nppesnteam/370-24_Balakovo_PTVM180_-3-4/АК4/1.Титульник.pdf

# Балаковская ТЭЦ-4 филиала «Саратовский» ПАО «Т Плюс»

# Модернизация оборудования КИПиА водогрейных котлов ПТВМ-180 ст.№3, ст.№4

# Заказчик: филиал «Саратовский» ПАО «Т Плюс»

Главный инженер проекта | /Корепанов М.И./
370-24-АК4 | Котел ПТВМ-180 №4. Автоматизация

## Проектная организация: ООО НПП "Энергосервисналадка", г.Ижевск, nppesn.ru, ИНН 1832097973

Регистрационный номер 1083 в реестре Ассоциации Саморегулируемой организации "Национальное объединение научно-исследовательских и проектно-изыскательских организаций" Ассоциация СРО "Центрстройпроект", регистрационный номер в государственном реестре саморегулируемых организаций СРО-П-029-25092009)
