nppesnteam/370-24_Balakovo_PTVM180_-3-4/АК4/5.Структурная схема автоматизации.pdf

### Условные обозначения

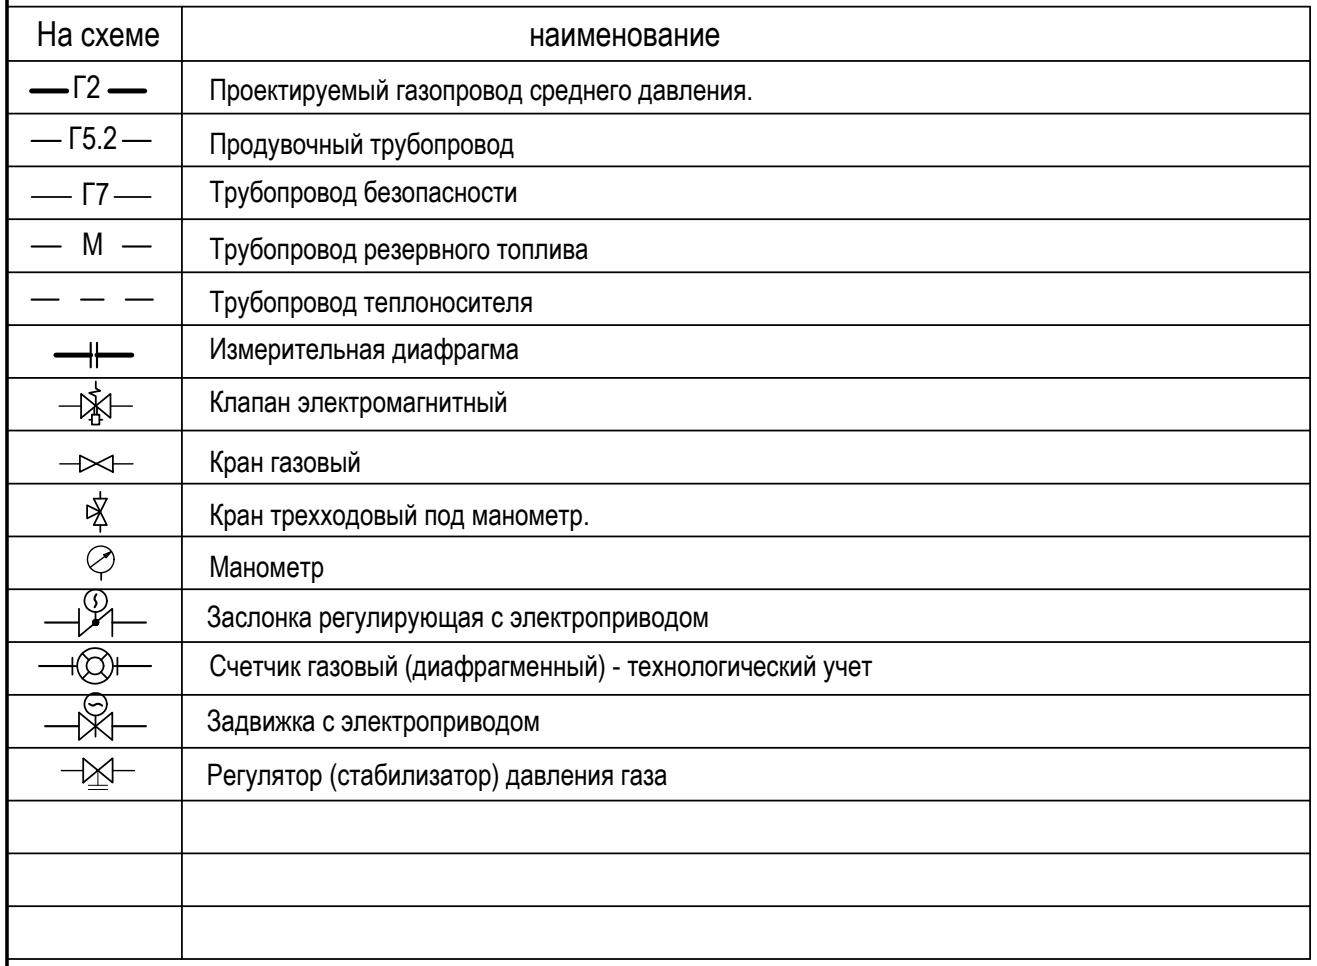
[picture p3: figure]
На схеме; наименование; Проектируемый газопровод среднего давления.; Кран газовый; Клапан электромагнитный; Манометр; Кран трехходовый под манометр.; Продувочный трубопровод; Заслонка регулирующая с электроприводом; Трубопровод безопасности; Задвижка с электроприводом; Регулятор (стабилизатор) давления газа; Трубопровод резервного топлива; Трубопровод теплоносителя Измерительная диафрагма

Счетчик газовый (диафрагменный) - технологический учет

g

номер подобъекта на объекте. Котел №3

среда: g(Gas)-газ, w(Water) - вода: на выходе из котла, на входе в котел, a(Air)-воздух, f(smole Fumes)-дым.газы, r(Reserv fuel)-резервное топливо, b(Burn) - пламя, x - прочее g

Pi

4

индивидуальный номер устройства на объекте.

4 0

1

Pi

1 3

0 1 номер горелки

P(Pressure)-давл., Т(Temperature)- темп-ра, CP(Control Panel)-шкаф управления, PP (power panel) - силовой шкаф,
fM(freqMotion) - эл.привод с частотником, sM(Single-turn Motion) - МЭО, H(Hand) - ручной, V(Valve) - клапан, Q(Quantity) - расход, X - неклассифицируемое устройство, последняя буква в датчиках: i(indicate) - показывающий, OS(Operator Station)-АРМ оператора

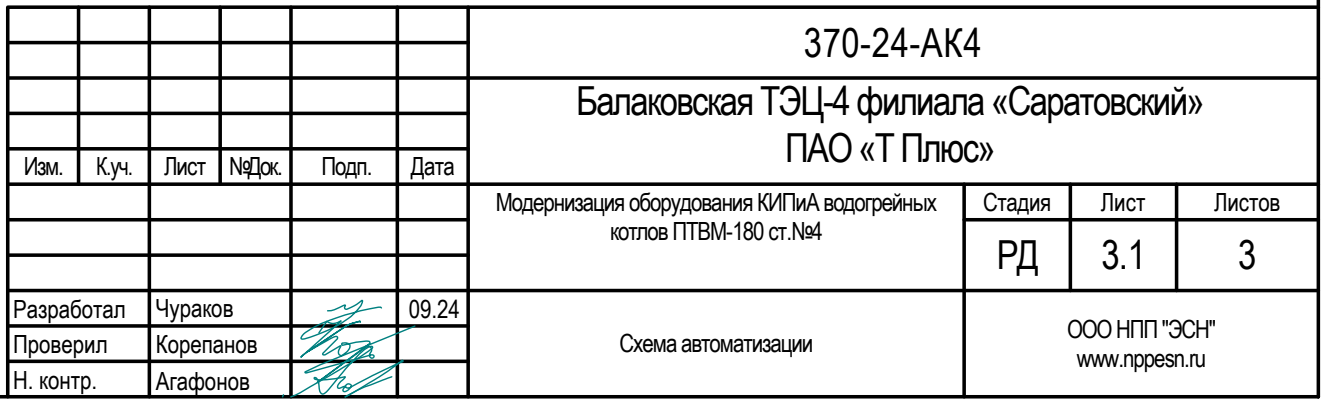
[picture p4: figure]
Стадия; Лист; Листов; Изм.; №Док.; Подп.; Дата; Модернизация оборудования КИПиА водогрейных котловПТВМ-180 ст.№4; ОООНПП "ЭСН" www.nppesn.ru; Балаковская ТЭЦ-4 филиала «Саратовский» ПАО «ТПлюс»; Схема автоматизации; Разработал Проверил Н. контр.; Чураков; Агафонов; Корепанов
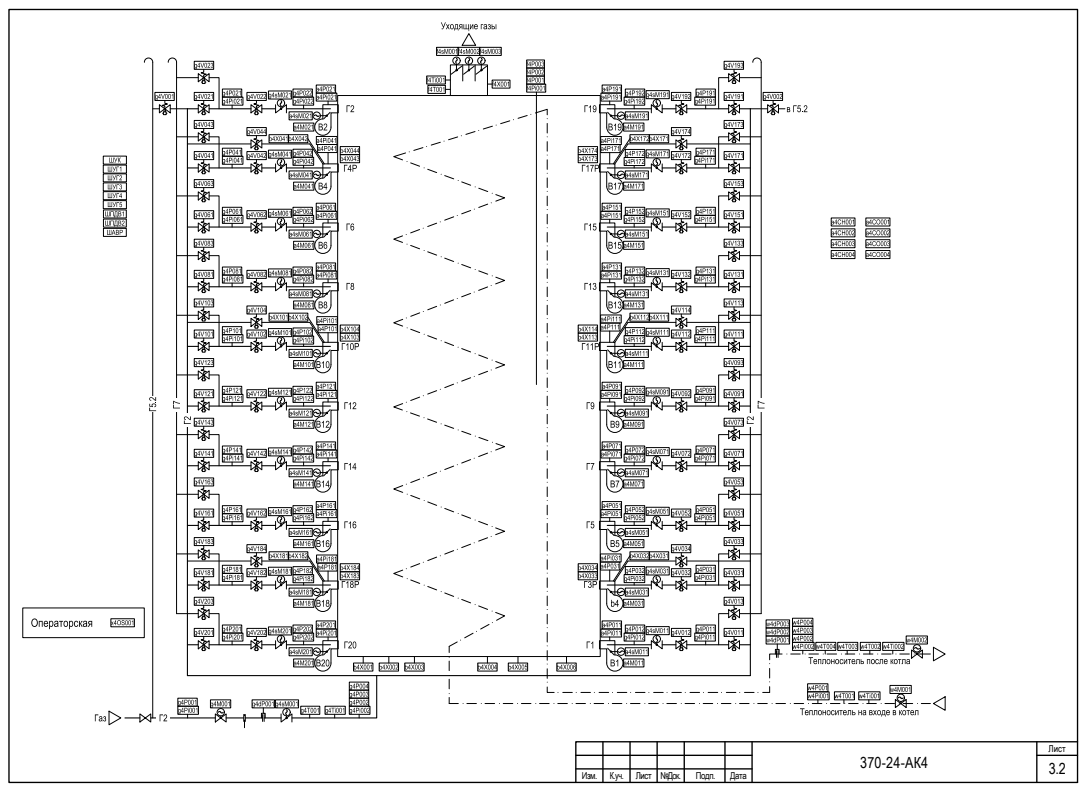
[picture p5: page 2]
Лист; Изм.; №Док.; Подп.; Дата

Лист

Изм. | К.уч. | Лист | №Док. | Подп. | Дата
370-24-АК4 | 3.3

Схема структурная автоматизации котла ПТВМ-180 №4

АРМ №1 | АРМ №2

Сетевой
коммутатор 1

Сетевой
коммутатор 2

Шкаф управления котлом
ПЛК 1
R500

Модули ввода/вывода

ПЛК 2
R500

Ethernet
Ethernet
RegulBus
RegulBus
Ethernet | Ethernet

Ethernet

Ethernet
Ethernet Ethernet
основной | резервный

вх/вых реле,
управление

вх/вых реле,
управление

вх/вых реле,
управление

вх/вых реле,
управление

Группа
горелок №1

Группа
горелок №2

Группа
горелок №3

Группа
горелок №4

Датчики, исполнительные механизмы котла ПТВМ-180 №4 по месту

вх/вых реле, управление

Шкаф группы
горелок №1

Модули
ввода/вывода

Шкаф группы
горелок №2

Модули
ввода/вывода

Шкаф группы
горелок №3

Модули
ввода/вывода

Шкаф группы
горелок №4

Модули
ввода/вывода

Помещение операторной

общекотельные Р,Т, расход газа, воды, разрежение, продувочные клапаны, датчики общего факела, содержание дымовых газов, открыть закрыть, контроль задвижки газа, воды, система контроля загазованности, система отопления/вентиляци

Датчики факела запальника, горелки, Ргаза, воздуха на горелке, герметичность, пуск/контроль вентиляторов, ПЗК1,2, кл.Безопасности, запальника, ИВН, открыть, закрыть, контроль заслонки газа, воздуха

вх/вых реле,
управление

Группа
горелок №5

Шкаф группы
горелок №5

Модули
ввода/вывода
