nppesnteam/370-24_Balakovo_PTVM180_-3-4/АК3/3.Ведомость (отредачить и подпись влада).pdf

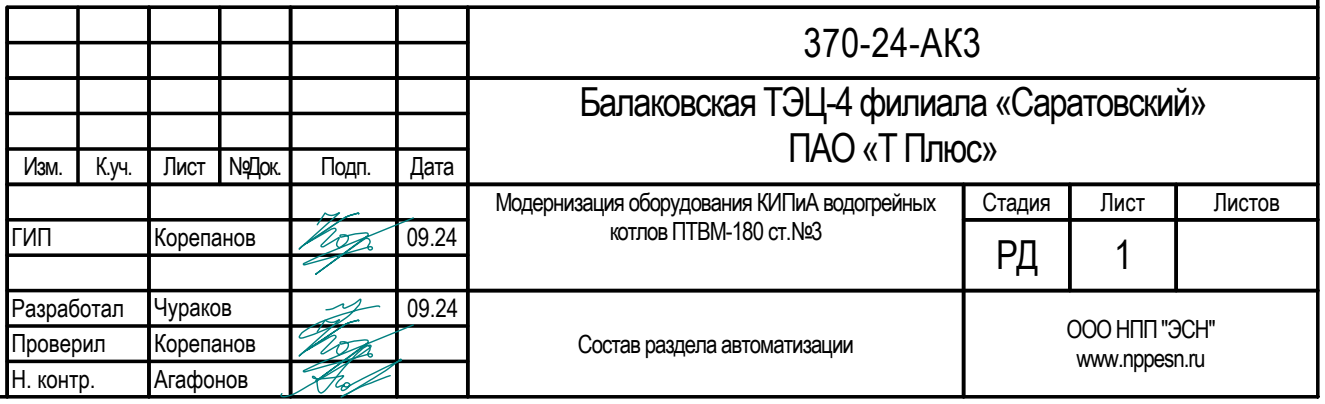
[picture p6: figure]
Стадия; Лист; Листов; Изм.; №Док.; Подп.; Дата; ОООНПП "ЭСН" www.nppesn.ru; Состав раздела автоматизации; Разработал; Чураков; Проверил; Корепанов; Н. контр.; Агафонов; 370-24-АК3 Балаковская ТЭЦ-4 филиала «Саратовский» ПАО «ТПлюс»

| | | | Модернизация оборудования КИПиА водогрейных котловПТВМ-180 ст.№3 | | 1 ГИП

Технические решения, принятые в рабочей документации, соответствуют требованиям экологических, санитарно-технических, противопожарных и других норм, действующих на территории Российской Федерации и обеспечивают безопасную для жизни и здоровья людей эксплуатацию объекта при соблюдении предусмотренных рабочими чертежами мероприятий.

Ведомость рабочих чертежей | Ведомость ссылочных и прилагаемых документов
Лист | Примечание Наименование | Обозначение | Примечание Наименование
1 | Состав раздела автоматизации
2 | Общие указания | на 3 листах
3 | Схема автоматизации | на 3 листах
4 | План расположения средств автоматизации | на 5 листах
5-9 | Ведомость элементов функциональной схемы | на 5 листах
10-105 | Схемы электрические принципиальные | на 96 листах
106-125 | Схемы монтажные | на 20 листах

Прилагаемые документы
370-24-АК3.СО | Спецификация оборудования и материалов
370-24-АК3.ТП и КЖ | Трубные проводки и кабельный журнал
370-24-АК3.ШАВР | Шкаф автоматического ввода резерва
370-24-АК3.ШУК | Шкаф управления котлом
370-24-АК3.ШУГ | Шкаф управления группой горелок
370-24-АК3.ШПДВ | Шкаф питания дутьевых вентиляторов
