nppesnteam/370-24_Balakovo_PTVM180_-3-4/Docs/РЭ ИКТС-11.1 Схема электрическая.pdf

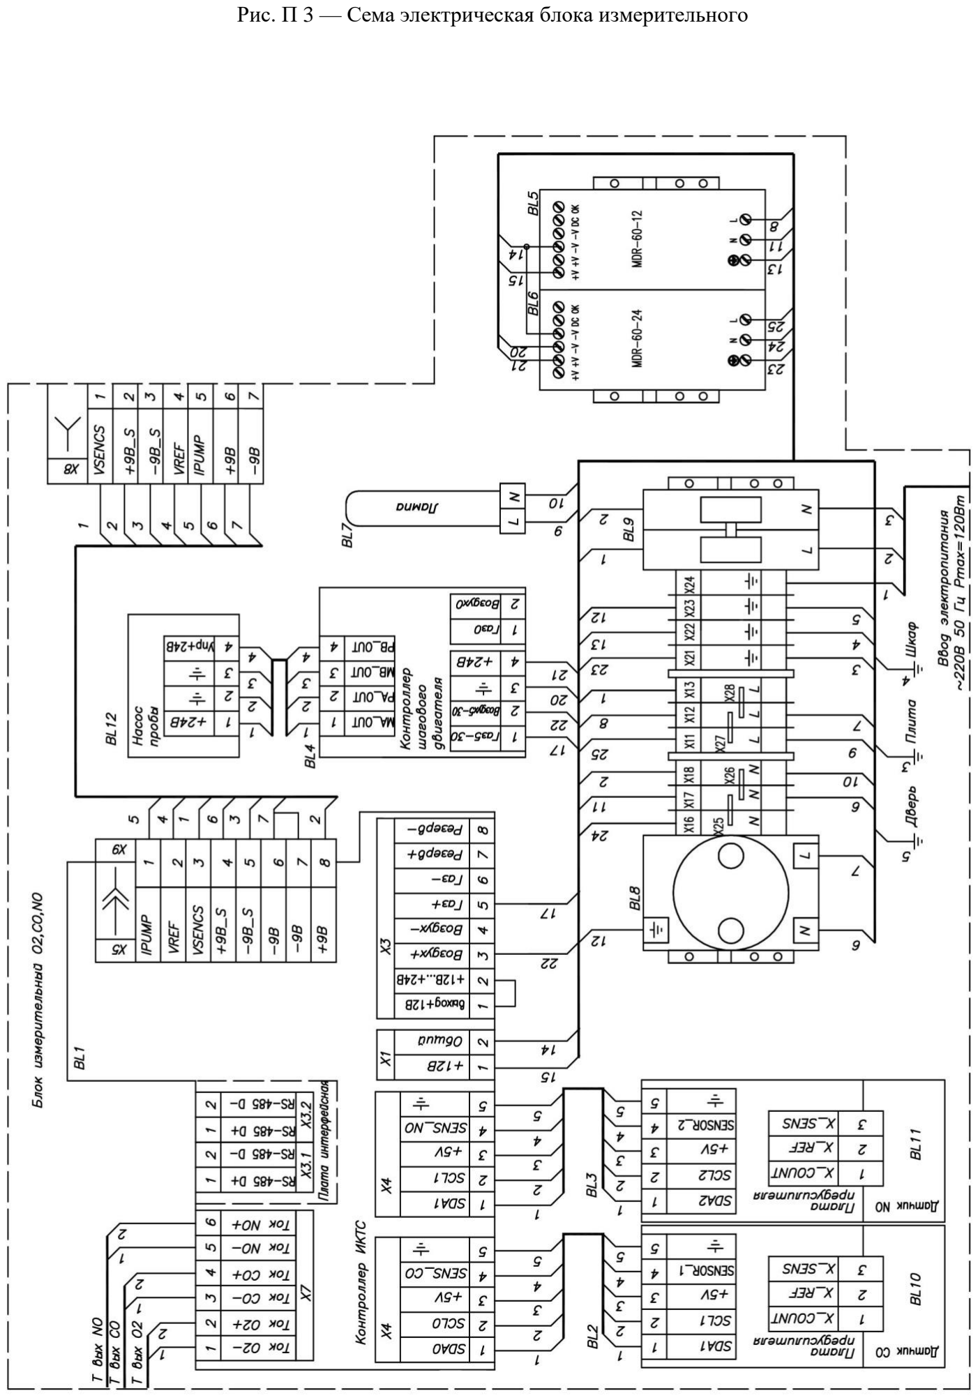
[picture p7: page 1]

Руководство по эксплуатации ИКТС-11.1 | ПГРА 170.00.000 РЭ

33

Рис. П 3 — Сема электрическая блока измерительного

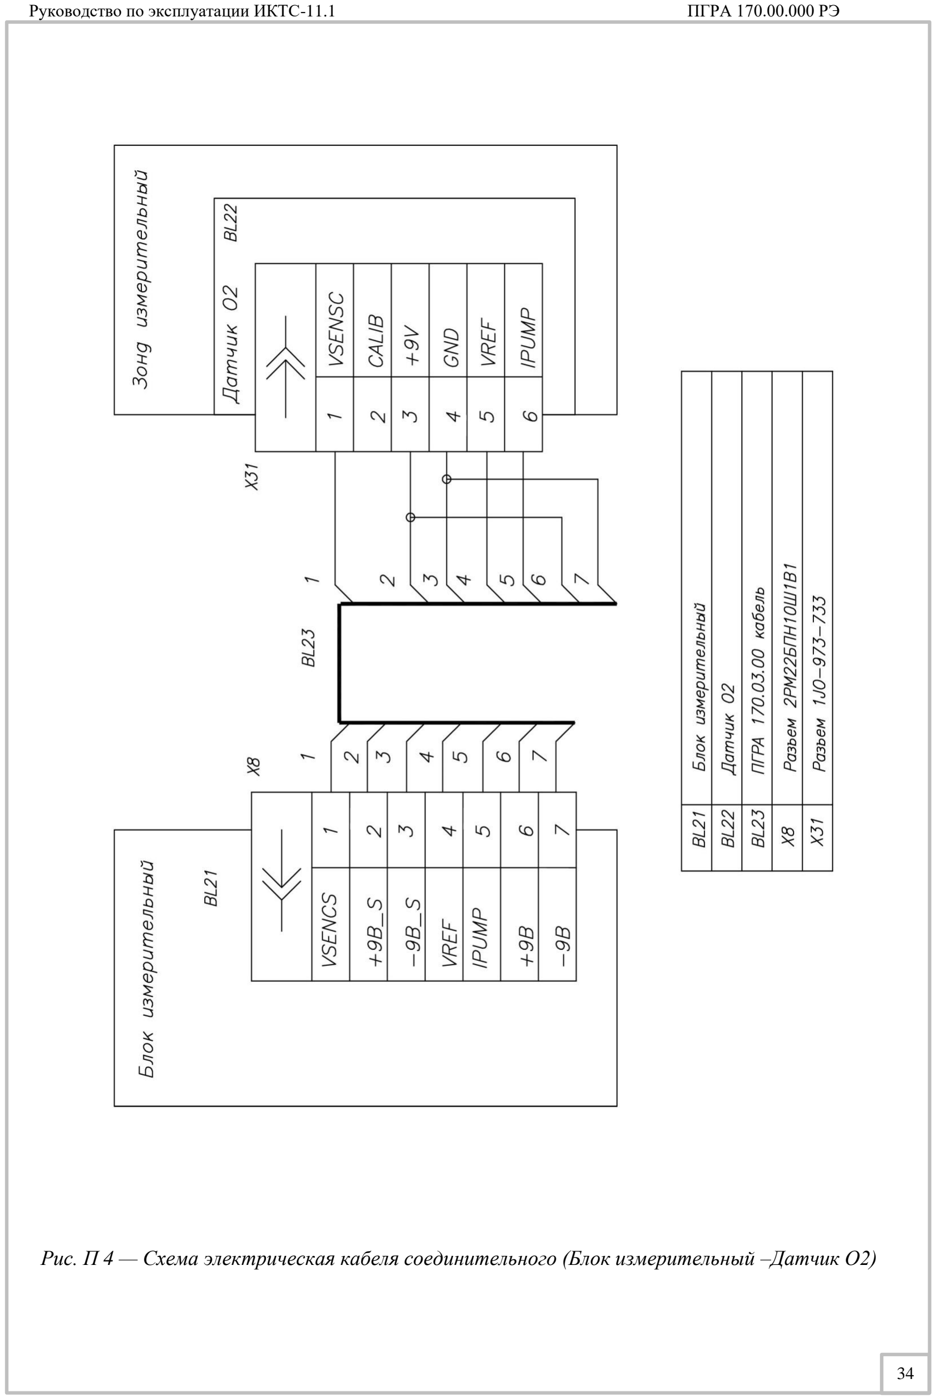
[picture p8: page 2]

Руководство по эксплуатации ИКТС-11.1 | ПГРА 170.00.000 РЭ

34

Рис. П 4 — Схема электрическая кабеля соединительного (Блок измерительный –Датчик О2)
