nppesnteam/370-24_Balakovo_PTVM180_-3-4/АК3/2.Состав проекта.pdf

Состав рабочей документации, шифр 370-24, стадия «РД»
Объект: Балаковская ТЭЦ-4 филиала «Саратовский» ПАО «Т Плюс»
Стройка: Модернизация оборудования КИПиА водогрейных котлов ПТВМ-180 ст.№3, ст.№4
ПЗ | Пояснительная записка
АК3 | Котел ПТВМ-180 №3. Автоматизация
ГС3 | Котел ПТВМ-180 №3. Газоснабжение.
АК4 | Котел ПТВМ-180 №4. Автоматизация
ГС4 | Котел ПТВМ-180 №4. Газоснабжение.
СМ | Котел ПТВМ-180 №4. Сметная документация
