nppesnteam/370-24_Balakovo_PTVM180_-3-4/SM/370-24_балаково_птвм180n3n4_241022/scheme.pdf

# code

## object

Инв. № подп. Подп. и дата Взамен инв. №

Согласовано

Изм. | Кол.уч. | Лист | № док. | Подп. | Дата
| | | | work | Стадия | Лист | Листов
| | | | | stage | 1
Разработал | design | | date | Ведомость элементов функциональной схемы (1/5) | firm
Проверил | verify
Н.контр. | norminspect
Шифр | Назначение | Значение номиналь- ное
Единица
измере-ния

Схема
электри-ческая
| | | | Схема монтажа
Шифр | Назначение | Значение
номиналь-ное

Единица
измере-ния

Схема
электри-ческая

Схема
монтажа
Шифр | Назначение | Значение
номиналь-ное

Единица
измере-ния

Схема
электри-ческая

Схема
монтажа
g3P002 | Датчик давления газа в коллекторе
№1 | 100 | se0001 кПа | sm11, л.6
f3P001 | Датчик разрежения в топке котла №1 | 0.2 | se0001 кПа | sm8, л.7
w3dP001 | Датчик перепада давления
теплоносителя на входе в котёл №1 | 63 | se0001 кПа | sm13,
| | | | л.11
w3P002 | Датчик давления теплоносителя
после котла №1 | 2.5 | se0001 Мпа | sm8, л.7
w3T002 | Датчик температуры теплоносителя
после котла №1 | 200 | se0001 °C | sm3, л.12
g3P001 | Датчик давления газа на входе в
котел | 100 | se0001 кПа | sm2, л.13
g3dP001 | Датчик перепада давления газа на
входе в котел | 10 | se0001 кПа | sm7, л.14
g3T001 | Датчик температуры газа в
коллекторе | 100 | se0001 °C | sm3, л.12
f3T001 | Датчик температуры дымовых газов | 400 | se0001 °C | sm12,
| | | | л.15
g3P003 | Датчик давления газа в коллекторе
№2 | 100 | se0001 кПа | sm11, л.6
f3P002 | Датчик разрежения в топке котла
№2 | 0.2 | se0001 кПа | sm8, л.7
w3dP002 | Датчик перепада давления
теплоносителя на входе в котёл №2 | 63 | se0001 кПа | sm14,
| | | | л.16
w3P003 | Датчик давления теплоносителя
после котла №2 | 2.5 | se0001 Мпа | sm8, л.7
w3T003 | Датчик температуры теплоносителя
после котла №2 | 200 | se0001 °C | sm3, л.12
w3T001 | Датчик температуры теплоносителя
на входе в котел | 200 | se0001 °C | sm3, л.12
w3P001 | Датчик давления теплоносителя на
входе в котел | 2.5 | se0001 Мпа | sm8, л.7
g3P004 | Датчик давления газа в коллекторе
№3 | 100 | se0001 кПа | sm11, л.6
f3P003 | Датчик разрежения в топке котла
№3 | 0.2 | se0001 кПа | sm8, л.7
w3dP003 | Датчик перепада давления
теплоносителя на входе в котёл №3 | 63 | se0001 кПа | sm14,
| | | | л.16
w3P004 | Датчик давления теплоносителя
после котла №3 | 2.5 | se0001 Мпа | sm8, л.7
g3Pi011 | Манометр давления газа между ПЗК
на горелке №1 | 100 | не
электр. кПа | sm1, л.17
g3Pi021 | Манометр давления газа между ПЗК
на горелке №2 | 100 | не
электр. кПа | sm1, л.17
g3Pi031 | Манометр давления газа между ПЗК
на горелке №3 | 100 | не
электр. кПа | sm1, л.17
g3Pi041 | Манометр давления газа между ПЗК
на горелке №4 | 100 | не
электр. кПа | sm1, л.17
g3Pi051 | Манометр давления газа между ПЗК
на горелке №5 | 100 | не
электр. кПа | sm1, л.17
g3Pi061 | Манометр давления газа между ПЗК
на горелке №6 | 100 | не
электр. кПа | sm1, л.17
g3Pi071 | Манометр давления газа между ПЗК
на горелке №7 | 100 | не
электр. кПа | sm1, л.17
g3Pi081 | Манометр давления газа между ПЗК
на горелке №8 | 100 | не
электр. кПа | sm1, л.17
g3Pi091 | Манометр давления газа между ПЗК
на горелке №9 | 100 | не
электр. кПа | sm1, л.17
g3Pi101 | Манометр давления газа между ПЗК
на горелке №10 | 100 | не
электр. кПа | sm1, л.17
g3Pi111 | Манометр давления газа между ПЗК
на горелке №11 | 100 | не
электр. кПа | sm1, л.18
g3Pi121 | Манометр давления газа между ПЗК
на горелке №12 | 100 | не
электр. кПа | sm1, л.18
g3Pi131 | Манометр давления газа между ПЗК
на горелке №13 | 100 | не
электр. кПа | sm1, л.18
g3Pi141 | Манометр давления газа между ПЗК
на горелке №14 | 100 | не
электр. кПа | sm1, л.18
g3Pi151 | Манометр давления газа между ПЗК
на горелке №15 | 100 | не
электр. кПа | sm1, л.18
g3Pi161 | Манометр давления газа между ПЗК
на горелке №16 | 100 | не
электр. кПа | sm1, л.18
g3Pi171 | Манометр давления газа между ПЗК
на горелке №17 | 100 | не
электр. кПа | sm1, л.18
g3Pi181 | Манометр давления газа между ПЗК
на горелке №18 | 100 | не
электр. кПа | sm1, л.18
g3Pi191 | Манометр давления газа между ПЗК
на горелке №19 | 100 | не
электр. кПа | sm1, л.18
g3Pi201 | Манометр давления газа между ПЗК
на горелке №20 | 100 | не
электр. кПа | sm1, л.18
w3T004 | Датчик температуры теплоносителя
после котла №3 | 200 | se0001 °C | sm3, л.12
g3P011 | Датчик давления газа между ПЗК на
горелке №1 | 100 | se0001 кПа | sm8, л.7
g3P012 | Датчик давления газа перед
горелкой №1 | 40 | se0001 кПа | sm8, л.7
а3P011 | Датчик давления воздуха перед
горелкой №1 | 2.5 | se0001 кПа | sm8, л.7
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
g3V151 | Клапан ПЗК-1 на горелке №15 | se0003
g3V171 | Клапан ПЗК-1 на горелке №17 | se0003
g3V191 | Клапан ПЗК-1 на горелке №19 | se0003
g3V132 | Клапан ПЗК-2 на горелке №13 | se0003
g3V152 | Клапан ПЗК-2 на горелке №15 | se0003
g3V172 | Клапан ПЗК-2 на горелке №17 | se0003
g3V192 | Клапан ПЗК-2 на горелке №19 | se0003
g3V133 | Клапан СБ на горелке №13 | se0003
g3V153 | Клапан СБ на горелке №15 | se0003
g3V173 | Клапан СБ на горелке №17 | se0003
g3V193 | Клапан СБ на горелке №19 | se0003
g3V174 | Клапан запальника горелки №17 | se0003
g3V141 | Клапан ПЗК-1 на горелке №14 | se0003
g3V161 | Клапан ПЗК-1 на горелке №16 | se0003
g3V181 | Клапан ПЗК-1 на горелке №18 | se0003
g3V201 | Клапан ПЗК-1 на горелке №20 | se0003
g3V142 | Клапан ПЗК-2 на горелке №14 | se0003
g3V162 | Клапан ПЗК-2 на горелке №16 | se0003
g3V182 | Клапан ПЗК-2 на горелке №18 | se0003
g3V202 | Клапан ПЗК-2 на горелке №20 | se0003
g3V143 | Клапан СБ на горелке №14 | se0003
g3V163 | Клапан СБ на горелке №16 | se0003
g3V183 | Клапан СБ на горелке №18 | se0003
g3V203 | Клапан СБ на горелке №20 | se0003
g3V184 | Клапан запальника горелки №18 | se0003
b3X032 | Датчик наличия факела запальника горелки №3 | se0005
b3X042 | Датчик наличия факела запальника горелки №4 | se0005
b3X102 | Датчик наличия факела запальника горелки №10 | se0005
b3X112 | Датчик наличия факела запальника горелки №11 | se0005
b3X172 | Датчик наличия факела запальника горелки №17 | se0005
b3X182 | Датчик наличия факела запальника горелки №18 | se0005
b3X001 | Датчик интенсивности пламени №1 | se0009
b3X002 | Датчик интенсивности пламени №2 | se0009
b3X003 | Датчик интенсивности пламени №3 | se0009
b3X004 | Датчик интенсивности пламени №4 | se0009
b3X005 | Датчик интенсивности пламени №5 | se0009
b3X006 | Датчик интенсивности пламени №6 | se0009
а3СО001 | Датчик загазованности СО №1 | se0009
а3СО002 | Датчик загазованности СО №2 | se0009
а3СО003 | Датчик загазованности СО №3 | se0009
а3СО004 | Датчик загазованности СО №4 | se0009
b3X033 | Датчик наличия факела горелки №3 | se0010
b3X043 | Датчик наличия факела горелки №4 | se0010
b3X103 | Датчик наличия факела горелки №10 | se0010
b3X113 | Датчик наличия факела горелки №11 | se0010
b3X173 | Датчик наличия факела горелки №17 | se0010

# code

## object

Инв. № подп. Подп. и дата Взамен инв. №

Согласовано

Изм. | Кол.уч. | Лист | № док. | Подп. | Дата
| | | | work | Стадия | Лист | Листов
| | | | | stage | 4
| | | | Ведомость элементов функциональной схемы (4/5) | firm
Шифр | Назначение | Значение
номиналь-ное

Единица
измере-ния

Схема
электри-ческая

Схема
монтажа
Шифр | Назначение | Значение
номиналь-ное

Единица
измере-ния

Схема
электри-ческая

Схема
монтажа
Шифр | Назначение | Значение
номиналь-ное

Единица
измере-ния

Схема
электри-ческая

Схема
монтажа

b3X183 Датчик наличия факела горелки
№18

se0010

а3СН001 | Датчик загазованности СН4 №1 | se0011
а3СН002 | Датчик загазованности СН4 №2 | se0011
а3СН003 | Датчик загазованности СН4 №3 | se0011
а3СН004 | Датчик загазованности СН4 №4 | se0011
а3sM011 | Регулятор давления воздуха на
горелке №1

se0012

а3sM031 Регулятор давления воздуха на горелке №3

se0012

а3sM051 Регулятор давления воздуха на горелке №5

se0012

а3sM071 Регулятор давления воздуха на горелке №7

se0012

а3sM021 Регулятор давления воздуха на горелке №2

se0012

а3sM041 Регулятор давления воздуха на горелке №4

se0012

а3sM061 Регулятор давления воздуха на горелке №6

se0012

а3sM081 Регулятор давления воздуха на горелке №8

se0012

а3sM091 Регулятор давления воздуха на горелке №9

se0012

а3sM101 Регулятор давления воздуха на горелке №10

se0012

а3sM111 Регулятор давления воздуха на горелке №11

se0012

а3sM121 Регулятор давления воздуха на горелке №12

se0012

а3sM131 Регулятор давления воздуха на горелке №13

se0012

а3sM151 Регулятор давления воздуха на горелке №15

se0012

а3sM171 Регулятор давления воздуха на горелке №17

se0012

а3sM191 Регулятор давления воздуха на горелке №19

se0012

а3sM141 Регулятор давления воздуха на горелке №14

se0012

а3sM161 Регулятор давления воздуха на горелке №16

se0012

а3sM181 Регулятор давления воздуха на горелке №18

se0012

а3sM201 Регулятор давления воздуха на горелке №20

se0012

g3sM011 Регулятор давления газа на горелке №1

se0015

g3sM031 Регулятор давления газа на горелке №3

se0015

g3sM051 | Регулятор давления газа на горелке №5 | se0015
g3sM071 | Регулятор давления газа на горелке №7 | se0015
g3sM021 | Регулятор давления газа на горелке №2 | se0015
g3sM041 | Регулятор давления газа на горелке №4 | se0015
g3sM061 | Регулятор давления газа на горелке №6 | se0015
g3sM081 | Регулятор давления газа на горелке №8 | se0015
g3sM091 | Регулятор давления газа на горелке №9 | se0015
g3sM101 | Регулятор давления газа на горелке №10 | se0015
g3sM111 | Регулятор давления газа на горелке №11 | se0015
g3sM121 | Регулятор давления газа на горелке №12 | se0015
g3sM131 | Регулятор давления газа на горелке №13 | se0015
g3sM151 | Регулятор давления газа на горелке №15 | se0015
g3sM171 | Регулятор давления газа на горелке №17 | se0015
g3sM191 | Регулятор давления газа на горелке №19 | se0015
g3sM141 | Регулятор давления газа на горелке №14 | se0015
g3sM161 | Регулятор давления газа на горелке №16 | se0015
g3sM181 | Регулятор давления газа на горелке №18 | se0015
g3sM201 | Регулятор давления газа на горелке №20 | se0015
f3X001 | Газоанализатор дымовых газов | se0018
а3M011 | Дутьевой вентилятор на горелке №1 | se0019
а3M031 | Дутьевой вентилятор на горелке №3 | se0019
а3M051 | Дутьевой вентилятор на горелке №5 | se0019
а3M071 | Дутьевой вентилятор на горелке №7 | se0019
а3M021 | Дутьевой вентилятор на горелке №2 | se0019
а3M041 | Дутьевой вентилятор на горелке №4 | se0019
а3M061 | Дутьевой вентилятор на горелке №6 | se0019
а3M081 | Дутьевой вентилятор на горелке №8 | se0019
а3M091 | Дутьевой вентилятор на горелке №9 | se0019
а3M101 | Дутьевой вентилятор на горелке №10 | se0019
а3M111 | Дутьевой вентилятор на горелке №11 | se0019
а3M121 | Дутьевой вентилятор на горелке №12 | se0019
а3M131 | Дутьевой вентилятор на горелке №13 | se0019
а3M151 | Дутьевой вентилятор на горелке №15 | se0019
а3M171 | Дутьевой вентилятор на горелке №17 | se0019
а3M191 | Дутьевой вентилятор на горелке №19 | se0019
а3M141 | Дутьевой вентилятор на горелке №14 | se0019
а3M161 | Дутьевой вентилятор на горелке №16 | se0019
а3M181 | Дутьевой вентилятор на горелке №18 | se0019
а3M201 | Дутьевой вентилятор на горелке №20 | se0019
g3M001 | Задвижка газовая на входе в котел | se0024
w3M001 | Задвижка теплоносителя на входе в котел | se0024
w3M002 | Задвижка теплоносителя после котла | se0024
g3V001 | Клапан продувки со стороны чётных горелок | se0021
g3V002 | Клапан продувки со стороны нечётных горелок | se0021
f3sM001 | Регулятор разрежения №1 | se0022
f3sM002 | Регулятор разрежения №2 | se0022
f3sM003 | Регулятор разрежения №3 | se0022
g3sM001 | Регулятор давления газа в коллекторе | se0023
b3X034 | Горелка запальная газовая | не электр.
b3X044 | Горелка запальная газовая | не электр.
b3X104 | Горелка запальная газовая | не электр.
b3X114 | Горелка запальная газовая | не электр.
b3X174 | Горелка запальная газовая | не электр.
b3X184 | Горелка запальная газовая | не электр.

# code

## object

Инв. № подп. Подп. и дата Взамен инв. №

Согласовано

Изм. | Кол.уч. | Лист | № док. | Подп. | Дата
| | | | work | Стадия | Лист | Листов
| | | | | stage | 5
| | | | Ведомость элементов функциональной схемы (5/5) | firm
Шифр | Назначение | Значение
номиналь-ное

Единица
измере-ния

Схема
электри-ческая

Схема
монтажа
Шифр | Назначение | Значение
номиналь-ное

Единица
измере-ния

Схема
электри-ческая

Схема
монтажа
Шифр | Назначение | Значение
номиналь-ное

Единица
измере-ния

Схема
электри-ческая

Схема
монтажа

x3OS001 Арм оператора

Стол оператора

x3CP001 | Шкаф управления котлом
x3CP002 | Шкаф управления горелками 1
x3CP003 | Шкаф управления горелками 2
x3CP004 | Шкаф управления горелками 3
x3CP005 | Шкаф управления горелками 4
x3CP006 | Шкаф управления горелками 5
x3PP004 | Шкаф питания
x3PP002 | Шкаф питания дутьевых
вентиляторов 1
x3PP003 Шкаф питания дутьевых вентиляторов 2
x3PP001 Шкаф автоматического включения резерва
Иверторная система

Байпас

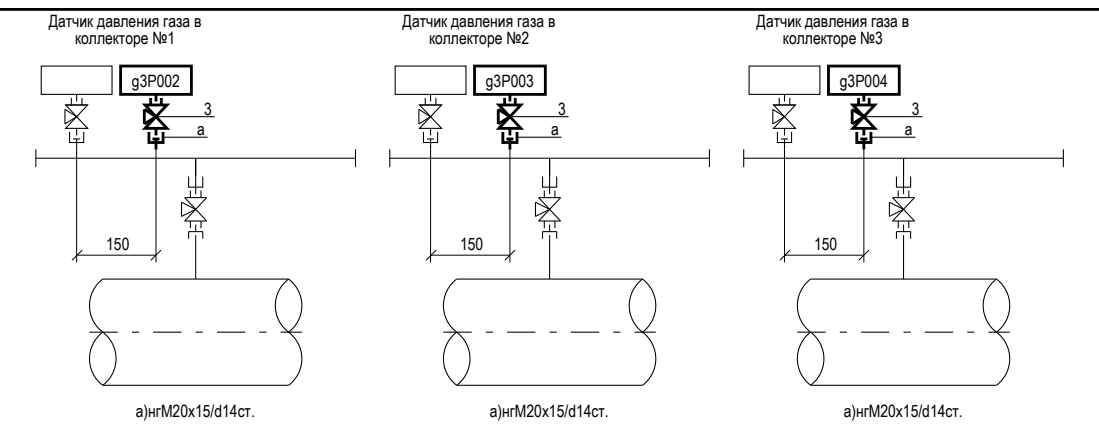
[picture p23: page 6]
Согласовано; а)нгМ20х15/d14ст.

Датчик давления газа в
коллекторе №1

коллекторе №2

коллекторе №3

Инв. № подп. Подп. и дата Взамен инв. №

code
object

Изм. | Кол.уч. | Лист | № док. | Подп. | Дата

work | Стадия | Лист | Листов

stage | 6

Схема монтажная sm11: g3P002, g3P003, g3P004 | firm

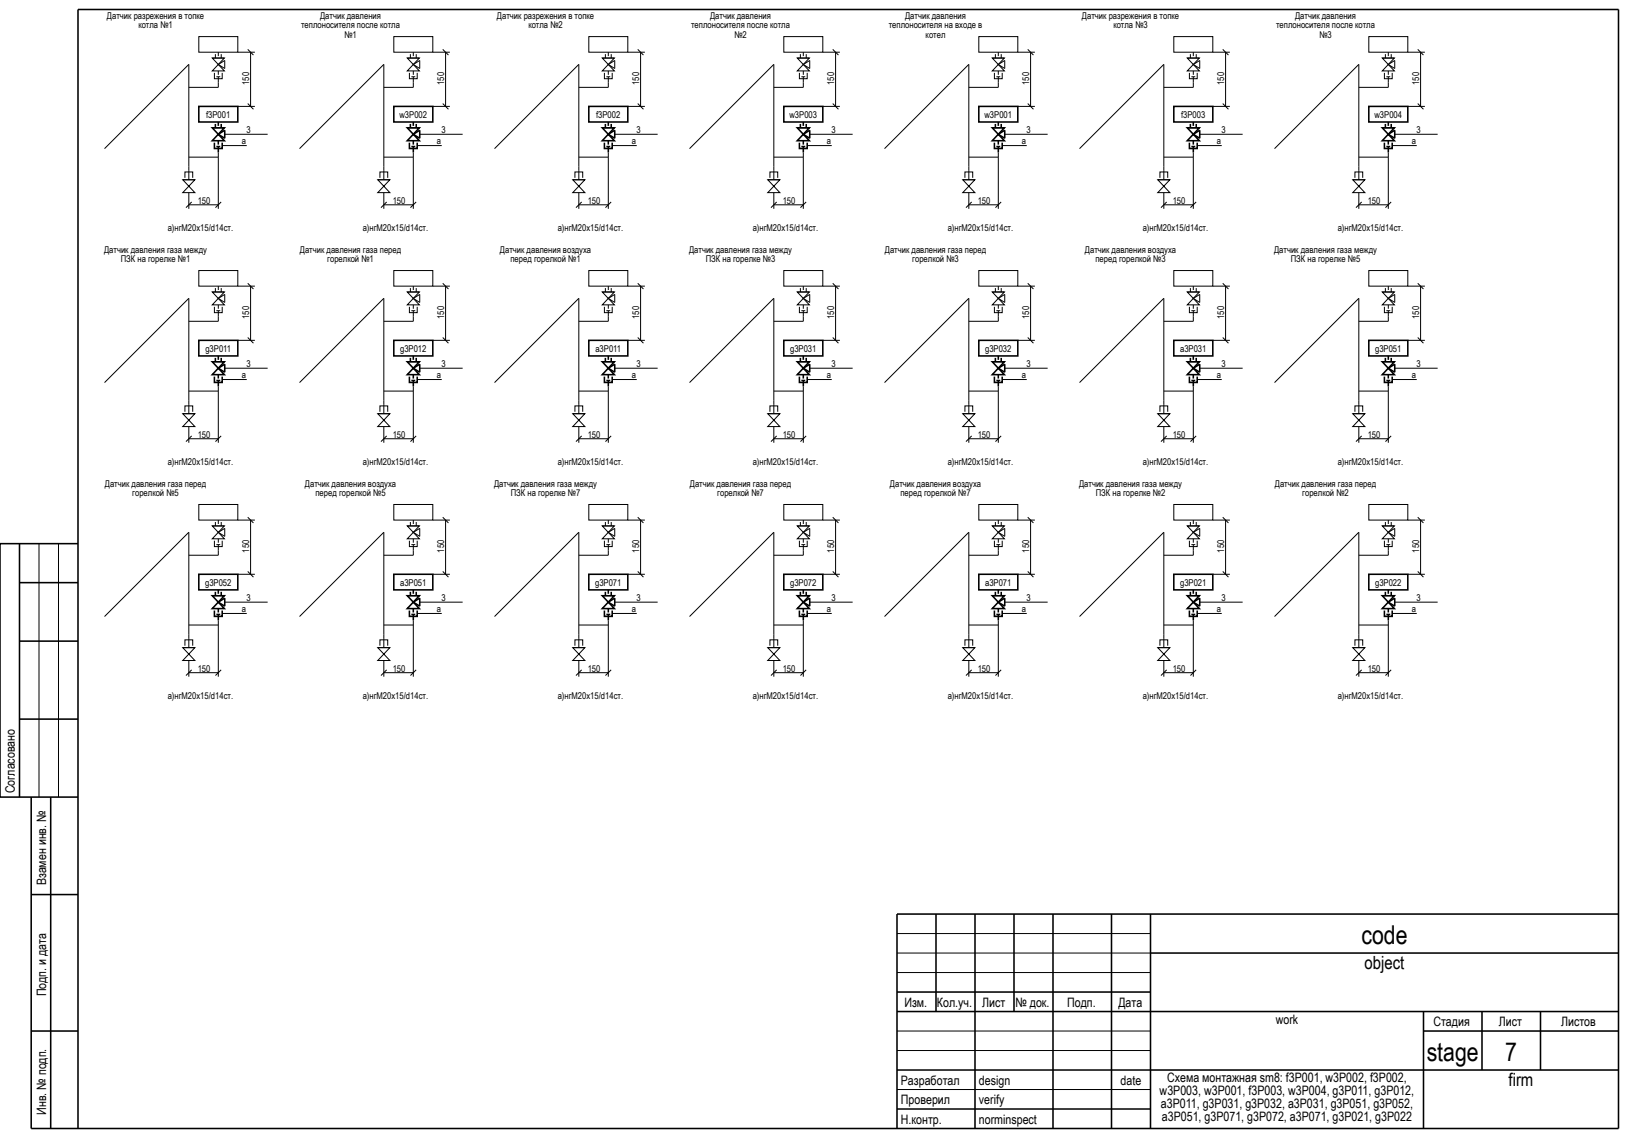
[picture p24: page 7]
Согласовано; а)нгМ20х15/d14ст.; котел

Датчик разрежения в топке
котла №1

Датчик давления
теплоносителя после котла

котла №2

теплоносителя на входе в

котла №3

Датчик давления газа между
ПЗК на горелке №1

Датчик давления газа перед
горелкой №1

Датчик давления воздуха
перед горелкой №1

ПЗК на горелке №3

горелкой №3

перед горелкой №3

ПЗК на горелке №5

горелкой №5

перед горелкой №5

ПЗК на горелке №7

горелкой №7

перед горелкой №7

ПЗК на горелке №2

горелкой №2

Инв. № подп. Подп. и дата Взамен инв. №

code
object

Изм. | Кол.уч. | Лист | № док. | Подп. | Дата

work | Стадия | Лист | Листов

stage | 7

Схема монтажная sm8: f3P001, w3P002, f3P002, w3P003, w3P001, f3P003, w3P004, g3P011, g3P012, а3P011, g3P031, g3P032, а3P031, g3P051, g3P052, а3P051, g3P071, g3P072, а3P071, g3P021, g3P022 | firm

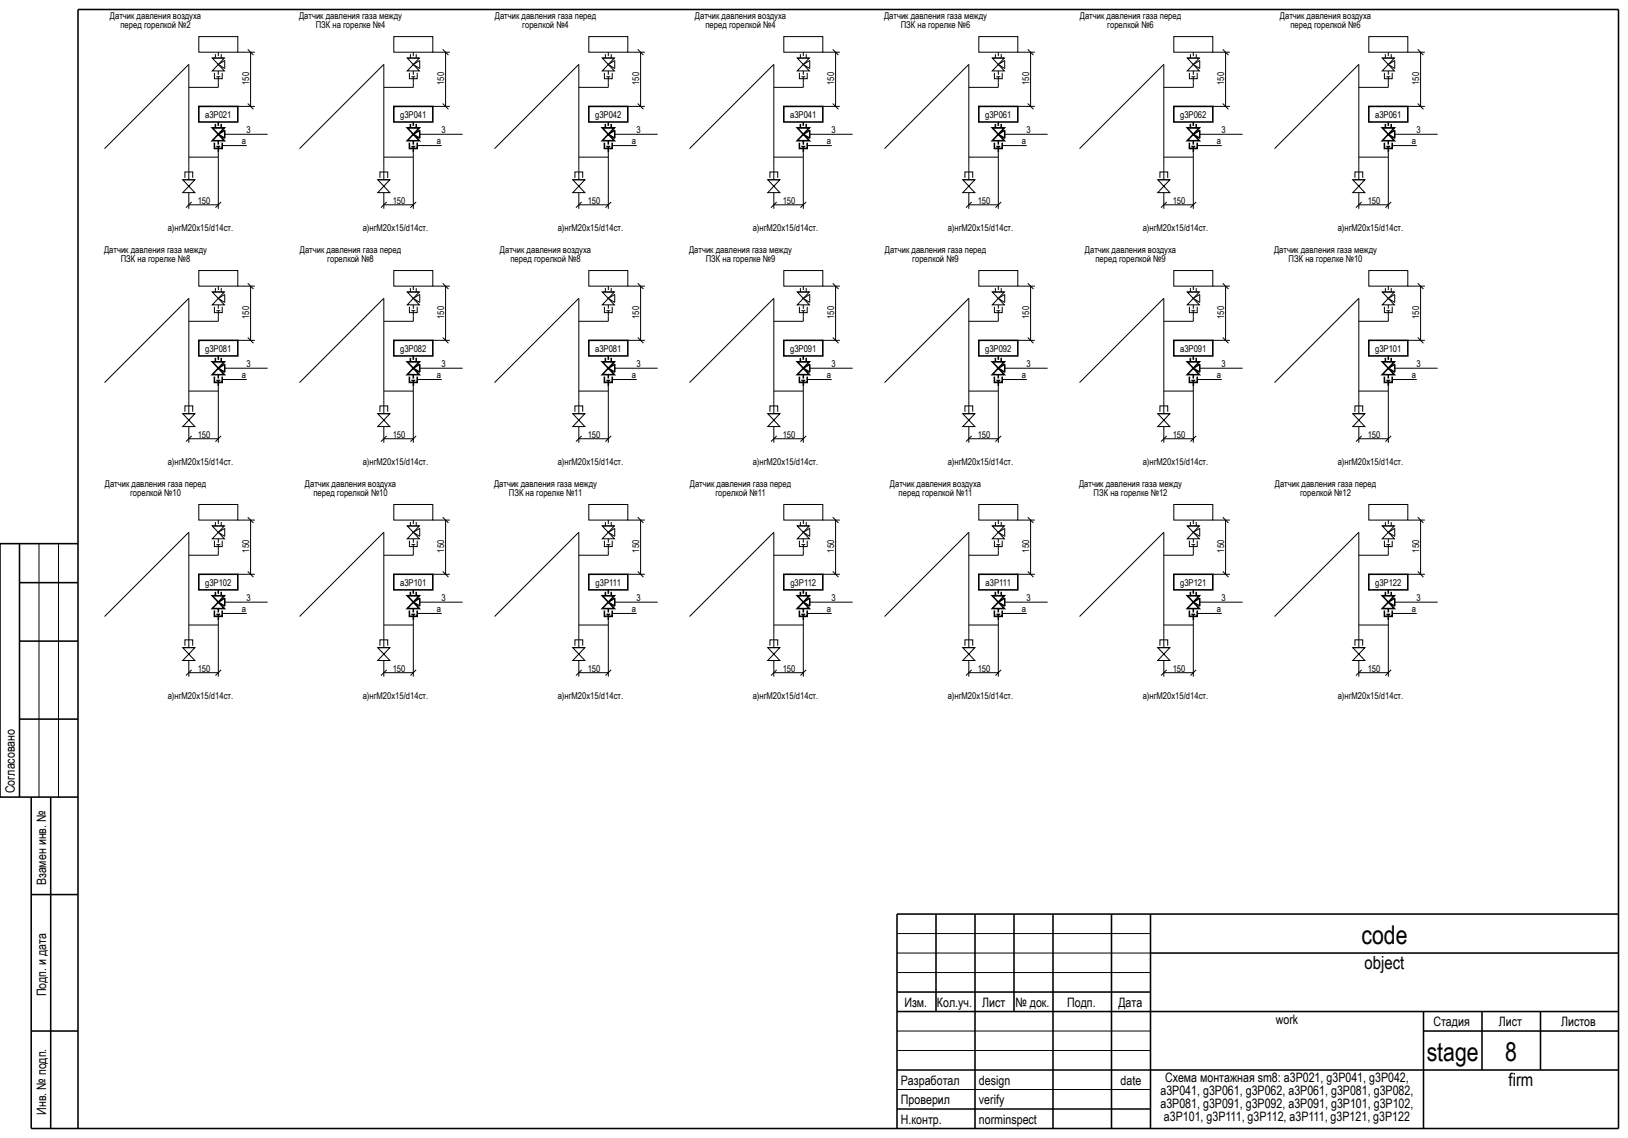
[picture p25: page 8]
Согласовано; а)нгМ20х15/d14ст.

Датчик давления воздуха
перед горелкой №2

Датчик давления газа между
ПЗК на горелке №4

Датчик давления газа перед
горелкой №4

перед горелкой №4

ПЗК на горелке №6

горелкой №6

перед горелкой №6

ПЗК на горелке №8

горелкой №8

перед горелкой №8

ПЗК на горелке №9

горелкой №9

перед горелкой №9

ПЗК на горелке №10

горелкой №10

перед горелкой №10

ПЗК на горелке №11

горелкой №11

перед горелкой №11

ПЗК на горелке №12

горелкой №12

Инв. № подп. Подп. и дата Взамен инв. №

code
object

Изм. | Кол.уч. | Лист | № док. | Подп. | Дата

work | Стадия | Лист | Листов

stage | 8

Схема монтажная sm8: а3P021, g3P041, g3P042, а3P041, g3P061, g3P062, а3P061, g3P081, g3P082, а3P081, g3P091, g3P092, а3P091, g3P101, g3P102, а3P101, g3P111, g3P112, а3P111, g3P121, g3P122

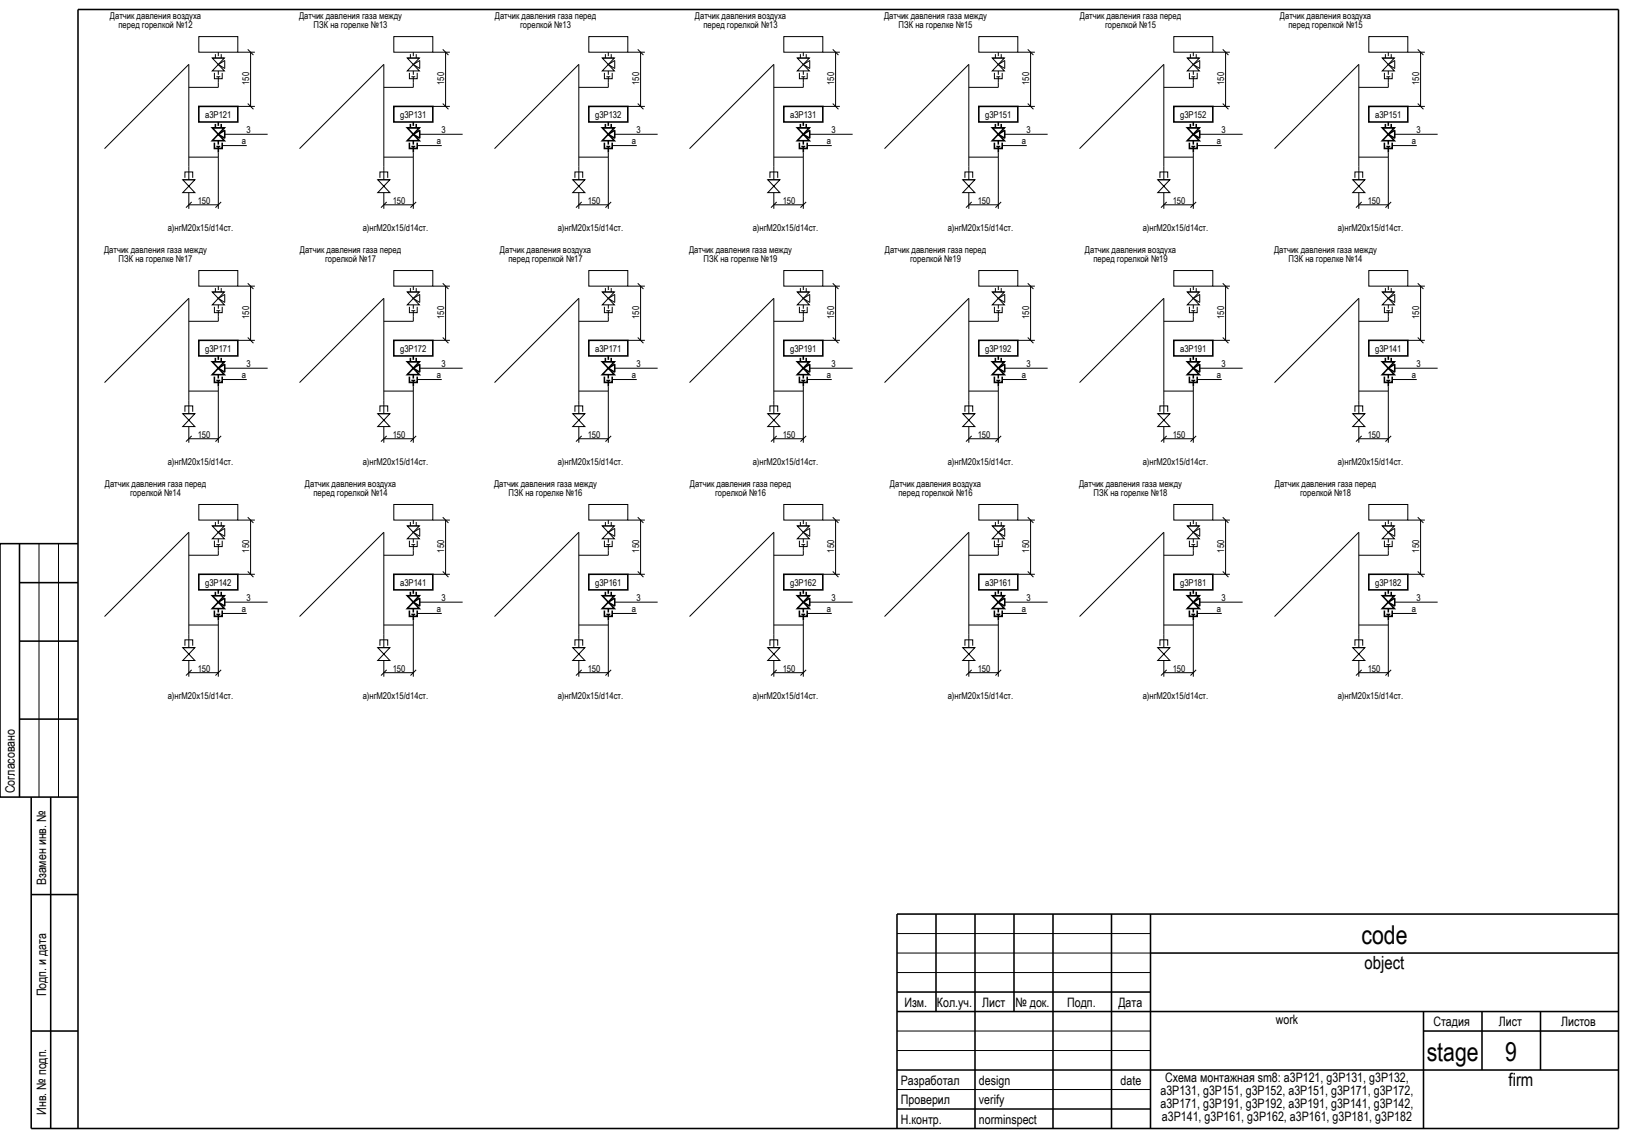
[picture p26: page 9]
Согласовано; а)нгМ20х15/d14ст.

Датчик давления воздуха
перед горелкой №12

Датчик давления газа между
ПЗК на горелке №13

Датчик давления газа перед
горелкой №13

перед горелкой №13

ПЗК на горелке №15

горелкой №15

перед горелкой №15

ПЗК на горелке №17

горелкой №17

перед горелкой №17

ПЗК на горелке №19

горелкой №19

перед горелкой №19

ПЗК на горелке №14

горелкой №14

перед горелкой №14

ПЗК на горелке №16

горелкой №16

перед горелкой №16

ПЗК на горелке №18

горелкой №18

Инв. № подп. Подп. и дата Взамен инв. №

code
object

Изм. | Кол.уч. | Лист | № док. | Подп. | Дата

work | Стадия | Лист | Листов

stage | 9

Схема монтажная sm8: а3P121, g3P131, g3P132, а3P131, g3P151, g3P152, а3P151, g3P171, g3P172, а3P171, g3P191, g3P192, а3P191, g3P141, g3P142, а3P141, g3P161, g3P162, а3P161, g3P181, g3P182

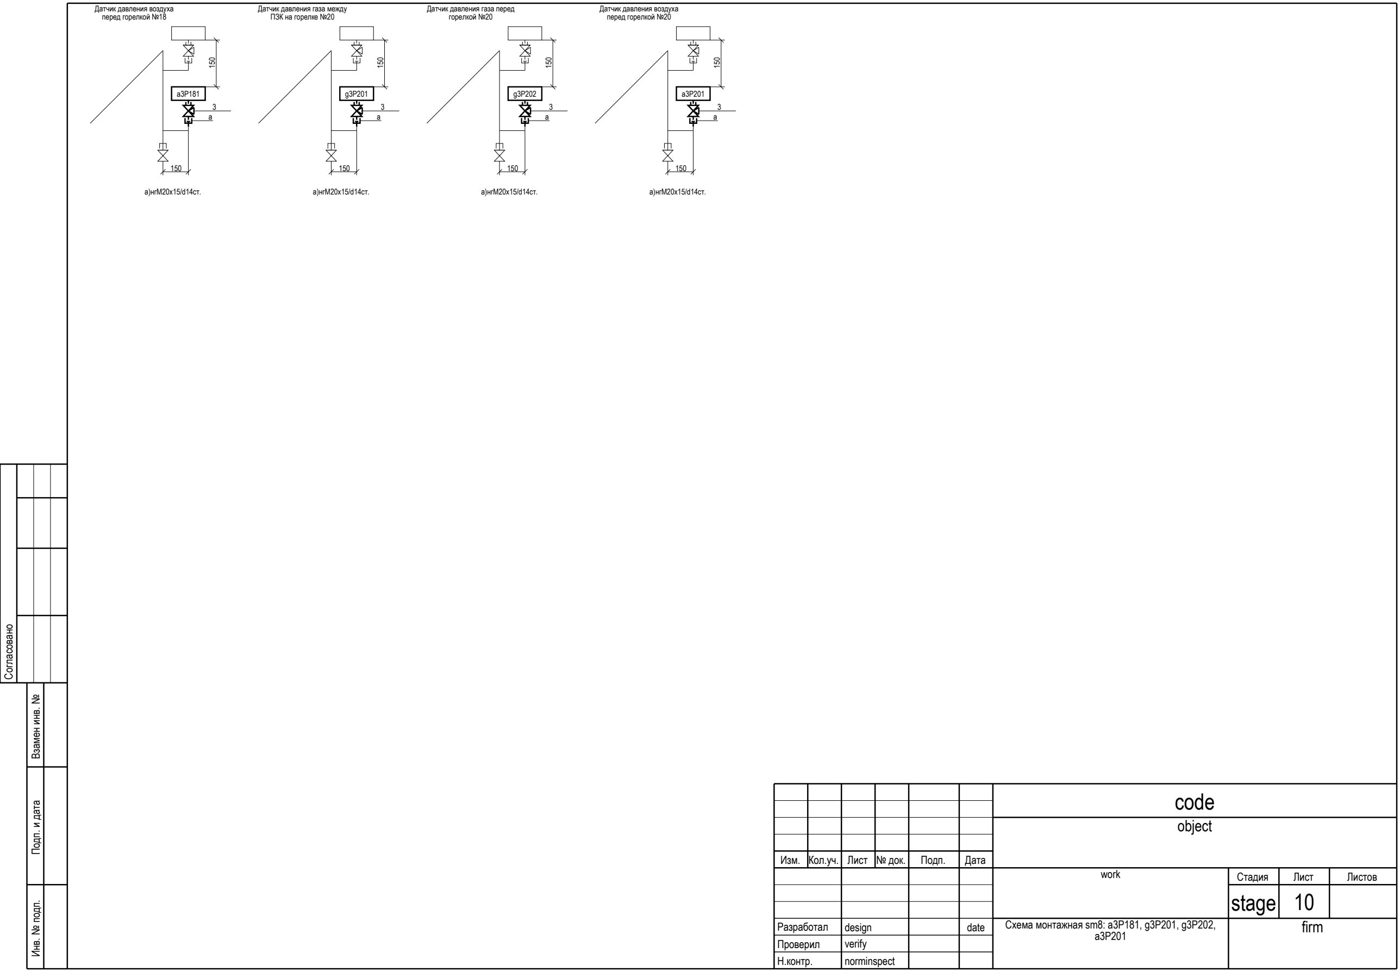
[picture p27: figure]
stage; object; code; work; Стадия; Лист; Листов; Инв. № подп. Подп. и дата Взамен инв. №; Согласовано; Изм.; Кол.уч.; № док.; Подп.; Дата; Датчик давления воздуха перед горелкой №18; а)нгМ20х15/d14ст.; Датчик давления газа между ПЗК на горелке №20; Датчик давления газа перед горелкой №20; Датчик давления воздуха перед горелкой №20

| | | | Схема монтажная sm8: а3P181, g3P201, g3P202, а3P201

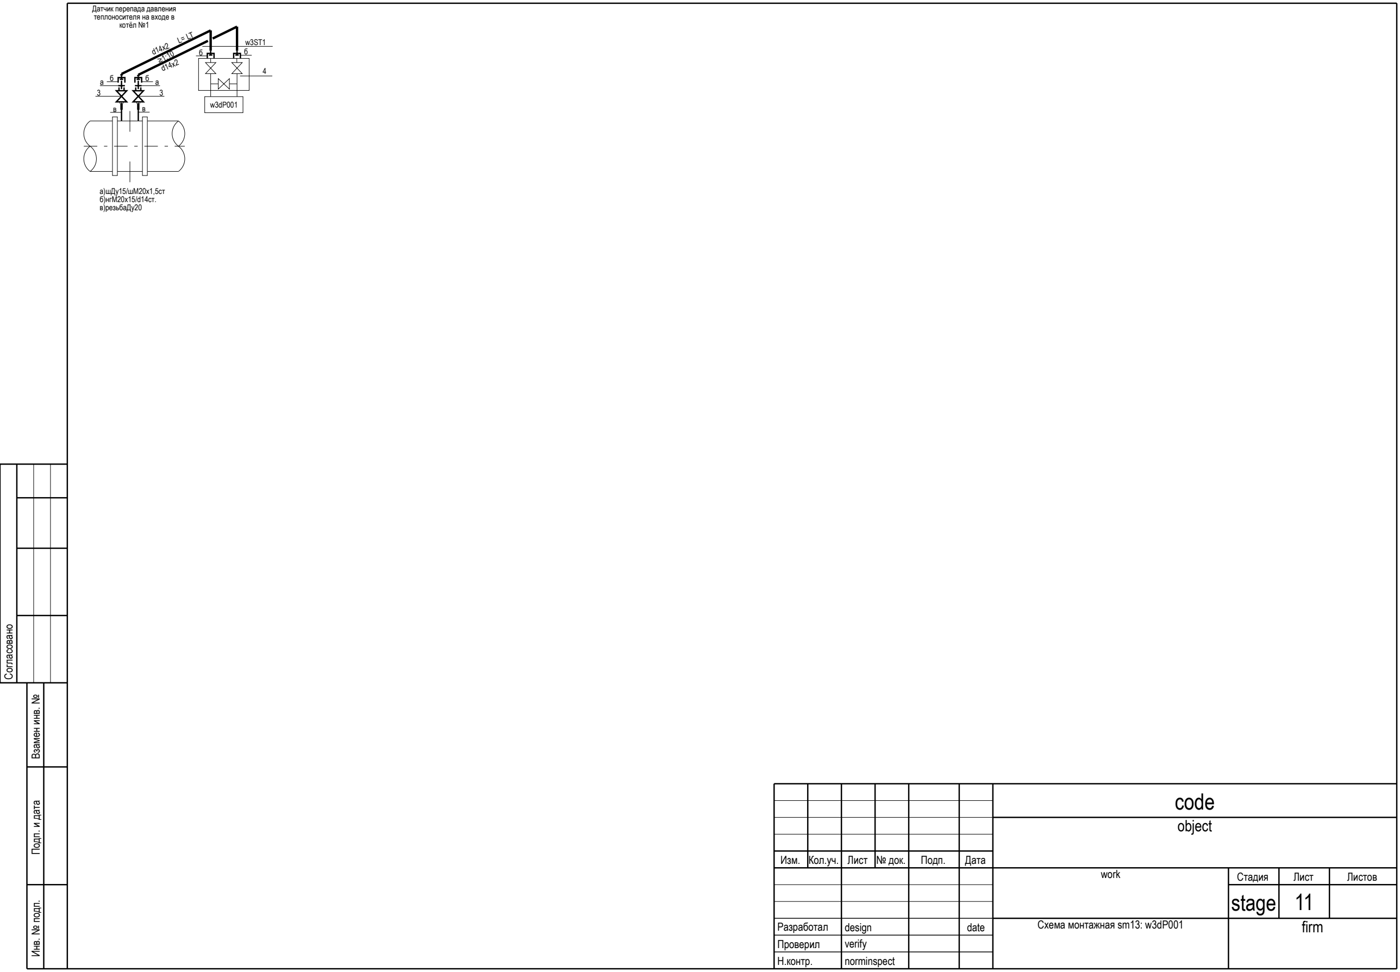
[picture p28: figure]
stage; Схема монтажная sm13: w3dP001; firm; object; code; work; Стадия; Лист; Листов; Инв. № подп. Подп. и дата Взамен инв. №; Согласовано; Изм.; Кол.уч.; № док.; Подп.; Дата; Датчик перепада давления теплоносителя на входе в котёл №1; а)шДу15/шМ20х1,5ст б)нгМ20х15/d14ст. в)резьбаДу20
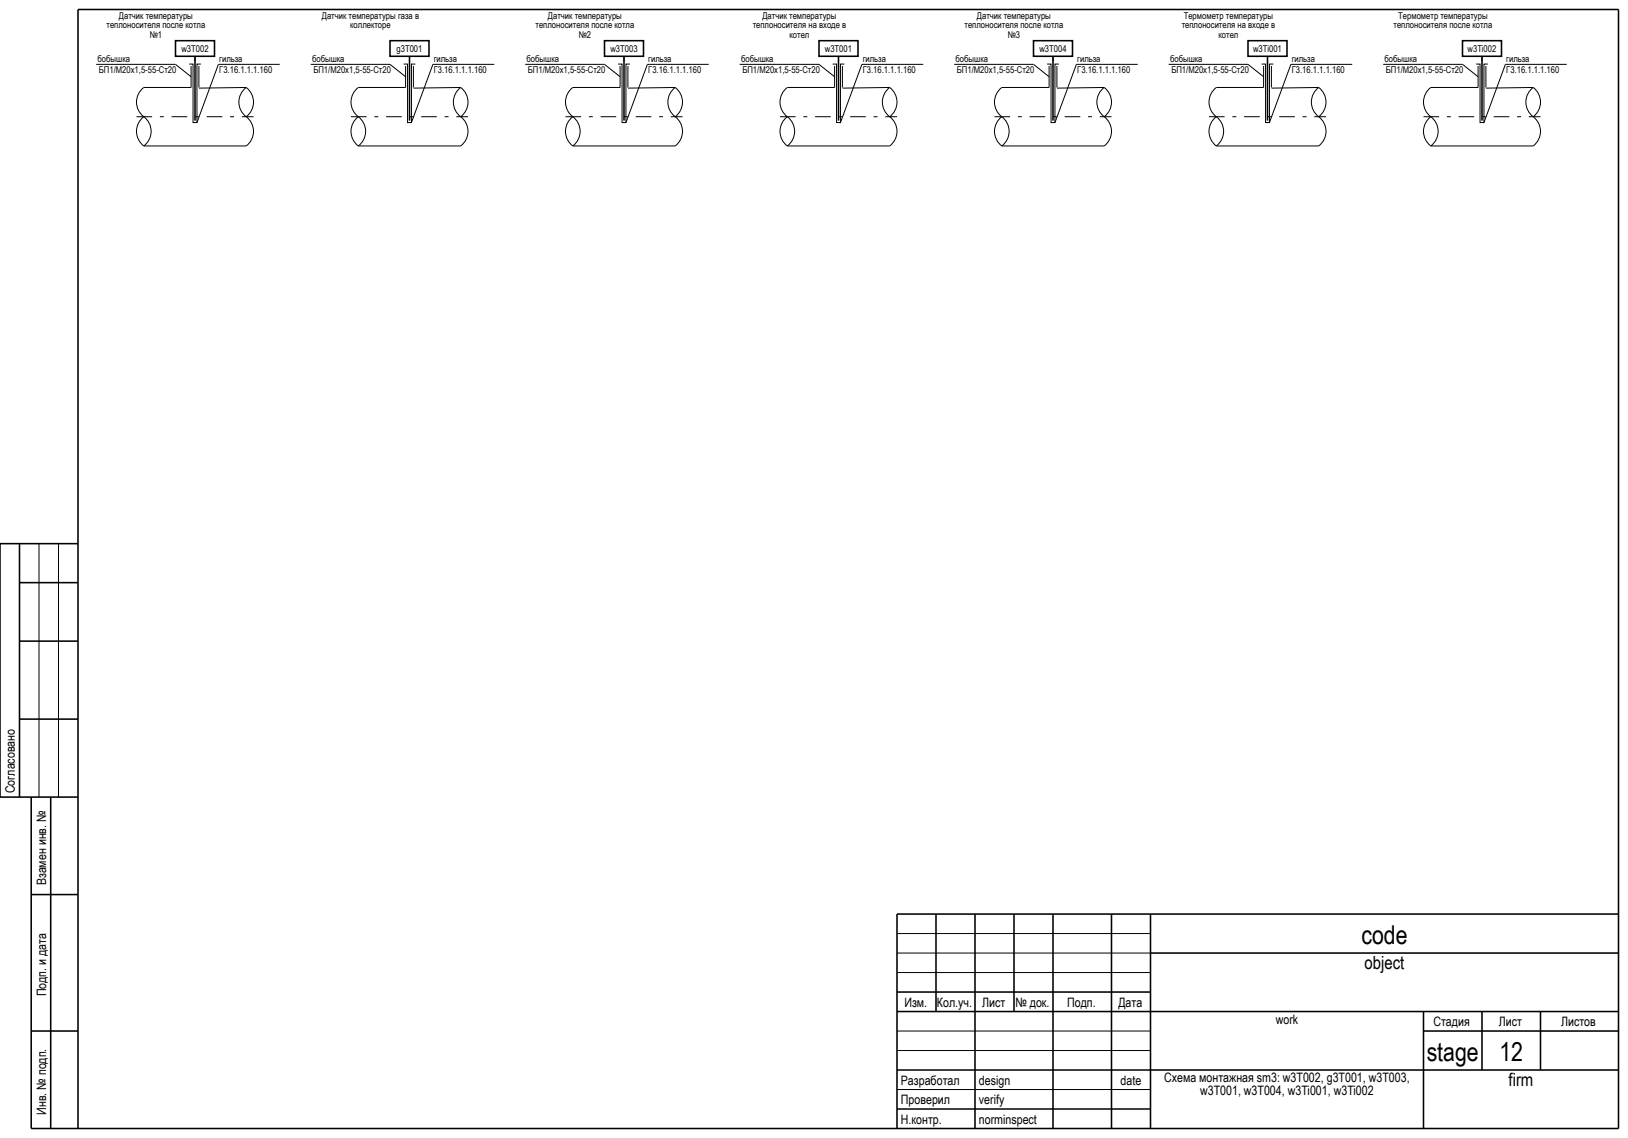
[picture p29: page 12]
Согласовано; бобышка; гильза; котел

Датчик температуры
теплоносителя после котла

Датчик температуры газа в
коллекторе

теплоносителя на входе в

Термометр температуры

Инв. № подп. Подп. и дата Взамен инв. №

code
object

Изм. | Кол.уч. | Лист | № док. | Подп. | Дата

work | Стадия | Лист | Листов

stage | 12

Схема монтажная sm3: w3T002, g3T001, w3T003, w3T001, w3T004, w3Ti001, w3Ti002

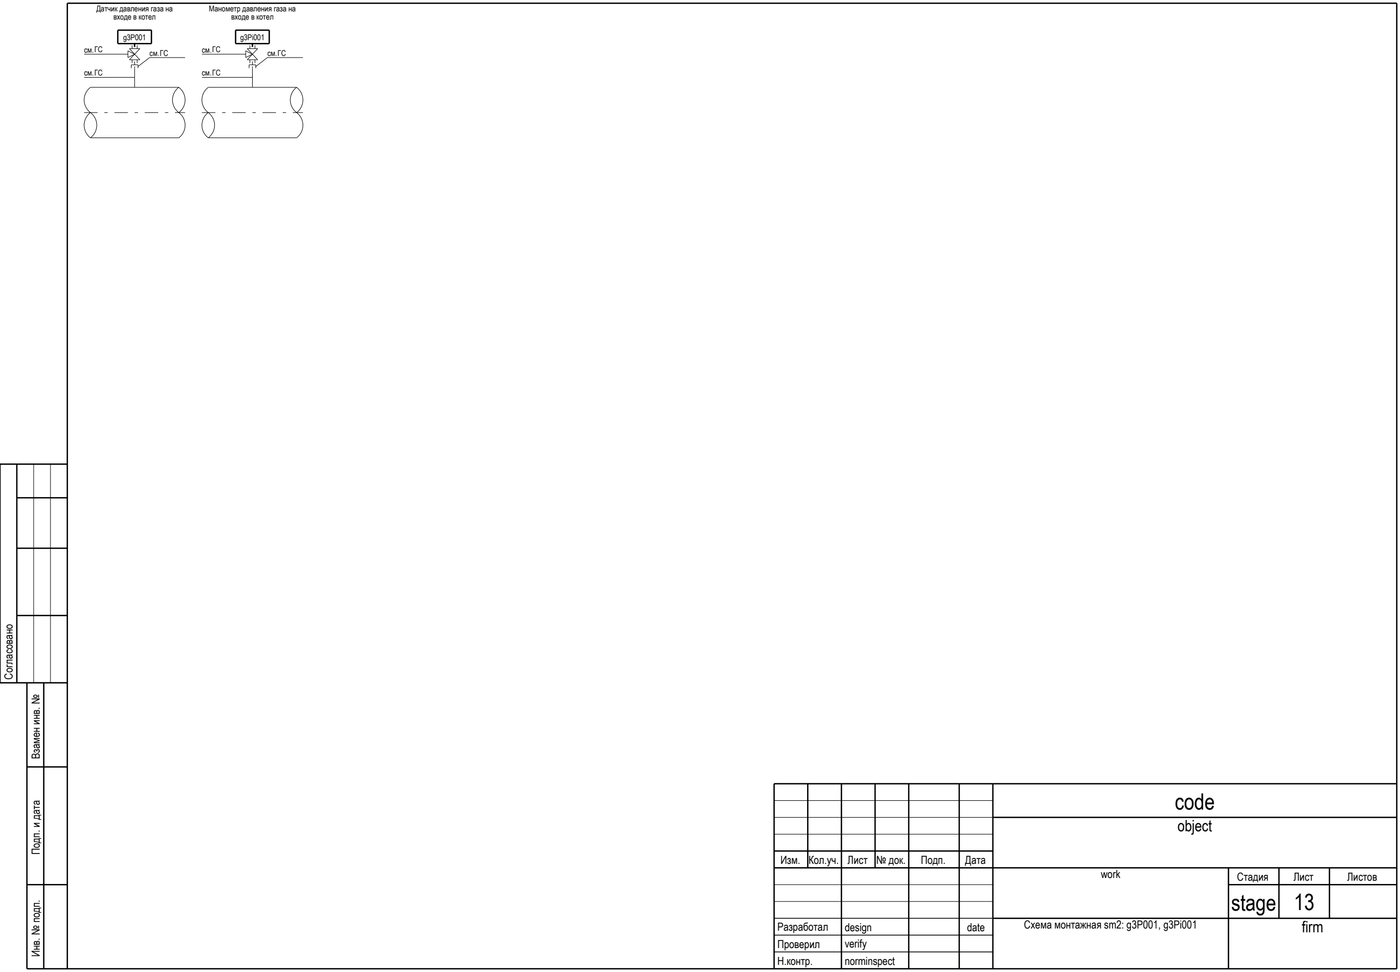
[picture p30: figure]
stage; Схема монтажная sm2: g3P001, g3Pi001; firm; object; code; work; Стадия; Лист; Листов; Инв. № подп. Подп. и дата Взамен инв. №; Согласовано; Изм.; Кол.уч.; № док.; Подп.; Дата; Датчик давления газа на входе в котел; Манометр давления газа на входе в котел

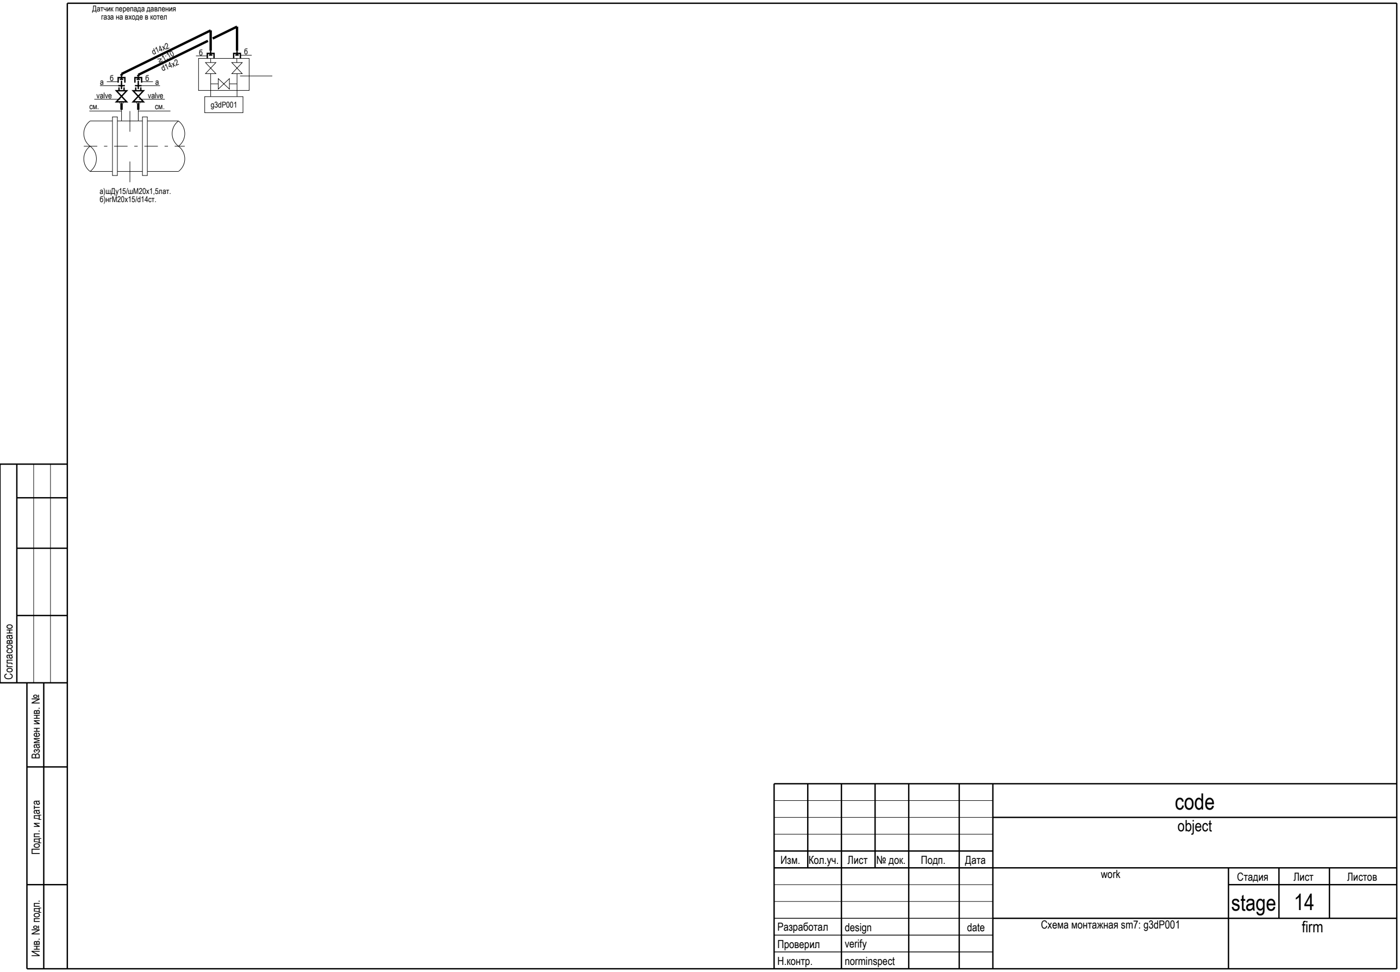
[picture p31: figure]
stage; Схема монтажная sm7: g3dP001; firm; object; code; work; Стадия; Лист; Листов; Инв. № подп. Подп. и дата Взамен инв. №; Согласовано; Изм.; Кол.уч.; № док.; Подп.; Дата; Датчик перепада давления газа на входе в котел; а)шДу15/шМ20х1,5лат. б)нгМ20х15/d14ст.; valve

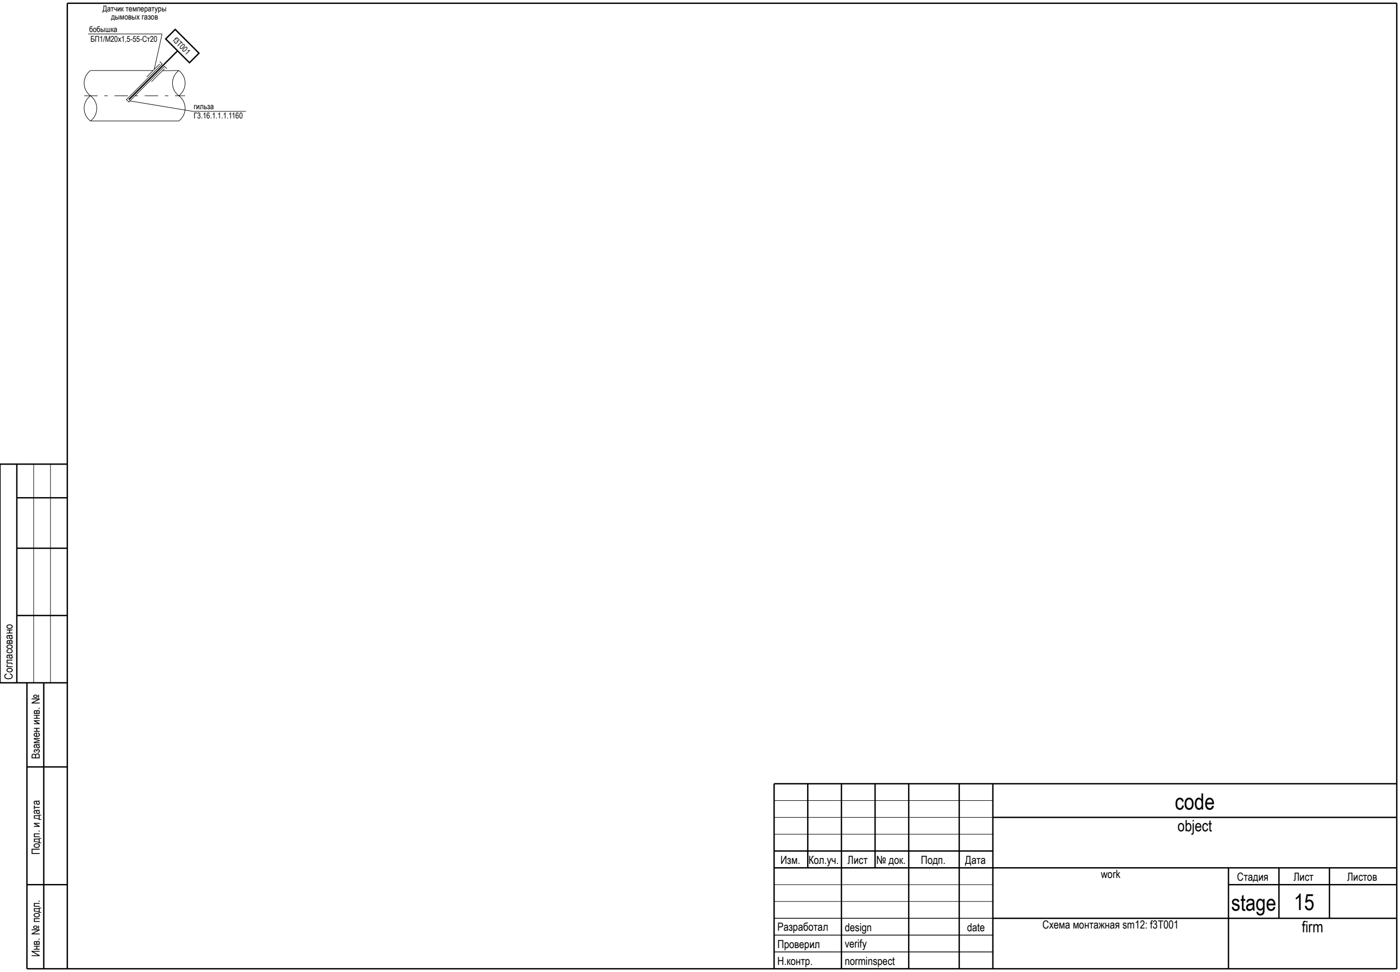
[picture p32: figure]
stage; Схема монтажная sm12: f3T001; firm; object; code; work; Стадия; Лист; Листов; Инв. № подп. Подп. и дата Взамен инв. №; Согласовано; Изм.; Кол.уч.; № док.; Подп.; Дата; Датчик температуры дымовых газов бобышка БП1/М20х1,5-55-Ст20; гильза Г3.16.1.1.1.1160

# code

## object

Инв. № подп. Подп. и дата Взамен инв. №

Согласовано

Изм. | Кол.уч. | Лист | № док. | Подп. | Дата
| | | | work | Стадия | Лист | Листов
| | | | | stage | 16
| | | | Схема монтажная sm14: w3dP002, w3dP003 | firm

Датчик перепада давления
теплоносителя на входе в
котёл №2

w3dP002

4

w3ST1
а | a

а)шДу15/шМ20х1,5ст.

Датчик перепада давления
теплоносителя на входе в
котёл №3

w3dP003

4

w3ST1
а | a

а)шДу15/шМ20х1,5ст.

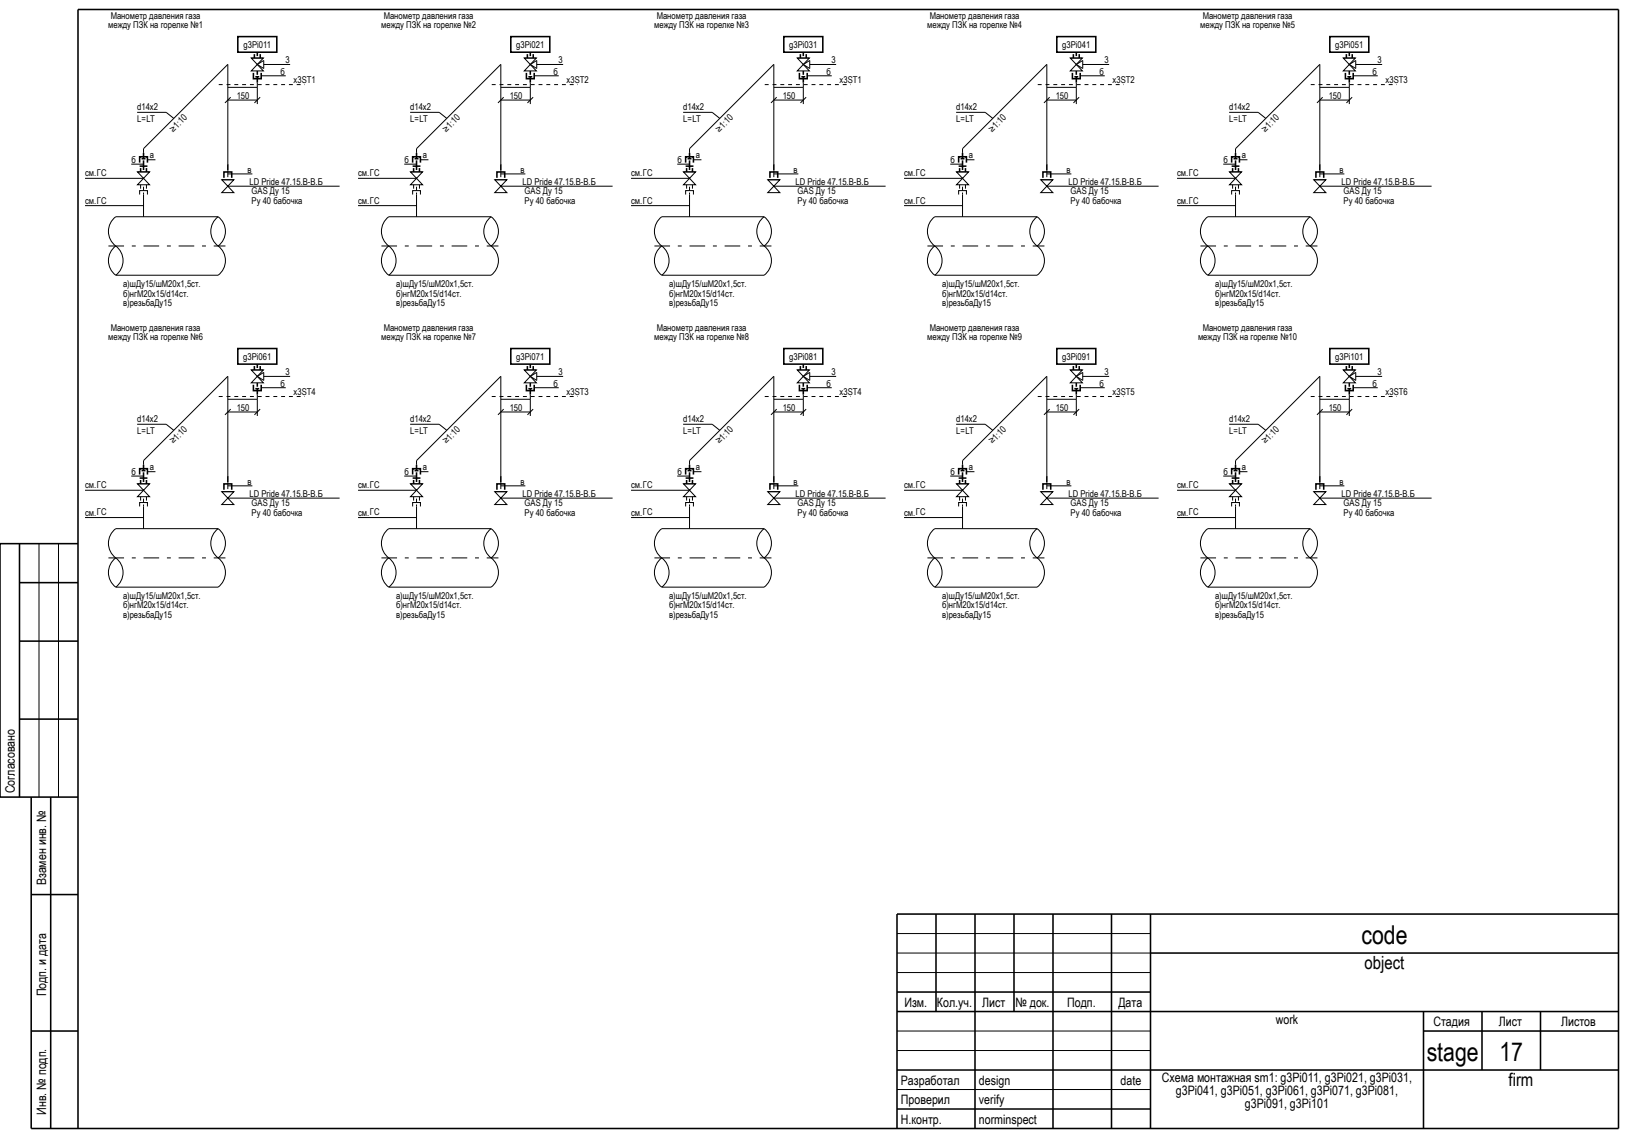
[picture p33: page 17]
Согласовано; LD Pride 47.15.В-В.Б GAS Ду 15 Ру 40 бабочка; а)шДу15/шМ20х1,5ст. б)нгМ20х15/d14ст. в)резьбаДу15

Манометр давления газа
между ПЗК на горелке №1

между ПЗК на горелке №2

между ПЗК на горелке №3

между ПЗК на горелке №4

между ПЗК на горелке №5

между ПЗК на горелке №6

между ПЗК на горелке №7

между ПЗК на горелке №8

между ПЗК на горелке №9

между ПЗК на горелке №10

Инв. № подп. Подп. и дата Взамен инв. №

code
object

Изм. | Кол.уч. | Лист | № док. | Подп. | Дата

work | Стадия | Лист | Листов

stage | 17

Схема монтажная sm1: g3Pi011, g3Pi021, g3Pi031, g3Pi041, g3Pi051, g3Pi061, g3Pi071, g3Pi081, g3Pi091, g3Pi101

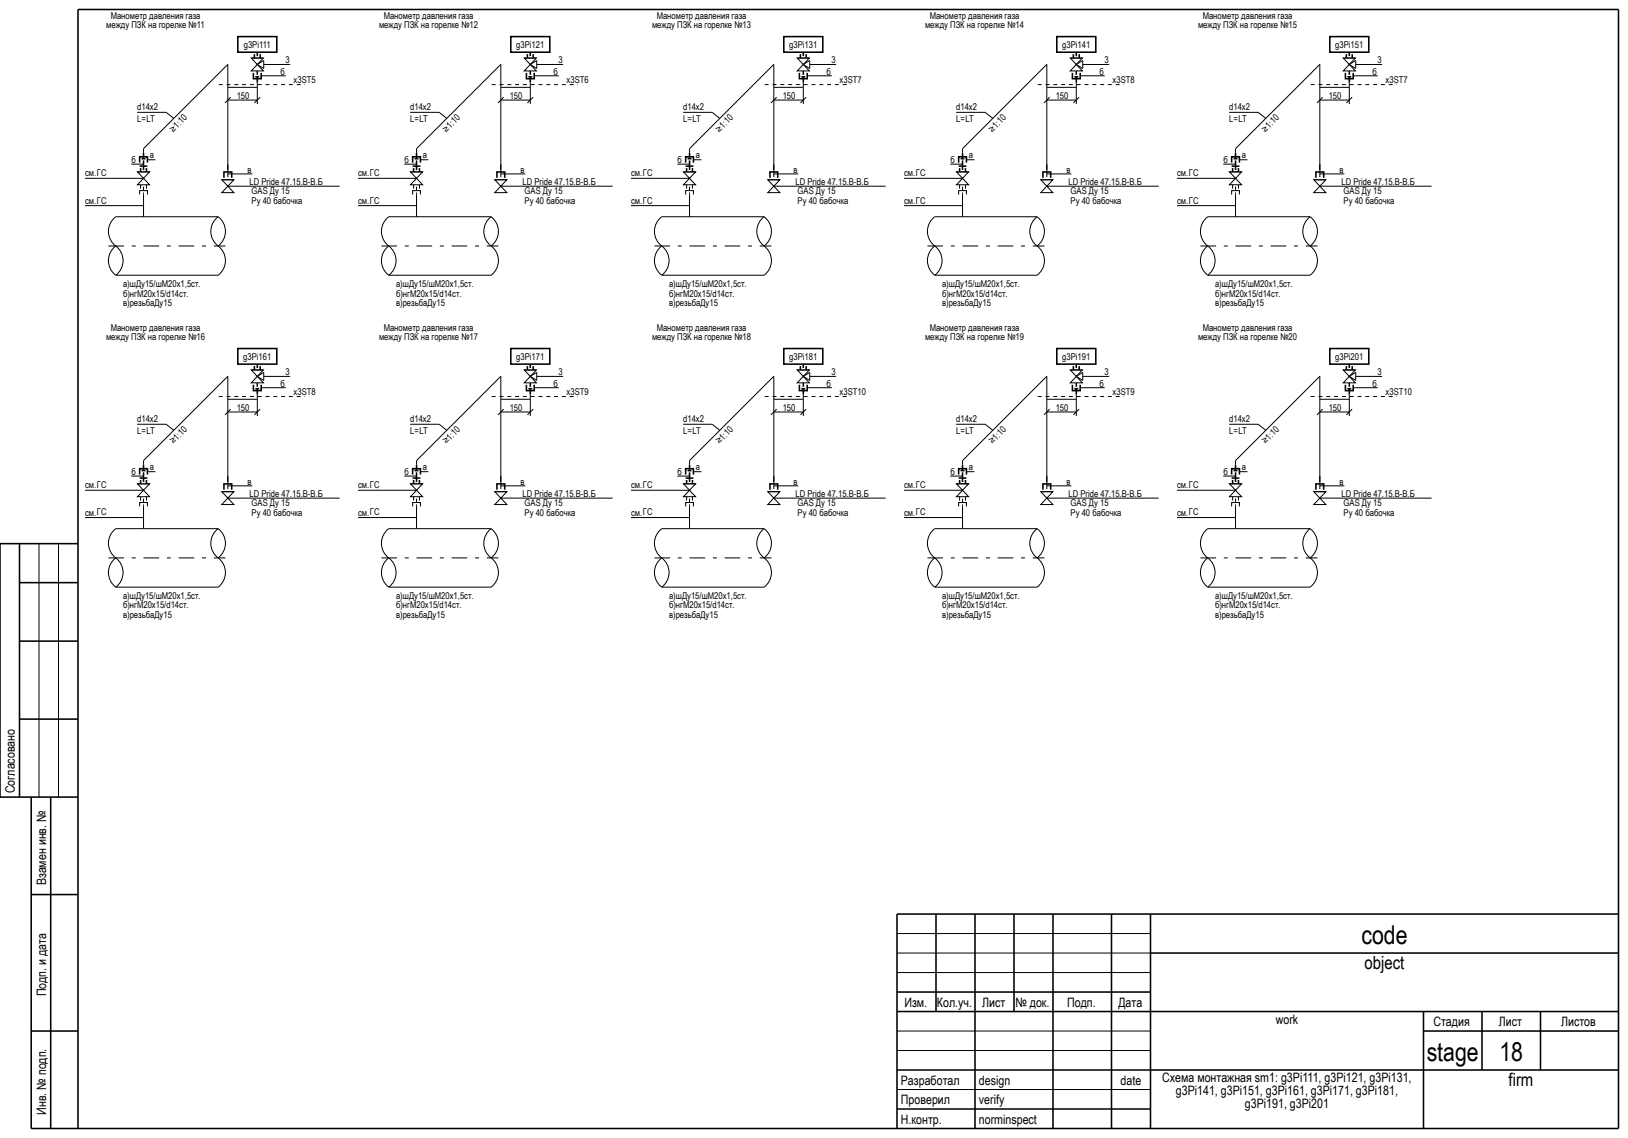
[picture p34: page 18]
Согласовано; LD Pride 47.15.В-В.Б GAS Ду 15 Ру 40 бабочка; а)шДу15/шМ20х1,5ст. б)нгМ20х15/d14ст. в)резьбаДу15

Манометр давления газа
между ПЗК на горелке №11

между ПЗК на горелке №12

между ПЗК на горелке №13

между ПЗК на горелке №14

между ПЗК на горелке №15

между ПЗК на горелке №16

между ПЗК на горелке №17

между ПЗК на горелке №18

между ПЗК на горелке №19

между ПЗК на горелке №20

Инв. № подп. Подп. и дата Взамен инв. №

code
object

Изм. | Кол.уч. | Лист | № док. | Подп. | Дата

work | Стадия | Лист | Листов

stage | 18

Схема монтажная sm1: g3Pi111, g3Pi121, g3Pi131, g3Pi141, g3Pi151, g3Pi161, g3Pi171, g3Pi181, g3Pi191, g3Pi201

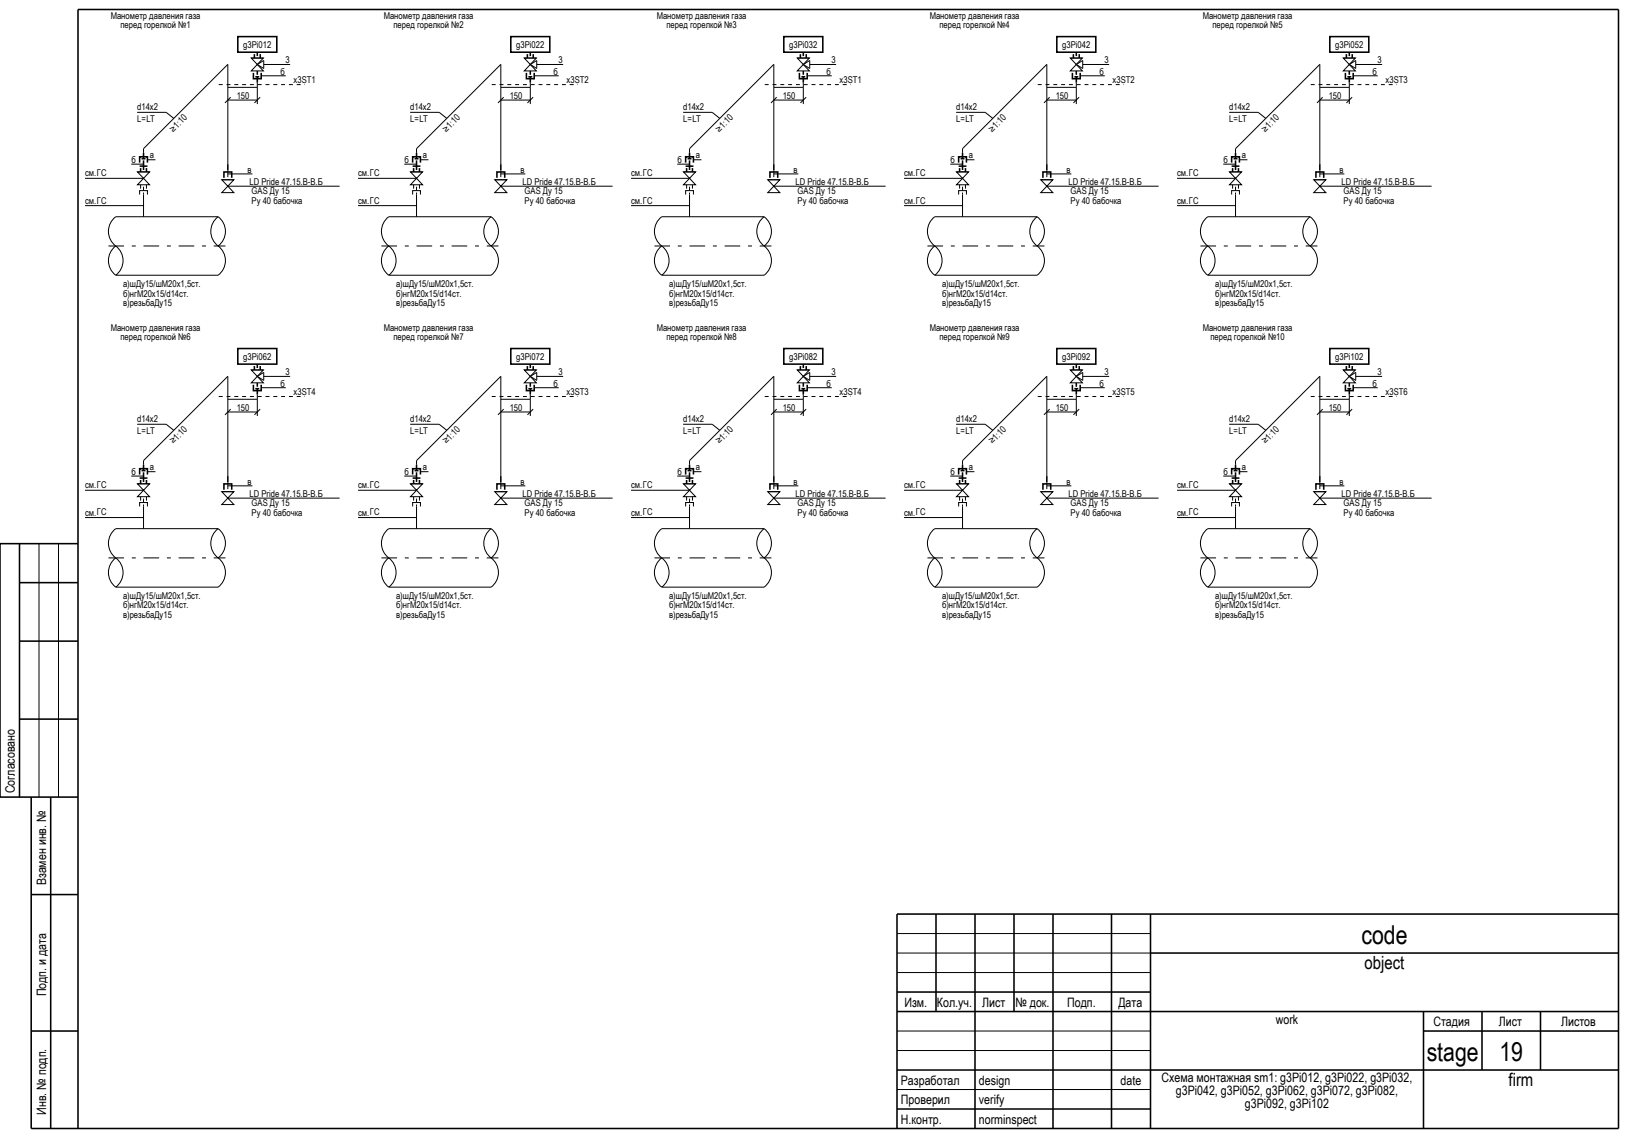
[picture p35: page 19]
Согласовано; LD Pride 47.15.В-В.Б GAS Ду 15 Ру 40 бабочка; а)шДу15/шМ20х1,5ст. б)нгМ20х15/d14ст. в)резьбаДу15

Манометр давления газа
перед горелкой №1

перед горелкой №2

перед горелкой №3

перед горелкой №4

перед горелкой №5

перед горелкой №6

перед горелкой №7

перед горелкой №8

перед горелкой №9

перед горелкой №10

Инв. № подп. Подп. и дата Взамен инв. №

code
object

Изм. | Кол.уч. | Лист | № док. | Подп. | Дата

work | Стадия | Лист | Листов

stage | 19

Схема монтажная sm1: g3Pi012, g3Pi022, g3Pi032, g3Pi042, g3Pi052, g3Pi062, g3Pi072, g3Pi082, g3Pi092, g3Pi102

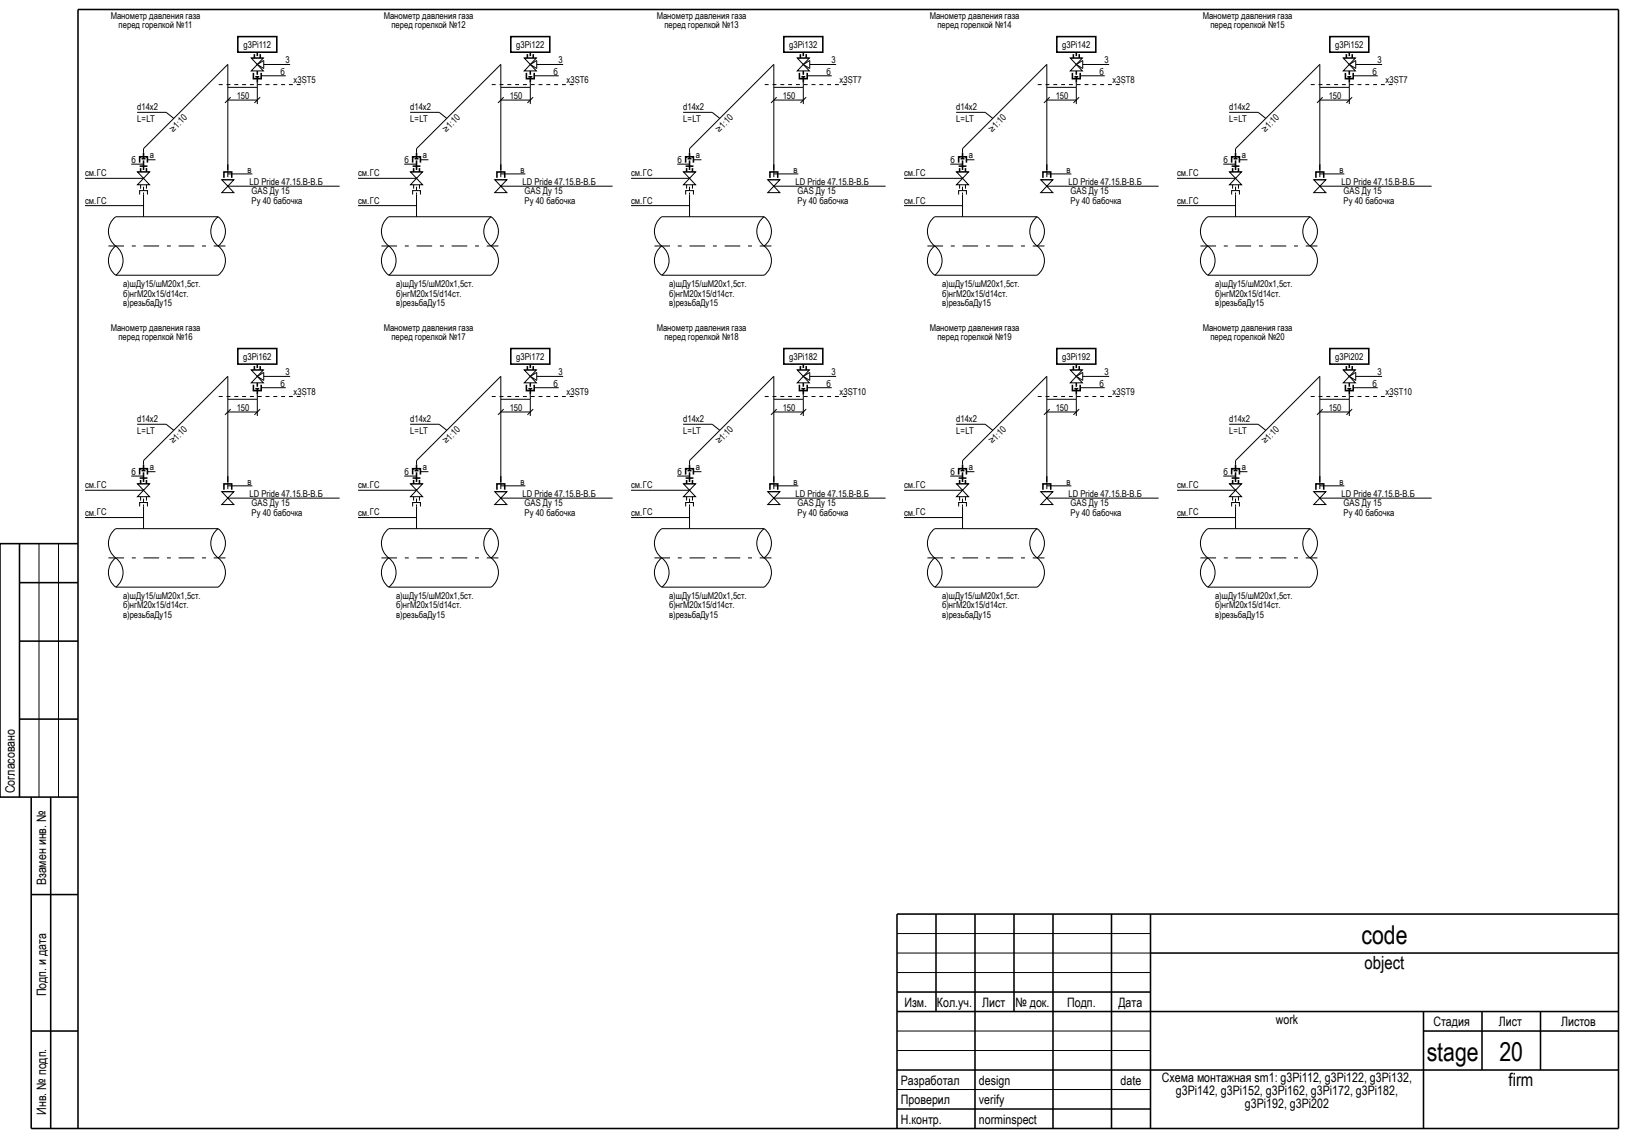
[picture p36: page 20]
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

Манометр давления газа
перед горелкой №11

перед горелкой №12

перед горелкой №13

перед горелкой №14

перед горелкой №15

перед горелкой №16

перед горелкой №17

перед горелкой №18

перед горелкой №19

перед горелкой №20

Инв. № подп. Подп. и дата Взамен инв. №

code
object

Изм. | Кол.уч. | Лист | № док. | Подп. | Дата

work | Стадия | Лист | Листов

stage | 20

Схема монтажная sm1: g3Pi112, g3Pi122, g3Pi132, g3Pi142, g3Pi152, g3Pi162, g3Pi172, g3Pi182, g3Pi192, g3Pi202

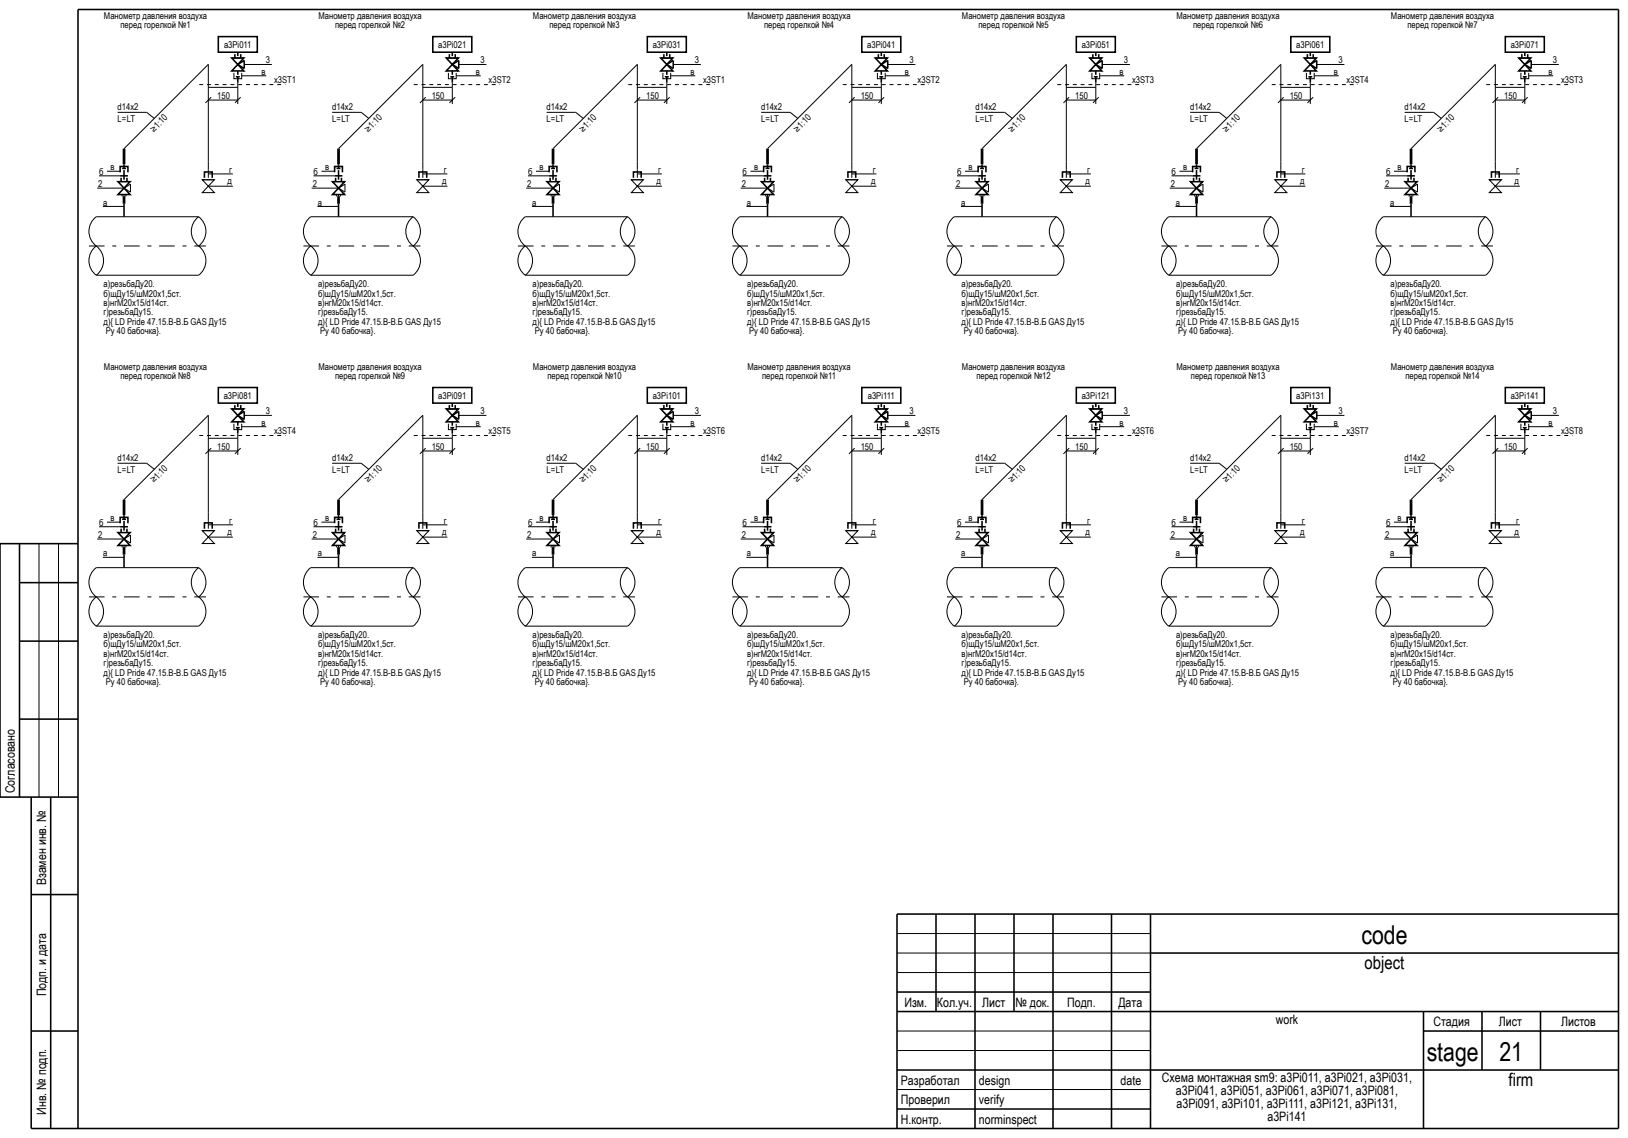
[picture p37: page 21]
Согласовано; а)резьбаДу20. б)шДу15/шМ20х1,5ст. в)нгМ20х15/d14ст. г)резьбаДу15. д){ LD Pride 47.15.В-В.Б GAS Ду15 Ру 40 бабочка}.

Манометр давления воздуха
перед горелкой №1

перед горелкой №2

перед горелкой №3

перед горелкой №4

перед горелкой №5

перед горелкой №6

перед горелкой №7

перед горелкой №8

перед горелкой №9

перед горелкой №10

перед горелкой №11

перед горелкой №12

перед горелкой №13

перед горелкой №14

Инв. № подп. Подп. и дата Взамен инв. №

code
object

Изм. | Кол.уч. | Лист | № док. | Подп. | Дата

work | Стадия | Лист | Листов

stage | 21

Схема монтажная sm9: а3Pi011, а3Pi021, а3Pi031, а3Pi041, а3Pi051, а3Pi061, а3Pi071, а3Pi081, а3Pi091, а3Pi101, а3Pi111, а3Pi121, а3Pi131, а3Pi141

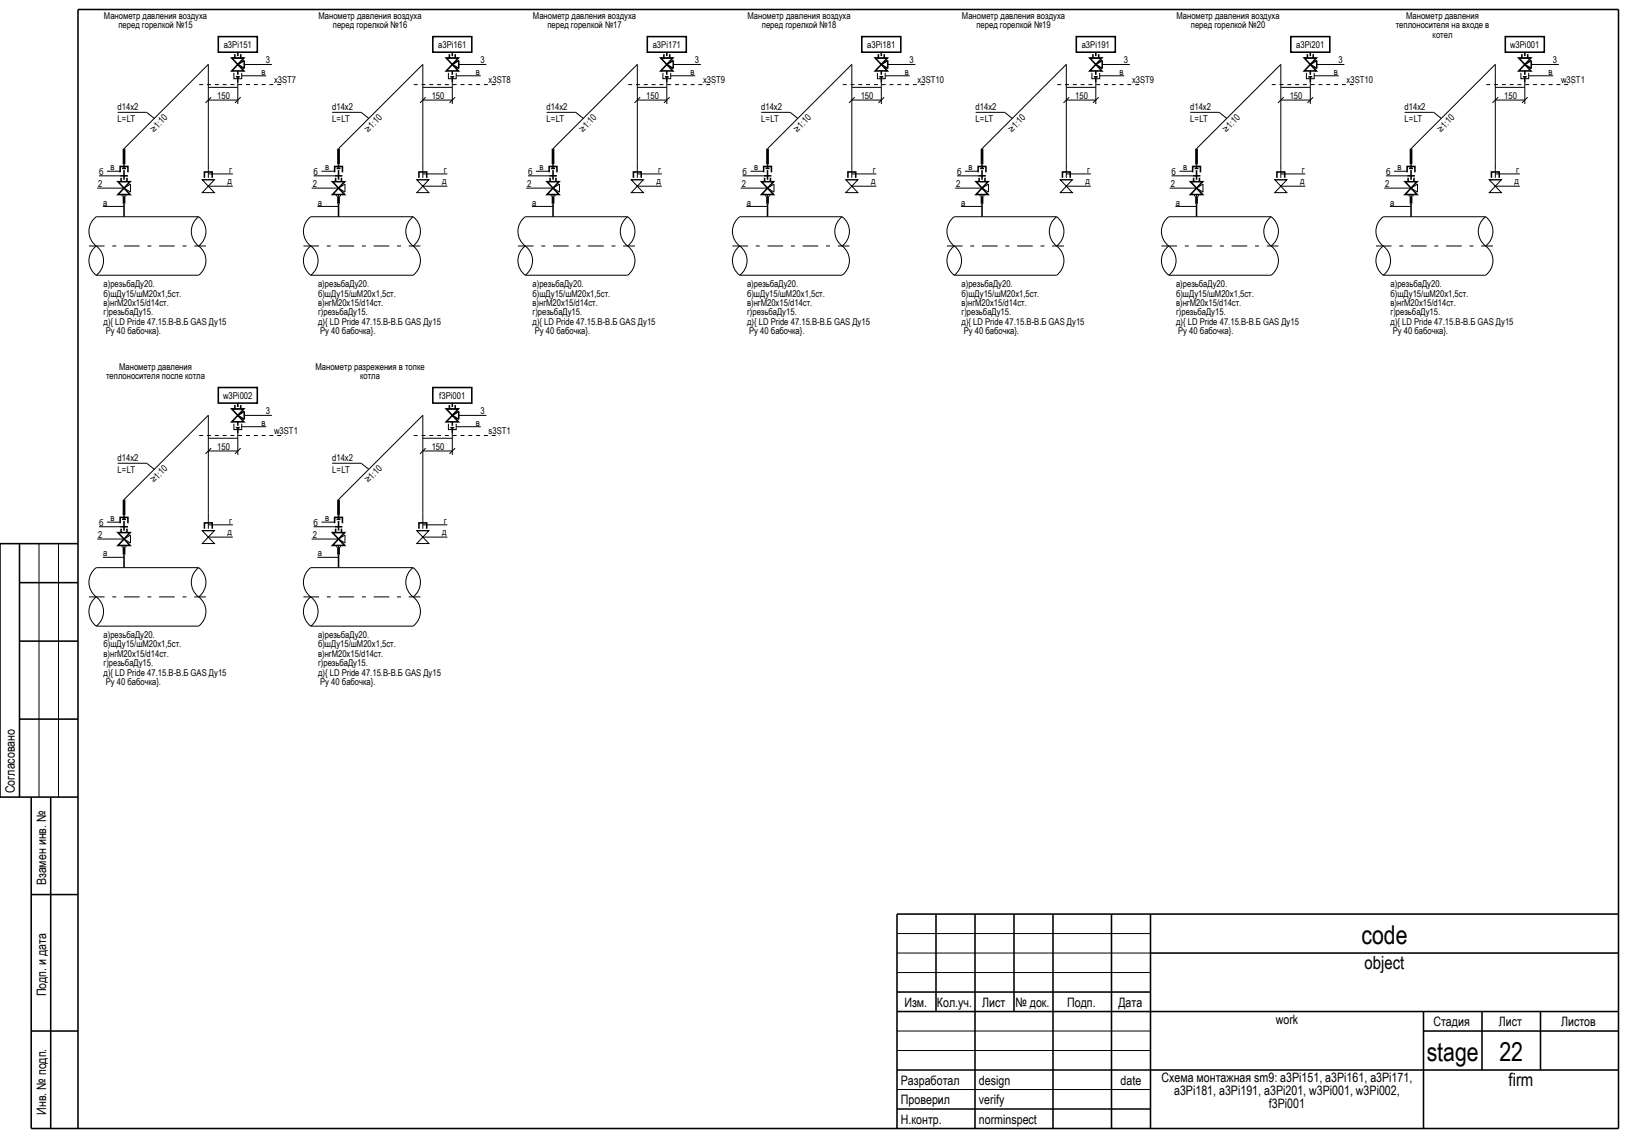
[picture p38: page 22]
Согласовано; а)резьбаДу20. б)шДу15/шМ20х1,5ст. в)нгМ20х15/d14ст. г)резьбаДу15. д){ LD Pride 47.15.В-В.Б GAS Ду15 Ру 40 бабочка}.; котел; котла

Манометр давления воздуха
перед горелкой №15

перед горелкой №16

перед горелкой №17

перед горелкой №18

перед горелкой №19

перед горелкой №20

Манометр давления
теплоносителя на входе в

теплоносителя после котла

Манометр разрежения в топке

Инв. № подп. Подп. и дата Взамен инв. №

code
object

Изм. | Кол.уч. | Лист | № док. | Подп. | Дата

work | Стадия | Лист | Листов

stage | 22

Схема монтажная sm9: а3Pi151, а3Pi161, а3Pi171, а3Pi181, а3Pi191, а3Pi201, w3Pi001, w3Pi002, f3Pi001

# code

## object

Инв. № подп. Подп. и дата Взамен инв. №

Согласовано

Изм. | Кол.уч. | Лист | № док. | Подп. | Дата
| | | | work | Стадия | Лист | Листов
| | | | | stage | 23
| | | | Схема монтажная sm4: g3Ti001 | firm

g3Ti001

Термометр температуры газа в коллекторе

ГС | ГС
бобышка | гильза
см. | см.

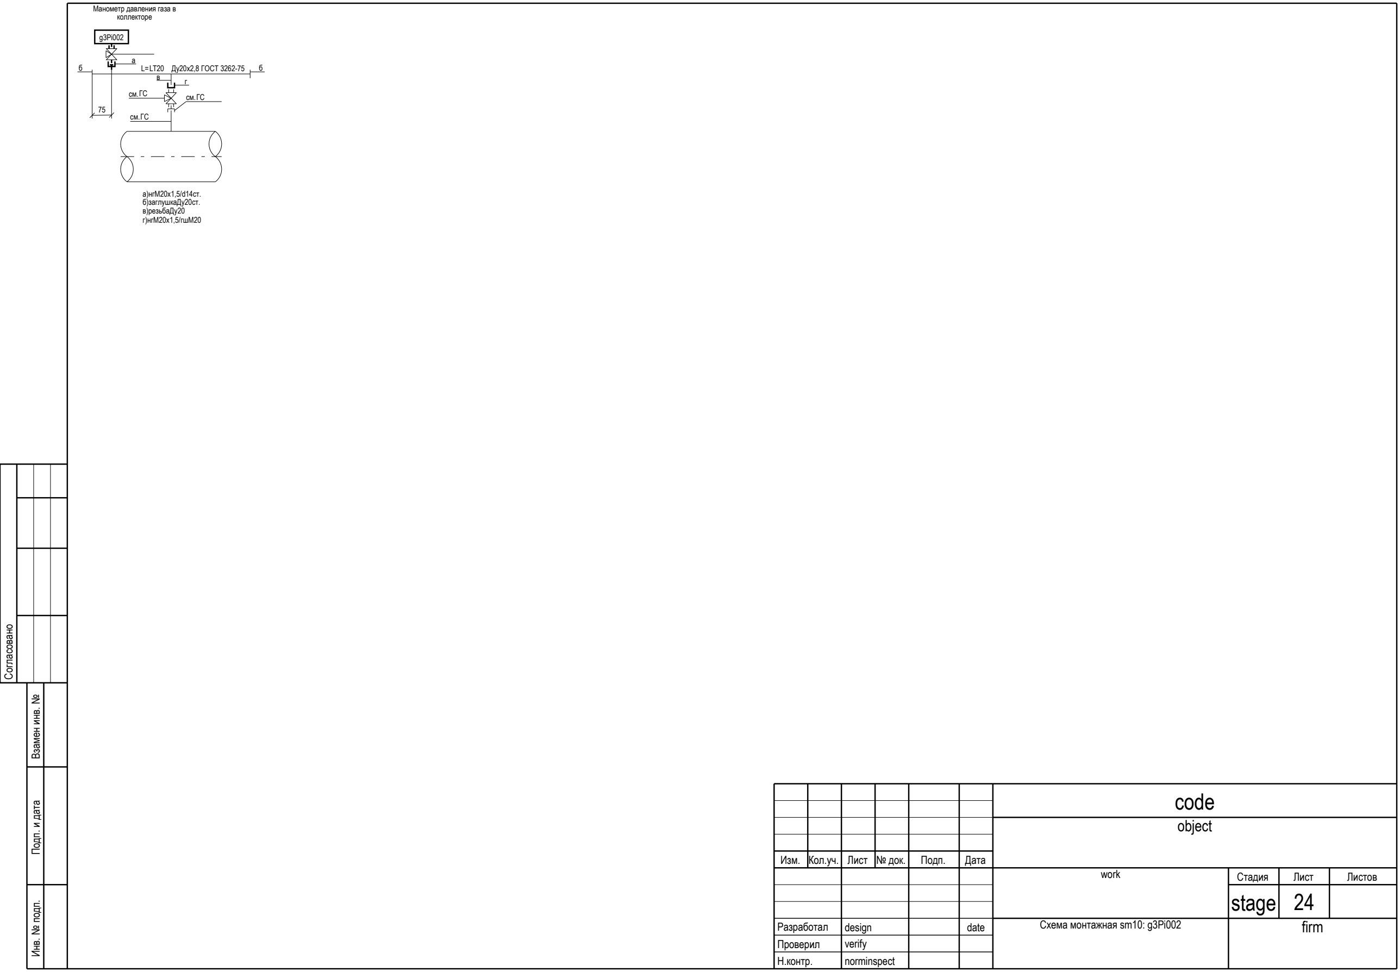
[picture p39: figure]
stage; Схема монтажная sm10: g3Pi002; firm; object; code; work; Стадия; Лист; Листов; Инв. № подп. Подп. и дата Взамен инв. №; Согласовано; Изм.; Кол.уч.; № док.; Подп.; Дата; Манометр давления газа в коллекторе; а)нгМ20х1,5/d14ст. б)заглушкаДу20ст.; в)резьбаДу20; г)нгМ20х1,5/гшМ20; Ду20х2,8 ГОСТ 3262-75

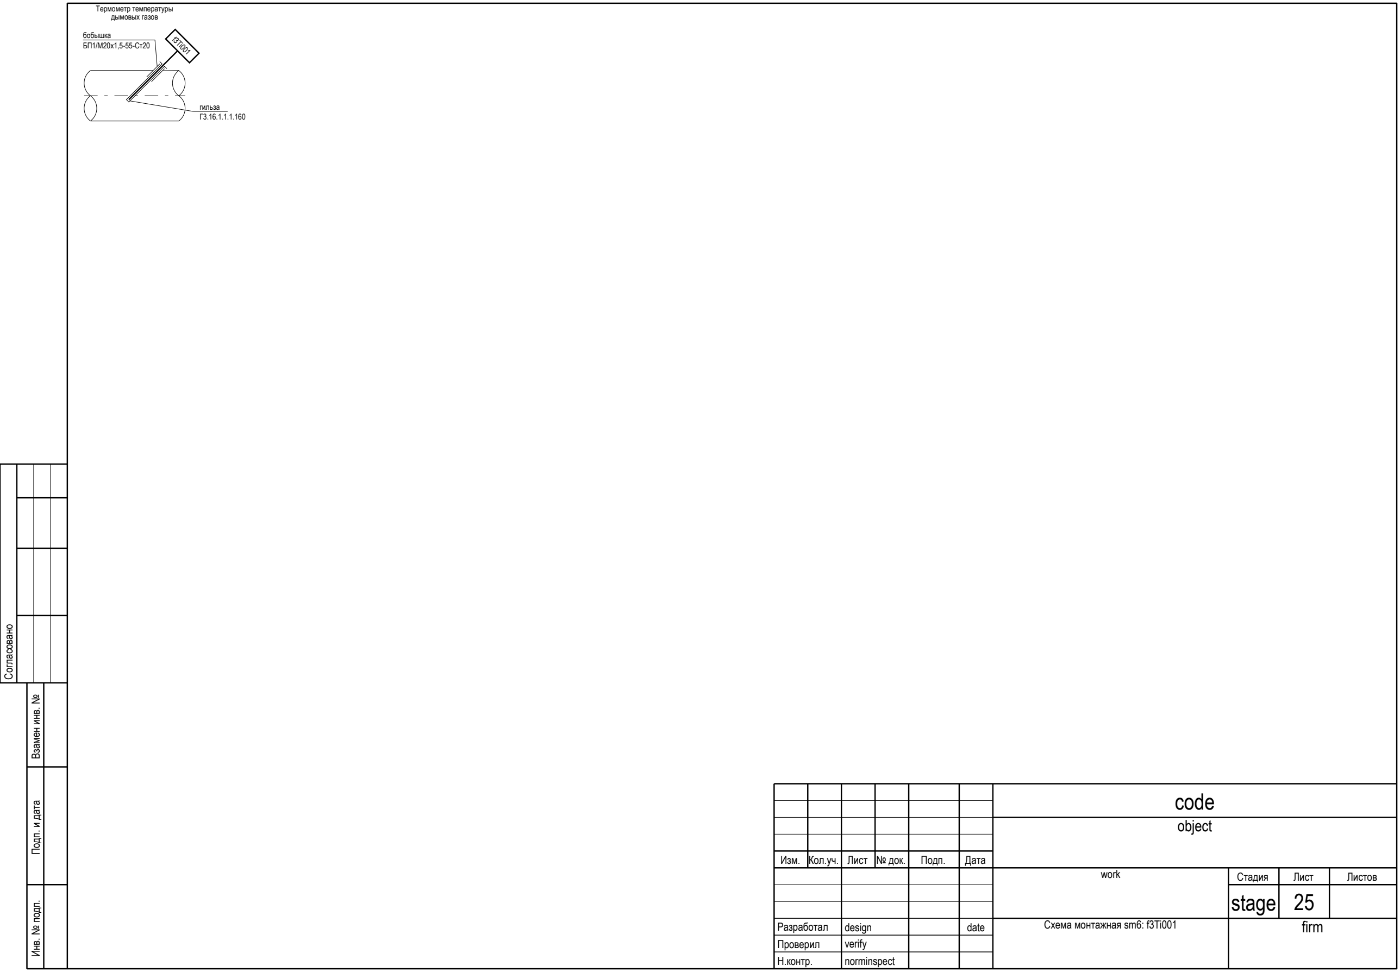
[picture p40: figure]
stage; Схема монтажная sm6: f3Ti001; firm; object; code; work; Стадия; Лист; Листов; Инв. № подп. Подп. и дата Взамен инв. №; Согласовано; Изм.; Кол.уч.; № док.; Подп.; Дата; Термометр температуры дымовых газов; бобышка; гильза
