nppesnteam/370-24_Balakovo_PTVM180_-3-4/АК3/ШАВР/ШАВР_расположение_ячеек_вер4.pdf

# Шкаф ШАВР+ШП внешний_вид (вер_4)

Формат А3 | 16.09.2024 Масштаб 1:1

# Балаково

Изм. | Кол. | Лист | № | Подпись | Дата

# Лист

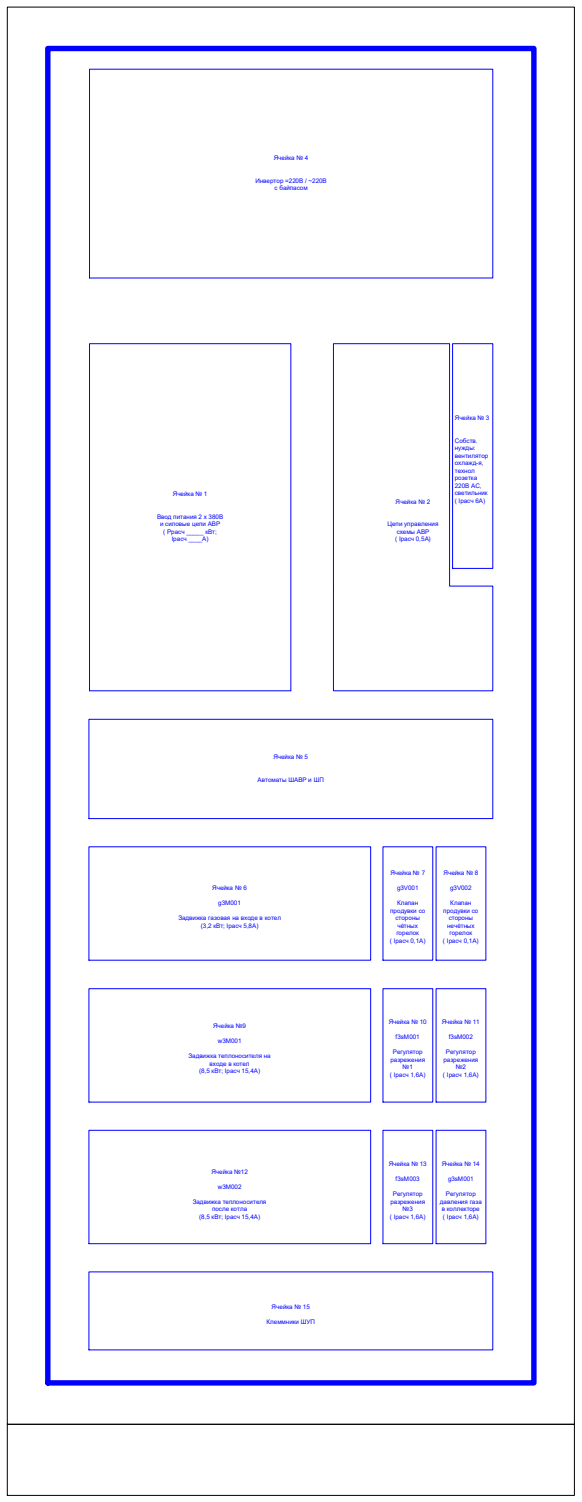
[picture p58: figure]
Ячейка № 6; Задвижка газовая на входе в котел (3,2 кВт; Iрасч 5,8А); Ячейка № 7; Клапан продувки со стороны чётных горелок ( Iрасч 0,1А); Ячейка № 8; Клапан продувки со стороны нечётных горелок ( Iрасч 0,1А); Ячейка №9; Задвижка теплоносителя на входе в котел (8,5 кВт; Iрасч 15,4А); Ячейка № 10; Регулятор разрежения №1 ( Iрасч 1,6А); Ячейка № 11; Регулятор разрежения №2 ( Iрасч 1,6А); Ячейка №12; Задвижка теплоносителя после котла (8,5 кВт; Iрасч 15,4А); Ячейка № 13; Регулятор разрежения №3 ( Iрасч 1,6А); Ячейка № 14; Регулятор давления газа в коллекторе ( Iрасч 1,6А); Ячейка № 5; Автоматы ШАВР и ШП; Ячейка № 15; Клеммники ШУП; Ячейка № 3; Собств. нужды: вентилятор охлажд-я, технол розетка 220В АС, светильник; Ячейка № 2; ( Iрасч 6А); Цепи управления схемы АВР ( Iрасч 0,5А); Ячейка № 1; Ввод питания 2 х 380В и силовые цепи АВР ( Ррасч _____ кВт; Iрасч ____А); Ячейка № 4; Инвертор =220В / ~220В с байпасом

Передняя панель

Цоколь
