nppesnteam/370-24_Balakovo_PTVM180_-3-4/Docs/Схема подключения ИВН-01Е.jpg

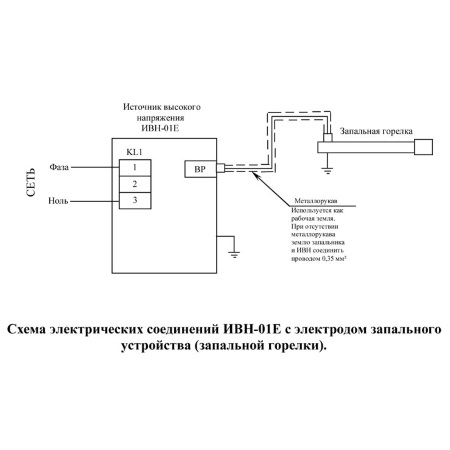
Docs/Схема подключения ИВН-01Е.jpg
