nppesnteam/370-24_Balakovo_PTVM180_-3-4/Docs/Схема подключения ФДСА-03М.jpg

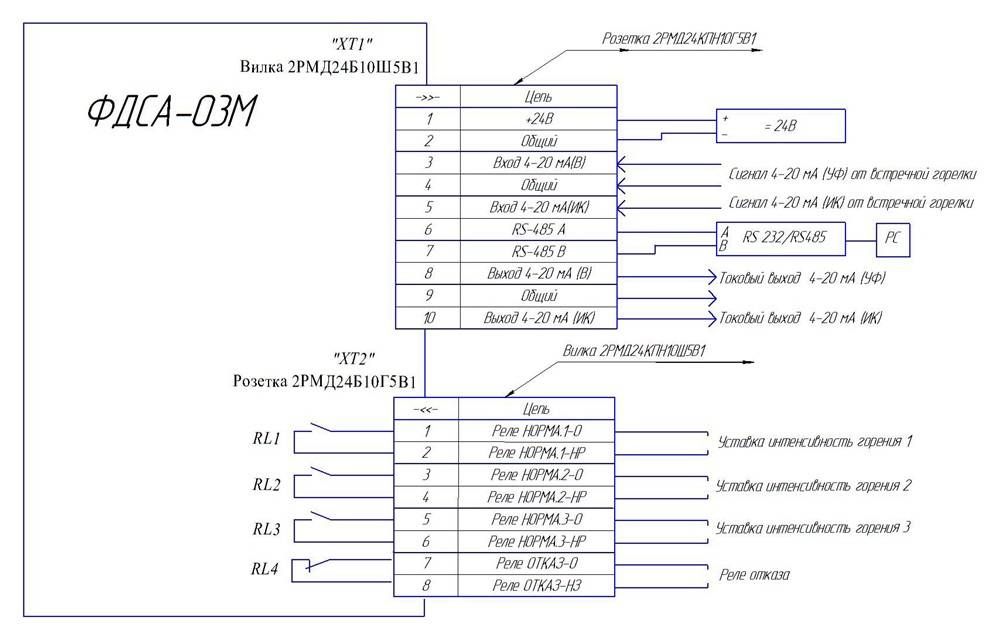
Docs/Схема подключения ФДСА-03М.jpg
