nppesnteam/370-24_Balakovo_PTVM180_-3-4/SM/370-24_балаково_птвм180n3n4/sm Балаково/sm spec.xlsx

skheme | pos | count | code | maker | mu | count | weight | addinfo | кол-во sm | Итого | кол-во sm | Итого
 |  |  |  |  |  |  |  |  | 40
sm1 | Штуцер переходной стальной |  | М20х1,5/М15х1,5 | ООО "ГазТест" | шт | 1 | 0.07 |  |  | 40
 | Гайка М20 |  | SN-20М | ООО "ГазТест" | шт | 1 | 0.06 |  |  | 40
 | Ниппельное соединение навертное |  | НСН-14-М20*1,5 ст.20 | Торговая сеть | шт | 2 | 0.2 |  |  | 80
 | Резьба стальная Ду15, L=30мм |  | ГОСТ 6357-81, ГОСТ 3262-75 | Торговая сеть | шт | 1 | 0.04 |  |  | 40
 | Кран шаровый латунный газовый для дренажа |  | LD Pride 47.15.В-В.Б GAS Ду 15 Ру 40 бабочка | LD, Челябинск | шт | 1 | 0.15 |  |  | 40
 | Вентиль с крестообразной рукояткой |  | ВИГ 25 ДГ-С-1Б1Г | ООО НПП "Гималаи" г.Самара | шт | 1 | 0.18 |  |  | 40
 | Хомут обжимной Ø25 |  |  | Торговая сеть | шт | 2 |  |  |  | 80
 | Труба d14х2 |  | ГОСТ 8734-75 |  | м
 |  |  |  |  |  |  |  |  | 6
sm3 | Бобышка |  | БП1/М20х1,5-55-Ст20 | Прома, г.Казань | шт | 1 | 0.2 |  |  | 6
 | Гильза |  | Г3.16.1.1.1.160 | Овен, г.Москва | шт | 1 | 0.1 | 2 |  | 6
 |  |  |  |  |  |  |  |  | 0
sm5 | Штуцер переходной стальной |  | М20х1,5/М15х1,5 | ООО "ГазТест" | шт | 1 | 0.07
 | Гайка М20 |  | SN-20М | ООО "ГазТест" | шт | 1 | 0.06
 | Ниппельное соединение навертное |  | НСН-14-М20*1,5 ст.20 | Торговая сеть | шт | 2 | 0.2
 | Вентиль с крестообразной рукояткой |  | ВИГ 25 ДГ-С-1Б1Г | ООО НПП "Гималаи" г.Самара | шт | 1 | 0.18
 | Труба d14х2 |  | ГОСТ 8734-75 |  | м
 | Хомут обжимной Ø25 |  |  | Торговая сеть | шт | 1
 |  |  |  |  |  |  |  |  | 1
sm6 | Бобышка |  | БП1/М20х1,5-55-Ст20 | Прома, г.Казань | шт | 1 | 0.2 |  |  | 1
 | Гильза |  | Г3.16.1.1.1.160 | Овен, г.Москва | шт | 1 | 0.1 |  |  | 1
 |  |  |  |  |  |  |  |  | 1
sm7 | Штуцер переходной стальной |  | М20х1,5/М15х1,5 | ООО "ГазТест" | шт | 2 | 0.07 |  |  | 1
 | Гайка М20 |  | SN-20М | ООО "ГазТест" | шт | 2 | 0.06 |  |  | 2
 | Ниппельное соединение навертное |  | НСН-14-М20*1,5 ст.20 | Торговая сеть | шт | 4 | 0.2 |  |  | 2
 | Кран шаровый латунный газовый |  | LD Pride 47.15.В-В.Б GAS Ду 20 Ру 40 бабочка | LD, Челябинск | шт | 2 | 0.16 |  |  | 2
 | Труба d14х2 |  | ГОСТ 8734-75 |  | м
 | Блок клапанный | БКН3-11 |  | Прома, Казань | шт | 1 | 1.5 |  |  | 1
 |  |  |  |  |  |  |  |  | 67 | 134
sm8 | Ниппельное соединение навертное |  | НСН-14-М20*1,5 ст.20 | Торговая сеть | шт | 2 | 0.2 |  |  | 67
 | Вентиль с крестообразной рукояткой |  | ВИГ 25 ДГ-С-1Б1Г | ООО НПП "Гималаи" г.Самара | шт | 1 | 0.18 |  |  | 67
 | Хомут обжимной Ø25 |  |  | Торговая сеть | шт | 1
 | Труба d14х2 |  | ГОСТ 8734-75 |  | м
 |  |  |  |  |  |  |  |  | 23
sm9 | Резьба стальная Ду20, L=30мм |  | ГОСТ 6357-81, ГОСТ 3262-75 | Торговая сеть | шт | 1 | 0.05 |  |  | 23
 | Штуцер переходной стальной |  | М20х1,5/М15х1,5 | ООО "ГазТест" | шт | 1 | 0.07 |  |  | 23
 | Гайка М20 |  | SN-20М | ООО "ГазТест" | шт | 1 | 0.06 |  |  | 23
 | Ниппельное соединение навертное |  | НСН-14-М20*1,5 ст.20 | Торговая сеть | шт | 2 | 0.2 |  |  | 46
 | Резьба стальная Ду15, L=30мм |  | ГОСТ 6357-81, ГОСТ 3262-75 | Торговая сеть | шт | 1 | 0.04 |  |  | 23
 | Кран шаровый латунный газовый для дренажа |  | LD Pride 47.15.В-В.Б GAS Ду 15 Ру 40 бабочка | LD, Челябинск | шт | 1 | 0.15 |  |  | 23
 | Вентиль с крестообразной рукояткой |  | ВИГ 25 ДГ-С-1Б1Г | ООО НПП "Гималаи" г.Самара | шт | 1 | 0.18 |  |  | 23
 | Труба d14х2 |  | ГОСТ 8734-75 |  | м
 |  |  |  |  |  |  |  |  | 0
sm10 | Ниппельное соединение навертное |  | НСН-14-М20*1,5 ст.20 | Торговая сеть | шт | 1 | 0.2 |  |  | 1
 | Заглушка Ду20 |  | ГОСТ 17379-2001 | Торговая сеть | шт | 2 | 0.04 |  |  | 2
 | Резьба стальная Ду20, L=30мм |  | ГОСТ 6357-81, ГОСТ 3262-75 | Торговая сеть | шт | 1 | 0.05 |  |  | 1
 | Ниппельное соединение с гайкой |  | нгМ20х1,5/гшМ20 | Торговая сеть | шт | 1 | 0.18 |  |  | 1
 | Вентиль с крестообразной рукояткой |  | ВИГ 25 ДГ-С-1Б1Г | ООО НПП "Гималаи" г.Самара | шт | 1 | 0.18 |  |  | 1
 | Труба Ду20х2,8 |  | ГОСТ 3262-75 |  | м |  |  |  | 0
sm11 | Ниппельное соединение навертное |  | НСН-14-М20*1,5 ст.20 | Торговая сеть | шт | 1 | 0.2
 | Вентиль с крестообразной рукояткой |  | ВИГ 25 ДГ-С-1Б1Г | ООО НПП "Гималаи" г.Самара | шт | 1 | 0.18
 |  |  |  |  |  |  |  |  | 2
sm12 | Бобышка |  | БП1/М20х1,5-55-Ст20 | Прома, г.Казань | шт | 1 | 0.2 |  |  | 2
 | Гильза |  | Г3.16.1.1.1.160 | Овен, г.Москва | шт | 1 | 0.1 |  |  | 2
 |  |  |  |  |  |  |  |  | 1
sm13 | Штуцер переходной стальной |  | М20х1,5/М15х1,5 | ООО "ГазТест" | шт | 1 | 0.07 |  |  | 1
 |  |  |  |  |  |  |  |  |  | 2
 | Ниппельное соединение навертное |  | НСН-14-М20*1,5 ст.20 | Торговая сеть | шт | 2 | 0.2 |  |  | 2
 | Гайка М20 |  | SN-20М | ООО "ГазТест" | шт | 2 | 0.06 |  |  | 1
 | Резьба стальная Ду20, L=30мм |  | ГОСТ 6357-81, ГОСТ 3262-75 | Торговая сеть | шт | 1 | 0.05 |  |  | 2
 | Кран шаровый латунный газовый |  | LD Pride 47.15.В-В.Б GAS Ду 20 Ру 40 бабочка | LD, Челябинск | шт | 2 | 0.15 |  |  | 2
 | Хомут обжимной Ø25 |  |  | Торговая сеть | шт | 2
 | Труба d14х2 |  | ГОСТ 8734-75 |  | м |  |  |  |  | 1
 | Блок клапанный | БКН3-11 |  | Прома, Казань | шт | 1 | 1.5 |  |  | 1
 |  |  |  |  |  |  |  |  | 2
sm14 | Ниппельное соединение навертное |  | НСН-14-М20*1,5 ст.20 | Торговая сеть | шт | 2 | 0.2 |  |  | 2
 | Хомут обжимной Ø25 |  |  | Торговая сеть | шт | 2 |  |  |  | 2
 | Блок клапанный | БКН3-11 |  | Прома, Казань | шт | 1 | 1.5 |  |  | 2
 |  |  |  |  |  |  |  |  | 12
sm15 | Труба Ду60х3,2; L=1,5м |  | ГОСТ 8734-75 | Торговая сеть | шт | 1 | 4.48 |  |  | 12
 | Гайка М14 |  | ГОСТ 5915-70 | Торговая сеть | шт | 4 | 0.03 |  |  | 48
 | Болт М14-80 |  | ГОСТ 7798-70 | Торговая сеть | шт | 4 | 0.04 |  |  | 48
 |  |  |  |  |  |  |  |  | 6
sm16 | Труба Ду60х3,2; L=1,5м |  | ГОСТ 8734-75 | Торговая сеть | шт | 1 | 4.48 |  |  | 6
 | Гайка М14 |  | ГОСТ 5915-70 | Торговая сеть | шт | 4 | 0.03 |  |  | 24
 | Болт М14-80 |  | ГОСТ 7798-70 | Торговая сеть | шт | 4 | 0.04 |  |  | 24
sm17 |  |  |  |  |  |  |  |  | 0
 | Штуцер переходной стальной |  | М20х1,5/М15х1,5 | ООО "ГазТест" | шт | 1 | 0.07
 | Ниппельное соединение навертное |  | НСН-14-М20*1,5 ст.20 | Торговая сеть | шт | 2 | 0.2
 | Гайка М20 |  | SN-20М | ООО "ГазТест" | шт | 2 | 0.06
 | Кран шаровый латунный газовый |  | LD Pride 47.15.В-В.Б GAS Ду 20 Ру 40 бабочка | LD, Челябинск | шт | 2 | 0.15
 | Хомут обжимной Ø25 |  |  | Торговая сеть | шт | 2
 | Труба d14х2 |  | ГОСТ 8734-75 |  | м
 | Блок клапанный | БКН3-11 |  | Прома, Казань | шт | 1 | 1.5
sm18 |  |  |  |  |  |  |  |  | 0
 | Резьба стальная Ду20, L=30мм |  | ГОСТ 6357-81, ГОСТ 3262-75 | Торговая сеть | шт | 1 | 0.05
 | Кран шаровый латунный газовый |  | LD Pride 47.15.В-В.Б GAS Ду 20 Ру 40 бабочка | LD, Челябинск | шт | 2 | 0.15
