nppesnteam/370-24_Balakovo_PTVM180_-3-4/SM/370-24_балаково_птвм180n3n4/sm Балаково/spec.xlsx

№ | pos | count | code | maker | mu | count | weight | addinfo
1 | Кран шаровый латунный газовый для дренажа |  | LD Pride 47.15.В-В.Б GAS Ду 15 Ру 40 бабочка | LD, Челябинск | шт | 43 | 0.15
2 | Кран шаровый латунный газовый |  | LD Pride 47.15.В-В.Б GAS Ду 20 Ру 40 бабочка | LD, Челябинск | шт | 4 | 0.16
3 | Вентиль с крестообразной рукояткой |  | ВИГ 25 ДГ-С-1Б1Г | ООО НПП "Гималаи" г.Самара | шт | 119 | 0.18
4 | Блок клапанный |  | БКН3-11 | Прома, Казань | шт | 4 | 1.5
5 | Штуцер переходной стальной |  | М20х1,5/М15х1,5 | ООО "ГазТест" | шт | 65 | 0.07
6 | Гайка М20 |  | SN-20М | ООО "ГазТест" | шт | 65 | 0.07
7 | Ниппельное соединение навертное |  | НСН-14-М20*1,5 ст.20 | Торговая сеть | шт | 199 | 0.2
 | Бобышка |  | БП1/М20х1,5-55-Ст20 | Прома, г.Казань | шт | 8 | 0.2
9 | Гильза |  | Г3.16.1.1.1.160 | Овен, г.Москва | шт | 8 | 0.1
10 | Резьба стальная Ду15, L=30мм |  | ГОСТ 6357-81, ГОСТ 3262-75 | Торговая сеть | шт | 63 | 0.04
11 | Резьба стальная Ду20, L=30мм |  | ГОСТ 6357-81, ГОСТ 3262-75 | Торговая сеть | шт | 24 | 0.05
12 | Труба d14х2 |  | ГОСТ 8734-75 |  | м
13 | Хомут обжимной Ø25 |  |  | Торговая сеть | шт | 84
14 | Труба Ду60х3,2; L=1,5м |  | ГОСТ 8734-75 | Торговая сеть | шт | 18 | 4.48
15 | Гайка М14 |  | ГОСТ 5915-70 | Торговая сеть | шт | 72 | 0.03
16 | Болт М14-80 |  | ГОСТ 7798-70 | Торговая сеть | шт | 72 | 0.04
