nppesnteam/370-24_Balakovo_PTVM180_-3-4/SM/370-24_балаково_птвм180n3n4_241022/sm Балаково/spec.xlsx

№ | pos | count | code | maker | mu | count | weight | addinfo
1 | Кран шаровый латунный газовый для дренажа |  | LD Pride 47.15.В-В.Б GAS Ду 15 Ру 40 бабочка | LD, Челябинск | шт | 43 | 0.15
2 | Кран шаровый латунный газовый |  | LD Pride 47.15.В-В.Б GAS Ду 20 Ру 40 бабочка | LD, Челябинск | шт | 4 | 0.16
3 | Вентиль с крестообразной рукояткой |  | ВИГ 25 ДГ-С-1Б1Г | ООО НПП "Гималаи" г.Самара | шт | 131 | 0.18
4 | Блок клапанный |  | БКН3-11 | Прома, Казань | шт | 4 | 1.5
5 | Штуцер переходной стальной |  | М20х1,5/М15х1,5 | ООО "ГазТест" | шт | 65 | 0.07
6 | Гайка М20 |  | SN-20М | ООО "ГазТест" | шт | 65 | 0.07
7 | Ниппельное соединение навертное |  | НСН-14-М20*1,5 ст.20 | Торговая сеть | шт | 211 | 0.2
8 | Ниппельное соединение с гайкой |  | нгМ20х1,5/гшМ20 | Торговая сеть | шт | 1 | 0.18
9 | Бобышка |  | БП1/М20х1,5-55-Ст20 | Прома, г.Казань | шт | 7 | 0.2
10 | Гильза |  | Г3.16.1.1.1.160 | Овен, г.Москва | шт | 7 | 0.1
11 | Резьба стальная Ду15, L=30мм |  | ГОСТ 6357-81, ГОСТ 3262-75 | Торговая сеть | шт | 63 | 0.04
12 | Резьба стальная Ду20, L=30мм |  | ГОСТ 6357-81, ГОСТ 3262-75 | Торговая сеть | шт | 25 | 0.05
13 | Заглушка Ду20 |  | ГОСТ 17379-2001 | Торговая сеть | шт | 2 | 0.04
14 | Труба d14х2 |  | ГОСТ 8734-75 |  | м
15 | Труба Ду20х2,8 |  | ГОСТ 3262-75 |  | м
 | Хомут обжимной Ø25 |  |  | Торговая сеть | шт | 84
