nppesnteam/370-24_Balakovo_PTVM180_-3-4/Расчет ПЛК_ПАО Т Плюс (КЭС-Холдинг).xlsx

Модернизация оборудования КИПиА водогрейного котла ПТВМ-180 ст.№3 |  |  |  |  |  |  | Скидка | 0%
Наименование | Каталожный номер | Количество | ЗИП | Всего количество | Цена за ед., с НДС | Стоимость, с НДС
Regul R500 |  |  |  | 0
Модуль центрального процессора, 1,33 GHz (2 ядра), 2 Gb RAM, 1x от 16 Gb SSD, RS-232, RS-485, 2 x Ethernet RJ45, 2 x Ethernet SFP, 2 х USB, DVI, поддержка WEB-визуализации | R500 CU 00 072(W)-000-AAA | 2 |  | 2 | 597000.00 | 1194000.00
Модуль аналогового ввода, 0/4…20 мА, 16 каналов, общая гальваническая изоляция, погрешность 0,1% | R500 AI 16 012-000-AAA | 13 | 1 | 14 | 129000.00 | 1806000.00
Модуль дискретного ввода, 24 VDC, 32 канала (4 группы по 8 каналов, общий "минус" или "плюс"), групповая гальваническая изоляция | R500 DI 32 012-000-AAA | 17 | 1 | 18 | 90000.00 | 1620000.00
Модуль дискретного вывода, твердотельные реле, 24 V AC/DC, 0,5 А, 32 канала (4 группы по 8 каналов), групповая гальваническая изоляция | R500 DO 32 012-000-AAA | 12 | 1 | 13 | 129000.00 | 1677000.00
Модуль источника питания 220 VAC/VDC, 75 Вт, с гальваноизоляцией внутренней сети питания от внешней | R500 PP 00 031-000-AAA | 12 | 1 | 13 | 87000.00 | 1131000.00
Шасси с поддержкой резервирования для модулей ввода/вывода и источников питания (две шины данных, две шины питания) | R500 CH 02 012-000-AAA | 54 | 5 | 59 | 22500.00 | 1327500.00
Шасси с поддержкой резервирования для модулей двухслотового центрального процессора I или III типа (две шины данных, две шины питания) | R500 CH 02 023-000-AAA | 2 | 1 | 3 | 51000.00 | 153000.00
Клеммная колодка для модулей ввода/вывода R500, 36 контактов (черн.) | R500 CL 36 001 | 42 | 4 | 46 | 6000.00 | 276000.00
Оконечный модуль с поддержкой функции расширения шины и резервирования (IN), две шины питания, разъем RJ45 | R500 ST 02 013-000-AAA | 6 | 1 | 7 | 72000.00 | 504000.00
Оконечный модуль с поддержкой функции расширения шины и резервирования (OUT), две шины питания, разъем RJ45 | R500 ST 02 023-000-AAA | 6 | 1 | 7 | 69000.00 | 483000.00
DIN-рейка L=600мм | R500 DN 060 | 6 |  | 6 | 2400.00 | 14400.00
 | Общая ширина модулей, мм: | 2620
 | ВхГ модулей ПЛК: 180х155 мм |  |  | 0
 |  |  |  | 1 | Итого: | 10185900.00
1. Стоимость оборудования и доставки
1.1. Стоимость оборудования включает в себя стоимость оборудования, упаковки, маркировки и доставки
1.2. В стоимость оборудования входит метрологическая поверка модулей
1.3. Среда разработки прикладного ПО ПЛК Regul – Astra.IDE поставляется бесплатно и доступна для скачивания на сайте: https://prosoftsystems.ru/catalog/show/astra_ide
2. Порядок расчетов
2.1. Покупатель производит предоплату в размере не менее 50 % стоимости оборудования в течение 10 дней с момента выставления счета.
2.2. Покупатель оплачивает оставшуюся часть стоимости оборудования в течение 10 дней с момента получения уведомления о оготовности оборудования к отгрузке
3. Сроки поставки
3.1. Срок поставки оборудования отсчитывается с момента поступления денежных средств на расчетный счет Поставщика (предоплаты) и составляет 3-4 месяца. Возможна частичная отгрузка по готовности.
