nppesnteam/370-24_Balakovo_PTVM180_-3-4/_back.xlsx

Sheet: 240617
шифр | назначение | наименование | производитель | предел от | предел до | ед.изм | Ду | эн.потр | масса | цена без НДС | дата цены | схема эл. | схема монт. | Am | Tm1 | Tm2 | 0v | 24v | Wcp1 | Wcp2 | XTcp | Tcp1 | Tcp2 | CP | L? | Lt? | Lg? | T1 | T2 | Am | Ai+ | Ai- | TmAi+ | TmAi- | 0v | 24v | Wcp1+ | Wcp1- | XTcp | Tcp1 | Tcp2 | Tcp3 | Tcp4 | CP | L? | Lt? | Lg? | T1 | T2 | T3 | T4 | T1 | T2 | T3 | L? | Lg? | Lt? | CP | XTcp
g3P011 | Датчик давления газа между ПЗК на горелке №1 | АИР-20/М2/-/Н/-/ДИ/130/-/-/М20/11N/ А3/t4070/С2/C05/ 0…100кПа/42/20 КНК Ni/-/ IP66/-/-/-/-/-/-/-/-/ГП/ТУ/ЭП | Элемер | 0 | 100 | кПа |  | 0.7 |  | 59675 | 2024-05-15 | se0001 |  | A11 | 3 | 2 | 0v1 | 24v1 | 24v1 | 1101 | XT1 | 1 | 2 | ШУГ1 |  |  |  | 1 | 2
g3P021 | Датчик давления газа между ПЗК на горелке №2 | АИР-20/М2/-/Н/-/ДИ/130/-/-/М20/11N/ А3/t4070/С2/C05/ 0…100кПа/42/20 КНК Ni/-/ IP66/-/-/-/-/-/-/-/-/ГП/ТУ/ЭП | Элемер | 0 | 100 | кПа |  | 0.7 |  | 59675 | 2024-05-15 | se0001 |  | A21 | 3 | 2 | 0v1 | 24v1 | 24v1 | 2101 | XT1 | 1 | 2 | ШУГ2 |  |  |  | 1 | 2
g3P031 | Датчик давления газа между ПЗК на горелке №3 | АИР-20/М2/-/Н/-/ДИ/130/-/-/М20/11N/ А3/t4070/С2/C05/ 0…100кПа/42/20 КНК Ni/-/ IP66/-/-/-/-/-/-/-/-/ГП/ТУ/ЭП | Элемер | 0 | 100 | кПа |  | 0.7 |  | 59675 | 2024-05-15 | se0001 |  | A11 | 9 | 8 | 0v1 | 24v1 | 24v1 | 1104 | XT1 | 10 | 11 | ШУГ1 |  |  |  | 1 | 2
g3P041 | Датчик давления газа между ПЗК на горелке №4 | АИР-20/М2/-/Н/-/ДИ/130/-/-/М20/11N/ А3/t4070/С2/C05/ 0…100кПа/42/20 КНК Ni/-/ IP66/-/-/-/-/-/-/-/-/ГП/ТУ/ЭП | Элемер | 0 | 100 | кПа |  | 0.7 |  | 59675 | 2024-05-15 | se0001 |  | A21 | 9 | 8 | 0v1 | 24v1 | 24v1 | 2104 | XT1 | 10 | 11 | ШУГ2 |  |  |  | 1 | 2
g3P051 | Датчик давления газа между ПЗК на горелке №5 | АИР-20/М2/-/Н/-/ДИ/130/-/-/М20/11N/ А3/t4070/С2/C05/ 0…100кПа/42/20 КНК Ni/-/ IP66/-/-/-/-/-/-/-/-/ГП/ТУ/ЭП | Элемер | 0 | 100 | кПа |  | 0.7 |  | 59675 | 2024-05-15 | se0001 |  | A11 | 16 | 15 | 0v1 | 24v1 | 24v1 | 1107 | XT1 | 19 | 20 | ШУГ1 |  |  |  | 1 | 2
g3P061 | Датчик давления газа между ПЗК на горелке №6 | АИР-20/М2/-/Н/-/ДИ/130/-/-/М20/11N/ А3/t4070/С2/C05/ 0…100кПа/42/20 КНК Ni/-/ IP66/-/-/-/-/-/-/-/-/ГП/ТУ/ЭП | Элемер | 0 | 100 | кПа |  | 0.7 |  | 59675 | 2024-05-15 | se0001 |  | A21 | 16 | 15 | 0v1 | 24v1 | 24v1 | 2107 | XT1 | 19 | 20 | ШУГ2 |  |  |  | 1 | 2
g3P071 | Датчик давления газа между ПЗК на горелке №7 | АИР-20/М2/-/Н/-/ДИ/130/-/-/М20/11N/ А3/t4070/С2/C05/ 0…100кПа/42/20 КНК Ni/-/ IP66/-/-/-/-/-/-/-/-/ГП/ТУ/ЭП | Элемер | 0 | 100 | кПа |  | 0.7 |  | 59675 | 2024-05-15 | se0001 |  | A11 | 23 | 22 | 0v1 | 24v1 | 24v1 | 1110 | XT1 | 28 | 29 | ШУГ1 |  |  |  | 1 | 2
g3P081 | Датчик давления газа между ПЗК на горелке №8 | АИР-20/М2/-/Н/-/ДИ/130/-/-/М20/11N/ А3/t4070/С2/C05/ 0…100кПа/42/20 КНК Ni/-/ IP66/-/-/-/-/-/-/-/-/ГП/ТУ/ЭП | Элемер | 0 | 100 | кПа |  | 0.7 |  | 59675 | 2024-05-15 | se0001 |  | A21 | 23 | 22 | 0v1 | 24v1 | 24v1 | 2110 | XT1 | 28 | 29 | ШУГ2 |  |  |  | 1 | 2
g3P091 | Датчик давления газа между ПЗК на горелке №9 | АИР-20/М2/-/Н/-/ДИ/130/-/-/М20/11N/ А3/t4070/С2/C05/ 0…100кПа/42/20 КНК Ni/-/ IP66/-/-/-/-/-/-/-/-/ГП/ТУ/ЭП | Элемер | 0 | 100 | кПа |  | 0.7 |  | 59675 | 2024-05-15 | se0001 |  | A31 | 3 | 2 | 0v1 | 24v1 | 24v1 | 3101 | XT1 | 1 | 2 | ШУГ3 |  |  |  | 1 | 2
g3P101 | Датчик давления газа между ПЗК на горелке №10 | АИР-20/М2/-/Н/-/ДИ/130/-/-/М20/11N/ А3/t4070/С2/C05/ 0…100кПа/42/20 КНК Ni/-/ IP66/-/-/-/-/-/-/-/-/ГП/ТУ/ЭП | Элемер | 0 | 100 | кПа |  | 0.7 |  | 59675 | 2024-05-15 | se0001 |  | A31 | 9 | 8 | 0v1 | 24v1 | 24v1 | 3104 | XT1 | 10 | 11 | ШУГ3 |  |  |  | 1 | 2
g3P111 | Датчик давления газа между ПЗК на горелке №11 | АИР-20/М2/-/Н/-/ДИ/130/-/-/М20/11N/ А3/t4070/С2/C05/ 0…100кПа/42/20 КНК Ni/-/ IP66/-/-/-/-/-/-/-/-/ГП/ТУ/ЭП | Элемер | 0 | 100 | кПа |  | 0.7 |  | 59675 | 2024-05-15 | se0001 |  | A31 | 16 | 15 | 0v1 | 24v1 | 24v1 | 3107 | XT1 | 19 | 20 | ШУГ3 |  |  |  | 1 | 2
g3P121 | Датчик давления газа между ПЗК на горелке №12 | АИР-20/М2/-/Н/-/ДИ/130/-/-/М20/11N/ А3/t4070/С2/C05/ 0…100кПа/42/20 КНК Ni/-/ IP66/-/-/-/-/-/-/-/-/ГП/ТУ/ЭП | Элемер | 0 | 100 | кПа |  | 0.7 |  | 59675 | 2024-05-15 | se0001 |  | A31 | 23 | 22 | 0v1 | 24v1 | 24v1 | 3110 | XT1 | 28 | 29 | ШУГ3 |  |  |  | 1 | 2
g3P131 | Датчик давления газа между ПЗК на горелке №13 | АИР-20/М2/-/Н/-/ДИ/130/-/-/М20/11N/ А3/t4070/С2/C05/ 0…100кПа/42/20 КНК Ni/-/ IP66/-/-/-/-/-/-/-/-/ГП/ТУ/ЭП | Элемер | 0 | 100 | кПа |  | 0.7 |  | 59675 | 2024-05-15 | se0001 |  | A41 | 3 | 2 | 0v1 | 24v1 | 24v1 | 4101 | XT1 | 1 | 2 | ШУГ4 |  |  |  | 1 | 2
g3P141 | Датчик давления газа между ПЗК на горелке №14 | АИР-20/М2/-/Н/-/ДИ/130/-/-/М20/11N/ А3/t4070/С2/C05/ 0…100кПа/42/20 КНК Ni/-/ IP66/-/-/-/-/-/-/-/-/ГП/ТУ/ЭП | Элемер | 0 | 100 | кПа |  | 0.7 |  | 59675 | 2024-05-15 | se0001 |  | A51 | 3 | 2 | 0v1 | 24v1 | 24v1 | 5101 | XT1 | 1 | 2 | ШУГ5 |  |  |  | 1 | 2
g3P151 | Датчик давления газа между ПЗК на горелке №15 | АИР-20/М2/-/Н/-/ДИ/130/-/-/М20/11N/ А3/t4070/С2/C05/ 0…100кПа/42/20 КНК Ni/-/ IP66/-/-/-/-/-/-/-/-/ГП/ТУ/ЭП | Элемер | 0 | 100 | кПа |  | 0.7 |  | 59675 | 2024-05-15 | se0001 |  | A41 | 9 | 8 | 0v1 | 24v1 | 24v1 | 4104 | XT1 | 10 | 11 | ШУГ4 |  |  |  | 1 | 2
g3P161 | Датчик давления газа между ПЗК на горелке №16 | АИР-20/М2/-/Н/-/ДИ/130/-/-/М20/11N/ А3/t4070/С2/C05/ 0…100кПа/42/20 КНК Ni/-/ IP66/-/-/-/-/-/-/-/-/ГП/ТУ/ЭП | Элемер | 0 | 100 | кПа |  | 0.7 |  | 59675 | 2024-05-15 | se0001 |  | A51 | 9 | 8 | 0v1 | 24v1 | 24v1 | 5104 | XT1 | 10 | 11 | ШУГ5 |  |  |  | 1 | 2
g3P171 | Датчик давления газа между ПЗК на горелке №17 | АИР-20/М2/-/Н/-/ДИ/130/-/-/М20/11N/ А3/t4070/С2/C05/ 0…100кПа/42/20 КНК Ni/-/ IP66/-/-/-/-/-/-/-/-/ГП/ТУ/ЭП | Элемер | 0 | 100 | кПа |  | 0.7 |  | 59675 | 2024-05-15 | se0001 |  | A41 | 16 | 15 | 0v1 | 24v1 | 24v1 | 4107 | XT1 | 19 | 20 | ШУГ4 |  |  |  | 1 | 2
g3P181 | Датчик давления газа между ПЗК на горелке №18 | АИР-20/М2/-/Н/-/ДИ/130/-/-/М20/11N/ А3/t4070/С2/C05/ 0…100кПа/42/20 КНК Ni/-/ IP66/-/-/-/-/-/-/-/-/ГП/ТУ/ЭП | Элемер | 0 | 100 | кПа |  | 0.7 |  | 59675 | 2024-05-15 | se0001 |  | A51 | 16 | 15 | 0v1 | 24v1 | 24v1 | 5107 | XT1 | 19 | 20 | ШУГ5 |  |  |  | 1 | 2
g3P191 | Датчик давления газа между ПЗК на горелке №19 | АИР-20/М2/-/Н/-/ДИ/130/-/-/М20/11N/ А3/t4070/С2/C05/ 0…100кПа/42/20 КНК Ni/-/ IP66/-/-/-/-/-/-/-/-/ГП/ТУ/ЭП | Элемер | 0 | 100 | кПа |  | 0.7 |  | 59675 | 2024-05-15 | se0001 |  | A41 | 23 | 22 | 0v1 | 24v1 | 24v1 | 4110 | XT1 | 28 | 29 | ШУГ4 |  |  |  | 1 | 2
g3P201 | Датчик давления газа между ПЗК на горелке №20 | АИР-20/М2/-/Н/-/ДИ/130/-/-/М20/11N/ А3/t4070/С2/C05/ 0…100кПа/42/20 КНК Ni/-/ IP66/-/-/-/-/-/-/-/-/ГП/ТУ/ЭП | Элемер | 0 | 100 | кПа |  | 0.7 |  | 59675 | 2024-05-15 | se0001 |  | A51 | 23 | 22 | 0v1 | 24v1 | 24v1 | 5110 | XT1 | 28 | 29 | ШУГ5 |  |  |  | 1 | 2
g3Pi011 | Манометр давления газа между ПЗК на горелке №1 | ТМ-510Р.00(0-0,1МПа)М20х1,5.1,5 | Росма | 0 | 100 | кПа |  |  |  | 955 | 2024-05-15 | не электр.
g3Pi021 | Манометр давления газа между ПЗК на горелке №2 | ТМ-510Р.00(0-0,1МПа)М20х1,5.1,5 | Росма | 0 | 100 | кПа |  |  |  | 955 | 2024-05-15 | не электр.
g3Pi031 | Манометр давления газа между ПЗК на горелке №3 | ТМ-510Р.00(0-0,1МПа)М20х1,5.1,5 | Росма | 0 | 100 | кПа |  |  |  | 955 | 2024-05-15 | не электр.
g3Pi041 | Манометр давления газа между ПЗК на горелке №4 | ТМ-510Р.00(0-0,1МПа)М20х1,5.1,5 | Росма | 0 | 100 | кПа |  |  |  | 955 | 2024-05-15 | не электр.
g3Pi051 | Манометр давления газа между ПЗК на горелке №5 | ТМ-510Р.00(0-0,1МПа)М20х1,5.1,5 | Росма | 0 | 100 | кПа |  |  |  | 955 | 2024-05-15 | не электр.
g3Pi061 | Манометр давления газа между ПЗК на горелке №6 | ТМ-510Р.00(0-0,1МПа)М20х1,5.1,5 | Росма | 0 | 100 | кПа |  |  |  | 955 | 2024-05-15 | не электр.
g3Pi071 | Манометр давления газа между ПЗК на горелке №7 | ТМ-510Р.00(0-0,1МПа)М20х1,5.1,5 | Росма | 0 | 100 | кПа |  |  |  | 955 | 2024-05-15 | не электр.
g3Pi081 | Манометр давления газа между ПЗК на горелке №8 | ТМ-510Р.00(0-0,1МПа)М20х1,5.1,5 | Росма | 0 | 100 | кПа |  |  |  | 955 | 2024-05-15 | не электр.
g3Pi091 | Манометр давления газа между ПЗК на горелке №9 | ТМ-510Р.00(0-0,1МПа)М20х1,5.1,5 | Росма | 0 | 100 | кПа |  |  |  | 955 | 2024-05-15 | не электр.
g3Pi101 | Манометр давления газа между ПЗК на горелке №10 | ТМ-510Р.00(0-0,1МПа)М20х1,5.1,5 | Росма | 0 | 100 | кПа |  |  |  | 955 | 2024-05-15 | не электр.
g3Pi111 | Манометр давления газа между ПЗК на горелке №11 | ТМ-510Р.00(0-0,1МПа)М20х1,5.1,5 | Росма | 0 | 100 | кПа |  |  |  | 955 | 2024-05-15 | не электр.
g3Pi121 | Манометр давления газа между ПЗК на горелке №12 | ТМ-510Р.00(0-0,1МПа)М20х1,5.1,5 | Росма | 0 | 100 | кПа |  |  |  | 955 | 2024-05-15 | не электр.
g3Pi131 | Манометр давления газа между ПЗК на горелке №13 | ТМ-510Р.00(0-0,1МПа)М20х1,5.1,5 | Росма | 0 | 100 | кПа |  |  |  | 955 | 2024-05-15 | не электр.
g3Pi141 | Манометр давления газа между ПЗК на горелке №14 | ТМ-510Р.00(0-0,1МПа)М20х1,5.1,5 | Росма | 0 | 100 | кПа |  |  |  | 955 | 2024-05-15 | не электр.
g3Pi151 | Манометр давления газа между ПЗК на горелке №15 | ТМ-510Р.00(0-0,1МПа)М20х1,5.1,5 | Росма | 0 | 100 | кПа |  |  |  | 955 | 2024-05-15 | не электр.
g3Pi161 | Манометр давления газа между ПЗК на горелке №16 | ТМ-510Р.00(0-0,1МПа)М20х1,5.1,5 | Росма | 0 | 100 | кПа |  |  |  | 955 | 2024-05-15 | не электр.
g3Pi171 | Манометр давления газа между ПЗК на горелке №17 | ТМ-510Р.00(0-0,1МПа)М20х1,5.1,5 | Росма | 0 | 100 | кПа |  |  |  | 955 | 2024-05-15 | не электр.
g3Pi181 | Манометр давления газа между ПЗК на горелке №18 | ТМ-510Р.00(0-0,1МПа)М20х1,5.1,5 | Росма | 0 | 100 | кПа |  |  |  | 955 | 2024-05-15 | не электр.
g3Pi191 | Манометр давления газа между ПЗК на горелке №19 | ТМ-510Р.00(0-0,1МПа)М20х1,5.1,5 | Росма | 0 | 100 | кПа |  |  |  | 955 | 2024-05-15 | не электр.
g3Pi201 | Манометр давления газа между ПЗК на горелке №20 | ТМ-510Р.00(0-0,1МПа)М20х1,5.1,5 | Росма | 0 | 100 | кПа |  |  |  | 955 | 2024-05-15 | не электр.
g3P012 | Датчик давления газа перед горелкой №1 | АИР-20/М2/-/Н/-/ДИ/130/-/-/М20/11N/ А3/t4070/ С2/C05/ 0…40кПа/-/42/20 КНК Ni/-/ IP66/-/-/-/-/-/-/-/-/ГП/ТУ/ЭП | Элемер | 0 | 40 | кПа |  | 0.7 |  | 59675 | 2024-05-15 | se0001 |  | A11 | 5 | 4 | 0v1 | 24v1 | 24v1 | 1102 | XT1 | 4 | 5 | ШУГ1 |  |  |  | 1 | 2
g3P022 | Датчик давления газа перед горелкой №2 | АИР-20/М2/-/Н/-/ДИ/130/-/-/М20/11N/ А3/t4070/ С2/C05/ 0…40кПа/-/42/20 КНК Ni/-/ IP66/-/-/-/-/-/-/-/-/ГП/ТУ/ЭП | Элемер | 0 | 40 | кПа |  | 0.7 |  | 59675 | 2024-05-15 | se0001 |  | A21 | 5 | 4 | 0v1 | 24v1 | 24v1 | 2102 | XT1 | 4 | 5 | ШУГ2 |  |  |  | 1 | 2
g3P032 | Датчик давления газа перед горелкой №3 | АИР-20/М2/-/Н/-/ДИ/130/-/-/М20/11N/ А3/t4070/ С2/C05/ 0…40кПа/-/42/20 КНК Ni/-/ IP66/-/-/-/-/-/-/-/-/ГП/ТУ/ЭП | Элемер | 0 | 40 | кПа |  | 0.7 |  | 59675 | 2024-05-15 | se0001 |  | A11 | 12 | 11 | 0v1 | 24v1 | 24v1 | 1105 | XT1 | 13 | 14 | ШУГ1 |  |  |  | 1 | 2
g3P042 | Датчик давления газа перед горелкой №4 | АИР-20/М2/-/Н/-/ДИ/130/-/-/М20/11N/ А3/t4070/ С2/C05/ 0…40кПа/-/42/20 КНК Ni/-/ IP66/-/-/-/-/-/-/-/-/ГП/ТУ/ЭП | Элемер | 0 | 40 | кПа |  | 0.7 |  | 59675 | 2024-05-15 | se0001 |  | A21 | 12 | 11 | 0v1 | 24v1 | 24v1 | 2105 | XT1 | 13 | 14 | ШУГ2 |  |  |  | 1 | 2
g3P052 | Датчик давления газа перед горелкой №5 | АИР-20/М2/-/Н/-/ДИ/130/-/-/М20/11N/ А3/t4070/ С2/C05/ 0…40кПа/-/42/20 КНК Ni/-/ IP66/-/-/-/-/-/-/-/-/ГП/ТУ/ЭП | Элемер | 0 | 40 | кПа |  | 0.7 |  | 59675 | 2024-05-15 | se0001 |  | A11 | 18 | 17 | 0v1 | 24v1 | 24v1 | 1108 | XT1 | 22 | 23 | ШУГ1 |  |  |  | 1 | 2
g3P062 | Датчик давления газа перед горелкой №6 | АИР-20/М2/-/Н/-/ДИ/130/-/-/М20/11N/ А3/t4070/ С2/C05/ 0…40кПа/-/42/20 КНК Ni/-/ IP66/-/-/-/-/-/-/-/-/ГП/ТУ/ЭП | Элемер | 0 | 40 | кПа |  | 0.7 |  | 59675 | 2024-05-15 | se0001 |  | A21 | 18 | 17 | 0v1 | 24v1 | 24v1 | 2108 | XT1 | 22 | 23 | ШУГ2 |  |  |  | 1 | 2
g3P072 | Датчик давления газа перед горелкой №7 | АИР-20/М2/-/Н/-/ДИ/130/-/-/М20/11N/ А3/t4070/ С2/C05/ 0…40кПа/-/42/20 КНК Ni/-/ IP66/-/-/-/-/-/-/-/-/ГП/ТУ/ЭП | Элемер | 0 | 40 | кПа |  | 0.7 |  | 59675 | 2024-05-15 | se0001 |  | A11 | 25 | 24 | 0v1 | 24v1 | 24v1 | 1111 | XT1 | 31 | 32 | ШУГ1 |  |  |  | 1 | 2
g3P082 | Датчик давления газа перед горелкой №8 | АИР-20/М2/-/Н/-/ДИ/130/-/-/М20/11N/ А3/t4070/ С2/C05/ 0…40кПа/-/42/20 КНК Ni/-/ IP66/-/-/-/-/-/-/-/-/ГП/ТУ/ЭП | Элемер | 0 | 40 | кПа |  | 0.7 |  | 59675 | 2024-05-15 | se0001 |  | A21 | 25 | 24 | 0v1 | 24v1 | 24v1 | 2111 | XT1 | 31 | 32 | ШУГ2 |  |  |  | 1 | 2
g3P092 | Датчик давления газа перед горелкой №9 | АИР-20/М2/-/Н/-/ДИ/130/-/-/М20/11N/ А3/t4070/ С2/C05/ 0…40кПа/-/42/20 КНК Ni/-/ IP66/-/-/-/-/-/-/-/-/ГП/ТУ/ЭП | Элемер | 0 | 40 | кПа |  | 0.7 |  | 59675 | 2024-05-15 | se0001 |  | A31 | 5 | 4 | 0v1 | 24v1 | 24v1 | 3102 | XT1 | 4 | 5 | ШУГ3 |  |  |  | 1 | 2
g3P102 | Датчик давления газа перед горелкой №10 | АИР-20/М2/-/Н/-/ДИ/130/-/-/М20/11N/ А3/t4070/ С2/C05/ 0…40кПа/-/42/20 КНК Ni/-/ IP66/-/-/-/-/-/-/-/-/ГП/ТУ/ЭП | Элемер | 0 | 40 | кПа |  | 0.7 |  | 59675 | 2024-05-15 | se0001 |  | A31 | 12 | 11 | 0v1 | 24v1 | 24v1 | 3105 | XT1 | 13 | 14 | ШУГ3 |  |  |  | 1 | 2
g3P112 | Датчик давления газа перед горелкой №11 | АИР-20/М2/-/Н/-/ДИ/130/-/-/М20/11N/ А3/t4070/ С2/C05/ 0…40кПа/-/42/20 КНК Ni/-/ IP66/-/-/-/-/-/-/-/-/ГП/ТУ/ЭП | Элемер | 0 | 40 | кПа |  | 0.7 |  | 59675 | 2024-05-15 | se0001 |  | A31 | 18 | 17 | 0v1 | 24v1 | 24v1 | 3108 | XT1 | 22 | 23 | ШУГ3 |  |  |  | 1 | 2
g3P122 | Датчик давления газа перед горелкой №12 | АИР-20/М2/-/Н/-/ДИ/130/-/-/М20/11N/ А3/t4070/ С2/C05/ 0…40кПа/-/42/20 КНК Ni/-/ IP66/-/-/-/-/-/-/-/-/ГП/ТУ/ЭП | Элемер | 0 | 40 | кПа |  | 0.7 |  | 59675 | 2024-05-15 | se0001 |  | A31 | 25 | 24 | 0v1 | 24v1 | 24v1 | 3111 | XT1 | 31 | 32 | ШУГ3 |  |  |  | 1 | 2
g3P132 | Датчик давления газа перед горелкой №13 | АИР-20/М2/-/Н/-/ДИ/130/-/-/М20/11N/ А3/t4070/ С2/C05/ 0…40кПа/-/42/20 КНК Ni/-/ IP66/-/-/-/-/-/-/-/-/ГП/ТУ/ЭП | Элемер | 0 | 40 | кПа |  | 0.7 |  | 59675 | 2024-05-15 | se0001 |  | A41 | 5 | 4 | 0v1 | 24v1 | 24v1 | 4102 | XT1 | 4 | 5 | ШУГ4 |  |  |  | 1 | 2
g3P142 | Датчик давления газа перед горелкой №14 | АИР-20/М2/-/Н/-/ДИ/130/-/-/М20/11N/ А3/t4070/ С2/C05/ 0…40кПа/-/42/20 КНК Ni/-/ IP66/-/-/-/-/-/-/-/-/ГП/ТУ/ЭП | Элемер | 0 | 40 | кПа |  | 0.7 |  | 59675 | 2024-05-15 | se0001 |  | A51 | 5 | 4 | 0v1 | 24v1 | 24v1 | 5102 | XT1 | 4 | 5 | ШУГ5 |  |  |  | 1 | 2
g3P152 | Датчик давления газа перед горелкой №15 | АИР-20/М2/-/Н/-/ДИ/130/-/-/М20/11N/ А3/t4070/ С2/C05/ 0…40кПа/-/42/20 КНК Ni/-/ IP66/-/-/-/-/-/-/-/-/ГП/ТУ/ЭП | Элемер | 0 | 40 | кПа |  | 0.7 |  | 59675 | 2024-05-15 | se0001 |  | A41 | 12 | 11 | 0v1 | 24v1 | 24v1 | 4105 | XT1 | 13 | 14 | ШУГ4 |  |  |  | 1 | 2
g3P162 | Датчик давления газа перед горелкой №16 | АИР-20/М2/-/Н/-/ДИ/130/-/-/М20/11N/ А3/t4070/ С2/C05/ 0…40кПа/-/42/20 КНК Ni/-/ IP66/-/-/-/-/-/-/-/-/ГП/ТУ/ЭП | Элемер | 0 | 40 | кПа |  | 0.7 |  | 59675 | 2024-05-15 | se0001 |  | A51 | 12 | 11 | 0v1 | 24v1 | 24v1 | 5105 | XT1 | 13 | 14 | ШУГ5 |  |  |  | 1 | 2
g3P172 | Датчик давления газа перед горелкой №17 | АИР-20/М2/-/Н/-/ДИ/130/-/-/М20/11N/ А3/t4070/ С2/C05/ 0…40кПа/-/42/20 КНК Ni/-/ IP66/-/-/-/-/-/-/-/-/ГП/ТУ/ЭП | Элемер | 0 | 40 | кПа |  | 0.7 |  | 59675 | 2024-05-15 | se0001 |  | A41 | 18 | 17 | 0v1 | 24v1 | 24v1 | 4108 | XT1 | 22 | 23 | ШУГ4 |  |  |  | 1 | 2
g3P182 | Датчик давления газа перед горелкой №18 | АИР-20/М2/-/Н/-/ДИ/130/-/-/М20/11N/ А3/t4070/ С2/C05/ 0…40кПа/-/42/20 КНК Ni/-/ IP66/-/-/-/-/-/-/-/-/ГП/ТУ/ЭП | Элемер | 0 | 40 | кПа |  | 0.7 |  | 59675 | 2024-05-15 | se0001 |  | A51 | 18 | 17 | 0v1 | 24v1 | 24v1 | 5108 | XT1 | 22 | 23 | ШУГ5 |  |  |  | 1 | 2
g3P192 | Датчик давления газа перед горелкой №19 | АИР-20/М2/-/Н/-/ДИ/130/-/-/М20/11N/ А3/t4070/ С2/C05/ 0…40кПа/-/42/20 КНК Ni/-/ IP66/-/-/-/-/-/-/-/-/ГП/ТУ/ЭП | Элемер | 0 | 40 | кПа |  | 0.7 |  | 59675 | 2024-05-15 | se0001 |  | A41 | 25 | 24 | 0v1 | 24v1 | 24v1 | 4111 | XT1 | 31 | 32 | ШУГ4 |  |  |  | 1 | 2
g3P202 | Датчик давления газа перед горелкой №20 | АИР-20/М2/-/Н/-/ДИ/130/-/-/М20/11N/ А3/t4070/ С2/C05/ 0…40кПа/-/42/20 КНК Ni/-/ IP66/-/-/-/-/-/-/-/-/ГП/ТУ/ЭП | Элемер | 0 | 40 | кПа |  | 0.7 |  | 59675 | 2024-05-15 | se0001 |  | A51 | 25 | 24 | 0v1 | 24v1 | 24v1 | 5111 | XT1 | 31 | 32 | ШУГ5 |  |  |  | 1 | 2
g3Pi012 | Манометр давления газа перед горелкой №1 | КМ22Р(0-40кПа)М20х1,5.1,5 | Росма | 0 | 40 | кПа |  |  |  | 4070 | 2024-05-15 | не электр.
g3Pi022 | Манометр давления газа перед горелкой №2 | КМ22Р(0-40кПа)М20х1,5.1,5 | Росма | 0 | 40 | кПа |  |  |  | 4070 | 2024-05-15 | не электр.
g3Pi032 | Манометр давления газа перед горелкой №3 | КМ22Р(0-40кПа)М20х1,5.1,5 | Росма | 0 | 40 | кПа |  |  |  | 4070 | 2024-05-15 | не электр.
g3Pi042 | Манометр давления газа перед горелкой №4 | КМ22Р(0-40кПа)М20х1,5.1,5 | Росма | 0 | 40 | кПа |  |  |  | 4070 | 2024-05-15 | не электр.
g3Pi052 | Манометр давления газа перед горелкой №5 | КМ22Р(0-40кПа)М20х1,5.1,5 | Росма | 0 | 40 | кПа |  |  |  | 4070 | 2024-05-15 | не электр.
g3Pi062 | Манометр давления газа перед горелкой №6 | КМ22Р(0-40кПа)М20х1,5.1,5 | Росма | 0 | 40 | кПа |  |  |  | 4070 | 2024-05-15 | не электр.
g3Pi072 | Манометр давления газа перед горелкой №7 | КМ22Р(0-40кПа)М20х1,5.1,5 | Росма | 0 | 40 | кПа |  |  |  | 4070 | 2024-05-15 | не электр.
g3Pi082 | Манометр давления газа перед горелкой №8 | КМ22Р(0-40кПа)М20х1,5.1,5 | Росма | 0 | 40 | кПа |  |  |  | 4070 | 2024-05-15 | не электр.
g3Pi092 | Манометр давления газа перед горелкой №9 | КМ22Р(0-40кПа)М20х1,5.1,5 | Росма | 0 | 40 | кПа |  |  |  | 4070 | 2024-05-15 | не электр.
g3Pi102 | Манометр давления газа перед горелкой №10 | КМ22Р(0-40кПа)М20х1,5.1,5 | Росма | 0 | 40 | кПа |  |  |  | 4070 | 2024-05-15 | не электр.
g3Pi112 | Манометр давления газа перед горелкой №11 | КМ22Р(0-40кПа)М20х1,5.1,5 | Росма | 0 | 40 | кПа |  |  |  | 4070 | 2024-05-15 | не электр.
g3Pi122 | Манометр давления газа перед горелкой №12 | КМ22Р(0-40кПа)М20х1,5.1,5 | Росма | 0 | 40 | кПа |  |  |  | 4070 | 2024-05-15 | не электр.
g3Pi132 | Манометр давления газа перед горелкой №13 | КМ22Р(0-40кПа)М20х1,5.1,5 | Росма | 0 | 40 | кПа |  |  |  | 4070 | 2024-05-15 | не электр.
g3Pi142 | Манометр давления газа перед горелкой №14 | КМ22Р(0-40кПа)М20х1,5.1,5 | Росма | 0 | 40 | кПа |  |  |  | 4070 | 2024-05-15 | не электр.
g3Pi152 | Манометр давления газа перед горелкой №15 | КМ22Р(0-40кПа)М20х1,5.1,5 | Росма | 0 | 40 | кПа |  |  |  | 4070 | 2024-05-15 | не электр.
g3Pi162 | Манометр давления газа перед горелкой №16 | КМ22Р(0-40кПа)М20х1,5.1,5 | Росма | 0 | 40 | кПа |  |  |  | 4070 | 2024-05-15 | не электр.
g3Pi172 | Манометр давления газа перед горелкой №17 | КМ22Р(0-40кПа)М20х1,5.1,5 | Росма | 0 | 40 | кПа |  |  |  | 4070 | 2024-05-15 | не электр.
g3Pi182 | Манометр давления газа перед горелкой №18 | КМ22Р(0-40кПа)М20х1,5.1,5 | Росма | 0 | 40 | кПа |  |  |  | 4070 | 2024-05-15 | не электр.
g3Pi192 | Манометр давления газа перед горелкой №19 | КМ22Р(0-40кПа)М20х1,5.1,5 | Росма | 0 | 40 | кПа |  |  |  | 4070 | 2024-05-15 | не электр.
g3Pi202 | Манометр давления газа перед горелкой №20 | КМ22Р(0-40кПа)М20х1,5.1,5 | Росма | 0 | 40 | кПа |  |  |  | 4070 | 2024-05-15 | не электр.
а3P011 | Датчик давления воздуха перед горелкой №1 | АИР-20/М2/-/Н/-/ДИ/110/-/-/М20/11N/ А3/t4070/С2/C05/ 0…2,5кПа/-/42/20 КНК Ni/-/ IP66/-/-/-/-/-/-/-/-/ГП/ТУ/- | Элемер | 0 | 2.5 | кПа |  | 0.7 |  | 71765 | 2024-05-15 | se0001 |  | A11 | 7 | 6 | 0v1 | 24v1 | 24v1 | 1103 | XT1 | 7 | 8 | ШУГ1 |  |  |  | 1 | 2
а3P021 | Датчик давления воздуха перед горелкой №2 | АИР-20/М2/-/Н/-/ДИ/110/-/-/М20/11N/ А3/t4070/С2/C05/ 0…2,5кПа/-/42/20 КНК Ni/-/ IP66/-/-/-/-/-/-/-/-/ГП/ТУ/- | Элемер | 0 | 2.5 | кПа |  | 0.7 |  | 71765 | 2024-05-15 | se0001 |  | A21 | 7 | 6 | 0v1 | 24v1 | 24v1 | 2103 | XT1 | 7 | 8 | ШУГ2 |  |  |  | 1 | 2
а3P031 | Датчик давления воздуха перед горелкой №3 | АИР-20/М2/-/Н/-/ДИ/110/-/-/М20/11N/ А3/t4070/С2/C05/ 0…2,5кПа/-/42/20 КНК Ni/-/ IP66/-/-/-/-/-/-/-/-/ГП/ТУ/- | Элемер | 0 | 2.5 | кПа |  | 0.7 |  | 71765 | 2024-05-15 | se0001 |  | A11 | 14 | 13 | 0v1 | 24v1 | 24v1 | 1106 | XT1 | 16 | 17 | ШУГ1 |  |  |  | 1 | 2
а3P041 | Датчик давления воздуха перед горелкой №4 | АИР-20/М2/-/Н/-/ДИ/110/-/-/М20/11N/ А3/t4070/С2/C05/ 0…2,5кПа/-/42/20 КНК Ni/-/ IP66/-/-/-/-/-/-/-/-/ГП/ТУ/- | Элемер | 0 | 2.5 | кПа |  | 0.7 |  | 71765 | 2024-05-15 | se0001 |  | A21 | 14 | 13 | 0v1 | 24v1 | 24v1 | 2106 | XT1 | 16 | 17 | ШУГ2 |  |  |  | 1 | 2
а3P051 | Датчик давления воздуха перед горелкой №5 | АИР-20/М2/-/Н/-/ДИ/110/-/-/М20/11N/ А3/t4070/С2/C05/ 0…2,5кПа/-/42/20 КНК Ni/-/ IP66/-/-/-/-/-/-/-/-/ГП/ТУ/- | Элемер | 0 | 2.5 | кПа |  | 0.7 |  | 71765 | 2024-05-15 | se0001 |  | A11 | 21 | 20 | 0v1 | 24v1 | 24v1 | 1109 | XT1 | 25 | 26 | ШУГ1 |  |  |  | 1 | 2
а3P061 | Датчик давления воздуха перед горелкой №6 | АИР-20/М2/-/Н/-/ДИ/110/-/-/М20/11N/ А3/t4070/С2/C05/ 0…2,5кПа/-/42/20 КНК Ni/-/ IP66/-/-/-/-/-/-/-/-/ГП/ТУ/- | Элемер | 0 | 2.5 | кПа |  | 0.7 |  | 71765 | 2024-05-15 | se0001 |  | A21 | 21 | 20 | 0v1 | 24v1 | 24v1 | 2109 | XT1 | 25 | 26 | ШУГ2 |  |  |  | 1 | 2
а3P071 | Датчик давления воздуха перед горелкой №7 | АИР-20/М2/-/Н/-/ДИ/110/-/-/М20/11N/ А3/t4070/С2/C05/ 0…2,5кПа/-/42/20 КНК Ni/-/ IP66/-/-/-/-/-/-/-/-/ГП/ТУ/- | Элемер | 0 | 2.5 | кПа |  | 0.7 |  | 71765 | 2024-05-15 | se0001 |  | A11 | 27 | 26 | 0v1 | 24v1 | 24v1 | 1112 | XT1 | 34 | 35 | ШУГ1 |  |  |  | 1 | 2
а3P081 | Датчик давления воздуха перед горелкой №8 | АИР-20/М2/-/Н/-/ДИ/110/-/-/М20/11N/ А3/t4070/С2/C05/ 0…2,5кПа/-/42/20 КНК Ni/-/ IP66/-/-/-/-/-/-/-/-/ГП/ТУ/- | Элемер | 0 | 2.5 | кПа |  | 0.7 |  | 71765 | 2024-05-15 | se0001 |  | A21 | 27 | 26 | 0v1 | 24v1 | 24v1 | 2112 | XT1 | 34 | 35 | ШУГ2 |  |  |  | 1 | 2
а3P091 | Датчик давления воздуха перед горелкой №9 | АИР-20/М2/-/Н/-/ДИ/110/-/-/М20/11N/ А3/t4070/С2/C05/ 0…2,5кПа/-/42/20 КНК Ni/-/ IP66/-/-/-/-/-/-/-/-/ГП/ТУ/- | Элемер | 0 | 2.5 | кПа |  | 0.7 |  | 71765 | 2024-05-15 | se0001 |  | A31 | 7 | 6 | 0v1 | 24v1 | 24v1 | 3103 | XT1 | 7 | 8 | ШУГ3 |  |  |  | 1 | 2
а3P101 | Датчик давления воздуха перед горелкой №10 | АИР-20/М2/-/Н/-/ДИ/110/-/-/М20/11N/ А3/t4070/С2/C05/ 0…2,5кПа/-/42/20 КНК Ni/-/ IP66/-/-/-/-/-/-/-/-/ГП/ТУ/- | Элемер | 0 | 2.5 | кПа |  | 0.7 |  | 71765 | 2024-05-15 | se0001 |  | A31 | 14 | 13 | 0v1 | 24v1 | 24v1 | 3106 | XT1 | 16 | 17 | ШУГ3 |  |  |  | 1 | 2
а3P111 | Датчик давления воздуха перед горелкой №11 | АИР-20/М2/-/Н/-/ДИ/110/-/-/М20/11N/ А3/t4070/С2/C05/ 0…2,5кПа/-/42/20 КНК Ni/-/ IP66/-/-/-/-/-/-/-/-/ГП/ТУ/- | Элемер | 0 | 2.5 | кПа |  | 0.7 |  | 71765 | 2024-05-15 | se0001 |  | A31 | 21 | 20 | 0v1 | 24v1 | 24v1 | 3109 | XT1 | 25 | 26 | ШУГ3 |  |  |  | 1 | 2
а3P121 | Датчик давления воздуха перед горелкой №12 | АИР-20/М2/-/Н/-/ДИ/110/-/-/М20/11N/ А3/t4070/С2/C05/ 0…2,5кПа/-/42/20 КНК Ni/-/ IP66/-/-/-/-/-/-/-/-/ГП/ТУ/- | Элемер | 0 | 2.5 | кПа |  | 0.7 |  | 71765 | 2024-05-15 | se0001 |  | A31 | 27 | 26 | 0v1 | 24v1 | 24v1 | 3112 | XT1 | 34 | 35 | ШУГ3 |  |  |  | 1 | 2
а3P131 | Датчик давления воздуха перед горелкой №13 | АИР-20/М2/-/Н/-/ДИ/110/-/-/М20/11N/ А3/t4070/С2/C05/ 0…2,5кПа/-/42/20 КНК Ni/-/ IP66/-/-/-/-/-/-/-/-/ГП/ТУ/- | Элемер | 0 | 2.5 | кПа |  | 0.7 |  | 71765 | 2024-05-15 | se0001 |  | A41 | 7 | 6 | 0v1 | 24v1 | 24v1 | 4103 | XT1 | 7 | 8 | ШУГ4 |  |  |  | 1 | 2
а3P141 | Датчик давления воздуха перед горелкой №14 | АИР-20/М2/-/Н/-/ДИ/110/-/-/М20/11N/ А3/t4070/С2/C05/ 0…2,5кПа/-/42/20 КНК Ni/-/ IP66/-/-/-/-/-/-/-/-/ГП/ТУ/- | Элемер | 0 | 2.5 | кПа |  | 0.7 |  | 71765 | 2024-05-15 | se0001 |  | A51 | 7 | 6 | 0v1 | 24v1 | 24v1 | 5103 | XT1 | 7 | 8 | ШУГ5 |  |  |  | 1 | 2
а3P151 | Датчик давления воздуха перед горелкой №15 | АИР-20/М2/-/Н/-/ДИ/110/-/-/М20/11N/ А3/t4070/С2/C05/ 0…2,5кПа/-/42/20 КНК Ni/-/ IP66/-/-/-/-/-/-/-/-/ГП/ТУ/- | Элемер | 0 | 2.5 | кПа |  | 0.7 |  | 71765 | 2024-05-15 | se0001 |  | A41 | 14 | 13 | 0v1 | 24v1 | 24v1 | 4106 | XT1 | 16 | 17 | ШУГ4 |  |  |  | 1 | 2
а3P161 | Датчик давления воздуха перед горелкой №16 | АИР-20/М2/-/Н/-/ДИ/110/-/-/М20/11N/ А3/t4070/С2/C05/ 0…2,5кПа/-/42/20 КНК Ni/-/ IP66/-/-/-/-/-/-/-/-/ГП/ТУ/- | Элемер | 0 | 2.5 | кПа |  | 0.7 |  | 71765 | 2024-05-15 | se0001 |  | A51 | 14 | 13 | 0v1 | 24v1 | 24v1 | 5106 | XT1 | 16 | 17 | ШУГ5 |  |  |  | 1 | 2
а3P171 | Датчик давления воздуха перед горелкой №17 | АИР-20/М2/-/Н/-/ДИ/110/-/-/М20/11N/ А3/t4070/С2/C05/ 0…2,5кПа/-/42/20 КНК Ni/-/ IP66/-/-/-/-/-/-/-/-/ГП/ТУ/- | Элемер | 0 | 2.5 | кПа |  | 0.7 |  | 71765 | 2024-05-15 | se0001 |  | A41 | 21 | 20 | 0v1 | 24v1 | 24v1 | 4109 | XT1 | 25 | 26 | ШУГ4 |  |  |  | 1 | 2
а3P181 | Датчик давления воздуха перед горелкой №18 | АИР-20/М2/-/Н/-/ДИ/110/-/-/М20/11N/ А3/t4070/С2/C05/ 0…2,5кПа/-/42/20 КНК Ni/-/ IP66/-/-/-/-/-/-/-/-/ГП/ТУ/- | Элемер | 0 | 2.5 | кПа |  | 0.7 |  | 71765 | 2024-05-15 | se0001 |  | A51 | 21 | 20 | 0v1 | 24v1 | 24v1 | 5109 | XT1 | 25 | 26 | ШУГ5 |  |  |  | 1 | 2
а3P191 | Датчик давления воздуха перед горелкой №19 | АИР-20/М2/-/Н/-/ДИ/110/-/-/М20/11N/ А3/t4070/С2/C05/ 0…2,5кПа/-/42/20 КНК Ni/-/ IP66/-/-/-/-/-/-/-/-/ГП/ТУ/- | Элемер | 0 | 2.5 | кПа |  | 0.7 |  | 71765 | 2024-05-15 | se0001 |  | A41 | 27 | 26 | 0v1 | 24v1 | 24v1 | 4112 | XT1 | 34 | 35 | ШУГ4 |  |  |  | 1 | 2
а3P201 | Датчик давления воздуха перед горелкой №20 | АИР-20/М2/-/Н/-/ДИ/110/-/-/М20/11N/ А3/t4070/С2/C05/ 0…2,5кПа/-/42/20 КНК Ni/-/ IP66/-/-/-/-/-/-/-/-/ГП/ТУ/- | Элемер | 0 | 2.5 | кПа |  | 0.7 |  | 71765 | 2024-05-15 | se0001 |  | A51 | 27 | 26 | 0v1 | 24v1 | 24v1 | 5112 | XT1 | 34 | 35 | ШУГ5 |  |  |  | 1 | 2
а3Pi011 | Манометр давления воздуха перед горелкой №1 | КМ22Р(0-2,5кПа)М20х1,5.1,5 | Росма | 0 | 2.5 | кПа |  |  |  | 4070 | 2024-05-15 | не электр.
а3Pi021 | Манометр давления воздуха перед горелкой №2 | КМ22Р(0-2,5кПа)М20х1,5.1,5 | Росма | 0 | 2.5 | кПа |  |  |  | 4070 | 2024-05-15 | не электр.
а3Pi031 | Манометр давления воздуха перед горелкой №3 | КМ22Р(0-2,5кПа)М20х1,5.1,5 | Росма | 0 | 2.5 | кПа |  |  |  | 4070 | 2024-05-15 | не электр.
а3Pi041 | Манометр давления воздуха перед горелкой №4 | КМ22Р(0-2,5кПа)М20х1,5.1,5 | Росма | 0 | 2.5 | кПа |  |  |  | 4070 | 2024-05-15 | не электр.
а3Pi051 | Манометр давления воздуха перед горелкой №5 | КМ22Р(0-2,5кПа)М20х1,5.1,5 | Росма | 0 | 2.5 | кПа |  |  |  | 4070 | 2024-05-15 | не электр.
а3Pi061 | Манометр давления воздуха перед горелкой №6 | КМ22Р(0-2,5кПа)М20х1,5.1,5 | Росма | 0 | 2.5 | кПа |  |  |  | 4070 | 2024-05-15 | не электр.
а3Pi071 | Манометр давления воздуха перед горелкой №7 | КМ22Р(0-2,5кПа)М20х1,5.1,5 | Росма | 0 | 2.5 | кПа |  |  |  | 4070 | 2024-05-15 | не электр.
а3Pi081 | Манометр давления воздуха перед горелкой №8 | КМ22Р(0-2,5кПа)М20х1,5.1,5 | Росма | 0 | 2.5 | кПа |  |  |  | 4070 | 2024-05-15 | не электр.
а3Pi091 | Манометр давления воздуха перед горелкой №9 | КМ22Р(0-2,5кПа)М20х1,5.1,5 | Росма | 0 | 2.5 | кПа |  |  |  | 4070 | 2024-05-15 | не электр.
а3Pi101 | Манометр давления воздуха перед горелкой №10 | КМ22Р(0-2,5кПа)М20х1,5.1,5 | Росма | 0 | 2.5 | кПа |  |  |  | 4070 | 2024-05-15 | не электр.
а3Pi111 | Манометр давления воздуха перед горелкой №11 | КМ22Р(0-2,5кПа)М20х1,5.1,5 | Росма | 0 | 2.5 | кПа |  |  |  | 4070 | 2024-05-15 | не электр.
а3Pi121 | Манометр давления воздуха перед горелкой №12 | КМ22Р(0-2,5кПа)М20х1,5.1,5 | Росма | 0 | 2.5 | кПа |  |  |  | 4070 | 2024-05-15 | не электр.
а3Pi131 | Манометр давления воздуха перед горелкой №13 | КМ22Р(0-2,5кПа)М20х1,5.1,5 | Росма | 0 | 2.5 | кПа |  |  |  | 4070 | 2024-05-15 | не электр.
а3Pi141 | Манометр давления воздуха перед горелкой №14 | КМ22Р(0-2,5кПа)М20х1,5.1,5 | Росма | 0 | 2.5 | кПа |  |  |  | 4070 | 2024-05-15 | не электр.
а3Pi151 | Манометр давления воздуха перед горелкой №15 | КМ22Р(0-2,5кПа)М20х1,5.1,5 | Росма | 0 | 2.5 | кПа |  |  |  | 4070 | 2024-05-15 | не электр.
а3Pi161 | Манометр давления воздуха перед горелкой №16 | КМ22Р(0-2,5кПа)М20х1,5.1,5 | Росма | 0 | 2.5 | кПа |  |  |  | 4070 | 2024-05-15 | не электр.
а3Pi171 | Манометр давления воздуха перед горелкой №17 | КМ22Р(0-2,5кПа)М20х1,5.1,5 | Росма | 0 | 2.5 | кПа |  |  |  | 4070 | 2024-05-15 | не электр.
а3Pi181 | Манометр давления воздуха перед горелкой №18 | КМ22Р(0-2,5кПа)М20х1,5.1,5 | Росма | 0 | 2.5 | кПа |  |  |  | 4070 | 2024-05-15 | не электр.
а3Pi191 | Манометр давления воздуха перед горелкой №19 | КМ22Р(0-2,5кПа)М20х1,5.1,5 | Росма | 0 | 2.5 | кПа |  |  |  | 4070 | 2024-05-15 | не электр.
а3Pi201 | Манометр давления воздуха перед горелкой №20 | КМ22Р(0-2,5кПа)М20х1,5.1,5 | Росма | 0 | 2.5 | кПа |  |  |  | 4070 | 2024-05-15 | не электр.
g3P001 | Датчик давления газа на входе в котел | АИР-20/М2/-/Н/-/ДИ/130/-/-/М20/11N/ А3/t4070/С2/C05/ 0…100кПа/42/20 КНК Ni/-/ IP66/-/-/-/-/-/-/-/-/ГП/ТУ/ЭП | Элемер | 0 | 100 | кПа |  | 0.7 |  | 59675 | 2024-05-15 | se0001 |  | A01 | 3 | 2 | 0v1 | 24v1 | 24v1 | 0101 | XT1 | 1 | 2 | ШУК |  |  |  | 1 | 2
g3Pi001 | Манометр давления газа на входе в котел | ТМ-510Р.00(0-0,1МПа)М20х1,5.1,5 | Росма | 0 | 100 | кПа |  |  |  | 955 | 2024-05-15 | не электр.
g3dP001 | Датчик перепада давления газа на входе в котел (расход) | АИР-20/М2/-/Н/-/ДД/420/-/-/-/11V/А3/t4070/С2/C05/ 0…10кПа/ 16МПа/42/20 КНК Ni/-/ IP66/-/-/КР3/-/Y(C32)/-/-/-/ ГП/ТУ/ЭП | Элемер | 0 | 10 | кПа |  | 0.7 |  | 82620 | 2024-05-15 | se0001 |  | A01 | 5 | 4 | 0v1 | 24v1 | 24v1 | 0102 | XT1 | 3 | 4 | ШУК |  |  |  | 1 | 2
g3T001 | Датчик температуры газа в коллекторе | ТПУ-205/-/ТС-1088/1БГ/АГ10/20 КНК Ni/t1070C3/Pt100/-50…100/320/10/0,5/ ГП/ТУ/ЭП | Элемер | -50 | 100 | ℃ |  | 0.8 |  | 15785 | 2024-05-15 | se0001 |  | A01 | 7 | 6 | 0v1 | 24v1 | 24v1 | 0103 | XT1 | 5 | 6 | ШУК |  |  |  | 1 | 2
g3Ti001 | Термометр температуры газа в коллекторе | БТ52.211(-30...+70С)G1/2.300.1,5 | Росма | -30 | 70 | ℃ |  |  |  | 2250 | 2024-05-15 | не электр.
g3Pi002 | Манометр давления газа в коллекторе | ТМ-510Р.00(0-0,1МПа)М20х1,5.1,5 | Росма | 0 | 100 | кПа |  |  |  | 955 | 2024-05-15 | не электр.
g3P002 | Датчик давления газа в коллекторе | АИР-20/М2/-/Н/-/ДИ/130/-/-/М20/11N/ А3/t4070/С2/C05/ 0…100кПа/42/20 КНК Ni/-/ IP66/-/-/-/-/-/-/-/-/ГП/ТУ/ЭП | Элемер | 0 | 100 | кПа |  | 0.7 |  | 59675 | 2024-05-15 | se0001 |  | A01 | 9 | 8 | 0v1 | 24v1 | 24v1 | 0104 | XT1 | 7 | 8 | ШУК |  |  |  | 1 | 2
g3P003 | Датчик давления газа в коллекторе дублирующий №1 | АИР-20/М2/-/Н/-/ДИ/130/-/-/М20/11N/ А3/t4070/С2/C05/ 0…100кПа/42/20 КНК Ni/-/ IP66/-/-/-/-/-/-/-/-/ГП/ТУ/ЭП | Элемер | 0 | 100 | кПа |  | 0.7 |  | 59675 | 2024-05-15 | se0001 |  | A01 | 12 | 11 | 0v1 | 24v1 | 24v1 | 0105 | XT1 | 9 | 10 | ШУК |  |  |  | 1 | 2
g3P004 | Датчик давления газа в коллекторе дублирующий №2 | АИР-20/М2/-/Н/-/ДИ/130/-/-/М20/11N/ А3/t4070/С2/C05/ 0…100кПа/42/20 КНК Ni/-/ IP66/-/-/-/-/-/-/-/-/ГП/ТУ/ЭП | Элемер | 0 | 100 | кПа |  | 0.7 |  | 59675 | 2024-05-15 | se0001 |  | A01 | 14 | 13 | 0v1 | 24v1 | 24v1 | 0106 | XT1 | 11 | 12 | ШУК |  |  |  | 1 | 2
w3T001 | Датчик температуры теплоносителя на входе в котел | ТПУ-205/-/ТС-1088/1БГ/АГ10/20 КНК Ni/t1070C3/Pt100/0…200/400/10/0,5/ ГП/ТУ/ЭП | Элемер | 0 | 200 | ℃ |  | 0.8 |  | 16805 | 2024-05-15 | se0001 |  | A02 | 3 | 2 | 0v1 | 24v1 | 24v1 | 0201 | XT2 | 1 | 2 | ШУК |  |  |  | 1 | 2
w3Ti001 | Термометр температуры теплоносителя на входе в котел | БТ52.211(0-250С)G1/2.300.1,5 | Росма | 0 | 250 | ℃ |  |  |  | 2250 | 2024-05-15 | не электр.
w3Pi001 | Манометр давления теплоносителя на входе в котел | ТМ610Р.00(0-4,0мПаМ20х1,5.1,5 | Росма | 0 | 4 | Мпа |  |  |  | 1510 | 2024-05-15 | не электр.
w3P001 | Датчик давления теплоносителя на входе в котел | АИР-20/М2/-/Н/-/ДИ/170/-/-/М20/11N/ А3/t4070/ С2/C05/ 0…2,5МПа/-/42/20 КНК Ni/-/ IP66/-/-/-/Y(Е22)/-/-/-/-/ГП/ТУ/ЭП | Элемер | 0 | 2.5 | Мпа |  | 0.7 |  | 61235 | 2024-05-15 | se0001 |  | A02 | 5 | 4 | 0v1 | 24v1 | 24v1 | 0202 | XT2 | 3 | 4 | ШУК |  |  |  | 1 | 2
w3dP001 | Датчик перепада давления теплоносителя после котла (расход) | АИР-20/М2/-/Н/-/ДД/440/-/-/-/11V/А3/t4070/С2/C05/ 0…63кПа/ 16МПа/42/20 КНК Ni/-/ IP66/-/-/КР3/-/Y(C32) /-/-/-/ ГП/ТУ/ЭП | Элемер | 0 | 63 | кПа |  | 0.7 |  | 82620 | 2024-05-15 | se0001 |  | A02 | 7 | 6 | 0v1 | 24v1 | 24v1 | 0203 | XT2 | 5 | 6 | ШУК |  |  |  | 1 | 2
w3dP002 | Датчик перепада давления теплоносителя после котла (расход) дублирующий №1 | АИР-20/М2/-/Н/-/ДД/440/-/-/-/11V/А3/t4070/С2/C05/ 0…63кПа/ 16МПа/42/20 КНК Ni/-/ IP66/-/-/КР3/-/Y(C32) /-/-/-/ ГП/ТУ/ЭП | Элемер | 0 | 63 | кПа |  | 0.7 |  | 82620 | 2024-05-15 | se0001 |  | A02 | 9 | 8 | 0v1 | 24v1 | 24v1 | 0204 | XT2 | 7 | 8 | ШУК |  |  |  | 1 | 2
w3dP003 | Датчик перепада давления теплоносителя после котла (расход) дублирующий №2 | АИР-20/М2/-/Н/-/ДД/440/-/-/-/11V/А3/t4070/С2/C05/ 0…63кПа/ 16МПа/42/20 КНК Ni/-/ IP66/-/-/КР3/-/Y(C32) /-/-/-/ ГП/ТУ/ЭП | Элемер | 0 | 63 | кПа |  | 0.7 |  | 82620 | 2024-05-15 | se0001 |  | A02 | 12 | 11 | 0v1 | 24v1 | 24v1 | 0205 | XT2 | 9 | 10 | ШУК |  |  |  | 1 | 2
w3Pi002 | Манометр давления теплоносителя после котла | ТМ610Р.00(0-4,0мПаМ20х1,5.1,5 | Росма | 0 | 4 | Мпа |  |  |  | 1510 | 2024-05-15 | не электр.
w3P002 | Датчик давления теплоносителя после котла | АИР-20/М2/-/Н/-/ДИ/170/-/-/М20/11N/ А3/t4070/ С2/C05/ 0…2,5МПа/-/42/20 КНК Ni/-/ IP66/-/-/-/Y(Е22)/-/-/-/-/ГП/ТУ/ЭП | Элемер | 0 | 2.5 | Мпа |  | 0.7 |  | 61235 | 2024-05-15 | se0001 |  | A02 | 14 | 13 | 0v1 | 24v1 | 24v1 | 0206 | XT2 | 11 | 12 | ШУК |  |  |  | 1 | 2
w3P003 | Датчик давления теплоносителя после котла дублирующий №1 | АИР-20/М2/-/Н/-/ДИ/170/-/-/М20/11N/ А3/t4070/ С2/C05/ 0…2,5МПа/-/42/20 КНК Ni/-/ IP66/-/-/-/Y(Е22)/-/-/-/-/ГП/ТУ/ЭП | Элемер | 0 | 2.5 | Мпа |  | 0.7 |  | 61235 | 2024-05-15 | se0001 |  | A02 | 16 | 15 | 0v1 | 24v1 | 24v1 | 0207 | XT2 | 13 | 34 | ШУК |  |  |  | 1 | 2
w3P004 | Датчик давления теплоносителя после котла дублирующий №2 | АИР-20/М2/-/Н/-/ДИ/170/-/-/М20/11N/ А3/t4070/ С2/C05/ 0…2,5МПа/-/42/20 КНК Ni/-/ IP66/-/-/-/Y(Е22)/-/-/-/-/ГП/ТУ/ЭП | Элемер | 0 | 2.5 | Мпа |  | 0.7 |  | 61235 | 2024-05-15 | se0001 |  | A02 | 18 | 17 | 0v1 | 24v1 | 24v1 | 0208 | XT2 | 15 | 16 | ШУК |  |  |  | 1 | 2
w3Ti002 | Термометр температуры теплоносителя после котла | БТ52.211(0-250С)G1/2.300.1,5 | Росма | 0 | 250 | ℃ |  |  |  | 2250 | 2024-05-15 | не электр.
w3T002 | Датчик температуры теплоносителя после котла | ТПУ-205/-/ТС-1088/1БГ/АГ10/20 КНК Ni/t1070C3/Pt100/0…200/400/10/0,5/ ГП/ТУ/ЭП | Элемер | 0 | 200 | ℃ |  | 0.8 |  | 16805 | 2024-05-15 | se0001 |  | A02 | 21 | 20 | 0v1 | 24v1 | 24v1 | 0209 | XT2 | 17 | 18 | ШУК |  |  |  | 1 | 2
w3T003 | Датчик температуры теплоносителя после котла дублирующий №1 | ТПУ-205/-/ТС-1088/1БГ/АГ10/20 КНК Ni/t1070C3/Pt100/0…200/400/10/0,5/ ГП/ТУ/ЭП | Элемер | 0 | 200 | ℃ |  | 0.8 |  | 16805 | 2024-05-15 | se0001 |  | A02 | 23 | 22 | 0v1 | 24v1 | 24v1 | 0210 | XT2 | 19 | 20 | ШУК |  |  |  | 1 | 2
w3T004 | Датчик температуры теплоносителя после котла дублирующий №2 | ТПУ-205/-/ТС-1088/1БГ/АГ10/20 КНК Ni/t1070C3/Pt100/0…200/400/10/0,5/ ГП/ТУ/ЭП | Элемер | 0 | 200 | ℃ |  | 0.8 |  | 16805 | 2024-05-15 | se0001 |  | A02 | 25 | 24 | 0v1 | 24v1 | 24v1 | 0211 | XT2 | 21 | 22 | ШУК |  |  |  | 1 | 2
f3Pi001 | Манометр разрежения в топке котла | КМВ22Р(-1...1,5кПа)М20х1,5 | Росма | -1 | 1.5 | кПа |  |  |  | 4070 | 2024-05-15 | не электр.
f3P001 | Датчик разрежения в топке котла | АИР-20/М2/-/Н/-/ДИВ/310/-/-/М20/ 11N/ А3/t4070/С2/ C05/-0,2…0,2кПа/-/42/ 20 КНК Ni/-/ IP66/-/-/-/-/-/-/-/-/ГП/ТУ/ЭП | Элемер | -0.2 | 0.2 | кПа |  | 0.7 |  | 73975 | 2024-05-15 | se0001 |  | A01 | 16 | 15 | 0v1 | 24v1 | 24v1 | 0107 | XT1 | 13 | 14 | ШУК |  |  |  | 1 | 2
f3P002 | Датчик разрежения в топке котла дублирующий №1 | АИР-20/М2/-/Н/-/ДИВ/310/-/-/М20/ 11N/ А3/t4070/С2/ C05/-0,2…0,2кПа/-/42/ 20 КНК Ni/-/ IP66/-/-/-/-/-/-/-/-/ГП/ТУ/ЭП | Элемер | -0.2 | 0.2 | кПа |  | 0.7 |  | 73975 | 2024-05-15 | se0001 |  | A01 | 18 | 17 | 0v1 | 24v1 | 24v1 | 0108 | XT1 | 15 | 16 | ШУК |  |  |  | 1 | 2
f3P003 | Датчик разрежения в топке котла дублирующий №2 | АИР-20/М2/-/Н/-/ДИВ/310/-/-/М20/ 11N/ А3/t4070/С2/ C05/-0,2…0,2кПа/-/42/ 20 КНК Ni/-/ IP66/-/-/-/-/-/-/-/-/ГП/ТУ/ЭП | Элемер | -0.2 | 0.2 | кПа |  | 0.7 |  | 73975 | 2024-05-15 | se0001 |  | A01 | 21 | 20 | 0v1 | 24v1 | 24v1 | 0109 | XT1 | 17 | 18 | ШУК |  |  |  | 1 | 2
f3T001 | Датчик температуры дымовых газов | ТПУ-205/-/ТС-1088/1БГ/АГ10/20 КНК Ni/t1070C3/Pt100/0…400/800/10/0,5/ ГП/ТУ/ЭП | Элемер | 0 | 400 | ℃ |  | 0.8 |  | 19395 | 2024-05-15 | se0001 |  | A01 | 23 | 22 | 0v1 | 24v1 | 24v1 | 0110 | XT1 | 19 | 20 | ШУК |  |  |  | 1 | 2
f3Ti001 | Термометр температуры дымовых газов | БТ52.212(0-450С)G1/2.300.1,5 | Росма | 0 | 450 | ℃ |  |  |  | 2250 | 2024-05-15 | не электр.
f3X001 | Газоанализатор дымовых газов | ИКТС-11.1 | ЗАО "Проманалитприбор" |  |  |  |  | ? |  |  |  | se0018
b3X001 | Датчик интенсивности пламени | ФДСА-03М-01-010 | Прома |  |  |  |  | 4.8 |  | 84355 | 2024-05-15 | se0009 |  |  |  |  |  |  |  |  |  |  |  |  |  |  |  |  |  | A01 | AI11+ | AI11- | 24 | 25 | 0v1 | 24v1 | 0111+ | 0111- | XT1 | 21 | 22 | 23 | 24 | ШУК |  |  |  | 1 | 2 | 8 | 9
b3X002 | Датчик интенсивности пламени | ФДСА-03М-01-010 | Прома |  |  |  |  | 4.8 |  | 84355 | 2024-05-15 | se0009 |  |  |  |  |  |  |  |  |  |  |  |  |  |  |  |  |  | A01 | AI12+ | AI12- | 26 | 27 | 0v1 | 24v1 | 0112+ | 0112- | XT1 | 25 | 26 | 27 | 28 | ШУК |  |  |  | 1 | 2 | 8 | 9
b3X003 | Датчик интенсивности пламени | ФДСА-03М-01-010 | Прома |  |  |  |  | 4.8 |  | 84355 | 2024-05-15 | se0009 |  |  |  |  |  |  |  |  |  |  |  |  |  |  |  |  |  | A01 | AI13+ | AI13- | 29 | 30 | 0v1 | 24v1 | 0113+ | 0113- | XT1 | 29 | 30 | 31 | 32 | ШУК |  |  |  | 1 | 2 | 8 | 9
b3X004 | Датчик интенсивности пламени | ФДСА-03М-01-010 | Прома |  |  |  |  | 4.8 |  | 84355 | 2024-05-15 | se0009 |  |  |  |  |  |  |  |  |  |  |  |  |  |  |  |  |  | A01 | AI14+ | AI14- | 31 | 32 | 0v1 | 24v1 | 0114+ | 0114- | XT1 | 33 | 34 | 35 | 36 | ШУК |  |  |  | 1 | 2 | 8 | 9
b3X005 | Датчик интенсивности пламени | ФДСА-03М-01-010 | Прома |  |  |  |  | 4.8 |  | 84355 | 2024-05-15 | se0009 |  |  |  |  |  |  |  |  |  |  |  |  |  |  |  |  |  | A01 | AI15+ | AI15- | 33 | 34 | 0v1 | 24v1 | 0115+ | 0115- | XT1 | 37 | 38 | 39 | 40 | ШУК |  |  |  | 1 | 2 | 8 | 9
b3X006 | Датчик интенсивности пламени | ФДСА-03М-01-010 | Прома |  |  |  |  | 4.8 |  | 84355 | 2024-05-15 | se0009 |  |  |  |  |  |  |  |  |  |  |  |  |  |  |  |  |  | A01 | AI16+ | AI16- | 35 | 36 | 0v1 | 24v1 | 0116+ | 0116- | XT1 | 41 | 42 | 43 | 44 | ШУК |  |  |  | 1 | 2 | 8 | 9
b3X042 | Датчик наличия факела запальника горелки №4 | ДПЗ-01А/220 | ООО "Общемаш" |  |  |  |  | 2.4 |  | 12415 | 2024-05-22 | se0005
b3X043 | Датчик наличия факела горелки №4 | ФДСА-03М-01 | Прома |  |  |  |  | 4.8 |  | 84355 | 2024-05-15 | se0010
b3X102 | Датчик наличия факела запальника горелки №10 | ДПЗ-01А/220 | ООО "Общемаш" |  |  |  |  | 2.4 |  | 12415 | 2024-05-22 | se0005
b3X103 | Датчик наличия факела горелки №10 | ФДСА-03М-01 | Прома |  |  |  |  | 4.8 |  | 84355 | 2024-05-15 | se0010
b3X182 | Датчик наличия факела запальника горелки №18 | ДПЗ-01А/220 | ООО "Общемаш" |  |  |  |  | 2.4 |  | 12415 | 2024-05-22 | se0005
b3X183 | Датчик наличия факела горелки №18 | ФДСА-03М-01 | Прома |  |  |  |  | 4.8 |  | 84355 | 2024-05-15 | se0010
b3X032 | Датчик наличия факела запальника горелки №3 | ДПЗ-01А/220 | ООО "Общемаш" |  |  |  |  | 2.4 |  | 12415 | 2024-05-22 | se0005
b3X033 | Датчик наличия факела горелки №3 | ФДСА-03М-01 | Прома |  |  |  |  | 4.8 |  | 84355 | 2024-05-15 | se0010
b3X112 | Датчик наличия факела запальника горелки №11 | ДПЗ-01А/220 | ООО "Общемаш" |  |  |  |  | 2.4 |  | 12415 | 2024-05-22 | se0005
b3X113 | Датчик наличия факела горелки №11 | ФДСА-03М-01 | Прома |  |  |  |  | 4.8 |  | 84355 | 2024-05-15 | se0010
b3X172 | Датчик наличия факела запальника горелки №17 | ДПЗ-01А/220 | ООО "Общемаш" |  |  |  |  | 2.4 |  | 12415 | 2024-05-22 | se0005
b3X173 | Датчик наличия факела горелки №17 | ФДСА-03М-01 | Прома |  |  |  |  | 4.8 |  | 84355 | 2024-05-15 | se0010
а3СН001 | Датчик загазованности СН4 | ДАК-CH4-129 | Аналитприбор СПО |  |  |  |  | 3.5 |  | 84200 | 2024-05-15 | se0011
а3СН002 | Датчик загазованности СН4 | ДАК-CH4-129 | Аналитприбор СПО |  |  |  |  | 3.5 |  | 84200 | 2024-05-15 | se0011
а3СН003 | Датчик загазованности СН4 | ДАК-CH4-129 | Аналитприбор СПО |  |  |  |  | 3.5 |  | 84200 | 2024-05-15 | se0011
а3СН004 | Датчик загазованности СН4 | ДАК-CH4-129 | Аналитприбор СПО |  |  |  |  | 3.5 |  | 84200 | 2024-05-15 | se0011
а3СО001 | Датчик загазованности СО | ДАХ-М-05-CO-200 | Аналитприбор СПО |  |  |  |  | 2 |  | 97700 | 2024-05-15 | se0009 |  |  |  |  |  |  |  |  |  |  |  |  |  |  |  |  |  | A02 | AI12+ | AI12- | 26 | 27 | 0v1 | 24v1 | 0212+ | 0212- | XT2 | 23 | 24 | 25 | 26 | ШУК |  |  |  | X1:4 | X1:2 | X2:4 | X2:2
а3СО002 | Датчик загазованности СО | ДАХ-М-05-CO-200 | Аналитприбор СПО |  |  |  |  | 2 |  | 97700 | 2024-05-15 | se0009 |  |  |  |  |  |  |  |  |  |  |  |  |  |  |  |  |  | A02 | AI13+ | AI13- | 29 | 30 | 0v1 | 24v1 | 0213+ | 0213- | XT2 | 27 | 28 | 29 | 30 | ШУК |  |  |  | X1:4 | X1:2 | X2:4 | X2:2
а3СО003 | Датчик загазованности СО | ДАХ-М-05-CO-200 | Аналитприбор СПО |  |  |  |  | 2 |  | 97700 | 2024-05-15 | se0009 |  |  |  |  |  |  |  |  |  |  |  |  |  |  |  |  |  | A02 | AI14+ | AI14- | 31 | 32 | 0v1 | 24v1 | 0214+ | 0214- | XT2 | 31 | 32 | 33 | 34 | ШУК |  |  |  | X1:4 | X1:2 | X2:4 | X2:2
а3СО004 | Датчик загазованности СО | ДАХ-М-05-CO-200 | Аналитприбор СПО |  |  |  |  | 2 |  | 97700 | 2024-05-15 | se0009 |  |  |  |  |  |  |  |  |  |  |  |  |  |  |  |  |  | A02 | AI15+ | AI15- | 33 | 34 | 0v1 | 24v1 | 0215+ | 0215- | XT2 | 35 | 36 | 37 | 38 | ШУК |  |  |  | X1:4 | X1:2 | X2:4 | X2:2
g3V011 | Клапан ПЗК-1 на горелке №1 | ВН4Н-1П ст | СП "Термобрест" |  |  |  | 100 | 65 | 33.3 |  |  | se0003 |  |  |  |  |  |  |  |  |  |  |  |  |  |  |  |  |  |  |  |  |  |  |  |  |  |  |  |  |  |  |  |  |  |  |  |  |  |  |  | L | N | PE |  |  |  | ШУГ1 | XT5
g3V021 | Клапан ПЗК-1 на горелке №2 | ВН4Н-1П ст | СП "Термобрест" |  |  |  | 100 | 65 | 33.3 |  |  | se0003 |  |  |  |  |  |  |  |  |  |  |  |  |  |  |  |  |  |  |  |  |  |  |  |  |  |  |  |  |  |  |  |  |  |  |  |  |  |  |  | L | N | PE |  |  |  | ШУГ2 | XT5
g3V031 | Клапан ПЗК-1 на горелке №3 | ВН4Н-1П ст | СП "Термобрест" |  |  |  | 100 | 65 | 33.3 |  |  | se0003 |  |  |  |  |  |  |  |  |  |  |  |  |  |  |  |  |  |  |  |  |  |  |  |  |  |  |  |  |  |  |  |  |  |  |  |  |  |  |  | L | N | PE |  |  |  | ШУГ1 | XT5
g3V041 | Клапан ПЗК-1 на горелке №4 | ВН4Н-1П ст | СП "Термобрест" |  |  |  | 100 | 65 | 33.3 |  |  | se0003 |  |  |  |  |  |  |  |  |  |  |  |  |  |  |  |  |  |  |  |  |  |  |  |  |  |  |  |  |  |  |  |  |  |  |  |  |  |  |  | L | N | PE |  |  |  | ШУГ2 | XT5
g3V051 | Клапан ПЗК-1 на горелке №5 | ВН4Н-1П ст | СП "Термобрест" |  |  |  | 100 | 65 | 33.3 |  |  | se0003 |  |  |  |  |  |  |  |  |  |  |  |  |  |  |  |  |  |  |  |  |  |  |  |  |  |  |  |  |  |  |  |  |  |  |  |  |  |  |  | L | N | PE |  |  |  | ШУГ1 | XT5
g3V061 | Клапан ПЗК-1 на горелке №6 | ВН4Н-1П ст | СП "Термобрест" |  |  |  | 100 | 65 | 33.3 |  |  | se0003 |  |  |  |  |  |  |  |  |  |  |  |  |  |  |  |  |  |  |  |  |  |  |  |  |  |  |  |  |  |  |  |  |  |  |  |  |  |  |  | L | N | PE |  |  |  | ШУГ2 | XT5
g3V071 | Клапан ПЗК-1 на горелке №7 | ВН4Н-1П ст | СП "Термобрест" |  |  |  | 100 | 65 | 33.3 |  |  | se0003 |  |  |  |  |  |  |  |  |  |  |  |  |  |  |  |  |  |  |  |  |  |  |  |  |  |  |  |  |  |  |  |  |  |  |  |  |  |  |  | L | N | PE |  |  |  | ШУГ1 | XT5
g3V081 | Клапан ПЗК-1 на горелке №8 | ВН4Н-1П ст | СП "Термобрест" |  |  |  | 100 | 65 | 33.3 |  |  | se0003 |  |  |  |  |  |  |  |  |  |  |  |  |  |  |  |  |  |  |  |  |  |  |  |  |  |  |  |  |  |  |  |  |  |  |  |  |  |  |  | L | N | PE |  |  |  | ШУГ2 | XT5
g3V091 | Клапан ПЗК-1 на горелке №9 | ВН4Н-1П ст | СП "Термобрест" |  |  |  | 100 | 65 | 33.3 |  |  | se0003 |  |  |  |  |  |  |  |  |  |  |  |  |  |  |  |  |  |  |  |  |  |  |  |  |  |  |  |  |  |  |  |  |  |  |  |  |  |  |  | L | N | PE |  |  |  | ШУГ3 | XT5
g3V101 | Клапан ПЗК-1 на горелке №10 | ВН4Н-1П ст | СП "Термобрест" |  |  |  | 100 | 65 | 33.3 |  |  | se0003 |  |  |  |  |  |  |  |  |  |  |  |  |  |  |  |  |  |  |  |  |  |  |  |  |  |  |  |  |  |  |  |  |  |  |  |  |  |  |  | L | N | PE |  |  |  | ШУГ3 | XT5
g3V111 | Клапан ПЗК-1 на горелке №11 | ВН4Н-1П ст | СП "Термобрест" |  |  |  | 100 | 65 | 33.3 |  |  | se0003 |  |  |  |  |  |  |  |  |  |  |  |  |  |  |  |  |  |  |  |  |  |  |  |  |  |  |  |  |  |  |  |  |  |  |  |  |  |  |  | L | N | PE |  |  |  | ШУГ3 | XT5
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
а3M041 | Дутьевой вентилятор на горелке №4 |  | существующий |  |  |  |  |  |  |  |  | se0002
а3M051 | Дутьевой вентилятор на горелке №5 |  | существующий |  |  |  |  |  |  |  |  | se0002
а3M061 | Дутьевой вентилятор на горелке №6 |  | существующий |  |  |  |  |  |  |  |  | se0002
а3M071 | Дутьевой вентилятор на горелке №7 |  | существующий |  |  |  |  |  |  |  |  | se0002
а3M081 | Дутьевой вентилятор на горелке №8 |  | существующий |  |  |  |  |  |  |  |  | se0002
а3M091 | Дутьевой вентилятор на горелке №9 |  | существующий |  |  |  |  |  |  |  |  | se0002
а3M101 | Дутьевой вентилятор на горелке №10 |  | существующий |  |  |  |  |  |  |  |  | se0002
а3M111 | Дутьевой вентилятор на горелке №11 |  | существующий |  |  |  |  |  |  |  |  | se0002
а3M121 | Дутьевой вентилятор на горелке №12 |  | существующий |  |  |  |  |  |  |  |  | se0002
а3M131 | Дутьевой вентилятор на горелке №13 |  | существующий |  |  |  |  |  |  |  |  | se0002
а3M141 | Дутьевой вентилятор на горелке №14 |  | существующий |  |  |  |  |  |  |  |  | se0002
а3M151 | Дутьевой вентилятор на горелке №15 |  | существующий |  |  |  |  |  |  |  |  | se0002
а3M161 | Дутьевой вентилятор на горелке №16 |  | существующий |  |  |  |  |  |  |  |  | se0002
а3M171 | Дутьевой вентилятор на горелке №17 |  | существующий |  |  |  |  |  |  |  |  | se0002
а3M181 | Дутьевой вентилятор на горелке №18 |  | существующий |  |  |  |  |  |  |  |  | se0002
а3M191 | Дутьевой вентилятор на горелке №19 |  | существующий |  |  |  |  |  |  |  |  | se0002
а3M201 | Дутьевой вентилятор на горелке №20 |  | существующий |  |  |  |  |  |  |  |  | se0002
g3V044 | Клапан запальника горелки №4 | ВН 3/4 Н-4П ст. | СП "Термобрест" |  |  |  | 20 |  | 2.8 |  |  | se0003 |  |  |  |  |  |  |  |  |  |  |  |  |  |  |  |  |  |  |  |  |  |  |  |  |  |  |  |  |  |  |  |  |  |  |  |  |  |  |  | L | N | PE |  |  |  | ШУГ2 | XT5
b3X041 | Трансформатор запальника горелки №4 | ИВН-01Е | ООО "Общемаш" |  |  |  |  | 20 |  | 10505 | 2024-05-22 | se0002
g3V104 | Клапан запальника горелки №10 | ВН 3/4 Н-4П ст. | СП "Термобрест" |  |  |  | 20 |  | 2.8 |  |  | se0003 |  |  |  |  |  |  |  |  |  |  |  |  |  |  |  |  |  |  |  |  |  |  |  |  |  |  |  |  |  |  |  |  |  |  |  |  |  |  |  | L | N | PE |  |  |  | ШУГ3 | XT5
b3X101 | Трансформатор запальника горелки №10 | ИВН-01Е | ООО "Общемаш" |  |  |  |  | 20 |  | 10505 | 2024-05-22 | se0002
g3V184 | Клапан запальника горелки №18 | ВН 3/4 Н-4П ст. | СП "Термобрест" |  |  |  | 20 |  | 2.8 |  |  | se0003 |  |  |  |  |  |  |  |  |  |  |  |  |  |  |  |  |  |  |  |  |  |  |  |  |  |  |  |  |  |  |  |  |  |  |  |  |  |  |  | L | N | PE |  |  |  | ШУГ5 | XT5
b3X181 | Трансформатор запальника горелки №18 | ИВН-01Е | ООО "Общемаш" |  |  |  |  | 20 |  | 10505 | 2024-05-22 | se0002
g3V034 | Клапан запальника горелки №3 | ВН 3/4 Н-4П ст. | СП "Термобрест" |  |  |  | 20 |  | 2.8 |  |  | se0003 |  |  |  |  |  |  |  |  |  |  |  |  |  |  |  |  |  |  |  |  |  |  |  |  |  |  |  |  |  |  |  |  |  |  |  |  |  |  |  | L | N | PE |  |  |  | ШУГ1 | XT5
b3X031 | Трансформатор запальника горелки №3 | ИВН-01Е | ООО "Общемаш" |  |  |  |  | 20 |  | 10505 | 2024-05-22 | se0002
g3V114 | Клапан запальника горелки №11 | ВН 3/4 Н-4П ст. | СП "Термобрест" |  |  |  | 20 |  | 2.8 |  |  | se0003 |  |  |  |  |  |  |  |  |  |  |  |  |  |  |  |  |  |  |  |  |  |  |  |  |  |  |  |  |  |  |  |  |  |  |  |  |  |  |  | L | N | PE |  |  |  | ШУГ3 | XT5
b3X111 | Трансформатор запальника горелки №11 | ИВН-01Е | ООО "Общемаш" |  |  |  |  | 20 |  | 10505 | 2024-05-22 | se0002
g3V174 | Клапан запальника горелки №17 | ВН 3/4 Н-4П ст. | СП "Термобрест" |  |  |  | 20 |  | 2.8 |  |  | se0003 |  |  |  |  |  |  |  |  |  |  |  |  |  |  |  |  |  |  |  |  |  |  |  |  |  |  |  |  |  |  |  |  |  |  |  |  |  |  |  | L | N | PE |  |  |  | ШУГ4 | XT5
b3X171 | Трансформатор запальника горелки №17 | ИВН-01Е | ООО "Общемаш" |  |  |  |  | 20 |  | 10505 | 2024-05-22 | se0002
g3V001 | Клапан продувки | ВН2Н-1П ст. | СП "Термобрест" |  |  |  | 50 |  | 12.8 |  |  | se0003 |  |  |  |  |  |  |  |  |  |  |  |  |  |  |  |  |  |  |  |  |  |  |  |  |  |  |  |  |  |  |  |  |  |  |  |  |  |  |  | L | N | PE |  |  |  | ШУК | XT6
g3V002 | Клапан продувки | ВН2Н-1П ст. | СП "Термобрест" |  |  |  | 50 |  | 12.8 |  |  | se0003 |  |  |  |  |  |  |  |  |  |  |  |  |  |  |  |  |  |  |  |  |  |  |  |  |  |  |  |  |  |  |  |  |  |  |  |  |  |  |  | L | N | PE |  |  |  | ШУК | XT6
g3sM001 | Регулятор давления газа в коллекторе | ЗР12-6 В ПР. ст. | СП "Термобрест" |  |  |  | 300 |  | 80 |  |  | se0014
g3M001 | Задвижка газовая на входе в котел | 30с 941нж | ЗАО Южноураларматура, г.Миасс |  |  |  | 400 |  | 655 |  |  | se0017
w3M001 | Задвижка теплоносителя на входе в котел |  | существующий |  |  |  |  |  |  |  |  | se0017
w3M002 | Задвижка теплоносителя после котла |  | существующий |  |  |  |  |  |  |  |  | se0017
f3sM001 | Регулятор разрежения | МЭО-250/63-0,25У-99 | ООО «ПКП «Чебоксарыэлектропривод» |  |  |  |  |  |  | 53667 | 2024-05-23 | se0008
f3sM002 | Регулятор разрежения | МЭО-250/63-0,25У-99 | ООО «ПКП «Чебоксарыэлектропривод» |  |  |  |  |  |  | 53667 | 2024-05-23 | se0008
f3sM003 | Регулятор разрежения | МЭО-250/63-0,25У-99 | ООО «ПКП «Чебоксарыэлектропривод» |  |  |  |  |  |  | 53667 | 2024-05-23 | se0008
b3X034 | Горелка запальная газовая | ЭИВ-01-И-1500 | ООО "ЭТАЛОНПРИБОР" |  |  |  |  |  |  | 18300 | 2024-05-16 | не электр.
b3X044 | Горелка запальная газовая | ЭИВ-01-И-1500 | ООО "ЭТАЛОНПРИБОР" |  |  |  |  |  |  | 18300 | 2024-05-16 | не электр.
b3X104 | Горелка запальная газовая | ЭИВ-01-И-1500 | ООО "ЭТАЛОНПРИБОР" |  |  |  |  |  |  | 18300 | 2024-05-16 | не электр.
b3X114 | Горелка запальная газовая | ЭИВ-01-И-1500 | ООО "ЭТАЛОНПРИБОР" |  |  |  |  |  |  | 18300 | 2024-05-16 | не электр.
b3X174 | Горелка запальная газовая | ЭИВ-01-И-1500 | ООО "ЭТАЛОНПРИБОР" |  |  |  |  |  |  | 18300 | 2024-05-16 | не электр.
b3X184 | Горелка запальная газовая | ЭИВ-01-И-1500 | ООО "ЭТАЛОНПРИБОР" |  |  |  |  |  |  | 18300 | 2024-05-16 | не электр.
x3OS001 | Арм оператора | Scada-система IntraSCADa | Интра, Чебоксары
 | Стол оператора | 7CO3.624.000 (1200мм) | ООО «ПРОЕКТ МЕТАЛЛ»
x3CP001 | Шкаф управления котлом | Контроллеры и модули ввода-вывода REGUL R500 | ProsoftSystems, Екатеринбург
x3CP002 | Шкаф управления горелками | Модули ввода-вывода REGUL R500 | ProsoftSystems, Екатеринбург
x3CP003 | Шкаф управления горелками | Модули ввода-вывода REGUL R500 | ProsoftSystems, Екатеринбург
x3CP004 | Шкаф управления горелками | Модули ввода-вывода REGUL R500 | ProsoftSystems, Екатеринбург
x3CP005 | Шкаф управления горелками | Модули ввода-вывода REGUL R500 | ProsoftSystems, Екатеринбург
x3CP006 | Шкаф управления горелками | Модули ввода-вывода REGUL R500 | ProsoftSystems, Екатеринбург
x3PP001 | Шкаф питания
 | Иверторная система | DC/AC-220/220B-10000BA-6U-23 | «Форпост»
 | Байпас | ВР-220/220В-10000ВА-3U | «Форпост»
 |  |  |  |  |  |  |  |  |  | 7937166

Sheet: 240522
шифр | назначение | наименование | производитель | предел от | предел до | ед.изм | Ду | эн.потр | масса | цена без НДС | дата цены | схема эл. | схема монт. | параметры схем | мощность, Вт | питание
g3P011 | Датчик давления газа между ПЗК на горелке №1 | АИР-20/М2/-/Н/-/ДИ/130/-/-/М20/11N/ А3/t4070/С2/C05/ 0…100кПа/42/20 КНК Ni/-/ IP66/-/-/-/-/-/-/-/-/ГП/ТУ/ЭП | Элемер | 0 | 100 | кПа |  |  |  | 59675 | 2024-05-15
g3P021 | Датчик давления газа между ПЗК на горелке №2 | АИР-20/М2/-/Н/-/ДИ/130/-/-/М20/11N/ А3/t4070/С2/C05/ 0…100кПа/42/20 КНК Ni/-/ IP66/-/-/-/-/-/-/-/-/ГП/ТУ/ЭП | Элемер | 0 | 100 | кПа |  |  |  | 59675 | 2024-05-15
g3P031 | Датчик давления газа между ПЗК на горелке №3 | АИР-20/М2/-/Н/-/ДИ/130/-/-/М20/11N/ А3/t4070/С2/C05/ 0…100кПа/42/20 КНК Ni/-/ IP66/-/-/-/-/-/-/-/-/ГП/ТУ/ЭП | Элемер | 0 | 100 | кПа |  |  |  | 59675 | 2024-05-15
g3P041 | Датчик давления газа между ПЗК на горелке №4 | АИР-20/М2/-/Н/-/ДИ/130/-/-/М20/11N/ А3/t4070/С2/C05/ 0…100кПа/42/20 КНК Ni/-/ IP66/-/-/-/-/-/-/-/-/ГП/ТУ/ЭП | Элемер | 0 | 100 | кПа |  |  |  | 59675 | 2024-05-15
g3P051 | Датчик давления газа между ПЗК на горелке №5 | АИР-20/М2/-/Н/-/ДИ/130/-/-/М20/11N/ А3/t4070/С2/C05/ 0…100кПа/42/20 КНК Ni/-/ IP66/-/-/-/-/-/-/-/-/ГП/ТУ/ЭП | Элемер | 0 | 100 | кПа |  |  |  | 59675 | 2024-05-15
g3P061 | Датчик давления газа между ПЗК на горелке №6 | АИР-20/М2/-/Н/-/ДИ/130/-/-/М20/11N/ А3/t4070/С2/C05/ 0…100кПа/42/20 КНК Ni/-/ IP66/-/-/-/-/-/-/-/-/ГП/ТУ/ЭП | Элемер | 0 | 100 | кПа |  |  |  | 59675 | 2024-05-15
g3P071 | Датчик давления газа между ПЗК на горелке №7 | АИР-20/М2/-/Н/-/ДИ/130/-/-/М20/11N/ А3/t4070/С2/C05/ 0…100кПа/42/20 КНК Ni/-/ IP66/-/-/-/-/-/-/-/-/ГП/ТУ/ЭП | Элемер | 0 | 100 | кПа |  |  |  | 59675 | 2024-05-15
g3P081 | Датчик давления газа между ПЗК на горелке №8 | АИР-20/М2/-/Н/-/ДИ/130/-/-/М20/11N/ А3/t4070/С2/C05/ 0…100кПа/42/20 КНК Ni/-/ IP66/-/-/-/-/-/-/-/-/ГП/ТУ/ЭП | Элемер | 0 | 100 | кПа |  |  |  | 59675 | 2024-05-15
g3P091 | Датчик давления газа между ПЗК на горелке №9 | АИР-20/М2/-/Н/-/ДИ/130/-/-/М20/11N/ А3/t4070/С2/C05/ 0…100кПа/42/20 КНК Ni/-/ IP66/-/-/-/-/-/-/-/-/ГП/ТУ/ЭП | Элемер | 0 | 100 | кПа |  |  |  | 59675 | 2024-05-15
g3P101 | Датчик давления газа между ПЗК на горелке №10 | АИР-20/М2/-/Н/-/ДИ/130/-/-/М20/11N/ А3/t4070/С2/C05/ 0…100кПа/42/20 КНК Ni/-/ IP66/-/-/-/-/-/-/-/-/ГП/ТУ/ЭП | Элемер | 0 | 100 | кПа |  |  |  | 59675 | 2024-05-15
g3P111 | Датчик давления газа между ПЗК на горелке №11 | АИР-20/М2/-/Н/-/ДИ/130/-/-/М20/11N/ А3/t4070/С2/C05/ 0…100кПа/42/20 КНК Ni/-/ IP66/-/-/-/-/-/-/-/-/ГП/ТУ/ЭП | Элемер | 0 | 100 | кПа |  |  |  | 59675 | 2024-05-15
g3P121 | Датчик давления газа между ПЗК на горелке №12 | АИР-20/М2/-/Н/-/ДИ/130/-/-/М20/11N/ А3/t4070/С2/C05/ 0…100кПа/42/20 КНК Ni/-/ IP66/-/-/-/-/-/-/-/-/ГП/ТУ/ЭП | Элемер | 0 | 100 | кПа |  |  |  | 59675 | 2024-05-15
g3P131 | Датчик давления газа между ПЗК на горелке №13 | АИР-20/М2/-/Н/-/ДИ/130/-/-/М20/11N/ А3/t4070/С2/C05/ 0…100кПа/42/20 КНК Ni/-/ IP66/-/-/-/-/-/-/-/-/ГП/ТУ/ЭП | Элемер | 0 | 100 | кПа |  |  |  | 59675 | 2024-05-15
g3P141 | Датчик давления газа между ПЗК на горелке №14 | АИР-20/М2/-/Н/-/ДИ/130/-/-/М20/11N/ А3/t4070/С2/C05/ 0…100кПа/42/20 КНК Ni/-/ IP66/-/-/-/-/-/-/-/-/ГП/ТУ/ЭП | Элемер | 0 | 100 | кПа |  |  |  | 59675 | 2024-05-15
g3P151 | Датчик давления газа между ПЗК на горелке №15 | АИР-20/М2/-/Н/-/ДИ/130/-/-/М20/11N/ А3/t4070/С2/C05/ 0…100кПа/42/20 КНК Ni/-/ IP66/-/-/-/-/-/-/-/-/ГП/ТУ/ЭП | Элемер | 0 | 100 | кПа |  |  |  | 59675 | 2024-05-15
g3P161 | Датчик давления газа между ПЗК на горелке №16 | АИР-20/М2/-/Н/-/ДИ/130/-/-/М20/11N/ А3/t4070/С2/C05/ 0…100кПа/42/20 КНК Ni/-/ IP66/-/-/-/-/-/-/-/-/ГП/ТУ/ЭП | Элемер | 0 | 100 | кПа |  |  |  | 59675 | 2024-05-15
g3P171 | Датчик давления газа между ПЗК на горелке №17 | АИР-20/М2/-/Н/-/ДИ/130/-/-/М20/11N/ А3/t4070/С2/C05/ 0…100кПа/42/20 КНК Ni/-/ IP66/-/-/-/-/-/-/-/-/ГП/ТУ/ЭП | Элемер | 0 | 100 | кПа |  |  |  | 59675 | 2024-05-15
g3P181 | Датчик давления газа между ПЗК на горелке №18 | АИР-20/М2/-/Н/-/ДИ/130/-/-/М20/11N/ А3/t4070/С2/C05/ 0…100кПа/42/20 КНК Ni/-/ IP66/-/-/-/-/-/-/-/-/ГП/ТУ/ЭП | Элемер | 0 | 100 | кПа |  |  |  | 59675 | 2024-05-15
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
а3Pi091 | Манометр давления воздуха перед горелкой №9 | КМ22Р(0-2,5кПа)М20х1,5.1,5 | Росма | 0 | 2.5 | кПа |  |  |  | 4070 | 2024-05-15
а3Pi101 | Манометр давления воздуха перед горелкой №10 | КМ22Р(0-2,5кПа)М20х1,5.1,5 | Росма | 0 | 2.5 | кПа |  |  |  | 4070 | 2024-05-15
а3Pi111 | Манометр давления воздуха перед горелкой №11 | КМ22Р(0-2,5кПа)М20х1,5.1,5 | Росма | 0 | 2.5 | кПа |  |  |  | 4070 | 2024-05-15
а3Pi121 | Манометр давления воздуха перед горелкой №12 | КМ22Р(0-2,5кПа)М20х1,5.1,5 | Росма | 0 | 2.5 | кПа |  |  |  | 4070 | 2024-05-15
а3Pi131 | Манометр давления воздуха перед горелкой №13 | КМ22Р(0-2,5кПа)М20х1,5.1,5 | Росма | 0 | 2.5 | кПа |  |  |  | 4070 | 2024-05-15
а3Pi141 | Манометр давления воздуха перед горелкой №14 | КМ22Р(0-2,5кПа)М20х1,5.1,5 | Росма | 0 | 2.5 | кПа |  |  |  | 4070 | 2024-05-15
а3Pi151 | Манометр давления воздуха перед горелкой №15 | КМ22Р(0-2,5кПа)М20х1,5.1,5 | Росма | 0 | 2.5 | кПа |  |  |  | 4070 | 2024-05-15
а3Pi161 | Манометр давления воздуха перед горелкой №16 | КМ22Р(0-2,5кПа)М20х1,5.1,5 | Росма | 0 | 2.5 | кПа |  |  |  | 4070 | 2024-05-15
а3Pi171 | Манометр давления воздуха перед горелкой №17 | КМ22Р(0-2,5кПа)М20х1,5.1,5 | Росма | 0 | 2.5 | кПа |  |  |  | 4070 | 2024-05-15
а3Pi181 | Манометр давления воздуха перед горелкой №18 | КМ22Р(0-2,5кПа)М20х1,5.1,5 | Росма | 0 | 2.5 | кПа |  |  |  | 4070 | 2024-05-15
а3Pi191 | Манометр давления воздуха перед горелкой №19 | КМ22Р(0-2,5кПа)М20х1,5.1,5 | Росма | 0 | 2.5 | кПа |  |  |  | 4070 | 2024-05-15
а3Pi201 | Манометр давления воздуха перед горелкой №20 | КМ22Р(0-2,5кПа)М20х1,5.1,5 | Росма | 0 | 2.5 | кПа |  |  |  | 4070 | 2024-05-15
g3P001 | Датчик давления газа на входе в котел | АИР-20/М2/-/Н/-/ДИ/130/-/-/М20/11N/ А3/t4070/С2/C05/ 0…100кПа/42/20 КНК Ni/-/ IP66/-/-/-/-/-/-/-/-/ГП/ТУ/ЭП | Элемер | 0 | 100 | кПа |  |  |  | 59675 | 2024-05-15
g3Pi001 | Манометр давления газа на входе в котел | ТМ-510Р.00(0-0,1МПа)М20х1,5.1,5 | Росма | 0 | 100 | кПа |  |  |  | 955 | 2024-05-15
g3dP001 | Датчик перепада давления газа на входе в котел (расход) | АИР-20/М2/-/Н/-/ДД/420/-/-/-/11V/А3/t4070/С2/C05/ 0…10кПа/ 16МПа/42/20 КНК Ni/-/ IP66/-/-/КР3/-/Y(C32)/-/-/-/ ГП/ТУ/ЭП | Элемер | 0 | 10 | кПа |  |  |  | 82620 | 2024-05-15
g3T001 | Датчик температуры газа в коллекторе | ТПУ-205/-/ТС-1088/1БГ/АГ10/20 КНК Ni/t1070C3/Pt100/-50…100/320/10/0,5/ ГП/ТУ/ЭП | Элемер | -50 | 100 | ℃ |  |  |  | 15785 | 2024-05-15
g3Ti001 | Термометр температуры газа в коллекторе | БТ52.211(-30...+70С)G1/2.300.1,5 | Росма | -30 | 70 | ℃ |  |  |  | 2250 | 2024-05-15
g3Pi002 | Манометр давления газа в коллекторе | ТМ-510Р.00(0-0,1МПа)М20х1,5.1,5 | Росма | 0 | 100 | кПа |  |  |  | 955 | 2024-05-15
g3P002 | Датчик давления газа в коллекторе | АИР-20/М2/-/Н/-/ДИ/130/-/-/М20/11N/ А3/t4070/С2/C05/ 0…100кПа/42/20 КНК Ni/-/ IP66/-/-/-/-/-/-/-/-/ГП/ТУ/ЭП | Элемер | 0 | 100 | кПа |  |  |  | 59675 | 2024-05-15
g3P003 | Датчик давления газа в коллекторе дублирующий №1 | АИР-20/М2/-/Н/-/ДИ/130/-/-/М20/11N/ А3/t4070/С2/C05/ 0…100кПа/42/20 КНК Ni/-/ IP66/-/-/-/-/-/-/-/-/ГП/ТУ/ЭП | Элемер | 0 | 100 | кПа |  |  |  | 59675 | 2024-05-15
g3P004 | Датчик давления газа в коллекторе дублирующий №2 | АИР-20/М2/-/Н/-/ДИ/130/-/-/М20/11N/ А3/t4070/С2/C05/ 0…100кПа/42/20 КНК Ni/-/ IP66/-/-/-/-/-/-/-/-/ГП/ТУ/ЭП | Элемер | 0 | 100 | кПа |  |  |  | 59675 | 2024-05-15
w3T001 | Датчик температуры теплоносителя на входе в котел | ТПУ-205/-/ТС-1088/1БГ/АГ10/20 КНК Ni/t1070C3/Pt100/0…200/400/10/0,5/ ГП/ТУ/ЭП | Элемер | 0 | 200 | ℃ |  |  |  | 16805 | 2024-05-15
w3Ti001 | Термометр температуры теплоносителя на входе в котел | БТ52.211(0-250С)G1/2.300.1,5 | Росма | 0 | 250 | ℃ |  |  |  | 2250 | 2024-05-15
w3Pi001 | Манометр давления теплоносителя на входе в котел | ТМ610Р.00(0-4,0мПаМ20х1,5.1,5 | Росма | 0 | 4 | Мпа |  |  |  | 1510 | 2024-05-15
w3P001 | Датчик давления теплоносителя на входе в котел | АИР-20/М2/-/Н/-/ДИ/170/-/-/М20/11N/ А3/t4070/ С2/C05/ 0…2,5МПа/-/42/20 КНК Ni/-/ IP66/-/-/-/Y(Е22)/-/-/-/-/ГП/ТУ/ЭП | Элемер | 0 | 2.5 | Мпа |  |  |  | 61235 | 2024-05-15
w3dP001 | Датчик перепада давления теплоносителя после котла (расход) | АИР-20/М2/-/Н/-/ДД/440/-/-/-/11V/А3/t4070/С2/C05/ 0…63кПа/ 16МПа/42/20 КНК Ni/-/ IP66/-/-/КР3/-/Y(C32) /-/-/-/ ГП/ТУ/ЭП | Элемер | 0 | 63 | кПа |  |  |  | 82620 | 2024-05-15
w3dP002 | Датчик перепада давления теплоносителя после котла (расход) дублирующий №1 | АИР-20/М2/-/Н/-/ДД/440/-/-/-/11V/А3/t4070/С2/C05/ 0…63кПа/ 16МПа/42/20 КНК Ni/-/ IP66/-/-/КР3/-/Y(C32) /-/-/-/ ГП/ТУ/ЭП | Элемер | 0 | 63 | кПа |  |  |  | 82620 | 2024-05-15
w3dP003 | Датчик перепада давления теплоносителя после котла (расход) дублирующий №2 | АИР-20/М2/-/Н/-/ДД/440/-/-/-/11V/А3/t4070/С2/C05/ 0…63кПа/ 16МПа/42/20 КНК Ni/-/ IP66/-/-/КР3/-/Y(C32) /-/-/-/ ГП/ТУ/ЭП | Элемер | 0 | 63 | кПа |  |  |  | 82620 | 2024-05-15
w3Pi002 | Манометр давления теплоносителя после котла | ТМ610Р.00(0-4,0мПаМ20х1,5.1,5 | Росма | 0 | 4 | Мпа |  |  |  | 1510 | 2024-05-15
w3P002 | Датчик давления теплоносителя после котла | АИР-20/М2/-/Н/-/ДИ/170/-/-/М20/11N/ А3/t4070/ С2/C05/ 0…2,5МПа/-/42/20 КНК Ni/-/ IP66/-/-/-/Y(Е22)/-/-/-/-/ГП/ТУ/ЭП | Элемер | 0 | 2.5 | Мпа |  |  |  | 61235 | 2024-05-15
w3P003 | Датчик давления теплоносителя после котла дублирующий №1 | АИР-20/М2/-/Н/-/ДИ/170/-/-/М20/11N/ А3/t4070/ С2/C05/ 0…2,5МПа/-/42/20 КНК Ni/-/ IP66/-/-/-/Y(Е22)/-/-/-/-/ГП/ТУ/ЭП | Элемер | 0 | 2.5 | Мпа |  |  |  | 61235 | 2024-05-15
w3P004 | Датчик давления теплоносителя после котла дублирующий №2 | АИР-20/М2/-/Н/-/ДИ/170/-/-/М20/11N/ А3/t4070/ С2/C05/ 0…2,5МПа/-/42/20 КНК Ni/-/ IP66/-/-/-/Y(Е22)/-/-/-/-/ГП/ТУ/ЭП | Элемер | 0 | 2.5 | Мпа |  |  |  | 61235 | 2024-05-15
w3Ti002 | Термометр температуры теплоносителя после котла | БТ52.211(0-250С)G1/2.300.1,5 | Росма | 0 | 250 | ℃ |  |  |  | 2250 | 2024-05-15
w3T002 | Датчик температуры теплоносителя после котла | ТПУ-205/-/ТС-1088/1БГ/АГ10/20 КНК Ni/t1070C3/Pt100/0…200/400/10/0,5/ ГП/ТУ/ЭП | Элемер | 0 | 200 | ℃ |  |  |  | 16805 | 2024-05-15
w3T003 | Датчик температуры теплоносителя после котла дублирующий №1 | ТПУ-205/-/ТС-1088/1БГ/АГ10/20 КНК Ni/t1070C3/Pt100/0…200/400/10/0,5/ ГП/ТУ/ЭП | Элемер | 0 | 200 | ℃ |  |  |  | 16805 | 2024-05-15
w3T004 | Датчик температуры теплоносителя после котла дублирующий №2 | ТПУ-205/-/ТС-1088/1БГ/АГ10/20 КНК Ni/t1070C3/Pt100/0…200/400/10/0,5/ ГП/ТУ/ЭП | Элемер | 0 | 200 | ℃ |  |  |  | 16805 | 2024-05-15
f3Pi001 | Манометр разрежения в топке котла | КМВ22Р(-1...1,5кПа)М20х1,5 | Росма | -1 | 1.5 | кПа |  |  |  | 4070 | 2024-05-15
f3P001 | Датчик разрежения в топке котла | АИР-20/М2/-/Н/-/ДИВ/310/-/-/М20/ 11N/ А3/t4070/С2/ C05/-0,2…0,2кПа/-/42/ 20 КНК Ni/-/ IP66/-/-/-/-/-/-/-/-/ГП/ТУ/ЭП | Элемер | -0.2 | 0.2 | кПа |  |  |  | 73975 | 2024-05-15
f3P002 | Датчик разрежения в топке котла дублирующий №1 | АИР-20/М2/-/Н/-/ДИВ/310/-/-/М20/ 11N/ А3/t4070/С2/ C05/-0,2…0,2кПа/-/42/ 20 КНК Ni/-/ IP66/-/-/-/-/-/-/-/-/ГП/ТУ/ЭП | Элемер | -0.2 | 0.2 | кПа |  |  |  | 73975 | 2024-05-15
f3P003 | Датчик разрежения в топке котла дублирующий №2 | АИР-20/М2/-/Н/-/ДИВ/310/-/-/М20/ 11N/ А3/t4070/С2/ C05/-0,2…0,2кПа/-/42/ 20 КНК Ni/-/ IP66/-/-/-/-/-/-/-/-/ГП/ТУ/ЭП | Элемер | -0.2 | 0.2 | кПа |  |  |  | 73975 | 2024-05-15
f3T001 | Датчик температуры дымовых газов | ТПУ-205/-/ТС-1088/1БГ/АГ10/20 КНК Ni/t1070C3/Pt100/0…400/800/10/0,5/ ГП/ТУ/ЭП | Элемер | 0 | 400 | ℃ |  |  |  | 19395 | 2024-05-15
f3Ti001 | Термометр температуры дымовых газов | БТ52.212(0-450С)G1/2.300.1,5 | Росма | 0 | 450 | ℃ |  |  |  | 2250 | 2024-05-15
f3X001 | Газоанализатор дымовых газов | ИКТС-11.1 | ЗАО "Проманалитприбор"
b3X001 | Датчик интенсивности пламени | ФДСА-03М-01-010 | Прома |  |  |  |  |  |  | 84355 | 2024-05-15 |  |  |  | 4.8 | 24=
b3X002 | Датчик интенсивности пламени | ФДСА-03М-01-010 | Прома |  |  |  |  |  |  | 84355 | 2024-05-15 |  |  |  | 4.8 | 24=
b3X003 | Датчик интенсивности пламени | ФДСА-03М-01-010 | Прома |  |  |  |  |  |  | 84355 | 2024-05-15 |  |  |  | 4.8 | 24=
b3X004 | Датчик интенсивности пламени | ФДСА-03М-01-010 | Прома |  |  |  |  |  |  | 84355 | 2024-05-15 |  |  |  | 4.8 | 24=
b3X005 | Датчик интенсивности пламени | ФДСА-03М-01-010 | Прома |  |  |  |  |  |  | 84355 | 2024-05-15 |  |  |  | 4.8 | 24=
b3X006 | Датчик интенсивности пламени | ФДСА-03М-01-010 | Прома |  |  |  |  |  |  | 84355 | 2024-05-15 |  |  |  | 4.8 | 24=
b3X042 | Датчик наличия факела запальника горелки №4 | ДПЗ-01А/220 | ООО "Общемаш" |  |  |  |  |  |  | 12415 | 2024-05-22
b3X043 | Датчик наличия факела горелки №4 | ФДСА-03М-01 | Прома |  |  |  |  |  |  | 84355 | 2024-05-15
b3X102 | Датчик наличия факела запальника горелки №10 | ДПЗ-01А/220 | ООО "Общемаш" |  |  |  |  |  |  | 12415 | 2024-05-22
b3X103 | Датчик наличия факела горелки №10 | ФДСА-03М-01 | Прома |  |  |  |  |  |  | 84355 | 2024-05-15
b3X182 | Датчик наличия факела запальника горелки №18 | ДПЗ-01А/220 | ООО "Общемаш" |  |  |  |  |  |  | 12415 | 2024-05-22
b3X183 | Датчик наличия факела горелки №18 | ФДСА-03М-01 | Прома |  |  |  |  |  |  | 84355 | 2024-05-15
b3X032 | Датчик наличия факела запальника горелки №3 | ДПЗ-01А/220 | ООО "Общемаш" |  |  |  |  |  |  | 12415 | 2024-05-22
b3X033 | Датчик наличия факела горелки №3 | ФДСА-03М-01 | Прома |  |  |  |  |  |  | 84355 | 2024-05-15
b3X112 | Датчик наличия факела запальника горелки №11 | ДПЗ-01А/220 | ООО "Общемаш" |  |  |  |  |  |  | 12415 | 2024-05-22
b3X113 | Датчик наличия факела горелки №11 | ФДСА-03М-01 | Прома |  |  |  |  |  |  | 84355 | 2024-05-15
b3X172 | Датчик наличия факела запальника горелки №17 | ДПЗ-01А/220 | ООО "Общемаш" |  |  |  |  |  |  | 12415 | 2024-05-22
b3X173 | Датчик наличия факела горелки №17 | ФДСА-03М-01 | Прома |  |  |  |  |  |  | 84355 | 2024-05-15
а3СН001 | Датчик загазованности СН4 | ДАК-CH4-129 | Аналитприбор СПО |  |  |  |  |  |  | 84200 | 2024-05-15 |  |  |  | 3.5 | 24=
а3СН002 | Датчик загазованности СН4 | ДАК-CH4-129 | Аналитприбор СПО |  |  |  |  |  |  | 84200 | 2024-05-15 |  |  |  | 3.5 | 24=
а3СН003 | Датчик загазованности СН4 | ДАК-CH4-129 | Аналитприбор СПО |  |  |  |  |  |  | 84200 | 2024-05-15 |  |  |  | 3.5 | 24=
а3СН004 | Датчик загазованности СН4 | ДАК-CH4-129 | Аналитприбор СПО |  |  |  |  |  |  | 84200 | 2024-05-15 |  |  |  | 3.5 | 24=
а3СО001 | Датчик загазованности СО | ДАХ-М-05-CO-200 | Аналитприбор СПО |  |  |  |  |  |  | 97700 | 2024-05-15 |  |  |  | 2 | 24=
а3СО002 | Датчик загазованности СО | ДАХ-М-05-CO-200 | Аналитприбор СПО |  |  |  |  |  |  | 97700 | 2024-05-15 |  |  |  | 2 | 24=
а3СО003 | Датчик загазованности СО | ДАХ-М-05-CO-200 | Аналитприбор СПО |  |  |  |  |  |  | 97700 | 2024-05-15 |  |  |  | 2 | 24=
а3СО004 | Датчик загазованности СО | ДАХ-М-05-CO-200 | Аналитприбор СПО |  |  |  |  |  |  | 97700 | 2024-05-15 |  |  |  | 2 | 24=
g3V011 | Клапан ПЗК-1 на горелке №1 | ВН4Н-1П ст | СП "Термобрест" |  |  |  | 100 |  | 33.3
g3V021 | Клапан ПЗК-1 на горелке №2 | ВН4Н-1П ст | СП "Термобрест" |  |  |  | 100 |  | 33.3
g3V031 | Клапан ПЗК-1 на горелке №3 | ВН4Н-1П ст | СП "Термобрест" |  |  |  | 100 |  | 33.3
g3V041 | Клапан ПЗК-1 на горелке №4 | ВН4Н-1П ст | СП "Термобрест" |  |  |  | 100 |  | 33.3
g3V051 | Клапан ПЗК-1 на горелке №5 | ВН4Н-1П ст | СП "Термобрест" |  |  |  | 100 |  | 33.3
g3V061 | Клапан ПЗК-1 на горелке №6 | ВН4Н-1П ст | СП "Термобрест" |  |  |  | 100 |  | 33.3
g3V071 | Клапан ПЗК-1 на горелке №7 | ВН4Н-1П ст | СП "Термобрест" |  |  |  | 100 |  | 33.3
g3V081 | Клапан ПЗК-1 на горелке №8 | ВН4Н-1П ст | СП "Термобрест" |  |  |  | 100 |  | 33.3
g3V091 | Клапан ПЗК-1 на горелке №9 | ВН4Н-1П ст | СП "Термобрест" |  |  |  | 100 |  | 33.3
g3V101 | Клапан ПЗК-1 на горелке №10 | ВН4Н-1П ст | СП "Термобрест" |  |  |  | 100 |  | 33.3
g3V111 | Клапан ПЗК-1 на горелке №11 | ВН4Н-1П ст | СП "Термобрест" |  |  |  | 100 |  | 33.3
g3V121 | Клапан ПЗК-1 на горелке №12 | ВН4Н-1П ст | СП "Термобрест" |  |  |  | 100 |  | 33.3
g3V131 | Клапан ПЗК-1 на горелке №13 | ВН4Н-1П ст | СП "Термобрест" |  |  |  | 100 |  | 33.3
g3V141 | Клапан ПЗК-1 на горелке №14 | ВН4Н-1П ст | СП "Термобрест" |  |  |  | 100 |  | 33.3
g3V151 | Клапан ПЗК-1 на горелке №15 | ВН4Н-1П ст | СП "Термобрест" |  |  |  | 100 |  | 33.3
g3V161 | Клапан ПЗК-1 на горелке №16 | ВН4Н-1П ст | СП "Термобрест" |  |  |  | 100 |  | 33.3
g3V171 | Клапан ПЗК-1 на горелке №17 | ВН4Н-1П ст | СП "Термобрест" |  |  |  | 100 |  | 33.3
g3V181 | Клапан ПЗК-1 на горелке №18 | ВН4Н-1П ст | СП "Термобрест" |  |  |  | 100 |  | 33.3
g3V191 | Клапан ПЗК-1 на горелке №19 | ВН4Н-1П ст | СП "Термобрест" |  |  |  | 100 |  | 33.3
g3V201 | Клапан ПЗК-1 на горелке №20 | ВН4Н-1П ст | СП "Термобрест" |  |  |  | 100 |  | 33.3
g3V012 | Клапан ПЗК-2 на горелке №1 | ВН4Н-1П ст | СП "Термобрест" |  |  |  | 100 |  | 33.3
g3V022 | Клапан ПЗК-2 на горелке №2 | ВН4Н-1П ст | СП "Термобрест" |  |  |  | 100 |  | 33.3
g3V032 | Клапан ПЗК-2 на горелке №3 | ВН4Н-1П ст | СП "Термобрест" |  |  |  | 100 |  | 33.3
g3V042 | Клапан ПЗК-2 на горелке №4 | ВН4Н-1П ст | СП "Термобрест" |  |  |  | 100 |  | 33.3
g3V052 | Клапан ПЗК-2 на горелке №5 | ВН4Н-1П ст | СП "Термобрест" |  |  |  | 100 |  | 33.3
g3V062 | Клапан ПЗК-2 на горелке №6 | ВН4Н-1П ст | СП "Термобрест" |  |  |  | 100 |  | 33.3
g3V072 | Клапан ПЗК-2 на горелке №7 | ВН4Н-1П ст | СП "Термобрест" |  |  |  | 100 |  | 33.3
g3V082 | Клапан ПЗК-2 на горелке №8 | ВН4Н-1П ст | СП "Термобрест" |  |  |  | 100 |  | 33.3
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
b3X031 | Трансформатор запальника горелки №3 | ИВН-01Е | ООО "Общемаш" |  |  |  |  |  |  | 10505 | 2024-05-22
g3V114 | Клапан запальника горелки №11 | ВН 3/4 Н-4П ст. | СП "Термобрест" |  |  |  | 20 |  | 2.8
b3X111 | Трансформатор запальника горелки №11 | ИВН-01Е | ООО "Общемаш" |  |  |  |  |  |  | 10505 | 2024-05-22
g3V174 | Клапан запальника горелки №17 | ВН 3/4 Н-4П ст. | СП "Термобрест" |  |  |  | 20 |  | 2.8
b3X171 | Трансформатор запальника горелки №17 | ИВН-01Е | ООО "Общемаш" |  |  |  |  |  |  | 10505 | 2024-05-22
g3V001 | Клапан продувки | ВН2Н-1П ст. | СП "Термобрест" |  |  |  | 50 |  | 12.8
g3V002 | Клапан продувки | ВН2Н-1П ст. | СП "Термобрест" |  |  |  | 50 |  | 12.8
g3sM001 | Регулятор давления газа в коллекторе | ЗР12-6 В ПР. ст. | СП "Термобрест" |  |  |  | 300 |  | 80
g3M001 | Задвижка газовая на входе в котел | 30с 941нж | ЗАО Южноураларматура, г.Миасс |  |  |  | 400 |  | 655
w3M001 | Задвижка теплоносителя на входе в котел |  | существующий
w3M002 | Задвижка теплоносителя после котла |  | существующий
f3sM001 | Регулятор разрежения | МЭО-250/63-0,25У-99 | ООО «ПКП «Чебоксарыэлектропривод» |  |  |  |  |  |  | 53667 | 2024-05-23
f3sM002 | Регулятор разрежения | МЭО-250/63-0,25У-99 | ООО «ПКП «Чебоксарыэлектропривод» |  |  |  |  |  |  | 53667 | 2024-05-23
f3sM003 | Регулятор разрежения | МЭО-250/63-0,25У-99 | ООО «ПКП «Чебоксарыэлектропривод» |  |  |  |  |  |  | 53667 | 2024-05-23
b3X034 | Горелка запальная газовая | ЭИВ-01-И-1500 | ООО "ЭТАЛОНПРИБОР" |  |  |  |  |  |  | 18300 | 2024-05-16
b3X044 | Горелка запальная газовая | ЭИВ-01-И-1500 | ООО "ЭТАЛОНПРИБОР" |  |  |  |  |  |  | 18300 | 2024-05-16
b3X104 | Горелка запальная газовая | ЭИВ-01-И-1500 | ООО "ЭТАЛОНПРИБОР" |  |  |  |  |  |  | 18300 | 2024-05-16
b3X114 | Горелка запальная газовая | ЭИВ-01-И-1500 | ООО "ЭТАЛОНПРИБОР" |  |  |  |  |  |  | 18300 | 2024-05-16
b3X174 | Горелка запальная газовая | ЭИВ-01-И-1500 | ООО "ЭТАЛОНПРИБОР" |  |  |  |  |  |  | 18300 | 2024-05-16
b3X184 | Горелка запальная газовая | ЭИВ-01-И-1500 | ООО "ЭТАЛОНПРИБОР" |  |  |  |  |  |  | 18300 | 2024-05-16
x3OS001 | Арм оператора | Scada-система IntraSCADa | Интра, Чебоксары
 | Стол оператора | 7CO3.624.000 (1200мм) | ООО «ПРОЕКТ МЕТАЛЛ»
x3CP001 | Шкаф управления котлом | Контроллеры и модули ввода-вывода REGUL R500 | ProsoftSystems, Екатеринбург
x3CP002 | Шкаф управления горелками | Модули ввода-вывода REGUL R500 | ProsoftSystems, Екатеринбург
x3CP003 | Шкаф управления горелками | Модули ввода-вывода REGUL R500 | ProsoftSystems, Екатеринбург
x3CP004 | Шкаф управления горелками | Модули ввода-вывода REGUL R500 | ProsoftSystems, Екатеринбург
x3CP005 | Шкаф управления горелками | Модули ввода-вывода REGUL R500 | ProsoftSystems, Екатеринбург
x3CP006 | Шкаф управления горелками | Модули ввода-вывода REGUL R500 | ProsoftSystems, Екатеринбург
x3PP001 | Шкаф питания
 | Иверторная система | DC/AC-220/220B-10000BA-6U-23 | «Форпост»
 | Байпас | ВР-220/220В-10000ВА-3U | «Форпост»
 |  |  |  |  |  |  |  |  |  | 7937166

Sheet: 240517
шифр | назначение | наименование | производитель | предел от | предел до | ед.изм | Ду | эн.потр | масса | цена без НДС | дата цены | схема эл. | схема монт. | параметры схем
g3P011 | Датчик давления газа между ПЗК на горелке №1 | АИР-20/М2/-/Н/-/ДИ/130/-/-/М20/11N/ А3/t4070/С2/C05/ 0…100кПа/42/20 КНК Ni/-/ IP66/-/-/-/-/-/-/-/-/ГП/ТУ/ЭП | Элемер | 0 | 100 | кПа |  |  |  | 59675 | 2024-05-15
g3P021 | Датчик давления газа между ПЗК на горелке №2 | АИР-20/М2/-/Н/-/ДИ/130/-/-/М20/11N/ А3/t4070/С2/C05/ 0…100кПа/42/20 КНК Ni/-/ IP66/-/-/-/-/-/-/-/-/ГП/ТУ/ЭП | Элемер | 0 | 100 | кПа |  |  |  | 59675 | 2024-05-15
g3P031 | Датчик давления газа между ПЗК на горелке №3 | АИР-20/М2/-/Н/-/ДИ/130/-/-/М20/11N/ А3/t4070/С2/C05/ 0…100кПа/42/20 КНК Ni/-/ IP66/-/-/-/-/-/-/-/-/ГП/ТУ/ЭП | Элемер | 0 | 100 | кПа |  |  |  | 59675 | 2024-05-15
g3P041 | Датчик давления газа между ПЗК на горелке №4 | АИР-20/М2/-/Н/-/ДИ/130/-/-/М20/11N/ А3/t4070/С2/C05/ 0…100кПа/42/20 КНК Ni/-/ IP66/-/-/-/-/-/-/-/-/ГП/ТУ/ЭП | Элемер | 0 | 100 | кПа |  |  |  | 59675 | 2024-05-15
g3P051 | Датчик давления газа между ПЗК на горелке №5 | АИР-20/М2/-/Н/-/ДИ/130/-/-/М20/11N/ А3/t4070/С2/C05/ 0…100кПа/42/20 КНК Ni/-/ IP66/-/-/-/-/-/-/-/-/ГП/ТУ/ЭП | Элемер | 0 | 100 | кПа |  |  |  | 59675 | 2024-05-15
g3P061 | Датчик давления газа между ПЗК на горелке №6 | АИР-20/М2/-/Н/-/ДИ/130/-/-/М20/11N/ А3/t4070/С2/C05/ 0…100кПа/42/20 КНК Ni/-/ IP66/-/-/-/-/-/-/-/-/ГП/ТУ/ЭП | Элемер | 0 | 100 | кПа |  |  |  | 59675 | 2024-05-15
g3P071 | Датчик давления газа между ПЗК на горелке №7 | АИР-20/М2/-/Н/-/ДИ/130/-/-/М20/11N/ А3/t4070/С2/C05/ 0…100кПа/42/20 КНК Ni/-/ IP66/-/-/-/-/-/-/-/-/ГП/ТУ/ЭП | Элемер | 0 | 100 | кПа |  |  |  | 59675 | 2024-05-15
g3P081 | Датчик давления газа между ПЗК на горелке №8 | АИР-20/М2/-/Н/-/ДИ/130/-/-/М20/11N/ А3/t4070/С2/C05/ 0…100кПа/42/20 КНК Ni/-/ IP66/-/-/-/-/-/-/-/-/ГП/ТУ/ЭП | Элемер | 0 | 100 | кПа |  |  |  | 59675 | 2024-05-15
g3P091 | Датчик давления газа между ПЗК на горелке №9 | АИР-20/М2/-/Н/-/ДИ/130/-/-/М20/11N/ А3/t4070/С2/C05/ 0…100кПа/42/20 КНК Ni/-/ IP66/-/-/-/-/-/-/-/-/ГП/ТУ/ЭП | Элемер | 0 | 100 | кПа |  |  |  | 59675 | 2024-05-15
g3P101 | Датчик давления газа между ПЗК на горелке №10 | АИР-20/М2/-/Н/-/ДИ/130/-/-/М20/11N/ А3/t4070/С2/C05/ 0…100кПа/42/20 КНК Ni/-/ IP66/-/-/-/-/-/-/-/-/ГП/ТУ/ЭП | Элемер | 0 | 100 | кПа |  |  |  | 59675 | 2024-05-15
g3P111 | Датчик давления газа между ПЗК на горелке №11 | АИР-20/М2/-/Н/-/ДИ/130/-/-/М20/11N/ А3/t4070/С2/C05/ 0…100кПа/42/20 КНК Ni/-/ IP66/-/-/-/-/-/-/-/-/ГП/ТУ/ЭП | Элемер | 0 | 100 | кПа |  |  |  | 59675 | 2024-05-15
g3P121 | Датчик давления газа между ПЗК на горелке №12 | АИР-20/М2/-/Н/-/ДИ/130/-/-/М20/11N/ А3/t4070/С2/C05/ 0…100кПа/42/20 КНК Ni/-/ IP66/-/-/-/-/-/-/-/-/ГП/ТУ/ЭП | Элемер | 0 | 100 | кПа |  |  |  | 59675 | 2024-05-15
g3P131 | Датчик давления газа между ПЗК на горелке №13 | АИР-20/М2/-/Н/-/ДИ/130/-/-/М20/11N/ А3/t4070/С2/C05/ 0…100кПа/42/20 КНК Ni/-/ IP66/-/-/-/-/-/-/-/-/ГП/ТУ/ЭП | Элемер | 0 | 100 | кПа |  |  |  | 59675 | 2024-05-15
g3P141 | Датчик давления газа между ПЗК на горелке №14 | АИР-20/М2/-/Н/-/ДИ/130/-/-/М20/11N/ А3/t4070/С2/C05/ 0…100кПа/42/20 КНК Ni/-/ IP66/-/-/-/-/-/-/-/-/ГП/ТУ/ЭП | Элемер | 0 | 100 | кПа |  |  |  | 59675 | 2024-05-15
g3P151 | Датчик давления газа между ПЗК на горелке №15 | АИР-20/М2/-/Н/-/ДИ/130/-/-/М20/11N/ А3/t4070/С2/C05/ 0…100кПа/42/20 КНК Ni/-/ IP66/-/-/-/-/-/-/-/-/ГП/ТУ/ЭП | Элемер | 0 | 100 | кПа |  |  |  | 59675 | 2024-05-15
g3P161 | Датчик давления газа между ПЗК на горелке №16 | АИР-20/М2/-/Н/-/ДИ/130/-/-/М20/11N/ А3/t4070/С2/C05/ 0…100кПа/42/20 КНК Ni/-/ IP66/-/-/-/-/-/-/-/-/ГП/ТУ/ЭП | Элемер | 0 | 100 | кПа |  |  |  | 59675 | 2024-05-15
g3P171 | Датчик давления газа между ПЗК на горелке №17 | АИР-20/М2/-/Н/-/ДИ/130/-/-/М20/11N/ А3/t4070/С2/C05/ 0…100кПа/42/20 КНК Ni/-/ IP66/-/-/-/-/-/-/-/-/ГП/ТУ/ЭП | Элемер | 0 | 100 | кПа |  |  |  | 59675 | 2024-05-15
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
