nppesnteam/370-24_Balakovo_PTVM180_-3-4/АК3/Компл_бак.xlsx

г.Балаково Комплектация шкафов полная 9шкафов + Пульт АРМ+ЗИП
№ п/п | Наименование изделия | Тип изделия | Производитель | Ед. изм | ЗИП | ШАВР | ШПДВ1 | ШПДВ2 | ШУК | ШУГ1 | ШУГ2 | ШУГ3 | ШУГ4 | ШУГ5 | АРМ | итого надо | итого заказ | наличие на складе | УрЦА цена 1шт | общая стоимость шкафов | общая стоимость заказа
1 | 2 | 3 | 4 | 5 | 16 | 6 | 13 | 14 | 7 | 8 | 9 | 10 | 11 | 12 | 15 | 17 | 18 | 19 | 21 | 22 | 23
 | Напольный сборный шкаф RAM BLOCK серии СQE в составе:
1 | Комплект, крыша и основание, для шкафов CQE, 800 x 600 мм | R5KTB86 | DKC | комп. |  | 1 | 1 | 1 | 1 | 1 | 1 | 1 | 1 | 1 |  | 0 |  |  | 42091 | 0 | 0
2 | Стойки вертикальные, В=2000мм, без дополнительных креплений, 4шт RAL7035 | R5KMN20 | DKC | комп. |  | 1 | 1 | 1 | 1 | 1 | 1 | 1 | 1 | 1 |  | 0 |  |  | 16408 | 0 | 0
3 | Дверь сплошная для шкафов CQE/DAE ВхШ 2000х800 мм | R5CPE2080 | DKC | шт. |  | 1 | 1 | 1 | 1 | 1 | 1 | 1 | 1 | 1 |  | 0 |  |  | 23146 | 0 | 0
4 | Панель задняя, для шкафов DAE/CQE, 2000 x 800 мм | R5CRE2080 | DKC | шт. |  | 1 | 1 | 1 | 1 | 1 | 1 | 1 | 1 | 1 |  | 0 |  |  | 11843 | 0 | 0
5 | Панели боковые, для шкафов CQE 2000 x 600мм, 1 упаковка - 2шт. | R5LE2062 | DKC | упак. |  | 1 | 1 | 1 | 1 | 1 | 1 | 1 | 1 | 1 |  | 0 |  |  | 16045 | 0 | 0
6 | Монтажная плата, для шкафов DAE/CQE 2000 x 800 мм | R5PCE2080 | DKC | шт. |  | 1 | 1 | 1 | 1 | 1 | 1 | 1 | 1 | 1 |  | 0 |  |  | 13780 | 0 | 0
7 | Комплект угловых элементов с пластиковыми заглушками, В =200 мм, 1 кмп =4 шт. | R5BP02 | DKC | комп. |  | 1 | 1 | 1 | 1 | 1 | 1 | 1 | 1 | 1 |  | 0 |  |  | 15442 | 0 | 0
8 | Комплект панелей цоколя, Ш/Г=800 мм, В=200 мм, 1 кмп = 2 шт. | R5NFP82 | DKC | комп. |  | 1 | 1 | 1 | 1 | 1 | 1 | 1 | 1 | 1 |  | 0 |  |  | 7550 | 0 | 0
9 | Комплект панелей цоколя, Ш/Г=600 мм, В=200 мм, 1 кмп = 2 шт. | R5NFP62 | DKC | комп. |  | 1 | 1 | 1 | 1 | 1 | 1 | 1 | 1 | 1 |  | 0 |  |  | 4854 | 0 | 0
 | Дополнительное оборудование: |  | DKC |  |  |  |  |  |  |  |  |  |  |  |  | 0 |  |  |  | 0 | 0
10 | Рейка боковая, широкая, для шкафов CQE глубиной 600 мм, 1 упаковка -4шт. | R5PDL600 | DKC | упак. |  | 1 | 1 | 1 |  |  |  |  |  |  |  | 0 |  |  | 9365 | 0 | 0
11 | Рейки поперечные, широкая, для шкафов CQE Ш=800мм, 1 упаковка - 4шт. | R5PDF800 | DKC | упак. |  | 1 |  |  |  |  |  |  |  |  |  | 0 |  |  | 12827 | 0 | 0
12 | Рейки вертикальные, широкая, для шкафов CQE В=2000мм, 1 упаковка - 2шт. | R5PDV20 | DKC | упак. |  | 1 | 1 | 1 |  |  |  |  |  |  |  | 0 |  |  | 16913 | 0 | 0
13 | Рейки боковые, для шкафов CQE глубиной 600мм, 1 упаковка - 4шт. | R5TLE600 | DKC | упак. |  | 1 |  |  |  |  |  |  |  |  |  | 0 |  |  | 4021 | 0 | 0
14 | Рейки боковые, специальная, для шкафов CQE глубиной 600мм, 1 упаковка - 4шт. | R5PLE600 | DKC | упак. |  |  |  |  |  |  |  |  |  |  |  | 0 |  |  | 6445 | 0 | 0
15 | Рейки поперечные, для шкафов CQE Ш=800мм, 1 упаковка - 4шт. | R5TFE800 | DKC | упак. |  |  |  |  |  |  |  |  |  |  |  | 0 |  |  | 7880 | 0 | 0
16 | Рейки для фиксации кабеля, для шкафов DAE/CQE Ш=800мм, 1 упаковка - 2шт. | R5PAC80 | DKC | упак. |  |  |  |  |  |  |  |  |  |  |  | 0 |  |  | 5830 | 0 | 0
17 | Рейки усиленная, для тяжёлого оборудования Ш=800мм, 1 упаковка - 2шт. | R5TTE800 | DKC | упак. |  |  |  |  |  |  |  |  |  |  |  | 0 |  |  | 3918 | 0 | 0
18 | Уплотнитель для ввода кабеля, для шкафов DAE/CQE шириной 800 мм | R5FPC800 | DKC | шт. |  | 1 | 1 | 1 | 1 | 1 | 1 | 1 | 1 | 1 |  | 0 |  |  | 4100 | 0 | 0
19 | Монтажная плата, промежуточная, для шкафов CQE высотой 2000 мм | R5PIE20 | DKC | шт. |  |  |  |  |  |  |  |  |  |  |  | 0 |  |  | 8622 | 0 | 0
20 | Дно сплошное, для шкафов DAE/CQE 800 x 600 мм | R5FUC86 | DKC | шт. |  |  |  |  |  |  |  |  |  |  |  | 0 |  |  | 7975 | 0 | 0
21 | Карман для документации, пластиковый | R5A32 | DKC | шт. |  | 1 | 1 | 1 | 1 | 1 | 1 | 1 | 1 | 1 |  | 0 |  |  | 1725 | 0 | 0
22 | Вентилятор с фильтром RV 100/105 м3/ч, 230 В, 205x205 мм | R5RV13230 | DKC | шт |  | 1 |  |  | 1 | 1 | 1 | 1 | 1 | 1 |  | 0 |  |  | 6780 | 0 | 0
23 | Вентиляционная решетка с фильтром RF 205x205 мм, IP54 | R5RF13 | DKC | шт |  | 1 |  |  | 1 | 1 | 1 | 1 | 1 | 1 |  | 0 |  |  | 1390 | 0 | 0
24 | Термостат с регулируемым диапазоном температуры 0…+60°C, NO-контакт | R5THV2 | DKC | шт |  | 1 |  |  | 1 | 1 | 1 | 1 | 1 | 1 |  | 0 |  |  | 1299 | 0 | 0
25 | Светильник светодиодный 450мм 4000K | ДПО-6Вт Т5i | JazzWay | шт. |  | 1 | 1 | 1 | 1 | 1 | 1 | 1 | 1 | 1 |  | 0 |  |  | 455 | 0 | 0
 | Электроустановочные изделия:
26 | Иверторная система DC/AC-220/220B-7500BA-3U-23 «Форпост» |  |  | шт. |  | 1 |  |  |  |  |  |  |  |  |  | 0 |  |  | 421728 | 0 | 0
27 | Байпас ВР-220/220В-10000ВА-3U «Форпост» |  |  | шт. |  | 1 |  |  |  |  |  |  |  |  |  | 0 |  |  | 101616 | 0 | 0
28 | Программируемое реле 8DI (220в); 6DO(но); Uпит 220в | ПР200-220.1.0.0 | ОВЕН | шт. |  | 1 |  |  |  |  |  |  |  |  |  | 0 |  |  | 10941 | 0 | 0
29 | Пускатель бесконтактный реверсивный | ПБР-3МК-4 380В | МАКС21 Чебоксары | шт. |  | 4 |  |  |  | 8 | 8 | 8 | 8 | 8 |  | 0 |  | 40шт со склада | 20000 | 0 | 0
30 | Выключатель автоматический ВА51-39-340010-500А-1600-690AC-УХЛ3-КЭАЗ | Артикул: 220859 | КЭАЗ | шт. |  |  | 1 | 1 |  |  |  |  |  |  |  | 0 |  |  | 36100 | 0 | 0
31 | Автоматический выключатель защиты двигателя YON DMP63RT с уставкой 40-50A 3P 50kA | Код: DMP63RT-0050 | DKC | шт. |  |  | 10 | 10 |  |  |  |  |  |  |  | 0 |  |  | 16800 | 0 | 0
32 | Автоматический выключатель Acti9 iK60N C 63A 3P 6кА | A9K24363 | Schneider Electric | шт. |  | 2 |  |  |  |  |  |  |  |  |  | 0 |  | 2шт со склада | 3900 | 0 | 0
33 | Автоматический выключатель 6А 3П хар-ка С | BA47-29-3С6-УХЛ3 | КЭАЗ | шт. |  | 2 |  |  |  |  |  |  |  |  |  | 0 |  |  | 400 | 0 | 0
34 | Автоматический выключатель 16А 2П хар-ка С | BA47-29-2С16-УХЛ3 | КЭАЗ | шт. |  | 1 |  |  |  |  |  |  |  |  |  | 0 |  |  | 580 | 0 | 0
35 | Автом. выкл. для =U C60H-DC 2П 16А C 500В DC | A9N61531 | SchneiderElectric | шт. |  | 1 |  |  |  |  |  |  |  |  |  | 0 |  |  | 12540 | 0 | 0
36 | Автоматический выключатель 10А 1П хар-ка С | BA47-29-1С10-УХЛ3 | КЭАЗ | шт. |  | 12 |  |  |  |  |  |  |  |  |  | 0 |  |  | 399 | 0 | 0
37 | Автоматический выключатель 6А 1П хар-ка С | BA47-29-1С6-УХЛ3 | КЭАЗ | шт. |  | 10 | 2 | 2 | 9 | 12 | 12 | 12 | 12 | 12 |  | 0 |  |  | 280 | 0 | 0
38 | Автомат защиты двигателя 3П; 5-8А; Iотс_104А | OptiStart MP-32T-8 Артикул 115745 | KEAZ Optima | шт. |  | 1 |  |  |  |  |  |  |  |  |  | 0 |  |  | 6980 | 0 | 0
39 | Автомат защиты двигателя 3П; 14-22А; Iотс_286А | OptiStart MP-32T-22 Артикул 115756 | KEAZ Optima | шт. |  | 2 |  |  |  |  |  |  |  |  |  | 0 |  |  | 7980 | 0 | 0
40 | Выключатель нагрузки (мини-рубильник) ВН-32 2P 63A TDM | SQ0211-0017 | TDM | шт. |  |  |  |  | 2 | 2 | 2 | 2 | 2 | 2 |  | 0 |  |  | 560 | 0 | 0
41 | Модульный переключатель трехпозиционный МП-63 2P 63А | SQ0224-0018 | TDM | шт. |  | 1 |  |  |  |  |  |  |  |  |  | 0 |  |  | 1800 | 0 | 0
42 | Модульный контактор YON MCE 4P 63A 4НО управляющее напряжение 240В 50Гц | Код: MCE-63-40-A240 | DKC | шт. |  |  | 10 | 10 |  |  |  |  |  |  |  | 0 |  |  | 3900 | 0 | 0
43 | Контактор 65А, кат. 220В, 3NO +(1NO, 1NC) | LC1E65M5 | ShnaiderElectric | шт. |  | 2 |  |  |  |  |  |  |  |  |  | 0 |  | 2шт со склада | 7070 | 0 | 0
44 | Контактор 32А; Uкат.230В; AC-3NO +(1NC) | LC1E3201M5 | Schneider Electric | шт. |  | 4 |  |  |  |  |  |  |  |  |  | 0 |  |  | 4380 | 0 | 0
45 | Контактор 12А; Uкат.230В; AC-3NO +(1NC) | LC1E1201M5 | Schneider Electric | шт. |  | 2 |  |  |  |  |  |  |  |  |  | 0 |  |  | 1650 | 0 | 0
46 | Контактор 6А; Uкат.230В; AC-3NO+(1NC) | LC1E0601M5 | Schneider Electric | шт. |  | 1 |  |  |  |  |  |  |  |  |  | 0 |  | 1шт со склада | 980 | 0 | 0
47 | Мех-ская блокировка для контакторов TESYS E 6 65 | LAEM1 | Schneider Electric | шт. |  | 4 |  |  |  |  |  |  |  |  |  | 0 |  |  | 1890 | 0 | 0
48 | Блок вспомогательных контактов 2НО + 2НЗ | LAEN22 | Schneider Electric | шт. |  | 2 |  |  |  |  |  |  |  |  |  | 0 |  |  | 1460 | 0 | 0
49 | Блок питания 220VAC / 24VDC; 1,8 / 2,5 А; 60 W | MDR-60-24 | Mean-Well | шт. |  |  |  |  | 4 | 4 | 4 | 4 | 4 | 4 |  | 0 |  |  | 1700 | 0 | 0
50 | Блок питания 220VAC / 24VDC; 0,33 / 0,42 А; 10 W | MDR-10-24 | Mean-Well | шт. |  |  |  |  | 2 |  |  |  |  |  |  | 0 |  | 2шт со склада | 990 | 0 | 0
51 | Реле контроля чередования фаз, пониженногого и повышенного напряжения | RM22TR33 | Schneider Electric | шт. |  | 2 |  |  |  |  |  |  |  |  |  | 0 |  | 2шт со склада | 5980 | 0 | 0
52 | Реле тока (5-10 / 10-20 А) | РТ40/20 |  | шт. |  | 2 |  |  |  |  |  |  |  |  |  | 0 |  |  | 4980 | 0 | 0
53 | Реле тока (2,5-5 / 5-10 А) | РТ40/10 |  | шт. |  | 1 |  |  |  |  |  |  |  |  |  | 0 |  |  | 4980 | 0 | 0
54 | Реле миниатюрное 2 конт., 8A, Uкат.220VAC | 40.52.8.230.0000 | FINDER | шт. |  | 6 |  |  | 14 | 22 | 22 | 22 | 22 | 22 |  | 0 |  |  | 644 | 0 | 0
55 | Модуль индикации и защиты (варистор), 110...240В AC/DC | 99.02.0.230.98 | FINDER | шт. |  | 6 |  |  | 14 | 22 | 22 | 22 | 22 | 22 |  | 0 |  |  | 322 | 0 | 0
56 | Реле 2 конт., 8A, Uкат.=24В | 40.52.9.024.0000 | FINDER | шт. |  | 2 |  |  | 6 | 38 | 38 | 38 | 38 | 38 |  | 0 |  |  | 598 | 0 | 0
57 | Модуль индикации и защиты (диод), 6...24В DC | 99.02.9.024.99 | FINDER | шт. |  | 2 |  |  | 6 | 38 | 38 | 38 | 38 | 38 |  | 0 |  |  | 298 | 0 | 0
58 | Розетка реле 2 конт. (10А) | 95.05.SPA | FINDER | шт. |  | 8 |  |  | 20 | 60 | 60 | 60 | 60 | 60 |  | 0 |  |  | 359 | 0 | 0
59 | Розетка на DIN - рейку с заземляющим контактом | РАр 10 - 3 - ОП ГК | IEK | шт. |  | 1 | 1 | 1 | 3 | 1 | 1 | 1 | 1 | 1 |  | 0 |  |  | 240 | 0 | 0
60 | Шина N "ноль" на 2-х угловых изоляторах | ШНИ-6х9-14-У2-С | iEK | шт. |  | 3 | 1 | 1 | 3 | 2 | 2 | 2 | 2 | 2 |  | 0 |  |  | 120 | 0 | 0
61 | Клемма винтовая с держателем предохранителя 5х20мм c индикацией перегорания 220В | MTU-4F220 | Meyertec | шт. |  | 3 | 10 | 10 |  |  |  |  |  |  |  | 0 |  |  | 270 | 0 | 0
62 | Предохранитель 5*20 стеклянный 0,16А |  |  | шт. |  | 3 | 10 | 10 |  |  |  |  |  |  |  | 0 |  |  | 5 | 0 | 0
63 | Клемма зажимная до 2,5 мм2 серая | MTU-2,5 | Meyertec | шт. |  | 139 | 40 | 40 | 155 | 170 | 170 | 170 | 170 | 170 |  | 0 |  |  | 37 | 0 | 0
64 | Клемма зажимная до 2,5 мм2 синяя | MTU-2,5BL | Meyertec | шт. |  | 17 | 10 | 10 | 7 | 30 | 30 | 30 | 30 | 30 |  | 0 |  |  | 39 | 0 | 0
65 | Клемма заземления зажимная до 2,5 мм2 желто-зеленая | MTU-2,5PE | Meyertec | шт. |  | 5 | 10 | 10 | 53 | 49 | 49 | 49 | 49 | 49 |  | 0 |  |  | 180 | 0 | 0
66 | Клемма заземления зажимная до 16 мм2 желто-зеленая | ЗНИ-16 PEN | TDM Electric | шт. |  | 2 |  |  |  |  |  |  |  |  |  | 0 |  |  | 220 | 0 | 0
67 | Клемма заземления зажимная до 10 мм2 желто-зеленая | ЗНИ-10 PEN | TDM Electric | шт. |  |  | 10 | 10 |  |  |  |  |  |  |  | 0 |  |  | 200 | 0 | 0
68 | Кросс-модуль на DIN-рейку 4х11 групп, 125А | 32018DEK | DEKraft | шт. |  | 1 |  |  |  |  |  |  |  |  |  | 0 |  |  | 2000 | 0 | 0
69 | Светосигнальный индикатор цвет зеленый 230V AC | XB7EV03MP | Schneider Electric | шт. |  | 4 | 11 | 11 | 2 | 2 | 2 | 2 | 2 | 2 |  | 0 |  |  | 699 | 0 | 0
70 | Светосигн. индикатор зеленый 24V DC | ХВ7EV03ВР | ShnaiderElectric | шт. |  |  |  |  | 1 |  |  |  |  |  |  | 0 |  |  | 699 | 0 | 0
71 | Вольтметр аналоговый 0-500В AC (72х72) | 16005 | Schneider Electric | шт. |  | 2 |  |  |  |  |  |  |  |  |  | 0 |  |  | 18460 | 0 | 0
72 | Кулачковый переключатель 10А 6+"0" (0 - L1N - L2N - L3N - L1L2 - L2L3 - L3L1) | K10F027MCH | Schneider Electric | шт. |  | 2 |  |  |  |  |  |  |  |  |  | 0 |  |  | 8950 | 0 | 0
73 | Переключатель 2 позиции 1НО+1НЗ | XB7ND25 | Schneider Electric | шт. |  | 2 |  |  | 4 |  |  |  |  |  |  | 0 |  |  | 1478 | 0 | 0
74 | Кнопка двойная 1НО,1НЗ с подсветкой AC 220V | XB5AW73731M5 | Schneider Electric | шт. |  | 2 |  |  |  |  |  |  |  |  |  | 0 |  |  | 4980 | 0 | 0
75 | Кнопка двойная 1НО,1НЗ с подсветкой AC 24V | XB5AW73731B5 | Schneider Electric | шт. |  |  |  |  | 1 | 4 | 4 | 4 | 4 | 4 |  | 0 |  |  | 5375 | 0 | 0
76 | Кнопка 22 мм красная "грибок" c фикс. 1NC, 1NO | XB7ES545P | Schneider Electric | шт. |  |  |  |  | 1 | 1 | 1 | 1 | 1 | 1 |  | 0 |  |  | 1980 | 0 | 0
77 | Кнопка красная без фиксации 1NC, 1NO | XB7NA45 | SchneiderElectric | шт. |  |  |  |  | 1 |  |  |  |  |  |  | 0 |  |  | 1340 | 0 | 0
78 | Кнопка управления без фиксации (зеленая, подсв 24V, 1НО) | XB7NW33B1 | Schneider Electric | шт. |  |  |  |  | 8 |  |  |  |  |  |  | 0 |  |  | 1998 | 0 | 0
79 | Оповещатель комбинированный | МАЯК-220-КПМ1 | Электротехника и Автоматика | шт. |  |  |  |  | 1 |  |  |  |  |  |  | 0 |  |  | 891 | 0 | 0
 | Расходные материалы:
80 | Короб перфорированный, серый 80x60 (шаг 6 / 4 мм) | 01139RL | DKC | м. |  |  |  |  | 1 | 1 | 1 | 1 | 1 | 1 |  | 0 |  |  | 420 | 0 | 0
81 | Короб перфорированный, серый RL6 60x60 (шаг 6 / 4 мм) | 01108RL | DKC | м. |  | 4.5 | 7 | 7 | 4.5 | 6 | 6 | 6 | 6 | 6 |  | 0 |  |  | 367 | 0 | 0
82 | Короб перфорированный, серый RL6 40x60 (шаг 6 / 4 мм) | 01107RL | DKC | м. |  | 4.5 |  |  |  | 1.5 | 1.5 | 1.5 | 1.5 | 1.5 |  | 0 |  |  | 355 | 0 | 0
83 | Короб перфорированный, серый 25X60 (шаг 6 / 4 мм) | 01166RL | DKC | м. |  | 1 |  |  | 1 |  |  |  |  |  |  | 0 |  |  | 245 | 0 | 0
84 | Короб перфорированный, серый 25X30 (шаг 7,5 / 5 мм) | 00126RL | DKC | м. |  |  |  |  | 1.5 | 1 | 1 | 1 | 1 | 1 |  | 0 |  |  | 245 | 0 | 0
85 | Короб перфорированный RL75 15х30 cерый QUADRO | 00672RL | DKC | м |  | 2 | 2.5 | 2.5 | 2 | 2 | 2 | 2 | 2 | 2 |  | 0 |  |  | 165 | 0 | 0
86 | DIN - рейка 35x7,5 mm |  |  | м. |  | 4.5 | 4 | 4 | 4 | 4.5 | 4.5 | 4.5 | 4.5 | 4.5 |  | 0 |  |  | 504 | 0 | 0
87 | Фиксатор торцевой (Ограничитель на DIN - рейку) | MTU-S | Meyertec | шт. |  | 30 | 30 | 30 | 16 | 30 | 30 | 30 | 30 | 30 |  | 0 |  |  | 36 | 0 | 0
88 | Маркировка клеммного ряда, ширина 5 мм (100 шт.) | MTU-2.5MC | Meyertec | уп. |  | 1.2 | 0.6 | 0.6 | 1.7 | 2 | 2 | 2 | 2 | 2 |  | 0 |  |  | 247 | 0 | 0
89 | Держатель этикетки (уп. 10 шт.) | MTU-S2 | Meyertec | уп. |  | 0.6 | 0.3 | 0.3 | 0.5 | 0.6 | 0.6 | 0.6 | 0.6 | 0.6 |  | 0 |  |  | 463 | 0 | 0
90 | Провод монтажный многожильный | ПВ-3 (1x6) |  | м. |  |  | 30 | 30 |  |  |  |  |  |  |  | 0 |  |  | 78 | 0 | 0
91 | Провод монтажный многожильный | ПВ-3 (1x2,5) |  | м. |  | 20 |  |  |  |  |  |  |  |  |  | 0 |  |  | 34 | 0 | 0
92 | Провод монтажный многожильный | ПВ-3 (1x1,5) |  | м. |  | 10 |  |  |  |  |  |  |  |  |  | 0 |  |  | 23 | 0 | 0
93 | Провод монтажный многожильный | ПВ-3 (1x0,75) |  | м. |  | 400 | 50 | 50 | 200 | 200 | 200 | 200 | 200 | 200 |  | 0 |  |  | 13 | 0 | 0
94 | Провод монтажный многожильный | ПВ-3 (1x0,5) |  | м. |  |  |  |  | 100 | 100 | 100 | 100 | 100 | 100 |  | 0 |  |  | 10 | 0 | 0
95 | Провод монтажный многожильный ж/з | ПВ-3 (1x4) |  | м. |  | 8 | 8 | 8 | 8 | 8 | 8 | 8 | 8 | 8 |  | 0 |  |  | 53 | 0 | 0
96 | Провод монтажный многожильный ж/з | ПВ-3 (1x0,75) |  | м. |  | 5 |  |  | 5 | 10 | 10 | 10 | 10 | 10 |  | 0 |  |  | 13 | 0 | 0
97 | Наконечник-гильза c изолированным фланцем | НГИ 6,0 |  | шт. |  |  | 100 | 100 |  |  |  |  |  |  |  | 0 |  |  | 1.5 | 0 | 0
98 | Наконечник-гильза c изолированным фланцем | НГИ 2,5 |  | шт. |  | 20 |  |  |  |  |  |  |  |  |  | 0 |  |  | 0.88 | 0 | 0
99 | Наконечник-гильза c изолированным фланцем | НГИ 1,5 |  | шт. |  | 10 |  |  |  |  |  |  |  |  |  | 0 |  |  | 0.64 | 0 | 0
100 | Наконечник-гильза c изолированным фланцем | НГИ 0,75 |  | шт. |  | 200 | 50 | 50 | 150 | 150 | 150 | 150 | 150 | 150 |  | 0 |  |  | 0.57 | 0 | 0
101 | Наконечник-гильза (для двух проводов) | НГИ2 0,75 |  | шт. |  | 50 |  |  | 30 | 30 | 30 | 30 | 30 | 30 |  | 0 |  |  | 0.69 | 0 | 0
102 | Наконечник-гильза c изолированным фланцем | НГИ 0,5 |  | шт. |  | 300 |  |  | 50 | 50 | 50 | 50 | 50 | 50 |  | 0 |  |  | 0.54 | 0 | 0
103 | Наконечник кольцевой изолированный 1,5-2,5 мм2 | НКИ 2-6 |  | шт. |  | 10 |  |  | 6 | 14 | 14 | 14 | 14 | 14 |  | 0 |  |  | 3.51 | 0 | 0
104 | Наконечник кольцевой изолированный 0,5-1,5 мм2 | НКИ 1,25-6 |  | шт. |  | 4 | 8 | 8 |  | 8 | 8 | 8 | 8 | 8 |  | 0 |  |  | 3.3 | 0 | 0
105 | Изолятор силовой (высота 30 мм) | SM30-(М8) | КЭАЗ | шт. |  |  | 4 | 4 |  |  |  |  |  |  |  | 0 |  |  | 52 | 0 | 0
106 | Изолятор силовой (высота 35 мм) | SM35-(М8) | КЭАЗ | шт. |  |  | 2 | 2 |  |  |  |  |  |  |  | 0 |  |  | 72 | 0 | 0
107 | Изолятор силовой (высота 40 мм) | SM40-(М8) | КЭАЗ | шт. |  |  | 2 | 2 |  |  |  |  |  |  |  | 0 |  |  | 82 | 0 | 0
108 | Изолятор силовой (высота 51 мм) | SM51-(М8) | КЭАЗ | шт. |  |  | 2 | 2 |  |  |  |  |  |  |  | 0 |  |  | 89 | 0 | 0
109 | Шинный терминал 70-185 мм2 для медн шины 5 мм | SQ0826-0009 | TDM | шт. |  |  | 4 | 4 |  |  |  |  |  |  |  | 40 |  |  | 200 | 8000 | 0
110 | Шинный терминал 2,5-16 мм2 для медн шины 5 мм | SQ0826-0003 | TDM | шт. |  |  | 40 | 40 |  |  |  |  |  |  |  | 40 |  |  | 45 | 1800 | 0
111 | Медная шина прямоугольного сечения | 30х5мм |  | м. |  |  | 2 | 2 |  |  |  |  |  |  |  | 0 |  |  | 3000 | 0 | 0
 | Посты местного управления задвижками:
112 | Корпус кнопочного поста управления на 5 мест | MTB2-PE5 | Meyertec | шт. |  | 3 |  |  |  |  |  |  |  |  |  | 0 |  |  | 777 | 0 | 0
113 | Переключатель черный 3 полож.(2NO) | XB5AD33 | ShnaiderElectric | шт. |  | 3 |  |  |  |  |  |  |  |  |  | 0 |  |  | 1478 | 0 | 0
114 | Переключатель 3 положения (2NO) без фиксации | XB5-AD53 | ShnaiderElectric | шт. |  | 3 |  |  |  |  |  |  |  |  |  | 0 |  |  | 1478 | 0 | 0
115 | Светосигнальный индикатор цвет зеленый 230V AC | XB7EV03MP | Schneider Electric | шт. |  | 6 |  |  |  |  |  |  |  |  |  | 0 |  |  | 699 | 0 | 0
116 | Светосигнальный индикатор цвет красный 230V AC | XB7EV04MP | Schneider Electric | шт. |  | 3 |  |  |  |  |  |  |  |  |  | 0 |  |  | 699 | 0 | 0
 | Средства автоматизации:
117 | Ethernet коммутатор 5 портов 24V DC | TSX-100-UN-5 | EKF | шт. |  |  |  |  | 2 |  |  |  |  |  |  | 0 |  |  | 4980 | 0 | 0
118 | Встраиваемый сенсорный монитор Easy mount 12 дюймов | БТ-12-рез-EM | ООО ГК «Билтех» | шт. |  |  |  |  | 2 |  |  |  |  |  |  | 0 |  |  | 84630 | 0 | 0
119 | Модуль центрального процессора 2 Гб ОЗУ, 2x8 Гб ПЗУ, RS-232, RS-485, 4xEthernet RJ45, 2хUSB, DVI-D, ГЛОНАСС (опционально), поддержка внешних USB накопителей | R500 CU 00 072(W)-002-AAA | ProSoftSystems | шт. |  |  |  |  | 2 |  |  |  |  |  |  | 0 |  |  | 615000 | 0 | 0
120 | Модуль ввода аналоговых сигналов 16кан. 0..20мА (под.резерв.) | R500 Ai 16 011-000-AAA | ProSoftSystems | шт. | 1 |  |  |  | 3 | 2 | 2 | 2 | 2 | 2 |  | 1 |  |  | 129000 | 129000 | 0
121 | Модуль ввода дискретных сигналов 32кан 24VDC(под резерв ) | R500 Di 32 011-000-AAA | ProSoftSystems | шт. | 1 |  |  |  | 2 | 3 | 3 | 3 | 3 | 3 |  | 1 |  |  | 90000 | 90000 | 0
122 | Модуль вывода дискретных сигналов 32кан. 24VDC(под.резерв.) | R500 Do 32 012-000-AAA | ProSoftSystems | шт. | 1 |  |  |  | 2 | 2 | 2 | 2 | 2 | 2 |  | 1 |  |  | 129000 | 129000 | 0
123 | Оконечный модуль с поддержкой расшир. и резервир.(IN) RJ45 | R500 ST 02 012000-AAA | ProSoftSystems | шт. | 1 |  |  |  | 1 | 1 | 1 | 1 | 1 | 1 |  | 1 |  |  | 72000 | 72000 | 0
124 | Оконечный модуль с поддержкой расшир. и резервир.(OUT) RJ45 | R500 ST 02 022000-AAA | ProSoftSystems | шт. | 1 |  |  |  | 1 | 1 | 1 | 1 | 1 | 1 |  | 1 |  |  | 69000 | 69000 | 0
125 | Модуль источника питания 220В 75вт с шасси (под.резерв.) | R500 РР 00 031-000-AAA | ProSoftSystems | шт. | 1 |  |  |  | 2 | 2 | 2 | 2 | 2 | 2 |  | 1 |  |  | 87000 | 87000 | 0
126 | Шасси с поддержкой резервирования для модулей ввода/вывода | R500 CH 02 011-000-AAA | ProSoftSystems | шт. | 1 |  |  |  | 11 | 11 | 11 | 11 | 11 | 11 |  | 1 |  |  | 22500 | 22500 | 0
127 | Шасси с поддержкой резервирования для модулей двухслотового центрального процессора I или III типа (две шины данных, две шины питания) | R500 CH 02 023-000-AAA | ProSoftSystems | шт. | 1 |  |  |  | 2 |  |  |  |  |  |  | 1 |  |  | 51000 | 51000 | 0
128 | Клеммная колодка для модулей ввода/вывода R500, 36 кон. (черн. | R500 CL 36 001 | ProSoftSystems | шт. | 1 |  |  |  | 7 | 7 | 7 | 7 | 7 | 7 |  | 1 |  |  | 6000 | 6000 | 0
129 | DIN-рейка 600мм. | R500 DN 060 | ProSoftSystems | шт. |  |  |  |  | 1 | 1 | 1 | 1 | 1 | 1 |  | 0 |  |  | 2400 | 0 | 0
130 | Патч-корд экранир. CAT5E F/UTP 4х2, LSZH, 1.0м | RN5EFU4510WH | DKC | шт. |  |  |  |  | 8 |  |  |  |  |  |  | 0 |  |  | 485 | 0 | 0
131 | Стол оператора | 7CO3.624.000 (1200мм) | ООО «ПРОЕКТ МЕТАЛЛ» | шт. |  |  |  |  |  |  |  |  |  |  | 1 | 0 |  |  | 150000 | 0 | 0
132 | Источник бесперебойного питания | 9SX1000iR | Eaton | шт. |  |  |  |  |  |  |  |  |  |  | 2 | 0 |  |  | 122060 | 0 | 0
133 | ПК IRU Home 310H6SE MT i3 12100 (3.3) 8Gb HDD 500Gb SSD 512Gb UHDG 730 Free DOS GbitEth 400W черный | 310H6SE MT | IRU | шт. |  |  |  |  |  |  |  |  |  |  | 2 | 0 |  |  | 39123 | 0 | 0
134 | Монитор Acer 27" KA270Hbmix черный VA LED 4ms 16:9 HDMI M/M матовая 250cd 178гр/178гр 1920x1080 100Hz VGA FHD 5.38кг | KA270Hbmix | Acer | шт. |  |  |  |  |  |  |  |  |  |  | 2 | 0 |  |  | 12938 | 0 | 0
135 | Клавиатура + мышь Оклик 630M клав:черный мышь:черный USB (1091260) | 630M | Оклик | шт. |  |  |  |  |  |  |  |  |  |  | 2 | 0 |  |  | 777 | 0 | 0
136 | Plant.Server, 15k тегов | PLN-SRV15k | ProSoftSystems | шт. |  |  |  |  |  |  |  |  |  |  | 2 | 0 |  |  | 690000 | 0 | 0
137 | Plant/Enterprise.Client Full | A-CL-F | ProSoftSystems | шт. |  |  |  |  |  |  |  |  |  |  | 2 | 0 |  |  | 115000 | 0 | 0
138 | Astra.Historian, 1k тегов | HIST-1k | ProSoftSystems | шт. |  |  |  |  |  |  |  |  |  |  | 2 | 0 |  |  | 171000 | 0 | 0
139 | Аппаратный ключ защиты | A-KEY-USB | ProSoftSystems | шт. |  |  |  |  |  |  |  |  |  |  | 2 | 0 |  |  | 0 | 0 | 0
 |  |  |  |  |  |  |  |  |  |  |  |  |  |  |  |  |  |  | итого: | 665300 | 0
