nppesnteam/370-24_Balakovo_PTVM180_-3-4/АК4/ШАВР.xlsx

№ п/п | Наименование | Состав работ | Трудо-емкость на ед., ч/ч | Ед.изм. | Кол-во | Трудо-емкость общая, ч/ч | Примечание
1 | Конструкции для установки приборов, масса до 2 кг | Не предусмотрен | 0.58 | шт | 12 | 6.96 | din-рейка например, но не по метражу, а по кол-ву отрезков
2 | Конструкции для установки приборов, масса до 5 кг | Не предусмотрен | 1.15 | шт | 8 | 9.2
3 | Зажим наборный без кожуха | 01. Сборка и установка зажимов без присоединения (присоединение делать отдельно по п.10). | 0.2451 | шт | 125 | 30.6375 | клеммник
4 | Приборы, устанавливаемые на металлоконструкциях, щитах и пультах, масса до 5 кг | Не предусмотрен | 0.52 | шт | 86 | 44.72 | Все приборы: реле, автоматы, блоки питания, контроллеры, модули ввода-вывода, кнопки, лампочки и другие элементы лицевой панели
5 | Приборы, устанавливаемые на металлоконструкциях, щитах и пультах, масса до 10 кг | Не предусмотрен | 1.03 | шт | 2 | 2.06
6 | Добавлять за каждые 5 кг свыше 10 кг | Не предусмотрен | 0.206 | кг | 0 | 0
7 | Розетка штепсельная неутопленного типа при открытой проводке | 01. Установка приборов. 02. Присоединение. 03. Опробование на зажигание. | 0.436 | шт | 1 | 0.436
8 | Светильник местного освещения | 01. Монтаж светильника. 02. Присоединение. 03. Ввертывание ламп. 04. Опробование на зажигание. | 0.8546 | шт | 1 | 0.8546
9 | Электрические проводки в щитах и пультах шкафных и панельных | Не предусмотрен | 0.0927 | м | 440 | 40.788
10 | Присоединение к приборам электрических проводок под винт с оконцеванием наконечником | Не предусмотрен | 0.113 | жила | 406 | 45.878 | Считаем, сколько жил подходит-отходит от каждого прибора из п.3-7 и все сюда
11 | Маркировка кабелей | 01. Нанесение чертилкой надписей на бирках и оконцевателях. 02. Надевание бирки на поясок. 03. Cнятие временой бирки, закрепление пояска на кабелях или трубах | 0.045 | жила | 406 | 18.27 | на каждую жилу
12 | Короба пластмассовые шириной до 40 мм | 01. Разметка мест установки и креплений. 02. Установка основания короба с раскроем и подгонкой основания. 03. Установка оснований соединительных элементов (углов поворота, пересечений, отводов). 04. Надвижка крышек короба и соединительных элементов. | 0.1629 | м | 10 | 1.629
 |  |  |  |  |  | 154.6356
 | ШАВР г.Балаково
 | сост. Поликарпов С.Н. 24.09.2024
