nppesnteam/370-24_Balakovo_PTVM180_-3-4/SM/370-24_балаково_птвм180n3n4/sm Балаково/sm16_sensor_fire _st.dxf

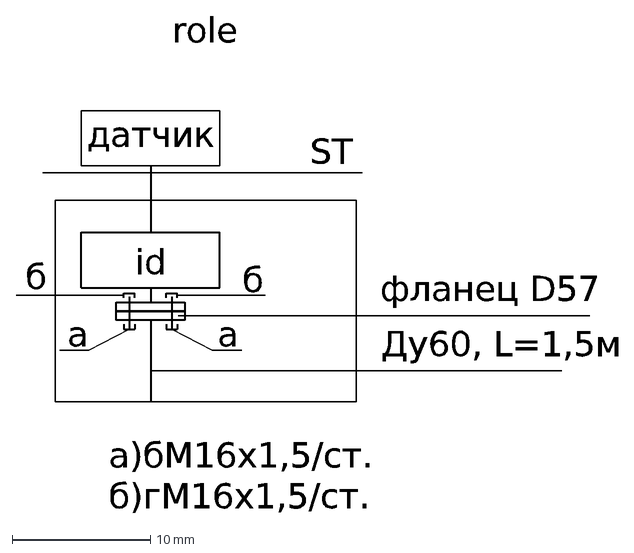
[picture p61: CAD file, 2024-11-14]
SM/370-24_балаково_птвм180n3n4/sm Балаково/sm16_sensor_fire _st.dxf
role
Ду60, L=1,5м
фланец D57
б
а
а)бМ16х1,5/ст. б)гМ16х1,5/ст.
ST
id
датчик
