nppesnteam/370-24_Balakovo_PTVM180_-3-4/SM/370-24_балаково_птвм180n3n4_241105/sm Балаково/sm14_p_drop_dubl_st.dxf

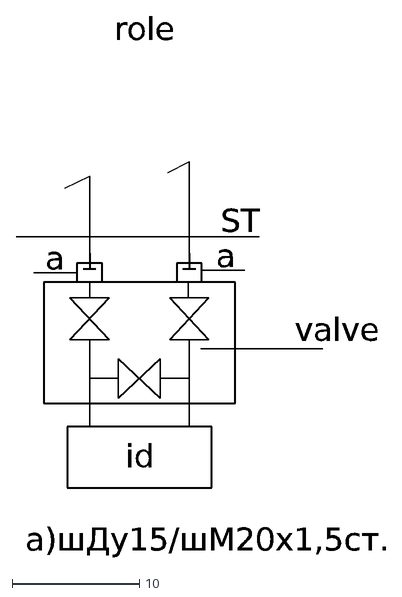
[picture p63: CAD file, 2024-11-14]
SM/370-24_балаково_птвм180n3n4_241105/sm Балаково/sm14_p_drop_dubl_st.dxf
role
id
valve
a
а
ST
а)шДу15/шМ20х1,5ст.
