nppesnteam/370-24_Balakovo_PTVM180_-3-4/АК3/tplan.dxf

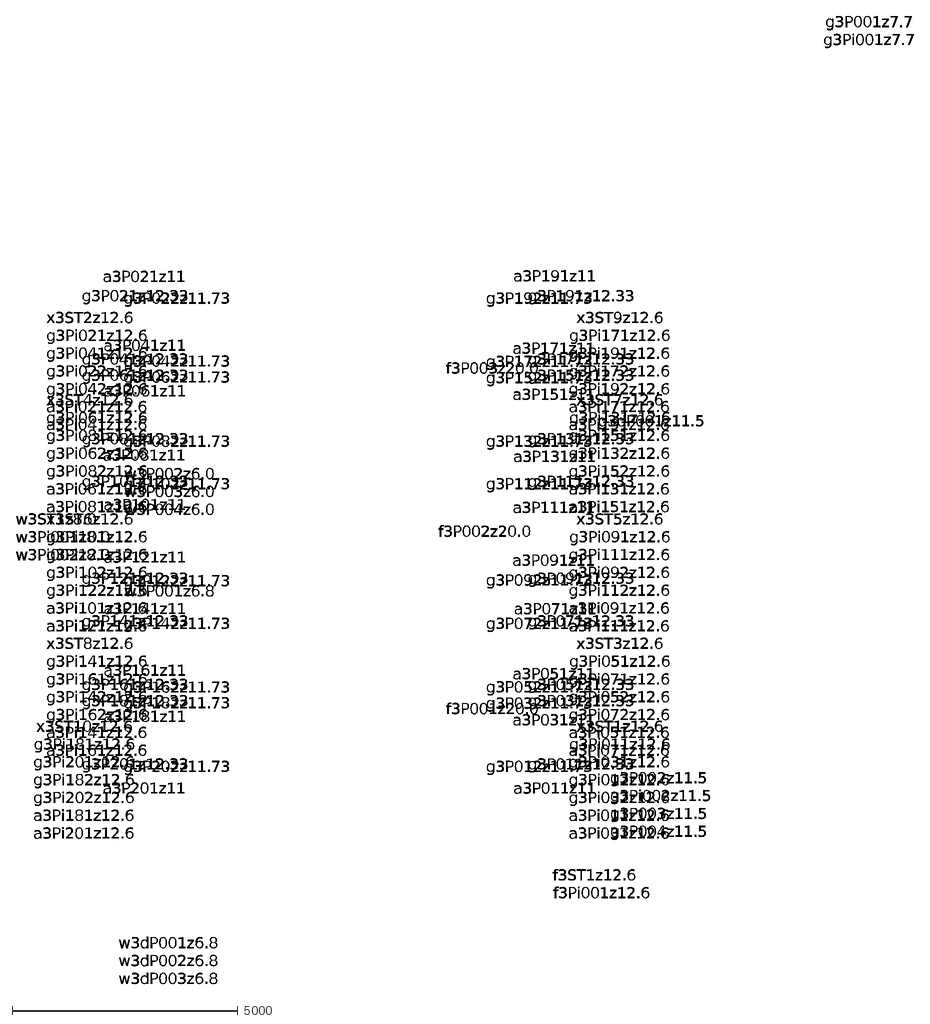
[picture p64: CAD file, 2024-11-14]
АК3/tplan.dxf
x3ST3z12.6 g3Pi051z12.6 g3Pi071z12.6 g3Pi052z12.6 g3Pi072z12.6 a3Pi051z12.6 a3Pi071z12.6
x3ST5z12.6 g3Pi091z12.6 g3Pi111z12.6 g3Pi092z12.6 g3Pi112z12.6 a3Pi091z12.6 a3Pi111z12.6
x3ST7z12.6 g3Pi131z12.6 g3Pi151z12.6 g3Pi132z12.6 g3Pi152z12.6 a3Pi131z12.6 a3Pi151z12.6
x3ST9z12.6 g3Pi171z12.6 g3Pi191z12.6 g3Pi172z12.6 g3Pi192z12.6 a3Pi171z12.6 a3Pi191z12.6
x3ST10z12.6 g3Pi181z12.6 g3Pi201z12.6 g3Pi182z12.6 g3Pi202z12.6 a3Pi181z12.6 a3Pi201z12.6
x3ST8z12.6 g3Pi141z12.6 g3Pi161z12.6 g3Pi142z12.6 g3Pi162z12.6 a3Pi141z12.6 a3Pi161z12.6
x3ST6z12.6 g3Pi101z12.6 g3Pi121z12.6 g3Pi102z12.6 g3Pi122z12.6 a3Pi101z12.6 a3Pi121z12.6
x3ST4z12.6 g3Pi061z12.6 g3Pi081z12.6 g3Pi062z12.6 g3Pi082z12.6 a3Pi061z12.6 a3Pi081z12.6
x3ST2z12.6 g3Pi021z12.6 g3Pi041z12.6 g3Pi022z12.6 g3Pi042z12.6 a3Pi021z12.6 a3Pi041z12.6
g3P002z11.5 g3Pi002z11.5 g3P003z11.5 g3P004z11.5
g3P001z7.7 g3Pi001z7.7
w3P002z6.0 w3P003z6.0 w3P004z6.0
w3ST1z8.0 w3Pi001z8.0 w3Pi002z8.0
w3P001z6.8
g3dP001z11.5
f3P003z20.0
f3P002z20.0
f3P001z20.0
w3dP001z6.8 w3dP002z6.8 w3dP003z6.8
f3ST1z12.6 f3Pi001z12.6
g3P012z11.73
g3P011z12.33
a3P011z11
a3P031z11
a3P051z11
a3P071z11
a3P091z11
a3P111z11
a3P131z11
a3P151z11
a3P171z11
a3P191z11
a3P021z11
a3P041z11
a3P061z11
a3P081z11
a3P101z11
a3P121z11
a3P141z11
a3P161z11
a3P181z11
a3P201z11
g3P032z11.73
g3P052z11.73
g3P072z11.73
g3P092z11.73
g3P112z11.73
g3P132z11.73
g3P152z11.73
g3P172z11.73
g3P192z11.73
g3P022z11.73
g3P042z11.73
g3P062z11.73
g3P082z11.73
g3P102z11.73
g3P122z11.73
g3P142z11.73
g3P162z11.73
g3P182z11.73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
