nppesnteam/370-24_Balakovo_PTVM180_-3-4/SM/370-24_балаково_птвм180n3n4/sm Балаково/sm5_p_st_brass.dxf

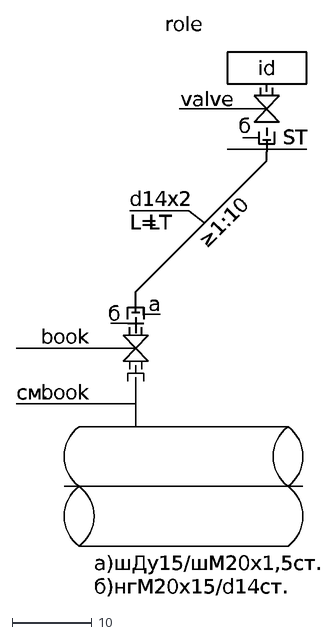
[picture p67: CAD file, 2024-11-14]
SM/370-24_балаково_птвм180n3n4/sm Балаково/sm5_p_st_brass.dxf
id
role
ST
d14x2
L=
LT
б
valve
а)шДу15/шМ20х1,5ст. б)нгМ20х15/d14ст.
см.
book
а
≥1:10
