nppesnteam/370-24_Balakovo_PTVM180_-3-4/SM/370-24_балаково_птвм180n3n4_241022/sm Балаково/sm13_p_drop_teplo_st.dxf

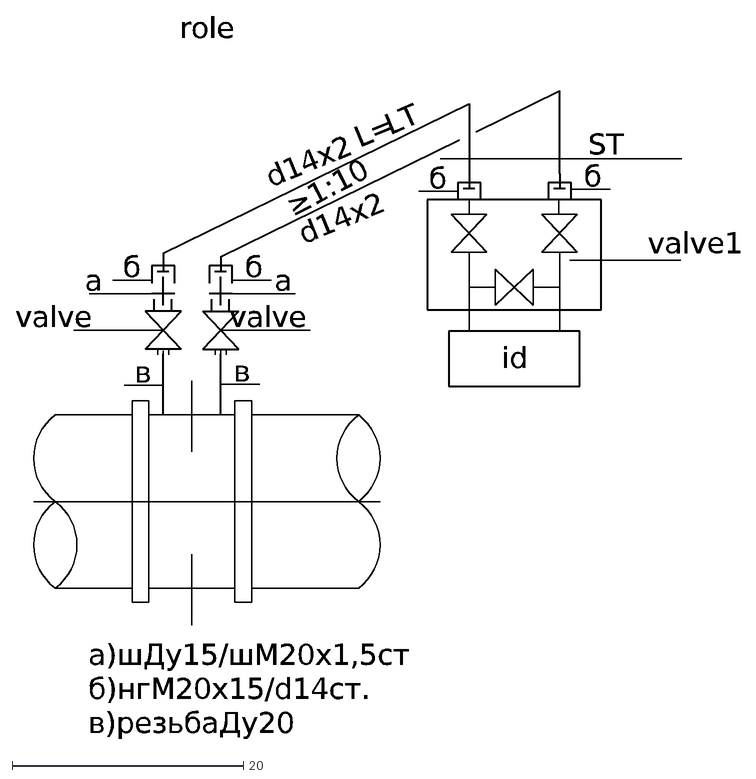
[picture p68: CAD file, 2024-11-14]
SM/370-24_балаково_птвм180n3n4_241022/sm Балаково/sm13_p_drop_teplo_st.dxf
role
а)шДу15/шМ20х1,5ст б)нгМ20х15/d14ст. в)резьбаДу20
id
valve1
б
а
valve
d14x2
≥1:10
L=
LT
ST
в
