nppesnteam/370-24_Balakovo_PTVM180_-3-4/SM/370-24_балаково_птвм180n3n4_241105/sm Балаково/sm11_p_ст_dubl.dxf

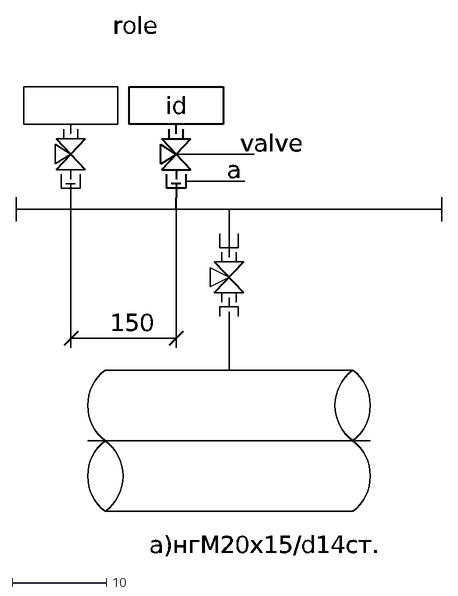
[picture p69: CAD file, 2024-11-14]
SM/370-24_балаково_птвм180n3n4_241105/sm Балаково/sm11_p_ст_dubl.dxf
role
a
id
а)нгМ20х15/d14ст.
150
valve
