nppesnteam/370-24_Balakovo_PTVM180_-3-4/SM/370-24_балаково_птвм180n3n4/sm Балаково/sm6_t__book_45.dxf

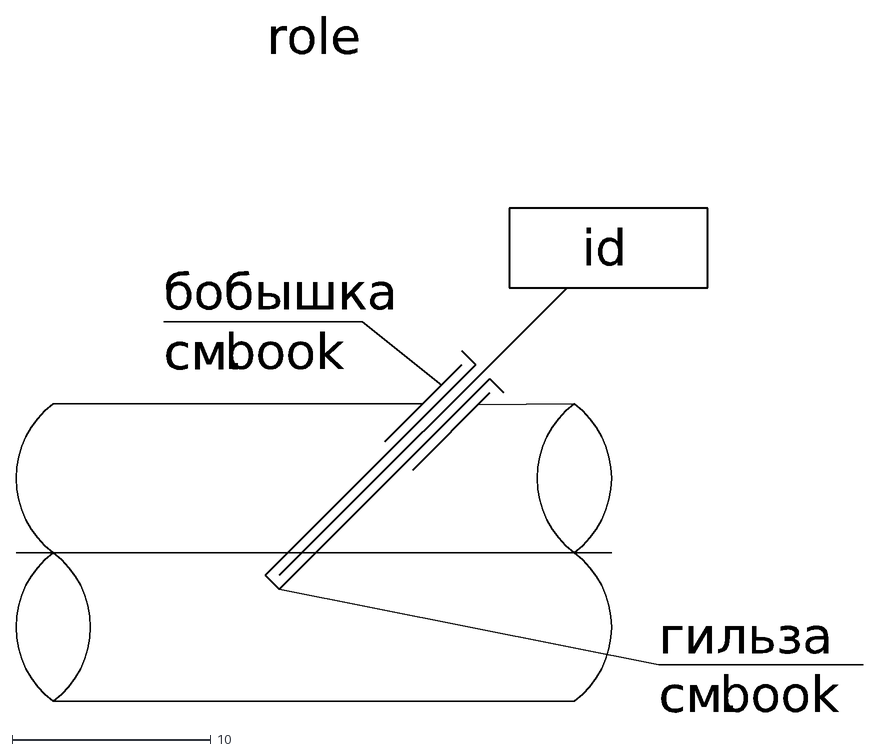
[picture p72: CAD file, 2024-11-14]
SM/370-24_балаково_птвм180n3n4/sm Балаково/sm6_t__book_45.dxf
id
role
бобышка
гильза
см.
book
