nppesnteam/370-24_Balakovo_PTVM180_-3-4/SM/370-24_балаково_птвм180n3n4_241022/sm Балаково/sm4_t_book.dxf

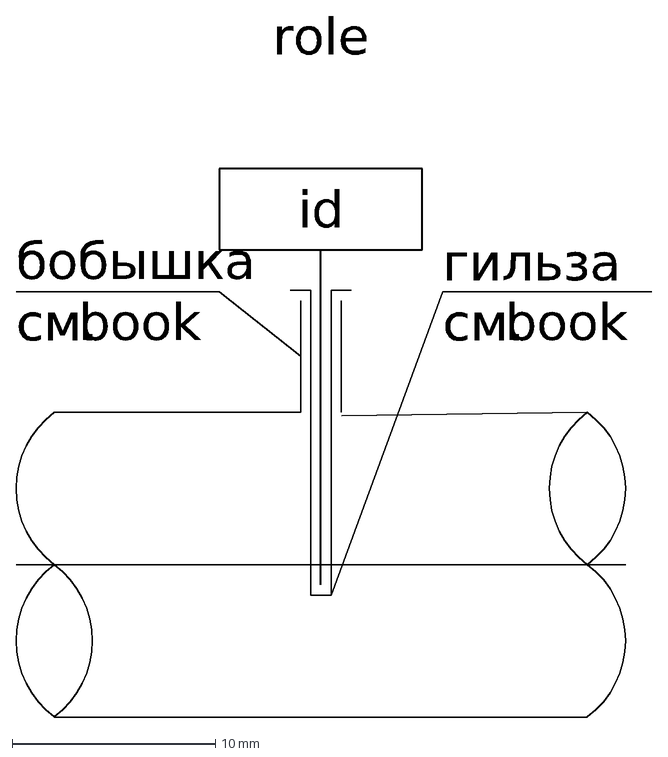
[picture p73: CAD file, 2024-11-14]
SM/370-24_балаково_птвм180n3n4_241022/sm Балаково/sm4_t_book.dxf
id
role
бобышка
гильза
см.
book
