nppesnteam/370-24_Balakovo_PTVM180_-3-4/SM/370-24_балаково_птвм180n3n4_241105/sm Балаково/sm2_p_book.dxf

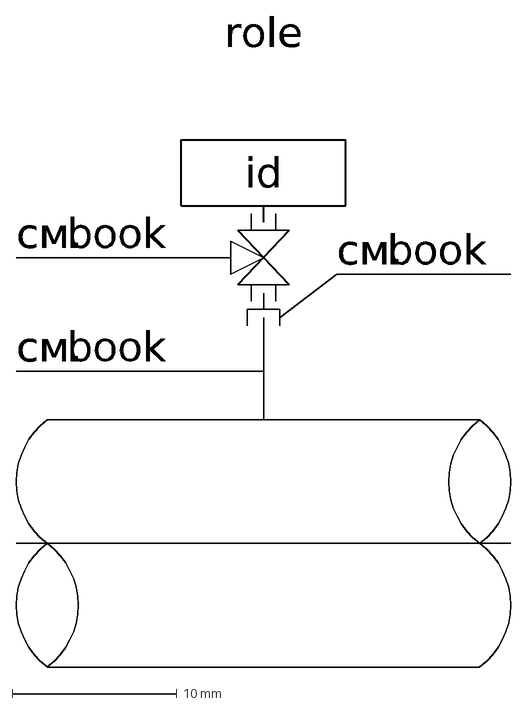
[picture p74: CAD file, 2024-11-14]
SM/370-24_балаково_птвм180n3n4_241105/sm Балаково/sm2_p_book.dxf
id
role
см.
book
