nppesnteam/370-24_Balakovo_PTVM180_-3-4/SM/370-24_балаково_птвм180n3n4/sm Балаково/sm15_sensor_fire.dxf

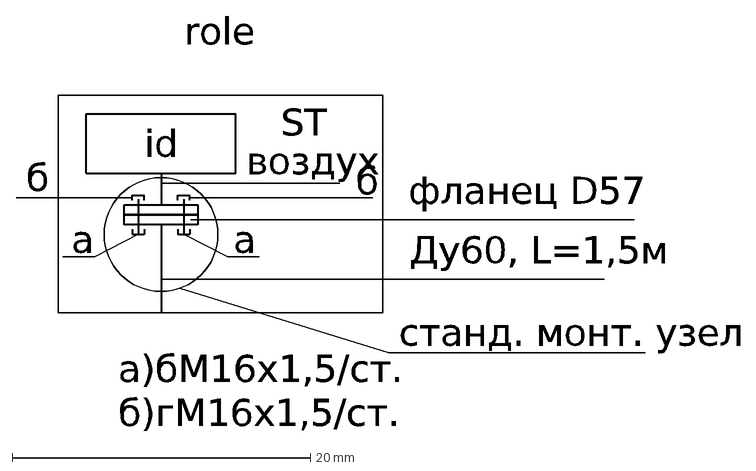
[picture p75: CAD file, 2024-11-14]
SM/370-24_балаково_птвм180n3n4/sm Балаково/sm15_sensor_fire.dxf
id
role
Ду60, L=1,5м
фланец D57
б
а
а)бМ16х1,5/ст. б)гМ16х1,5/ст.
воздух
станд. монт. узел
ST
