nppesnteam/370-24_Balakovo_PTVM180_-3-4/SM/370-24_балаково_птвм180n3n4_241022/sm Балаково/sm12_t_45.dxf

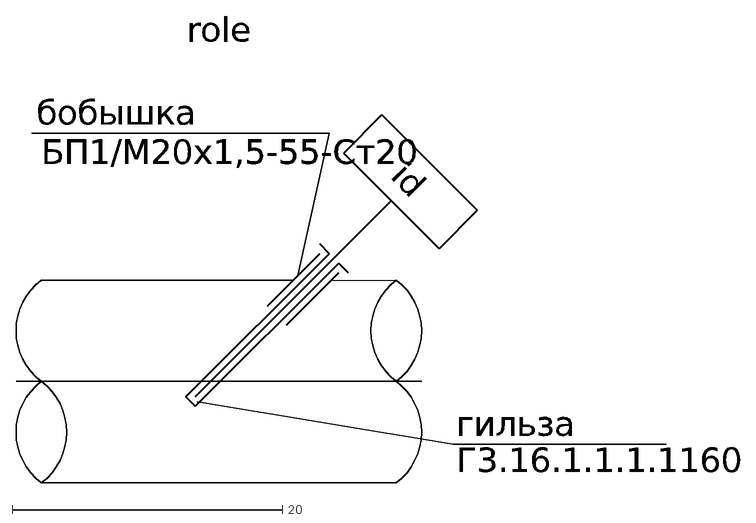
[picture p76: CAD file, 2024-11-14]
SM/370-24_балаково_птвм180n3n4_241022/sm Балаково/sm12_t_45.dxf
id
role
бобышка
БП1/М20х1,5-55-Ст20
гильза
Г3.16.1.1.1.1160
