nppesnteam/370-24_Balakovo_PTVM180_-3-4/SM/370-24_балаково_птвм180n3n4/sm Балаково/sm7_p_book_drop.dxf

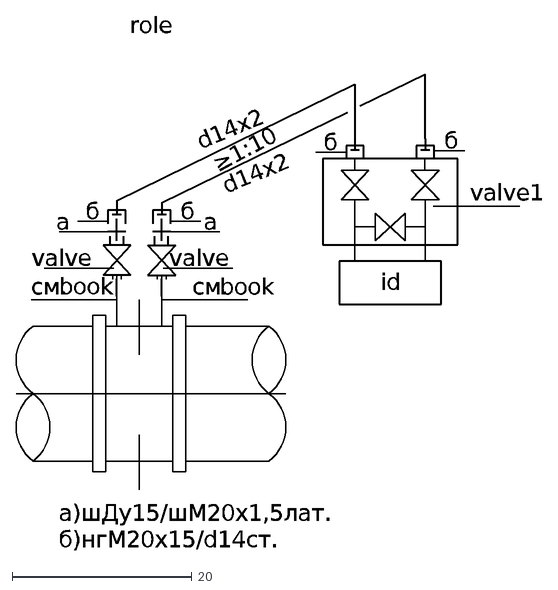
[picture p79: CAD file, 2024-11-14]
SM/370-24_балаково_птвм180n3n4/sm Балаково/sm7_p_book_drop.dxf
role
см.
а)шДу15/шМ20х1,5лат. б)нгМ20х15/d14ст.
book
id
valve1
б
а
valve
d14x2
≥1:10
