nppesnteam/370-24_Balakovo_PTVM180_-3-4/SM/370-24_балаково_птвм180n3n4_241022/sm Балаково/sm10_p_ст_book+dubl.dxf

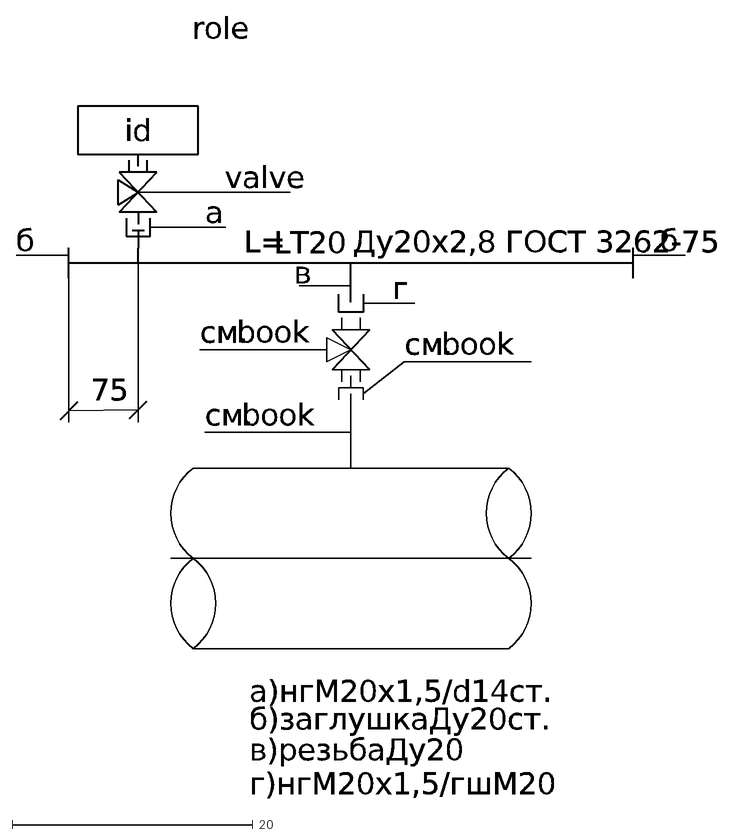
[picture p80: CAD file, 2024-11-14]
SM/370-24_балаково_птвм180n3n4_241022/sm Балаково/sm10_p_ст_book+dubl.dxf
role
см.
book
id
valve
a
а)нгМ20х1,5/d14ст.
75
б)заглушкаДу20ст.
б
в)резьбаДу20
LT20
L=
г
в
г)нгМ20х1,5/гшМ20
Ду20х2,8 ГОСТ 3262-75
