nppesnteam/370-24_Balakovo_PTVM180_-3-4/SM/370-24_балаково_птвм180n3n4_241105/sm Балаково/sm9_p_st_vozduh.dxf

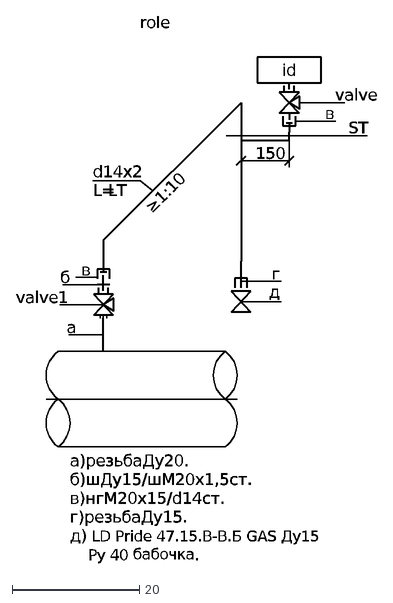
[picture p81: CAD file, 2024-11-14]
SM/370-24_балаково_птвм180n3n4_241105/sm Балаково/sm9_p_st_vozduh.dxf
role
а)резьбаДу20. б)шДу15/шМ20х1,5ст. в)нгМ20х15/d14ст. г)резьбаДу15. д) LD Pride 47.15.В-В.Б GAS Ду15 Ру 40 бабочка.
г
ST
≥1:10
d14x2
L=
LT
id
valve
в
150
д
б
valve1
а
