nppesnteam/370-24_Balakovo_PTVM180_-3-4/SM/370-24_балаково_птвм180n3n4_241022/sm Балаково/sm8_p_sensor_d_st.dxf

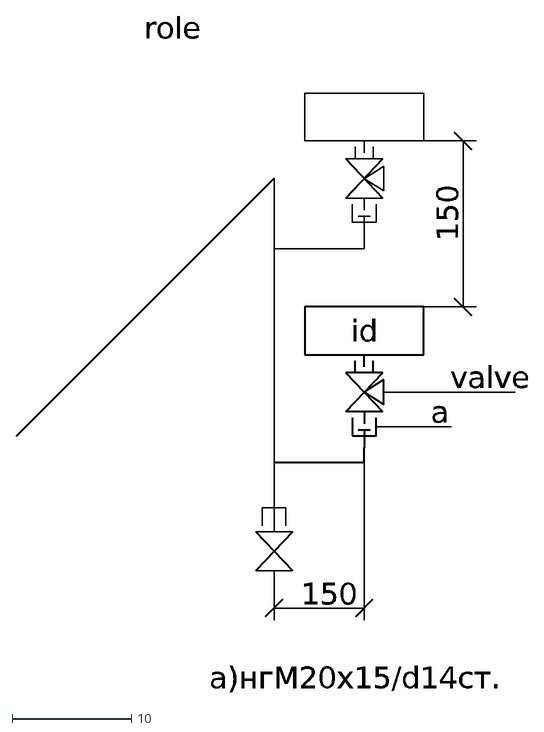
[picture p82: CAD file, 2024-11-14]
SM/370-24_балаково_птвм180n3n4_241022/sm Балаково/sm8_p_sensor_d_st.dxf
role
150
id
valve
a
а)нгМ20х15/d14ст.
