nppesnteam/370-24_Balakovo_PTVM180_-3-4/SM/370-24_балаково_птвм180n3n4_241022/sm Балаково/sm1_p_st_book.dxf

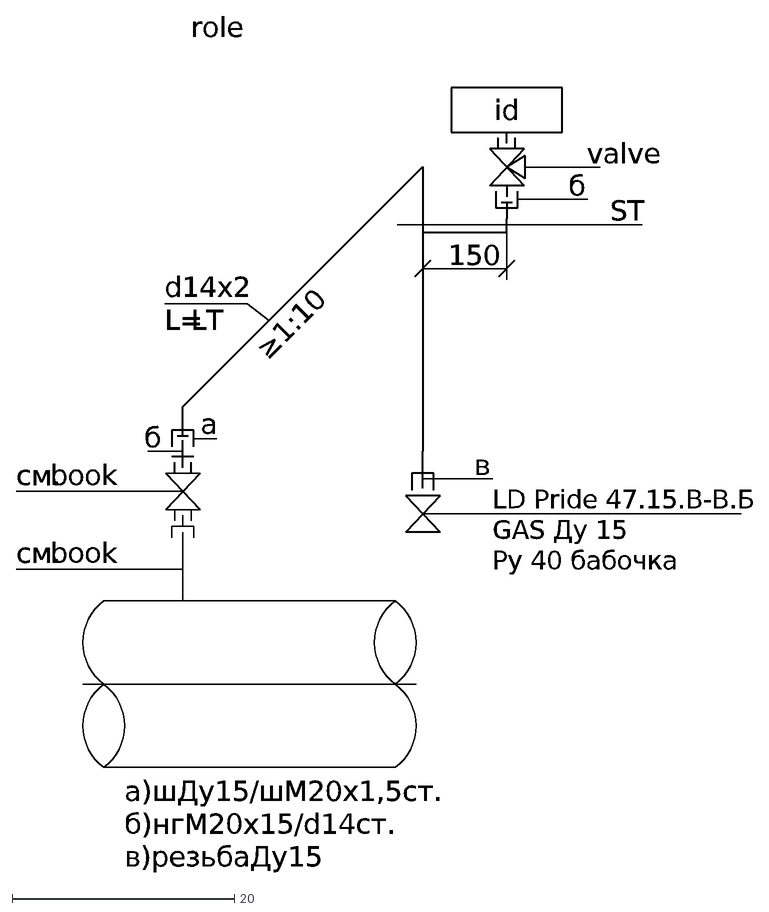
[picture p84: CAD file, 2024-11-14]
SM/370-24_балаково_птвм180n3n4_241022/sm Балаково/sm1_p_st_book.dxf
role
а)шДу15/шМ20х1,5ст. б)нгМ20х15/d14ст. в)резьбаДу15
см.
book
а
б
в
ST
≥1:10
d14x2
L=
LT
id
valve
150
LD Pride 47.15.В-В.Б GAS Ду 15 Ру 40 бабочка
