nppesnteam/370-24_Balakovo_PTVM180_-3-4/SM/370-24_балаково_птвм180n3n4_241105/sm Балаково/sm6_t_book_45.dxf

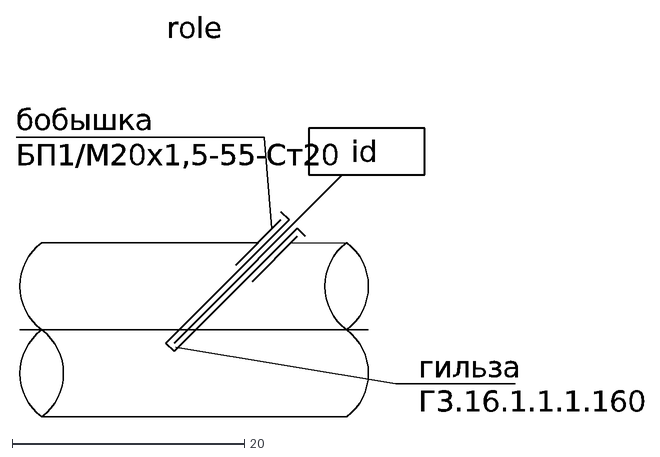
[picture p85: CAD file, 2024-11-14]
SM/370-24_балаково_птвм180n3n4_241105/sm Балаково/sm6_t_book_45.dxf
id
role
бобышка
гильза
БП1/М20х1,5-55-Ст20
Г3.16.1.1.1.160
