nppesnteam/370-24_Balakovo_PTVM180_-3-4/SM/370-24_балаково_птвм180n3n4_241022/sm Балаково/sm7_p_book_drop_st.dxf

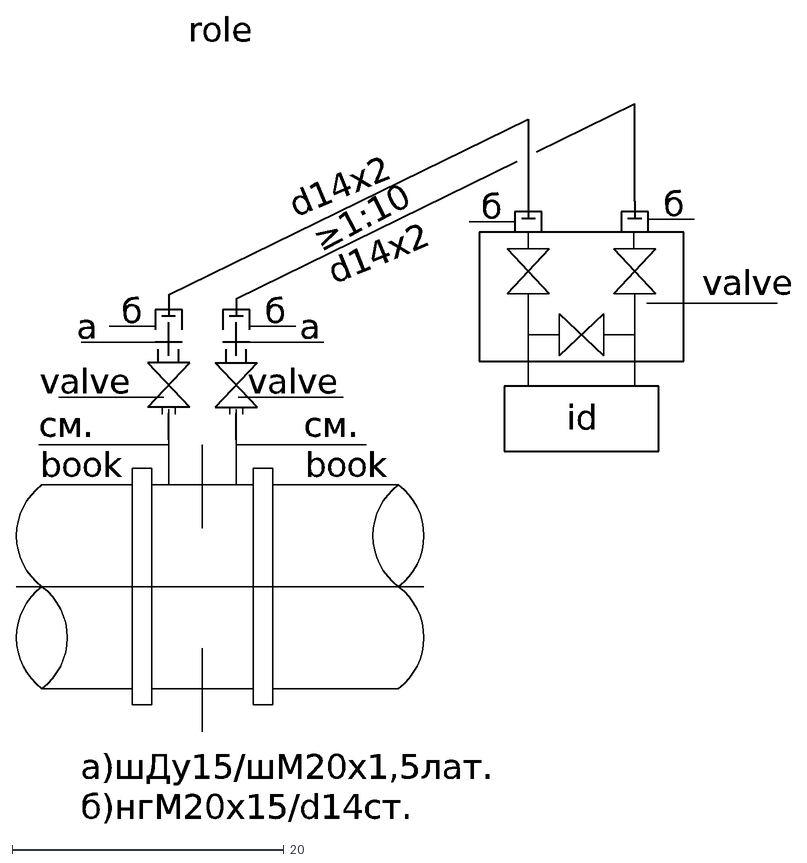
[picture p87: CAD file, 2024-11-14]
SM/370-24_балаково_птвм180n3n4_241022/sm Балаково/sm7_p_book_drop_st.dxf
role
см.
а)шДу15/шМ20х1,5лат. б)нгМ20х15/d14ст.
book
id
valve
б
а
d14x2
≥1:10
