nppesnteam/370-24_Balakovo_PTVM180_-3-4/(list of files, cad)

Other CAD files:
АК4/cplan.dxf
ГС Балаково_1.dwg
АК3/cplan.dxf
АК4/tplan.dxf
ГС Балаково_2.dwg
сplan_bak.dxf
