nppesnteam/370-24_Balakovo_PTVM180_-3-4/АК3/6.Структурная схема автоматизации.pdf

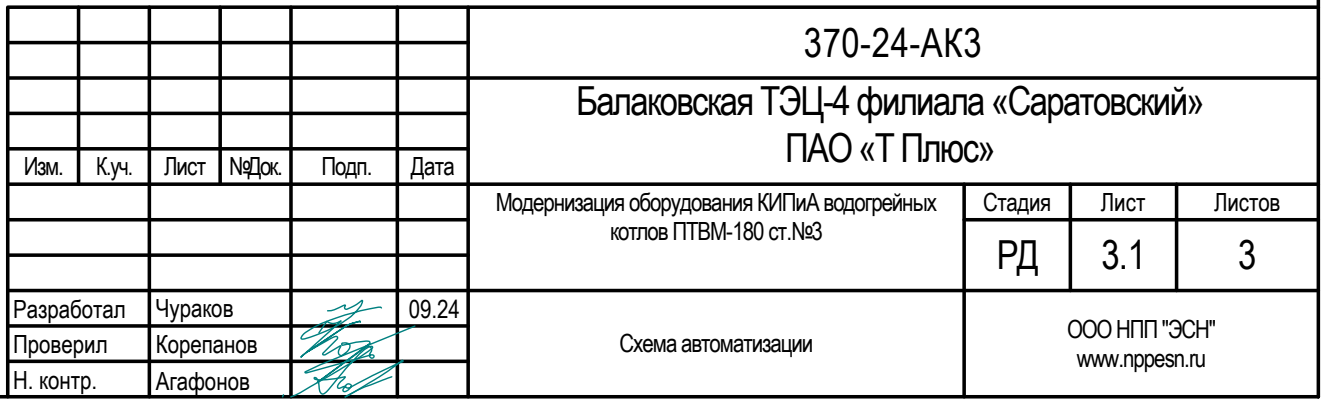
[picture p89: figure]
Стадия; Лист; Листов; Изм.; №Док.; Подп.; Дата; котловПТВМ-180 ст.№3; ОООНПП "ЭСН" www.nppesn.ru; Балаковская ТЭЦ-4 филиала «Саратовский» ПАО «ТПлюс»; Схема автоматизации; Разработал Проверил Н. контр.; Чураков; Агафонов; Корепанов

## Модернизация оборудования КИПиА водогрейных

# Условные обозначения

На схеме; наименование; Кран газовый; Клапан электромагнитный; Манометр; Кран трехходовый под манометр.; Продувочный трубопровод; Заслонка регулирующая с электроприводом; Трубопровод безопасности; Задвижка с электроприводом; Регулятор (стабилизатор) давления газа; Трубопровод резервного топлива; Трубопровод теплоносителя Измерительная диафрагма

Г2 | Проектируемый газопровод среднего давления.

## Счетчик газовый (диафрагменный) - технологический учет

g

номер подобъекта на объекте. Котел №3

среда: g(Gas)-газ, w(Water) - вода: на выходе из котла, на входе в котел, a(Air)-воздух, f(smole Fumes)-дым.газы, r(Reserv fuel)-резервное топливо, b(Burn) - пламя, x - прочее g

Pi

3

индивидуальный номер устройства на объекте.

3 0

1

Pi

1 3

0 1 номер горелки

P(Pressure)-давл., Т(Temperature)- темп-ра, CP(Control Panel)-шкаф управления, PP (power panel) - силовой шкаф,
fM(freqMotion) - эл.привод с частотником, sM(Single-turn Motion) - МЭО, H(Hand) - ручной, V(Valve) - клапан, Q(Quantity) - расход, X - неклассифицируемое устройство, последняя буква в датчиках: i(indicate) - показывающий, OS(Operator Station)-АРМ оператора

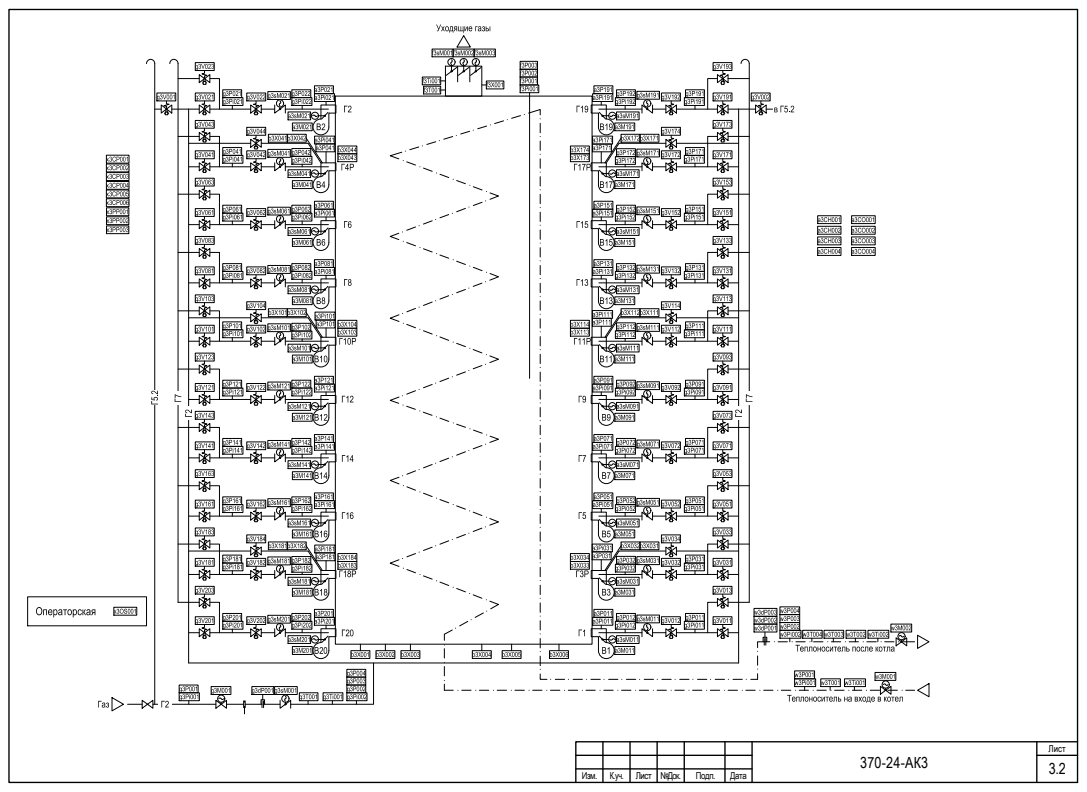
[picture p90: page 2]
Лист; Изм.; №Док.; Подп.; Дата

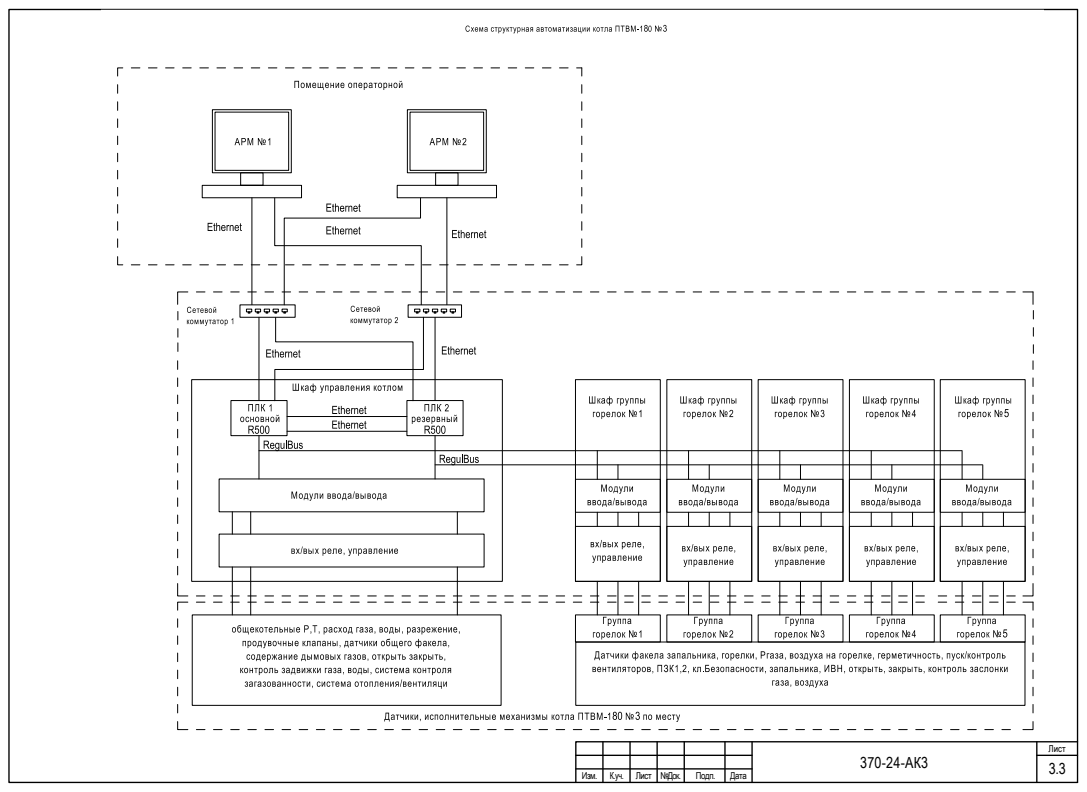
[picture p91: page 3]
Лист; Изм.; №Док.; Подп.; Дата
