nppesnteam/370-24_Balakovo_PTVM180_-3-4/Docs/ИКТС-11-06 v3.pdf

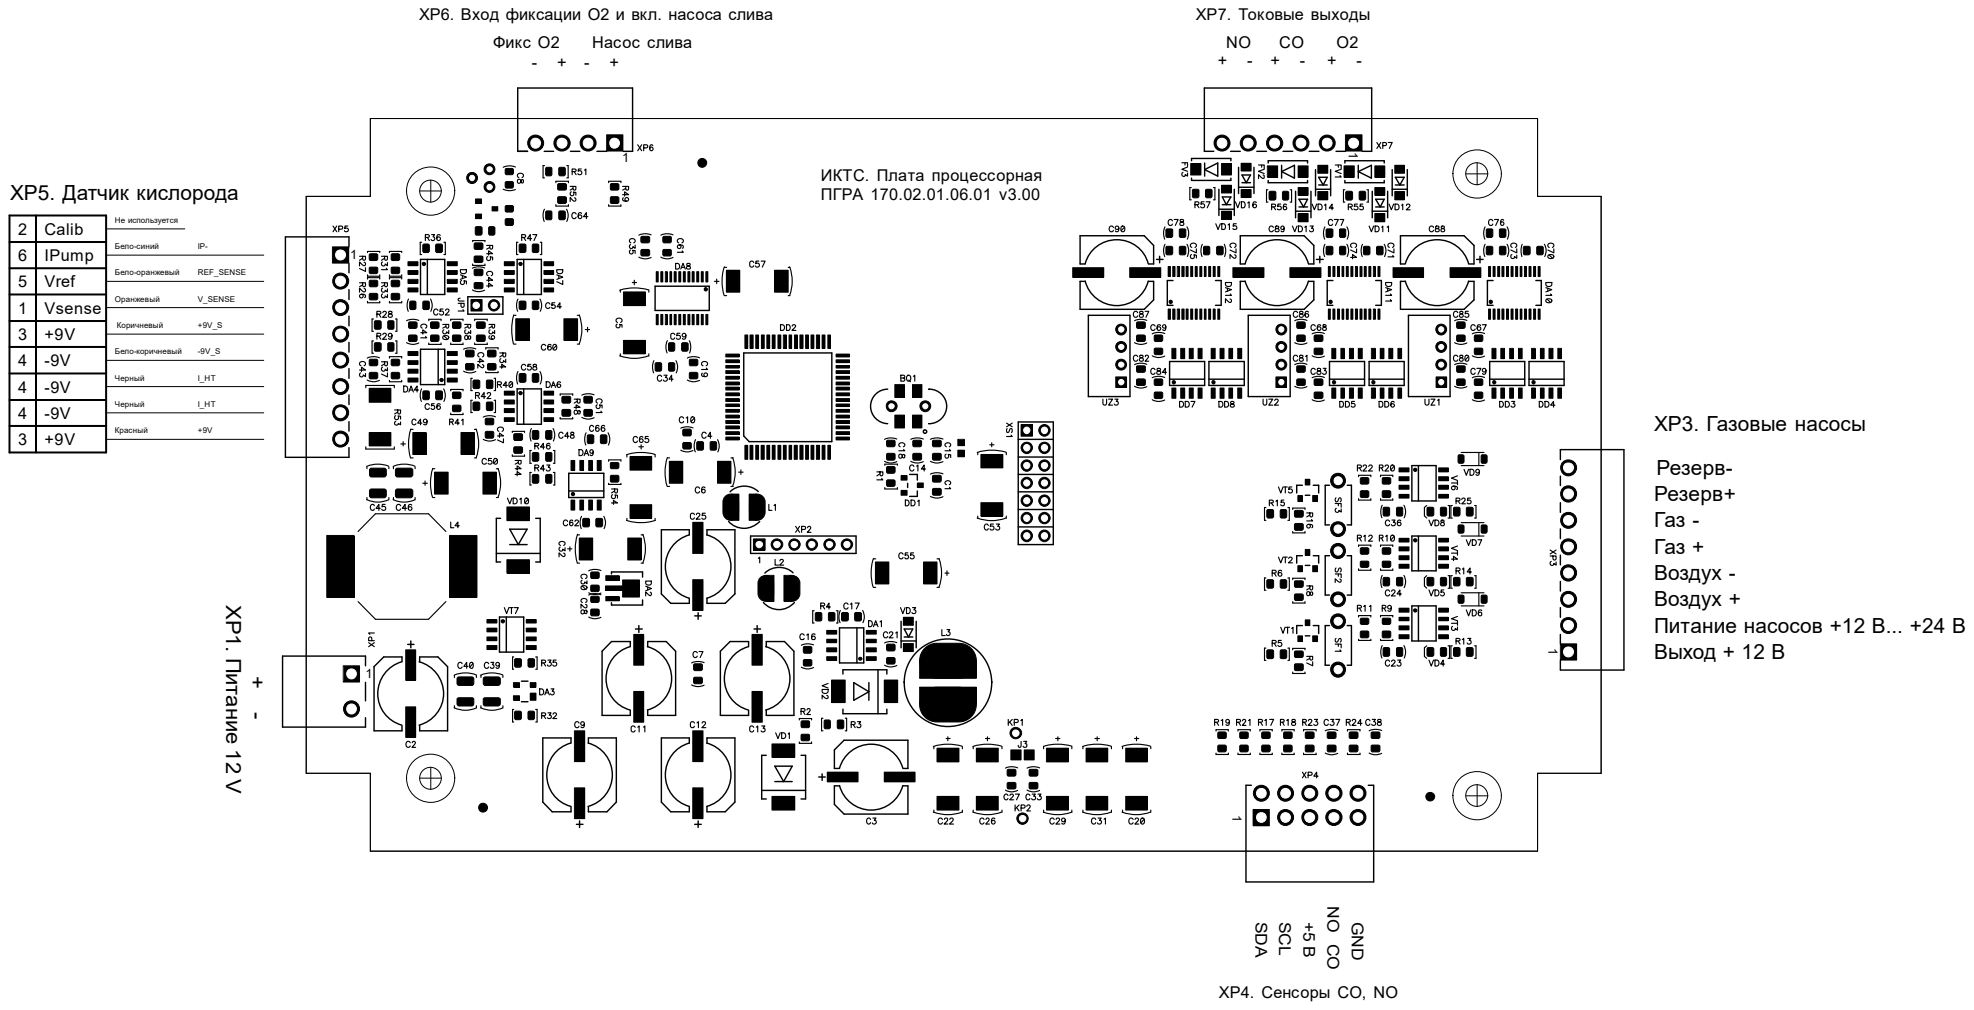
[picture p92: page 1]
V_SENSE; SDA; SCL; Черный; Красный; Бело-коричневый; Оранжевый; Коричневый; Бело-оранжевый; REF_SENSE; Бело-синий; Не используется; Фикс О2; GND; Воздух -; Газ -; Резерв-; Газ +; Резерв+; XP5. Датчик кислорода; Насос слива; Питание насосов +12 В... +24 В; XP7. Токовые выходы; Выход + 12 В; Воздух +; XP3. Газовые насосы; XP1. Питание 12 V

XP6. Вход фиксации О2 и вкл. насоса слива

ИКТС. Плата процессорная
ПГРА 170.02.01.06.01 v3.00

2 | Calib
6 | IPump
5 | Vref
1 | Vsense
3 | +9V
4 | -9V

XP4. Сенсоры CO, NO
