nppesnteam/370-24_Balakovo_PTVM180_-3-4/370-24_балаково_птвм180n3n4_гс3_240723.pdf

# Балаковская ТЭЦ-4 филиала «Саратовский» ПАО «Т Плюс»

# Модернизация оборудования КИПиА водогрейных котлов ПТВМ-180 ст.№3, ст.№4

# Заказчик: филиал «Саратовский» ПАО «Т Плюс»

Главный инженер проекта | /Корепанов М.И./
370-24-ГС3 | Котел ПТВМ-180 №3. Газоснабжение

# Проектная организация: ООО НПП "Энергосервисналадка", г.Ижевск, nppesn.ru, ИНН 1832097973

Регистрационный номер 1083 в реестре Ассоциации Саморегулируемой организации "Национальное объединение научно-исследовательских и проектно-изыскательских организаций" Ассоциация СРО "Центрстройпроект", регистрационный номер в государственном реестре саморегулируемых организаций СРО-П-029-25092009)

# Состав рабочей документации, шифр 370-24, стадия «РД»

# Объект: Балаковская ТЭЦ-4 филиала «Саратовский» ПАО «Т Плюс»

Стройка: Модернизация оборудования КИПиА водогрейных котлов ПТВМ-180 ст.№3, ст.№4

ПЗ | Пояснительная записка
АК3 | Котел ПТВМ-180 №3. Автоматизация
ГС3 | Котел ПТВМ-180 №3. Газоснабжение.
АК4 | Котел ПТВМ-180 №4. Автоматизация
ГС4 | Котел ПТВМ-180 №4. Газоснабжение.
СМ | Котел ПТВМ-180 №4. Сметная документация

Обозначение | Наименование
| Проектируемый газопровод среднего давления.

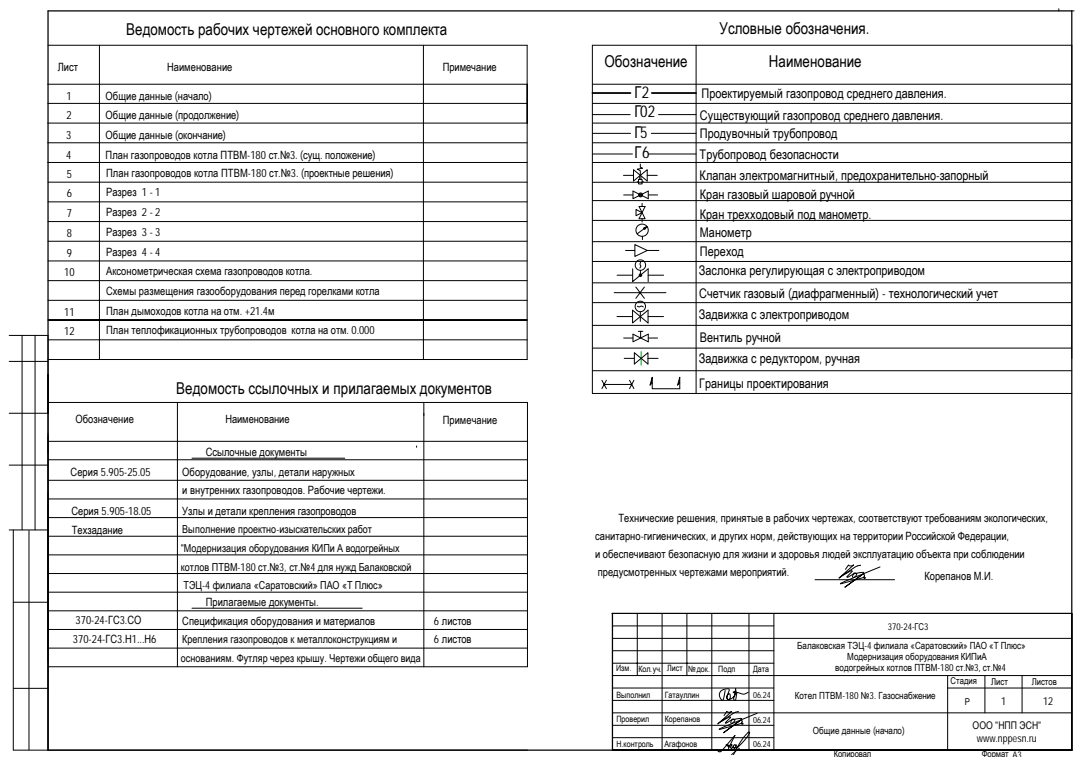
[picture p93: page 3]
Проверил; Корепанов; Н.контроль; Агафонов; Копировал; Формат A3; Корепанов М.И.; Условные обозначения.; Общие данные (продолжение); План газопроводов котла ПТВМ-180 ст.№3. (сущ. положение); Общие данные (окончание); Разрез 4 - 4; Разрез 1 - 1; Разрез 2 - 2; Разрез 3 - 3; Лист; Наименование; Примечание; Общие данные (начало)

Ведомость рабочих чертежей основного комплекта

Существующий газопровод среднего давления.

Г5 | Продувочный трубопровод
Г6 | Трубопровод безопасности

План газопроводов котла ПТВМ-180 ст.№3. (проектные решения)

Клапан электромагнитный, предохранительно-запорный
Кран газовый шаровой ручной
Кран трехходовый под манометр.
Манометр
Переход
Заслонка регулирующая с электроприводом
Счетчик газовый (диафрагменный) - технологический учет
Задвижка с электроприводом
Вентиль ручной
Задвижка с редуктором, ручная
Границы проектирования

Аксонометрическая схема газопроводов котла.
Схемы размещения газооборудования перед горелками котла
План дымоходов котла на отм. +21.4м
План теплофикационных трубопроводов котла на отм. 0.000

Ведомость ссылочных и прилагаемых документов

Обозначение | Наименование | Примечание

Ссылочные документы

Серия 5.905-25.05 | Оборудование, узлы, детали наружных

и внутренних газопроводов. Рабочие чертежи.

Серия 5.905-18.05 | Узлы и детали крепления газопроводов
Техзадание | Выполнение проектно-изыскательских работ

Технические решения, принятые в рабочих чертежах, соответствуют требованиям экологических,
санитарно-гигиенических, и других норм, действующих на территории Российской Федерации,
и обеспечивают безопасную для жизни и здоровья людей эксплуатацию объекта при соблюдении
предусмотренных чертежами мероприятий.

"Модернизация оборудования КИПи А водогрейных
котлов ПТВМ-180 ст.№3, ст.№4 для нужд Балаковской
ТЭЦ-4 филиала «Саратовский» ПАО «Т Плюс»
Прилагаемые документы.

370-24-ГС3.СО | Спецификация оборудования и материалов | 6 листов
370-24-ГС3.Н1...Н6 | Крепления газопроводов к металлоконструкциям и | 6 листов

Балаковская ТЭЦ-4 филиала «Саратовский» ПАО «Т Плюс» Модернизация оборудования КИПиА водогрейных котлов ПТВМ-180 ст.№3, ст.№4

основаниям. Футляр через крышу. Чертежи общего вида

Изм. | Кол. уч. | Лист | №док. | Подп | Дата

Котел ПТВМ-180 №3. Газоснабжение | Стадия | Лист | Листов

Выполнил | Гатауллин | | 06.24 | | Р | | 121

ООО "НПП ЭСН"
www.nppesn.ru

Общие данные (начало)

## Общие данные (продолжение)

## Балаковская ТЭЦ-4 филиала «Саратовский» ПАО «

## Т Плюс»

## Эксплуатирующая организация: филиал АО "РИР", г.Москва

## 19. Сведения об ОПО: Адрес расположения Удмуртская Республика, г.Глазов, ул. Белова, д.7

## пристроенное, расположено

в корпусе 4/Т, пристроенное к корпусу 1/Т.

класс опасности – III (опасный производственный объект средней опасности). Помещение котельной более 115 градусов Цельсия. Сама площадка главного корпуса, согласно свидетельству ОПО имеет работающего под избыточным давлением более 0,07 мегапаскаля: для воды при температуре нагрева

## на котел ПТВМ-100 ст.№16 (расположенный

## в корпусе 1/Т) -2.2

т.е использование оборудования,

## «Площадка главного корпуса ТЭЦ», числовое обозначение признака опасности

## - контролю физическими методами, согласно - п. 10.4.1, Таблица 14*

## - испытания на прочность

## и герметичность согласно - п. 10.5.7, Таблица 16*

## Основные показатели сети газопотребления

## Испытания газопроводов

## и контроль качества работ производить

## в соответствии

## с СП 62.13330.2011

## 17. Для присоединения муфтовой арматуры должны применяться соединительные

части трубопроводов по ГОСТ 8966-75, ГОСТ 8968-75, ГОСТ 8969-75.

16. Крепление продувочных газопроводов, и трубопроводов безопасности производится к существующим

## металлоконструкциям колонн, балок

и существующим опорам газопроводов.

## 15. Продувочные газопроводы должны иметь минимальное количество поворотов и выводиться за пределы здания не менее чем на 1

м выше карниза крыши.

## 14. Допускается использование существующих участков газопроводов, фасонных деталей

## и опор под ними, если имеются

## в наличии сертификаты на материалы, из которых изготовлены эти участки, а также имеются положительные результаты

## класса "

## В" ГОСТ

Р 54809.2011.

## в соответствии

с требованиями СП 62.13330.2011 Газораспределительные системы.

## соединения газопроводов

## в объеме 100%. Объем контроля физическими методами

## 10.Визуальному

## и измерительному контролю

## и испытаниям подлежат все сварные

## соединений

и сварных стыков должны быть не менее 100 мм.

## шаг между опорами должен быть не более 3

## м. Расстояния от края опор до фланцевых

## указаниями на рабочих чертежах. При этом для газопроводов диаметром до DN 100 мм

## 13. Крепление газопроводов должно производиться на опорах (подвесках) в соответствии

с

## "Общие положения по проектированию

## и строительству газораспределительных

## 12. Продувочные газопроводы проложить

## с учетом требований п.6.13 СП 42-101-2003

## 11. Газопроводы диаметром DN 50 мм

## и менее проложить по месту, а запорную арматуру, расположенную на этих газопроводах, расположить

## в местах, удобных

## 9. Для сварки газопроводов применять электроды типа

Э 46,

Э 46А ГОСТ 9466-75.

## систем из металлических

и полиэтиленовых труб".

соответствовать требованиям ГОСТ 16037-80.

для обслуживания.

Проверил | Корепанов | 06.24
| | 06.24

Н.контроль

Агафонов

Изм. | Кол. уч. | Лист | №док. | Подп | Дата
| | | | Котел ПТВМ-180 №3. Газоснабжение | Стадия ЛистовЛист
Выполнил | Гатауллин | | 06.24 | | Р 2

## применения

## и исполнения Технического регламента

## о безопасности сетей

## из металлических труб, а также другим нормативным документам, необходимым для

## и полиэтиленовых труб, СП 42-102-2004 Проектирование

## и строительство газопроводов

## по проектированию

## и строительству газораспределительных систем из металлических

## актуализированной редакции СНиП 42-01-2002, СП 42-101-2003 Общие положения

газопотребления, требованиям СП 62.13330.2011 Газораспределительные системы,

## и газопотребления, Правилам безопасности сетей газораспределения

и

## требованиям Технического регламента

## о безопасности сетей газораспределения

## 5. Правила производства работ, приемки

## и испытаний должны соответствовать

## 6. Допускается использование труб, разрешенных к применению

## в соответствии

## ГОСТ 6465-76 желтого цвета по грунтовке ГФ-021 ГОСТ 25129-82

## с последующим

## 7. После монтажа

## и проведения испытаний газопроводы покрыть эмалью ПФ-115

нанесением предупреждающих колец эмалью красного цвета.

## Количество колец

## и расстояние между ними должны соответствовать требованиям

## 8. Типы

## и конструктивные параметры сварных соединений газопроводов должны

## газораспределения

и газопотребления.

## с СП 42-102-2004 взамен, указанных

в спецификации.

ГОСТ 14202-69. | агрегата
Наименование помещения | Объем, 3 м | Наименование | Кол. | Расход газа, м /ч 3 | Давление газа | Приме-чание
| на котел | перед котлом,кПа на горелку
| | | | паспорт) | (по нагрузке)(
Котельный зал | ------ | ПТВМ-180 | 1 | | 21340 | 801067 | 20 горелок
| | ст.№ 3

## Регистрационный номер: Р 01-00120-0006

## "Газораспределительные системы"

## метичность затвора запорной арматуры на газопроводах должна быть не ниже

4. Герметичность затвора всех ПЗК должна соответствовать класу "А",

## а гер-

## 3. Качество газа, применяемого

## в виде топлива, должно соответствовать

## вают мероприятия, обеспечивающие взрывную, взрывопожарную

## и пожарную безо-

## вилами, стандартами, техническими условиями на присоединение

## и предусматри-

## 2. Рабочие чертежи разработаны

## в соответствии

## с действующими нормами, пра-

1. Исходными данными для разработки рабочих чертежей марки ГС являются - договор;

## -результаты обмерных работ, фото

и видеоматериалы.

требованиям ГОСТ 5542-2014.

пасность при эксплуатации здания (сооружения).

-техническое задание (приложение к договору);

## ОБЩИЕ УКАЗАНИЯ

## 18. Нормы испытательных давлений:

их диагностики.

## водогрейных котлов ПТВМ-180 ст.№3, ст.№

4

## Модернизация оборудования КИПиА

Копировал | Формат A3

370-24-ГС

3

Трубопроводы безопасности котла (левая и правая сторона) объединяются и выводятся из котельной (через отверстие в кровле, рядом с объединенным продувочным) на высоту не менее 1.0м выше кровли помещения котельного цеха. Прокладку этих трубопроводов (внутри котельной) выполнить с креплением к существующим металлоконструкциям опор котла и

перекрытия здания. Используемая арматура и оборудование на газопроводах обвязки котла - класса герметичности "А".

## Все газопроводы, продувочные трубопроводы и токоведущие части оборудования котельной

присоединить к контуру заземления.

## При прокладке газопровода через кровлю котельной предусмотрены футляры с заделкой пространства между газопроводом и футляром (см. чертежи 370-24-ГС3.Н1) Для регулировки системы дымоудаления, в верхней части котла производится замена МЭО

заслонок дымоходов, прямоугольного сечения.

## Для обслуживания общекотлового оборудования газопровода Dу400, от подъема после узла присоединения - в месте установки технологического учета газа, используется существующая

площадка, высотой 3,5м от ур.ч.пола. (+8.000).

## Подвод сжатого воздуха для продувки и опрессовки газопроводов предусматривается от

существующей системы подачи сжатого воздуха.

## Работа котельной предусматривается в автоматическом режиме с постоянно обслуживающим

персоналом.

## Электроды и сварочную проволоку подбирать в соответствии с маркой свариваемой стали и

технологией сварки.

## Организации, осуществляющей строительство газопровода, обеспечить контроль производства работ на всех стадиях (руководителями, специалистами и персоналом

лабораторий) в установленном порядке.

После монтажа и испытаний газопроводы очистить от ржавчины и грязи, покрыть эмалью ПФ-115 желтого цвета в два слоя по слою грунтовки ГФ-021 Устанавливаемое газовое оборудование и трубопроводная арматура примененное в проекте имеет документацию подтверждающее ее соответствие требованиям Технического регламента

Таможенного союза "О безопасности машин и оборудования" ТР ТС 010/2011.
Срок эксплуатации проектируемых внутренних участков газопроводов - 30 лет, проектируемого газооборудования - согласно паспортов заводов-производителей.

## Общие данные (окончание)

## Существующее положение:

В котельном цехе КТЦ Балаковской ТЭЦ-4 филиала «Саратовский» ПАО «Т Плюс», предусматривается модернизация оборудования КИПиА водогрейных котлов ПТВМ-180 ст.№3, ст.№4.

## Данным разделом рабочей документации рассматривается вновь устанавливаемое газооборудование

котла ПТВМ-180 ст.№3.

## Завод изготовитель котла – Белгородский котельный завод, дата ввода

в эксплуатацию – 1976г., инвентарный номер - №053400040414, заводской номер – ???. Топливопроводы на котле отсутствуют.

## Горелки котла МГМГ-10, в количестве – 20шт., остаются на месте (без изменений) Демонтируется существующая система газопотребления от существующей газовой задвижки с

ручным приводом, в котельном цехе, до горелок котла.

## Для регулирования подачи воздуха от 20 существующих вентиляторов на воздуховодах к горелкам установлены регулирующие заслонки, их исполнительные механизмы (МЭО) при этом

заменяются см.АК.
Тепловая производительность котла: 180 Гкал/час.

## Максимальное КПД котла: 93.3%

УРУТ на выработку тепла:150 кгут/Гкал.
Котел работает в отопительный период в основном режиме по двухходовой схеме.

## Рабочей документацией определены следующие решения по газоснабжению котла

природным газом,

От места присоединения - газопровод проложен открыто с подъемом вверх на отм. +11,5м. от ур.ч. п (0.000) Далее, для обеспечения безопасной эксплуатации и регулирования на подводящем газопроводе к котлу ПТВМ-180 ст.№3, на этом же уровне, последовательно устанавливается общие для котла: - Задвижка с электроприводом dу400 - Заглушка кольцо, поворотная dу400 - Диафрагменный расходомер (технологический учет газа) с прямыми участками dу400 - Общая на котел регулирующая заслонка dу300 с электроприводом

## После подводящий газовый коллектор dу400, поднимается вверх на отметку +15.1м от ур.ч.пола и прокладывается до фронта котла с креплением к его стальной колонне. От коллектора, на том же уровне, выполнены два ответвления к горелкам на левую и правую

сторону диаметрами 325х6 каждый.
На ответвлениях запроектированы газовые подводки диаметром 108х4 на все 20 горелок.

## Подводки к горелкам, включают в себя следущее газовое оборудование:

- Два предохранительно-запорных клапана (нормально закрытых) - ВН4Н-1П ст.

## - Регулирующую газовую заслонку ЗД-100 с электроприводом

- Автоматический клапан утечки (нормально открытый) ВФ1Н-4 ст. для газопровода безопасности

## (расположен между двумя ПЗК) и соединен с атмосферой - Запорная арматура и КИП

- Для росжига шести растопочных горелок котла с запально -защитными устройствами предусматрен подвод газопроводов dу20 с установленными на них муфтовыми электроманитными клапанами ВН 3/4Н-4 ст.
- На продувочных газопроводах котла (от коллектора котла) - предусмотрена установка автоматических электромагнитных клапанов ВН2Н-1П ст.
Н.контроль | Агафонов | 06.24
Проверил | Корепанов | 06.24
Изм. | Кол. уч. | Лист | №док. | Подп | Дата
| | | | Котел ПТВМ-180 №3. Газоснабжение | Стадия Лист Листов
Выполнил | Гатауллин | | 06.24 | | 3 Р

## ОБЩИЕ УКАЗАНИЯ (окончание)

Копировал | Формат A3

370-24-ГС3
Балаковская ТЭЦ-4 филиала «Саратовский» ПАО «Т Плюс» Модернизация оборудования КИПиА водогрейных котлов ПТВМ-180 ст.№3, ст.№4

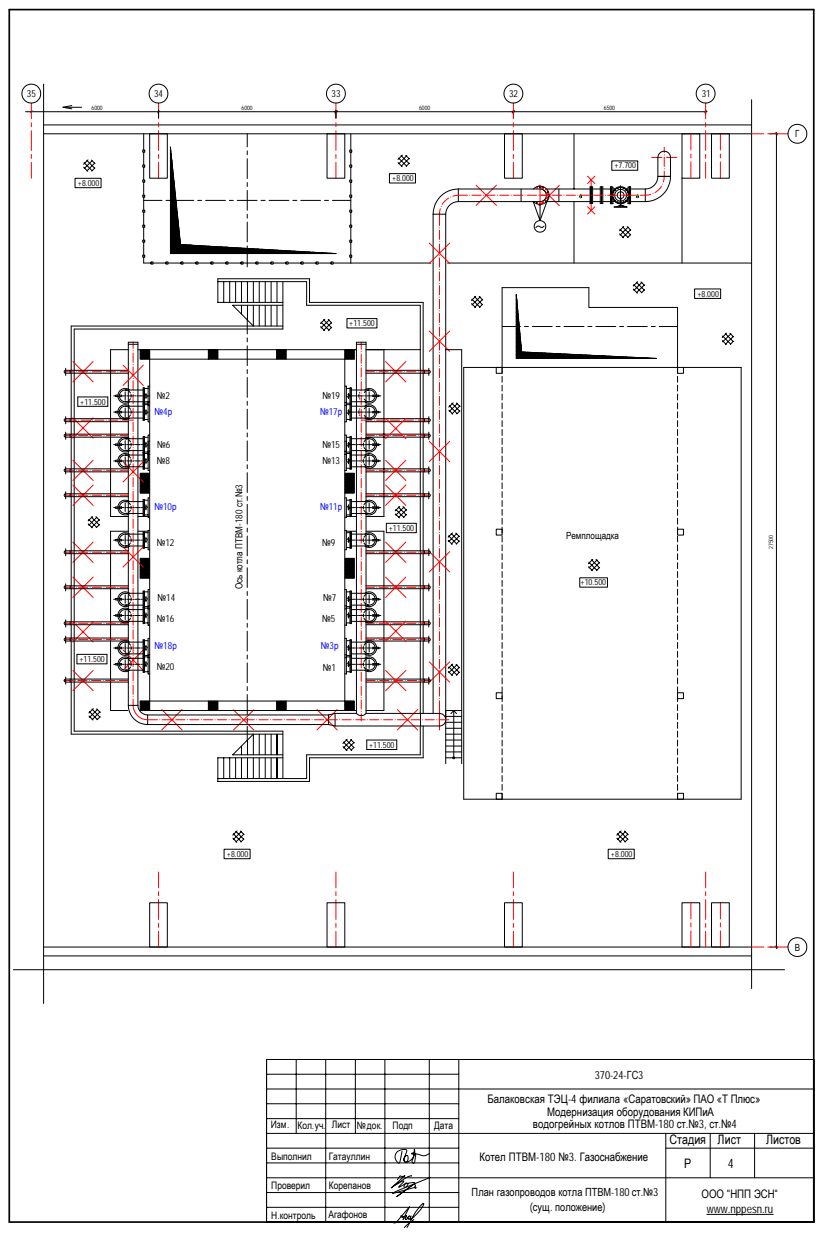
[picture p94: page 6]
Ось котла; ТВМ-180 ст.№; Корепанов; Проверил; Агафонов; (сущ. положение); Ремплощадка

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

Изм. | Кол. уч. | Лист | №док. | Подп | Дата

Котел ПТВМ-180 №3. Газоснабжение | Стадия Лист Листов

Выполнил | Гатауллин | | | | Р 4

План газопроводов котла ПТВМ-180 ст.№3

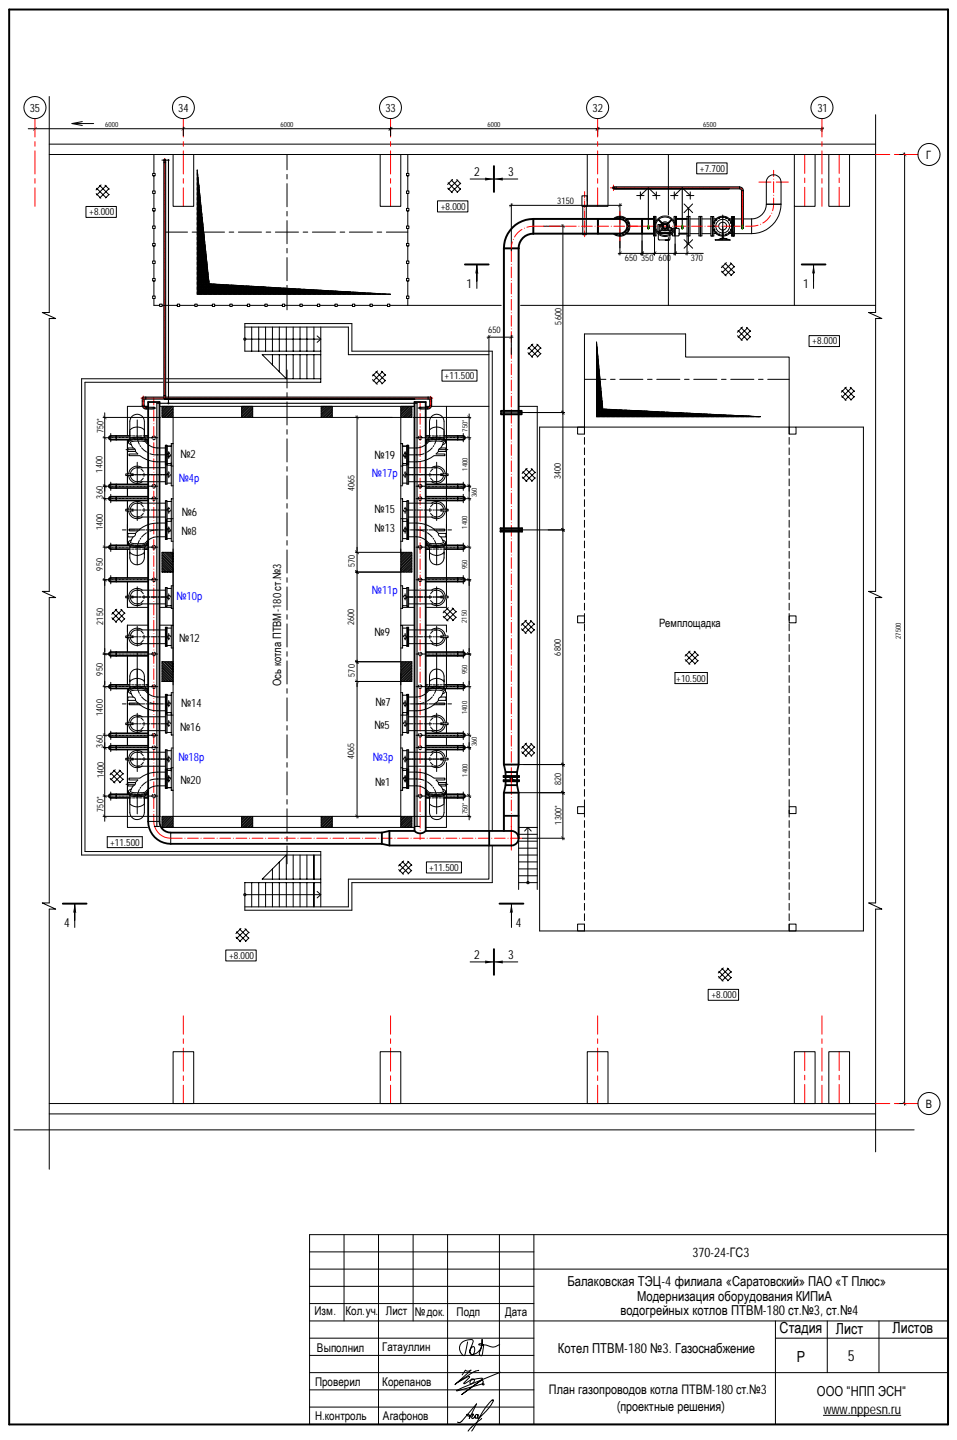
[picture p95: page 7]
Ось котла; ТВМ-180 ст.№; (проектные решения); Агафонов; Ремплощадка

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

Изм. | Кол. уч. | Лист | №док. | Подп | Дата

Стадия Лист Листов

Выполнил | Гатауллин

Котел ПТВМ-180 №3. Газоснабжение

Проверил | Корепанов

План газопроводов котла ПТВМ-180 ст.№3

d426х8

Г2

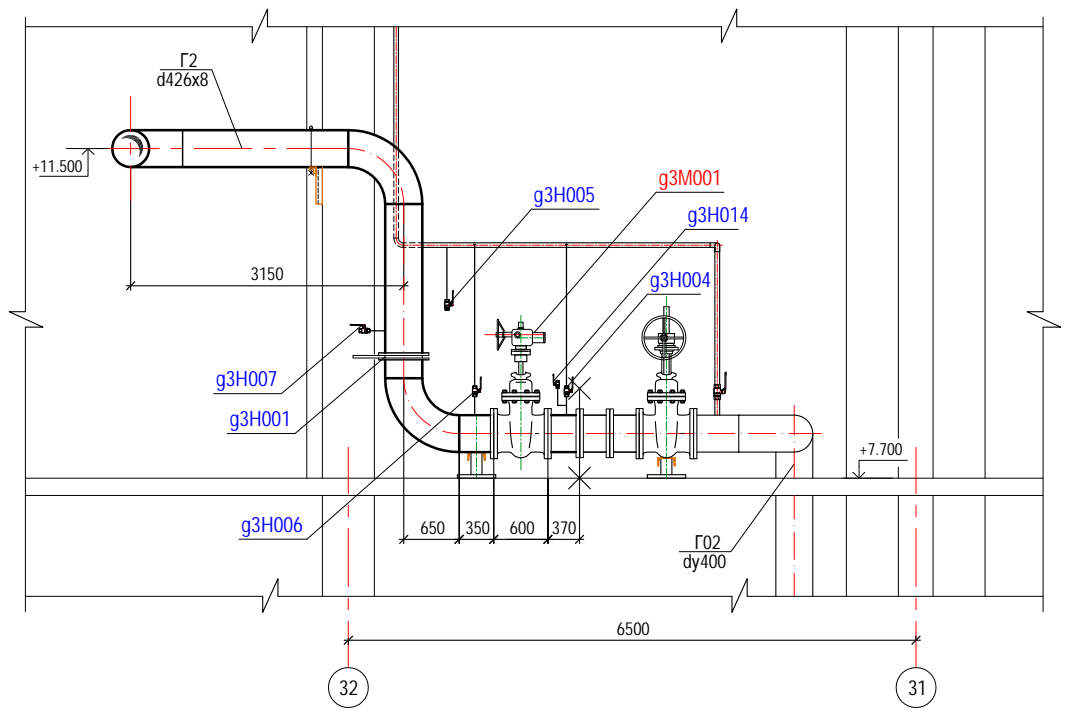
[picture p96: page 8]
Проверил; Корепанов; Н.контроль Агафонов; Разрез 1 - 1; ООО "НПП ЭСН" www.nppesn.ru; Копировал; Формат A3

Балаковская ТЭЦ-4 филиала «Саратовский» ПАО «Т Плюс» Модернизация оборудования КИПиА водогрейных котлов ПТВМ-180 ст.№3, ст.№4
Изм. | Кол. уч. Лист | №док. | Подп | Дата

Котел ПТВМ-180 №3. Газоснабжение | Стадия | | ЛистовЛист

Выполнил Гатауллин | | 06.24 | | Р | 6

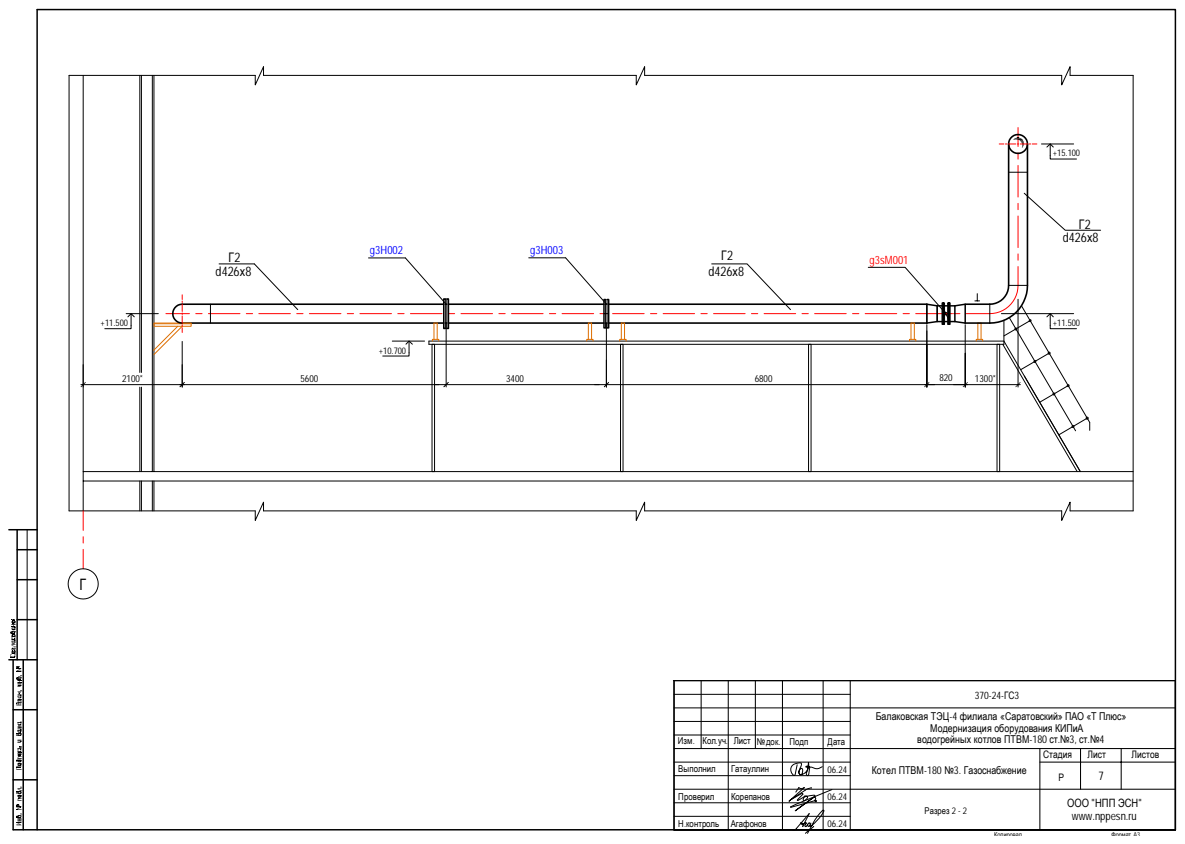
[picture p97: page 9]
Копировал; Формат A3

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

Изм. | Кол . уч. Лист | №док. | Подп | Дата
Котел ПТВМ-180 №3. Газоснабжение Разрез 2 - 2 | Стадия www.nppesn.ru Н.контроль Агафонов | ЛистовЛист
Выполнил Гатауллин | | 06.24

Проверил Корепанов | 06.24
06.24

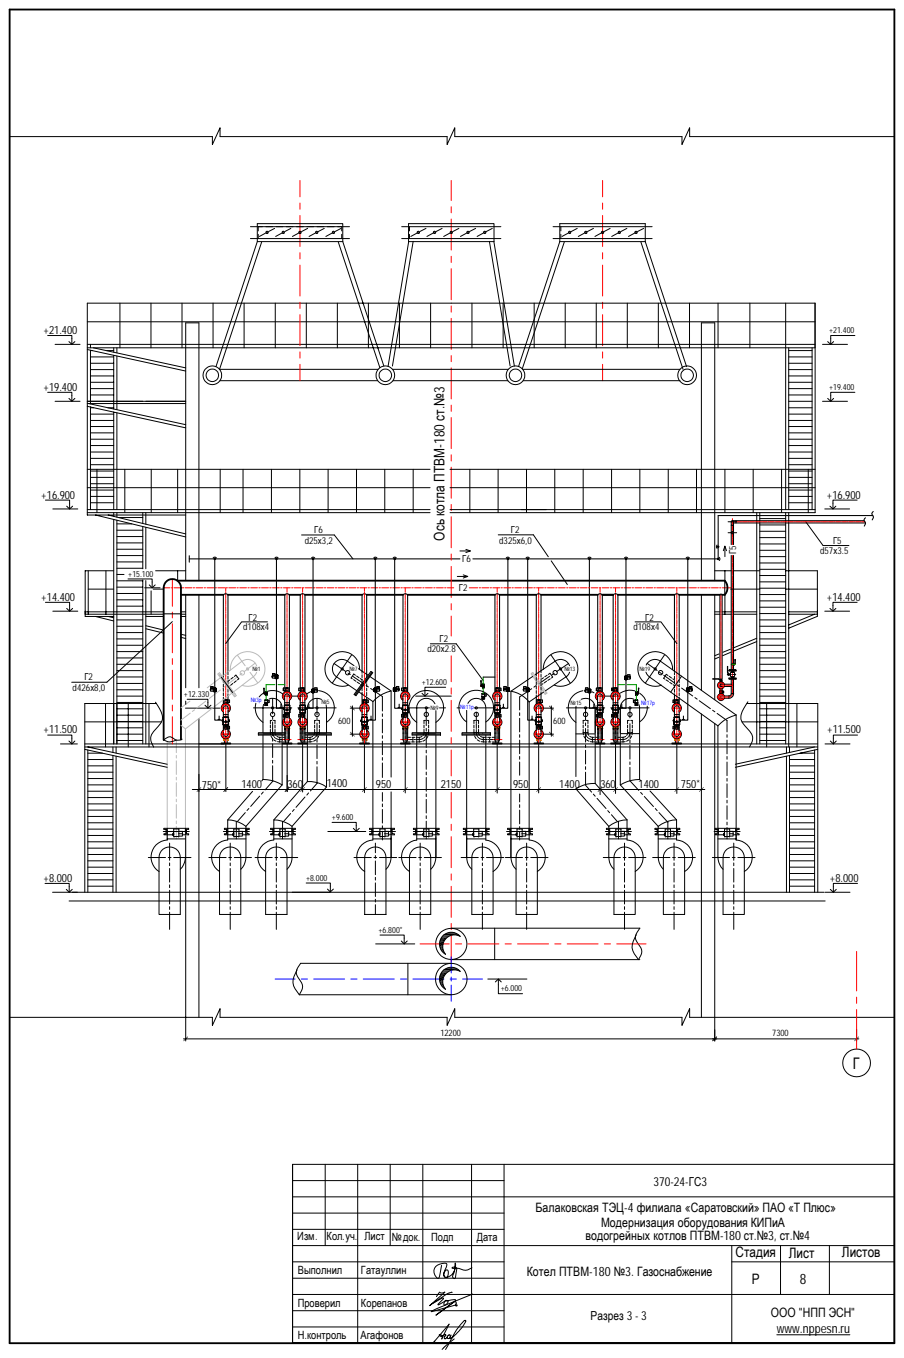
[picture p98: page 10]
Агафонов; Ось ко

тла ПТВМ-180 ст.№

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

Изм. | Кол. уч. | Лист | №док. | Подп | Дата

Котел ПТВМ-180 №3. Газоснабжение | Стадия | Лист | Листов

Выполнил | Гатауллин | | | | Р | 8

Проверил | Корепанов

ООО "НПП ЭСН" Разрез 3 - 3

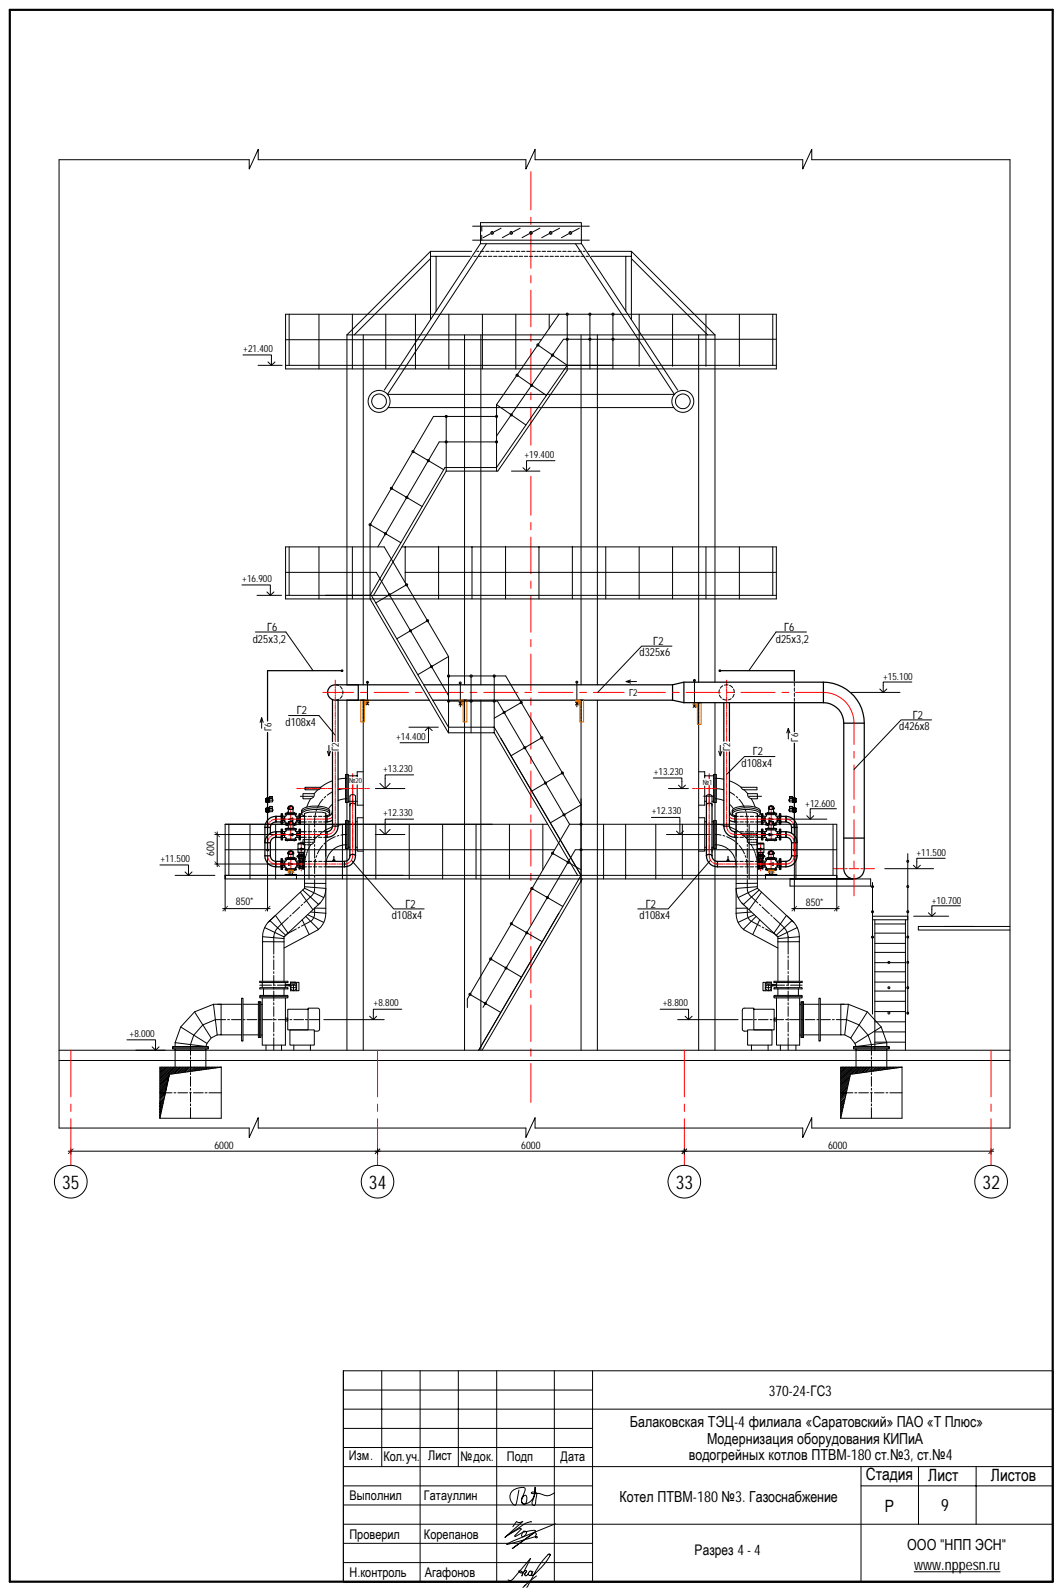
[picture p99: page 11]
Н.контроль Агафонов; Выполнил; Проверил; Корепанов; Гатауллин; Изм.; Кол. уч. Лист; №док.; Подп; Дата; Стадия; Лист; Листов

Балаковская ТЭЦ-4 филиала «Саратовский» ПАО «Т Плюс»

Модернизация оборудования КИПиА
водогрейных котлов ПТВМ-180 ст.№3, ст.№4

Котел ПТВМ-180 №3. Газоснабжение

ООО "НПП ЭСН" Разрез 4 - 4

## Узел I

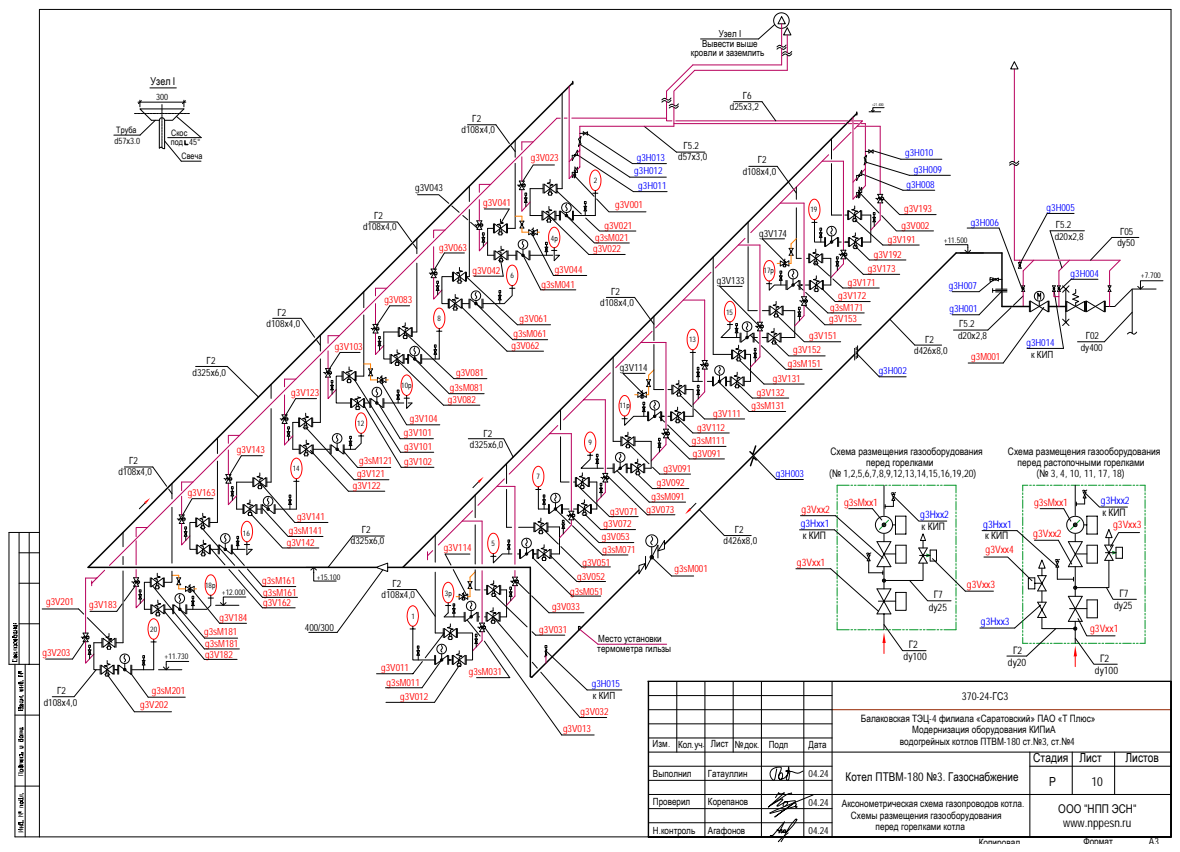
[picture p100: page 12]
термометра гильзы; Место установки; Проверил; к КИП; Агафонов; Корепанов; Копировал; g3Нхх3; Формат; g3Vхх1; g3sMхх1; к КИП g3Нхх1; g3Vхх2; g3Vхх4; g3Vхх3; g3Нхх2; g3Нхх1; перед горелками; Труба; Скос; под 45°; Свеча; кровли и заземлить; Узел I Вывести выше

Схема размещения газооборудования

перед растопочными горелками

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

Изм . | . Кол. уч | Лист | №док. | Подп | Дата

Котел ПТВМ-180 №3. Газоснабжение | Стадия ЛистовЛист

Выполнил | Гатауллин | | 04.24 | | Р 10

Аксонометрическая схема газопроводов котла.
Схемы размещения газооборудования
перед горелками котла

35 | 34 | 33

32

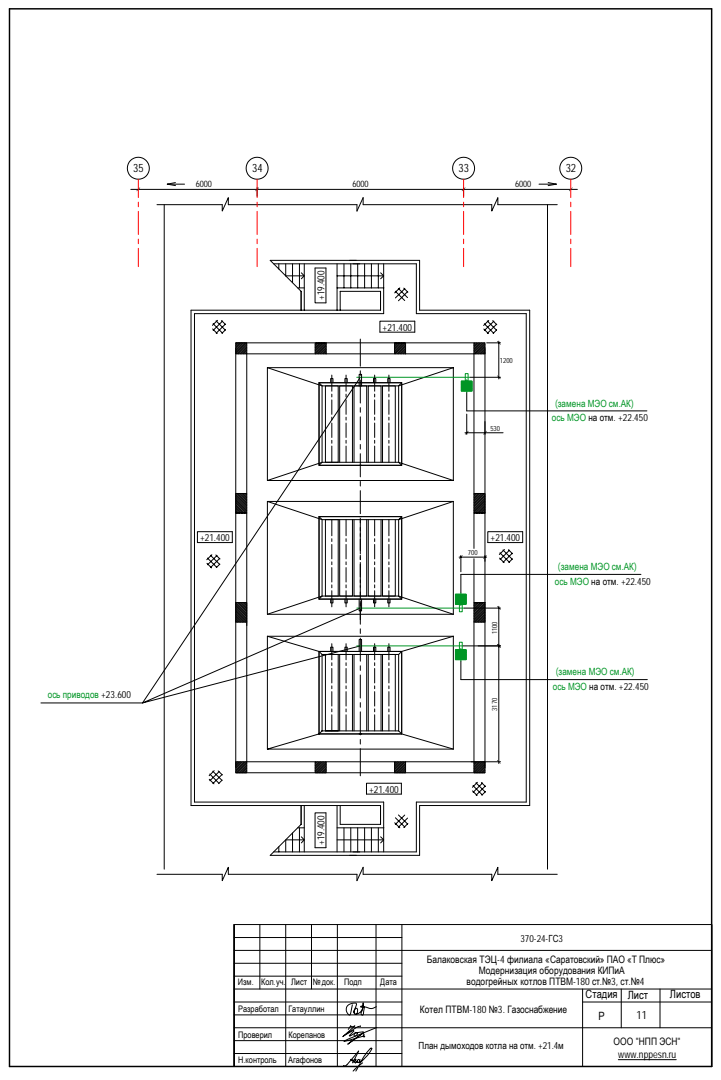
[picture p101: page 13]
Агафонов; Корепанов; Проверил; ось приводов +23.600

(замена МЭО см.АК)
ось МЭО на отм. +22.450

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

Изм. | Кол. уч. | Лист | №док. | Подп | Дата

Котел ПТВМ-180 №3. Газоснабжение | Стадия Лист Листов

Разработал | Гатауллин | | | | Р 11

План дымоходов котла на отм. +21.4м

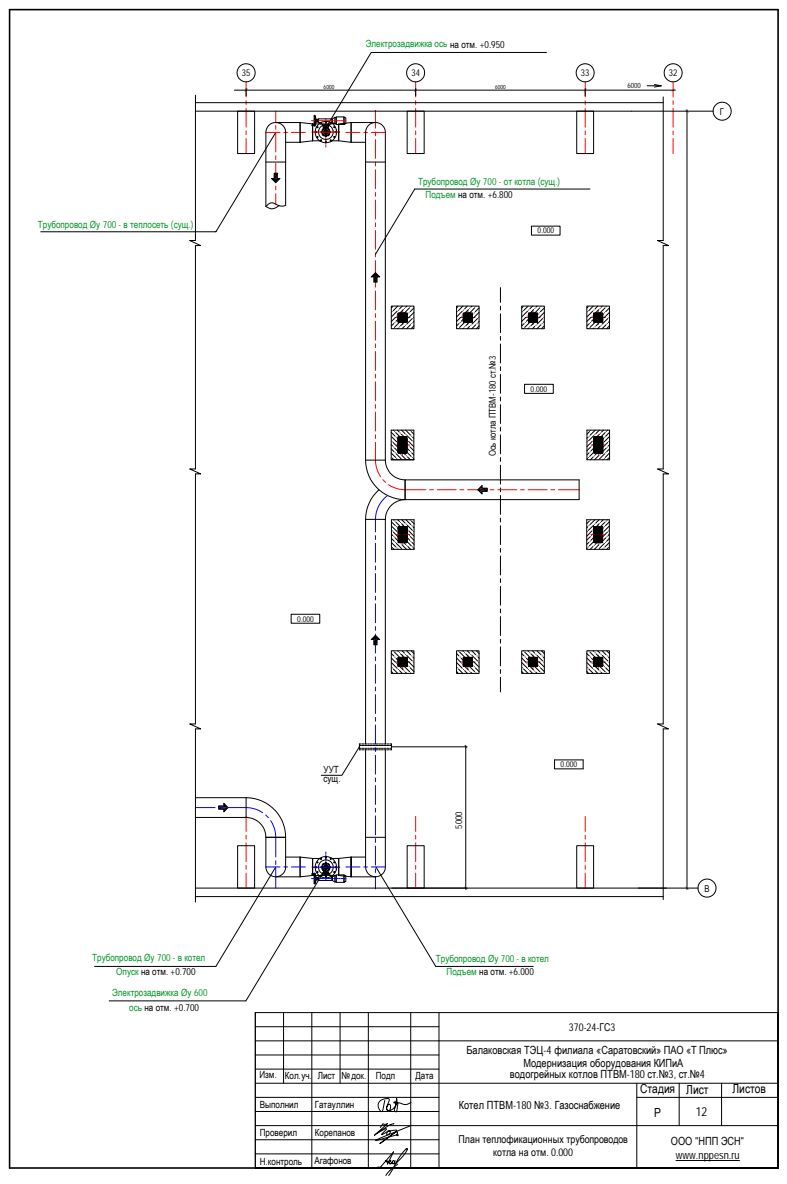
[picture p102: page 14]
Проверил; Корепанов; Н.контроль Агафонов; Дата; Выполнил; Изм.; Кол; Гатауллин; . уч. Лист; №док.; Подп; Стадия; Лист; Листов; Ось котла; ТВМ-180 ст.№; сущ.; УУТ

Электрозадвижка ось на отм. +0.950

Трубопровод Øу 700 - от котла (сущ.)
Подъем на отм. +6.800

Трубопровод Øу 700 - в теплосеть (сущ.)

Трубопровод Øу 700 - в котел
Опуск на отм. +0.700
Электрозадвижка Øу 600
ось на отм. +0.700

Подъем на отм. +6.000

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

Котел ПТВМ-180 №3. Газоснабжение

План теплофикационных трубопроводов
www.nppesn.ru котла на отм. 0.000

Изм. | Кол.уч. | Лист | № док. | Подп. | Дата
| | | | Котел ПТВМ-180 №3. Газоснабжение | Стадия | Лист | Листов
Гл.инженер | Корепанов | | 06.24 | | Р | 1 | 6

Инв. № подп. Взам. инв. №
Марка стали применяемых труб должна соответствовать СП 42-102-2004 "Проектирование и

и строительство газопроводов из металлических труб"
Нормы испытательных давлений принять согл. СП 62.13330.2011 п.10.5.7

06.24

Разработал

Агафонов

06.24
Гатауллин
Позиция | Наименование и техническая характеристика | Тип, марка, обозначение документа, опросного листа | Код оборудования, изделия, материала | | Единица изме-рения | Коли-чество | единицы, кг Завод-изготовитель | Примечание Масса
1 | 2 | 3 | 4 8 | 5 6 | | 7 9
| Общекотловое газовое оборудование:
g3M001 | Задвижка стальная клиновая фланцевая (с КОФ) общекотловая Dу 400 мм Pу 1,6 МПа с эл.приводом | 30с 941нж | | Южноураларматура, Миасс | компл | 1 | | в составе ПАК, см. АК
g3sM001 | Заслонка общекотловая стальная фланцевая (с КОФ) общекотловая Dу 150 мм Pу 0,6 МПа с эл.прив. | ЗР12-6В ПР ст. | | СП Термобрест | компл | 1 | | в составе ПАК, см. АК
g3V001(002) | Клапан стальной газовый НЗ Dу 50 мм, фланцевый (с КОФ), для продувки газопровода из тупика | ВН2Н-6Пст.фл | | СП Термобрест | компл | 2 | | в составе ПАК, см. АК
g3H001 | Заглушка-кольцо поворотная стальная Ду400 | АТК 26 -16-5-93, исп.1 | | Заречный Мехзавод, МО | шт | 1
g3H002 | Устройство подготовки потока УПП "Zаnker" с монтажным кольцом КМ-0,6-400-СГ | УПП-Д-400-А | | Сигнум, Пермь | компл | 1
g3H003 | Сужающее устройство в камерной диафрагме Ду200, межфланцевое (с КОФ) | ДКС-200-0,6-А/Б | | Сигнум, Пермь | компл | 1
g3H004 | Кран продувочный перед общей электрозадвижкой | КШЦМ Gas 020.040.Н/П.02 | | Челябинскспецгражданстрой | шт | 1
g3H005 | Кран отбора проб для продувки до и после электрозадвижки | КШЦМ Gas 020.040.Н/П.02 | | Челябинскспецгражданстрой | шт | 1
g3H006 | Кран продувочный после общей электрозадвижки | КШЦМ Gas 020.040.Н/П.02 | | Челябинскспецгражданстрой | шт | 1
g3H007 | Кран для продувки воздухом | КШЦМ Gas 020.040.Н/П.02 | | Челябинскспецгражданстрой | шт | 1
g3H008(011) | Кран продувочный в тупике коллектора в обход эл.клапана | КШ.Ц.Ф.GAS.050.040.Н/П.02 | | Челябинскспецгражданстрой | компл. | 2 | | в компл. с КОФ
g3H009(012) | Кран продувочный в тупике коллектора общий на тупик | КШ.Ц.Ф.GAS.050.040.Н/П.02 | | Челябинскспецгражданстрой | компл. | 2 | | в компл. с КОФ
g3H010(13) | Кран отбора проб для продувки в тупике коллектора | КШЦМ Gas 020.040.Н/П.02 | | Челябинскспецгражданстрой | компл. | 2
g3H014 | Кран группы измерения давления между задвижками | КШЦМ Gas 020.040.Н/П.02 | | Челябинскспецгражданстрой | шт | 1
g3H015 | Кран для установки датчика температуры | КШЦМ Gas 020.040.Н/П.02 | | Челябинскспецгражданстрой | шт | 1
g3H016 | Кран группы измерения давления после техн. узла учета газа | КШЦМ Gas 020.040.Н/П.02 | | Челябинскспецгражданстрой | шт | 1
| бобышка стальная для установки термометра | БП1 / М20х1,5 / 55 / Ст.20 | | | шт | 1

Спецификация оборудования и материалов

370-24-ГС3.СО

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

| Газовое оборудование на группу горелок:
g3V011 | Клапан ПЗК1 сталь., эл.магн., "НЗ", фланц. Ду100, Ру-0,6 МПа (с КОФ) на горелке №1 | ВН4Н-1П ст | СП Термобрест | компл | 1 | в составе ПАК, см. АК
g3V021 | Клапан ПЗК1 сталь., эл.магн., "НЗ", фланц. Ду100, Ру-0,6 МПа (с КОФ) на горелке №2 | ВН4Н-1П ст | СП Термобрест | компл | 1 | в составе ПАК, см. АК
| Клапан ПЗК1 сталь., эл.магн., "НЗ", фланц. Ду100, Ру-0,6 МПа (с КОФ) на горелке №3 g3V031 | ВН4Н-1П ст | СП Термобрест | компл | 1 | в составе ПАК, см. АК
g3V041 | Клапан ПЗК1 сталь., эл.магн., "НЗ", фланц. Ду100, Ру-0,6 МПа (с КОФ) на горелке №4 | ВН4Н-1П ст | СП Термобрест | компл | 1 | в составе ПАК, см. АК
g3V051 | Клапан ПЗК1 сталь., эл.магн., "НЗ", фланц. Ду100, Ру-0,6 МПа (с КОФ) на горелке №5 | ВН4Н-1П ст | СП Термобрест | компл | 1 | в составе ПАК, см. АК
g3V061 | Клапан ПЗК1 сталь., эл.магн., "НЗ", фланц. Ду100, Ру-0,6 МПа (с КОФ) на горелке №6 | ВН4Н-1П ст | СП Термобрест | компл | 1 | в составе ПАК, см. АК
g3V071 | Клапан ПЗК1 сталь., эл.магн., "НЗ", фланц. Ду100, Ру-0,6 МПа (с КОФ) на горелке №7 | ВН4Н-1П ст | СП Термобрест | компл | 1 | в составе ПАК, см. АК
g3V081 | Клапан ПЗК1 сталь., эл.магн., "НЗ", фланц. Ду100, Ру-0,6 МПа (с КОФ) на горелке №8 | ВН4Н-1П ст | СП Термобрест | компл | 1 | в составе ПАК, см. АК
g3V091 | Клапан ПЗК1 сталь., эл.магн., "НЗ", фланц. Ду100, Ру-0,6 МПа (с КОФ) на горелке №9 | ВН4Н-1П ст | СП Термобрест | компл | 1 | в составе ПАК, см. АК
g3V101 | Клапан ПЗК1 сталь., эл.магн., "НЗ", фланц. Ду100, Ру-0,6 МПа (с КОФ) на горелке №10 | ВН4Н-1П ст | СП Термобрест | компл | 1 | в составе ПАК, см. АК
g3V111 | Клапан ПЗК1 сталь., эл.магн., "НЗ", фланц. Ду100, Ру-0,6 МПа (с КОФ) на горелке №11 | ВН4Н-1П ст | СП Термобрест | компл | 1 | в составе ПАК, см. АК
g3V121 | Клапан ПЗК1 сталь., эл.магн., "НЗ", фланц. Ду100, Ру-0,6 МПа (с КОФ) на горелке №12 | ВН4Н-1П ст | СП Термобрест | компл | 1 | в составе ПАК, см. АК
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
