nppesnteam/370-24_Balakovo_PTVM180_-3-4/370-24_балаково_птвм180n3n4_ак3_240819.pdf

# Балаковская ТЭЦ-4 филиала «Саратовский» ПАО «Т Плюс»

# Модернизация оборудования КИПиА водогрейных котлов ПТВМ-180 ст.№3, ст.№4

# Заказчик: филиал «Саратовский» ПАО «Т Плюс»

Главный инженер проекта | /Корепанов М.И./
370-24-АК3 | Котел ПТВМ-180 №3. Автоматизация котла

# Проектная организация: ООО НПП "Энергосервисналадка", г.Ижевск, nppesn.ru, ИНН 1832097973

Регистрационный номер 1083 в реестре Ассоциации Саморегулируемой организации "Национальное объединение научно-исследовательских и проектно-изыскательских организаций" Ассоциация СРО "Центрстройпроект", регистрационный номер в государственном реестре саморегулируемых организаций СРО-П-029-25092009)

# Состав рабочей документации, шифр 370-24, стадия «РД»

## Объект: Балаковская ТЭЦ-4 филиала «Саратовский» ПАО «Т Плюс»

Стройка: Модернизация оборудования КИПиА водогрейных котлов ПТВМ-180 ст.№3, ст.№4

ПЗ | Пояснительная записка
АК3 | Котел ПТВМ-180 №3. Автоматизация
ГС3 | Котел ПТВМ-180 №3. Газоснабжение.
АК4 | Котел ПТВМ-180 №4. Автоматизация
ГС4 | Котел ПТВМ-180 №4. Газоснабжение.
СМ | Котел ПТВМ-180 №4. Сметная документация

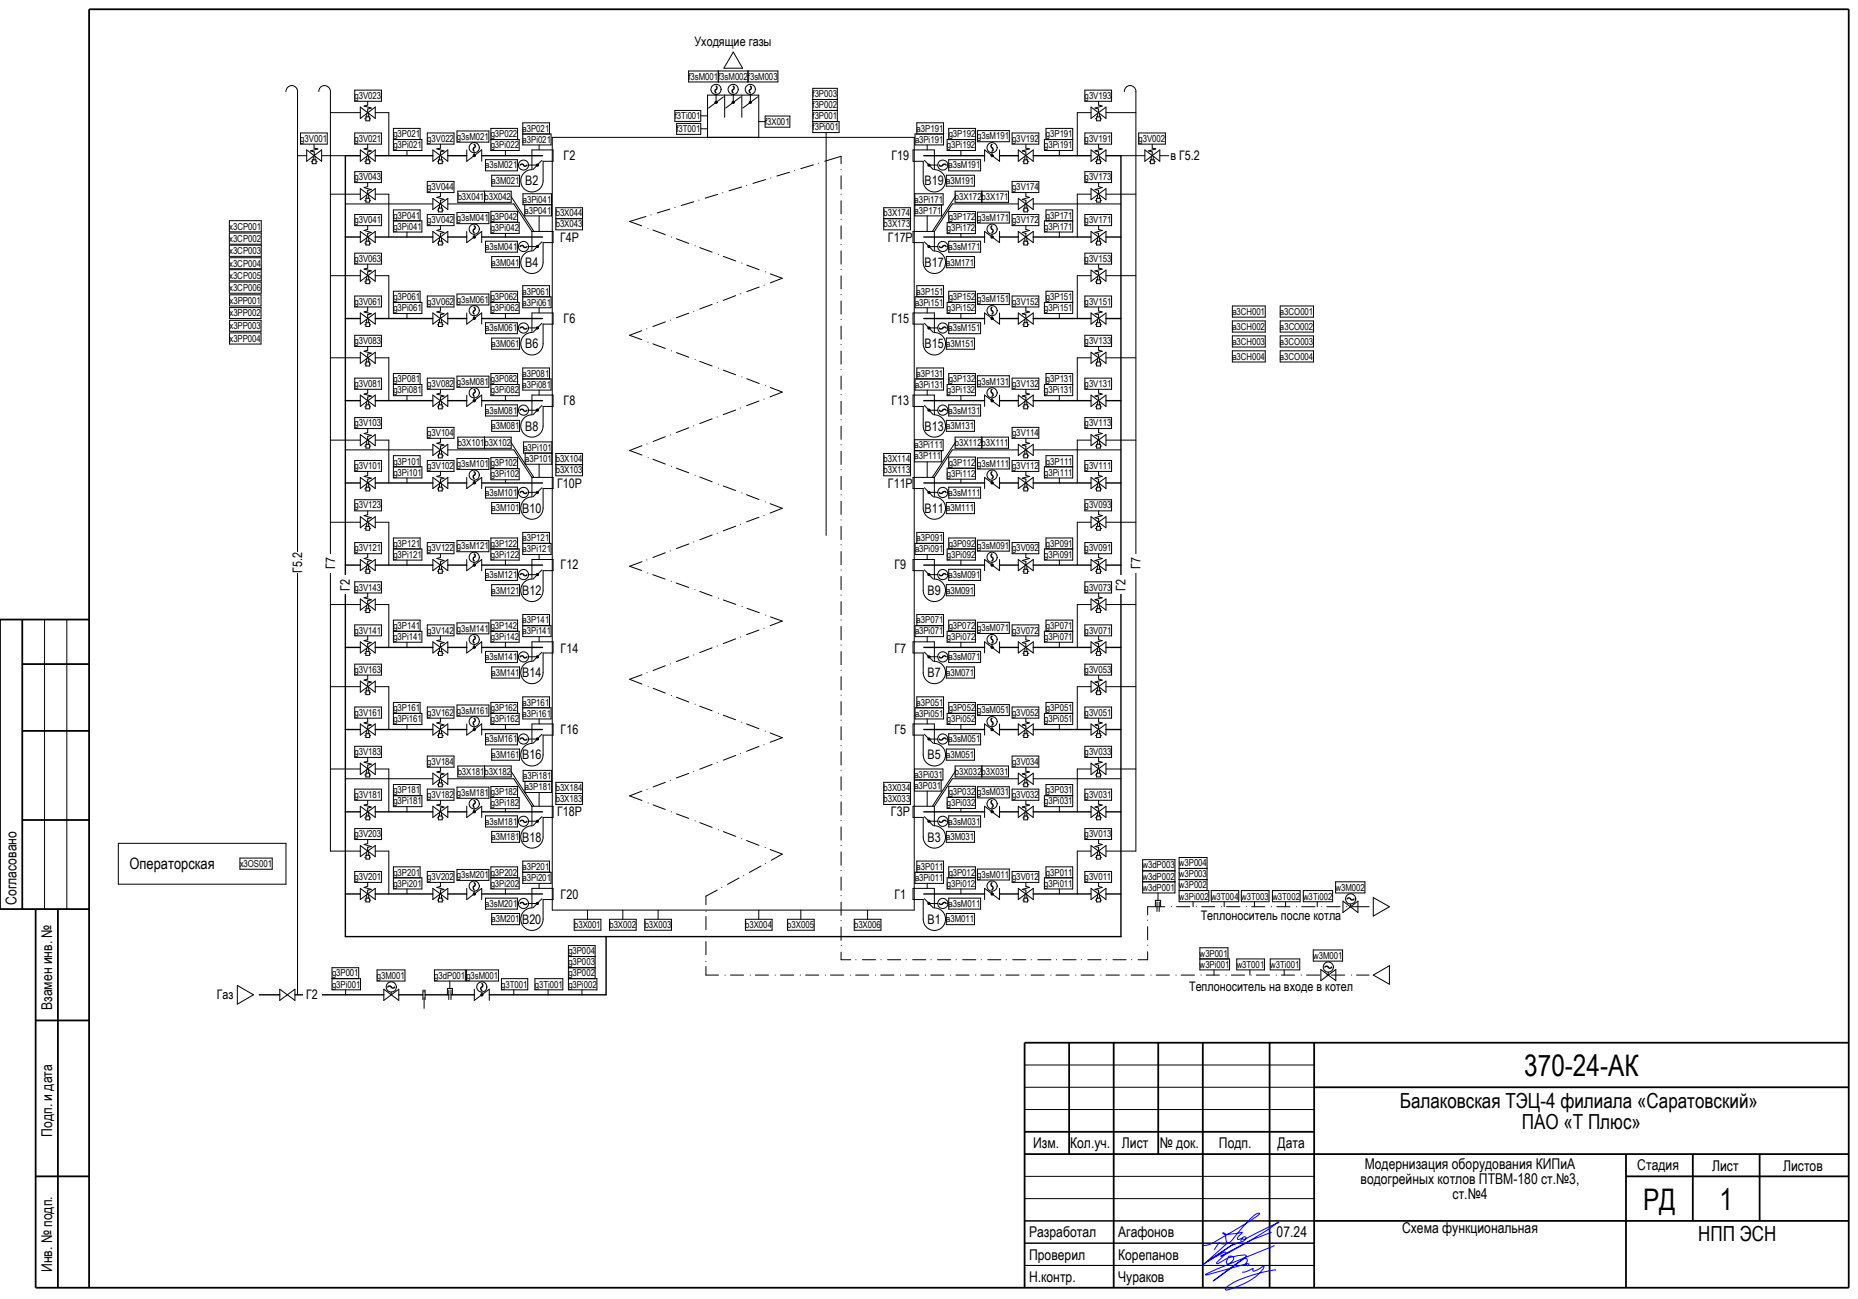
[picture p103: page 3]
Согласовано; Газ; Уходящие газы; Операторская

Теплоноситель после котла

Инв. № подп. Подп. и дата Взамен инв. №

Теплоноситель на входе в котел

Балаковская ТЭЦ-4 филиала «Саратовский» ПАО «Т Плюс»

Изм. | Кол.уч. | Лист | № док. | Подп. | Дата

Модернизация оборудования КИПиА водогрейных котлов ПТВМ-180 ст.№3, ст.№4 | Стадия | Лист | Листов

Разработал | Агафонов | | | Схема функциональная | НПП ЭСН
Проверил | Корепанов
Н.контр. | Чураков

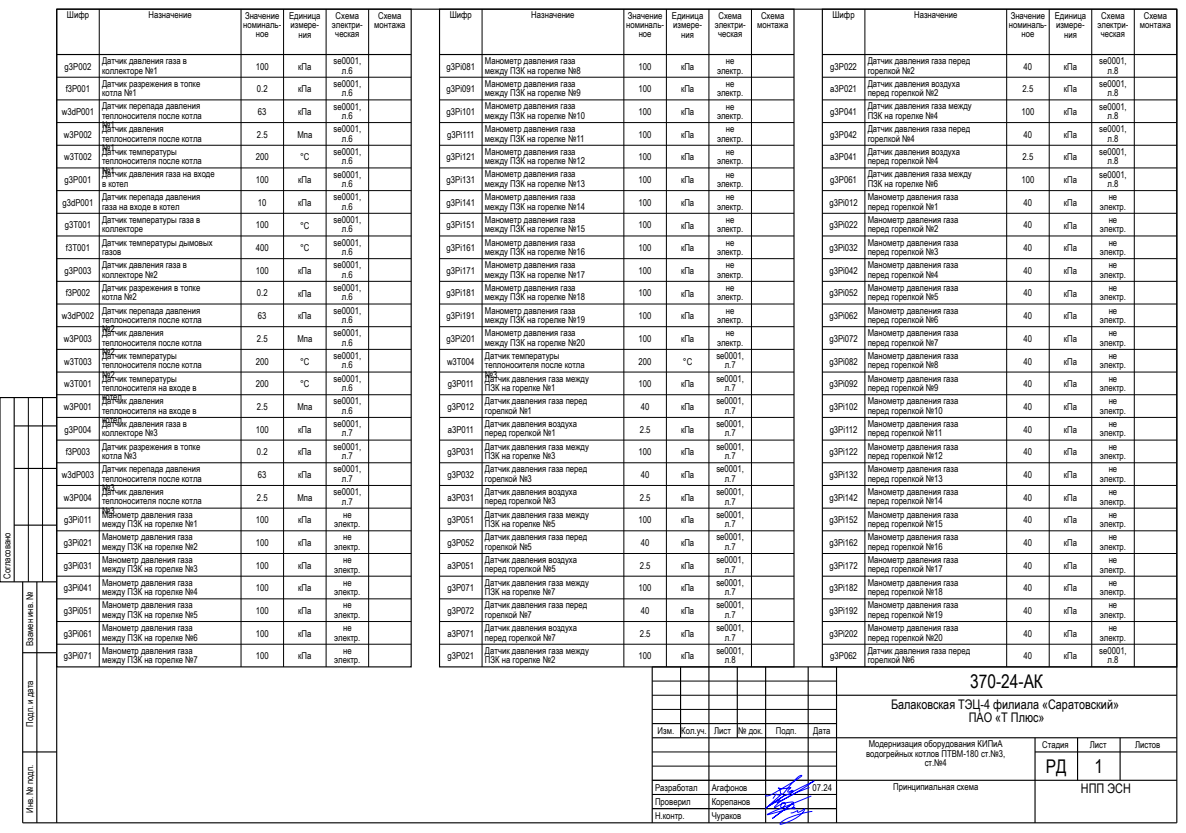
[picture p104: page 4]
Согласовано; Шифр; Назначение; Значение; номиналь- ное; Единица измере- ния; Схема электри- ческая; Схема монтажа; Датчик давления газа в; коллекторе №1; л.6 кПа; Датчик разрежения в топке; котла №1; Датчик перепада давления; Датчик давления; л.6 Мпа; Датчик температуры; Датчик давления газа на входе; в котел; газа на входе в котел; Датчик температуры газа в; коллекторе; Датчик температуры дымовых; газов; коллекторе №2; котла №2; коллекторе №3; л.7 кПа; котла №3; л.7 Мпа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

теплоносителя после котла

ПЗК на горелке №4

ПЗК на горелке №6

теплоносителя на входе в
котел

Инв. № подп. Подп. и дата Взамен инв. №

Балаковская ТЭЦ-4 филиала «Саратовский» ПАО «Т Плюс»

Изм. | Кол.уч. | Лист | № док. | Подп. | Дата

Модернизация оборудования КИПиА водогрейных котлов ПТВМ-180 ст.№3, ст.№4 | Стадия | Лист | Листов

Принципиальная схема | НПП ЭСН

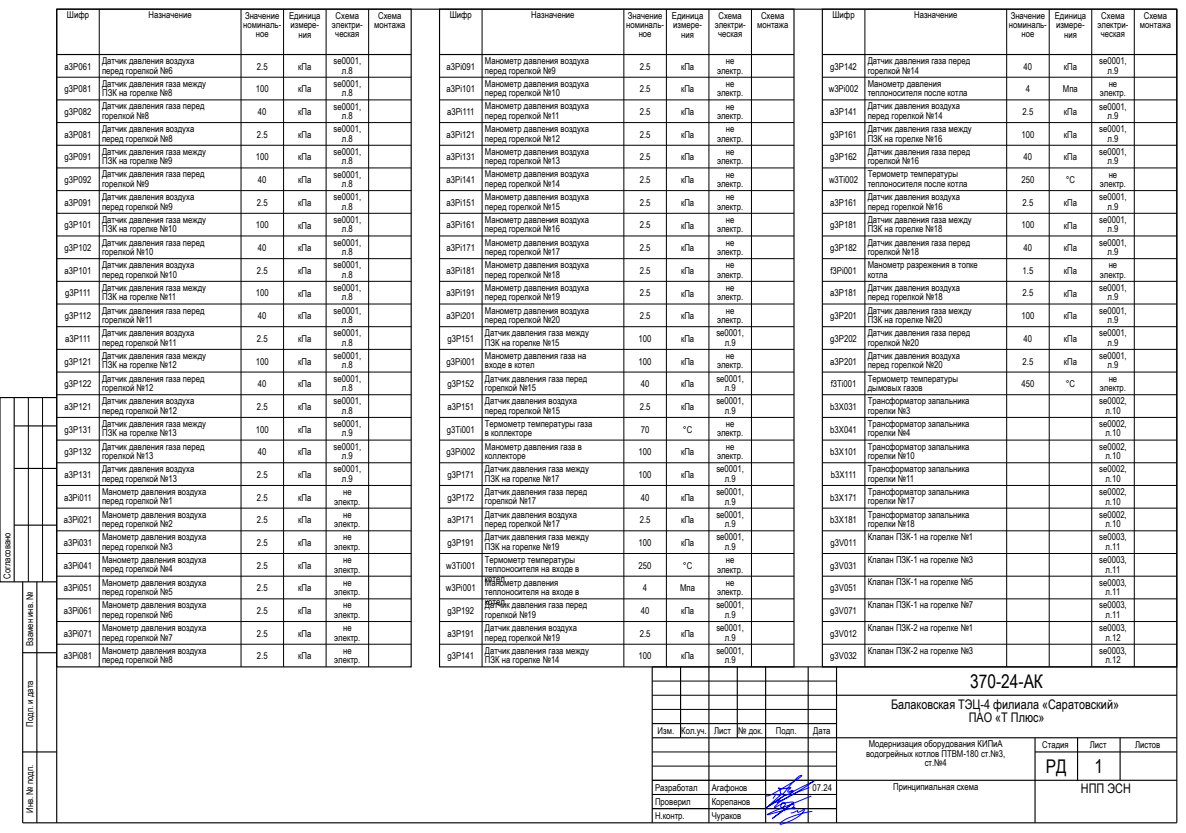
[picture p105: page 5]
Согласовано; Шифр; Назначение; Значение; номиналь- ное; Единица измере- ния; Схема электри- ческая; Схема монтажа; Датчик давления воздуха; перед горелкой №6; л.8 кПа; Датчик давления газа между; ПЗК на горелке №8; Датчик давления газа перед; горелкой №8; перед горелкой №8; ПЗК на горелке №9; горелкой №9; перед горелкой №9; ПЗК на горелке №10; горелкой №10; перед горелкой №10; ПЗК на горелке №11; горелкой №11; перед горелкой №11; ПЗК на горелке №12; горелкой №12; перед горелкой №12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

теплоносителя после котла

ПЗК на горелке №16

ПЗК на горелке №18

ПЗК на горелке №20

теплоносителя на входе в
котел

Инв. № подп. Подп. и дата Взамен инв. №

Балаковская ТЭЦ-4 филиала «Саратовский» ПАО «Т Плюс»

Изм. | Кол.уч. | Лист | № док. | Подп. | Дата

Модернизация оборудования КИПиА водогрейных котлов ПТВМ-180 ст.№3, ст.№4 | Стадия | Лист | Листов

Принципиальная схема | НПП ЭСН

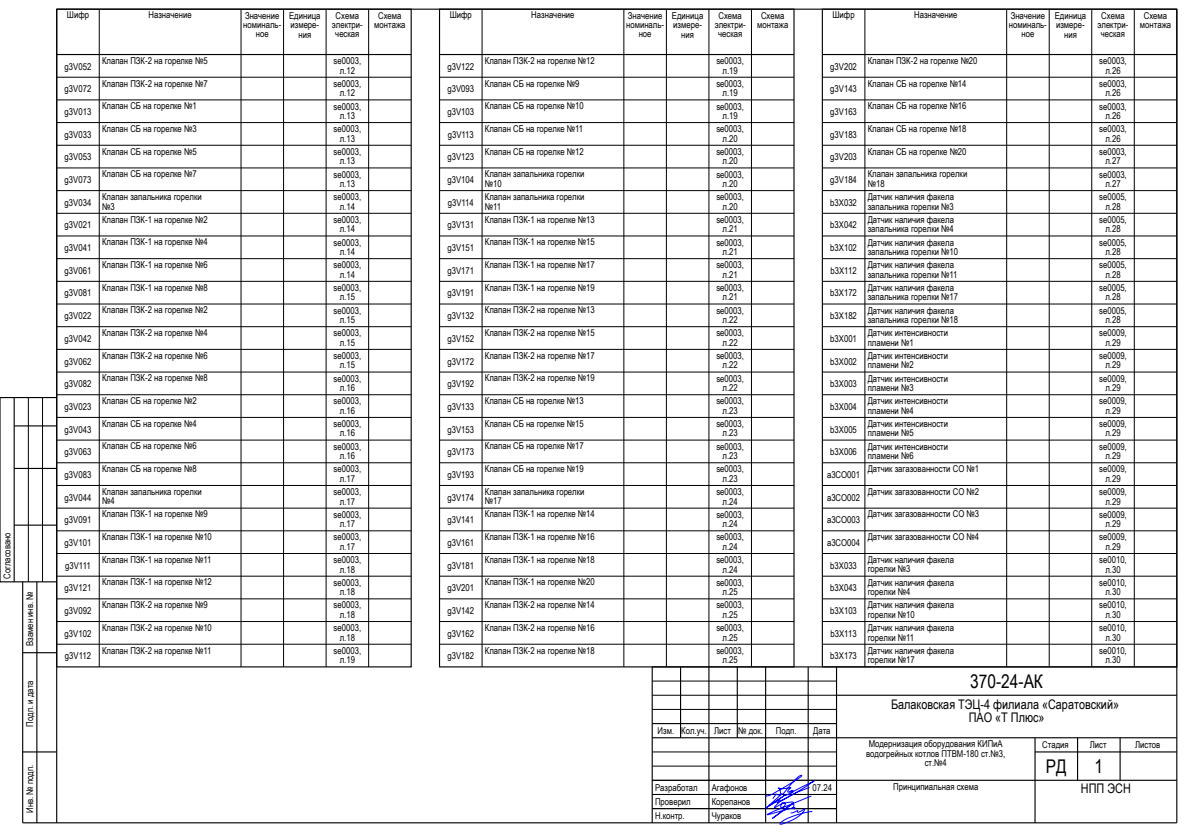
[picture p106: page 6]
Согласовано; Шифр; Назначение; Значение; номиналь- ное; Единица измере- ния; Схема электри- ческая; Схема монтажа; Клапан ПЗК-2 на горелке №5; Клапан ПЗК-2 на горелке №7; Клапан СБ на горелке №1; Клапан СБ на горелке №3; Клапан СБ на горелке №5; Клапан СБ на горелке №7; Клапан запальника горелки; Клапан ПЗК-1 на горелке №2; Клапан ПЗК-1 на горелке №4; Клапан ПЗК-1 на горелке №6; Клапан ПЗК-1 на горелке №8; Клапан ПЗК-2 на горелке №2; Клапан ПЗК-2 на горелке №4; Клапан ПЗК-2 на горелке №6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

Инв. № подп. Подп. и дата Взамен инв. №

Балаковская ТЭЦ-4 филиала «Саратовский» ПАО «Т Плюс»

Изм. | Кол.уч. | Лист | № док. | Подп. | Дата

Модернизация оборудования КИПиА водогрейных котлов ПТВМ-180 ст.№3, ст.№4 | Стадия | Лист | Листов

Принципиальная схема | НПП ЭСН

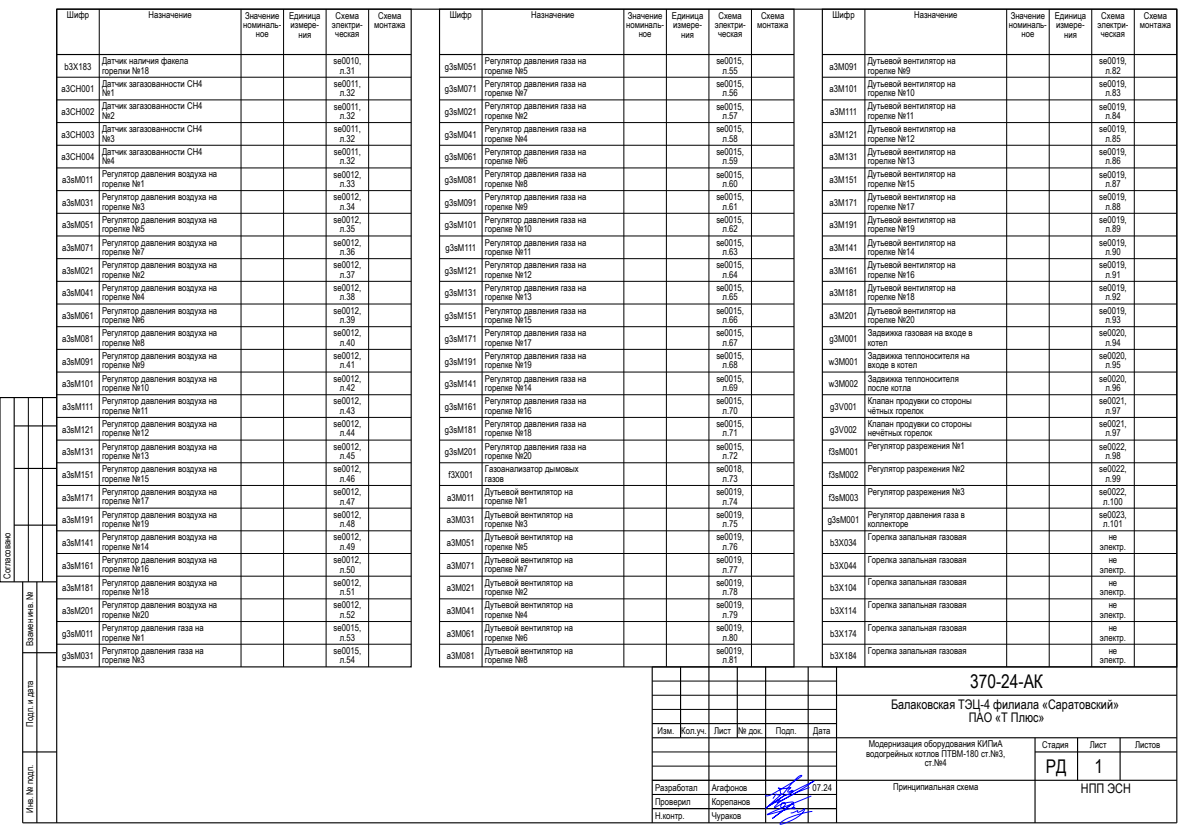
[picture p107: page 7]
Согласовано; Шифр; Назначение; Значение; номиналь- ное; Единица измере- ния; Схема электри- ческая; Схема монтажа; Датчик наличия факела; горелки №18; Датчик загазованности СН4; Регулятор давления воздуха на; горелке №1; горелке №3; горелке №5; горелке №7; горелке №2; горелке №4; горелке №6; горелке №8; горелке №9; горелке №10; горелке №11; горелке №12; горелке №13; горелке №15; горелке №17; горелке №19; горелке №14; горелке №16; горелке №18; горелке №20; Регулятор давления газа на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

Инв. № подп. Подп. и дата Взамен инв. №

Балаковская ТЭЦ-4 филиала «Саратовский» ПАО «Т Плюс»

Изм. | Кол.уч. | Лист | № док. | Подп. | Дата

Модернизация оборудования КИПиА водогрейных котлов ПТВМ-180 ст.№3, ст.№4 | Стадия | Лист | Листов

Принципиальная схема | НПП ЭСН

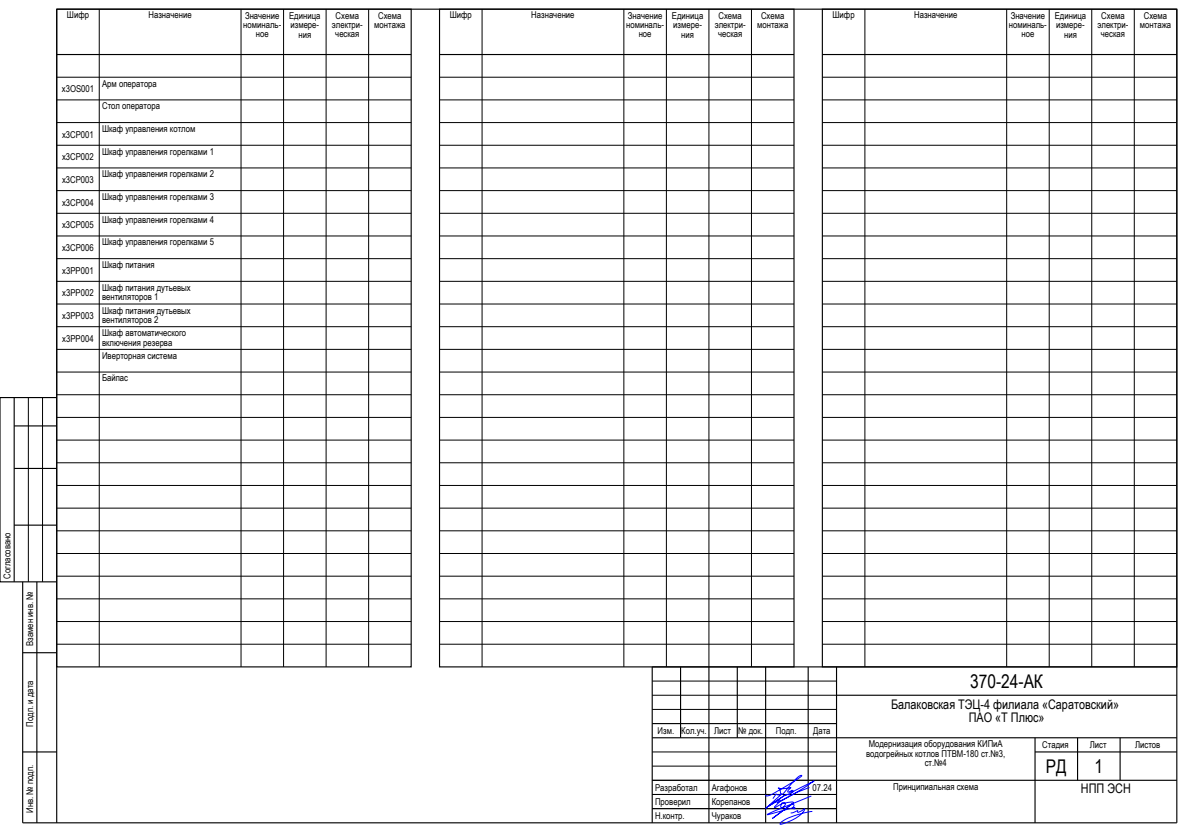
[picture p108: page 8]
Согласовано; Шифр; Назначение; Значение; номиналь- ное; Единица измере- ния; Схема электри- ческая; Схема монтажа; Арм оператора; Стол оператора; Шкаф управления котлом; Шкаф управления горелками 1; Шкаф управления горелками 2; Шкаф управления горелками 3; Шкаф управления горелками 4; Шкаф управления горелками 5; Шкаф питания; Шкаф питания дутьевых; вентиляторов 1; вентиляторов 2; Шкаф автоматического; включения резерва Иверторная система; Байпас

Инв. № подп. Подп. и дата Взамен инв. №

Балаковская ТЭЦ-4 филиала «Саратовский» ПАО «Т Плюс»

Изм. | Кол.уч. | Лист | № док. | Подп. | Дата

Модернизация оборудования КИПиА водогрейных котлов ПТВМ-180 ст.№3, ст.№4 | Стадия | Лист | Листов

Принципиальная схема | НПП ЭСН

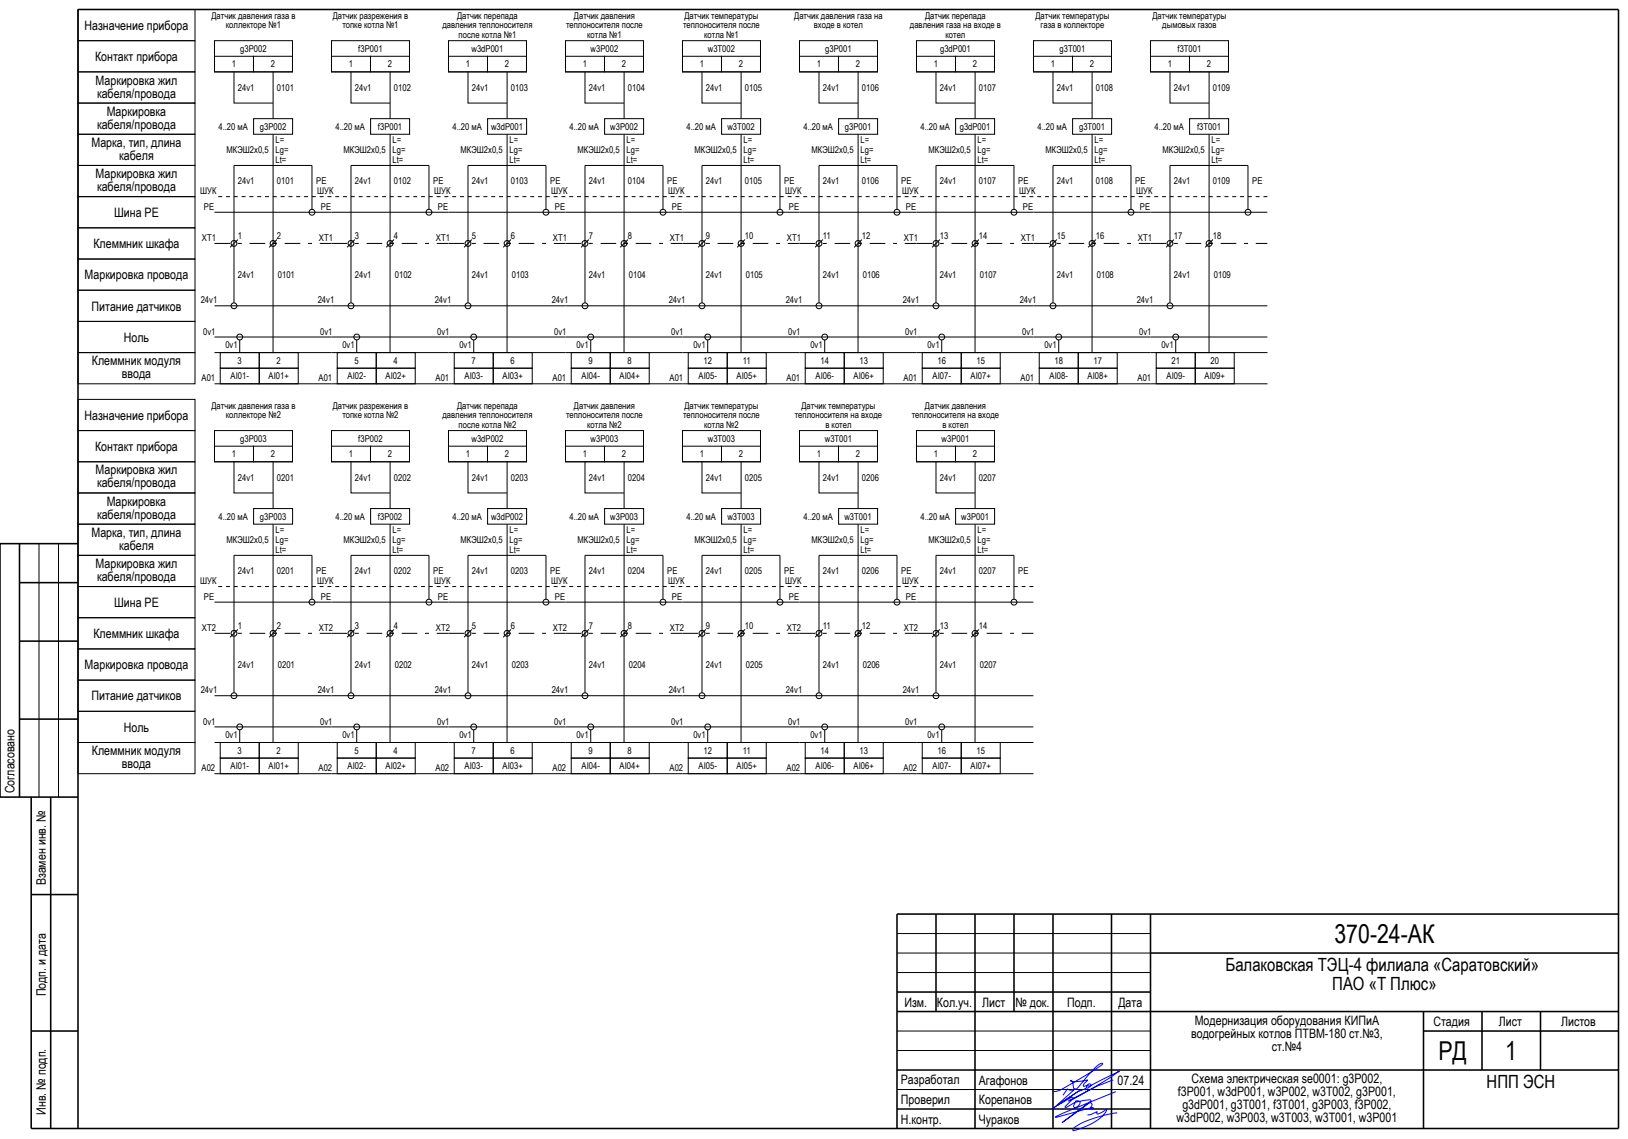
[picture p109: page 9]
Согласовано; Ноль; Питание датчиков; Клеммник шкафа; Шина PE; Маркировка жил кабеля/провода; Клеммник модуля ввода; Маркировка провода; ШУК; кабеля/провода; кабеля; Назначение прибора; МКЭШ2х0,5; Датчик разрежения в топке котла №1; Датчик перепада давления теплоносителя после котла №1; Датчик давления теплоносителя после котла №1; Датчик температуры теплоносителя после котла №1; котел; Датчик температуры газа в коллекторе; Датчик температуры дымовых газов; Датчик разрежения в топке котла №2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

Датчик давления газа в
коллекторе №1

Датчик давления газа на
входе в котел

Датчик перепада
давления газа на входе в

Контакт прибора
Маркировка жил
кабеля/провода
Маркировка
Марка, тип, длина

коллекторе №2

Датчик температуры
теплоносителя на входе
в котел

Датчик давления

кабеля

Инв. № подп. Подп. и дата Взамен инв. №

Балаковская ТЭЦ-4 филиала «Саратовский» ПАО «Т Плюс»

Изм. | Кол.уч. | Лист | № док. | Подп. | Дата

Модернизация оборудования КИПиА водогрейных котлов ПТВМ-180 ст.№3, ст.№4 | Стадия | Лист | Листов

Схема электрическая se0001: g3P002, f3P001, w3dP001, w3P002, w3T002, g3P001, g3dP001, g3T001, f3T001, g3P003, f3P002, w3dP002, w3P003, w3T003, w3T001, w3P001 | НПП ЭСН

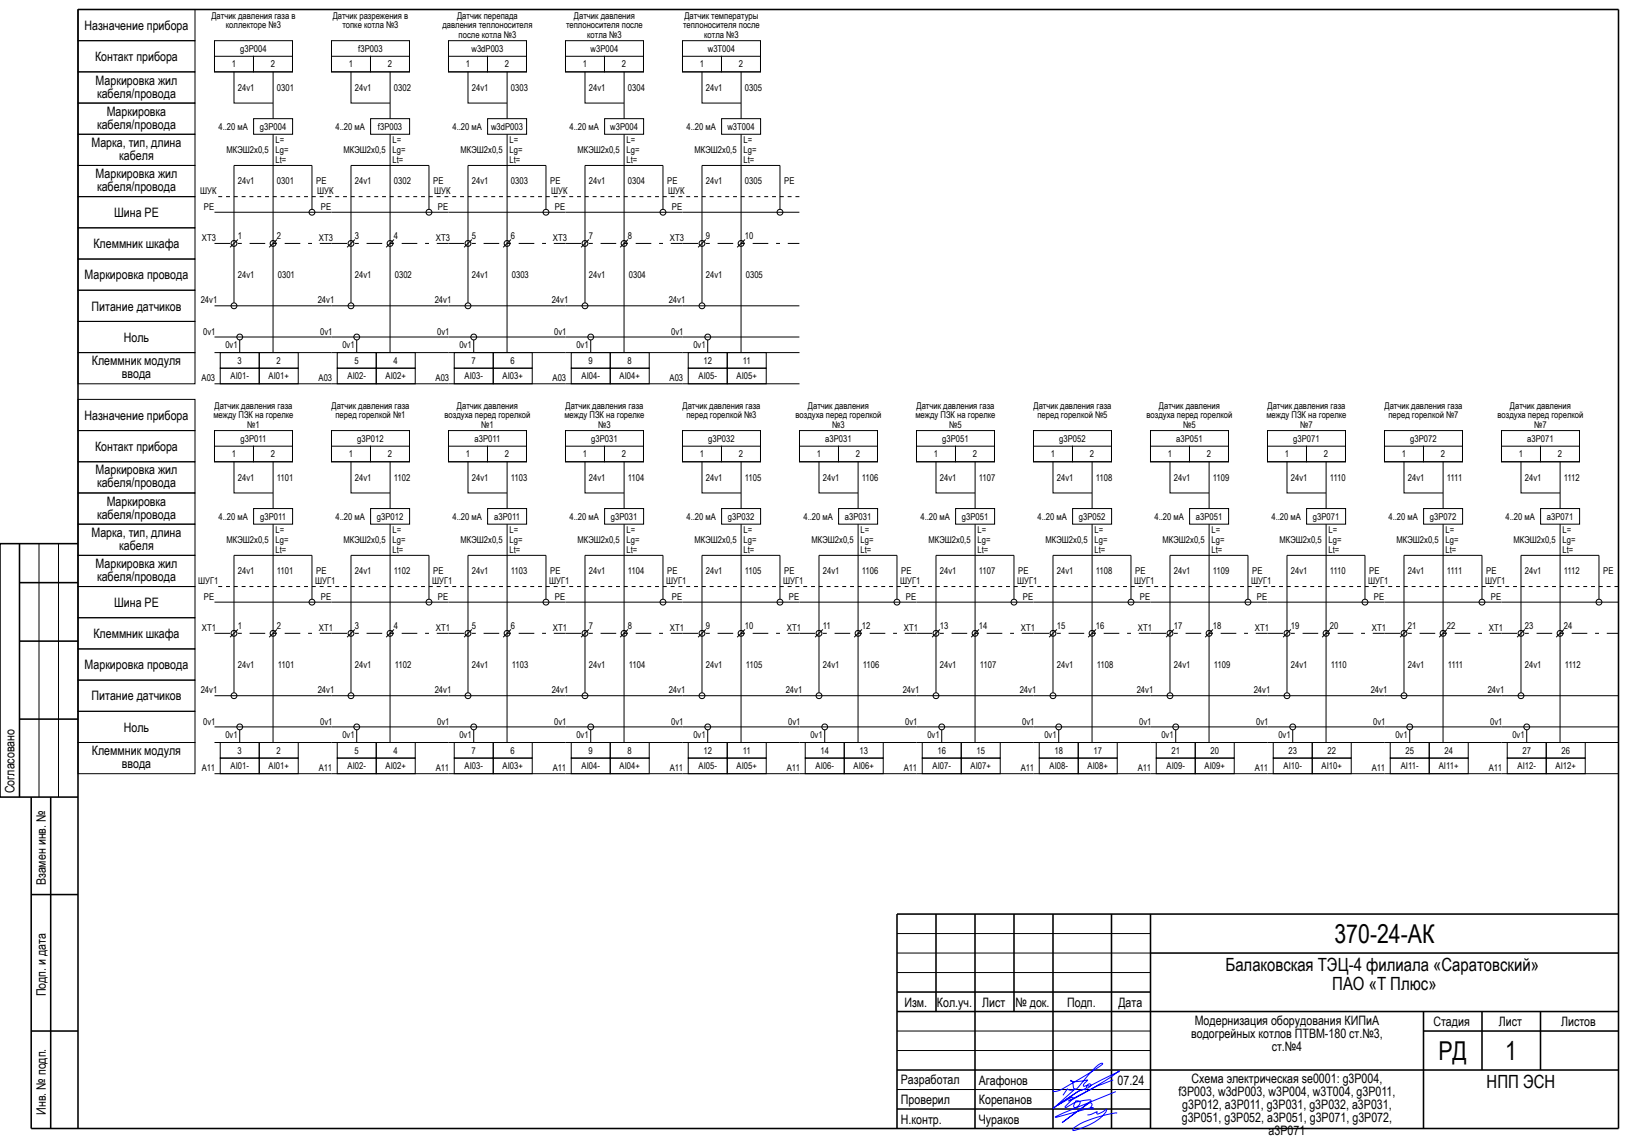
[picture p110: page 10]
Согласовано; Ноль; Питание датчиков; Клеммник шкафа; Шина PE; кабеля/провода; Клеммник модуля ввода; Маркировка провода; ШУК; ШУГ1; МКЭШ2х0,5; Датчик разрежения в топке котла №3; Датчик перепада давления теплоносителя после котла №3; Датчик давления теплоносителя после котла №3; Датчик температуры теплоносителя после котла №3; Маркировка кабеля/провода; Контакт прибора; Маркировка жил кабеля/провода; Назначение прибора

Датчик давления газа в
коллекторе №3

Контакт прибора
Маркировка жил
кабеля/провода
Маркировка
Марка, тип, длина
кабеля

Датчик давления газа
между ПЗК на горелке

перед горелкой №1

Датчик давления
воздуха перед горелкой

перед горелкой №3

перед горелкой №5

перед горелкой №7

Инв. № подп. Подп. и дата Взамен инв. №

Балаковская ТЭЦ-4 филиала «Саратовский» ПАО «Т Плюс»

Изм. | Кол.уч. | Лист | № док. | Подп. | Дата

Модернизация оборудования КИПиА водогрейных котлов ПТВМ-180 ст.№3, ст.№4 | Стадия | Лист | Листов

Схема электрическая se0001: g3P004, f3P003, w3dP003, w3P004, w3T004, g3P011, g3P012, а3P011, g3P031, g3P032, а3P031, g3P051, g3P052, а3P051, g3P071, g3P072, | НПП ЭСН

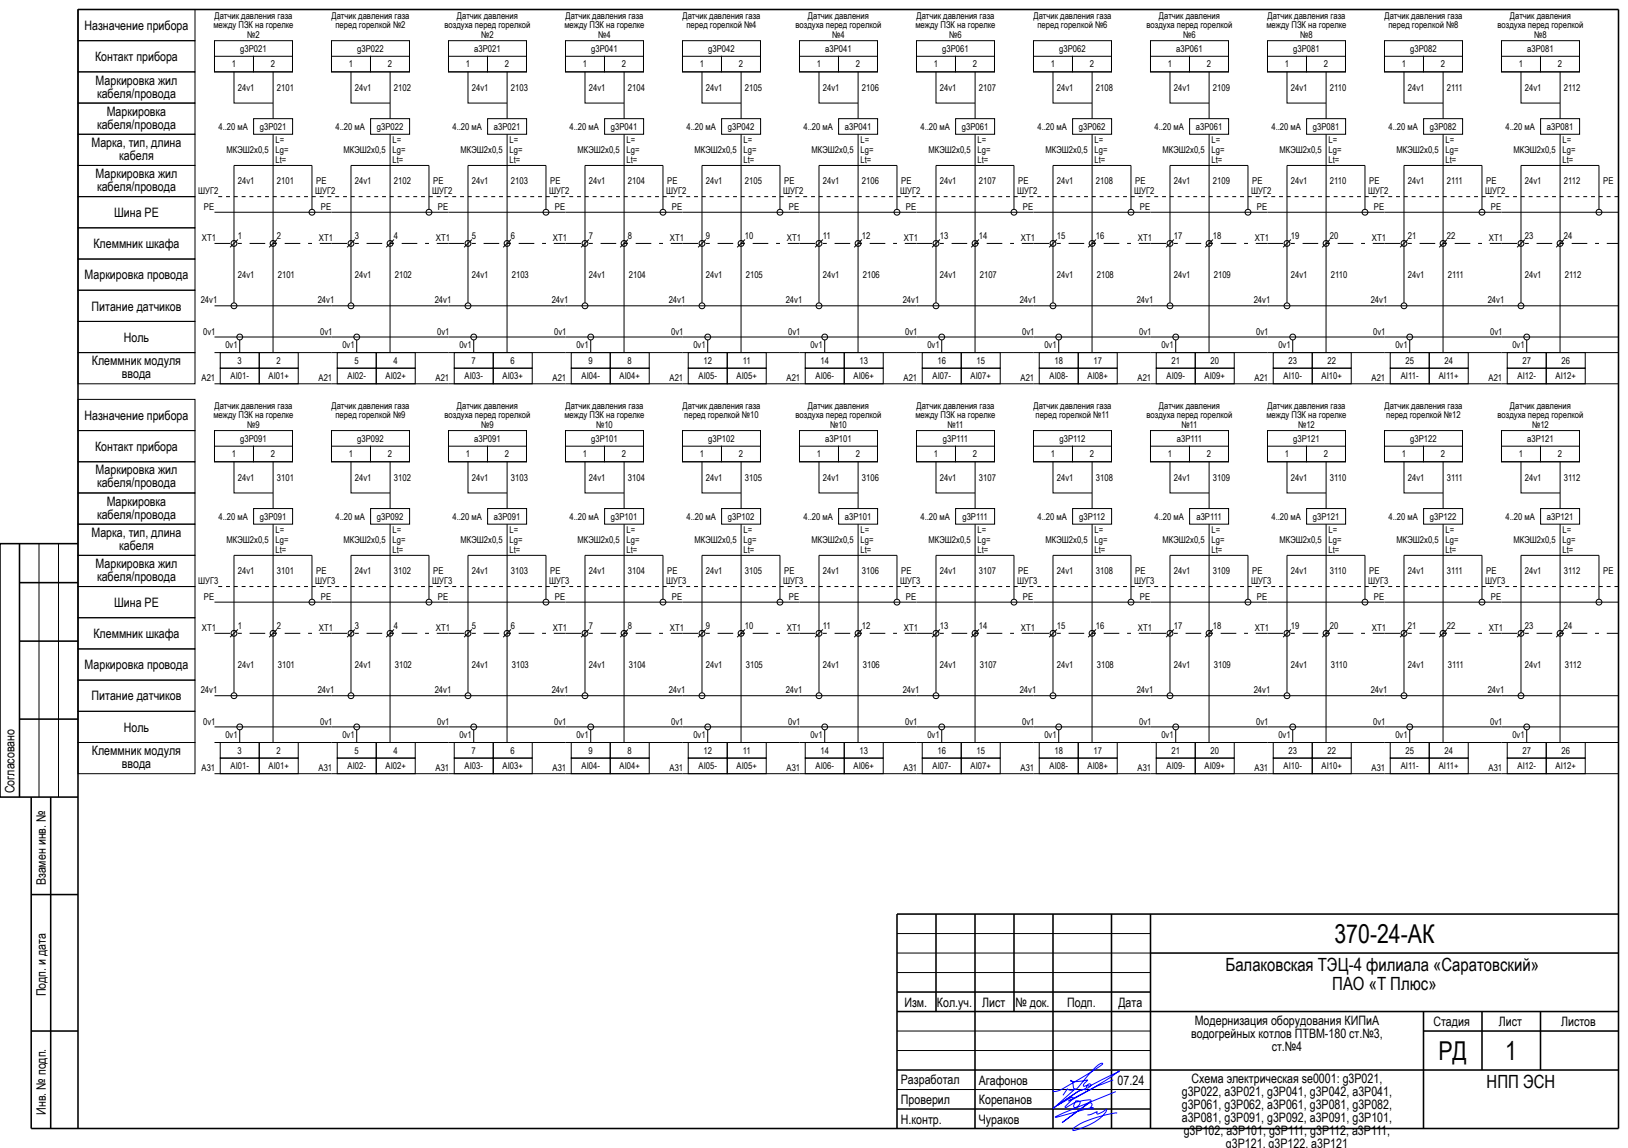
[picture p111: page 11]
Согласовано; Ноль; Питание датчиков; Клеммник шкафа; Шина PE; кабеля/провода; Клеммник модуля ввода; Маркировка провода; ШУГ2; ШУГ3; Маркировка кабеля/провода; Контакт прибора; Маркировка жил кабеля/провода; МКЭШ2х0,5; Назначение прибора

Датчик давления газа
между ПЗК на горелке

перед горелкой №2

Датчик давления
воздуха перед горелкой

перед горелкой №4

перед горелкой №6

перед горелкой №8

Марка, тип, длина
кабеля
Маркировка жил

перед горелкой №9

перед горелкой №10

перед горелкой №11

перед горелкой №12

Инв. № подп. Подп. и дата Взамен инв. №

Балаковская ТЭЦ-4 филиала «Саратовский» ПАО «Т Плюс»

Изм. | Кол.уч. | Лист | № док. | Подп. | Дата

Модернизация оборудования КИПиА водогрейных котлов ПТВМ-180 ст.№3, ст.№4 | Стадия | Лист | Листов

Схема электрическая se0001: g3P021, g3P022, а3P021, g3P041, g3P042, а3P041, g3P061, g3P062, а3P061, g3P081, g3P082, а3P081, g3P091, g3P092, а3P091, g3P101, | НПП ЭСН

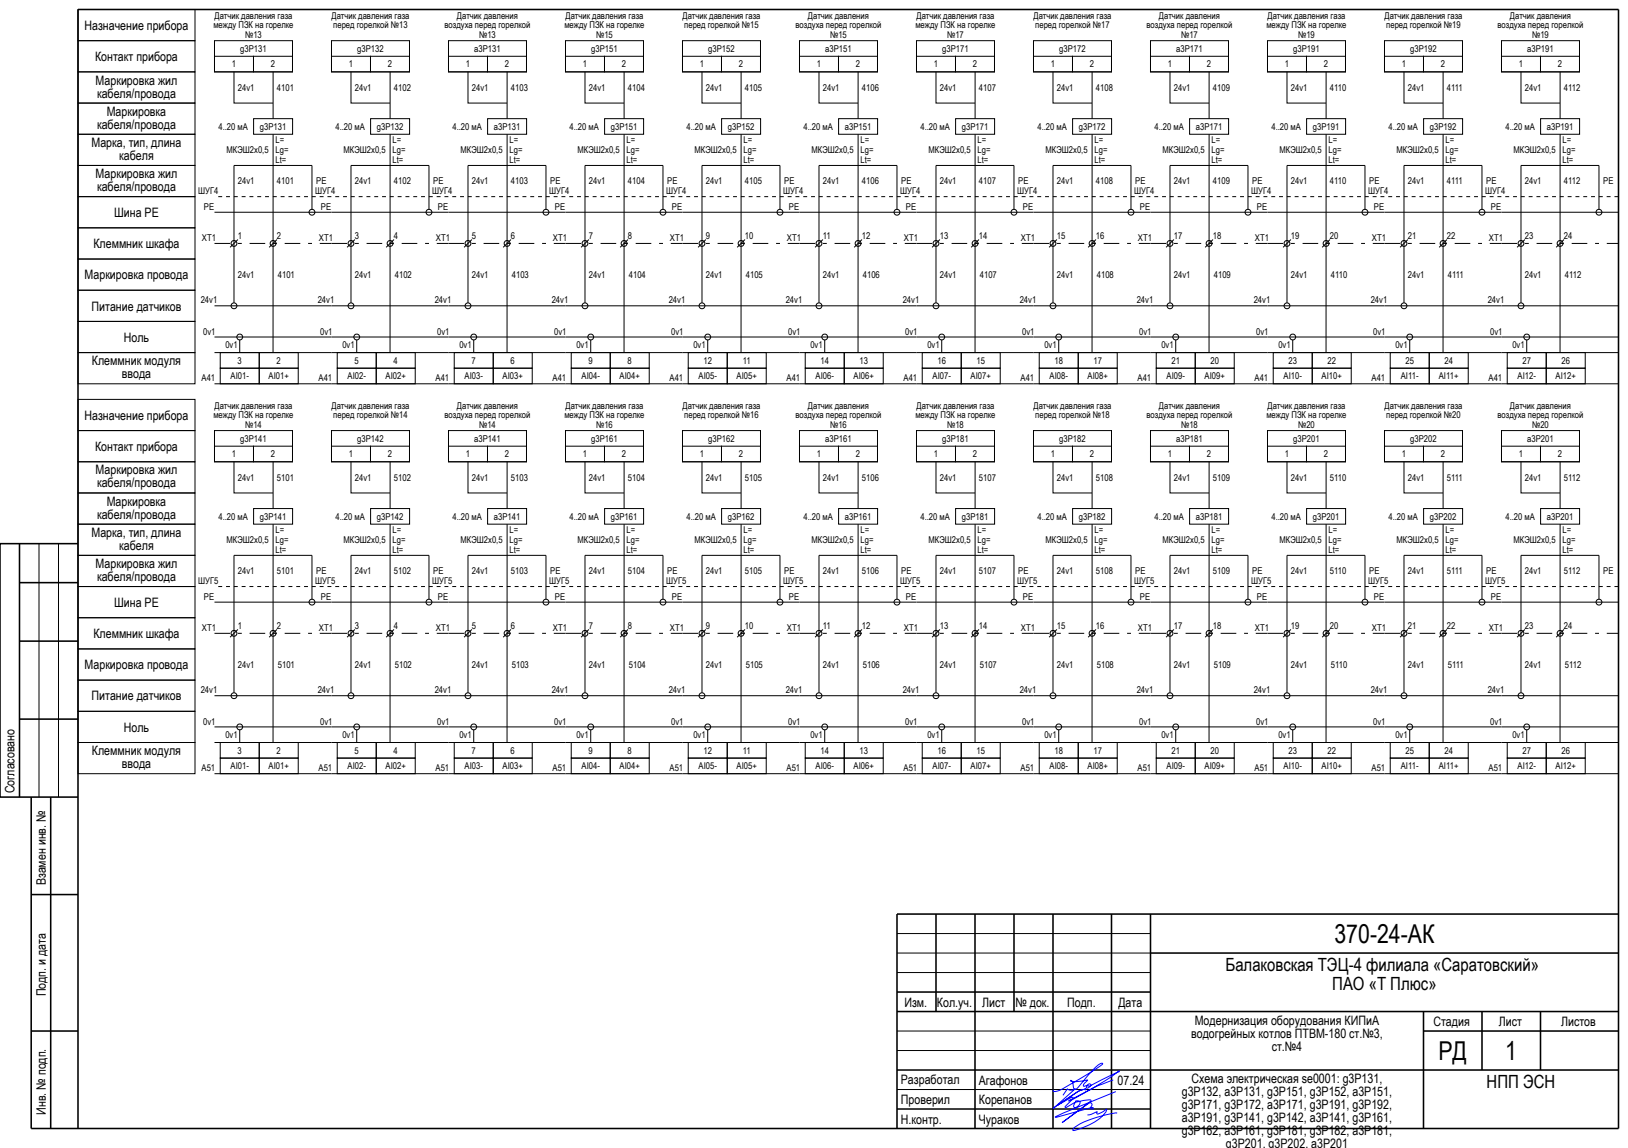
[picture p112: page 12]
Согласовано; Ноль; Питание датчиков; Клеммник шкафа; Шина PE; кабеля/провода; Клеммник модуля ввода; Маркировка провода; ШУГ4; ШУГ5; Маркировка кабеля/провода; Контакт прибора; Маркировка жил кабеля/провода; МКЭШ2х0,5; Назначение прибора

Датчик давления газа
между ПЗК на горелке

перед горелкой №13

Датчик давления
воздуха перед горелкой

перед горелкой №15

перед горелкой №17

перед горелкой №19

Марка, тип, длина
кабеля
Маркировка жил

перед горелкой №14

перед горелкой №16

перед горелкой №18

перед горелкой №20

Инв. № подп. Подп. и дата Взамен инв. №

Балаковская ТЭЦ-4 филиала «Саратовский» ПАО «Т Плюс»

Изм. | Кол.уч. | Лист | № док. | Подп. | Дата

Модернизация оборудования КИПиА водогрейных котлов ПТВМ-180 ст.№3, ст.№4 | Стадия | Лист | Листов

Схема электрическая se0001: g3P131, g3P132, а3P131, g3P151, g3P152, а3P151, g3P171, g3P172, а3P171, g3P191, g3P192, а3P191, g3P141, g3P142, а3P141, g3P161, | НПП ЭСН

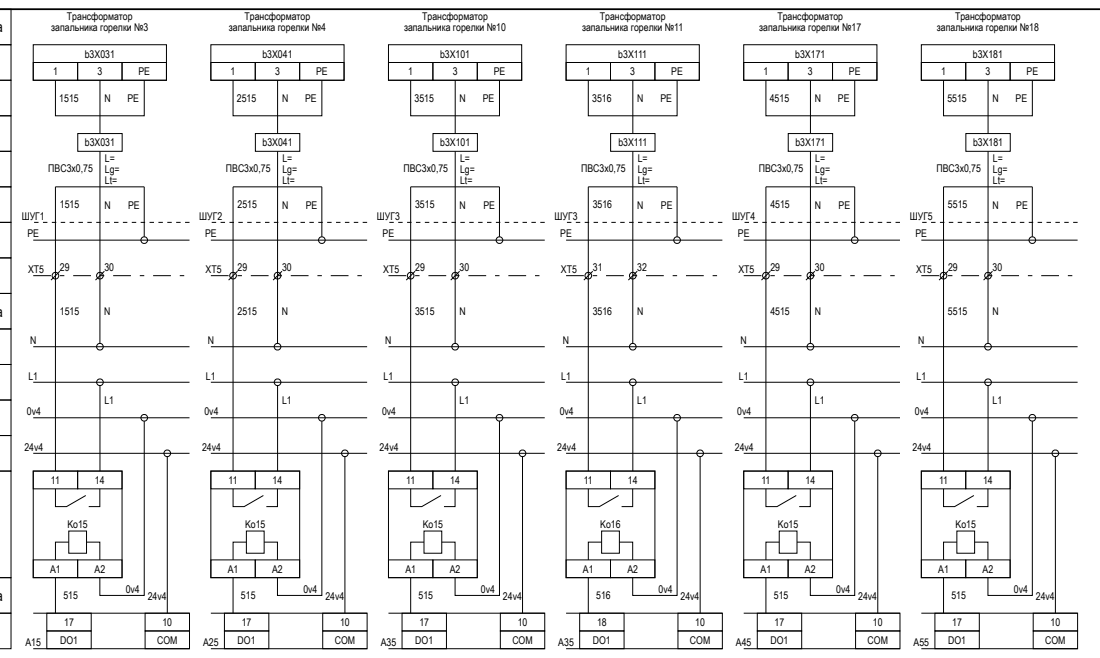
[picture p113: page 13]
Согласовано; Клеммник шкафа; Шина PE; кабеля/провода; Клеммник модуля ввода/вывода; Маркировка провода; Питание 220В; Реле; Ноль 220В; Ноль 24В; Питание 24В; ШУГ1; 10 COM; ШУГ2; ШУГ3; ШУГ4; ШУГ5; Трансформатор запальника горелки №3; ПВС3х0,75; Трансформатор запальника горелки №4; Трансформатор запальника горелки №10; Трансформатор запальника горелки №11; Трансформатор запальника горелки №17; Трансформатор запальника горелки №18

Контакт прибора
Маркировка жил
кабеля/провода
Маркировка
Марка, тип, длина
кабеля

Инв. № подп. Подп. и дата Взамен инв. №

Балаковская ТЭЦ-4 филиала «Саратовский» ПАО «Т Плюс»

Изм. | Кол.уч. | Лист | № док. | Подп. | Дата

Модернизация оборудования КИПиА водогрейных котлов ПТВМ-180 ст.№3, ст.№4 | Стадия | Лист | Листов

Схема электрическая se0002: b3X031, b3X041, b3X101, b3X111, b3X171, b3X181 | НПП ЭСН

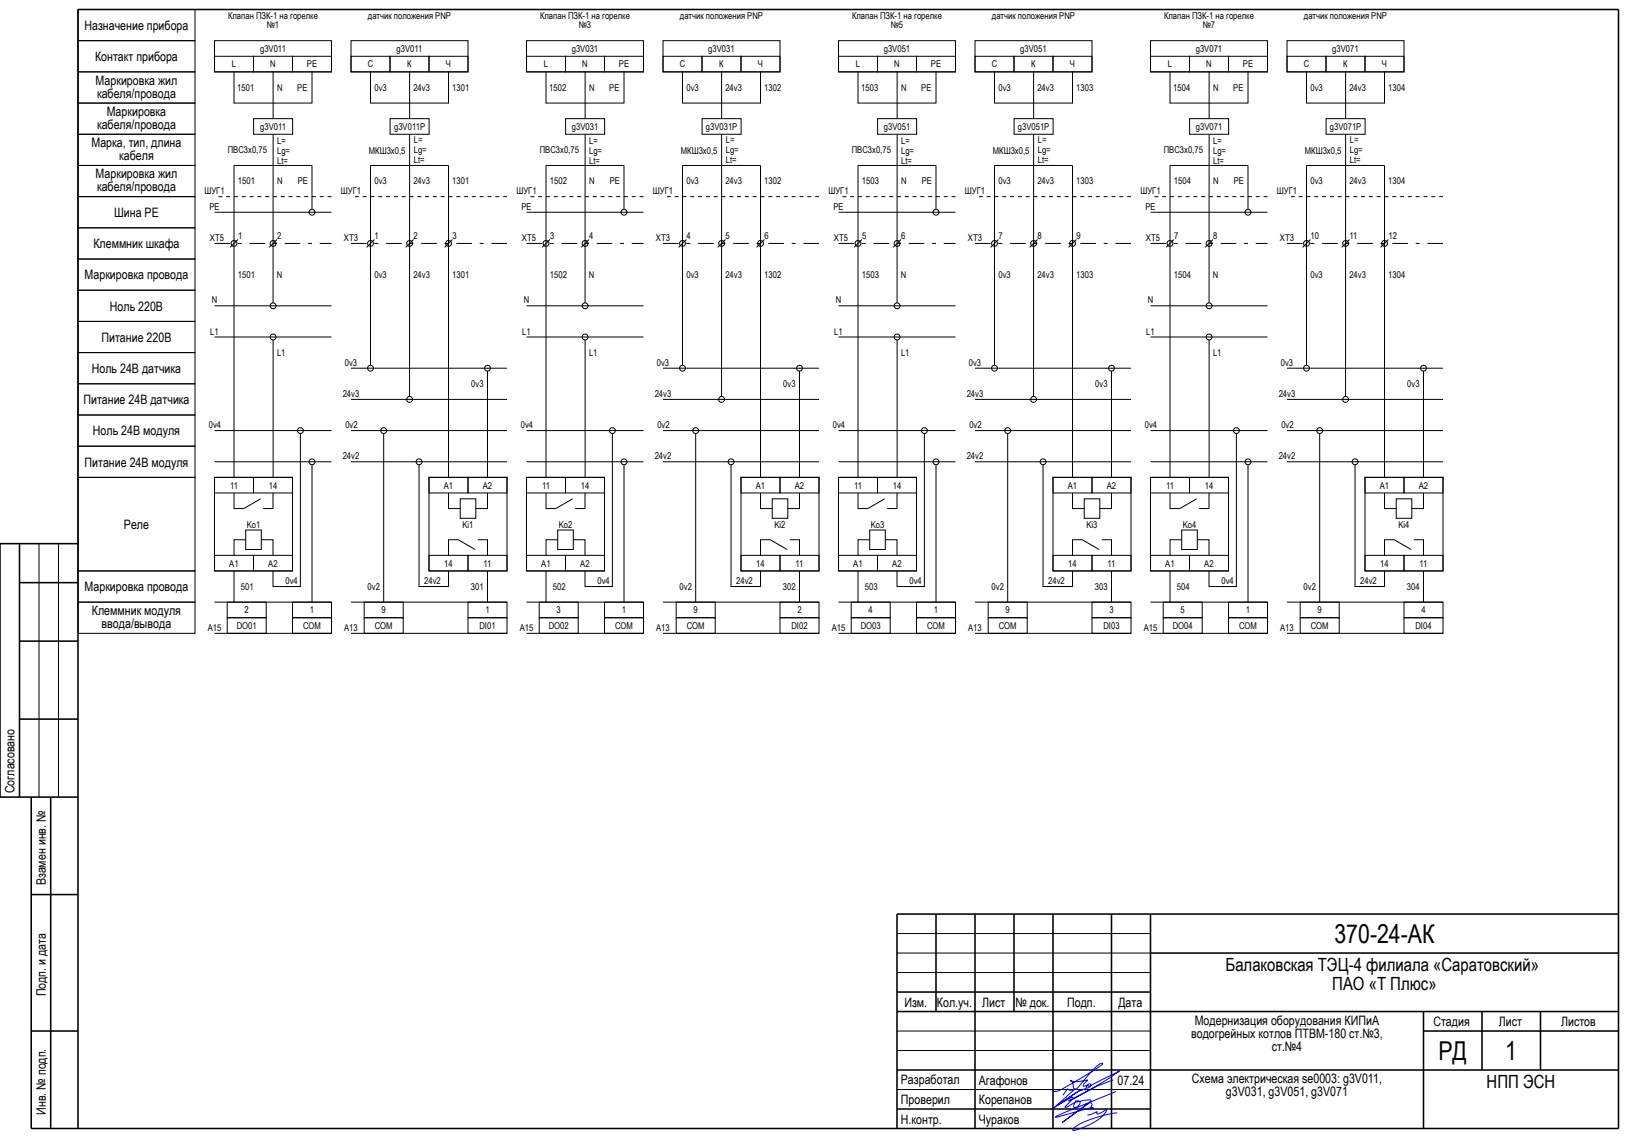
[picture p114: page 14]
Согласовано; Клеммник шкафа; Шина PE; кабеля/провода; Клеммник модуля ввода/вывода; Маркировка провода; Питание 220В; Реле; Ноль 220В; Питание 24В датчика; Ноль 24В датчика; Питание 24В модуля; Ноль 24В модуля; ШУГ1; COM; 1 COM; МКШ3х0,5; ПВС3х0,75

Клапан ПЗК-1 на горелке

датчик положения PNP

Контакт прибора
Маркировка жил
кабеля/провода
Маркировка
Марка, тип, длина
кабеля

Инв. № подп. Подп. и дата Взамен инв. №

Балаковская ТЭЦ-4 филиала «Саратовский» ПАО «Т Плюс»

Изм. | Кол.уч. | Лист | № док. | Подп. | Дата

Модернизация оборудования КИПиА водогрейных котлов ПТВМ-180 ст.№3, ст.№4 | Стадия | Лист | Листов

Схема электрическая se0003: g3V011, g3V031, g3V051, g3V071 | НПП ЭСН

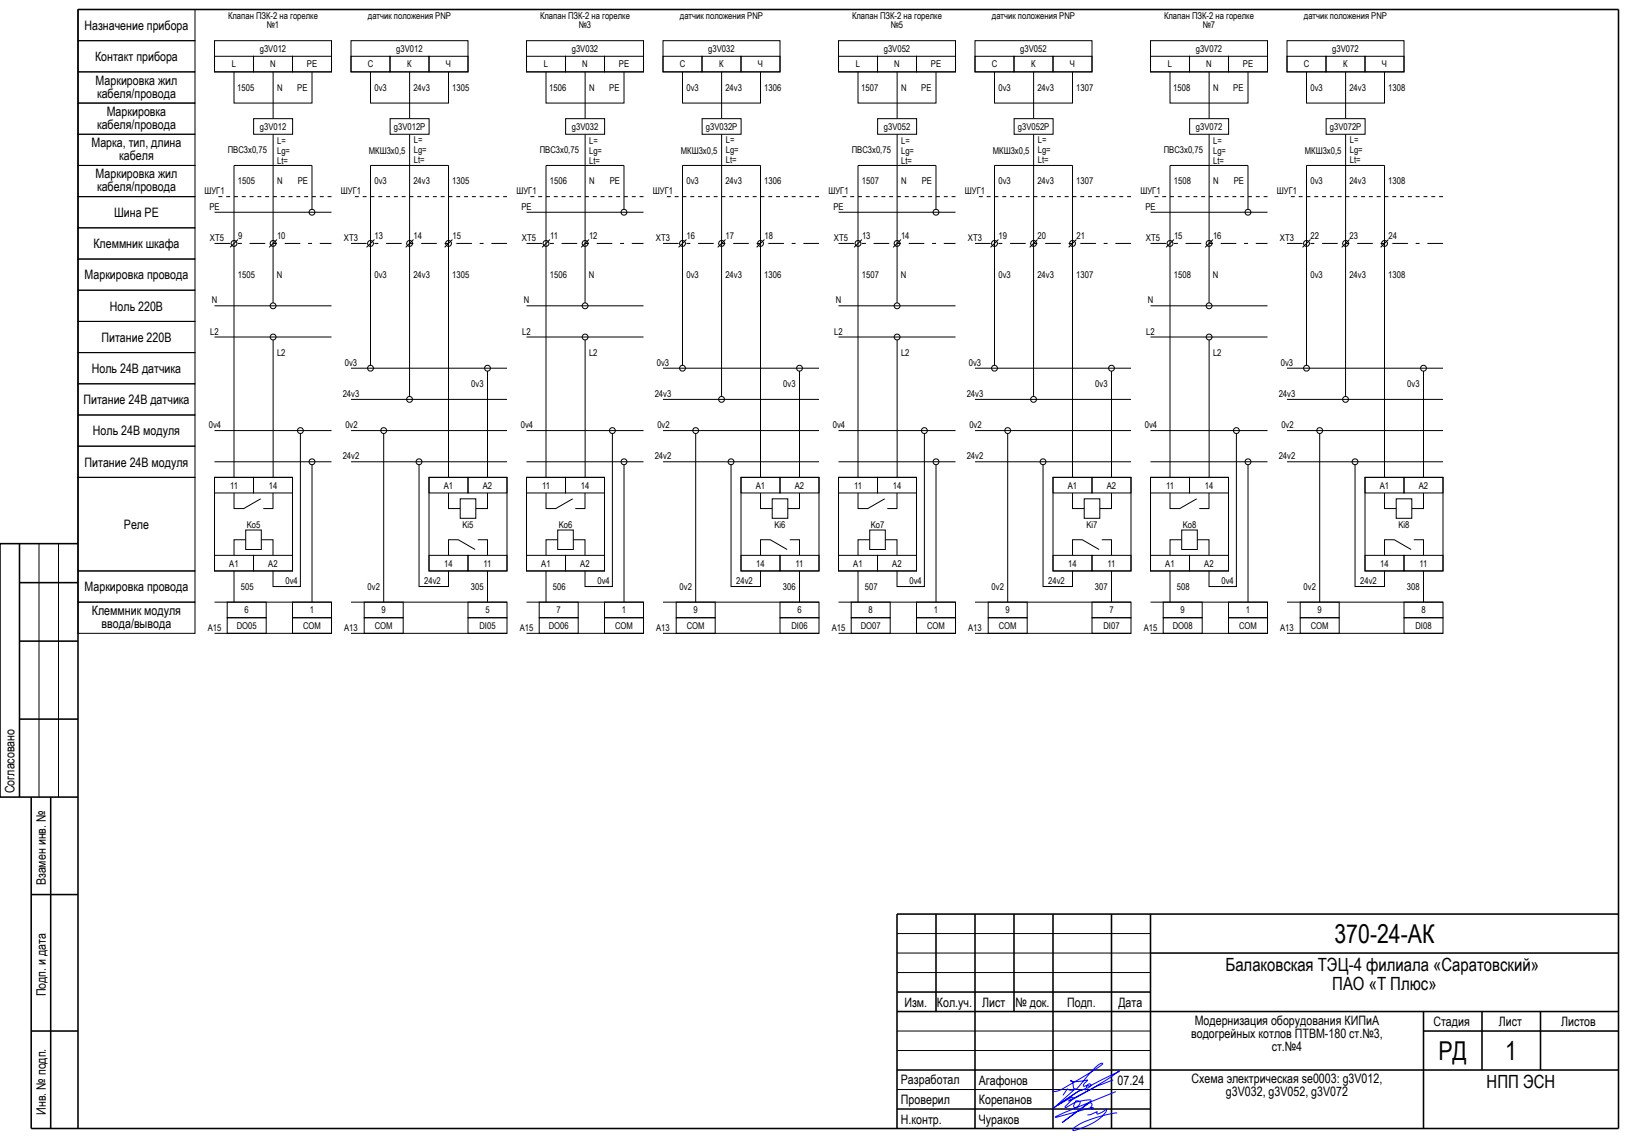
[picture p115: page 15]
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

Клапан ПЗК-2 на горелке

датчик положения PNP

Контакт прибора
Маркировка жил
кабеля/провода
Маркировка
Марка, тип, длина
кабеля

Инв. № подп. Подп. и дата Взамен инв. №

Балаковская ТЭЦ-4 филиала «Саратовский» ПАО «Т Плюс»

Изм. | Кол.уч. | Лист | № док. | Подп. | Дата

Модернизация оборудования КИПиА водогрейных котлов ПТВМ-180 ст.№3, ст.№4 | Стадия | Лист | Листов

Схема электрическая se0003: g3V012, g3V032, g3V052, g3V072 | НПП ЭСН

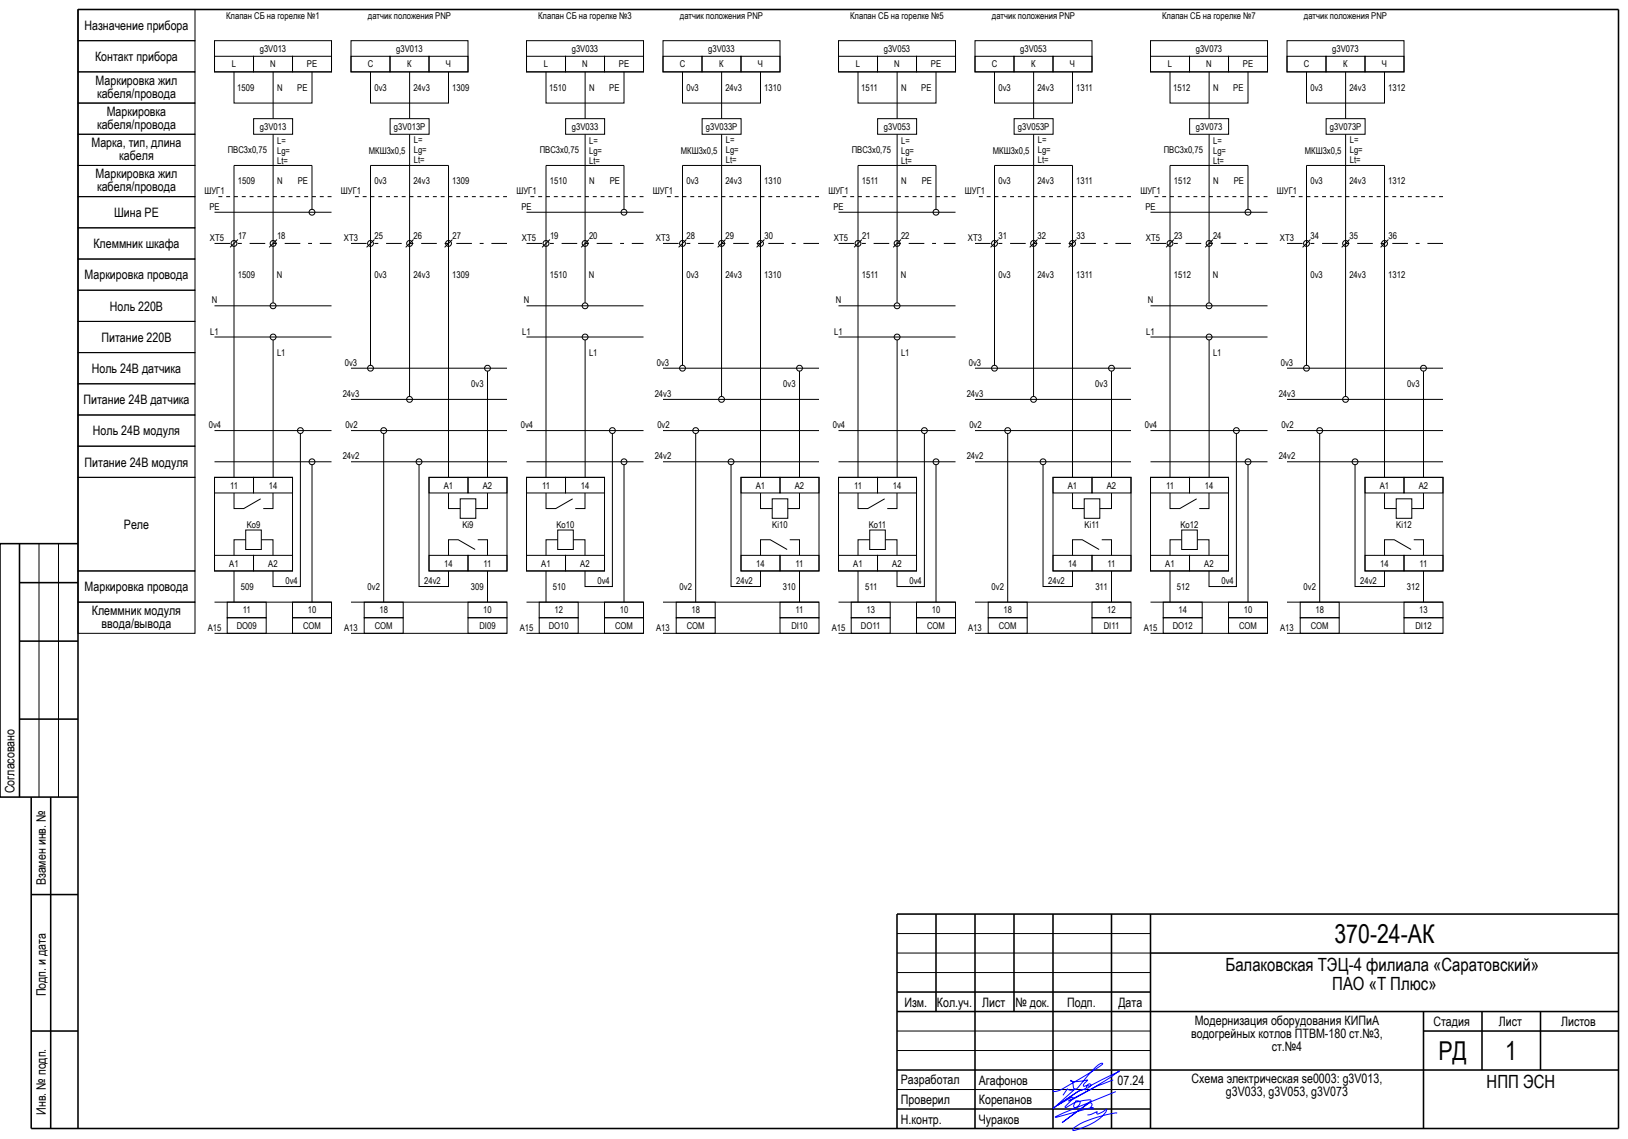
[picture p116: page 16]
Согласовано; Клеммник шкафа; Шина PE; кабеля/провода; Клеммник модуля ввода/вывода; Маркировка провода; Питание 220В; Реле; Ноль 220В; Питание 24В датчика; Ноль 24В датчика; Питание 24В модуля; Ноль 24В модуля; ШУГ1; COM; 10 COM; МКШ3х0,5; ПВС3х0,75

Клапан СБ на горелке №1

датчик положения PNP

Клапан СБ на горелке №3

Клапан СБ на горелке №5

Клапан СБ на горелке №7

Контакт прибора
Маркировка жил
кабеля/провода
Маркировка
Марка, тип, длина
кабеля

Инв. № подп. Подп. и дата Взамен инв. №

Балаковская ТЭЦ-4 филиала «Саратовский» ПАО «Т Плюс»

Изм. | Кол.уч. | Лист | № док. | Подп. | Дата

Модернизация оборудования КИПиА водогрейных котлов ПТВМ-180 ст.№3, ст.№4 | Стадия | Лист | Листов

Схема электрическая se0003: g3V013, g3V033, g3V053, g3V073 | НПП ЭСН

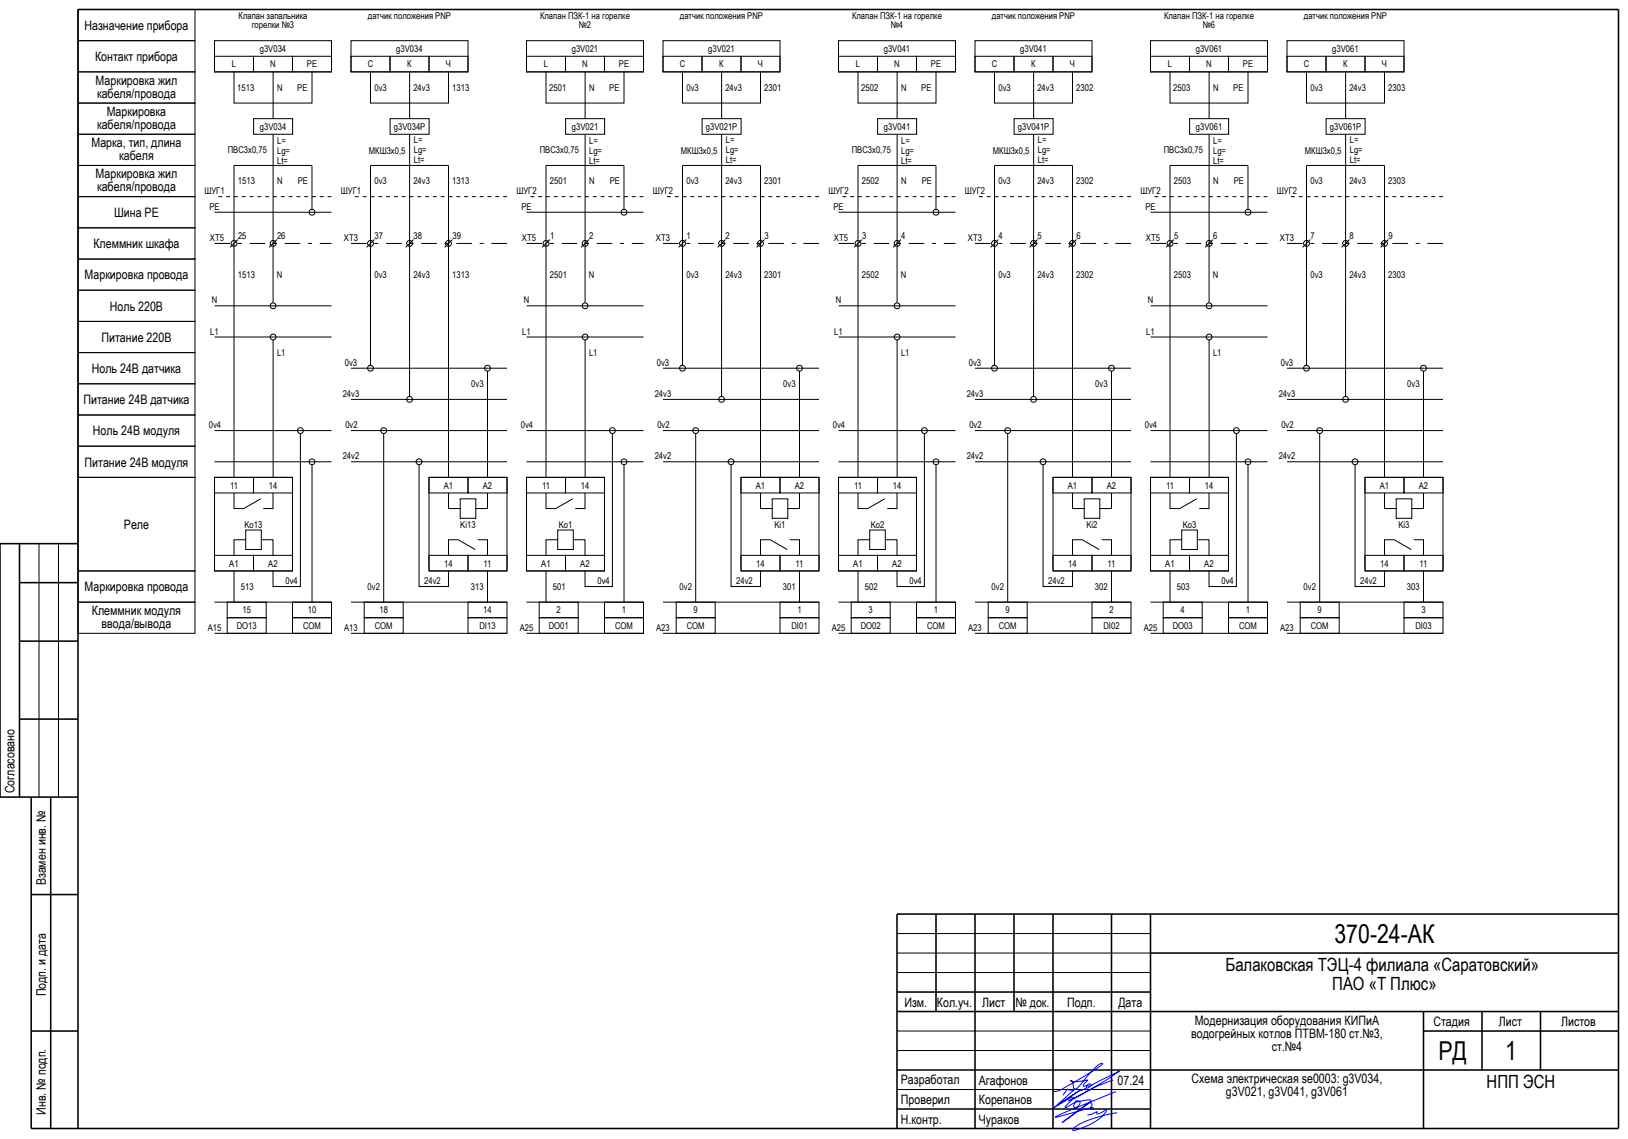
[picture p117: page 17]
Согласовано; Клеммник шкафа; Шина PE; кабеля/провода; Клеммник модуля ввода/вывода; Маркировка провода; Питание 220В; Реле; Ноль 220В; Питание 24В датчика; Ноль 24В датчика; Питание 24В модуля; Ноль 24В модуля; ШУГ1; COM; 10 COM; ШУГ2; 1 COM; Клапан запальника горелки №3; МКШ3х0,5; ПВС3х0,75

датчик положения PNP

Клапан ПЗК-1 на горелке

Контакт прибора
Маркировка жил
кабеля/провода
Маркировка
Марка, тип, длина
кабеля

Инв. № подп. Подп. и дата Взамен инв. №

Балаковская ТЭЦ-4 филиала «Саратовский» ПАО «Т Плюс»

Изм. | Кол.уч. | Лист | № док. | Подп. | Дата

Модернизация оборудования КИПиА водогрейных котлов ПТВМ-180 ст.№3, ст.№4 | Стадия | Лист | Листов

Схема электрическая se0003: g3V034, g3V021, g3V041, g3V061 | НПП ЭСН

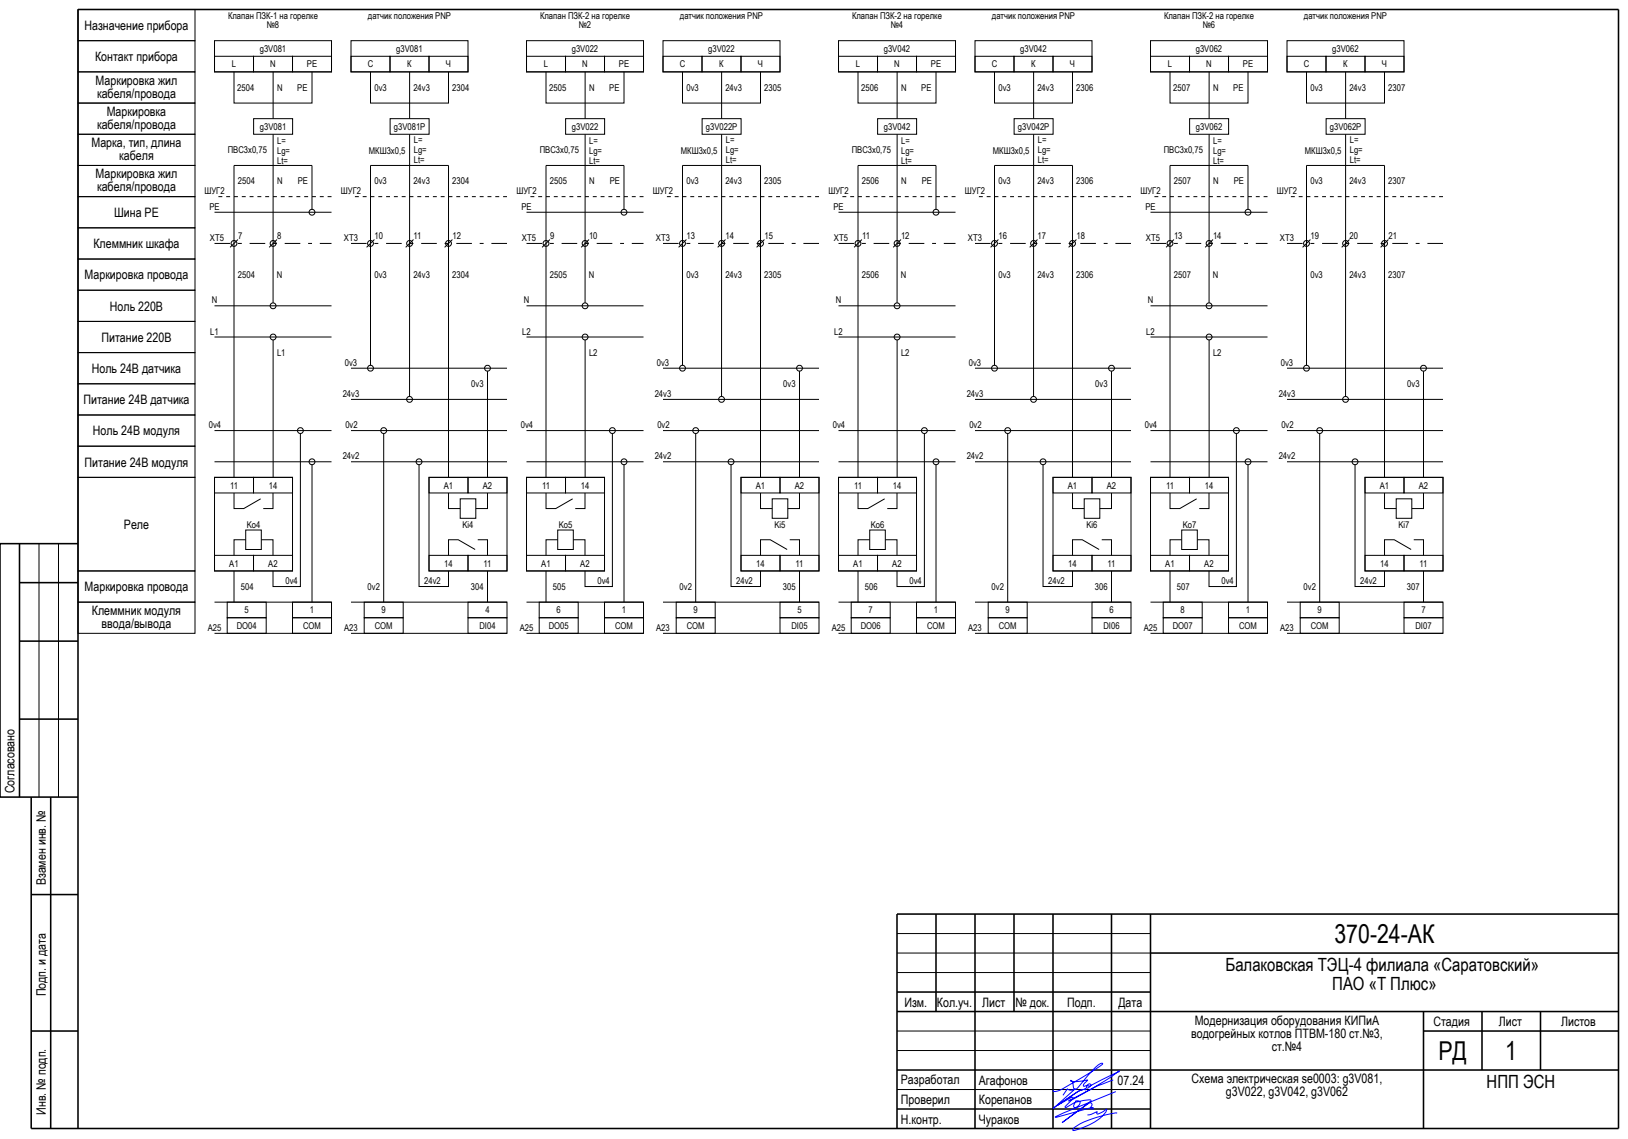
[picture p118: page 18]
Согласовано; Клеммник шкафа; Шина PE; кабеля/провода; Клеммник модуля ввода/вывода; Маркировка провода; Питание 220В; Реле; Ноль 220В; Питание 24В датчика; Ноль 24В датчика; Питание 24В модуля; Ноль 24В модуля; ШУГ2; COM; 1 COM; МКШ3х0,5; ПВС3х0,75

Клапан ПЗК-1 на горелке

датчик положения PNP

Клапан ПЗК-2 на горелке

Контакт прибора
Маркировка жил
кабеля/провода
Маркировка
Марка, тип, длина
кабеля

Инв. № подп. Подп. и дата Взамен инв. №

Балаковская ТЭЦ-4 филиала «Саратовский» ПАО «Т Плюс»

Изм. | Кол.уч. | Лист | № док. | Подп. | Дата

Модернизация оборудования КИПиА водогрейных котлов ПТВМ-180 ст.№3, ст.№4 | Стадия | Лист | Листов

Схема электрическая se0003: g3V081, g3V022, g3V042, g3V062 | НПП ЭСН

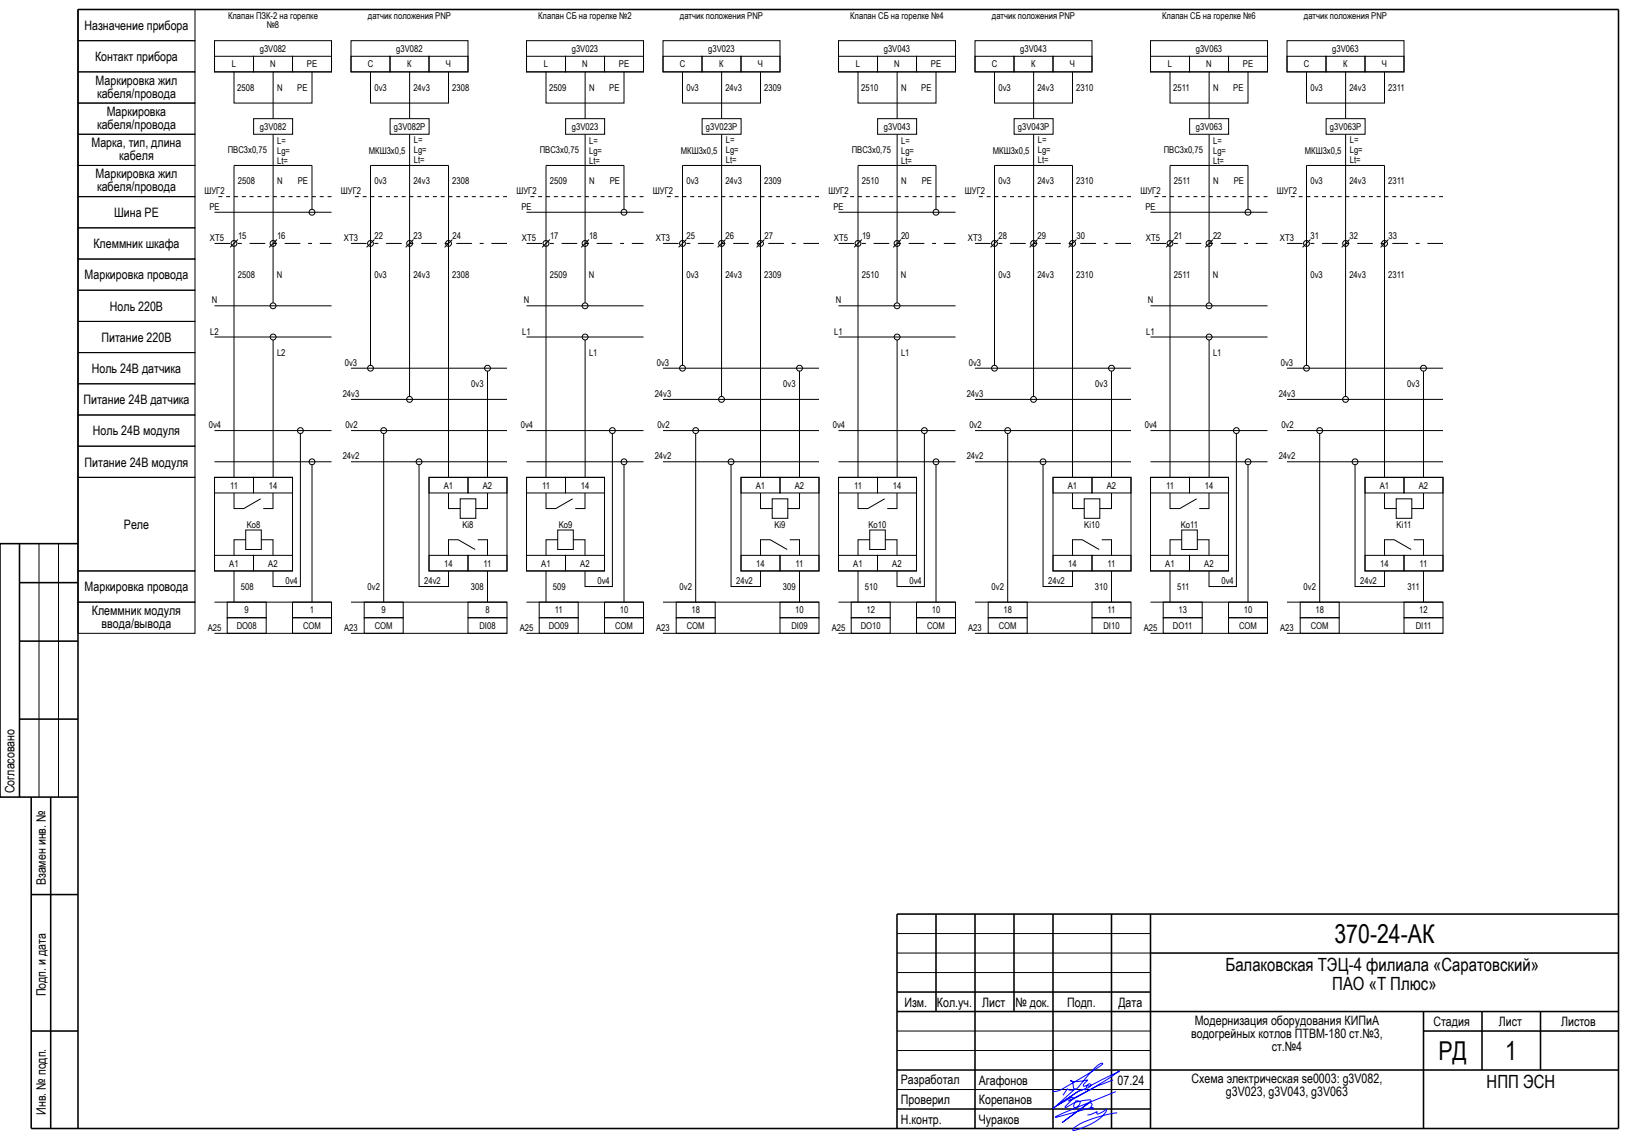
[picture p119: page 19]
Согласовано; Клеммник шкафа; Шина PE; кабеля/провода; Клеммник модуля ввода/вывода; Маркировка провода; Питание 220В; Реле; Ноль 220В; Питание 24В датчика; Ноль 24В датчика; Питание 24В модуля; Ноль 24В модуля; ШУГ2; COM; 1 COM; 10 COM; МКШ3х0,5; ПВС3х0,75

Клапан ПЗК-2 на горелке

датчик положения PNP

Клапан СБ на горелке №2

Клапан СБ на горелке №4

Клапан СБ на горелке №6

Контакт прибора
Маркировка жил
кабеля/провода
Маркировка
Марка, тип, длина
кабеля

Инв. № подп. Подп. и дата Взамен инв. №

Балаковская ТЭЦ-4 филиала «Саратовский» ПАО «Т Плюс»

Изм. | Кол.уч. | Лист | № док. | Подп. | Дата

Модернизация оборудования КИПиА водогрейных котлов ПТВМ-180 ст.№3, ст.№4 | Стадия | Лист | Листов

Схема электрическая se0003: g3V082, g3V023, g3V043, g3V063 | НПП ЭСН

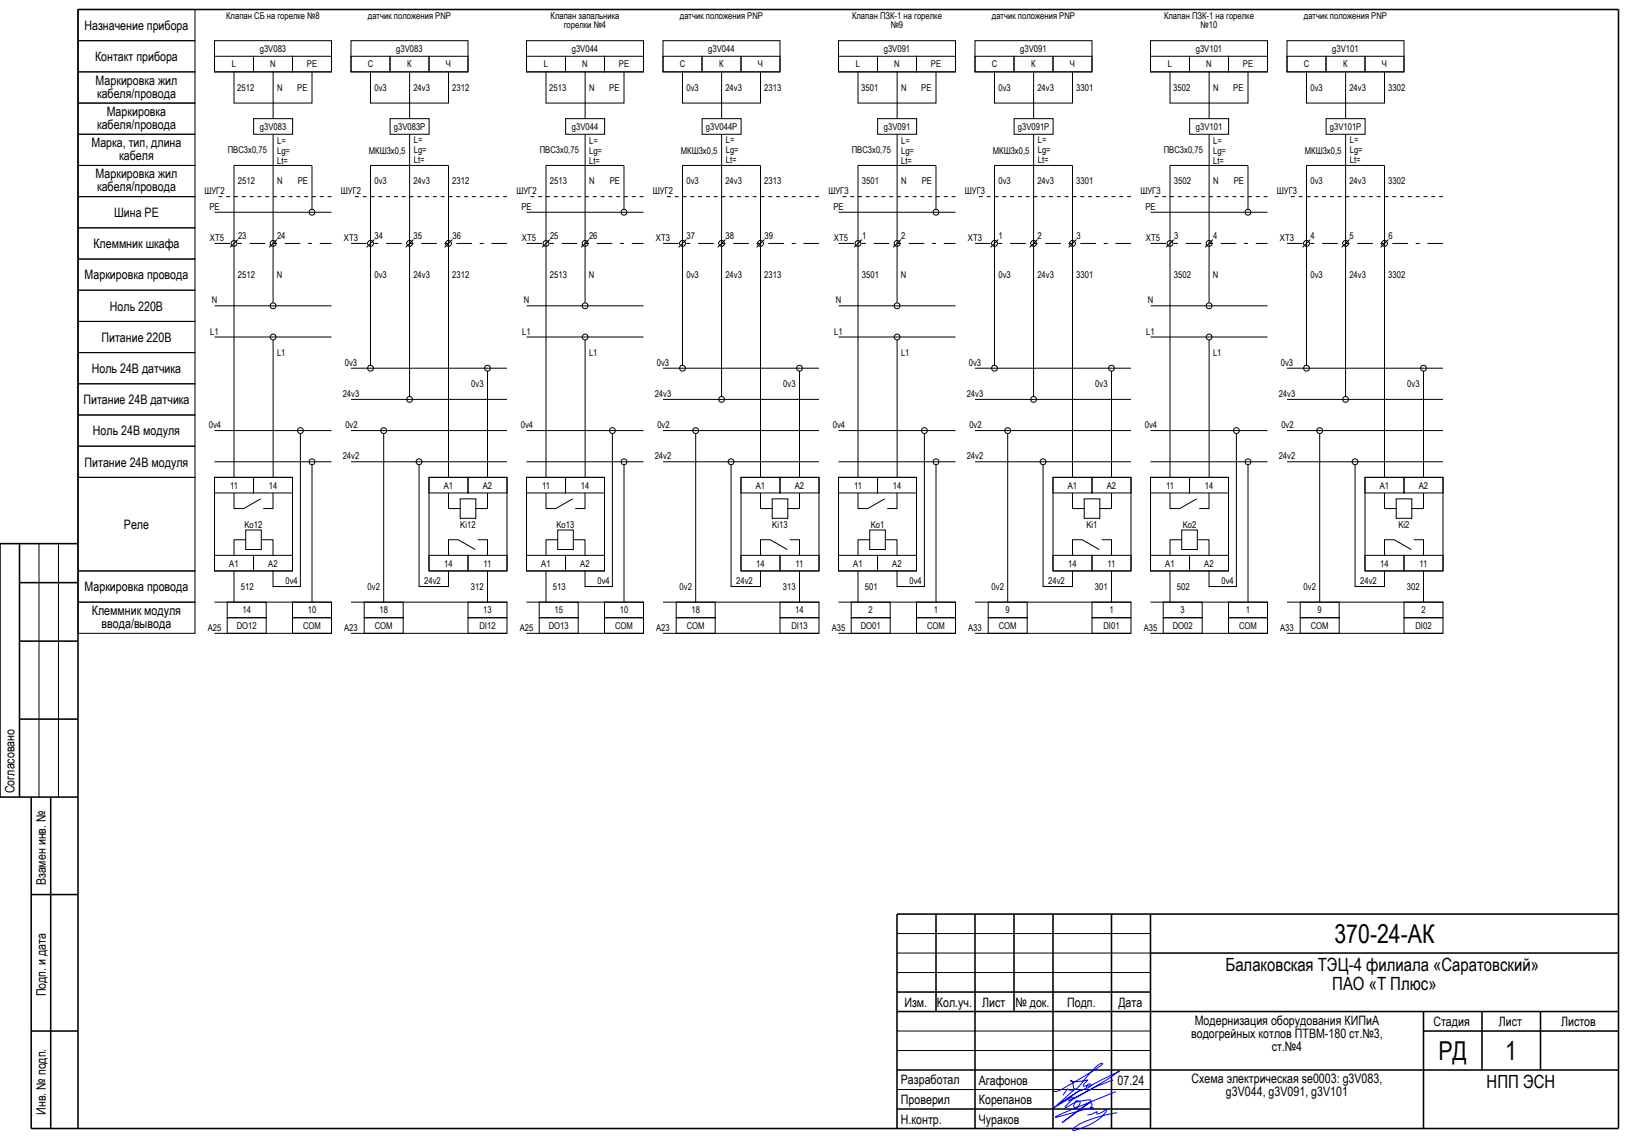
[picture p120: page 20]
Согласовано; Клеммник шкафа; Шина PE; кабеля/провода; Клеммник модуля ввода/вывода; Маркировка провода; Питание 220В; Реле; Ноль 220В; Питание 24В датчика; Ноль 24В датчика; Питание 24В модуля; Ноль 24В модуля; ШУГ2; COM; 10 COM; ШУГ3; 1 COM; МКШ3х0,5; ПВС3х0,75; Клапан запальника горелки №4

Клапан СБ на горелке №8

датчик положения PNP

Клапан ПЗК-1 на горелке

Контакт прибора
Маркировка жил
кабеля/провода
Маркировка
Марка, тип, длина
кабеля

Инв. № подп. Подп. и дата Взамен инв. №

Балаковская ТЭЦ-4 филиала «Саратовский» ПАО «Т Плюс»

Изм. | Кол.уч. | Лист | № док. | Подп. | Дата

Модернизация оборудования КИПиА водогрейных котлов ПТВМ-180 ст.№3, ст.№4 | Стадия | Лист | Листов

Схема электрическая se0003: g3V083, g3V044, g3V091, g3V101 | НПП ЭСН

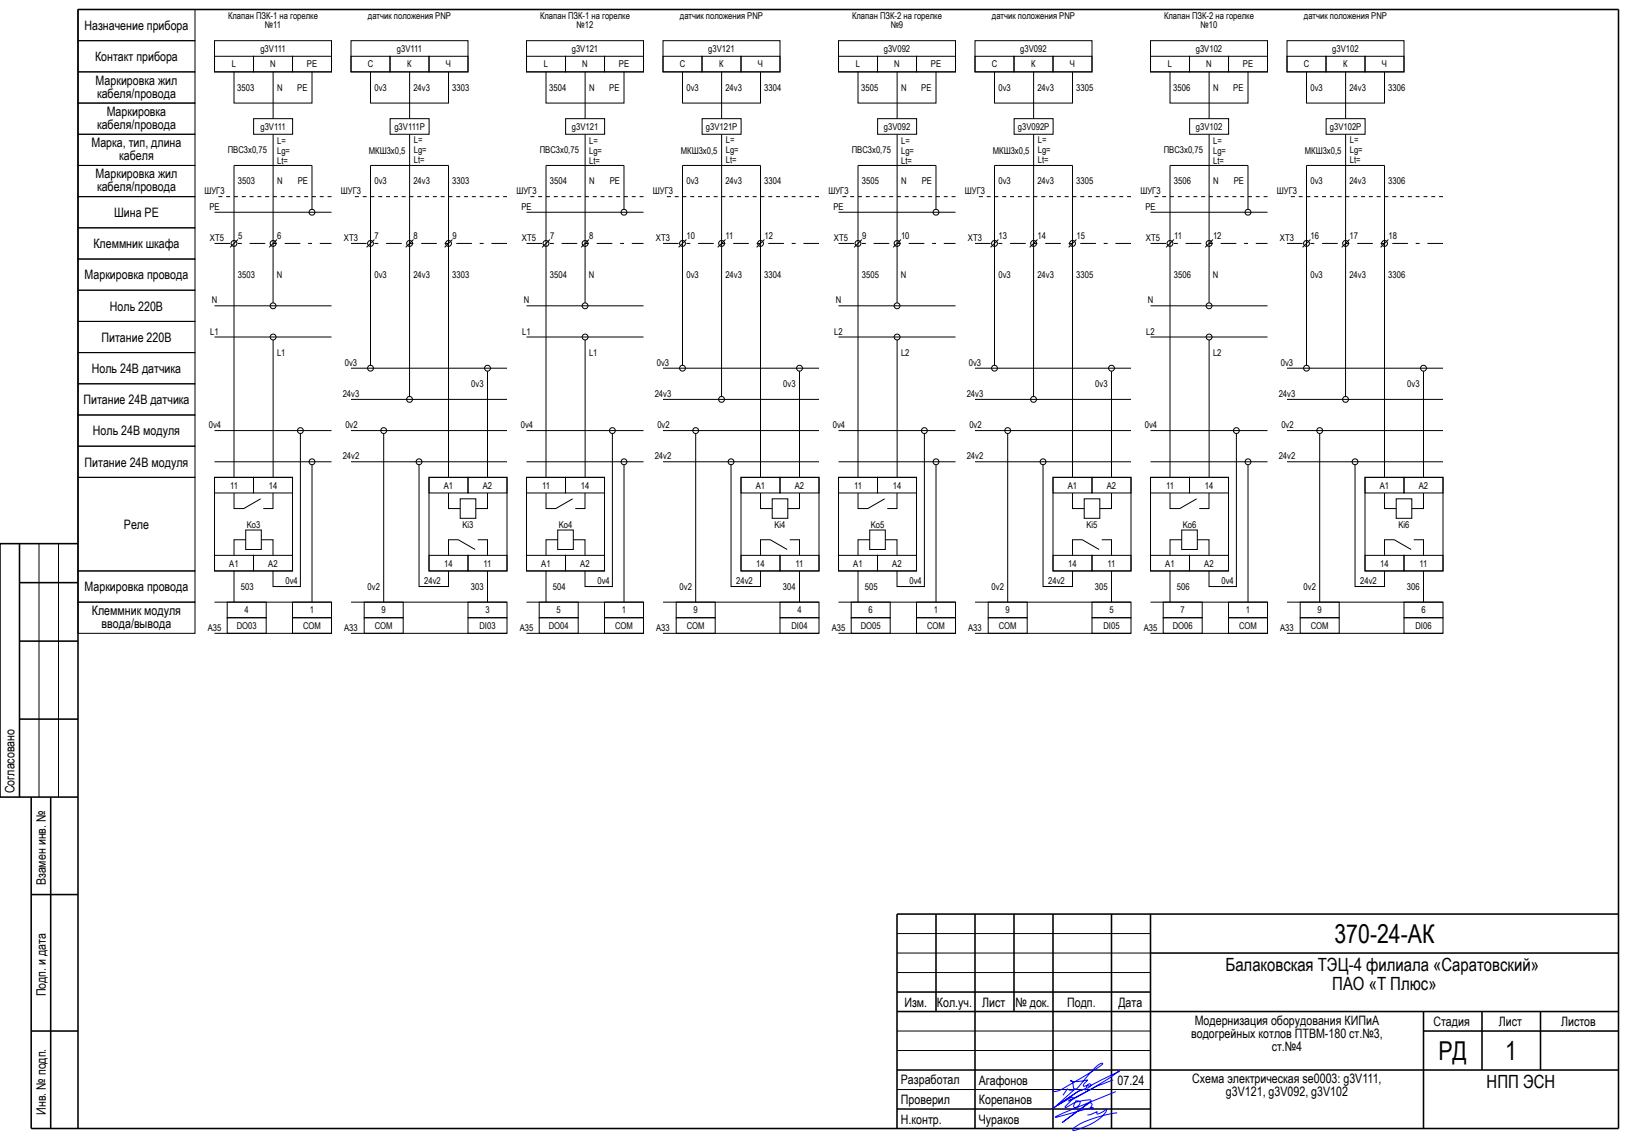
[picture p121: page 21]
Согласовано; Клеммник шкафа; Шина PE; кабеля/провода; Клеммник модуля ввода/вывода; Маркировка провода; Питание 220В; Реле; Ноль 220В; Питание 24В датчика; Ноль 24В датчика; Питание 24В модуля; Ноль 24В модуля; ШУГ3; COM; 1 COM; МКШ3х0,5; ПВС3х0,75

Клапан ПЗК-1 на горелке

датчик положения PNP

Клапан ПЗК-2 на горелке

Контакт прибора
Маркировка жил
кабеля/провода
Маркировка
Марка, тип, длина
кабеля

Инв. № подп. Подп. и дата Взамен инв. №

Балаковская ТЭЦ-4 филиала «Саратовский» ПАО «Т Плюс»

Изм. | Кол.уч. | Лист | № док. | Подп. | Дата

Модернизация оборудования КИПиА водогрейных котлов ПТВМ-180 ст.№3, ст.№4 | Стадия | Лист | Листов

Схема электрическая se0003: g3V111, g3V121, g3V092, g3V102 | НПП ЭСН

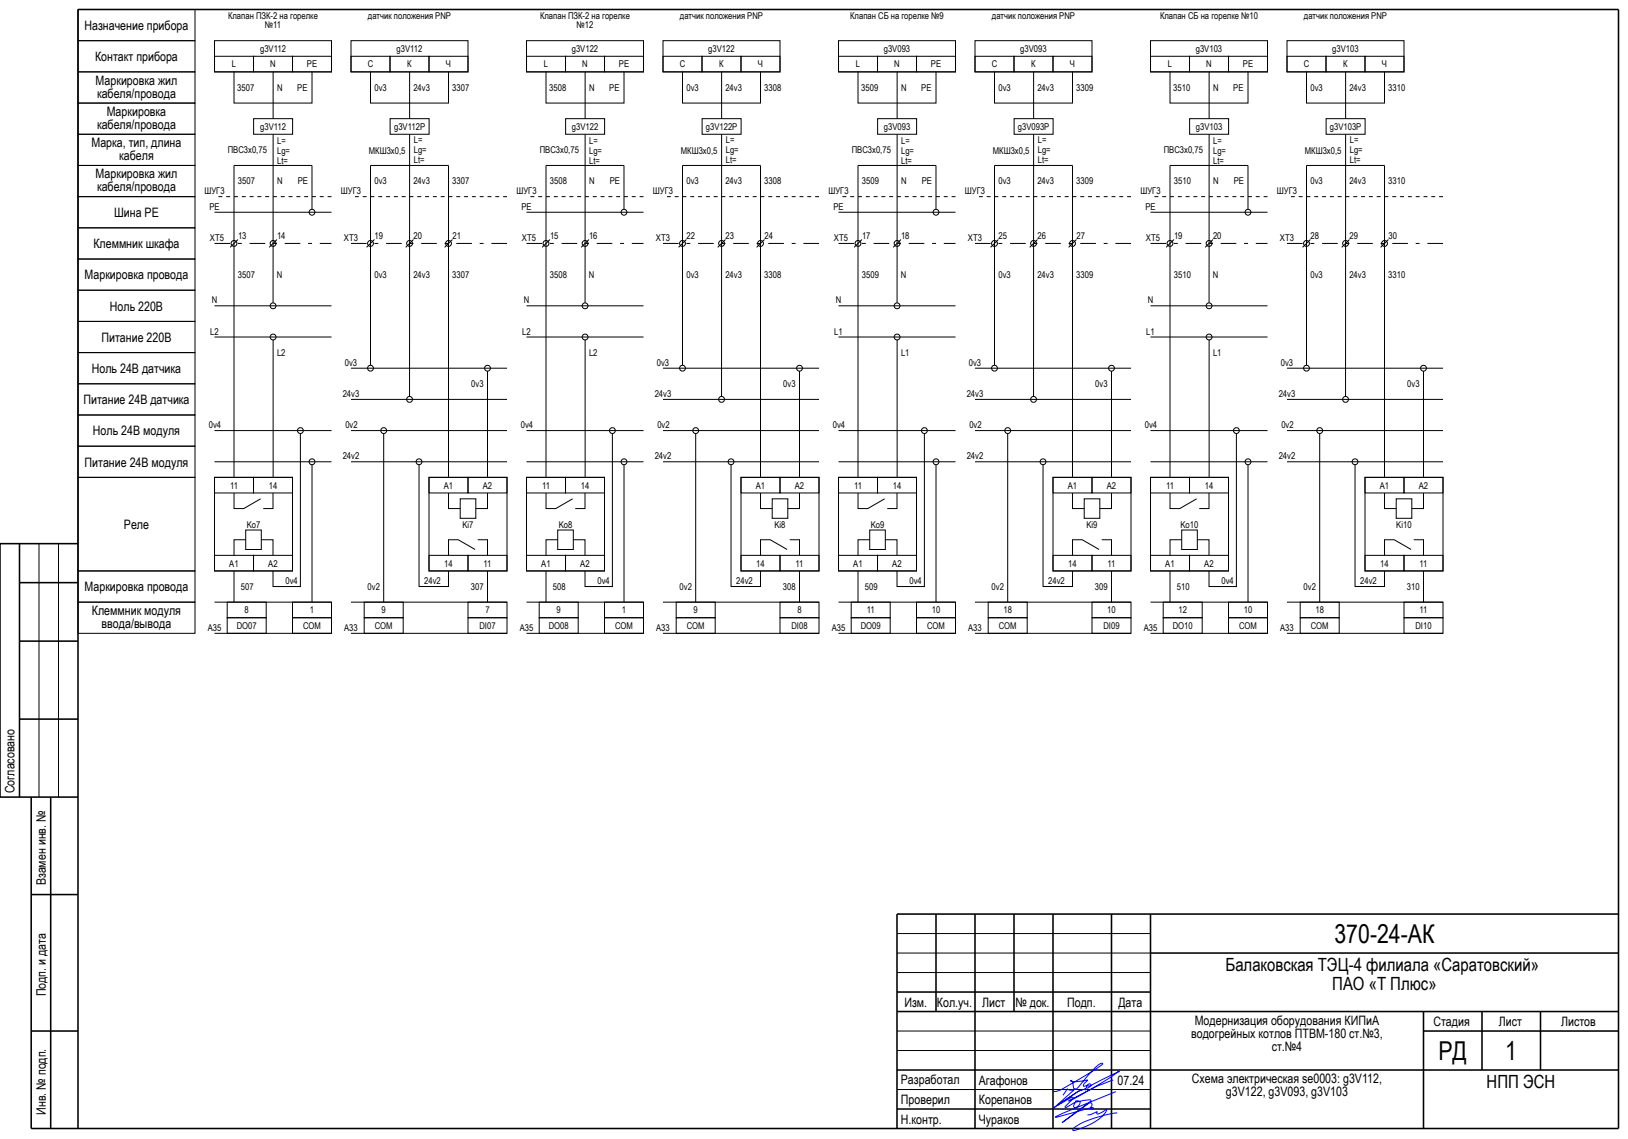
[picture p122: page 22]
Согласовано; Клеммник шкафа; Шина PE; кабеля/провода; Клеммник модуля ввода/вывода; Маркировка провода; Питание 220В; Реле; Ноль 220В; Питание 24В датчика; Ноль 24В датчика; Питание 24В модуля; Ноль 24В модуля; ШУГ3; COM; 1 COM; 10 COM; МКШ3х0,5; ПВС3х0,75

Клапан ПЗК-2 на горелке

датчик положения PNP

Клапан СБ на горелке №9

Клапан СБ на горелке №10

Контакт прибора
Маркировка жил
кабеля/провода
Маркировка
Марка, тип, длина
кабеля

Инв. № подп. Подп. и дата Взамен инв. №

Балаковская ТЭЦ-4 филиала «Саратовский» ПАО «Т Плюс»

Изм. | Кол.уч. | Лист | № док. | Подп. | Дата

Модернизация оборудования КИПиА водогрейных котлов ПТВМ-180 ст.№3, ст.№4 | Стадия | Лист | Листов

Схема электрическая se0003: g3V112, g3V122, g3V093, g3V103 | НПП ЭСН

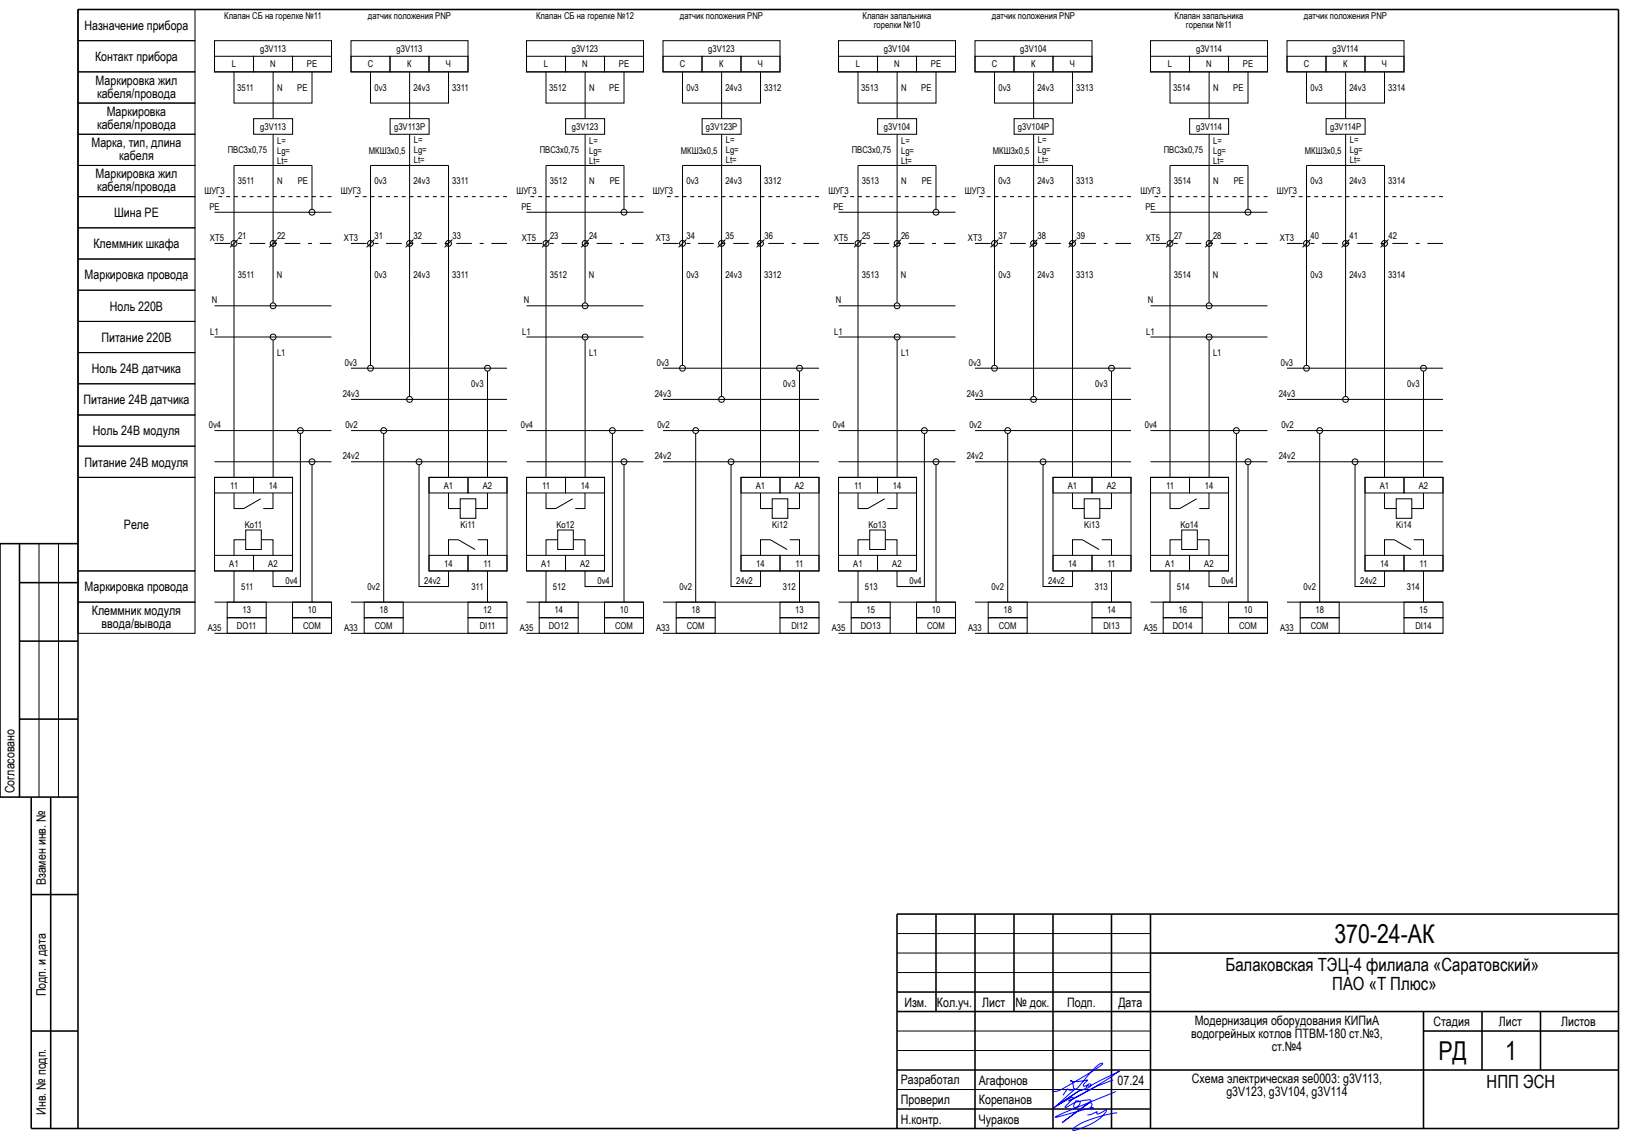
[picture p123: page 23]
Согласовано; Клеммник шкафа; Шина PE; кабеля/провода; Клеммник модуля ввода/вывода; Маркировка провода; Питание 220В; Реле; Ноль 220В; Питание 24В датчика; Ноль 24В датчика; Питание 24В модуля; Ноль 24В модуля; ШУГ3; COM; 10 COM; МКШ3х0,5; ПВС3х0,75; Клапан запальника горелки №10; Клапан запальника горелки №11

Клапан СБ на горелке №11

датчик положения PNP

Клапан СБ на горелке №12

Контакт прибора
Маркировка жил
кабеля/провода
Маркировка
Марка, тип, длина
кабеля

Инв. № подп. Подп. и дата Взамен инв. №

Балаковская ТЭЦ-4 филиала «Саратовский» ПАО «Т Плюс»

Изм. | Кол.уч. | Лист | № док. | Подп. | Дата

Модернизация оборудования КИПиА водогрейных котлов ПТВМ-180 ст.№3, ст.№4 | Стадия | Лист | Листов

Схема электрическая se0003: g3V113, g3V123, g3V104, g3V114 | НПП ЭСН

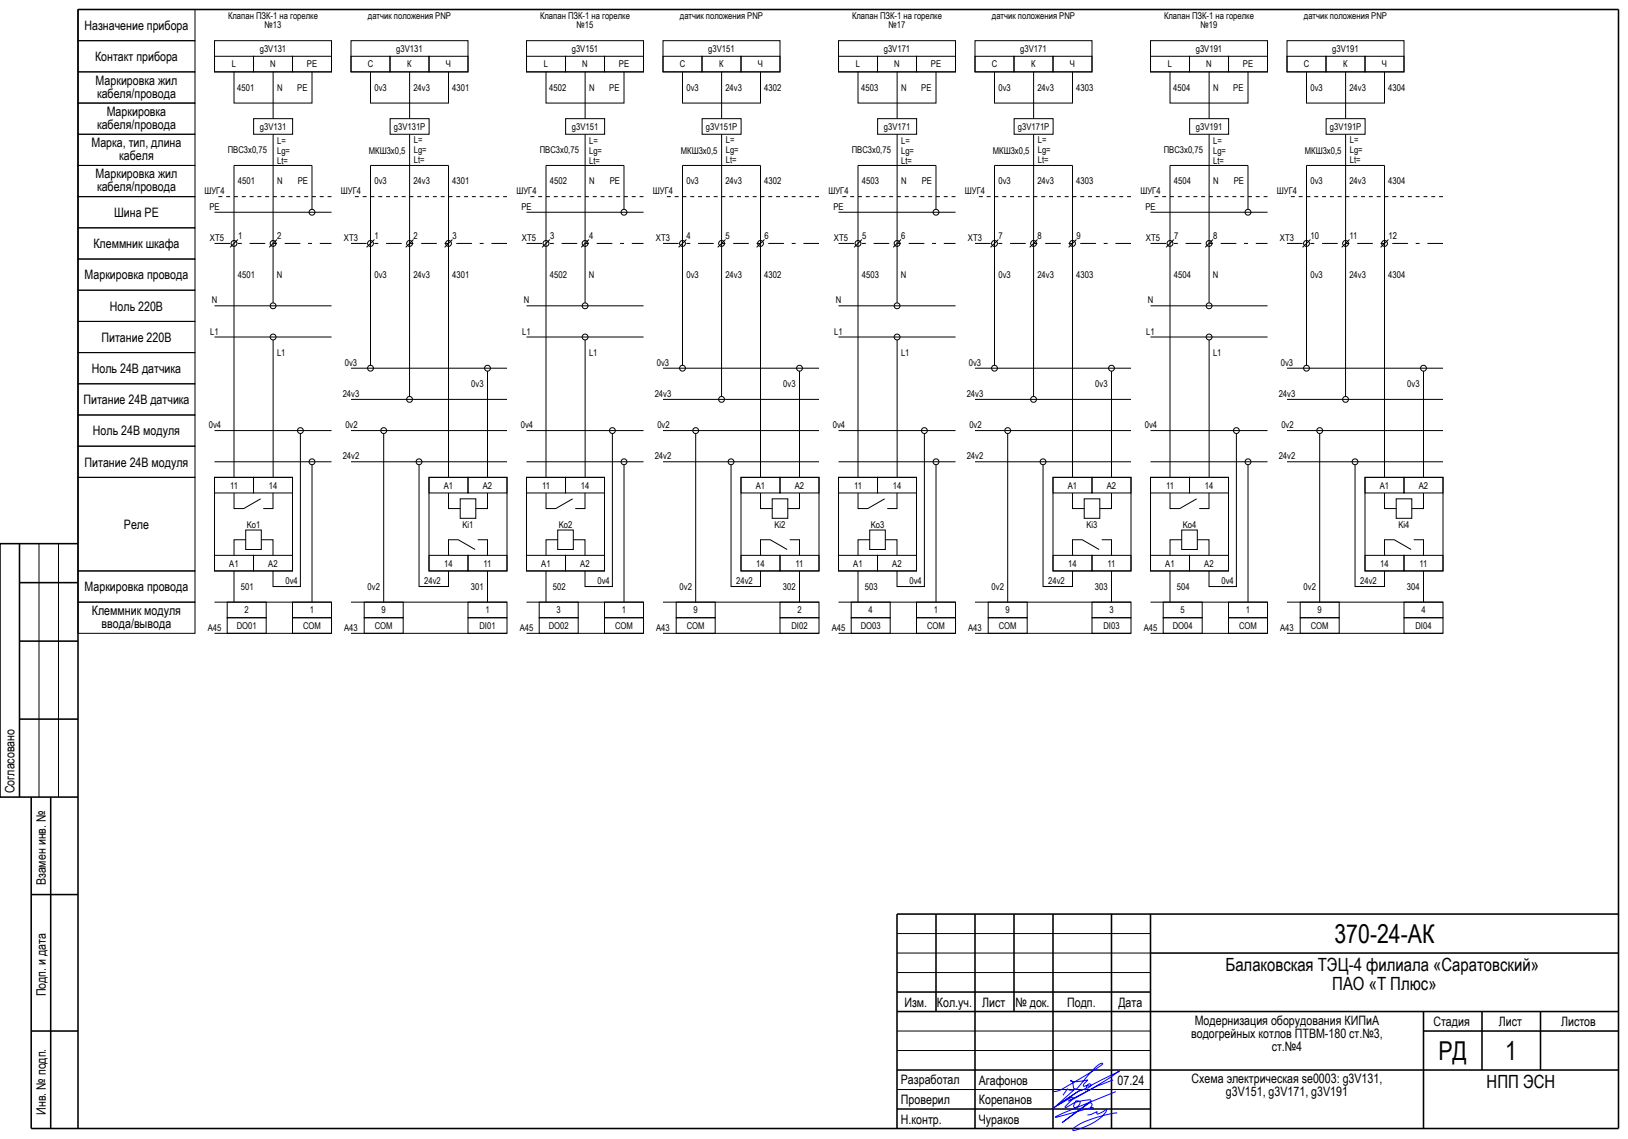
[picture p124: page 24]
Согласовано; Клеммник шкафа; Шина PE; кабеля/провода; Клеммник модуля ввода/вывода; Маркировка провода; Питание 220В; Реле; Ноль 220В; Питание 24В датчика; Ноль 24В датчика; Питание 24В модуля; Ноль 24В модуля; ШУГ4; COM; 1 COM; МКШ3х0,5; ПВС3х0,75

Клапан ПЗК-1 на горелке

датчик положения PNP

Контакт прибора
Маркировка жил
кабеля/провода
Маркировка
Марка, тип, длина
кабеля

Инв. № подп. Подп. и дата Взамен инв. №

Балаковская ТЭЦ-4 филиала «Саратовский» ПАО «Т Плюс»

Изм. | Кол.уч. | Лист | № док. | Подп. | Дата

Модернизация оборудования КИПиА водогрейных котлов ПТВМ-180 ст.№3, ст.№4 | Стадия | Лист | Листов

Схема электрическая se0003: g3V131, g3V151, g3V171, g3V191 | НПП ЭСН

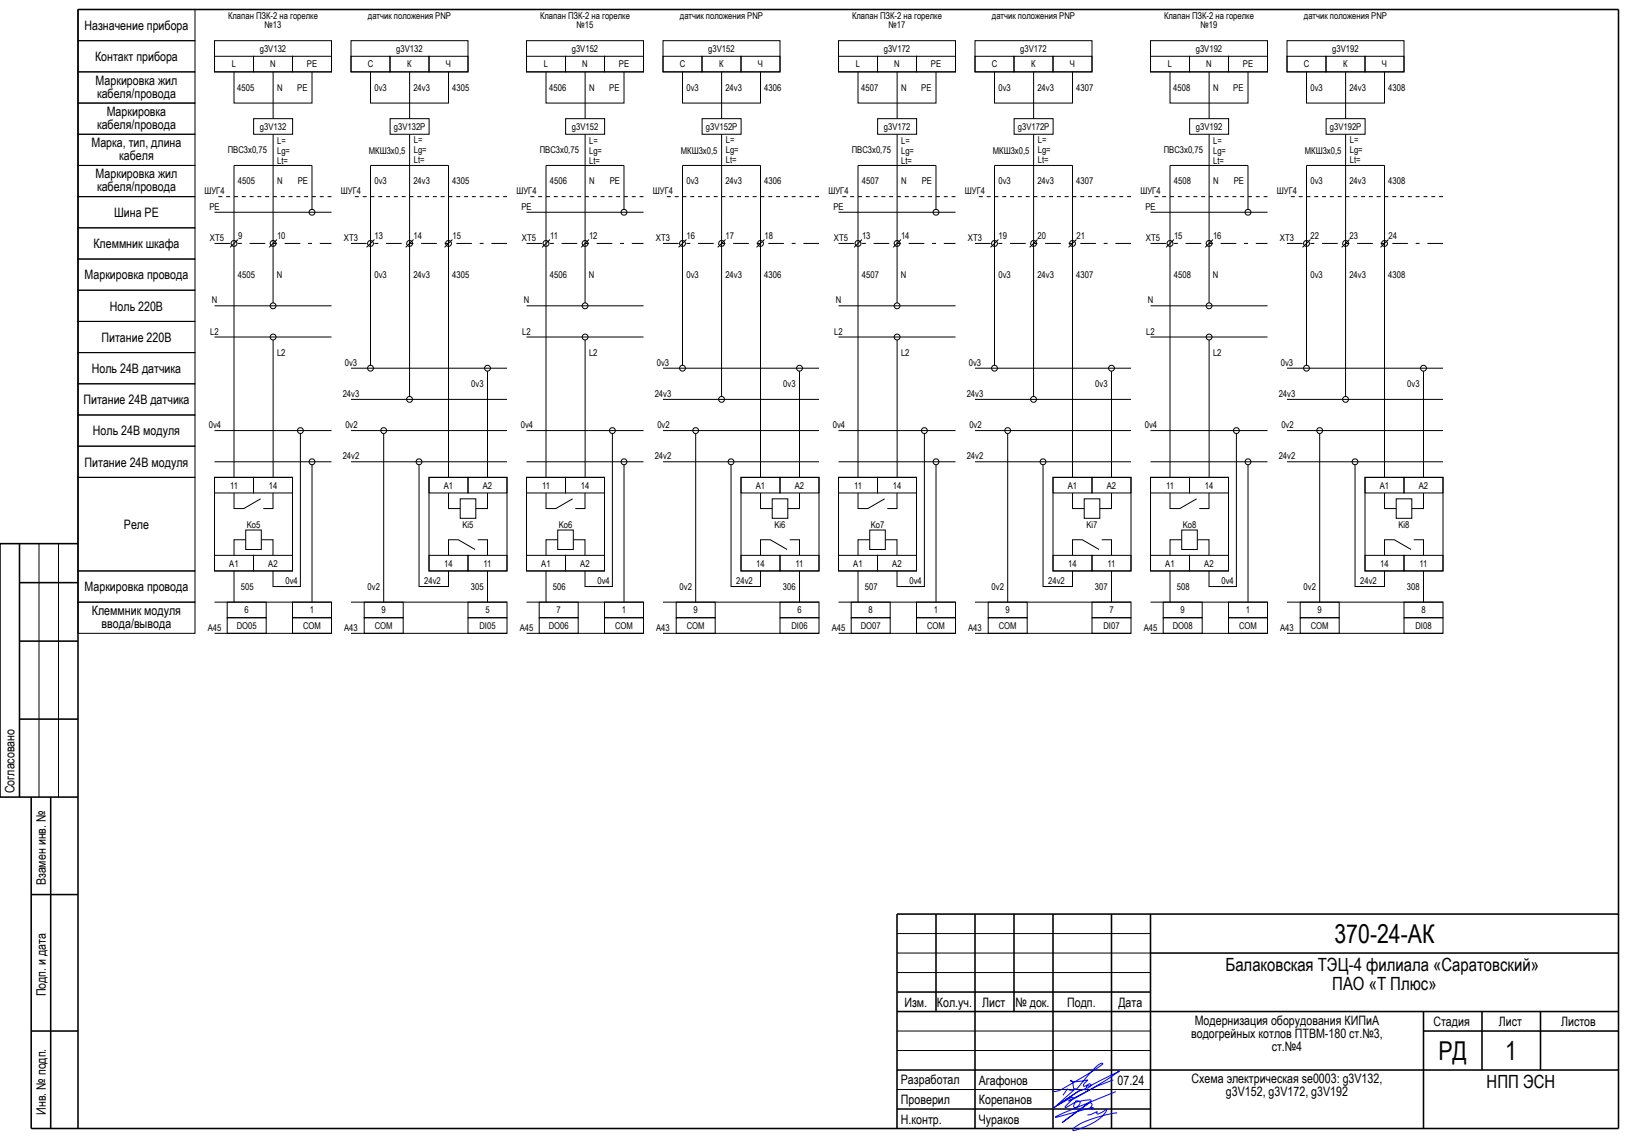
[picture p125: page 25]
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

Клапан ПЗК-2 на горелке

датчик положения PNP

Контакт прибора
Маркировка жил
кабеля/провода
Маркировка
Марка, тип, длина
кабеля

Инв. № подп. Подп. и дата Взамен инв. №

Балаковская ТЭЦ-4 филиала «Саратовский» ПАО «Т Плюс»

Изм. | Кол.уч. | Лист | № док. | Подп. | Дата

Модернизация оборудования КИПиА водогрейных котлов ПТВМ-180 ст.№3, ст.№4 | Стадия | Лист | Листов

Схема электрическая se0003: g3V132, g3V152, g3V172, g3V192 | НПП ЭСН

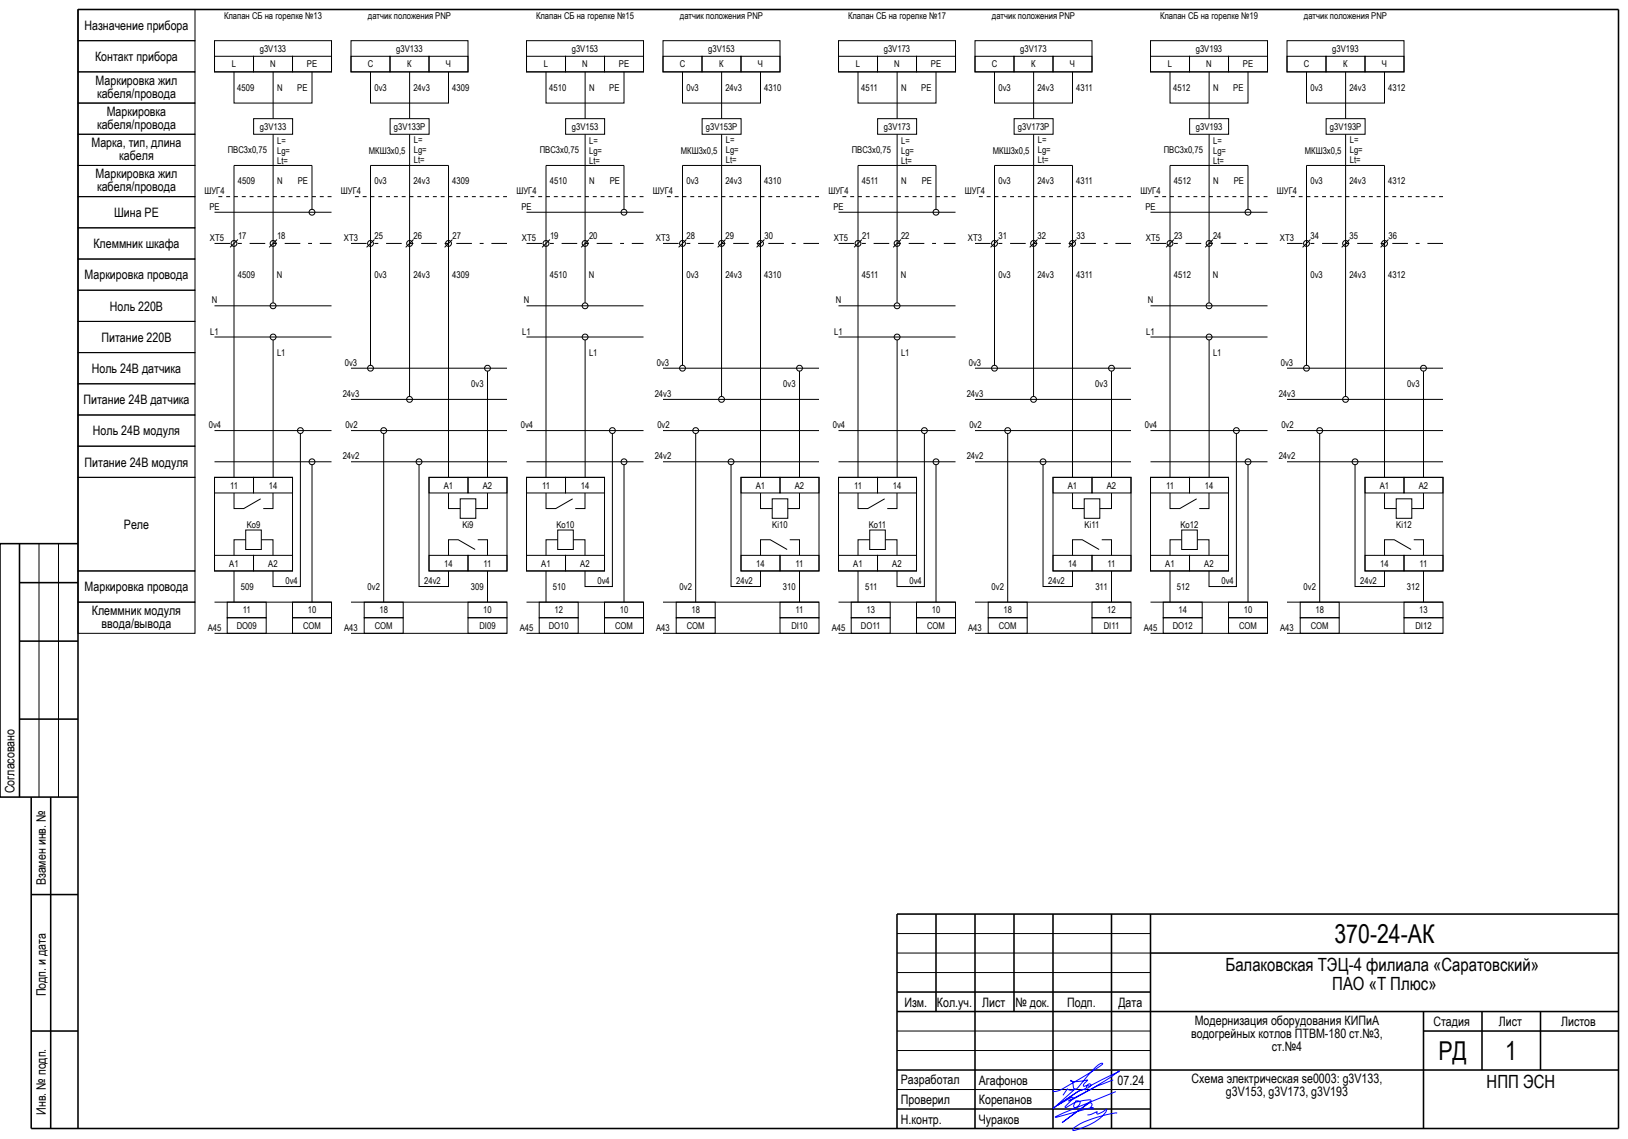
[picture p126: page 26]
Согласовано; Клеммник шкафа; Шина PE; кабеля/провода; Клеммник модуля ввода/вывода; Маркировка провода; Питание 220В; Реле; Ноль 220В; Питание 24В датчика; Ноль 24В датчика; Питание 24В модуля; Ноль 24В модуля; ШУГ4; COM; 10 COM; МКШ3х0,5; ПВС3х0,75

Клапан СБ на горелке №13

датчик положения PNP

Клапан СБ на горелке №15

Клапан СБ на горелке №17

Клапан СБ на горелке №19

Контакт прибора
Маркировка жил
кабеля/провода
Маркировка
Марка, тип, длина
кабеля

Инв. № подп. Подп. и дата Взамен инв. №

Балаковская ТЭЦ-4 филиала «Саратовский» ПАО «Т Плюс»

Изм. | Кол.уч. | Лист | № док. | Подп. | Дата

Модернизация оборудования КИПиА водогрейных котлов ПТВМ-180 ст.№3, ст.№4 | Стадия | Лист | Листов

Схема электрическая se0003: g3V133, g3V153, g3V173, g3V193 | НПП ЭСН

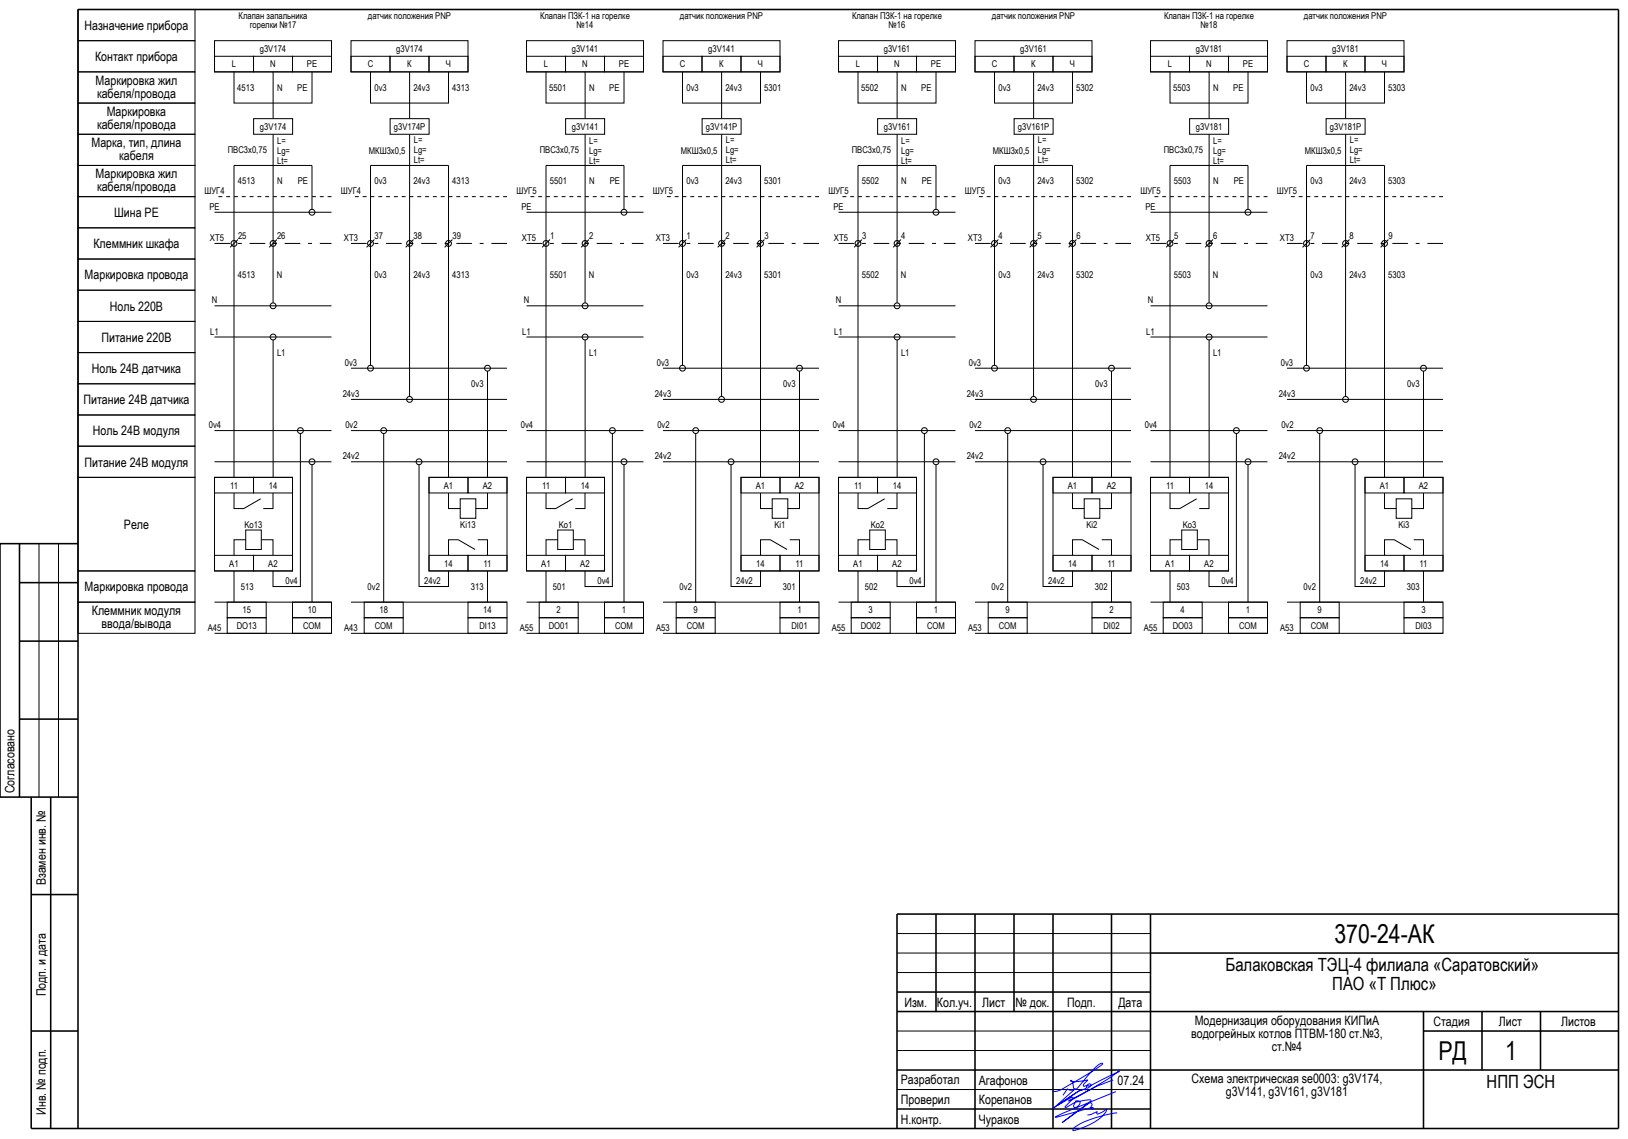
[picture p127: page 27]
Согласовано; Клеммник шкафа; Шина PE; кабеля/провода; Клеммник модуля ввода/вывода; Маркировка провода; Питание 220В; Реле; Ноль 220В; Питание 24В датчика; Ноль 24В датчика; Питание 24В модуля; Ноль 24В модуля; ШУГ4; COM; 10 COM; ШУГ5; 1 COM; Клапан запальника горелки №17; МКШ3х0,5; ПВС3х0,75

датчик положения PNP

Клапан ПЗК-1 на горелке

Контакт прибора
Маркировка жил
кабеля/провода
Маркировка
Марка, тип, длина
кабеля

Инв. № подп. Подп. и дата Взамен инв. №

Балаковская ТЭЦ-4 филиала «Саратовский» ПАО «Т Плюс»

Изм. | Кол.уч. | Лист | № док. | Подп. | Дата

Модернизация оборудования КИПиА водогрейных котлов ПТВМ-180 ст.№3, ст.№4 | Стадия | Лист | Листов

Схема электрическая se0003: g3V174, g3V141, g3V161, g3V181 | НПП ЭСН

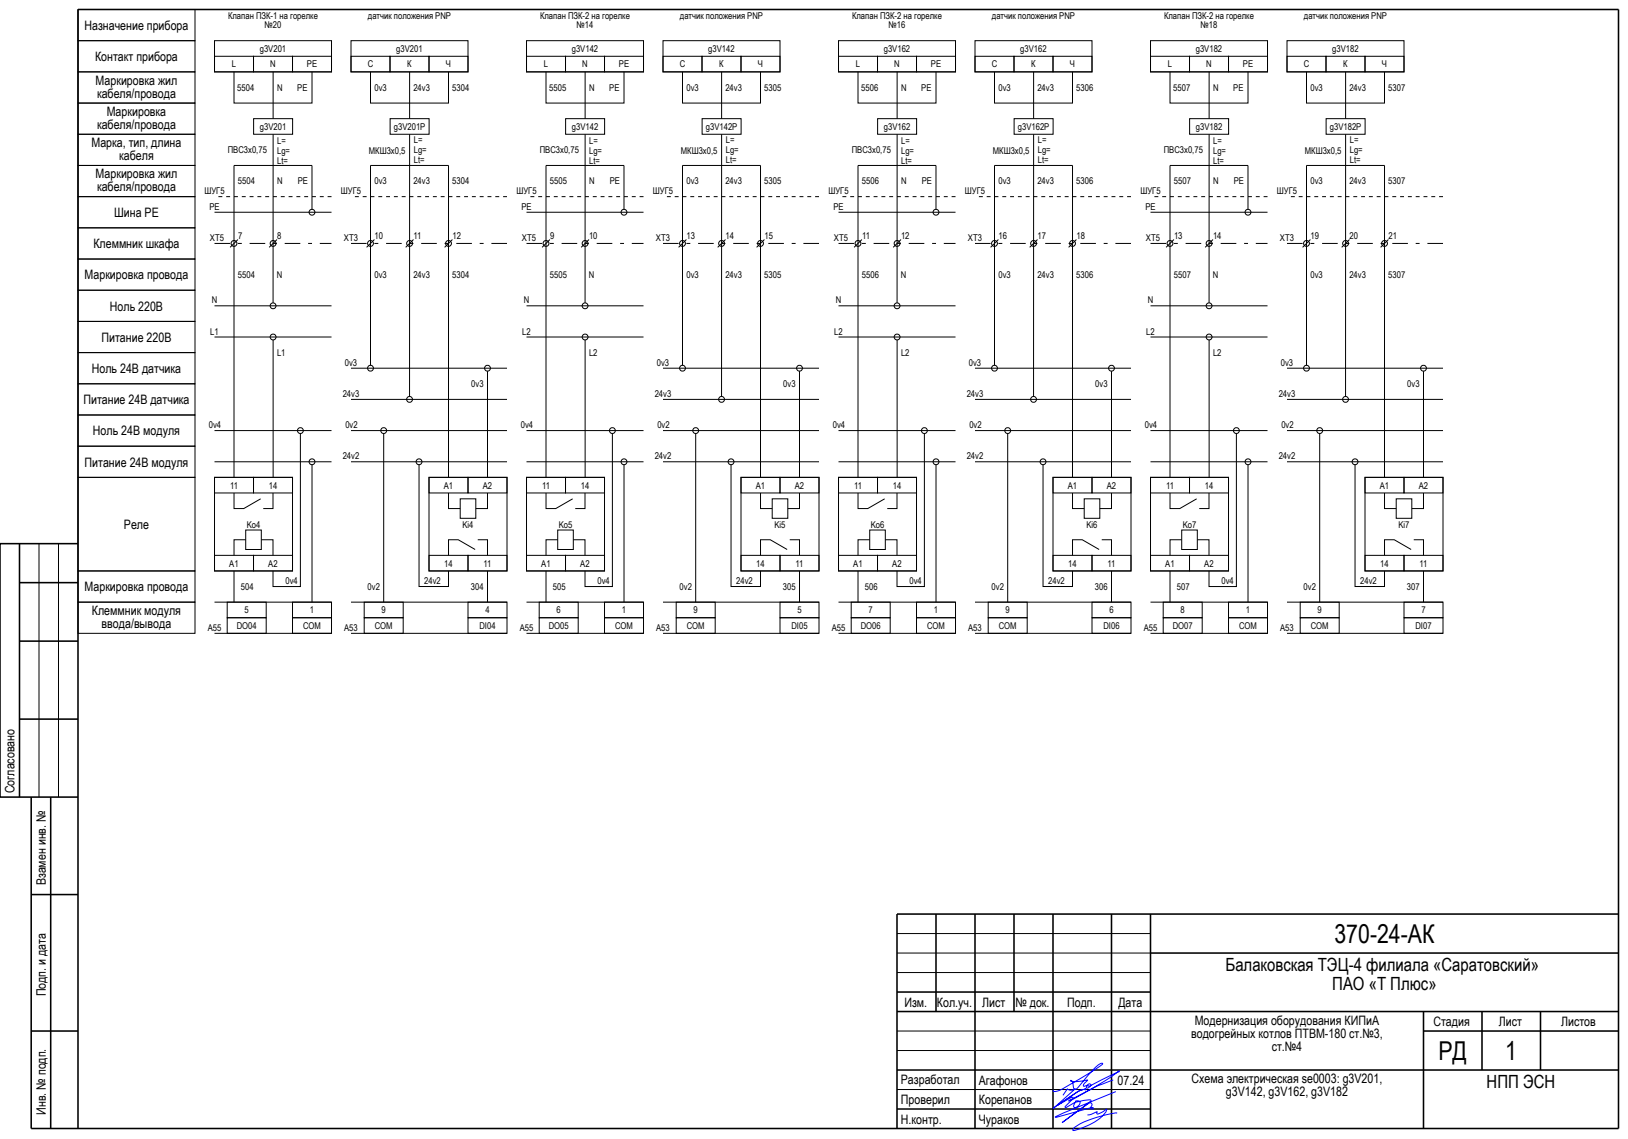
[picture p128: page 28]
Согласовано; Клеммник шкафа; Шина PE; кабеля/провода; Клеммник модуля ввода/вывода; Маркировка провода; Питание 220В; Реле; Ноль 220В; Питание 24В датчика; Ноль 24В датчика; Питание 24В модуля; Ноль 24В модуля; ШУГ5; COM; 1 COM; МКШ3х0,5; ПВС3х0,75

Клапан ПЗК-1 на горелке

датчик положения PNP

Клапан ПЗК-2 на горелке

Контакт прибора
Маркировка жил
кабеля/провода
Маркировка
Марка, тип, длина
кабеля

Инв. № подп. Подп. и дата Взамен инв. №

Балаковская ТЭЦ-4 филиала «Саратовский» ПАО «Т Плюс»

Изм. | Кол.уч. | Лист | № док. | Подп. | Дата

Модернизация оборудования КИПиА водогрейных котлов ПТВМ-180 ст.№3, ст.№4 | Стадия | Лист | Листов

Схема электрическая se0003: g3V201, g3V142, g3V162, g3V182 | НПП ЭСН

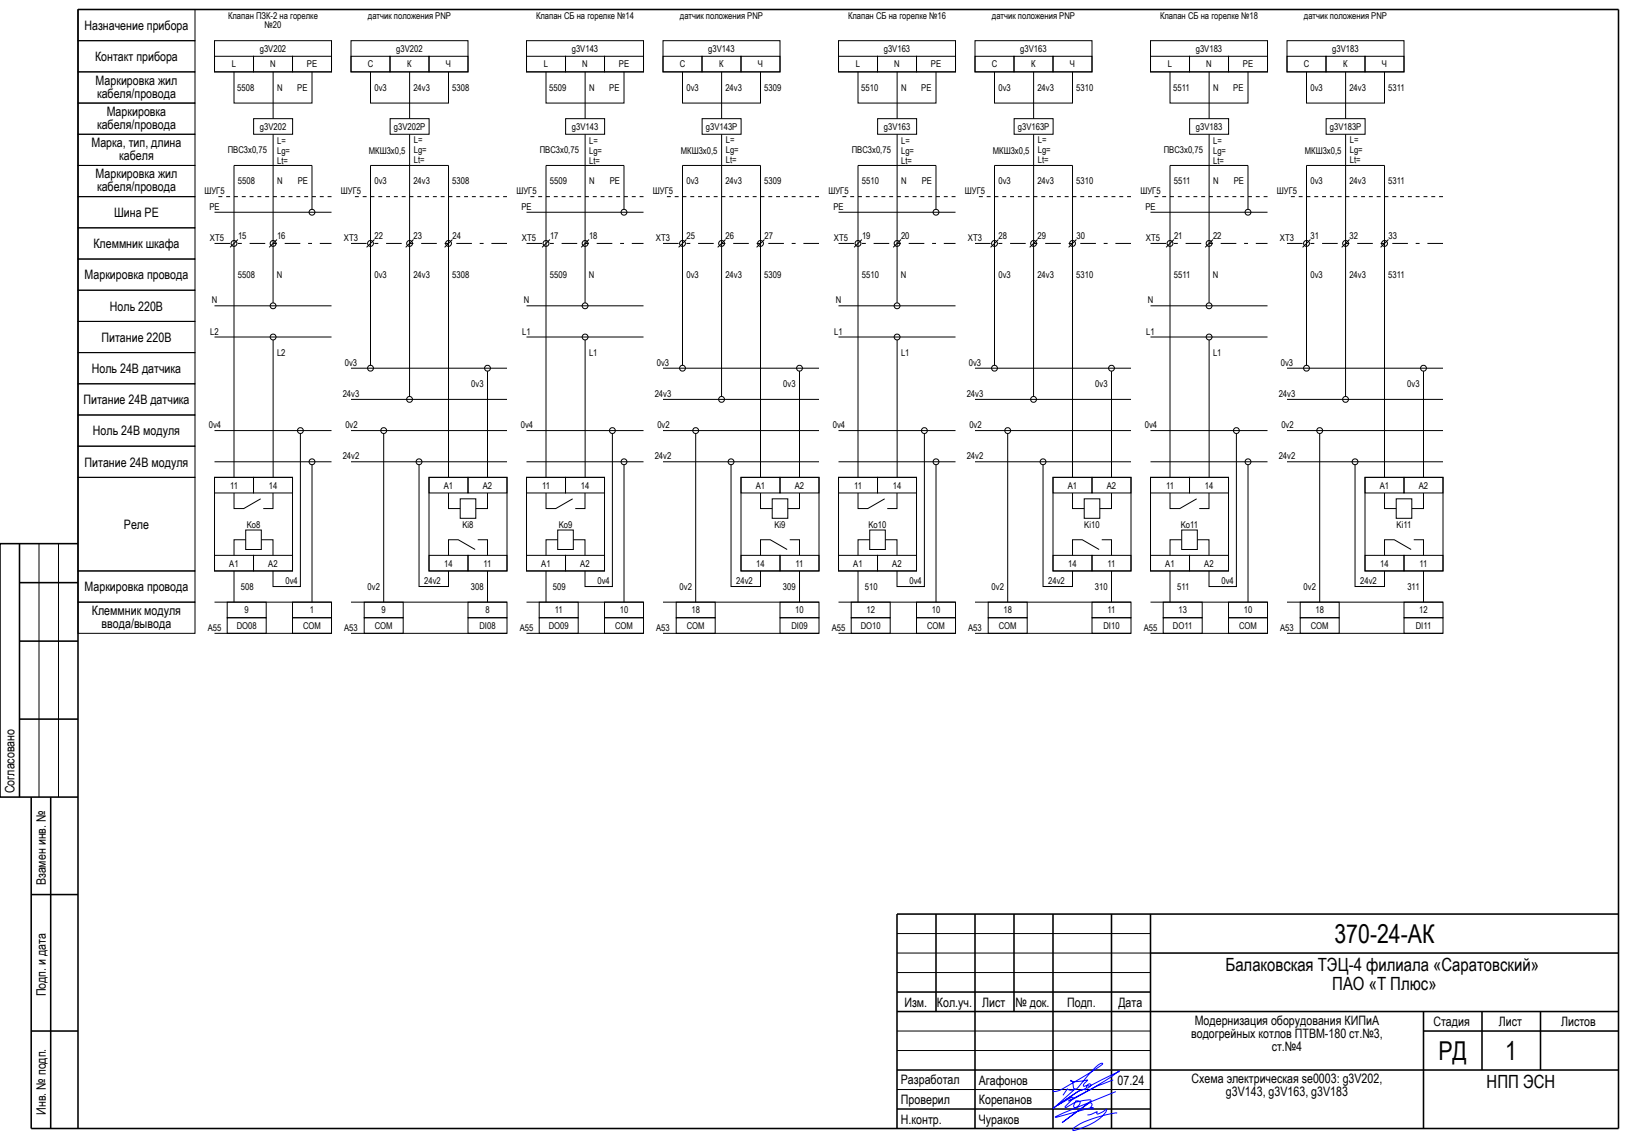
[picture p129: page 29]
Согласовано; Клеммник шкафа; Шина PE; кабеля/провода; Клеммник модуля ввода/вывода; Маркировка провода; Питание 220В; Реле; Ноль 220В; Питание 24В датчика; Ноль 24В датчика; Питание 24В модуля; Ноль 24В модуля; ШУГ5; COM; 1 COM; 10 COM; МКШ3х0,5; ПВС3х0,75

Клапан ПЗК-2 на горелке

датчик положения PNP

Клапан СБ на горелке №14

Клапан СБ на горелке №16

Клапан СБ на горелке №18

Контакт прибора
Маркировка жил
кабеля/провода
Маркировка
Марка, тип, длина
кабеля

Инв. № подп. Подп. и дата Взамен инв. №

Балаковская ТЭЦ-4 филиала «Саратовский» ПАО «Т Плюс»

Изм. | Кол.уч. | Лист | № док. | Подп. | Дата

Модернизация оборудования КИПиА водогрейных котлов ПТВМ-180 ст.№3, ст.№4 | Стадия | Лист | Листов

Схема электрическая se0003: g3V202, g3V143, g3V163, g3V183 | НПП ЭСН

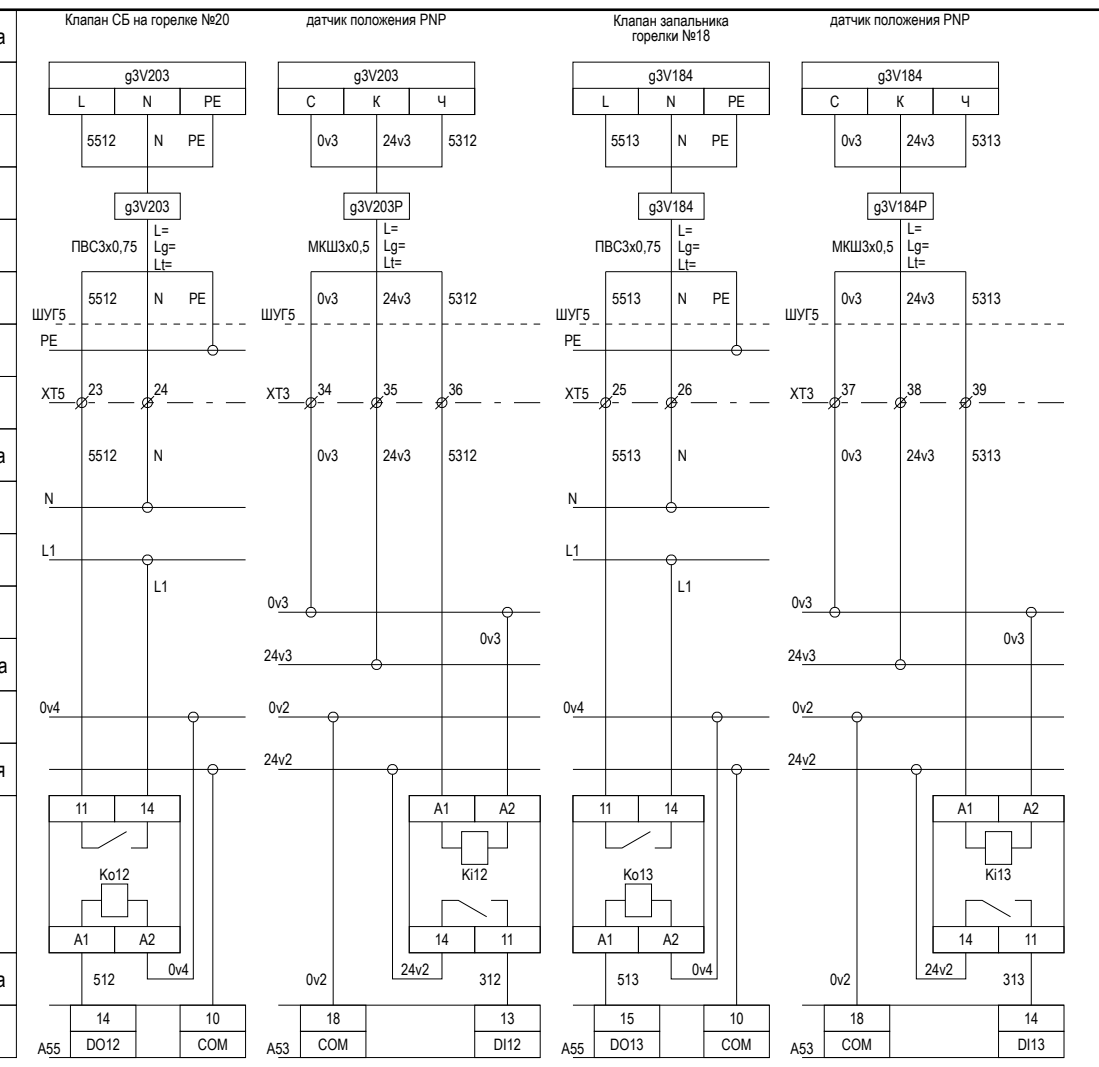
[picture p130: page 30]
Согласовано; Клеммник шкафа; Клеммник модуля ввода/вывода; Маркировка провода; Питание 220В; Реле; Ноль 220В; Питание 24В датчика; Ноль 24В датчика; Питание 24В модуля; Ноль 24В модуля; ШУГ5; COM; 10 COM; МКШ3х0,5; ПВС3х0,75; Клапан запальника горелки №18

Клапан СБ на горелке №20

датчик положения PNP

Контакт прибора
Маркировка жил
кабеля/провода
Маркировка
Марка, тип, длина
кабеля
Шина PE

Инв. № подп. Подп. и дата Взамен инв. №

Балаковская ТЭЦ-4 филиала «Саратовский» ПАО «Т Плюс»

Изм. | Кол.уч. | Лист | № док. | Подп. | Дата

Модернизация оборудования КИПиА водогрейных котлов ПТВМ-180 ст.№3, ст.№4 | Стадия | Лист | Листов

Схема электрическая se0003: g3V203, g3V184 | НПП ЭСН

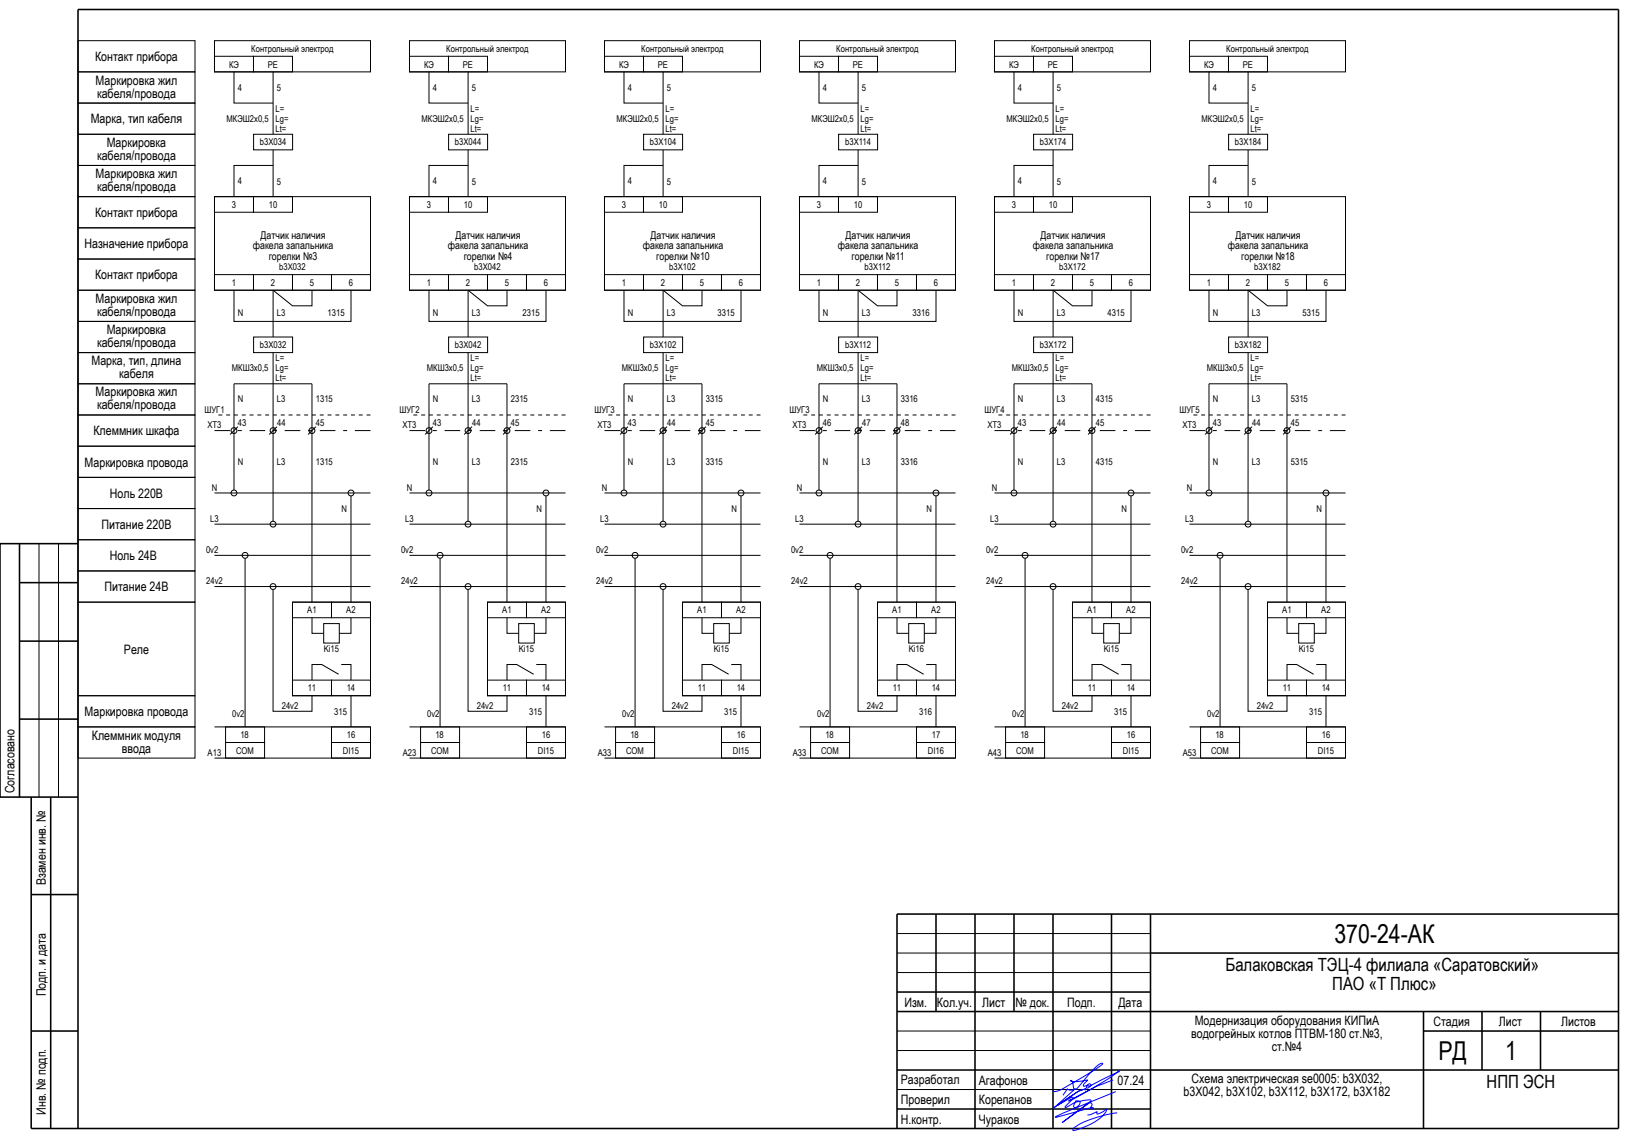
[picture p131: page 31]
Согласовано; Клеммник шкафа; кабеля/провода; Клеммник модуля ввода; Маркировка провода; Питание 220В; Реле; Ноль 220В; Питание 24В; Ноль 24В; ШУГ1; COM; ШУГ2; ШУГ3; ШУГ4; ШУГ5; Назначение прибора; Контакт прибора; Датчик наличия факела запальника горелки №3; Контрольный электрод; МКШ3х0,5; МКЭШ2х0,5; Датчик наличия факела запальника горелки №4; Датчик наличия факела запальника горелки №10; Датчик наличия факела запальника горелки №11; Датчик наличия факела запальника горелки №17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

Контакт прибора
Маркировка жил
кабеля/провода
Марка, тип кабеля
Маркировка

Марка, тип, длина
кабеля

Инв. № подп. Подп. и дата Взамен инв. №

Балаковская ТЭЦ-4 филиала «Саратовский» ПАО «Т Плюс»

Изм. | Кол.уч. | Лист | № док. | Подп. | Дата

Модернизация оборудования КИПиА водогрейных котлов ПТВМ-180 ст.№3, ст.№4 | Стадия | Лист | Листов

Схема электрическая se0005: b3X032, b3X042, b3X102, b3X112, b3X172, b3X182 | НПП ЭСН

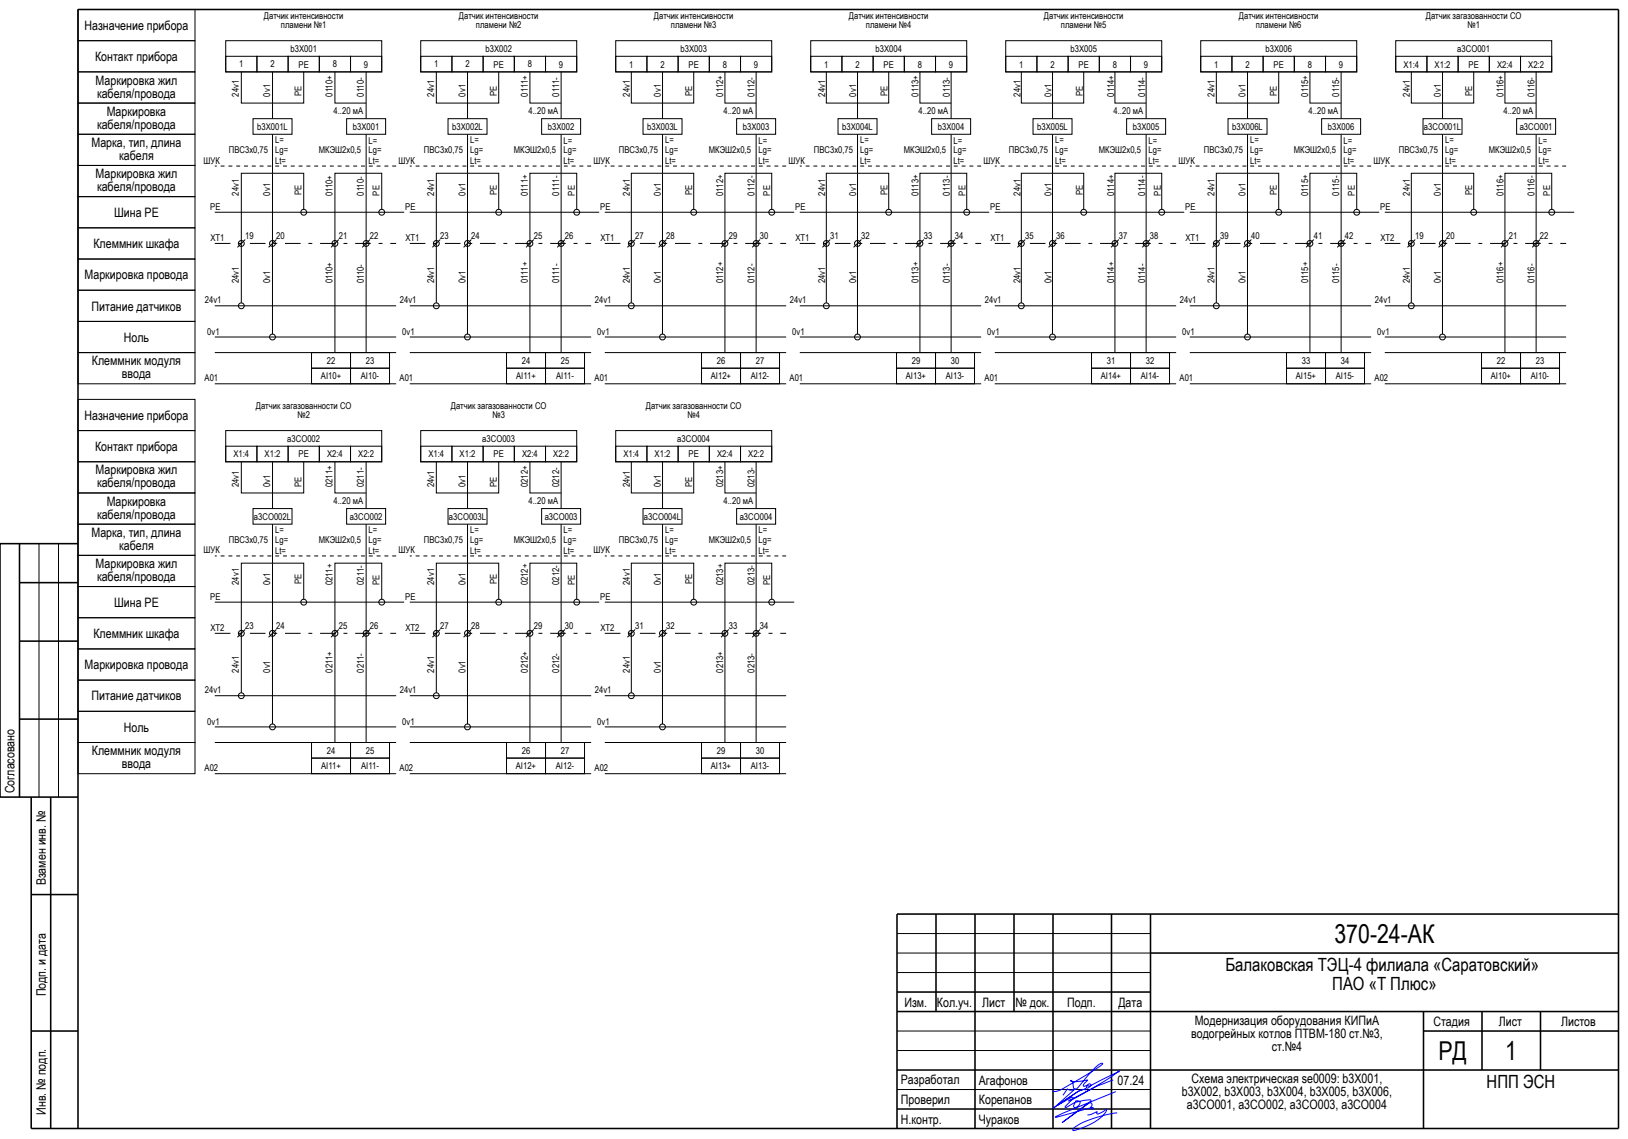
[picture p132: page 32]
Согласовано; Ноль; Питание датчиков; Клеммник шкафа; Шина PE; кабеля/провода; Клеммник модуля ввода; Маркировка провода; ШУК; Маркировка жил кабеля/провода; Контакт прибора; Датчик интенсивности пламени №1; ПВС3х0,75; МКЭШ2х0,5; PEPE; Датчик интенсивности пламени №2; Датчик интенсивности пламени №3; Датчик интенсивности пламени №4; Датчик интенсивности пламени №5; Датчик интенсивности пламени №6; кабеля; Назначение прибора

Датчик загазованности СО

Маркировка
кабеля/провода
Марка, тип, длина
кабеля
Маркировка жил

Контакт прибора

Инв. № подп. Подп. и дата Взамен инв. №

Балаковская ТЭЦ-4 филиала «Саратовский» ПАО «Т Плюс»

Изм. | Кол.уч. | Лист | № док. | Подп. | Дата

Модернизация оборудования КИПиА водогрейных котлов ПТВМ-180 ст.№3, ст.№4 | Стадия | Лист | Листов

Схема электрическая se0009: b3X001, b3X002, b3X003, b3X004, b3X005, b3X006, а3СО001, а3СО002, а3СО003, а3СО004 | НПП ЭСН

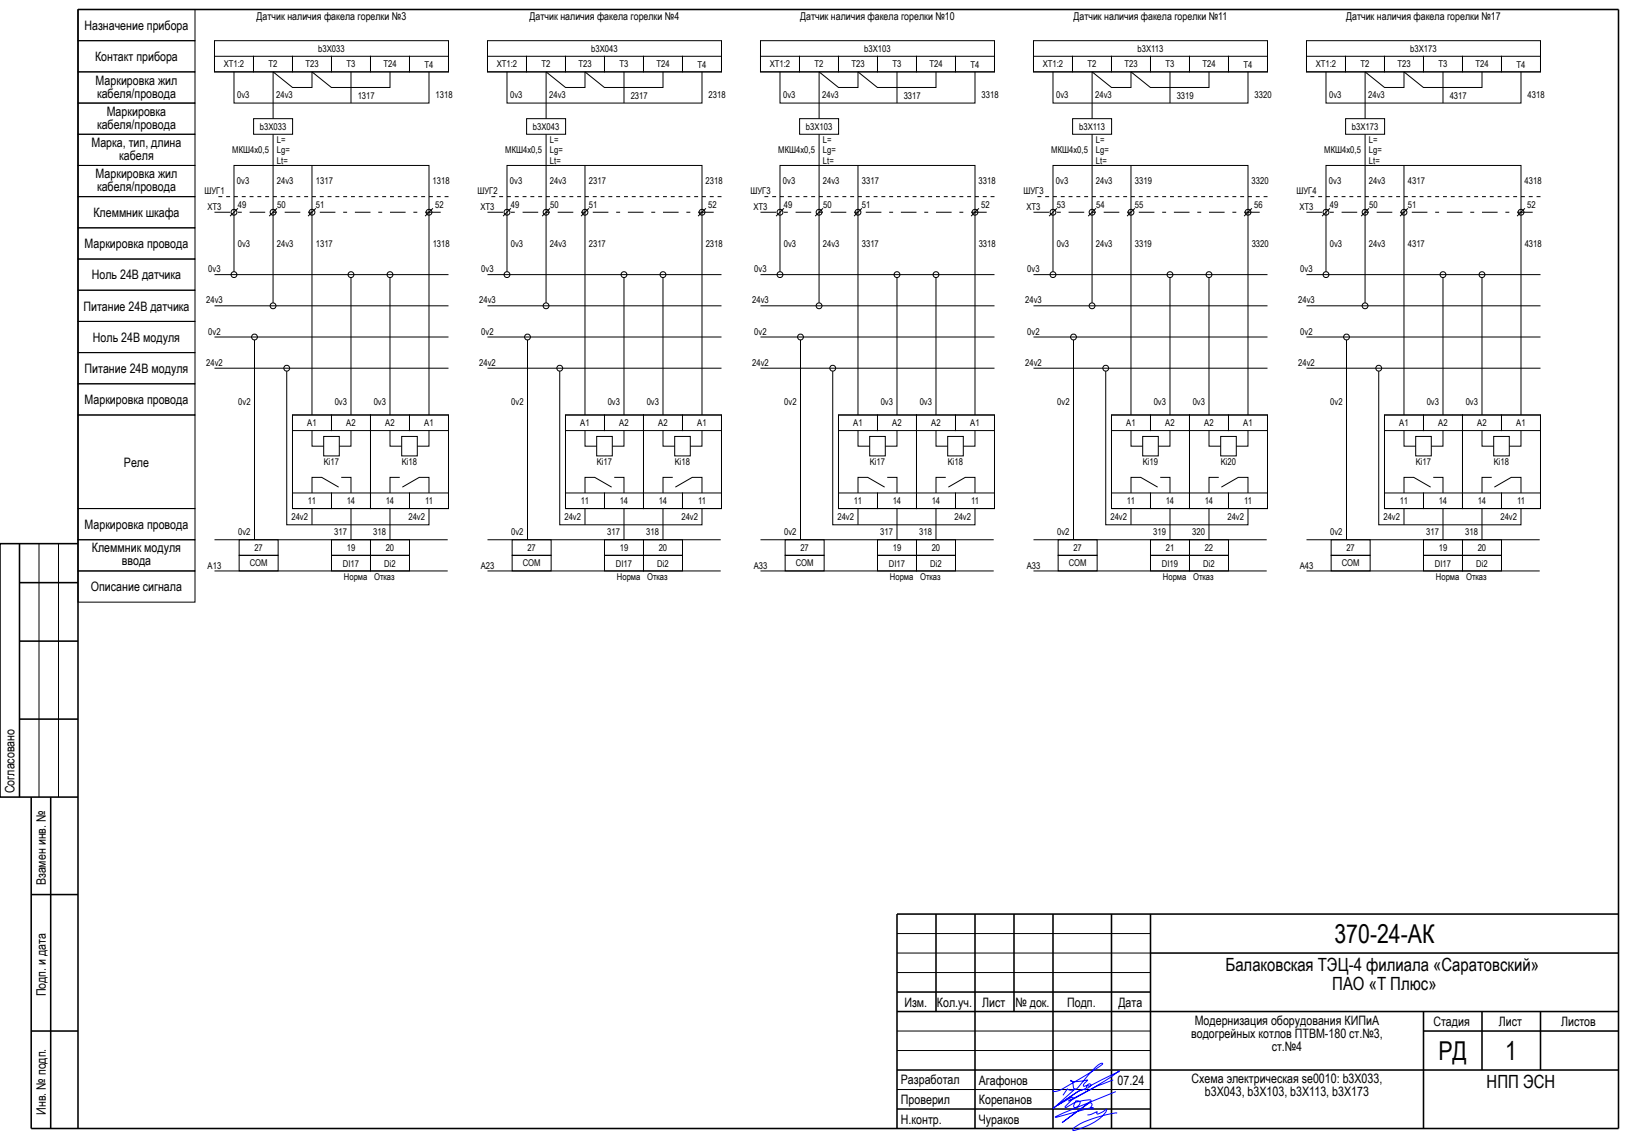
[picture p133: page 33]
Согласовано; Клеммник шкафа; Клеммник модуля ввода; Маркировка провода; Реле; Питание 24В датчика; Ноль 24В датчика; Питание 24В модуля; Ноль 24В модуля; Описание сигнала; ШУГ1; 27 COM; Норма Отказ; ШУГ2; ШУГ3; ШУГ4; Маркировка кабеля/провода; Контакт прибора; Маркировка жил кабеля/провода; Назначение прибора; Датчик наличия факела горелки №3; МКШ4х0,5

Датчик наличия факела горелки №4

Датчик наличия факела горелки №10

Датчик наличия факела горелки №11

Датчик наличия факела горелки №17

Марка, тип, длина
кабеля
Маркировка жил
кабеля/провода

Инв. № подп. Подп. и дата Взамен инв. №

Балаковская ТЭЦ-4 филиала «Саратовский» ПАО «Т Плюс»

Изм. | Кол.уч. | Лист | № док. | Подп. | Дата

Модернизация оборудования КИПиА водогрейных котлов ПТВМ-180 ст.№3, ст.№4 | Стадия | Лист | Листов

Схема электрическая se0010: b3X033, b3X043, b3X103, b3X113, b3X173 | НПП ЭСН

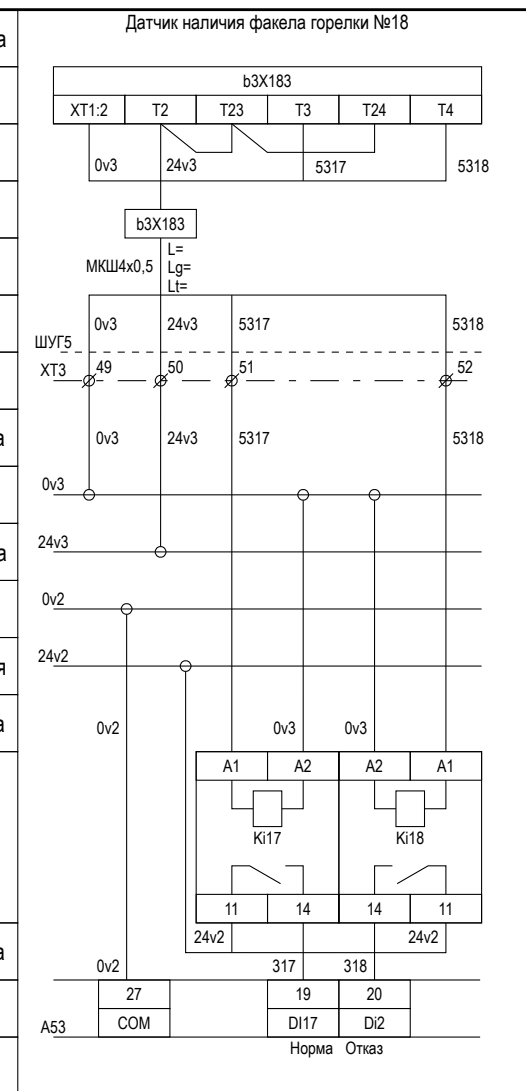
[picture p134: page 34]
Согласовано; Клеммник модуля ввода; Маркировка провода; Реле; Питание 24В датчика; Ноль 24В датчика; Питание 24В модуля; Ноль 24В модуля; Описание сигнала; ШУГ5; 27 COM; Норма Отказ; Назначение прибора; Датчик наличия факела горелки №18; МКШ4х0,5

Контакт прибора
Маркировка жил
кабеля/провода
Маркировка
Марка, тип, длина
кабеля
Клеммник шкафа

Инв. № подп. Подп. и дата Взамен инв. №

Балаковская ТЭЦ-4 филиала «Саратовский» ПАО «Т Плюс»

Изм. | Кол.уч. | Лист | № док. | Подп. | Дата

Модернизация оборудования КИПиА водогрейных котлов ПТВМ-180 ст.№3, ст.№4 | Стадия | Лист | Листов

Схема электрическая se0010: b3X183 | НПП ЭСН

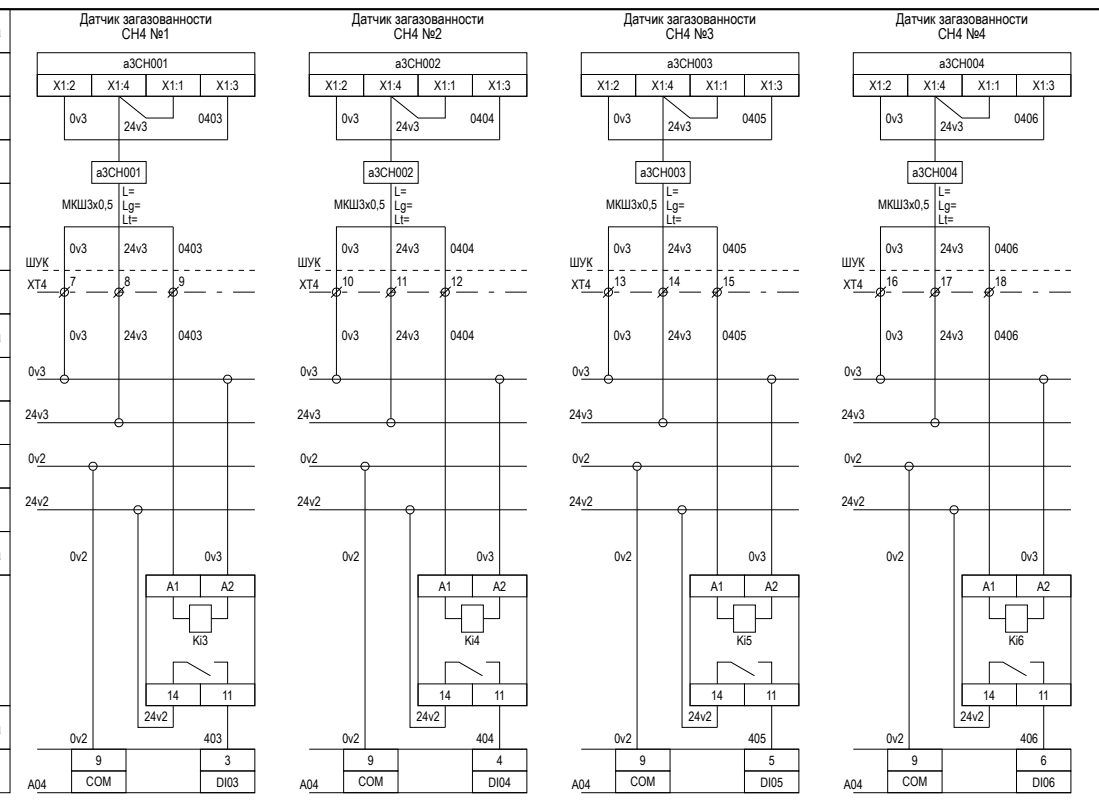
[picture p135: page 35]
Согласовано; Клеммник шкафа; Клеммник модуля ввода; Маркировка провода; Реле; Питание 24В; Ноль 24В; ШУК; 9 COM; Назначение прибора; Датчик загазованности; МКШ3х0,5; Датчик загазованности СН4 №2; Датчик загазованности СН4 №3; Датчик загазованности СН4 №4

Контакт прибора
Маркировка жил
кабеля/провода
Маркировка
Марка, тип, длина
кабеля

Инв. № подп. Подп. и дата Взамен инв. №

Балаковская ТЭЦ-4 филиала «Саратовский» ПАО «Т Плюс»

Изм. | Кол.уч. | Лист | № док. | Подп. | Дата

Модернизация оборудования КИПиА водогрейных котлов ПТВМ-180 ст.№3, ст.№4 | Стадия | Лист | Листов

Схема электрическая se0011: а3СН001, а3СН002, а3СН003, а3СН004 | НПП ЭСН

1 2 3 4 5 6 7 8 9 10 11 12 13 14 15 16 17 18 19 20 21 22 23 24 25 26 27 28

1

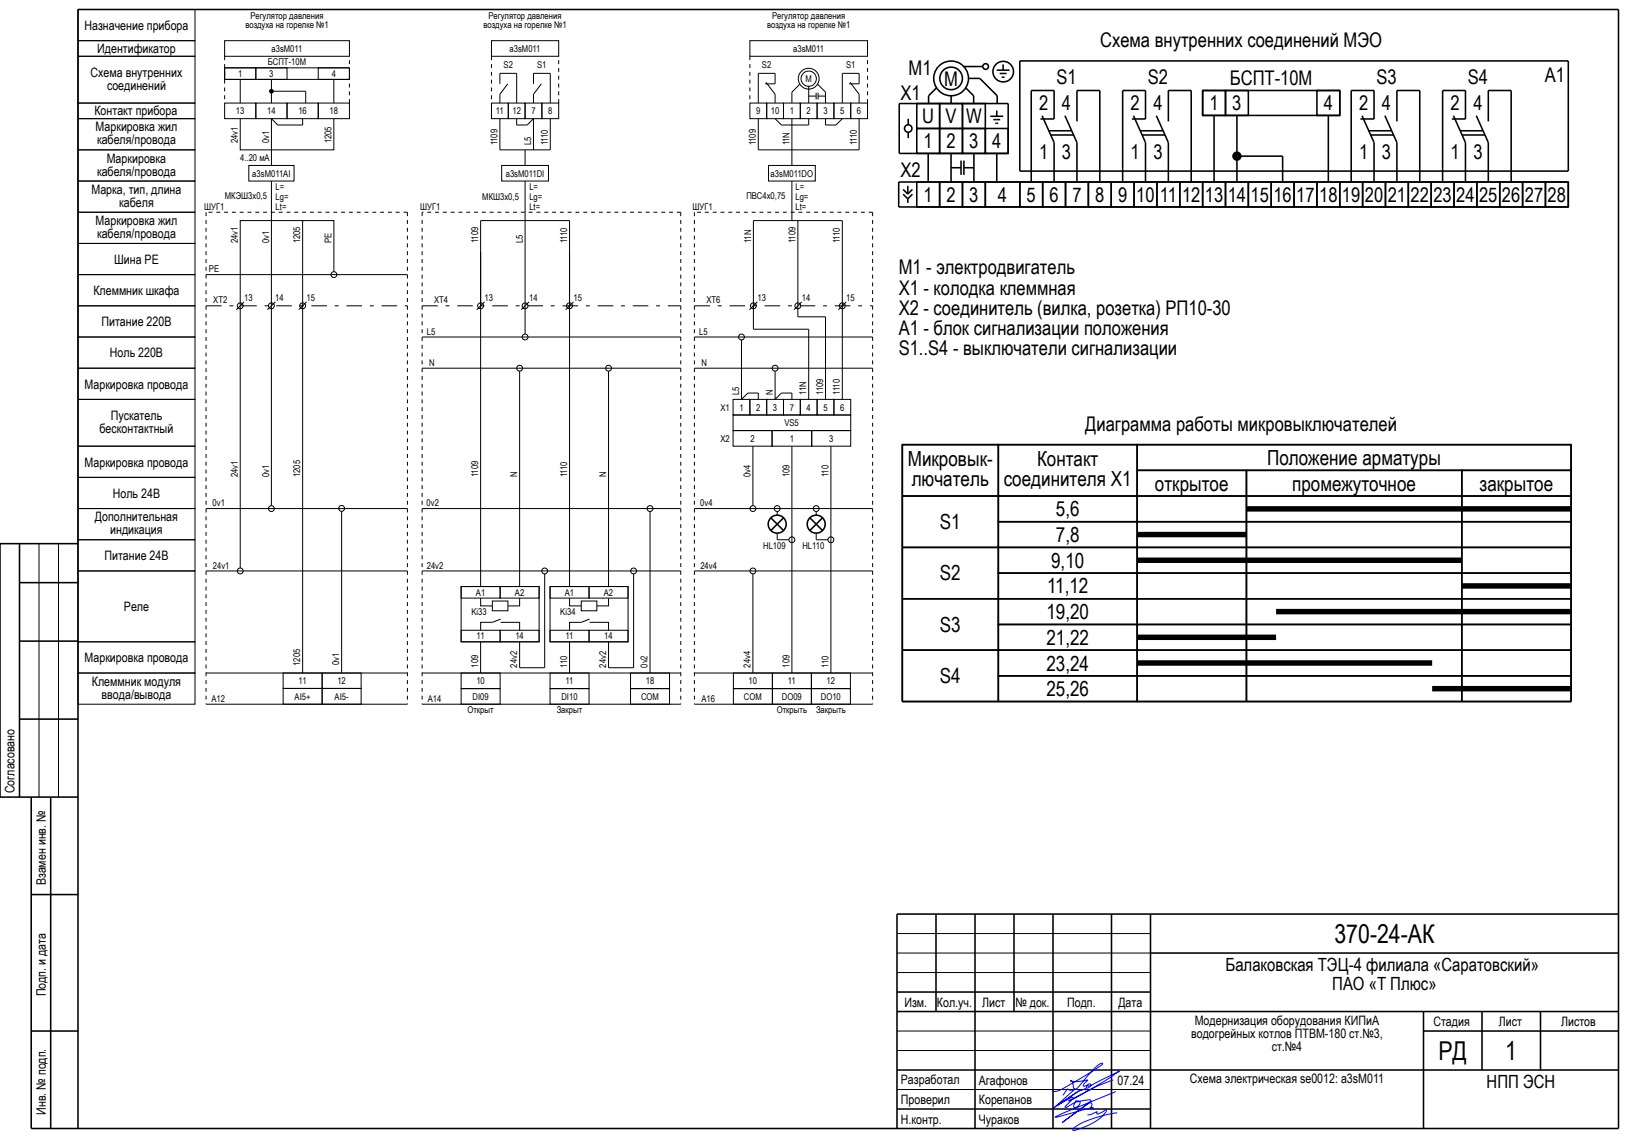
[picture p136: page 36]
Согласовано; Клеммник модуля ввода/вывода; Маркировка провода; Питание 24В; Ноль 24В; Дополнительная индикация; Клеммник шкафа; Пускатель бесконтактный; Реле; Ноль 220В; Питание 220В; ШУГ1; COM; Открыт; Закрыт; Открыть Закрыть; Маркировка кабеля/провода; Маркировка жил кабеля/провода; Контакт прибора; Схема внутренних соединений; Идентификатор; МКЭШ3х0,5; БСПТ-10М; МКШ3х0,5; ПВС4х0,75; Схема внутренних соединений МЭО; Микровык- лючатель; Контакт соединителя Х1; Положение арматуры; открытое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

Регулятор давления
воздуха на горелке №1

Марка, тип, длина
кабеля
Маркировка жил
кабеля/провода
Шина PE

М1 - электродвигатель
Х1 - колодка клеммная
Х2 - соединитель (вилка, розетка) РП10-30
А1 - блок сигнализации положения
S1..S4 - выключатели сигнализации

Инв. № подп. Подп. и дата Взамен инв. №

Балаковская ТЭЦ-4 филиала «Саратовский» ПАО «Т Плюс»

Изм. | Кол.уч. | Лист | № док. | Подп. | Дата

Модернизация оборудования КИПиА водогрейных котлов ПТВМ-180 ст.№3, ст.№4 | Стадия | Лист | Листов

Схема электрическая se0012: а3sM011 | НПП ЭСН

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

1

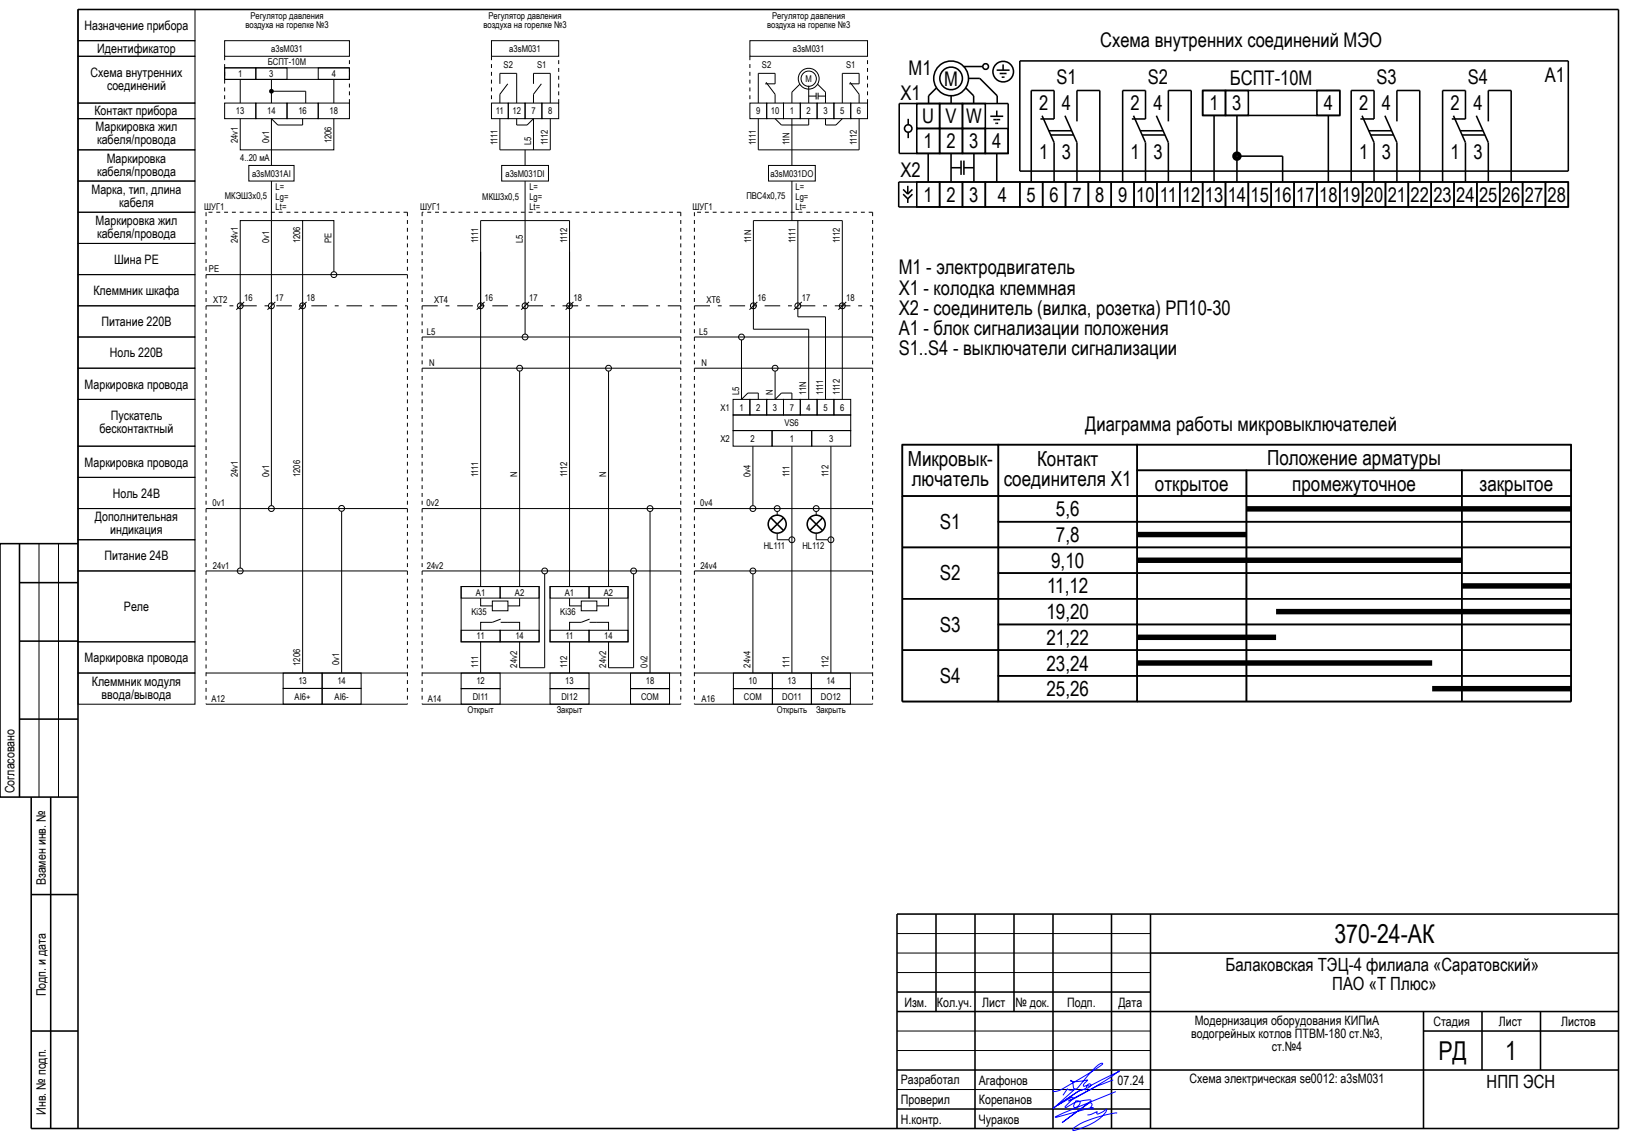
[picture p137: page 37]
Согласовано; Клеммник модуля ввода/вывода; Маркировка провода; Питание 24В; Ноль 24В; Дополнительная индикация; Клеммник шкафа; Пускатель бесконтактный; Шина PE; Реле; Ноль 220В; Питание 220В; ШУГ1; COM; Открыт; Закрыт; Открыть Закрыть; МКЭШ3х0,5; БСПТ-10М; МКШ3х0,5; ПВС4х0,75; Схема внутренних соединений МЭО; Микровык- лючатель; Контакт соединителя Х1; Положение арматуры; открытое; промежуточное; закрытое; Диаграмма работы микровыключателей

Регулятор давления
воздуха на горелке №3

Контакт прибора
Маркировка жил
кабеля/провода
Маркировка
Марка, тип, длина
кабеля

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

Инв. № подп. Подп. и дата Взамен инв. №

Балаковская ТЭЦ-4 филиала «Саратовский» ПАО «Т Плюс»

Изм. | Кол.уч. | Лист | № док. | Подп. | Дата

Модернизация оборудования КИПиА водогрейных котлов ПТВМ-180 ст.№3, ст.№4 | Стадия | Лист | Листов

Схема электрическая se0012: а3sM031 | НПП ЭСН
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
