nppesnteam/370-24_Balakovo_PTVM180_-3-4/370-24_балаково_птвм180n3n4_гс4_310723.pdf

Главный инженер проекта: | Корепанов М.И.

# г. Ижевск

2024г.

# водогрейных котлов ПТВМ-180 ст.№3, ст.№4

# Котел ПТВМ-180 №4. Газоснабжение

# Модернизация оборудования КИПиА

# Балаковская ТЭЦ-4 филиала «Саратовский» ПАО «Т Плюс»

Регистрационный номер 1083 в реестре Ассоциации Саморегулируемой организации"Национальное объединение научно-исследовательских и проектно-изыскательских организаций" (Ассоциация СРО "ЦЕНТРСТРОЙПРОЕКТ") (регистрационный номер в государственном реестре саморегулируемых организаций СРО-П-029-25092009

# РОССИЙСКАЯ ФЕДЕРАЦИЯ

370-24-ГС4

# Рабочая документация

### "ЭНЕРГОСБЕРЕГАЮЩИЕ СИСТЕМЫ И НЕЙРОАВТОМАТИЗАЦИЯ"

г.Ижевск

### Научно-производственное предприятие

### Общество с Ограниченной Ответственностью

## Ведомость рабочих чертежей основного комплекта

Обозначение | Наименование

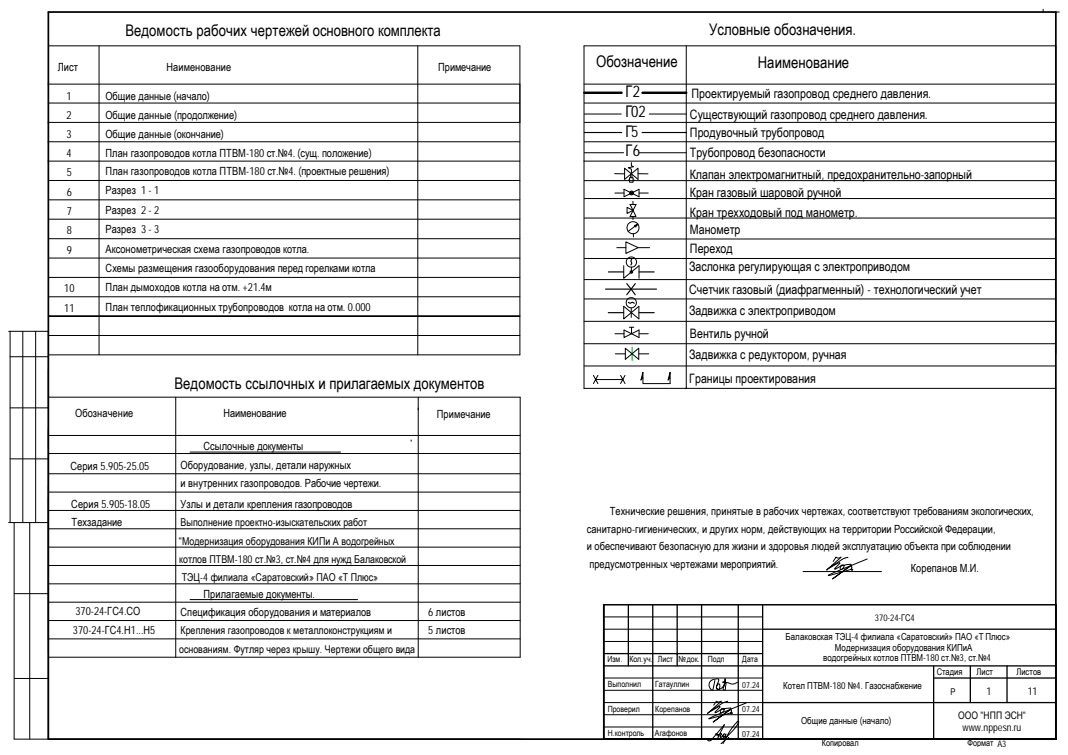
[picture p138: page 2]
5 листов; 6 листов; Проверил; Корепанов; Н.контроль Агафонов; Копировал; Формат A3; предусмотренных чертежами мероприятий.; Корепанов М.И.; План дымоходов котла на отм. +21.4м; План газопроводов котла ПТВМ-180 ст.№4. (сущ. положение); Разрез 1 - 1; Разрез 2 - 2; Лист; Наименование; Примечание; Общие данные (окончание); Общие данные (продолжение); Общие данные (начало); Условные обозначения.

Г2 | Проектируемый газопровод среднего давления.
Г02 | Существующий газопровод среднего давления.
Г5 | Продувочный трубопровод
Г6 | Трубопровод безопасности

План газопроводов котла ПТВМ-180 ст.№4. (проектные решения) | | Клапан электромагнитный, предохранительно-запорный

Кран газовый шаровой ручной
Кран трехходовый под манометр.

Разрез 3 - 3 | Манометр Переход Заслонка регулирующая с электроприводом
Аксонометрическая схема газопроводов котла.
Схемы размещения газооборудования перед горелками котла

Счетчик газовый (диафрагменный) - технологический учет
Задвижка с электроприводом
Вентиль ручной
Задвижка с редуктором, ручная
Границы проектирования

План теплофикационных трубопроводов котла на отм. 0.000

Ведомость ссылочных и прилагаемых документов

Обозначение | Наименование | Примечание

Ссылочные документы

Серия 5.905-25.05 | Оборудование, узлы, детали наружных

и внутренних газопроводов. Рабочие чертежи.

Серия 5.905-18.05 | Узлы и детали крепления газопроводов
Техзадание | Выполнение проектно-изыскательских работ

Технические решения, принятые в рабочих чертежах, соответствуют требованиям экологических,
санитарно-гигиенических, и других норм, действующих на территории Российской Федерации,
и обеспечивают безопасную для жизни и здоровья людей эксплуатацию объекта при соблюдении

"Модернизация оборудования КИПи А водогрейных
котлов ПТВМ-180 ст.№3, ст.№4 для нужд Балаковской
ТЭЦ-4 филиала «Саратовский» ПАО «Т Плюс»
Прилагаемые документы.

Спецификация оборудования и материалов
Крепления газопроводов к металлоконструкциям и
основаниям. Футляр через крышу. Чертежи общего вида

Балаковская ТЭЦ-4 филиала «Саратовский» ПАО «Т Плюс» Модернизация оборудования КИПиА водогрейных котлов ПТВМ-180 ст.№3, ст.№4

Изм. | Кол. уч. Лист | №док. | Подп | Дата

Котел ПТВМ-180 №4. Газоснабжение | | ЛистовЛистСтадия

Выполнил Гатауллин | | 07.24 | | Р | 111

ООО "НПП ЭСН"
www.nppesn.ru

Общие данные (начало)

части трубопроводов по ГОСТ 8966-75, ГОСТ 8968-75, ГОСТ 8969-75. требованиям ГОСТ 5542-2014.

12. Продувочные газопроводы проложить с учетом требований п.6.13 СП 42-101-2003

соединений и сварных стыков должны быть не менее 100 мм.

шаг между опорами должен быть не более 3 м. Расстояния от края опор до фланцевых указаниями на рабочих чертежах. При этом для газопроводов диаметром до DN 100 мм

13. Крепление газопроводов должно производиться на опорах (подвесках) в соответствии с

"Общие положения по проектированию и строительству газораспределительных систем из металлических и полиэтиленовых труб".

Общие данные (продолжение) | www.nppesn.ru Н.контроль | Агафонов | 07.24
Копировал | Формат A3

07.24

Проверил | Корепанов
Изм. | Кол. уч. | №док. | Подп | ДатаЛист
| | | Котел ПТВМ-180 №4. Газоснабжение | | | ЛистовЛистСтадия
Выполнил | Гатауллин | 07.24 | | Р | 2

370-24-ГС4
Балаковская ТЭЦ-4 филиала «Саратовский» ПАО «Т Плюс» Модернизация оборудования КИПиА водогрейных котлов ПТВМ-180 ст.№3, ст.№4

с СП 42-102-2004 взамен, указанных в спецификации.

соответствовать требованиям ГОСТ 16037-80.

в соответствии с требованиями СП 62.13330.2011 Газораспределительные системы.

соединения газопроводов в объеме 100%. Объем контроля физическими методами

10.Визуальному и измерительному контролю и испытаниям подлежат все сварные

11. Газопроводы диаметром DN 50 мм и менее проложить по месту, а запорную арматуру, расположенную на этих газопроводах, расположить в местах, удобных
9. Для сварки газопроводов применять электроды типа

Э 46,

Э 46А ГОСТ 9466-75.

для обслуживания.

ГОСТ 6465-76 желтого цвета по грунтовке ГФ-021 ГОСТ 25129-82 с последующим

7. После монтажа и проведения испытаний газопроводы покрыть эмалью ПФ-115

нанесением предупреждающих колец эмалью красного цвета.
Количество колец и расстояние между ними должны соответствовать требованиям
8. Типы и конструктивные параметры сварных соединений газопроводов должны

ГОСТ 14202-69.

применения и исполнения Технического регламента о безопасности сетей

из металлических труб, а также другим нормативным документам, необходимым для и полиэтиленовых труб, СП 42-102-2004 Проектирование и строительство газопроводов по проектированию и строительству газораспределительных систем из металлических актуализированной редакции СНиП 42-01-2002, СП 42-101-2003 Общие положения

6. Допускается использование труб, разрешенных к применению в соответствии газораспределения и газопотребления.

газопотребления, требованиям СП 62.13330.2011 Газораспределительные системы, и газопотребления, Правилам безопасности сетей газораспределения и требованиям Технического регламента о безопасности сетей газораспределения

5. Правила производства работ, приемки и испытаний должны соответствовать метичность затвора запорной арматуры на газопроводах должна быть не ниже
4. Герметичность затвора всех ПЗК должна соответствовать класу "А", а гер-

класса "В" ГОСТ Р 54809.2011.

Эксплуатирующая организация: филиал АО "РИР", г.Москва

Основные показатели сети газопотребления

Наименование помещения | Объем, м3 | Наименование агрегата | Кол. | Расход газа, м /ч 3 | Давление газа | Приме-чание
| на котел | перед котлом,кПа на горелку
| | | | паспорт) | (по нагрузке)(
Котельный зал | ------ | ПТВМ-180 | 1 | | | 801067 | 20 21340 горелок
| | ст.№ 4
19. Сведения об ОПО: Адрес расположения Удмуртская Республика, г.Глазов, ул. Белова, д.7

пристроенное, расположено в корпусе 4/Т, пристроенное к корпусу 1/Т.

класс опасности – III (опасный производственный объект средней опасности). Помещение котельной более 115 градусов Цельсия. Сама площадка главного корпуса, согласно свидетельству ОПО имеет работающего под избыточным давлением более 0,07 мегапаскаля: для воды при температуре нагрева на котел ПТВМ-100 ст.№16 (расположенный в корпусе 1/Т) -2.2 т.е использование оборудования,

«Площадка главного корпуса ТЭЦ», числовое обозначение признака опасности

Регистрационный номер: Р 01-00120-0006

- контролю физическими методами, согласно - п. 10.4.1, Таблица 14*
- испытания на прочность и герметичность согласно - п. 10.5.7, Таблица 16*

Испытания газопроводов и контроль качества работ производить в соответствии с СП 62.13330.2011 "Газораспределительные системы"

18. Нормы испытательных давлений:

-техническое задание (приложение к договору); -результаты обмерных работ, фото и видеоматериалы.

3. Качество газа, применяемого в виде топлива, должно соответствовать

вают мероприятия, обеспечивающие взрывную, взрывопожарную и пожарную безо-вилами, стандартами, техническими условиями на присоединение и предусматри-

2. Рабочие чертежи разработаны в соответствии с действующими нормами, пра-

пасность при эксплуатации здания (сооружения).

1. Исходными данными для разработки рабочих чертежей марки ГС являются - договор;

ОБЩИЕ УКАЗАНИЯ

которых изготовлены эти участки, а также имеются положительные результаты

17. Для присоединения муфтовой арматуры должны применяться соединительные
16. Крепление продувочных газопроводов, и трубопроводов безопасности производится к существующим металлоконструкциям колонн, балок и существующим опорам газопроводов.
15. Продувочные газопроводы должны иметь минимальное количество поворотов
и выводиться за пределы здания не менее чем на 1 м выше карниза крыши.

их диагностики.

14. Допускается использование существующих участков газопроводов, фасонных деталей и опор под ними, если имеются в наличии сертификаты на материалы, из

Трубопроводы безопасности котла (левая и правая сторона) объединяются и выводятся из котельной (через отверстие в кровле, рядом с объединенным продувочным) на высоту не менее 1.0м выше кровли помещения котельного цеха. Прокладку этих трубопроводов (внутри котельной) выполнить с креплением к существующим металлоконструкциям опор котла и перекрытия здания. Используемая арматура и оборудование на газопроводах обвязки котла -класса герметичности "А".
Все газопроводы, продувочные трубопроводы и токоведущие части оборудования котельной присоединить к контуру заземления.
При прокладке газопровода через кровлю котельной предусмотрены футляры с заделкой пространства между газопроводом и футляром (см. чертежи 370-24-ГС4.Н1)
Для регулировки системы дымоудаления, в верхней части котла производится замена МЭО заслонок дымоходов, прямоугольного сечения.
Для обслуживания общекотлового оборудования газопровода Dу400, в месте присоединения и от подъема после узла присоединения - в месте установки технологического учета газа, используются существующие площадки, высотой +2,3 и +3.0м м от ур.ч.пола. (+8.000).
Подвод сжатого воздуха для продувки и опрессовки газопроводов предусматривается от существующей системы подачи сжатого воздуха.
Работа котельной предусматривается в автоматическом режиме с постоянно обслуживающим персоналом.
Электроды и сварочную проволоку подбирать в соответствии с маркой свариваемой стали и технологией сварки.
Организации, осуществляющей строительство газопровода, обеспечить контроль производства работ на всех стадиях (руководителями, специалистами и персоналом лабораторий) в установленном порядке.

После монтажа и испытаний газопроводы очистить от ржавчины и грязи, покрыть эмалью ПФ-115 желтого цвета в два слоя по слою грунтовки ГФ-021
Устанавливаемое газовое оборудование и трубопроводная арматура примененное в проекте имеет документацию подтверждающее ее соответствие требованиям Технического регламента Таможенного союза "О безопасности машин и оборудования" ТР ТС 010/2011.
Срок эксплуатации проектируемых внутренних участков газопроводов - 30 лет, проектируемого газооборудования - согласно паспортов заводов-производителей.

Существующее положение:
В котельном цехе КТЦ Балаковской ТЭЦ-4 филиала «Саратовский» ПАО «Т Плюс», предусматривается модернизация оборудования КИПиА водогрейных котлов ПТВМ-180 ст.№3, ст.№4.
Данным разделом рабочей документации рассматривается вновь устанавливаемое газооборудование котла ПТВМ-180 ст.№4.
Завод изготовитель котла – Белгородский котельный завод, дата ввода
в эксплуатацию – 1980г., инвентарный номер - №053400040585, заводской номер – ???. Топливопроводы на котле отсутствуют.
Горелки котла МГМГ-10, в количестве – 20шт., остаются на месте (без изменений) Демонтируется существующая система газопотребления от существующей газовой задвижки с ручным приводом, в котельном цехе, до горелок котла.
Для регулирования подачи воздуха от 20 существующих вентиляторов на воздуховодах к горелкам установлены регулирующие заслонки, их исполнительные механизмы (МЭО) при этом заменяются см.АК.
Тепловая производительность котла: 180 Гкал/час.
Максимальное КПД котла: 93.3%
УРУТ на выработку тепла:150 кгут/Гкал.
Котел работает в отопительный период в основном режиме по двухходовой схеме.
Рабочей документацией определены следующие решения по газоснабжению котла природным газом,
От места присоединения - газопровод проложен открыто с подъемом вверх на отм. +11,8м. от места присоединения на отм. +10.600м.
Для обеспечения безопасной эксплуатации и регулирования на подводящем газопроводе к котлу ПТВМ-180 ст.№4, в месте присоединения (на уровне +10.6м), последовательно устанавливается общие для котла:
- Задвижка с электроприводом dу400
- Заглушка кольцо, поворотная dу400
На отм. + 11.8м:
- Диафрагменный расходомер (технологический учет газа) с прямыми участками dу400
- Общая на котел регулирующая заслонка dу300 с электроприводом

После подводящий газовый коллектор dу400, поднимается вверх на отметку +15.1м от ур.ч.пола и прокладывается до фронта котла с креплением к его стальной колонне. От коллектора, на том же уровне, выполнены два ответвления к горелкам на левую и правую сторону диаметрами 325х6 - каждое.
На ответвлениях запроектированы газовые подводки диаметром 108х4 на все 20 горелок. Подводки к горелкам, включают в себя следущее газовое оборудование:
- Два предохранительно-запорных клапана (нормально закрытых) - ВН4Н-1П ст.
- Регулирующую газовую заслонку ЗД-100 с электроприводом
- Автоматический клапан утечки (нормально открытый) ВФ1Н-4 ст. для газопровода безопасности (расположен между двумя ПЗК) и соединен с атмосферой
- Запорная арматура и КИП
- Для росжига шести растопочных горелок котла с запально -защитными устройствами предусматрен подвод газопроводов dу20 с установленными на них муфтовыми электроманитными клапанами ВН 3/4Н-4 ст.
- На продувочных газопроводах котла (от коллектора котла) - предусмотрена установка автоматических электромагнитных клапанов ВН2Н-1П ст.
Копировал | Формат A3

Котел ПТВМ-180 №4. Газоснабжение

Общие данные (окончание)

07.24

Проверил | Корепанов
Н.контроль | Агафонов

Выполнил

Гатауллин

Изм. | Кол. уч. | Лист | №док. | Подп | Дата

3

Стадия | Лист | Листов

Р

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

ОБЩИЕ УКАЗАНИЯ (окончание)

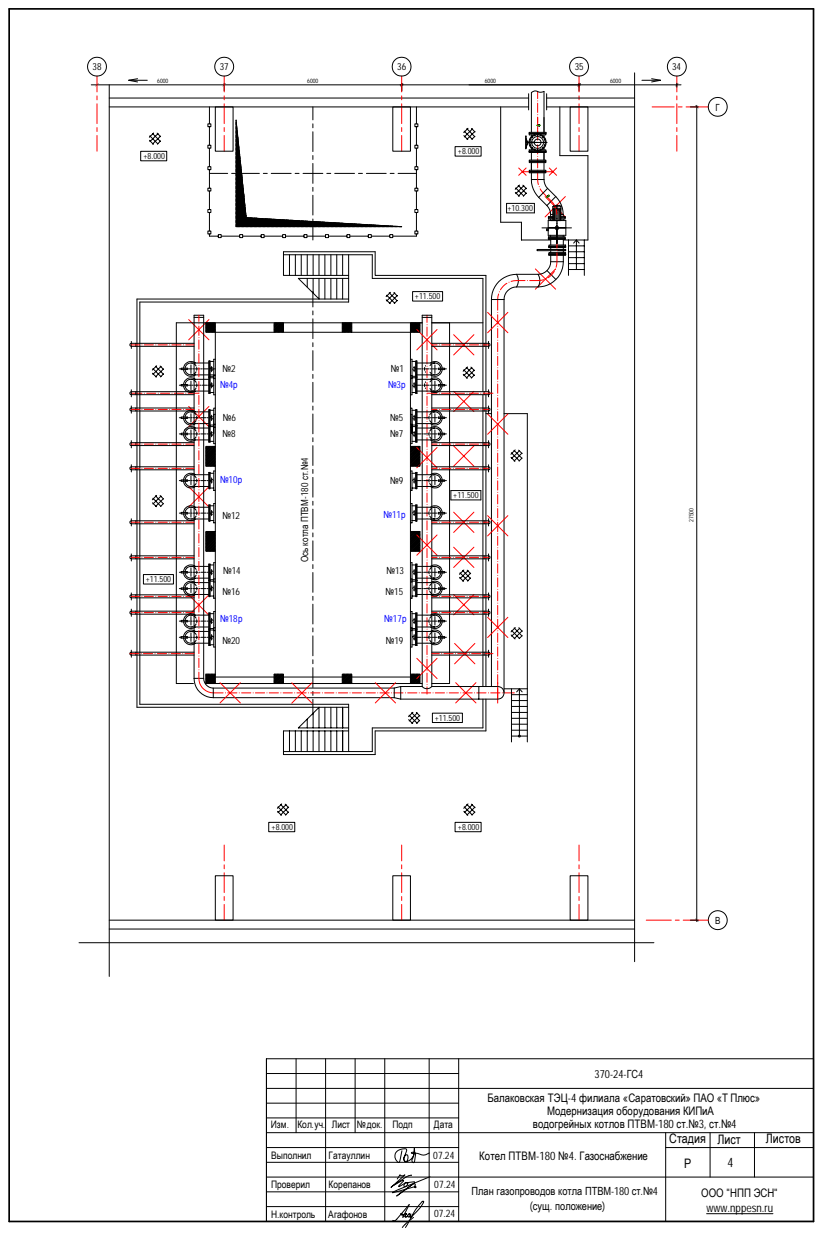
[picture p139: page 5]
Проверил; Корепанов; План газопроводов котла ПТВМ-180 ст.№4; Н.контроль Агафонов; (сущ. положение); www.nppesn.ru; Ось котла; ТВМ-180 ст.№

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

Изм. | Кол. уч. Лист | №док. | Подп | Дата
Выполнил Гатауллин | | 07.24 | Котел ПТВМ-180 №4. Газоснабжение | Стадия Лист Листов

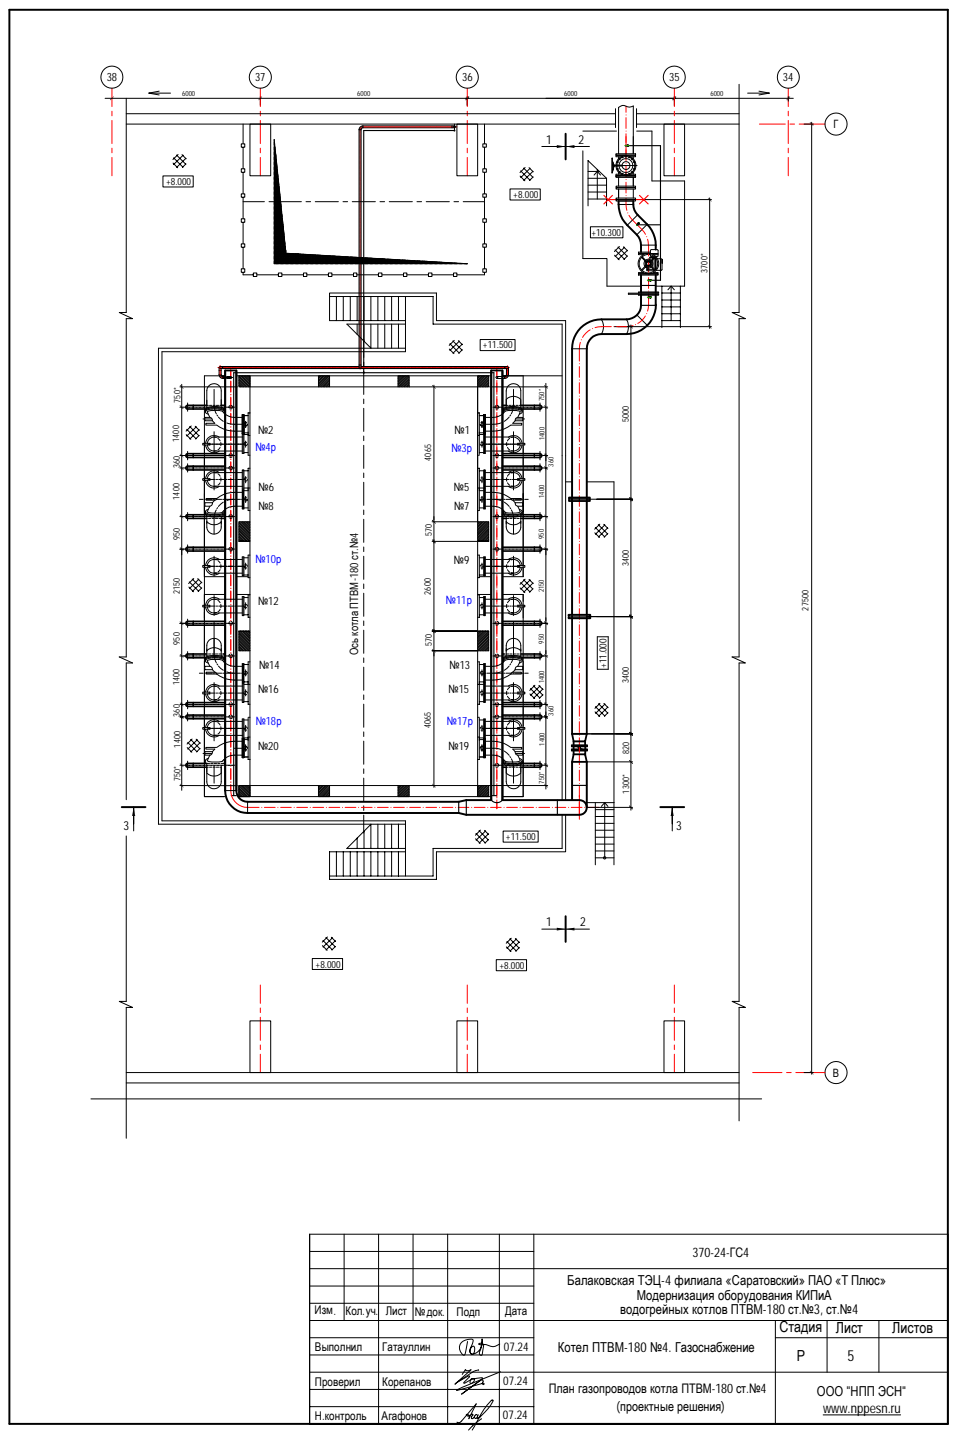
[picture p140: page 6]
(проектные решения); Проверил; Корепанов; Н.контроль; Агафонов; Ось котла; ТВМ-180 ст.№

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

Изм. | Кол. уч. | Лист | №док. | Подп | Дата

Котел ПТВМ-180 №4. Газоснабжение | Стадия Лист Листов

Выполнил | Гатауллин | | 07.24 | | Р 5

План газопроводов котла ПТВМ-180 ст.№4

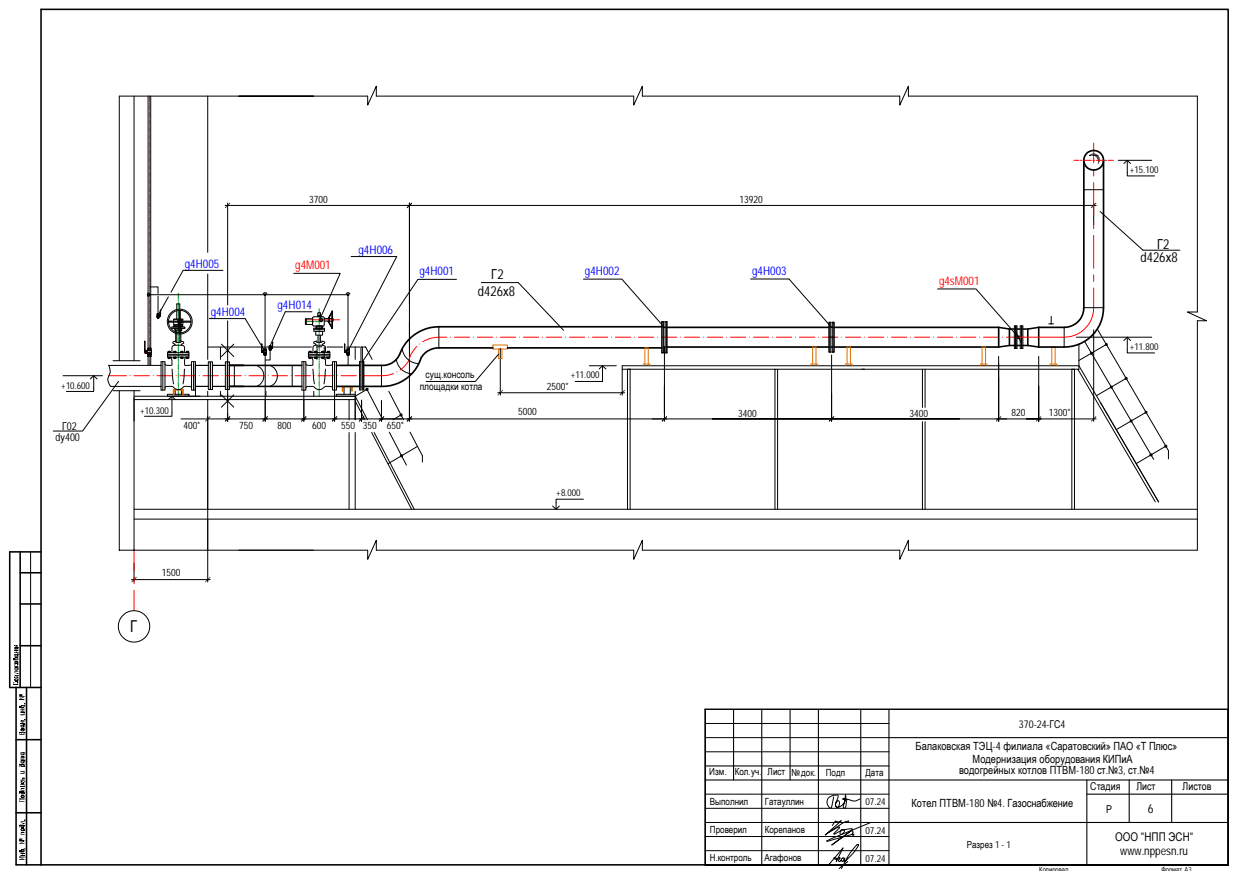
[picture p141: page 7]
Корепанов; Агафонов; Проверил; Н.контроль; Разрез 1 - 1; Копировал; Формат A3; площадки котла; сущ.консоль

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

Изм. | Кол. уч. Лист | №док. | Подп | Дата
Котел ПТВМ-180 №4. Газоснабжение | Стадия | | ЛистовЛист
Выполнил Гатауллин | | 07.24 | | Р | 6

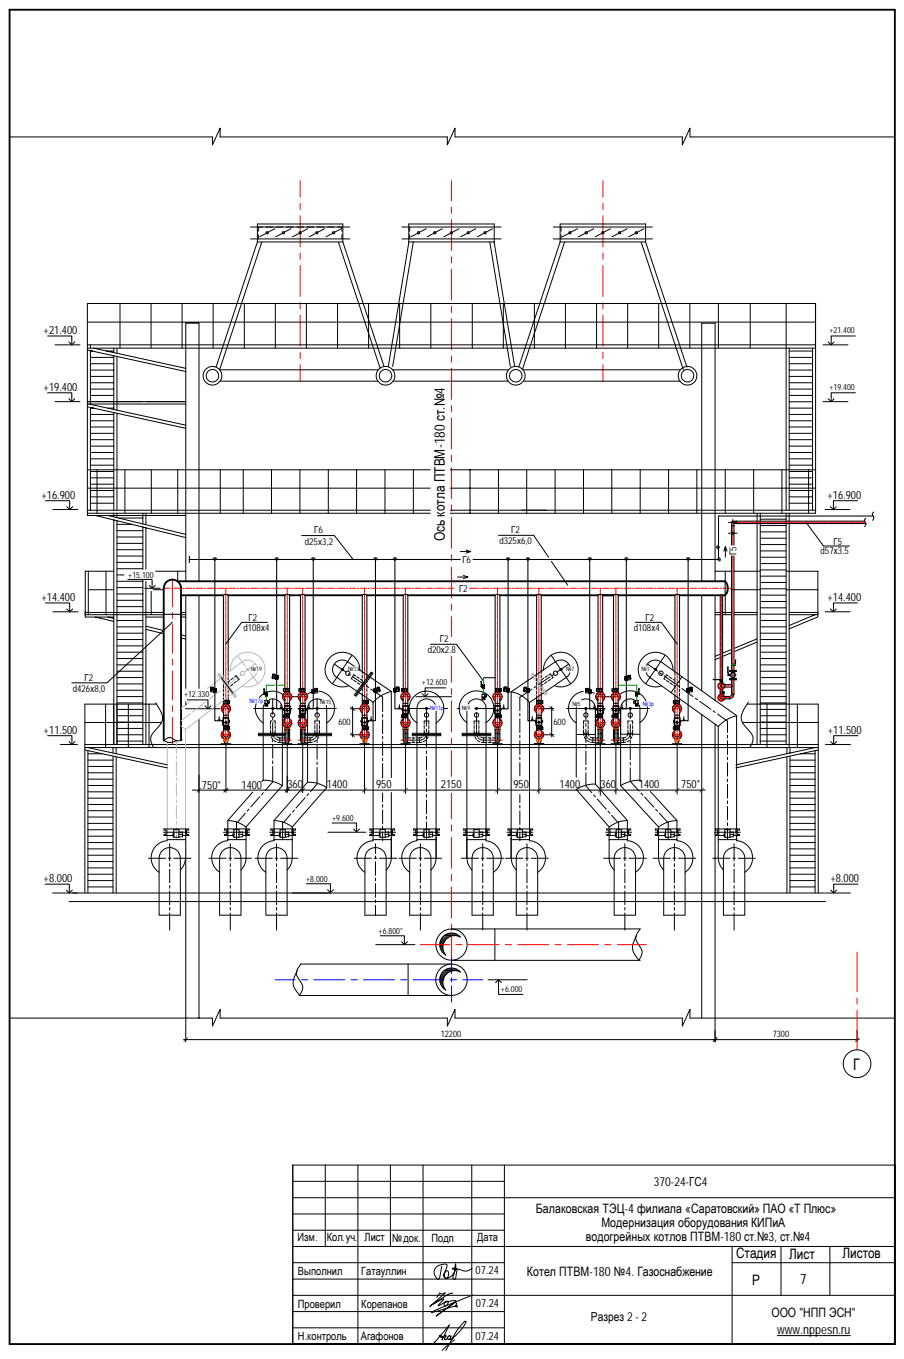
[picture p142: page 8]
Н.контроль Агафонов; Проверил; Корепанов; Разрез 2 - 2; Ось ко

тла ПТВМ-180 ст.№

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

Изм. Кол. уч. Лист №док. | Подп | Дата
Котел ПТВМ-180 №4. Газоснабжение | Стадия | Лист | Листов
Выполнил Гатауллин | | | | Р | 7

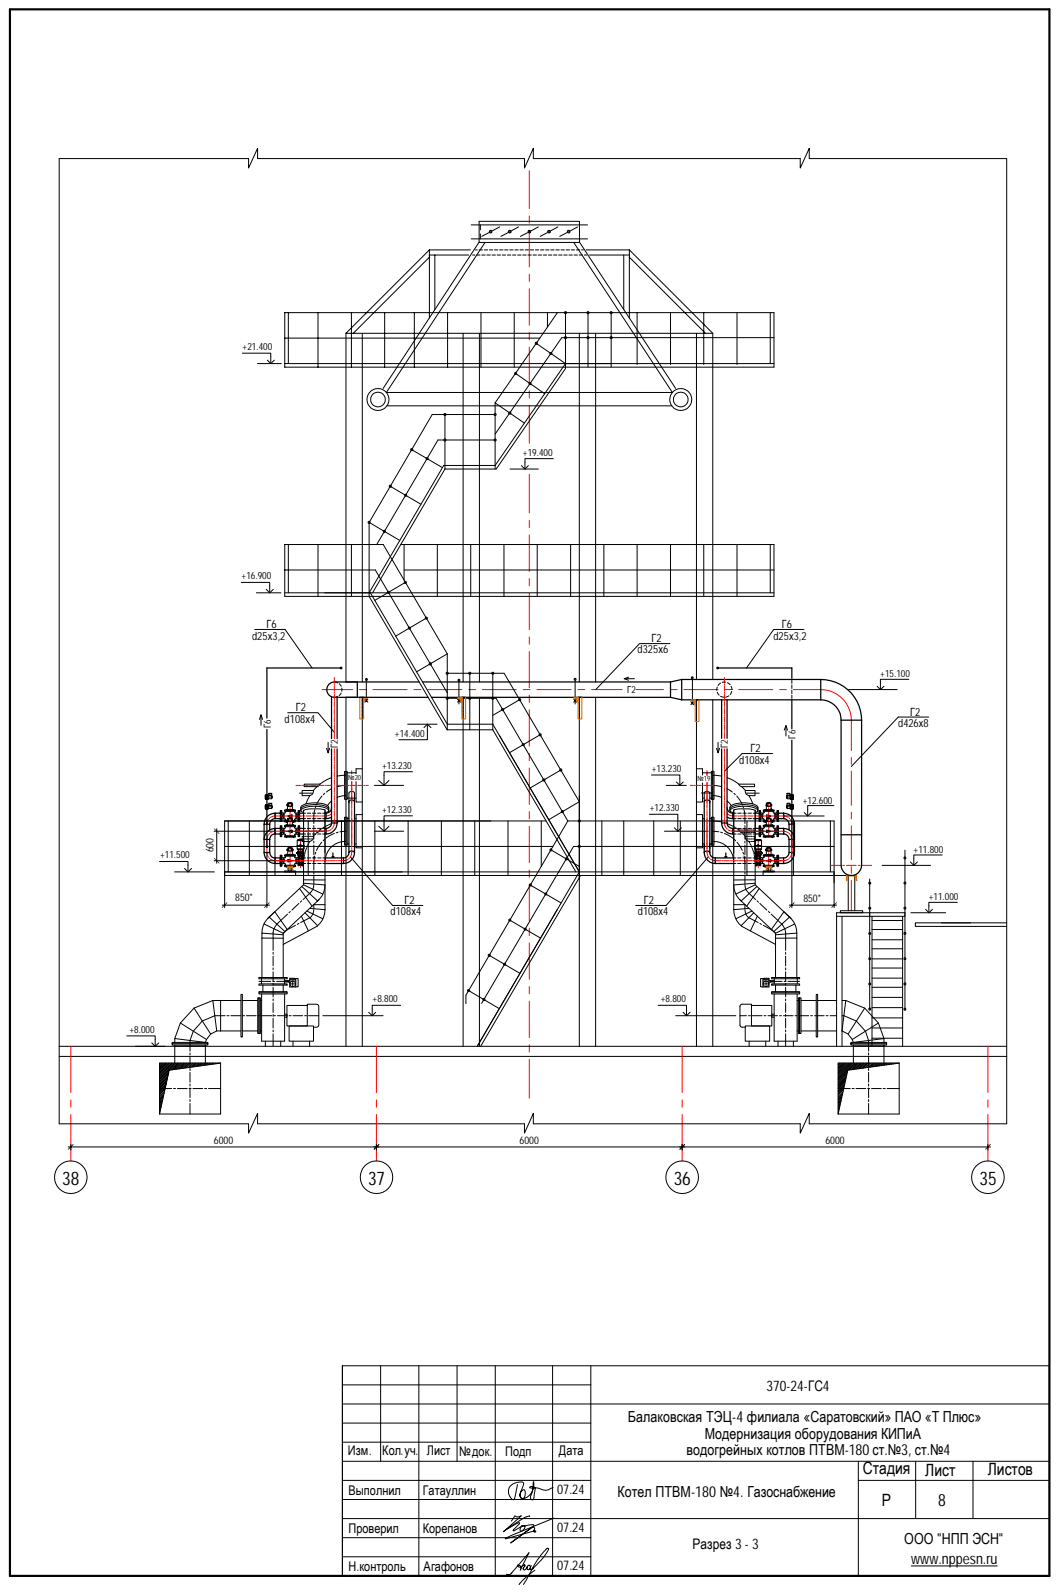
[picture p143: page 9]
Агафонов; Корепанов; Н.контроль; Проверил; Разрез 3 - 3

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

Изм. Кол. уч. | №док. Лист | Подп | Дата

Котел ПТВМ-180 №4. Газоснабжение | Стадия Лист Листов

Выполнил | Гатауллин | | | | Р 8

## Узел I

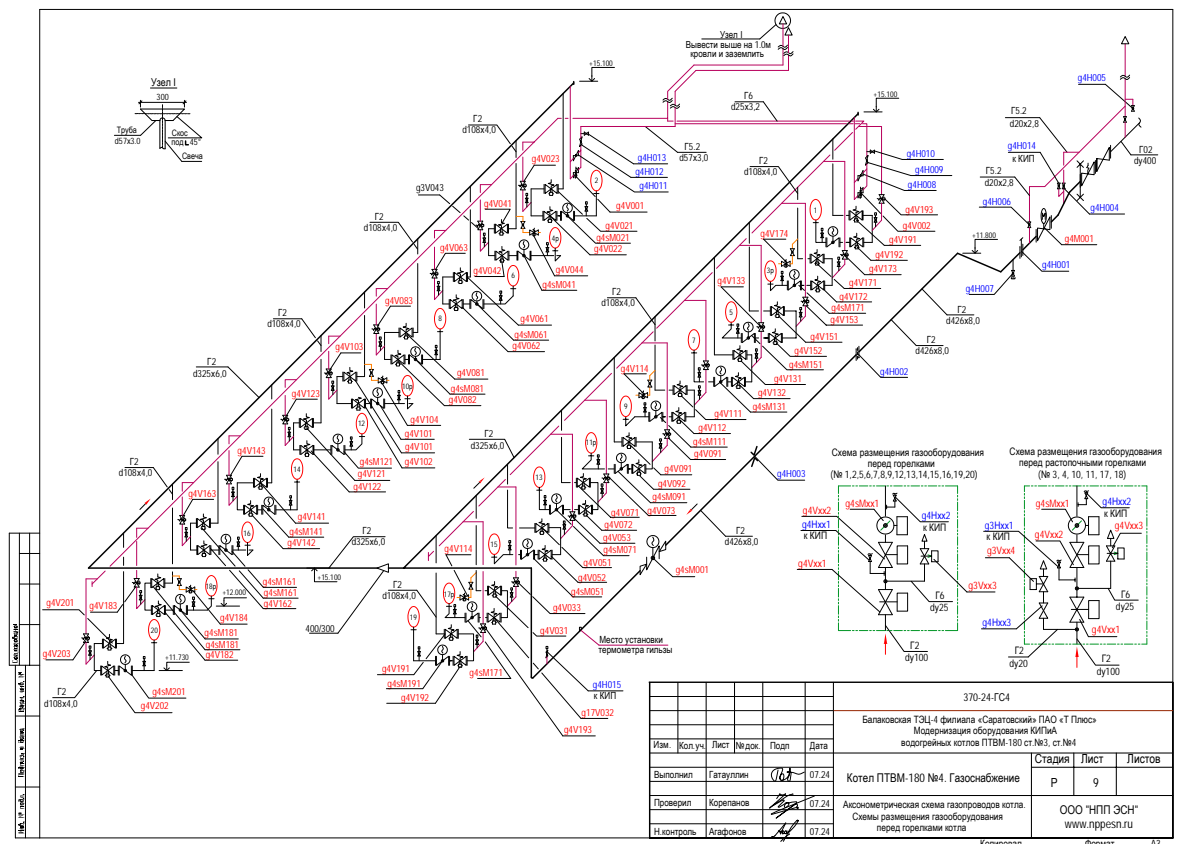
[picture p144: page 10]
g4sM081 ¹⁰р; Свеча; под 45°; Скос Труба; g4Нхх1; g3Нхх1 g4V072; к КИП; g4Vхх3 g4Vхх2; Т Плюс»; Котел ПТВМ-180; №4. Газоснабжение; .контроль; АгафоновН; Корепанов; док.; Проверил; Изм.; Кол. уч.; Лист; Копировал; Формат; ЛистовЛист; Стадия; термометра гильзы; Место установки g4V031; g4Vхх1; g4Нхх3; g3Vхх3; к КИП g3Vхх4; g4sMхх1 g4Vхх2; g4Нхх2; перед горелками; g4sMхх1; к КИП g4Нхх2; кровли и заземлить; Узел I

Вывести выше на 1.0м

Схема размещения газооборудования

перед растопочными горелками

Балаковская ТЭЦ-4 филиала «Саратовский» ПАО «

Модернизация оборудования КИПиА
водогрейных котлов ПТВМ-180 ст.№3, ст.№

Подп | Дата

Выполнил | Гатауллин | | 07.24

Аксонометрическая схема газопроводов котла.
Схемы размещения газооборудования
перед горелками котла

38

37

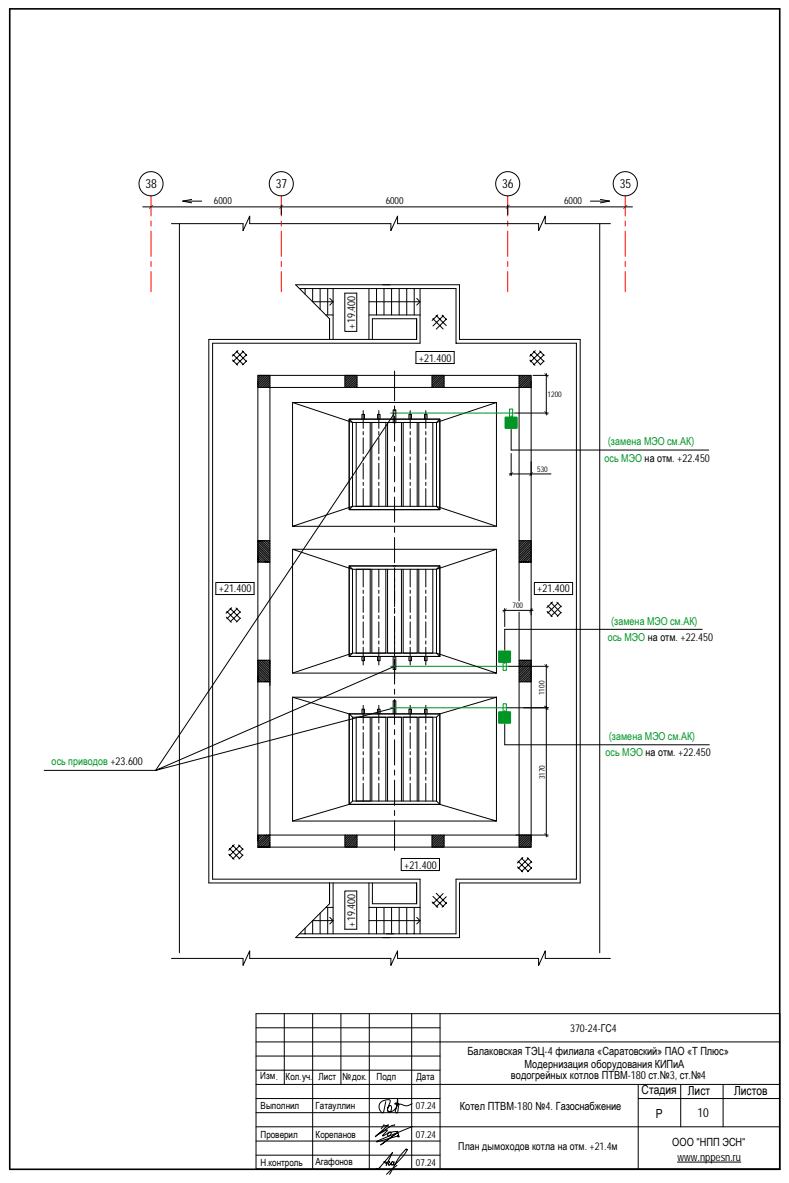
[picture p145: page 11]
Н.контроль; ось приводов +23.600; Агафонов; www.nppesn.ru

(замена МЭО см.АК)
ось МЭО на отм. +22.450

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

Изм . | Кол. уч. | Лист | №док. | Подп | Дата

Котел ПТВМ-180 №4. Газоснабжение | Стадия Лист Листов

Выполнил | Гатауллин | | | | Р 10

Проверил | Корепанов

ООО "НПП ЭСН" План дымоходов котла на отм. +21.4м

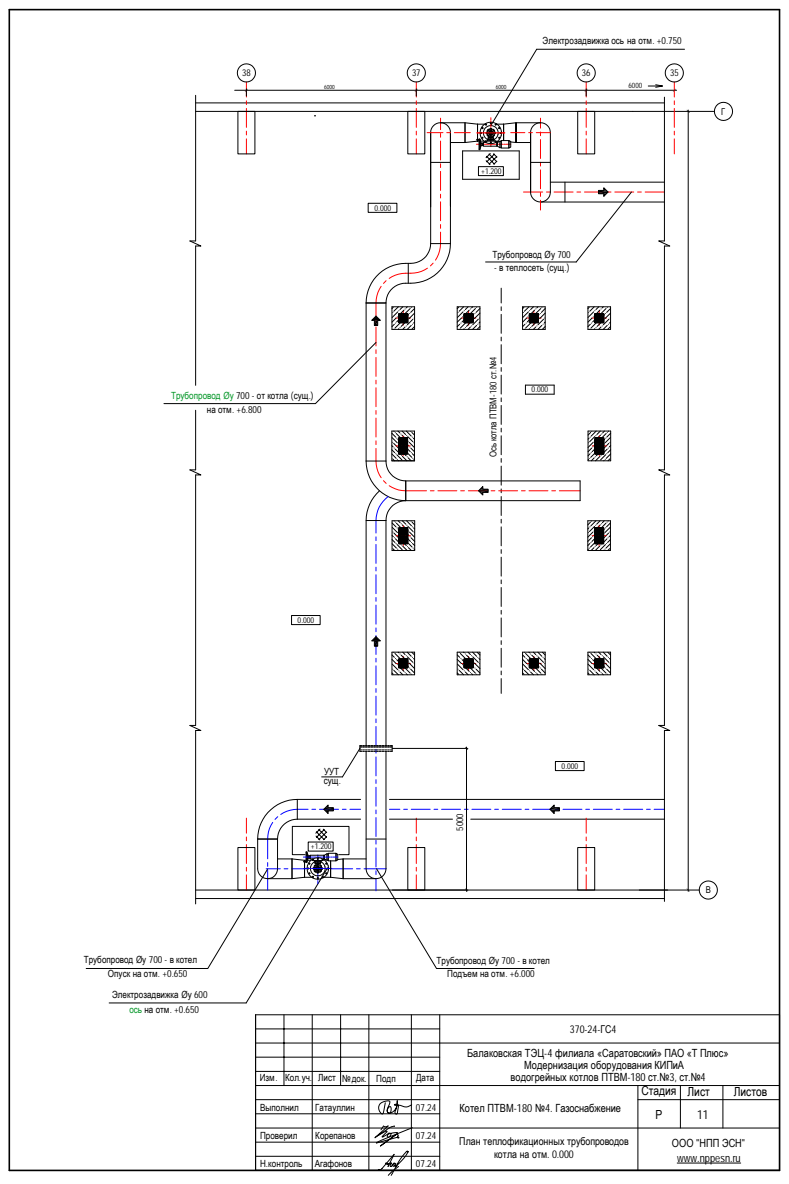
[picture p146: page 12]
Корепанов; Н.контроль; Проверил; Агафонов; Трубопровод Øу; в котел; сущ.; УУТ; на отм. +6.800; Ось котла; ТВМ-180 ст.№; - в теплосеть (сущ.); Трубопровод

Электрозадвижка ось на отм

Трубопровод Øу 700 - от котла (сущ.)

Трубопровод Øу 700 - в котел
Опуск на отм. +0.650
Электрозадвижка Øу 600
ось на отм. +0.650

Подъем на отм

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

Изм. | Кол. уч. Лист | № док. | Подп | Дата

Котел ПТВМ-180 №4. Газоснабжение | Стадия | Лист | Листов

Выполнил Гатауллин | | 07.24 | | Р | 11

План теплофикационных трубопроводов
котла на отм. 0.000

| Газовое оборудование на группу горелок:
g4V011 | Клапан ПЗК1 сталь., эл.магн., "НЗ", фланц. Ду100, Ру-0,6 МПа (с КОФ) на горелке №1 | ВН4Н-1П ст | СП Термобрест | компл | 1 | в составе ПАК, см. АК
g4V021 | Клапан ПЗК1 сталь., эл.магн., "НЗ", фланц. Ду100, Ру-0,6 МПа (с КОФ) на горелке №2 | ВН4Н-1П ст | СП Термобрест | компл | 1 | в составе ПАК, см. АК
| Клапан ПЗК1 сталь., эл.магн., "НЗ", фланц. Ду100, Ру-0,6 МПа (с КОФ) на горелке №3 g4V031 | ВН4Н-1П ст | СП Термобрест | компл | 1 | в составе ПАК, см. АК
g4V041 | Клапан ПЗК1 сталь., эл.магн., "НЗ", фланц. Ду100, Ру-0,6 МПа (с КОФ) на горелке №4 | ВН4Н-1П ст | СП Термобрест | компл | 1 | в составе ПАК, см. АК
g4V051 | Клапан ПЗК1 сталь., эл.магн., "НЗ", фланц. Ду100, Ру-0,6 МПа (с КОФ) на горелке №5 | ВН4Н-1П ст | СП Термобрест | компл | 1 | в составе ПАК, см. АК
g4V061 | Клапан ПЗК1 сталь., эл.магн., "НЗ", фланц. Ду100, Ру-0,6 МПа (с КОФ) на горелке №6 | ВН4Н-1П ст | СП Термобрест | компл | 1 | в составе ПАК, см. АК
g4V071 | Клапан ПЗК1 сталь., эл.магн., "НЗ", фланц. Ду100, Ру-0,6 МПа (с КОФ) на горелке №7 | ВН4Н-1П ст | СП Термобрест | компл | 1 | в составе ПАК, см. АК
g4V081 | Клапан ПЗК1 сталь., эл.магн., "НЗ", фланц. Ду100, Ру-0,6 МПа (с КОФ) на горелке №8 | ВН4Н-1П ст | СП Термобрест | компл | 1 | в составе ПАК, см. АК
g4V091 | Клапан ПЗК1 сталь., эл.магн., "НЗ", фланц. Ду100, Ру-0,6 МПа (с КОФ) на горелке №9 | ВН4Н-1П ст | СП Термобрест | компл | 1 | в составе ПАК, см. АК
g4V101 | Клапан ПЗК1 сталь., эл.магн., "НЗ", фланц. Ду100, Ру-0,6 МПа (с КОФ) на горелке №10 | ВН4Н-1П ст | СП Термобрест | компл | 1 | в составе ПАК, см. АК
g4V111 | Клапан ПЗК1 сталь., эл.магн., "НЗ", фланц. Ду100, Ру-0,6 МПа (с КОФ) на горелке №11 | ВН4Н-1П ст | СП Термобрест | компл | 1 | в составе ПАК, см. АК
g4V121 | Клапан ПЗК1 сталь., эл.магн., "НЗ", фланц. Ду100, Ру-0,6 МПа (с КОФ) на горелке №12 | ВН4Н-1П ст | СП Термобрест | компл | 1 | в составе ПАК, см. АК
Позиция | Наименование и техническая характеристика | Тип, марка, обозначение документа, опросного листа | Код оборудования, изделия, материала | | Единица изме-рения | Коли-чество | единицы, кг Завод-изготовитель | Примечание Масса
1 | 2 | 3 | 4 8 | 5 6 | | 7 9
| Общекотловое газовое оборудование:
g4M001 | Задвижка стальная клиновая фланцевая (с КОФ) общекотловая Dу 400 мм Pу 1,6 МПа с эл.приводом | 30с 941нж | | Южноураларматура, Миасс | компл | 1 | | в составе ПАК, см. АК
g4sM001 | Заслонка общекотловая стальная фланцевая (с КОФ) общекотловая Dу 150 мм Pу 0,6 МПа с эл.прив. | ЗР12-6В ПР ст. | | СП Термобрест | компл | 1 | | в составе ПАК, см. АК
g4V001(002) | Клапан стальной газовый НЗ Dу 50 мм, фланцевый (с КОФ), для продувки газопровода из тупика | ВН2Н-6Пст.фл | | СП Термобрест | компл | 2 | | в составе ПАК, см. АК
g4H001 | Заглушка-кольцо поворотная стальная Ду400 | АТК 26 -16-5-93, исп.1 | | Заречный Мехзавод, МО | шт | 1
g4H002 | Устройство подготовки потока УПП "Zаnker" с монтажным кольцом КМ-0,6-400-СГ | УПП-Д-400-А | | Сигнум, Пермь | компл | 1
g4H003 | Сужающее устройство в камерной диафрагме Ду200, межфланцевое (с КОФ) | ДКС-200-0,6-А/Б | | Сигнум, Пермь | компл | 1
g4H004 | Кран продувочный перед общей электрозадвижкой | КШЦМ Gas 020.040.Н/П.02 | | Челябинскспецгражданстрой | шт | 1
g4H005 | Кран отбора проб для продувки до и после электрозадвижки | КШЦМ Gas 020.040.Н/П.02 | | Челябинскспецгражданстрой | шт | 1
g4H006 | Кран продувочный после общей электрозадвижки | КШЦМ Gas 020.040.Н/П.02 | | Челябинскспецгражданстрой | шт | 1
g4H007 | Кран для продувки воздухом | КШЦМ Gas 020.040.Н/П.02 | | Челябинскспецгражданстрой | шт | 1
g4H008(011) | Кран продувочный в тупике коллектора в обход эл.клапана | КШ.Ц.Ф.GAS.050.040.Н/П.02 | | Челябинскспецгражданстрой | компл. | 2 | | в компл. с КОФ
g4H009(012) | Кран продувочный в тупике коллектора общий на тупик | КШ.Ц.Ф.GAS.050.040.Н/П.02 | | Челябинскспецгражданстрой | компл. | 2 | | в компл. с КОФ
g4H010(13) | Кран отбора проб для продувки в тупике коллектора | КШЦМ Gas 020.040.Н/П.02 | | Челябинскспецгражданстрой | компл. | 2
g4H014 | Кран группы измерения давления между задвижками | КШЦМ Gas 020.040.Н/П.02 | | Челябинскспецгражданстрой | шт | 1
g4H015 | Кран для установки датчика температуры | КШЦМ Gas 020.040.Н/П.02 | | Челябинскспецгражданстрой | шт | 1
g4H016 | Кран группы измерения давления после техн. узла учета газа | КШЦМ Gas 020.040.Н/П.02 | | Челябинскспецгражданстрой | шт | 1
| бобышка стальная для установки термометра | БП1 / М20х1,5 / 55 / Ст.20 | | | шт | 1

Спецификация оборудования и материалов

370-24-ГС4.СО

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

Разработал

Агафонов

Н.контроль

Гатауллин

Изм. | Кол.уч. | Лист | № док. | Подп. | Дата
| | | | Котел ПТВМ-180 №4. Газоснабжение | Стадия | Лист | Листов
Гл.инженер | Корепанов | | 07.24 | | Р | 1 | 6

Инв. № подп. Взам. инв. №
Марка стали применяемых труб должна соответствовать СП 42-102-2004 "Проектирование и

и строительство газопроводов из металлических труб"
Нормы испытательных давлений принять согл. СП 62.13330.2011 п.10.5.7

1 2 | | 3 | 4 | 5 | 6 | 7 | 8 | 9
g4V131 | Клапан ПЗК1 сталь., эл .магн., "НЗ", фланц. Ду100, Ру-0,6 МПа (с КОФ) на горелке №13 | ВН 4Н-1 П ст | | СП Термобрест | компл | 1 | | в составе ПАК, см. АК
g4V141 | Клапан ПЗК1 сталь., эл .магн., "НЗ", фланц. Ду100, Ру-0,6 МПа (с КОФ) на горелке №14 | ВН 4Н-1 П ст | | СП Термобрест | компл | 1 | | в составе ПАК, см. АК
g4V151 | Клапан ПЗК1 сталь., эл .магн., "НЗ", фланц. Ду100, Ру-0,6 МПа (с КОФ) на горелке №15 | ВН 4Н-1 П ст | | СП Термобрест | компл | 1 | | в составе ПАК, см. АК
g4V161 | Клапан ПЗК1 сталь., эл .магн., "НЗ", фланц. Ду100, Ру-0,6 МПа (с КОФ) на горелке №16 | ВН 4Н-1 П ст | | СП Термобрест | компл | 1 | | в составе ПАК, см. АК
g4V171 | Клапан ПЗК1 сталь., эл .магн., "НЗ", фланц. Ду100, Ру-0,6 МПа (с КОФ) на горелке №17 | ВН 4Н-1 П ст | | СП Термобрест | компл | 1 | | в составе ПАК, см. АК
g4V181 | Клапан ПЗК1 сталь., эл .магн., "НЗ", фланц. Ду100, Ру-0,6 МПа (с КОФ) на горелке №18 | ВН 4Н-1 П ст | | СП Термобрест | компл | 1 | | в составе ПАК, см. АК
g4V191 | Клапан ПЗК1 сталь., эл .магн., "НЗ", фланц. Ду100, Ру-0,6 МПа (с КОФ) на горелке №19 | ВН 4Н-1 П ст | | СП Термобрест | компл | 1 | | в составе ПАК, см. АК
g4V201 | Клапан ПЗК1 сталь., эл .магн., "НЗ", фланц. Ду100, Ру-0,6 МПа (с КОФ) на горелке №20 | ВН 4Н-1 П ст | | СП Термобрест | компл | 1 | | в составе ПАК, см. АК
g4V012 | Клапан ПЗК2 сталь., эл .магн., "НЗ", фланц. Ду100, Ру-0,6 МПа (с КОФ) на горелке № 1 | ВН 4Н-1 П ст | СП Термобрест | компл | 1 | в составе ПАК, см. АК
g4V022 | Клапан ПЗК2 сталь., эл .магн., "НЗ", фланц. Ду100, Ру-0,6 МПа (с КОФ) на горелке №2 | ВН 4Н-1 П ст | СП Термобрест | компл | 1 | в составе ПАК, см. АК
g4V032 | Клапан ПЗК2 сталь., эл .магн., "НЗ", фланц. Ду100, Ру-0,6 МПа (с КОФ) на горелке №3 | ВН 4Н-1 П ст | СП Термобрест | компл | 1 | в составе ПАК, см. АК
g4V042 | Клапан ПЗК2 сталь., эл .магн., "НЗ", фланц. Ду100, Ру-0,6 МПа (с КОФ) на горелке № 4 | ВН 4Н-1 П ст | СП Термобрест | компл | 1 | в составе ПАК, см. АК
g4V052 | Клапан ПЗК2 сталь., эл .магн., "НЗ", фланц. Ду100, Ру-0,6 МПа (с КОФ) на горелке № 5 | ВН 4Н-1 П ст | СП Термобрест | компл | 1 | в составе ПАК, см. АК
g4V062 | Клапан ПЗК2 сталь., эл .магн., "НЗ", фланц. Ду100, Ру-0,6 МПа (с КОФ) на горелке № 6 | ВН 4Н-1 П ст | СП Термобрест | компл | 1 | в составе ПАК, см. АК
g4V072 | Клапан ПЗК2 сталь., эл .магн., "НЗ", фланц. Ду100, Ру-0,6 МПа (с КОФ) на горелке №7 | ВН 4Н-1 П ст | СП Термобрест | компл | 1 | в составе ПАК, см. АК
g4V083 | Клапан ПЗК2 сталь., эл .магн., "НЗ", фланц. Ду100, Ру-0,6 МПа (с КОФ) на горелке №8 | ВН 4Н-1 П ст | СП Термобрест | компл | 1 | в составе ПАК, см. АК
g4V093 | Клапан ПЗК2 сталь., эл .магн., "НЗ", фланц. Ду100, Ру-0,6 МПа (с КОФ) на горелке №9 | ВН 4Н-1 П ст | СП Термобрест | компл | 1 | в составе ПАК, см. АК
g4V103 | Клапан ПЗК2 сталь., эл .магн., "НЗ", фланц. Ду100, Ру-0,6 МПа (с КОФ) на горелке №10 | ВН 4Н-1 П ст | СП Термобрест | компл | 1 | в составе ПАК, см. АК
g4V113 | Клапан ПЗК2 сталь., эл .магн., "НЗ", фланц. Ду100, Ру-0,6 МПа (с КОФ) на горелке №11 | ВН 4Н-1 П ст | СП Термобрест | компл | 1 | в составе ПАК, см. АК
g4V123 | Клапан ПЗК2 сталь., эл .магн., "НЗ", фланц. Ду100, Ру-0,6 МПа (с КОФ) на горелке №12 | ВН 4Н-1 П ст | СП Термобрест | компл | 1 | в составе ПАК, см. АК
g4V132 | Клапан ПЗК2 сталь., эл .магн., "НЗ", фланц. Ду100, Ру-0,6 МПа (с КОФ) на горелке №13 | ВН 4Н-1 П ст | СП Термобрест | компл | 1 | в составе ПАК, см. АК
g4V142 | Клапан ПЗК2 сталь., эл .магн., "НЗ", фланц. Ду100, Ру-0,6 МПа (с КОФ) на горелке №14 | ВН 4Н-1 П ст | СП Термобрест | компл | 1 | в составе ПАК, см. АК
g4V152 | Клапан ПЗК2 сталь., эл .магн., "НЗ", фланц. Ду100, Ру-0,6 МПа (с КОФ) на горелке №15 | ВН 4Н-1 П ст | СП Термобрест | компл | 1 | в составе ПАК, см. АК
g4V162 | Клапан ПЗК2 сталь., эл .магн., "НЗ", фланц. Ду100, Ру-0,6 МПа (с КОФ) на горелке №16 | ВН 4Н-1 П ст | СП Термобрест | компл | 1 | в составе ПАК, см. АК
g4V172 | Клапан ПЗК2 сталь., эл .магн., "НЗ", фланц. Ду100, Ру-0,6 МПа (с КОФ) на горелке №17 | ВН 4Н-1 П ст | СП Термобрест | компл | 1 | в составе ПАК, см. АК
g4V182 | Клапан ПЗК2 сталь., эл .магн., "НЗ", фланц. Ду100, Ру-0,6 МПа (с КОФ) на горелке №18 | ВН 4Н-1 П ст | СП Термобрест | компл | 1 | в составе ПАК, см. АК
g4V192 | Клапан ПЗК2 сталь., эл .магн., "НЗ", фланц. Ду100, Ру-0,6 МПа (с КОФ) на горелке №19 | ВН 4Н-1 П ст | СП Термобрест | компл | 1 | в составе ПАК, см. АК
g4V202 | Клапан ПЗК2 сталь., эл .магн., "НЗ", фланц. Ду100, Ру-0,6 МПа (с КОФ) на горелке №20 | ВН 4Н-1 П ст | СП Термобрест | компл | 1 | в составе ПАК, см. АК
g4V013 | Клапан сталь, газовый, муфтовый, dу25, НО - на труб. безопасности перед горелкой №1 | ВФ 1 Н-4П ст . | СП Термобрест | шт | 1 | в составе ПАК, см. АК
g4V023 | Клапан сталь, газовый, муфтовый, dу25, НО - на труб. безопасности перед горелкой №2 | ВФ 1 Н-4П ст . | СП Термобрест | шт | 1 | в составе ПАК, см. АК
g4V033 | Клапан сталь, газовый, муфтовый, dу25, НО - на труб. безопасности перед горелкой №3 | ВФ 1 Н-4П ст . | СП Термобрест | шт | 1 | в составе ПАК, см. АК
g4V043 | Клапан сталь, газовый, муфтовый, dу25, НО - на труб. безопасности перед горелкой №4 | ВФ 1 Н-4П ст . | СП Термобрест | шт | 1 | в составе ПАК, см. АК
g4V053 | Клапан сталь, газовый, муфтовый, dу25, НО - на труб. безопасности перед горелкой №5 | ВФ 1 Н-4П ст . | СП Термобрест | шт | 1 | в составе ПАК, см. АК
g4V063 | Клапан сталь, газовый, муфтовый, dу25, НО - на труб. безопасности перед горелкой №6 | ВФ 1 Н-4П ст . | СП Термобрест | шт | 1 | в составе ПАК, см. АК
g4V073 | Клапан сталь, газовый, муфтовый, dу25, НО - на труб. безопасности перед горелкой №7 | ВФ 1 Н-4П ст . | СП Термобрест | шт | 1 | в составе ПАК, см. АК
g4V083 | Клапан сталь, газовый, муфтовый, dу25, НО - на труб. безопасности перед горелкой №8 | ВФ 1 Н-4П ст . | СП Термобрест | шт | 1 | в составе ПАК, см. АК
g4V093 | Клапан сталь, газовый, муфтовый, dу25, НО - на труб. безопасности перед горелкой №9 | ВФ 1 Н-4П ст . | СП Термобрест | шт | 1 | в составе ПАК, см. АК
g4V103 | Клапан сталь, газовый, муфтовый, dу25, НО - на труб. безопасности перед горелкой №10 | ВФ 1 Н-4П ст . | СП Термобрест | шт | 1 | в составе ПАК, см. АК
g4V113 | Клапан сталь, газовый, муфтовый, dу25, НО - на труб. безопасности перед горелкой №11 | ВФ 1 Н-4П ст . | СП Термобрест | шт | 1 | в составе ПАК, см. АК
g4V123 | Клапан сталь, газовый, муфтовый, dу25, НО - на труб. безопасности перед горелкой №12 | ВФ 1 Н-4П ст . | СП Термобрест | шт | 1 | в составе ПАК, см. АК
g4V133 | Клапан сталь, газовый, муфтовый, dу25, НО - на труб. безопасности перед горелкой №13 | ВФ 1 Н-4П ст . | СП Термобрест | шт | 1 | в составе ПАК, см. АК
Нормы испытательных давлений принять согл. СП 62.13330.2011 п.10.5.7 (табл.16)

Подп. и дата

Взам. инв. №

Инв. № подп.
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
