nppesnteam/370-24_Balakovo_PTVM180_-3-4/model370.pdf

B2

B4

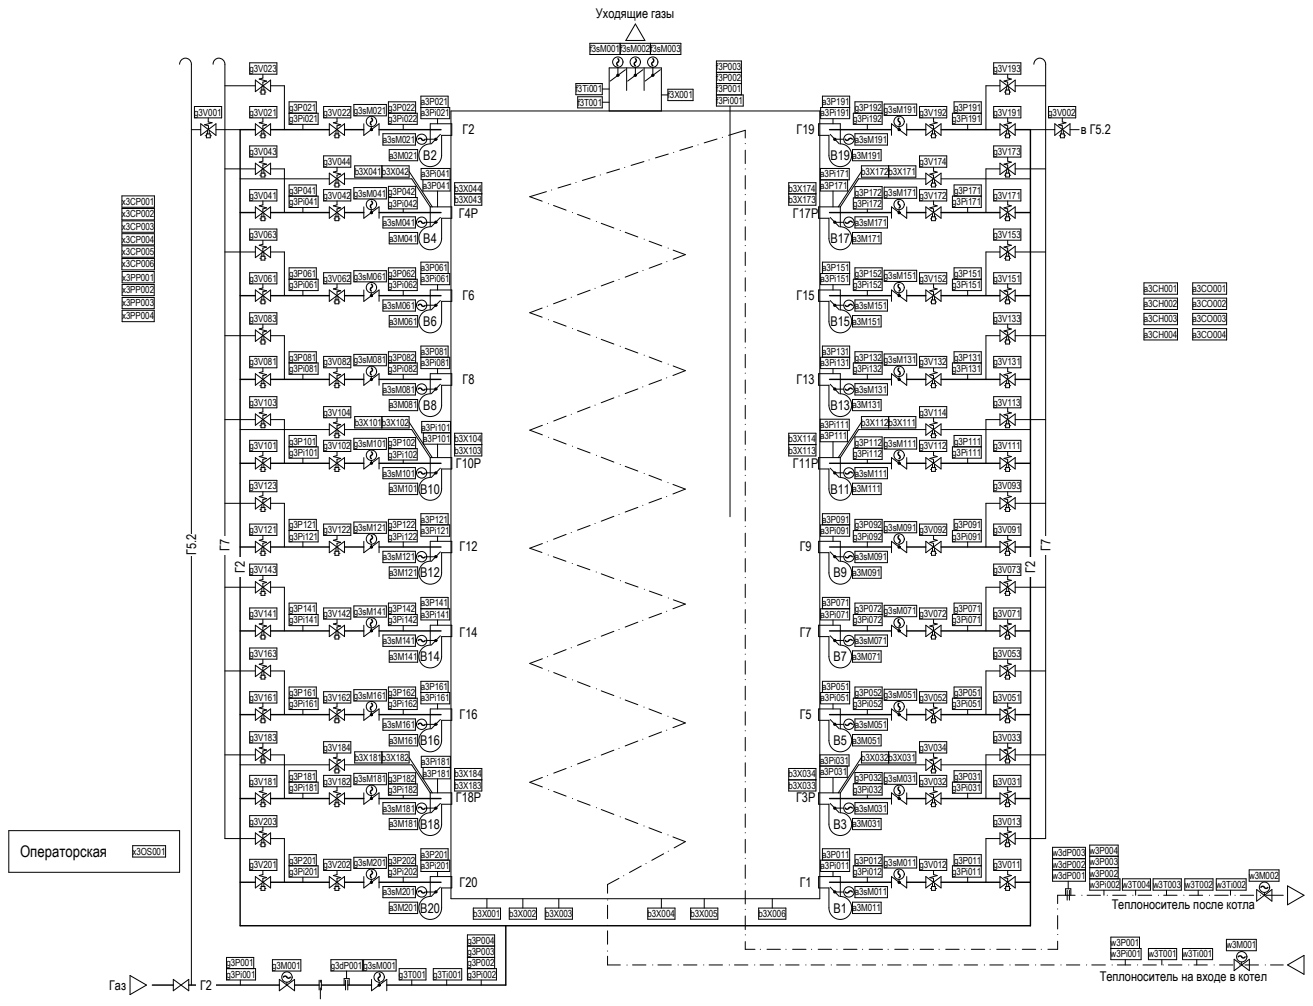
[picture p147: page 1]
Газ; Уходящие газы; Операторская

Теплоноситель после котла

Теплоноситель на входе в котел
