nppesnteam/370-24_Balakovo_PTVM180_-3-4/scheme.pdf

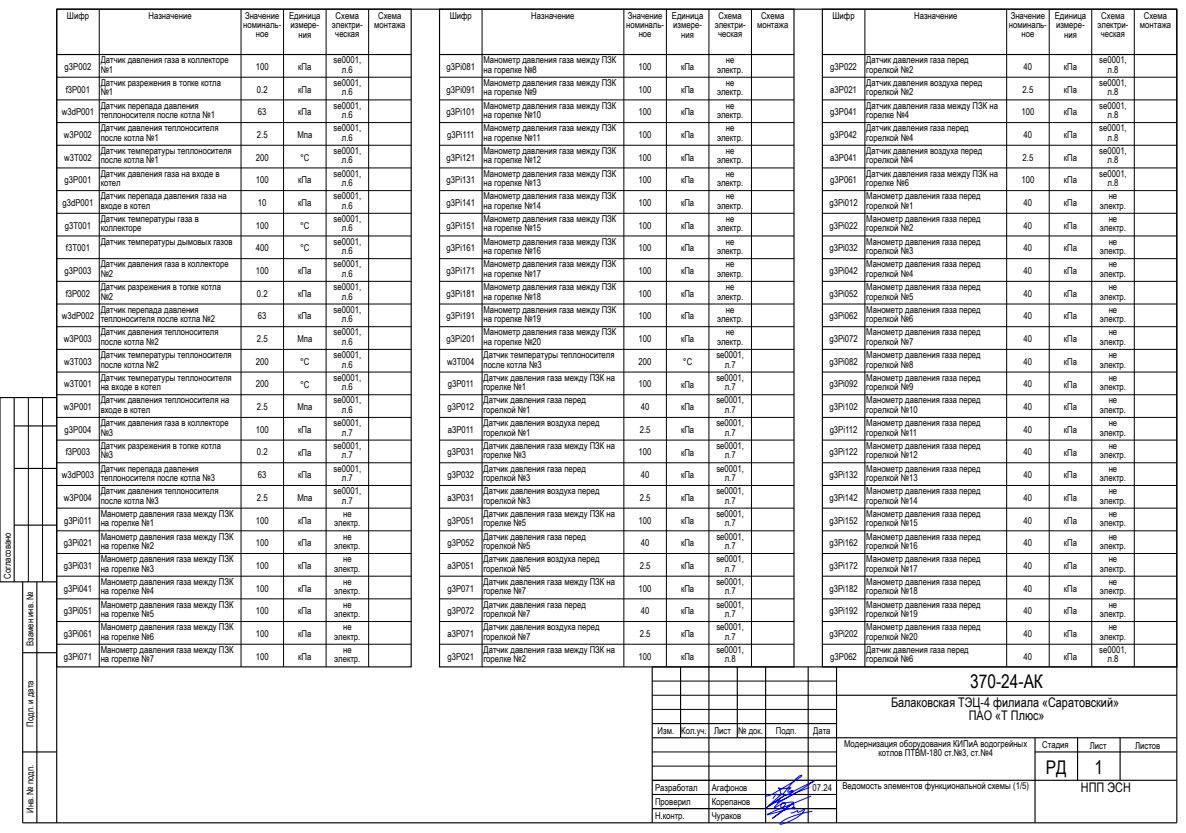
[picture p148: page 1]
Согласовано; Шифр; Назначение; Значение; номиналь- ное; Единица измере- ния; Схема электри- ческая; Схема монтажа; Датчик давления газа в коллекторе; л.6 кПа; Датчик разрежения в топке котла; Датчик перепада давления; теплоносителя после котла №1; Датчик давления теплоносителя; после котла №1; se0001, Мпа; Датчик температуры теплоносителя; Датчик давления газа на входе в; котел; Датчик перепада давления газа на; входе в котел; Датчик температуры газа в; коллекторе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

Инв. № подп. Подп. и дата Взамен инв. №

Балаковская ТЭЦ-4 филиала «Саратовский» ПАО «Т Плюс»

Изм. | Кол.уч. | Лист | № док. | Подп. | Дата

Модернизация оборудования КИПиА водогрейных котлов ПТВМ-180 ст.№3, ст.№4 | Стадия | Лист | Листов

Разработал | Агафонов | | | Ведомость элементов функциональной схемы (1/5) | НПП ЭСН
Проверил | Корепанов
Н.контр. | Чураков

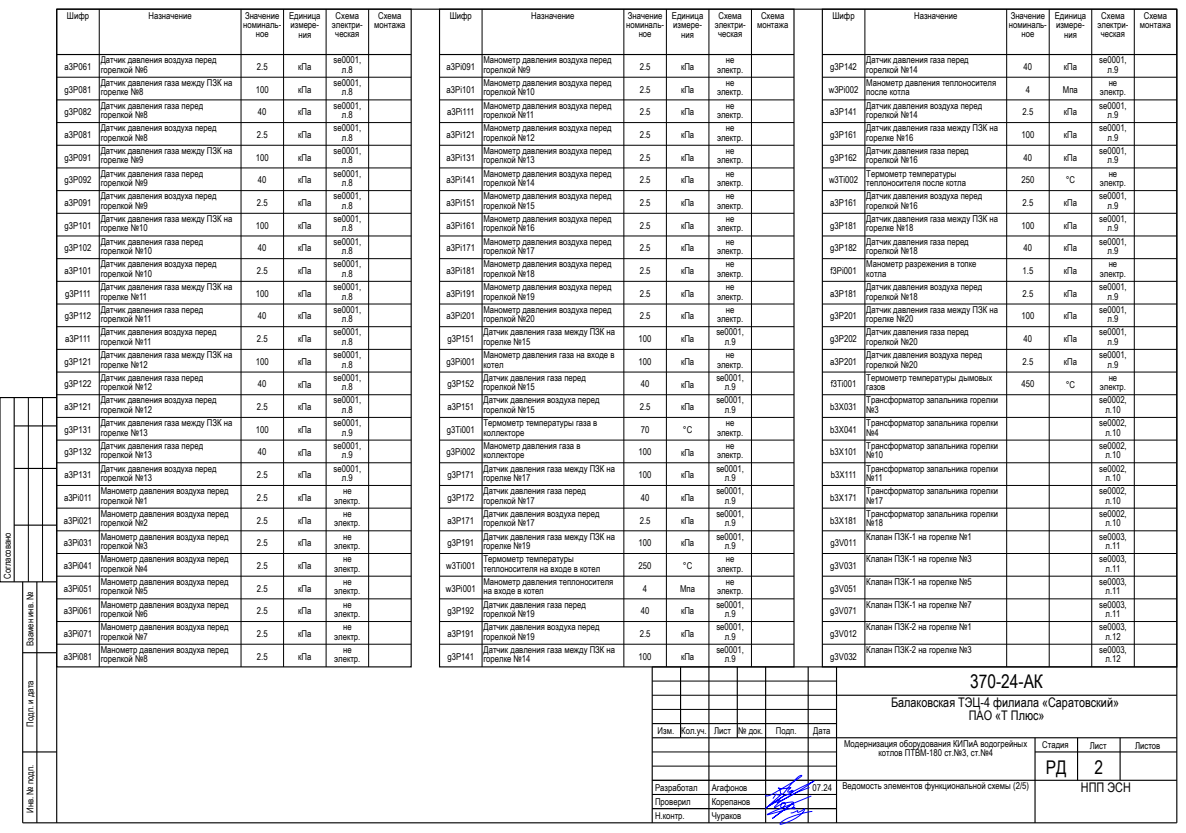
[picture p149: page 2]
Согласовано; Шифр; Назначение; Значение; номиналь- ное; Единица измере- ния; Схема электри- ческая; Схема монтажа; Датчик давления воздуха перед; горелкой №6; л.8 кПа; Датчик давления газа между ПЗК на; горелке №8; Датчик давления газа перед; горелкой №8; горелке №9; горелкой №9; горелке №10; горелкой №10; горелке №11; горелкой №11; горелке №12; горелкой №12; горелке №13; л.9 кПа; горелкой №13; Манометр давления воздуха перед; горелкой №1; электр. кПа; горелкой №2; горелкой №3; горелкой №4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

Инв. № подп. Подп. и дата Взамен инв. №

Балаковская ТЭЦ-4 филиала «Саратовский» ПАО «Т Плюс»

Изм. | Кол.уч. | Лист | № док. | Подп. | Дата

Модернизация оборудования КИПиА водогрейных котлов ПТВМ-180 ст.№3, ст.№4 | Стадия | Лист | Листов

Ведомость элементов функциональной схемы (2/5) | НПП ЭСН

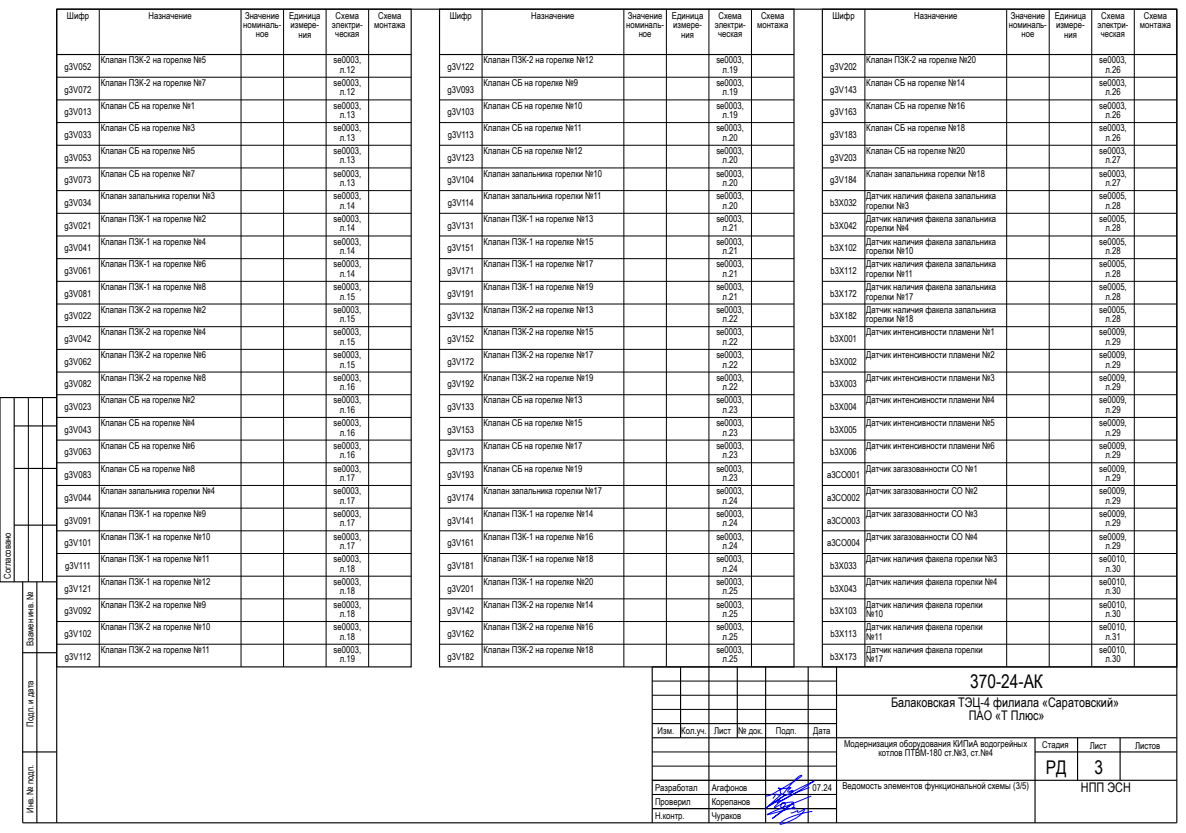
[picture p150: page 3]
Согласовано; Шифр; Назначение; Значение; номиналь- ное; Единица измере- ния; Схема электри- ческая; Схема монтажа; Клапан ПЗК-2 на горелке №5; Клапан ПЗК-2 на горелке №7; Клапан СБ на горелке №1; Клапан СБ на горелке №3; Клапан СБ на горелке №5; Клапан СБ на горелке №7; Клапан запальника горелки №3; Клапан ПЗК-1 на горелке №2; Клапан ПЗК-1 на горелке №4; Клапан ПЗК-1 на горелке №6; Клапан ПЗК-1 на горелке №8; Клапан ПЗК-2 на горелке №2; Клапан ПЗК-2 на горелке №4; Клапан ПЗК-2 на горелке №6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

Инв. № подп. Подп. и дата Взамен инв. №

Балаковская ТЭЦ-4 филиала «Саратовский» ПАО «Т Плюс»

Изм. | Кол.уч. | Лист | № док. | Подп. | Дата

Модернизация оборудования КИПиА водогрейных котлов ПТВМ-180 ст.№3, ст.№4 | Стадия | Лист | Листов

Ведомость элементов функциональной схемы (3/5) | НПП ЭСН

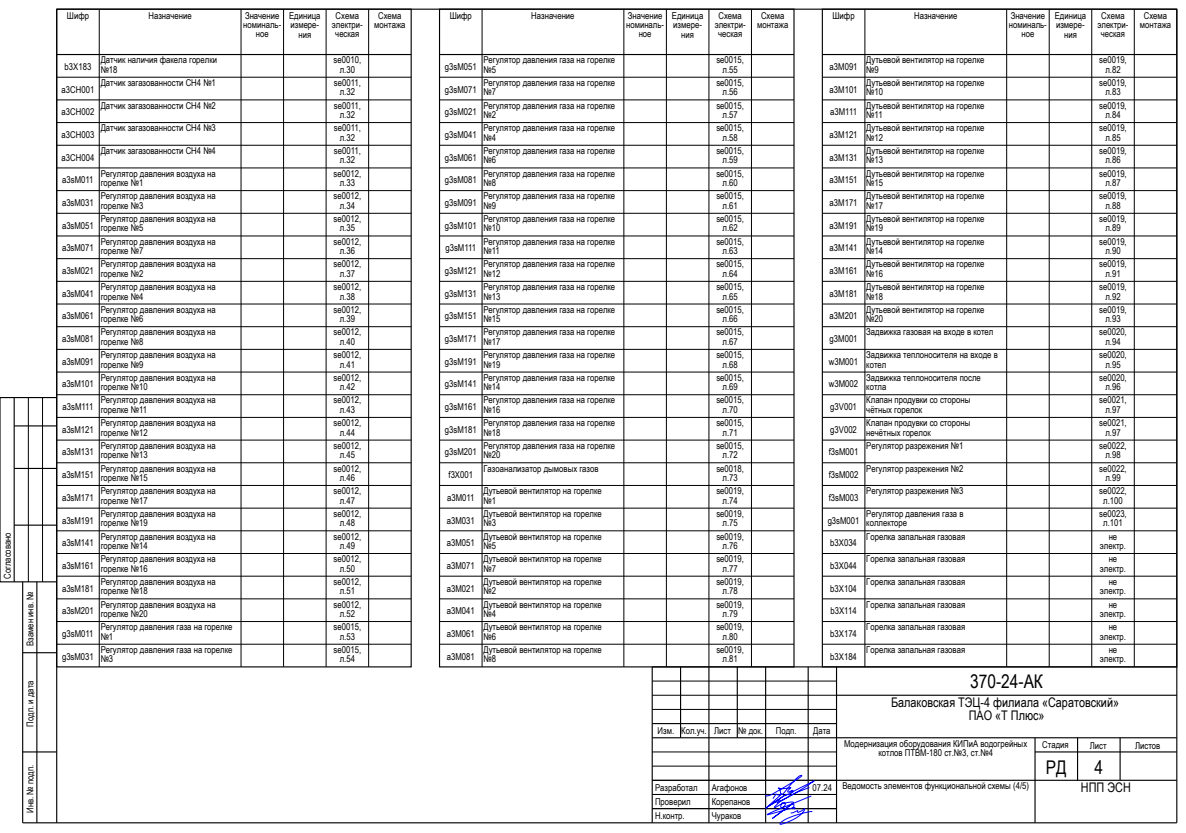
[picture p151: page 4]
Согласовано; Шифр; Назначение; Значение; номиналь- ное; Единица измере- ния; Схема электри- ческая; Схема монтажа; Датчик наличия факела горелки; Датчик загазованности СН4 №1; Датчик загазованности СН4 №2; Датчик загазованности СН4 №3; Датчик загазованности СН4 №4; Регулятор давления воздуха на; горелке №1; горелке №3; горелке №5; горелке №7; горелке №2; горелке №4; горелке №6; горелке №8; горелке №9; горелке №10; горелке №11; горелке №12; горелке №13; горелке №15; горелке №17; горелке №19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

Инв. № подп. Подп. и дата Взамен инв. №

Балаковская ТЭЦ-4 филиала «Саратовский» ПАО «Т Плюс»

Изм. | Кол.уч. | Лист | № док. | Подп. | Дата

Модернизация оборудования КИПиА водогрейных котлов ПТВМ-180 ст.№3, ст.№4 | Стадия | Лист | Листов

Ведомость элементов функциональной схемы (4/5) | НПП ЭСН

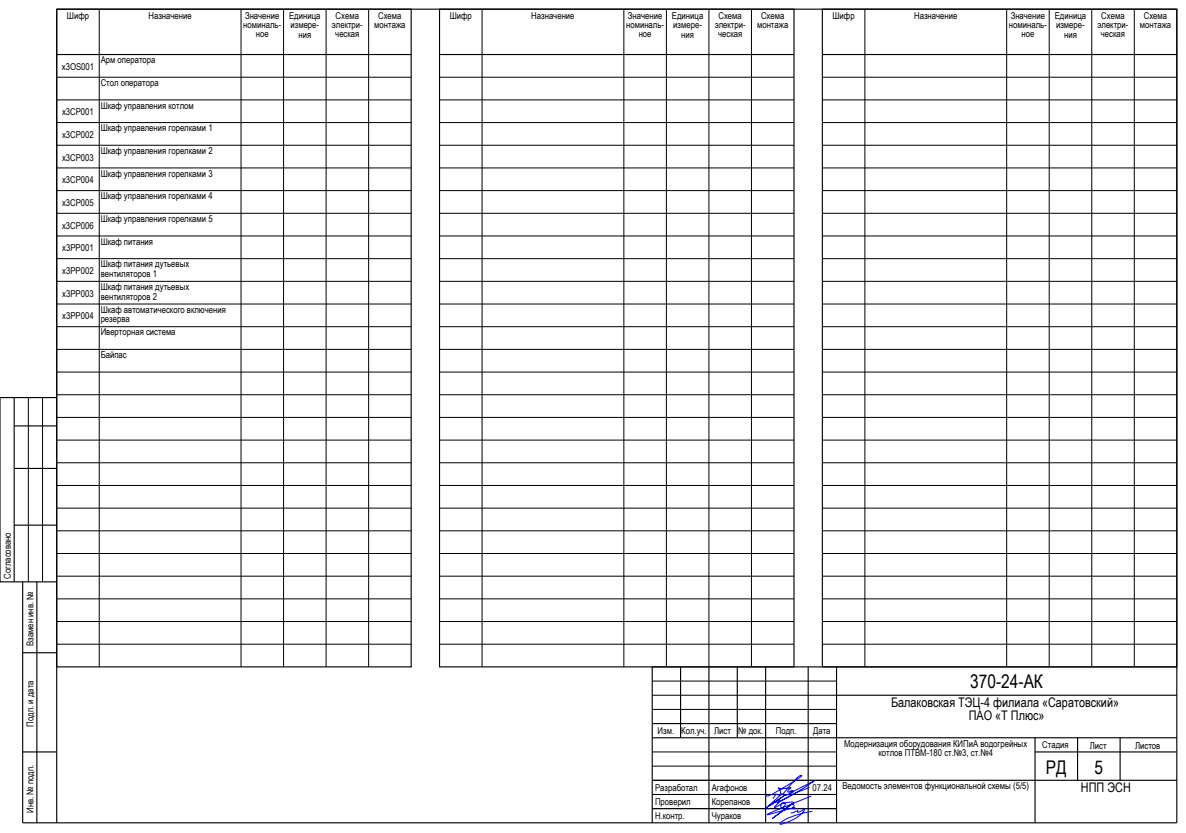
[picture p152: page 5]
Согласовано; Шифр; Назначение; Значение; номиналь- ное; Единица измере- ния; Схема электри- ческая; Схема монтажа; Арм оператора; Стол оператора; Шкаф управления котлом; Шкаф управления горелками 1; Шкаф управления горелками 2; Шкаф управления горелками 3; Шкаф управления горелками 4; Шкаф управления горелками 5; Шкаф питания; Шкаф питания дутьевых; вентиляторов 1; вентиляторов 2; Шкаф автоматического включения; резерва Иверторная система; Байпас

Инв. № подп. Подп. и дата Взамен инв. №

Балаковская ТЭЦ-4 филиала «Саратовский» ПАО «Т Плюс»

Изм. | Кол.уч. | Лист | № док. | Подп. | Дата

Модернизация оборудования КИПиА водогрейных котлов ПТВМ-180 ст.№3, ст.№4 | Стадия | Лист | Листов

Ведомость элементов функциональной схемы (5/5) | НПП ЭСН

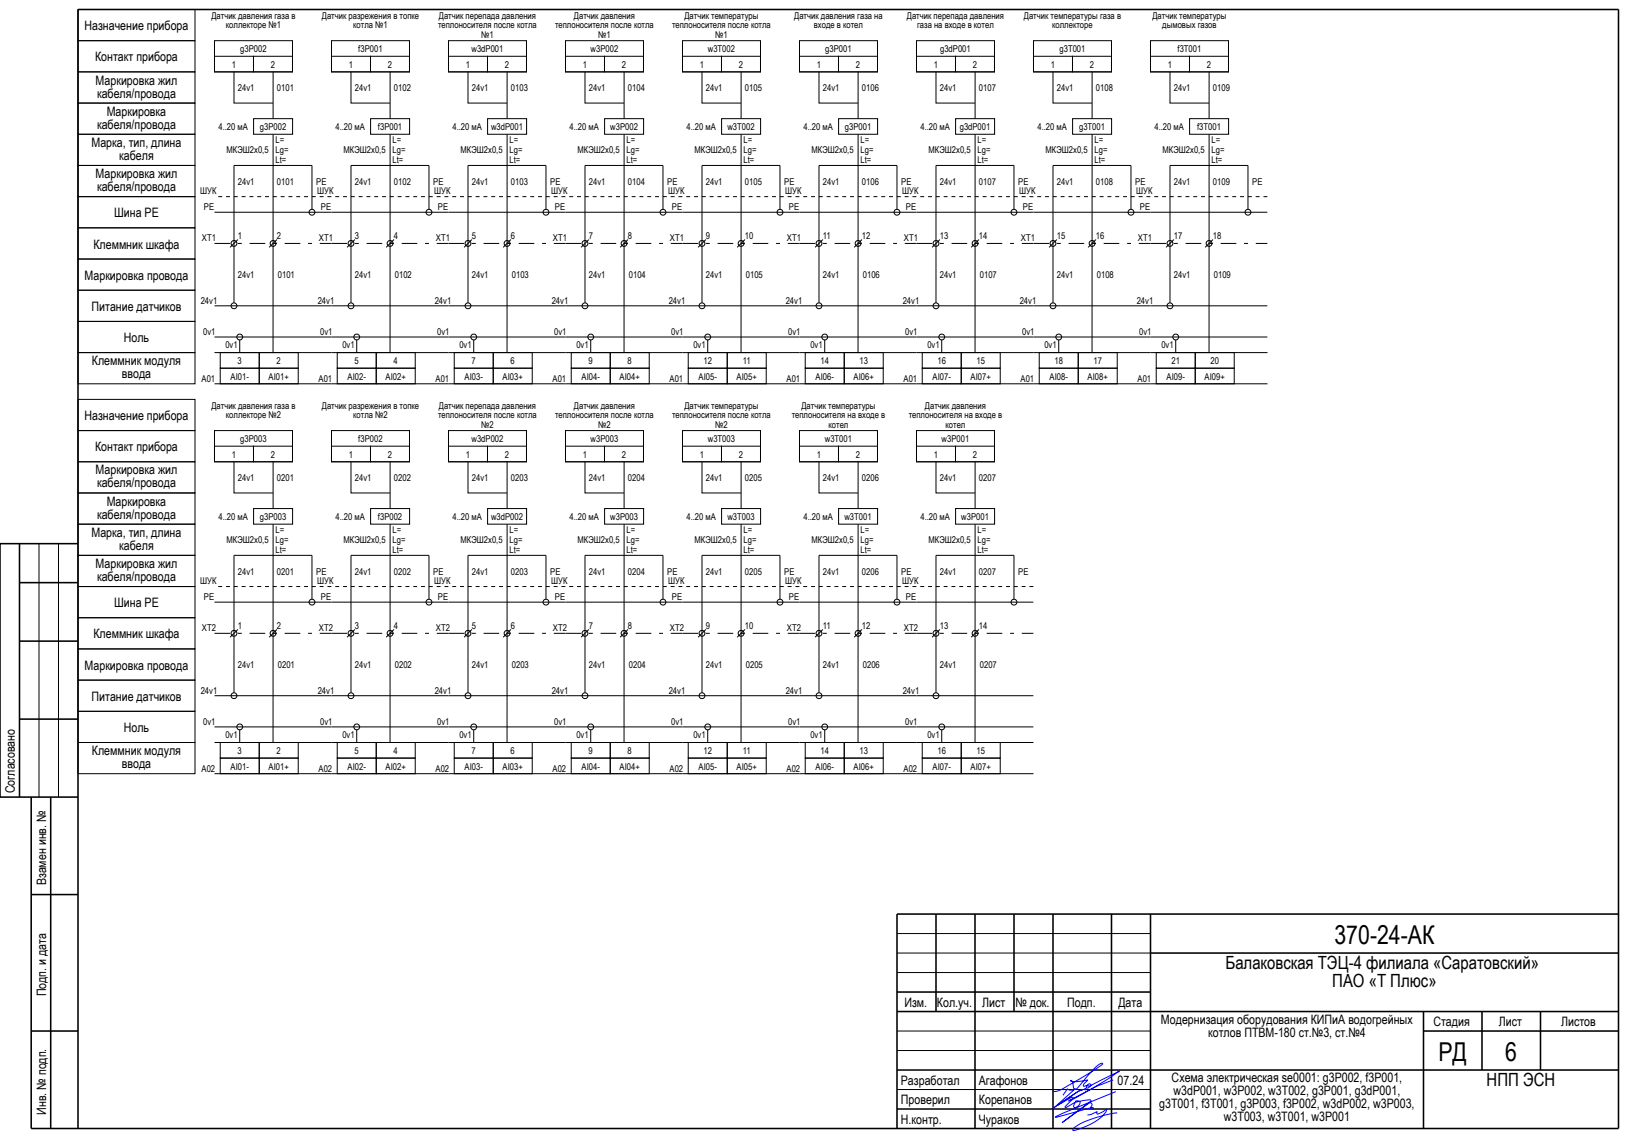
[picture p153: page 6]
Согласовано; Ноль; Питание датчиков; Клеммник шкафа; Шина PE; Маркировка жил кабеля/провода; Клеммник модуля ввода; Маркировка провода; ШУК; кабеля/провода; кабеля; Назначение прибора; МКЭШ2х0,5; Датчик температуры дымовых газов; котел

Датчик давления газа в
коллекторе №1

Датчик разрежения в топке
котла №1

Датчик перепада давления
теплоносителя после котла

Датчик давления

Датчик температуры

Датчик давления газа на
входе в котел

газа на входе в котел

Датчик температуры газа в
коллекторе

Контакт прибора
Маркировка жил
кабеля/провода
Маркировка
Марка, тип, длина

коллекторе №2

котла №2

теплоносителя на входе в

кабеля

Инв. № подп. Подп. и дата Взамен инв. №

Балаковская ТЭЦ-4 филиала «Саратовский» ПАО «Т Плюс»

Изм. | Кол.уч. | Лист | № док. | Подп. | Дата

Модернизация оборудования КИПиА водогрейных котлов ПТВМ-180 ст.№3, ст.№4 | Стадия | Лист | Листов

Схема электрическая se0001: g3P002, f3P001, w3dP001, w3P002, w3T002, g3P001, g3dP001, g3T001, f3T001, g3P003, f3P002, w3dP002, w3P003, w3T003, w3T001, w3P001 | НПП ЭСН

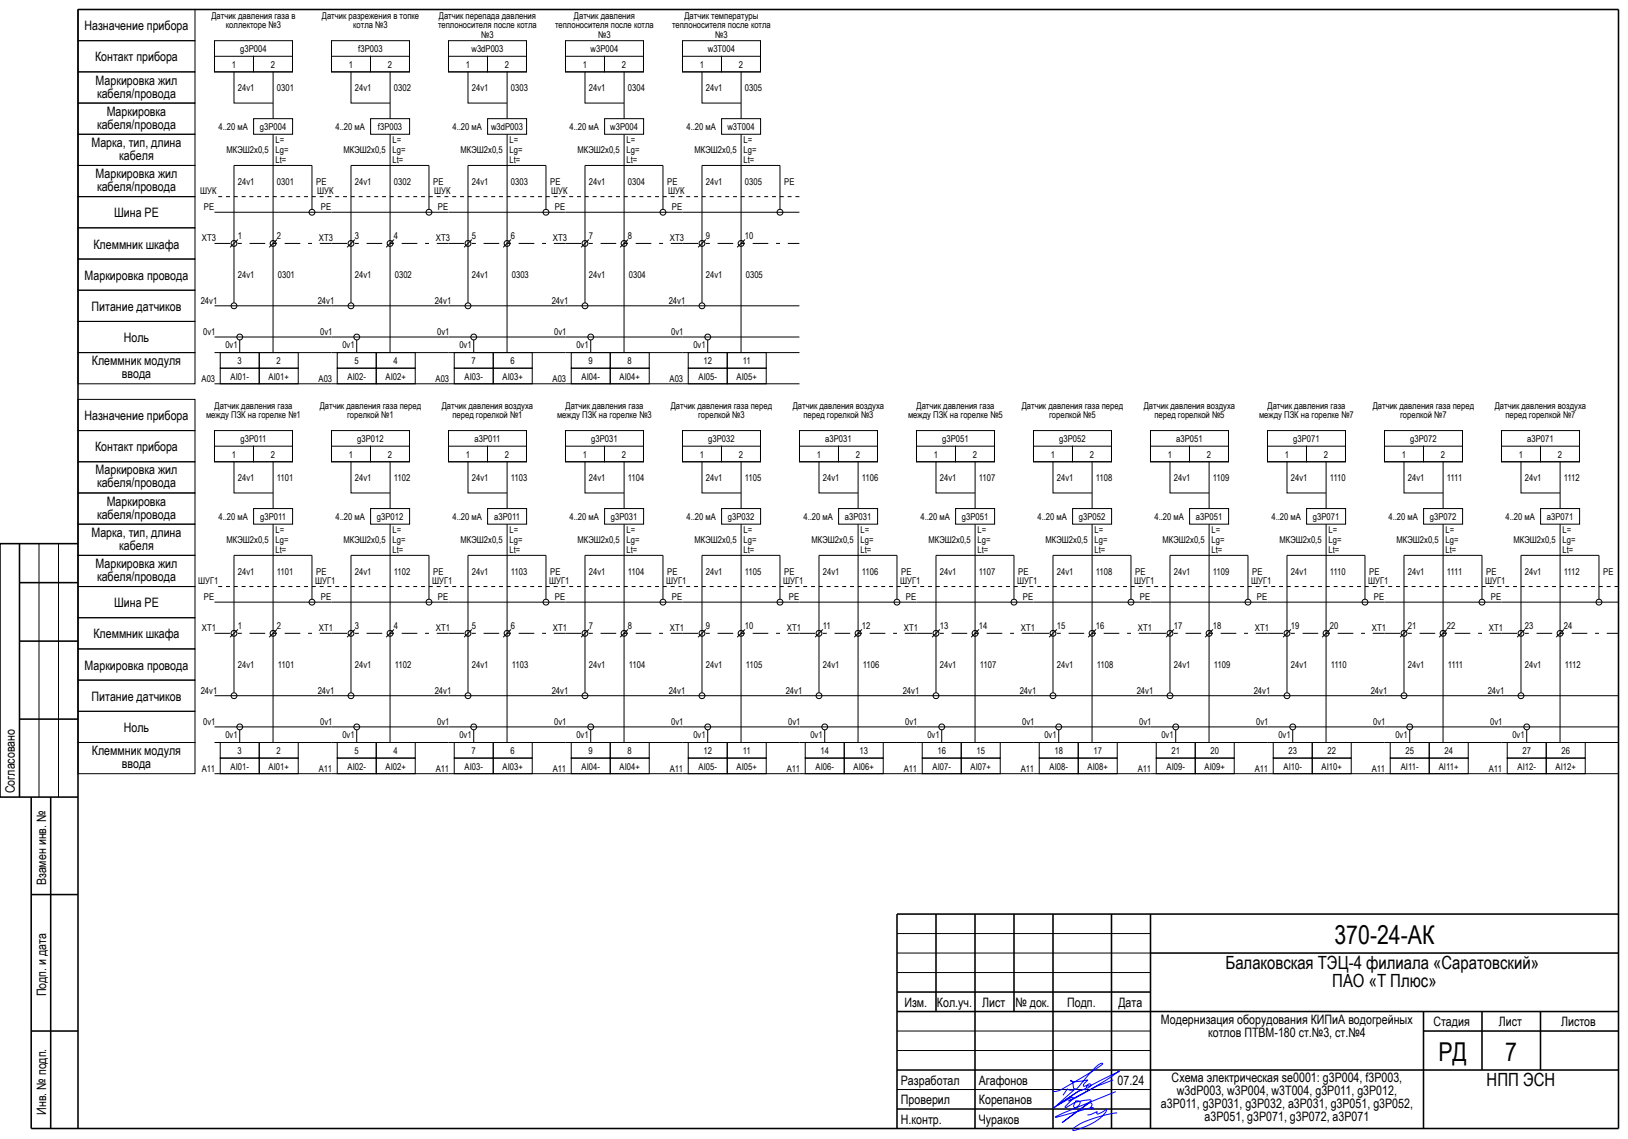
[picture p154: page 7]
Согласовано; Ноль; Питание датчиков; Клеммник шкафа; Шина PE; кабеля/провода; Клеммник модуля ввода; Маркировка провода; ШУК; ШУГ1; МКЭШ2х0,5; Маркировка кабеля/провода; Контакт прибора; Маркировка жил кабеля/провода; Назначение прибора

Датчик давления газа в
коллекторе №3

Датчик разрежения в топке
котла №3

Датчик перепада давления
теплоносителя после котла

Датчик давления

Датчик температуры

Контакт прибора
Маркировка жил
кабеля/провода
Маркировка
Марка, тип, длина
кабеля

Датчик давления газа
между ПЗК на горелке №1

Датчик давления газа перед
горелкой №1

Датчик давления воздуха
перед горелкой №1

между ПЗК на горелке №3

горелкой №3

перед горелкой №3

между ПЗК на горелке №5

горелкой №5

перед горелкой №5

между ПЗК на горелке №7

горелкой №7

перед горелкой №7

Инв. № подп. Подп. и дата Взамен инв. №

Балаковская ТЭЦ-4 филиала «Саратовский» ПАО «Т Плюс»

Изм. | Кол.уч. | Лист | № док. | Подп. | Дата

Модернизация оборудования КИПиА водогрейных котлов ПТВМ-180 ст.№3, ст.№4 | Стадия | Лист | Листов

Схема электрическая se0001: g3P004, f3P003, w3dP003, w3P004, w3T004, g3P011, g3P012, а3P011, g3P031, g3P032, а3P031, g3P051, g3P052, а3P051, g3P071, g3P072, а3P071 | НПП ЭСН

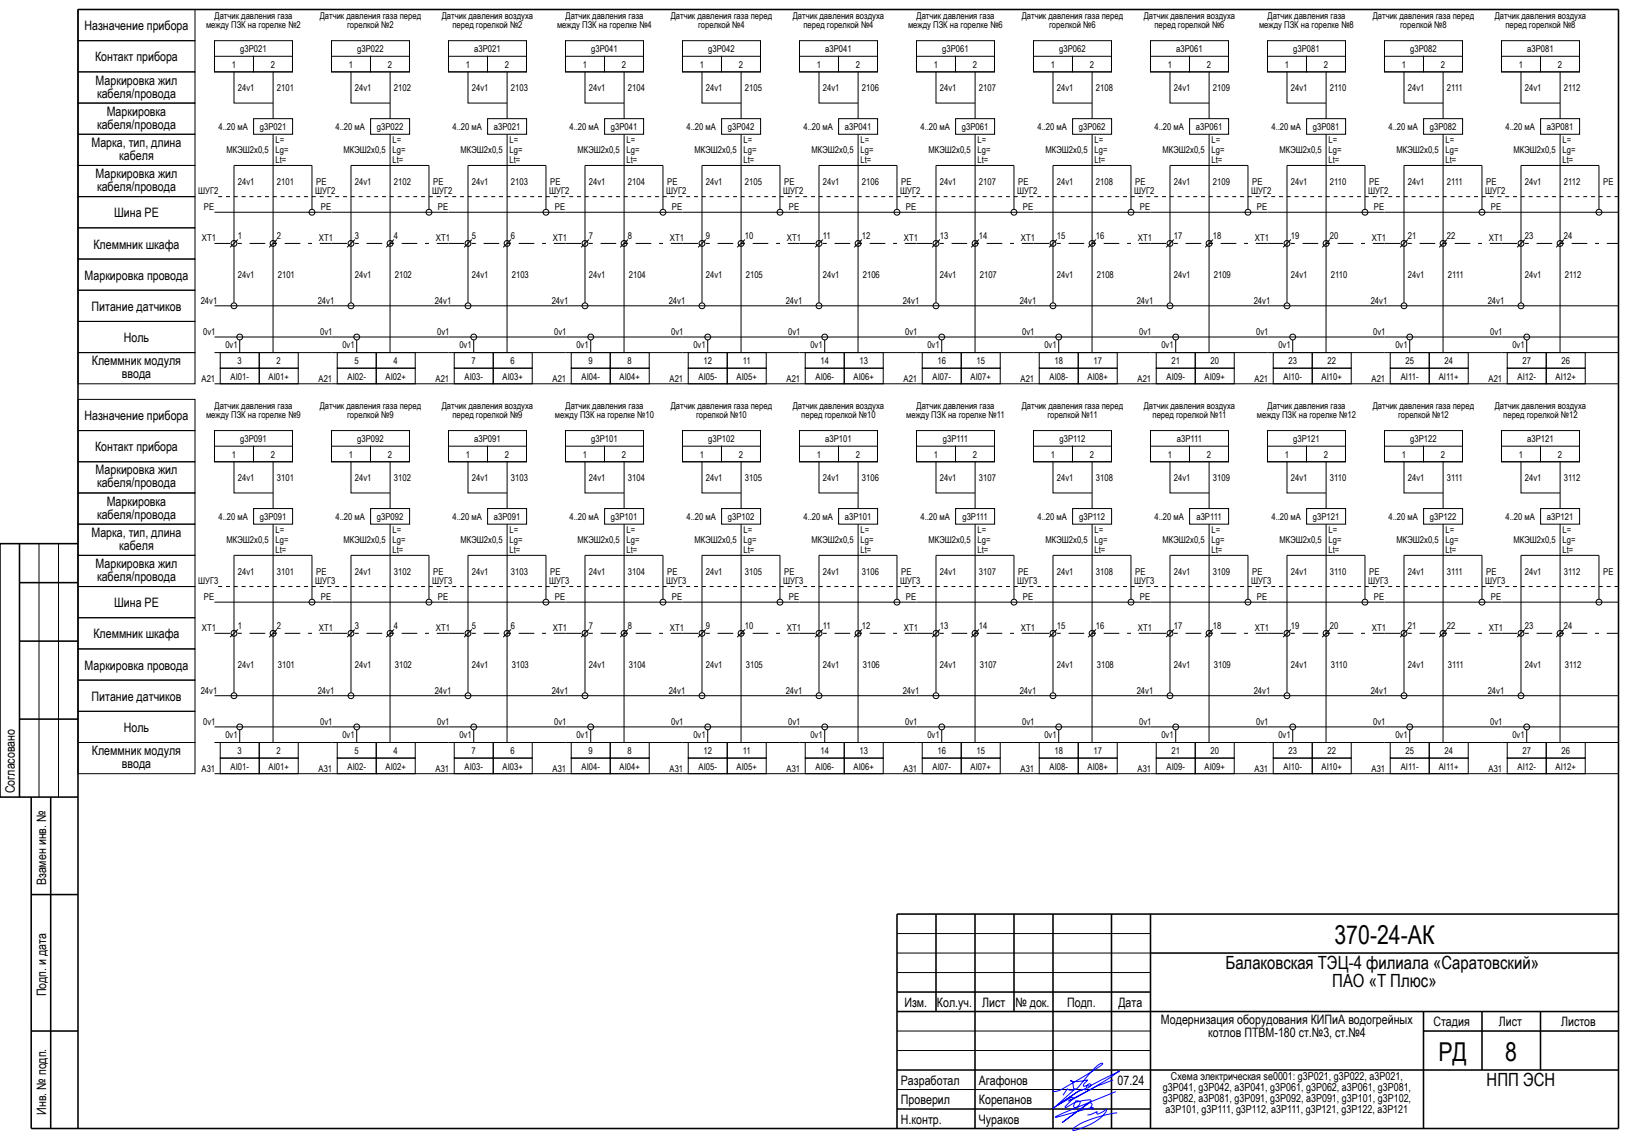
[picture p155: page 8]
Согласовано; Ноль; Питание датчиков; Клеммник шкафа; Шина PE; кабеля/провода; Клеммник модуля ввода; Маркировка провода; ШУГ2; ШУГ3; Маркировка кабеля/провода; Контакт прибора; Маркировка жил кабеля/провода; МКЭШ2х0,5; Назначение прибора

Датчик давления газа
между ПЗК на горелке №2

Датчик давления газа перед
горелкой №2

Датчик давления воздуха
перед горелкой №2

между ПЗК на горелке №4

горелкой №4

перед горелкой №4

между ПЗК на горелке №6

горелкой №6

перед горелкой №6

между ПЗК на горелке №8

горелкой №8

перед горелкой №8

Марка, тип, длина
кабеля
Маркировка жил

между ПЗК на горелке №9

горелкой №9

перед горелкой №9

между ПЗК на горелке №10

горелкой №10

перед горелкой №10

между ПЗК на горелке №11

горелкой №11

перед горелкой №11

между ПЗК на горелке №12

горелкой №12

перед горелкой №12

Инв. № подп. Подп. и дата Взамен инв. №

Балаковская ТЭЦ-4 филиала «Саратовский» ПАО «Т Плюс»

Изм. | Кол.уч. | Лист | № док. | Подп. | Дата

Модернизация оборудования КИПиА водогрейных котлов ПТВМ-180 ст.№3, ст.№4 | Стадия | Лист | Листов

Схема электрическая se0001: g3P021, g3P022, а3P021, g3P041, g3P042, а3P041, g3P061, g3P062, а3P061, g3P081, g3P082, а3P081, g3P091, g3P092, а3P091, g3P101, g3P102, а3P101, g3P111, g3P112, а3P111, g3P121, g3P122, а3P121 | НПП ЭСН

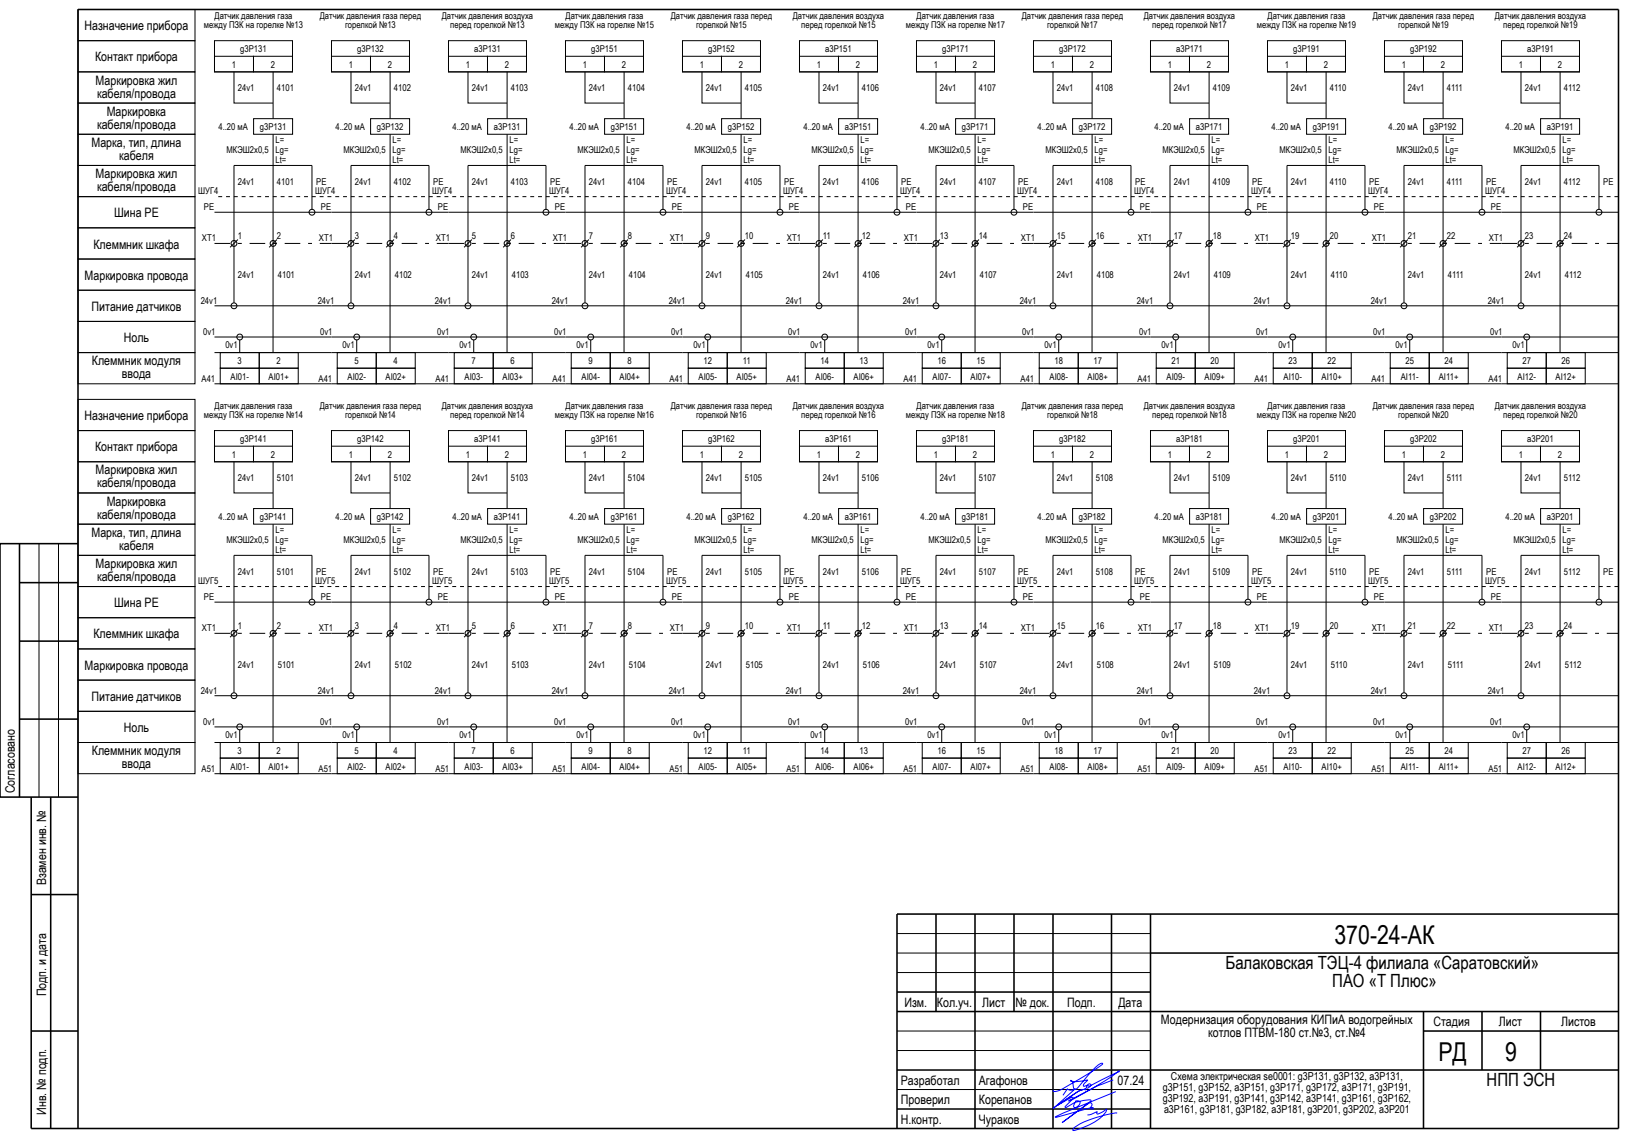
[picture p156: page 9]
Согласовано; Ноль; Питание датчиков; Клеммник шкафа; Шина PE; кабеля/провода; Клеммник модуля ввода; Маркировка провода; ШУГ4; ШУГ5; Маркировка кабеля/провода; Контакт прибора; Маркировка жил кабеля/провода; МКЭШ2х0,5; Назначение прибора

Датчик давления газа
между ПЗК на горелке №13

Датчик давления газа перед
горелкой №13

Датчик давления воздуха
перед горелкой №13

между ПЗК на горелке №15

горелкой №15

перед горелкой №15

между ПЗК на горелке №17

горелкой №17

перед горелкой №17

между ПЗК на горелке №19

горелкой №19

перед горелкой №19

Марка, тип, длина
кабеля
Маркировка жил

между ПЗК на горелке №14

горелкой №14

перед горелкой №14

между ПЗК на горелке №16

горелкой №16

перед горелкой №16

между ПЗК на горелке №18

горелкой №18

перед горелкой №18

между ПЗК на горелке №20

горелкой №20

перед горелкой №20

Инв. № подп. Подп. и дата Взамен инв. №

Балаковская ТЭЦ-4 филиала «Саратовский» ПАО «Т Плюс»

Изм. | Кол.уч. | Лист | № док. | Подп. | Дата

Модернизация оборудования КИПиА водогрейных котлов ПТВМ-180 ст.№3, ст.№4 | Стадия | Лист | Листов

Схема электрическая se0001: g3P131, g3P132, а3P131, g3P151, g3P152, а3P151, g3P171, g3P172, а3P171, g3P191, g3P192, а3P191, g3P141, g3P142, а3P141, g3P161, g3P162, а3P161, g3P181, g3P182, а3P181, g3P201, g3P202, а3P201 | НПП ЭСН

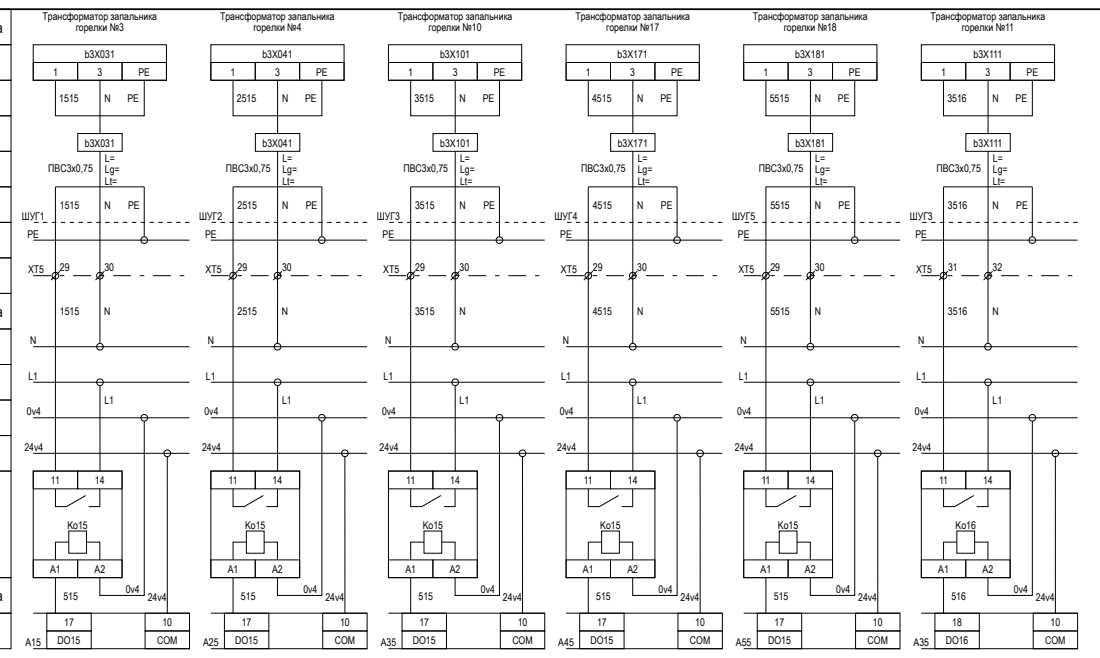
[picture p157: page 10]
Согласовано; Клеммник шкафа; Шина PE; кабеля/провода; Клеммник модуля ввода/вывода; Маркировка провода; Питание 220В; Реле; Ноль 220В; Ноль 24В; Питание 24В; ШУГ1; 10 COM; ШУГ2; ШУГ3; ШУГ4; ШУГ5; Трансформатор запальника горелки №3; ПВС3х0,75; Трансформатор запальника горелки №4; Трансформатор запальника горелки №10; Трансформатор запальника горелки №17; Трансформатор запальника горелки №18; Трансформатор запальника горелки №11

Контакт прибора
Маркировка жил
кабеля/провода
Маркировка
Марка, тип, длина
кабеля

Инв. № подп. Подп. и дата Взамен инв. №

Балаковская ТЭЦ-4 филиала «Саратовский» ПАО «Т Плюс»

Изм. | Кол.уч. | Лист | № док. | Подп. | Дата

Модернизация оборудования КИПиА водогрейных котлов ПТВМ-180 ст.№3, ст.№4 | Стадия | Лист | Листов

Схема электрическая se0002: b3X031, b3X041, b3X101, b3X171, b3X181, b3X111 | НПП ЭСН

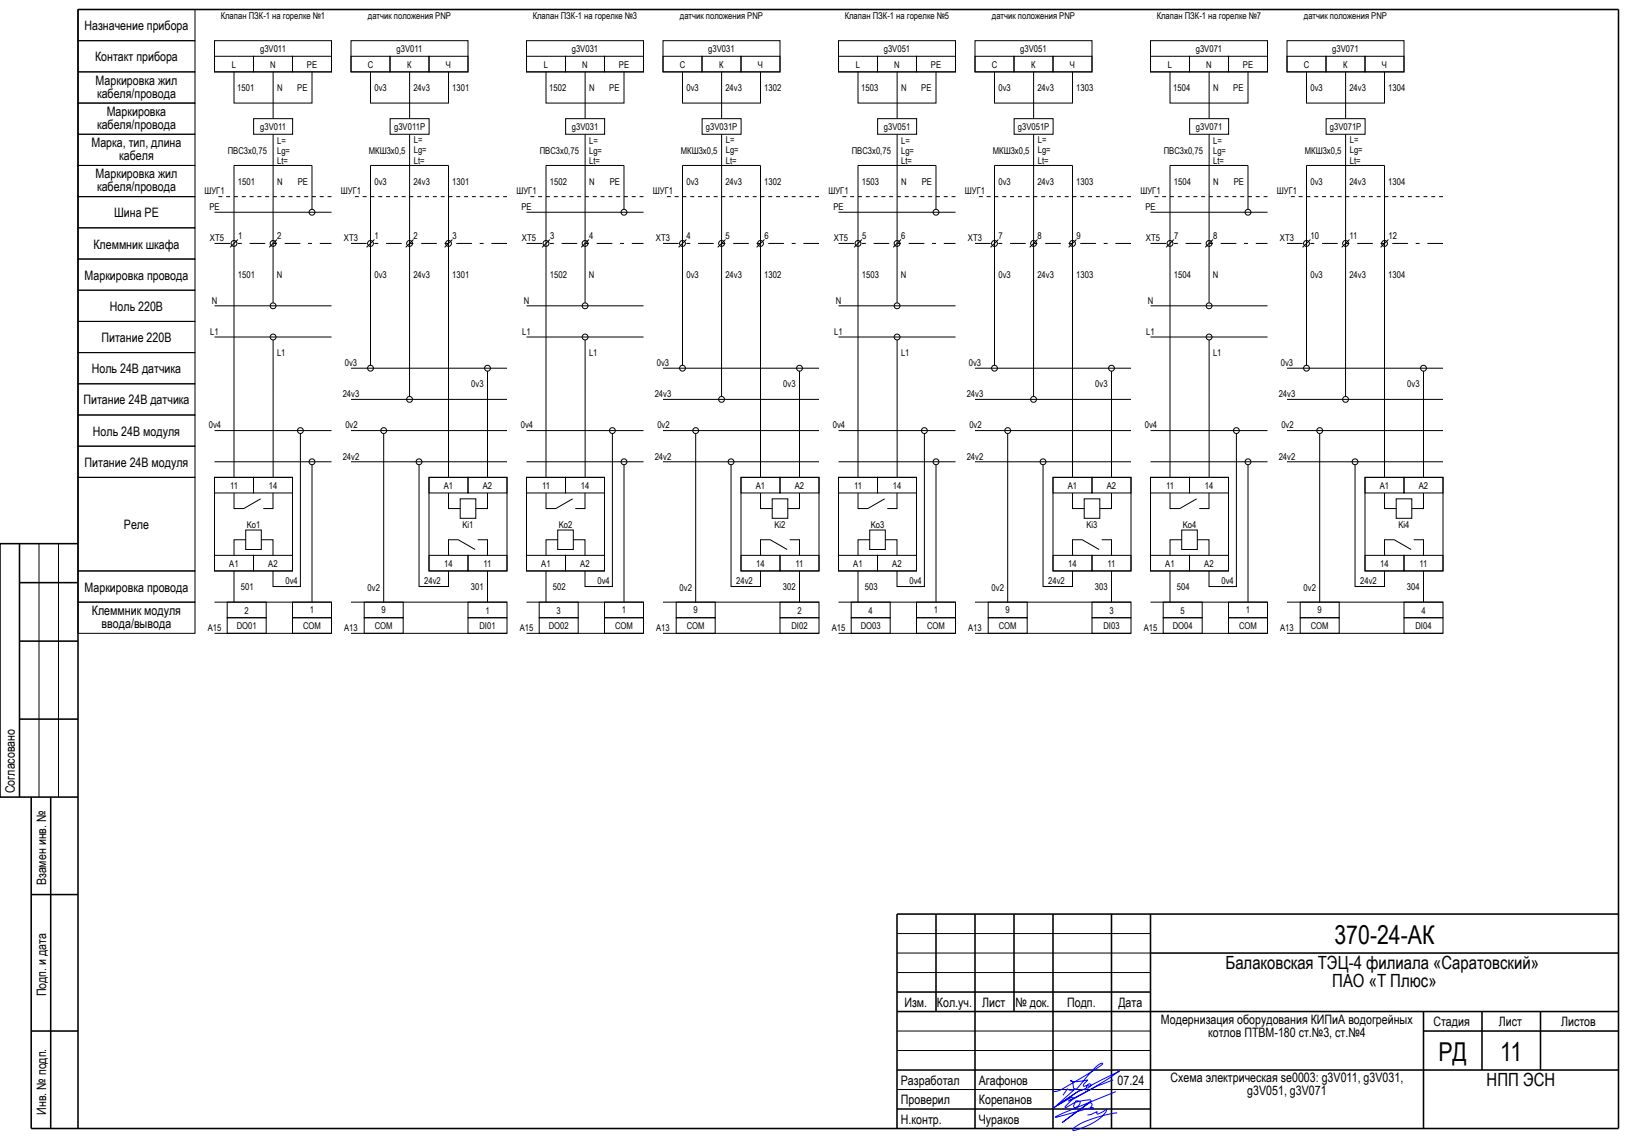
[picture p158: page 11]
Согласовано; Клеммник шкафа; Шина PE; кабеля/провода; Клеммник модуля ввода/вывода; Маркировка провода; Питание 220В; Реле; Ноль 220В; Питание 24В датчика; Ноль 24В датчика; Питание 24В модуля; Ноль 24В модуля; ШУГ1; COM; 1 COM; МКШ3х0,5; ПВС3х0,75

Клапан ПЗК-1 на горелке №1

датчик положения PNP

Клапан ПЗК-1 на горелке №3

Клапан ПЗК-1 на горелке №5

Клапан ПЗК-1 на горелке №7

Контакт прибора
Маркировка жил
кабеля/провода
Маркировка
Марка, тип, длина
кабеля

Инв. № подп. Подп. и дата Взамен инв. №

Балаковская ТЭЦ-4 филиала «Саратовский» ПАО «Т Плюс»

Изм. | Кол.уч. | Лист | № док. | Подп. | Дата

Модернизация оборудования КИПиА водогрейных котлов ПТВМ-180 ст.№3, ст.№4 | Стадия | Лист | Листов

Схема электрическая se0003: g3V011, g3V031, g3V051, g3V071 | НПП ЭСН

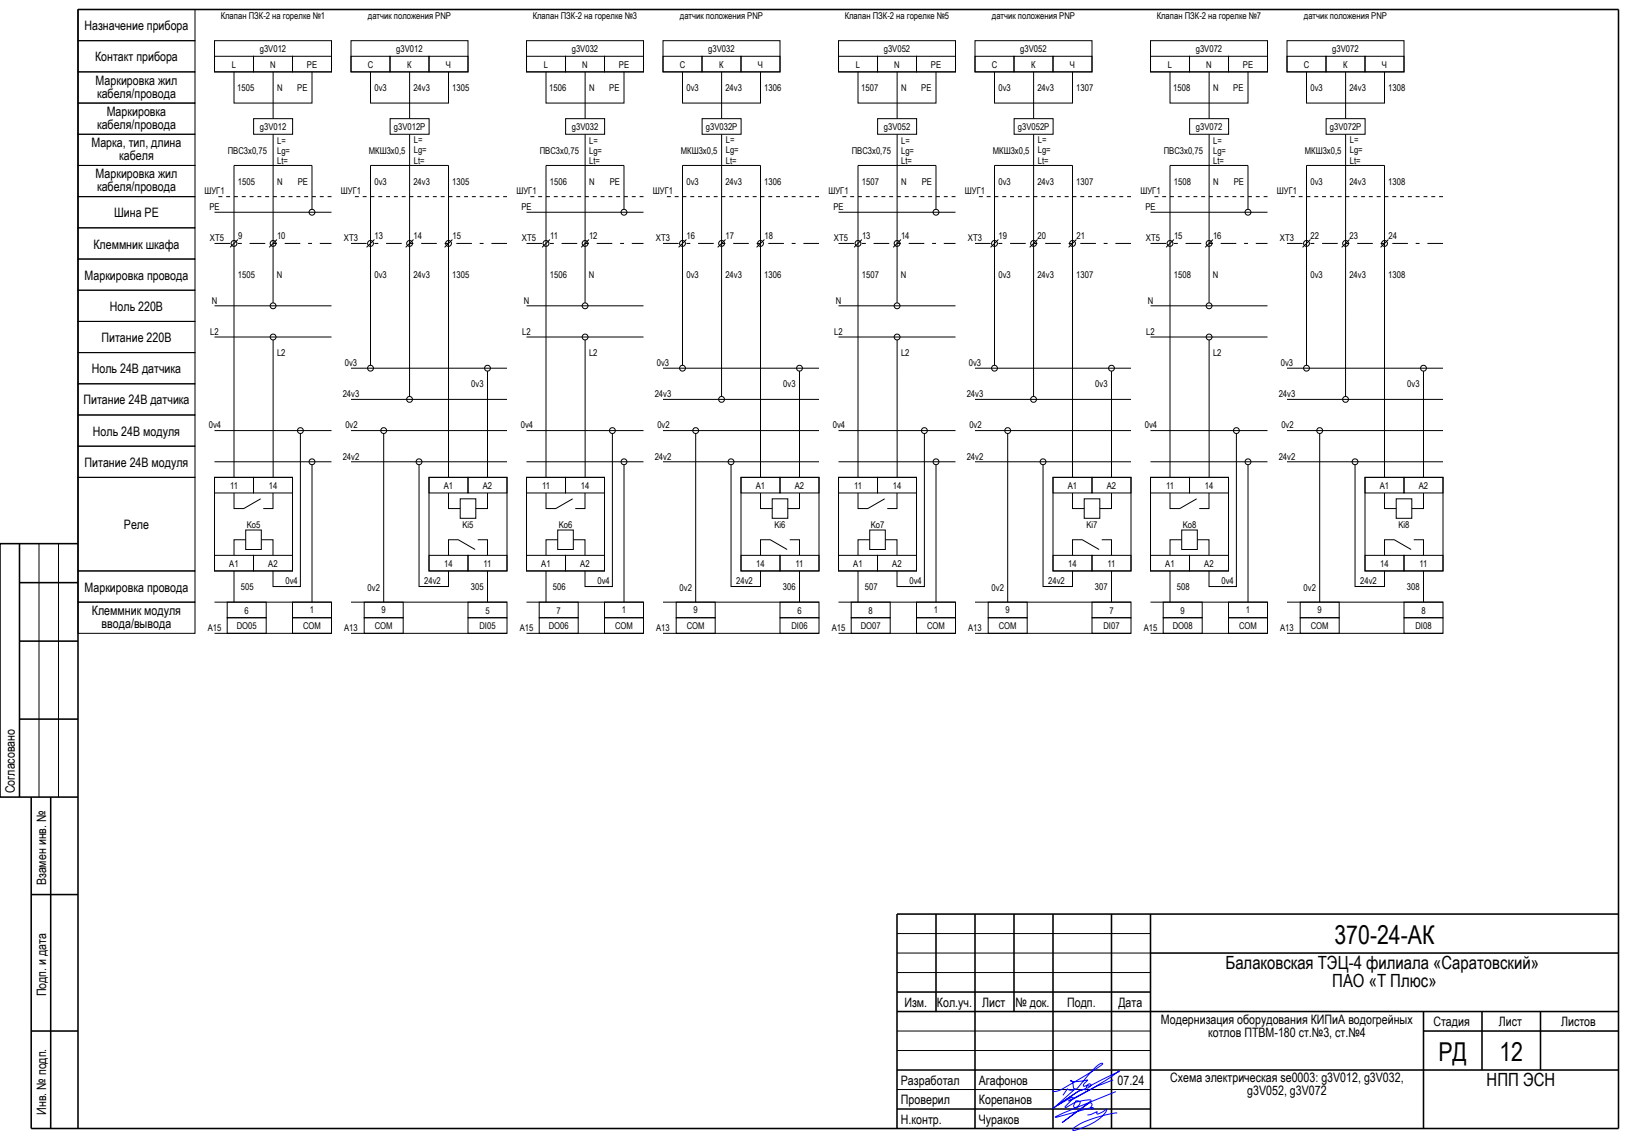
[picture p159: page 12]
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

Клапан ПЗК-2 на горелке №1

датчик положения PNP

Клапан ПЗК-2 на горелке №3

Клапан ПЗК-2 на горелке №5

Клапан ПЗК-2 на горелке №7

Контакт прибора
Маркировка жил
кабеля/провода
Маркировка
Марка, тип, длина
кабеля

Инв. № подп. Подп. и дата Взамен инв. №

Балаковская ТЭЦ-4 филиала «Саратовский» ПАО «Т Плюс»

Изм. | Кол.уч. | Лист | № док. | Подп. | Дата

Модернизация оборудования КИПиА водогрейных котлов ПТВМ-180 ст.№3, ст.№4 | Стадия | Лист | Листов

Схема электрическая se0003: g3V012, g3V032, g3V052, g3V072 | НПП ЭСН

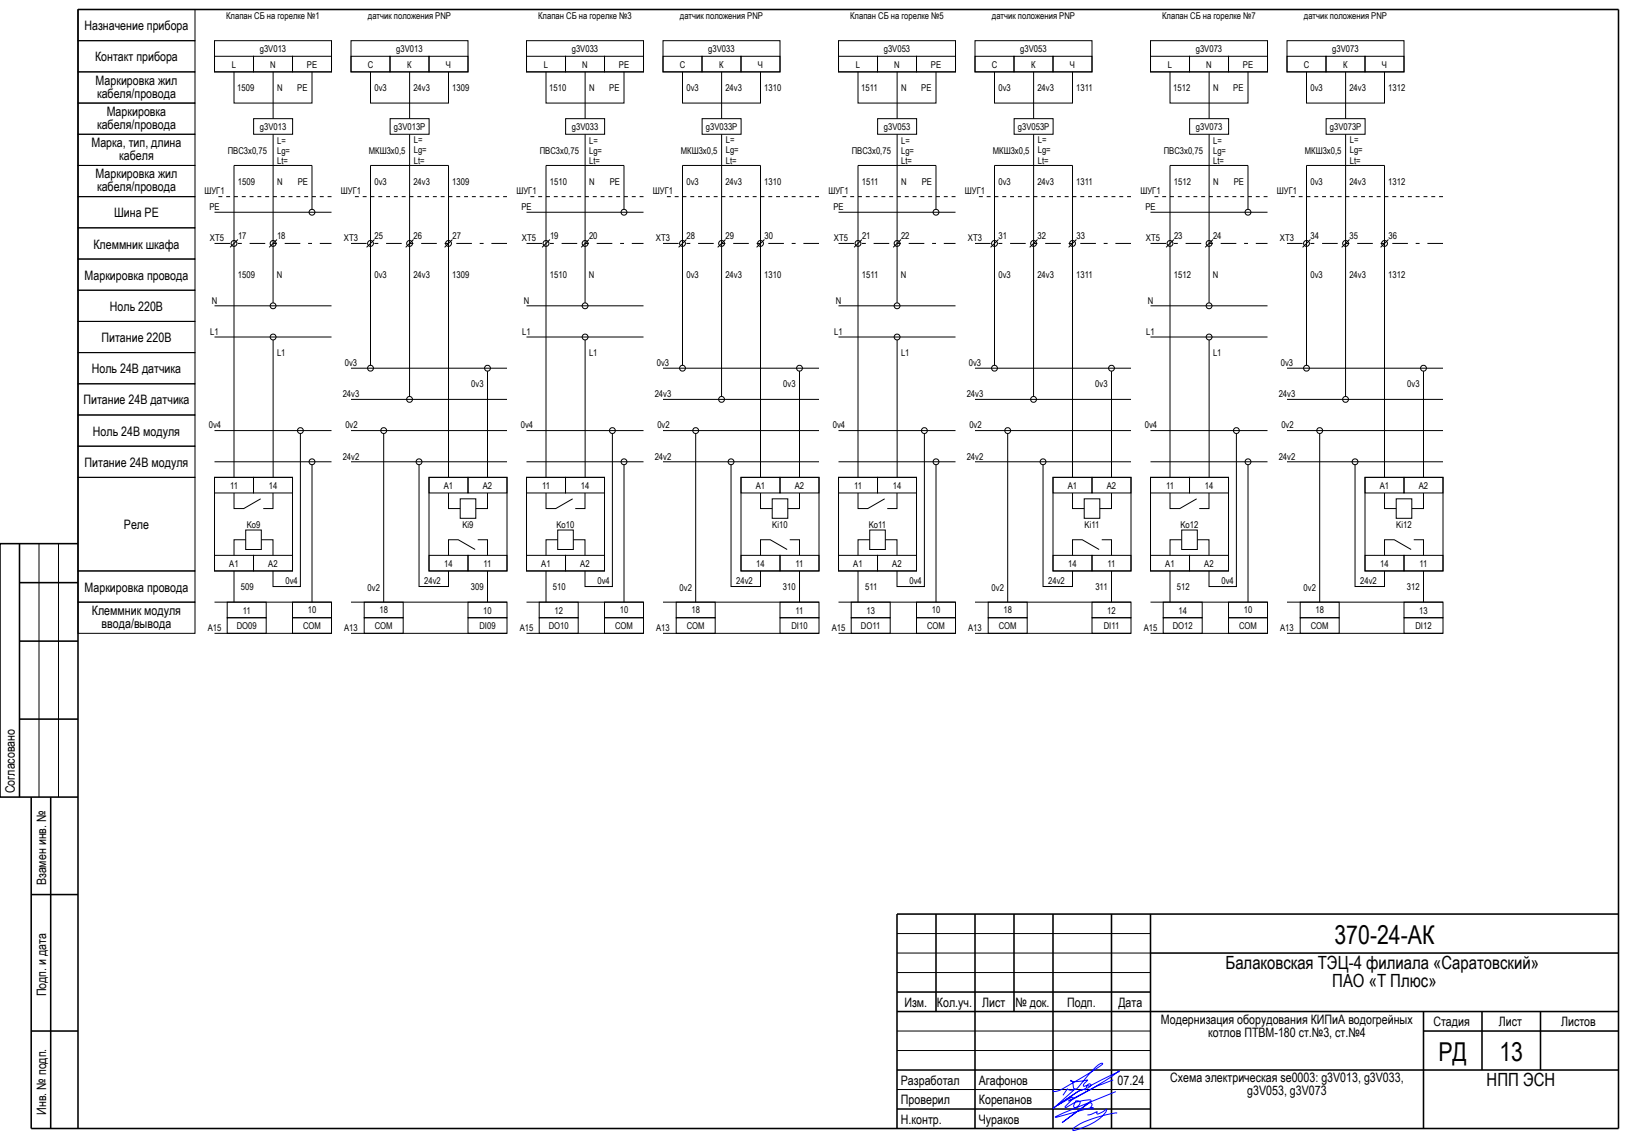
[picture p160: page 13]
Согласовано; Клеммник шкафа; Шина PE; кабеля/провода; Клеммник модуля ввода/вывода; Маркировка провода; Питание 220В; Реле; Ноль 220В; Питание 24В датчика; Ноль 24В датчика; Питание 24В модуля; Ноль 24В модуля; ШУГ1; COM; 10 COM; МКШ3х0,5; ПВС3х0,75

Клапан СБ на горелке №1

датчик положения PNP

Клапан СБ на горелке №3

Клапан СБ на горелке №5

Клапан СБ на горелке №7

Контакт прибора
Маркировка жил
кабеля/провода
Маркировка
Марка, тип, длина
кабеля

Инв. № подп. Подп. и дата Взамен инв. №

Балаковская ТЭЦ-4 филиала «Саратовский» ПАО «Т Плюс»

Изм. | Кол.уч. | Лист | № док. | Подп. | Дата

Модернизация оборудования КИПиА водогрейных котлов ПТВМ-180 ст.№3, ст.№4 | Стадия | Лист | Листов

Схема электрическая se0003: g3V013, g3V033, g3V053, g3V073 | НПП ЭСН

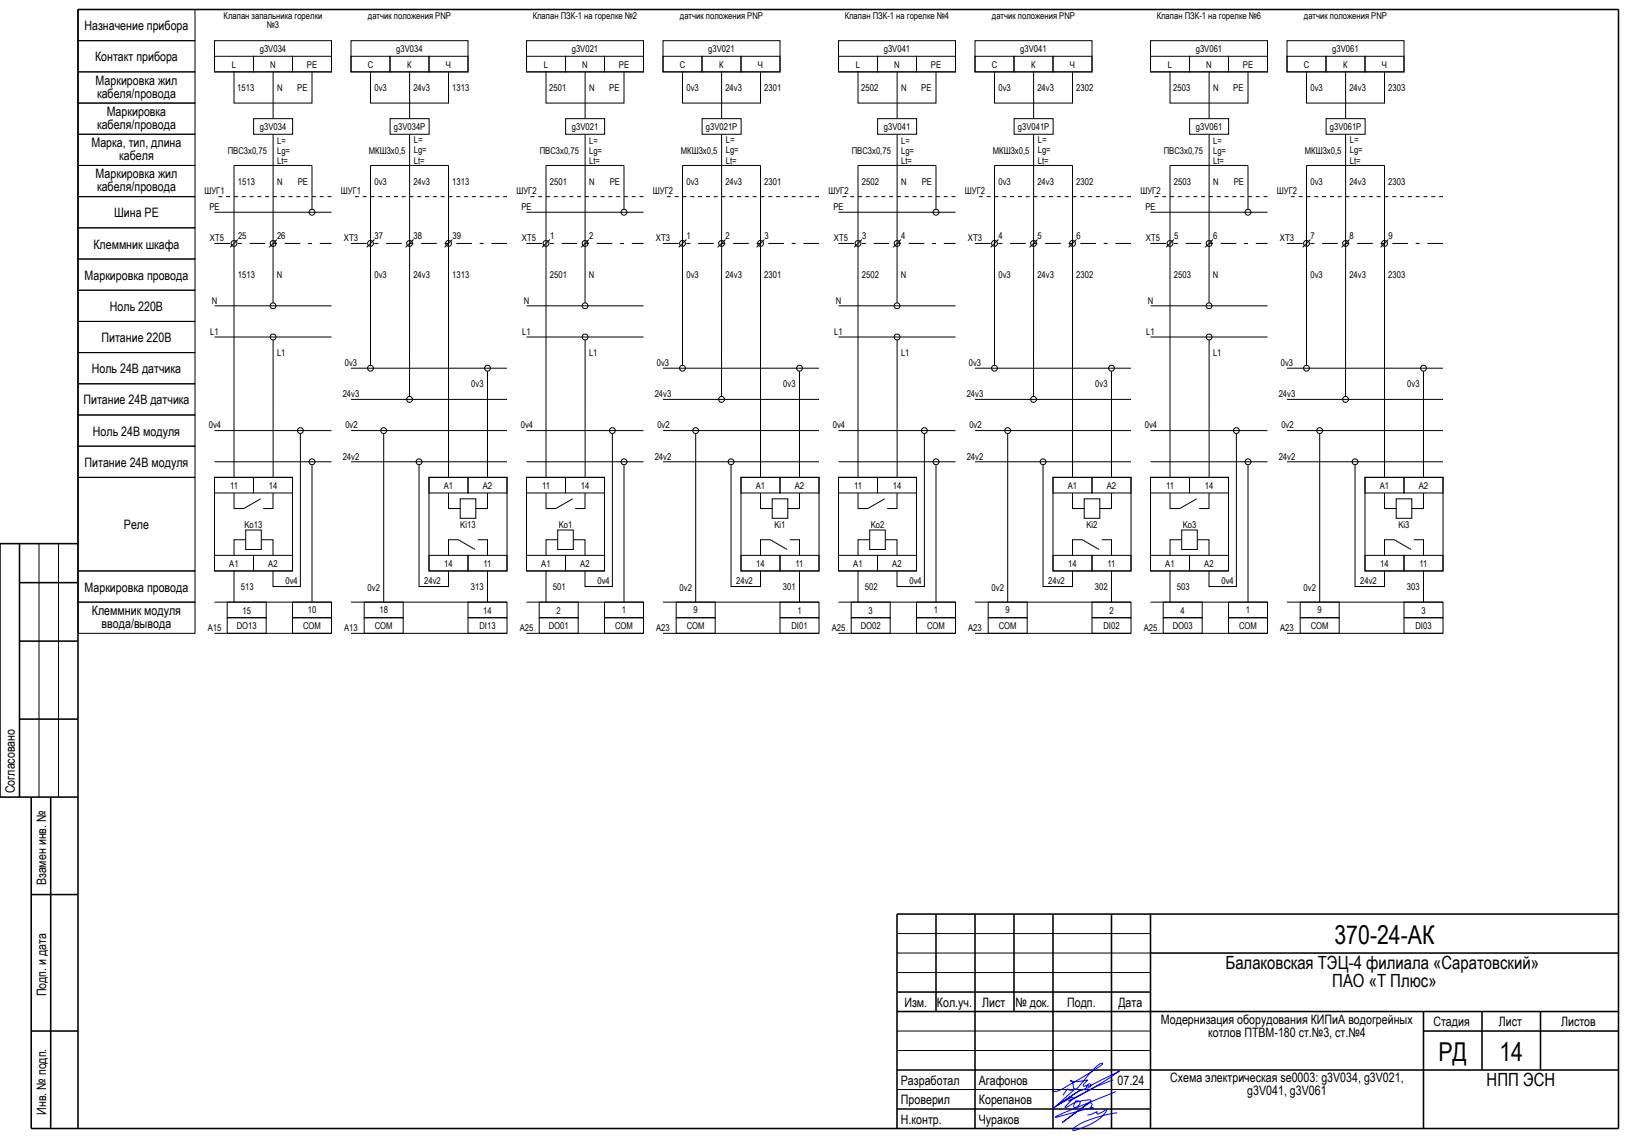
[picture p161: page 14]
Согласовано; Клеммник шкафа; Шина PE; кабеля/провода; Клеммник модуля ввода/вывода; Маркировка провода; Питание 220В; Реле; Ноль 220В; Питание 24В датчика; Ноль 24В датчика; Питание 24В модуля; Ноль 24В модуля; ШУГ1; COM; 10 COM; ШУГ2; 1 COM; МКШ3х0,5; ПВС3х0,75

Клапан запальника горелки

датчик положения PNP

Клапан ПЗК-1 на горелке №2

Клапан ПЗК-1 на горелке №4

Клапан ПЗК-1 на горелке №6

Контакт прибора
Маркировка жил
кабеля/провода
Маркировка
Марка, тип, длина
кабеля

Инв. № подп. Подп. и дата Взамен инв. №

Балаковская ТЭЦ-4 филиала «Саратовский» ПАО «Т Плюс»

Изм. | Кол.уч. | Лист | № док. | Подп. | Дата

Модернизация оборудования КИПиА водогрейных котлов ПТВМ-180 ст.№3, ст.№4 | Стадия | Лист | Листов

Схема электрическая se0003: g3V034, g3V021, g3V041, g3V061 | НПП ЭСН

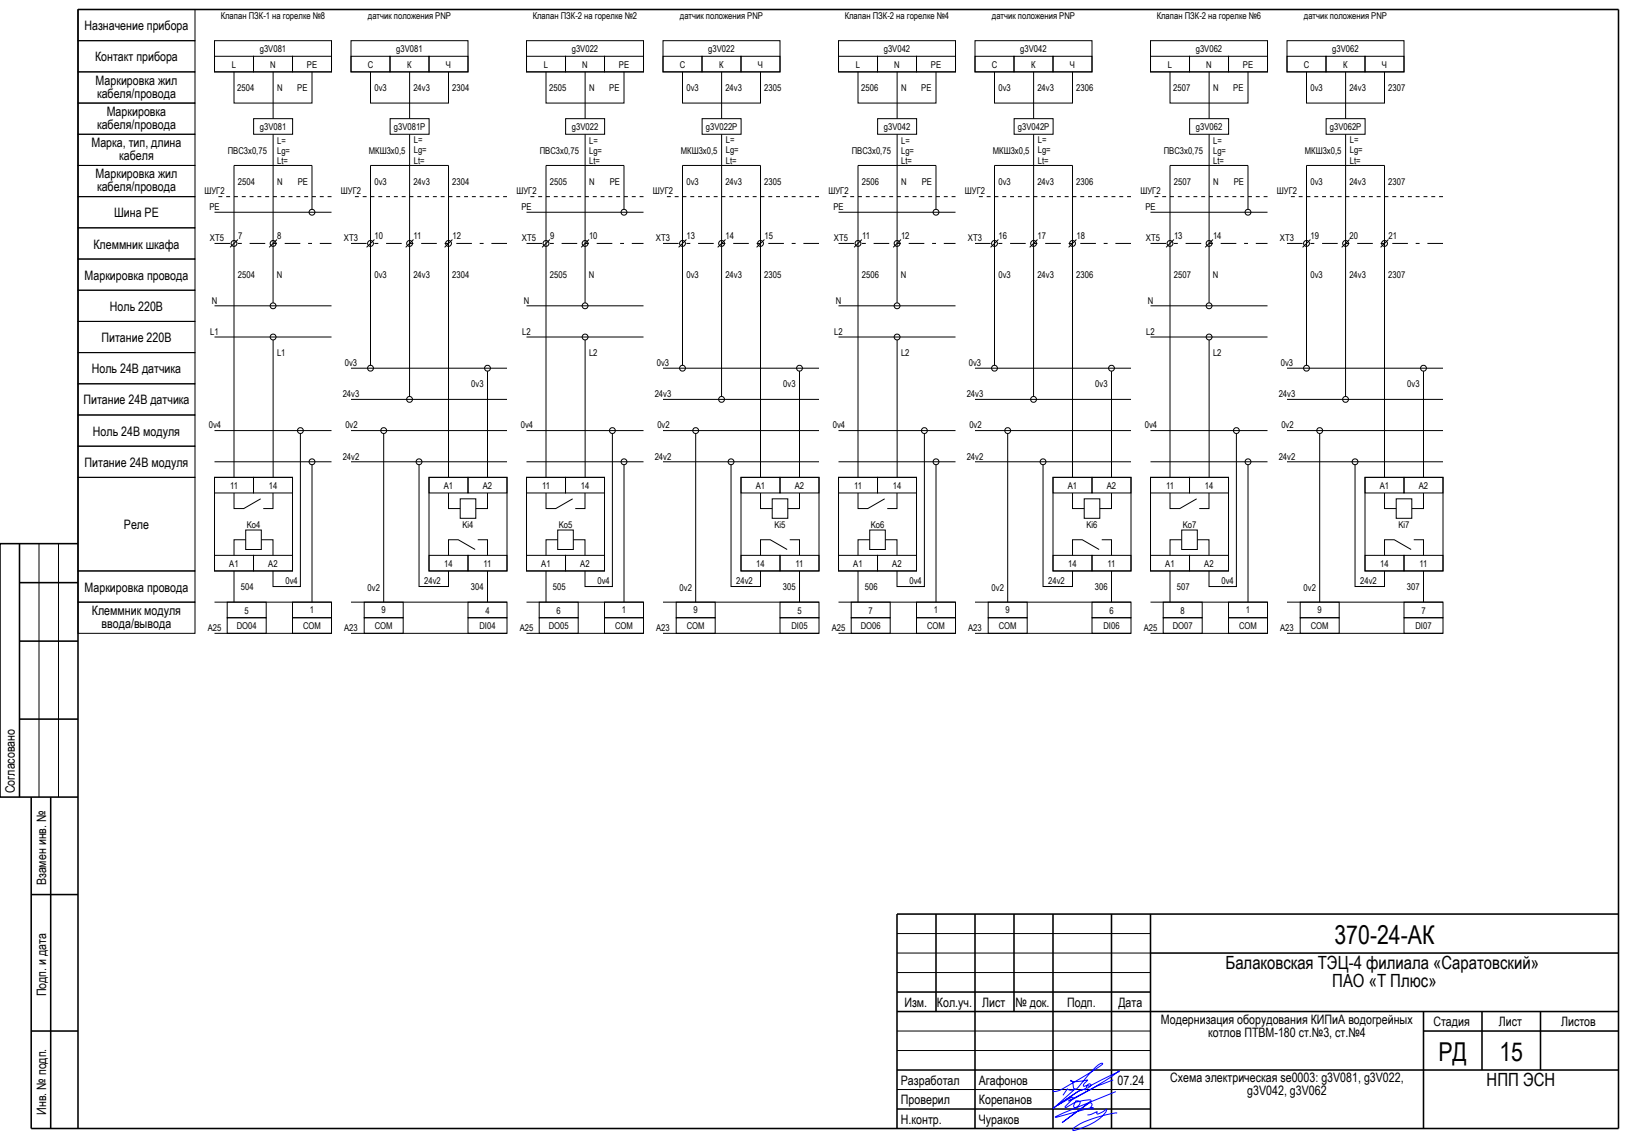
[picture p162: page 15]
Согласовано; Клеммник шкафа; Шина PE; кабеля/провода; Клеммник модуля ввода/вывода; Маркировка провода; Питание 220В; Реле; Ноль 220В; Питание 24В датчика; Ноль 24В датчика; Питание 24В модуля; Ноль 24В модуля; ШУГ2; COM; 1 COM; МКШ3х0,5; ПВС3х0,75

Клапан ПЗК-1 на горелке №8

датчик положения PNP

Клапан ПЗК-2 на горелке №2

Клапан ПЗК-2 на горелке №4

Клапан ПЗК-2 на горелке №6

Контакт прибора
Маркировка жил
кабеля/провода
Маркировка
Марка, тип, длина
кабеля

Инв. № подп. Подп. и дата Взамен инв. №

Балаковская ТЭЦ-4 филиала «Саратовский» ПАО «Т Плюс»

Изм. | Кол.уч. | Лист | № док. | Подп. | Дата

Модернизация оборудования КИПиА водогрейных котлов ПТВМ-180 ст.№3, ст.№4 | Стадия | Лист | Листов

Схема электрическая se0003: g3V081, g3V022, g3V042, g3V062 | НПП ЭСН

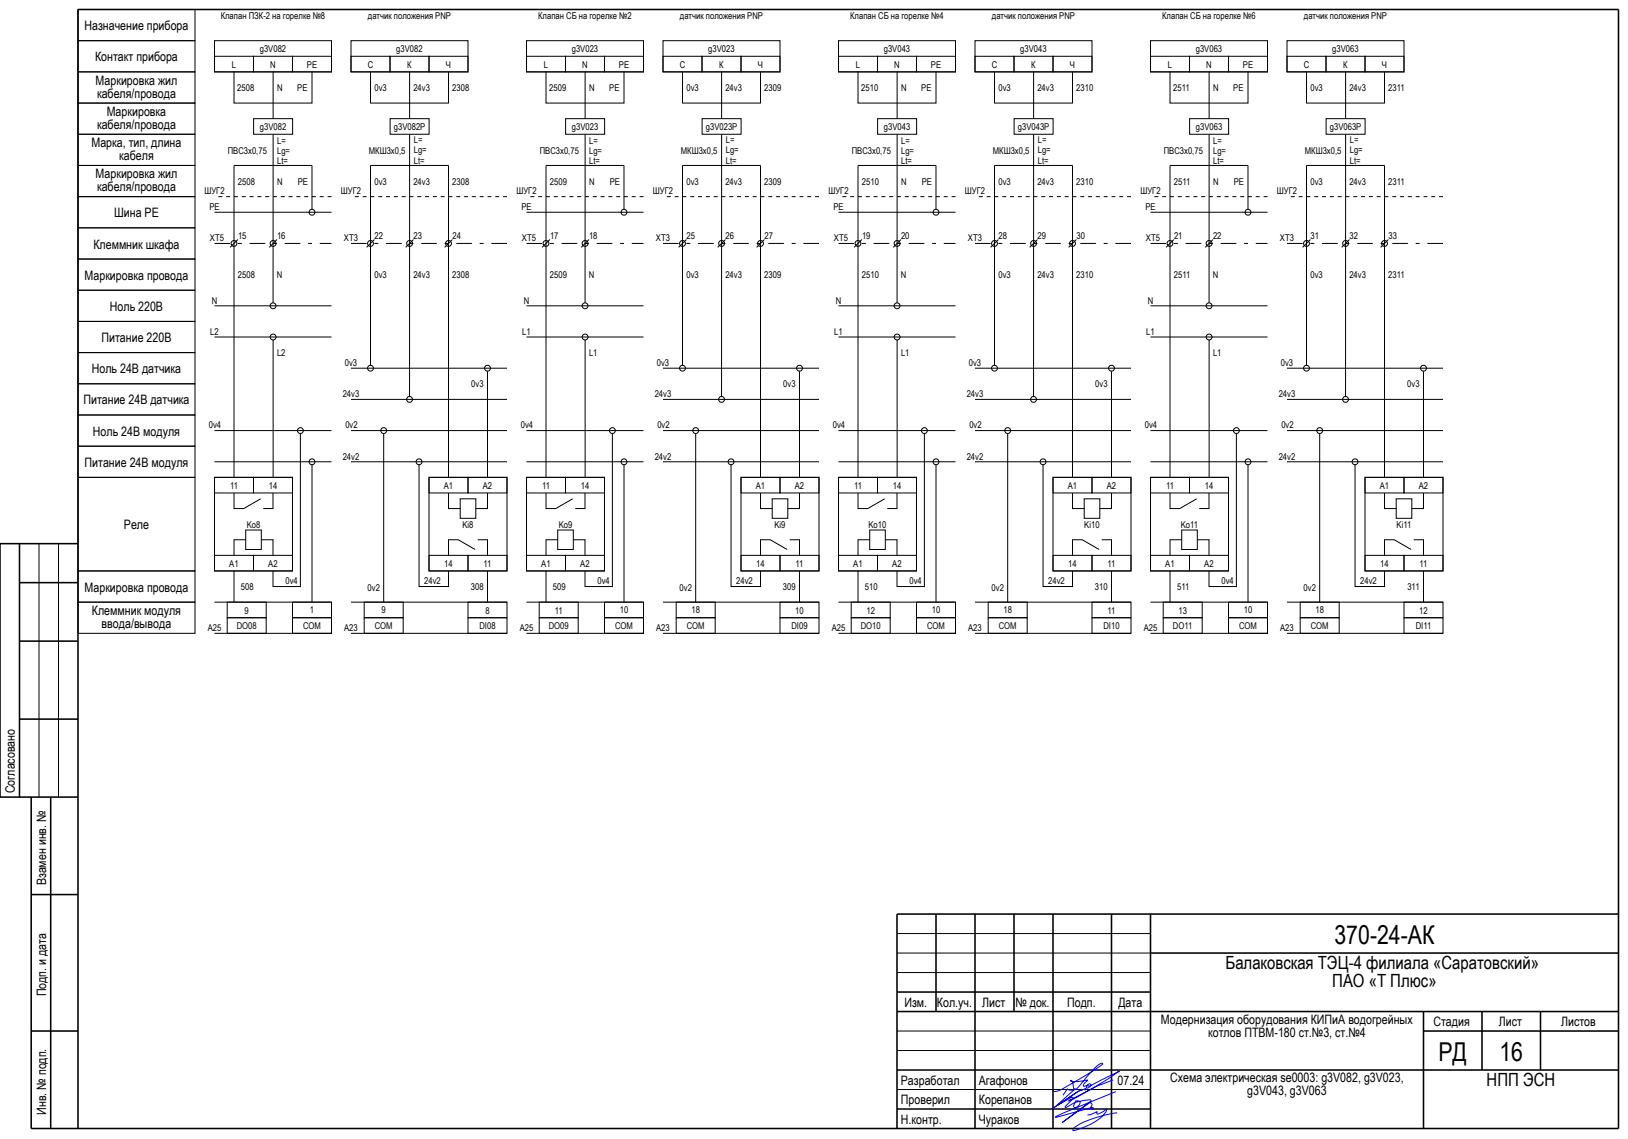
[picture p163: page 16]
Согласовано; Клеммник шкафа; Шина PE; кабеля/провода; Клеммник модуля ввода/вывода; Маркировка провода; Питание 220В; Реле; Ноль 220В; Питание 24В датчика; Ноль 24В датчика; Питание 24В модуля; Ноль 24В модуля; ШУГ2; COM; 1 COM; 10 COM; МКШ3х0,5; ПВС3х0,75

Клапан ПЗК-2 на горелке №8

датчик положения PNP

Клапан СБ на горелке №2

Клапан СБ на горелке №4

Клапан СБ на горелке №6

Контакт прибора
Маркировка жил
кабеля/провода
Маркировка
Марка, тип, длина
кабеля

Инв. № подп. Подп. и дата Взамен инв. №

Балаковская ТЭЦ-4 филиала «Саратовский» ПАО «Т Плюс»

Изм. | Кол.уч. | Лист | № док. | Подп. | Дата

Модернизация оборудования КИПиА водогрейных котлов ПТВМ-180 ст.№3, ст.№4 | Стадия | Лист | Листов

Схема электрическая se0003: g3V082, g3V023, g3V043, g3V063 | НПП ЭСН

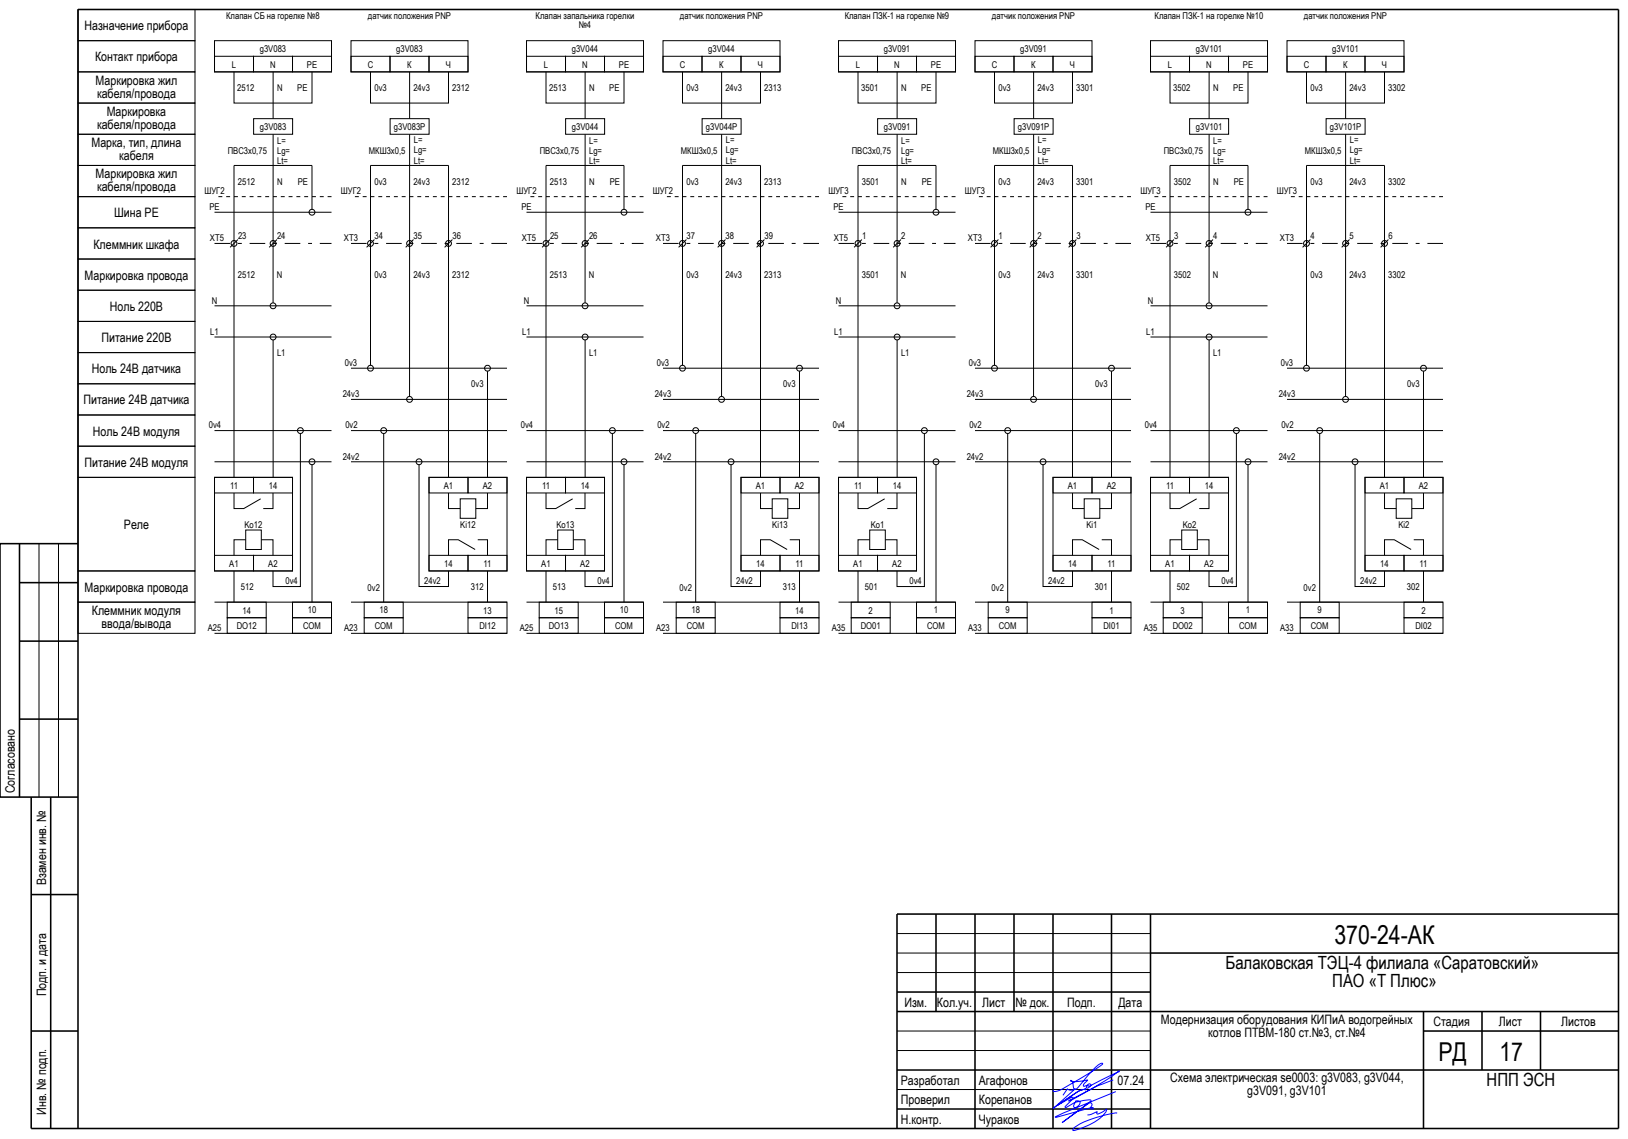
[picture p164: page 17]
Согласовано; Клеммник шкафа; Шина PE; кабеля/провода; Клеммник модуля ввода/вывода; Маркировка провода; Питание 220В; Реле; Ноль 220В; Питание 24В датчика; Ноль 24В датчика; Питание 24В модуля; Ноль 24В модуля; ШУГ2; COM; 10 COM; ШУГ3; 1 COM; МКШ3х0,5; ПВС3х0,75

Клапан СБ на горелке №8

датчик положения PNP

Клапан запальника горелки

Клапан ПЗК-1 на горелке №9

Клапан ПЗК-1 на горелке №10

Контакт прибора
Маркировка жил
кабеля/провода
Маркировка
Марка, тип, длина
кабеля

Инв. № подп. Подп. и дата Взамен инв. №

Балаковская ТЭЦ-4 филиала «Саратовский» ПАО «Т Плюс»

Изм. | Кол.уч. | Лист | № док. | Подп. | Дата

Модернизация оборудования КИПиА водогрейных котлов ПТВМ-180 ст.№3, ст.№4 | Стадия | Лист | Листов

Схема электрическая se0003: g3V083, g3V044, g3V091, g3V101 | НПП ЭСН

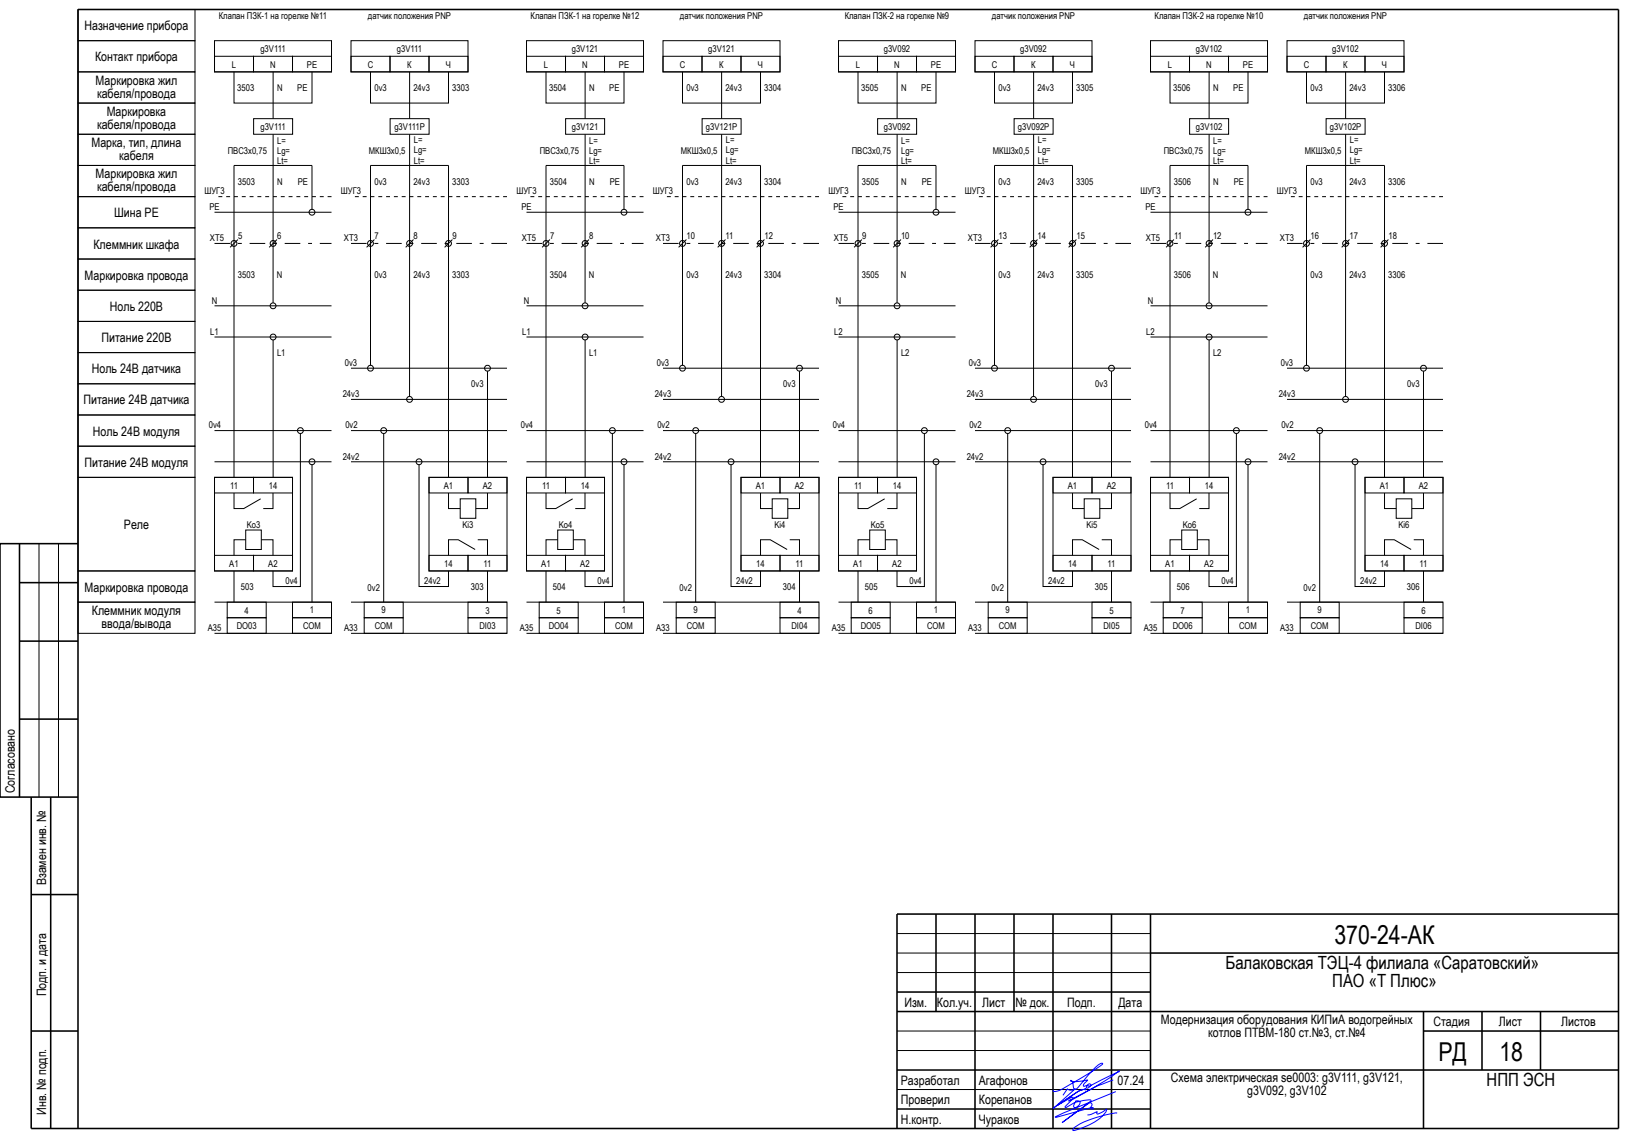
[picture p165: page 18]
Согласовано; Клеммник шкафа; Шина PE; кабеля/провода; Клеммник модуля ввода/вывода; Маркировка провода; Питание 220В; Реле; Ноль 220В; Питание 24В датчика; Ноль 24В датчика; Питание 24В модуля; Ноль 24В модуля; ШУГ3; COM; 1 COM; МКШ3х0,5; ПВС3х0,75

Клапан ПЗК-1 на горелке №11

датчик положения PNP

Клапан ПЗК-1 на горелке №12

Клапан ПЗК-2 на горелке №9

Клапан ПЗК-2 на горелке №10

Контакт прибора
Маркировка жил
кабеля/провода
Маркировка
Марка, тип, длина
кабеля

Инв. № подп. Подп. и дата Взамен инв. №

Балаковская ТЭЦ-4 филиала «Саратовский» ПАО «Т Плюс»

Изм. | Кол.уч. | Лист | № док. | Подп. | Дата

Модернизация оборудования КИПиА водогрейных котлов ПТВМ-180 ст.№3, ст.№4 | Стадия | Лист | Листов

Схема электрическая se0003: g3V111, g3V121, g3V092, g3V102 | НПП ЭСН

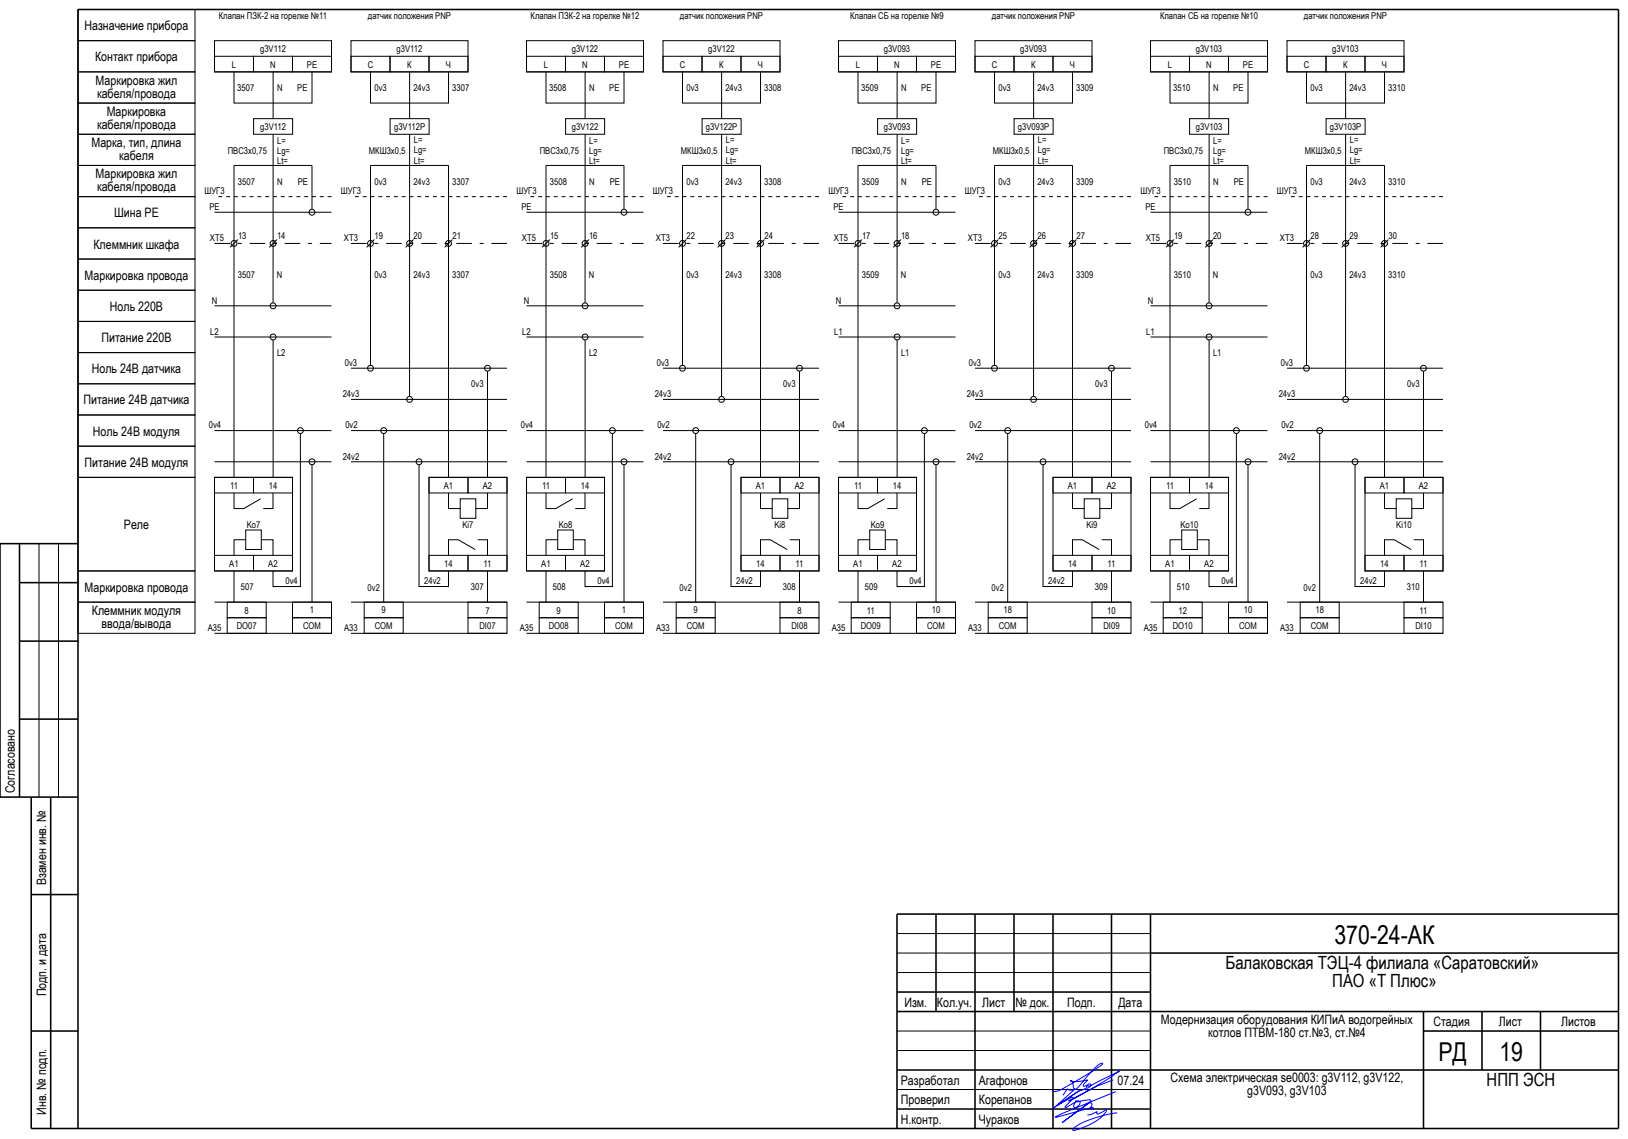
[picture p166: page 19]
Согласовано; Клеммник шкафа; Шина PE; кабеля/провода; Клеммник модуля ввода/вывода; Маркировка провода; Питание 220В; Реле; Ноль 220В; Питание 24В датчика; Ноль 24В датчика; Питание 24В модуля; Ноль 24В модуля; ШУГ3; COM; 1 COM; 10 COM; МКШ3х0,5; ПВС3х0,75

Клапан ПЗК-2 на горелке №11

датчик положения PNP

Клапан ПЗК-2 на горелке №12

Клапан СБ на горелке №9

Клапан СБ на горелке №10

Контакт прибора
Маркировка жил
кабеля/провода
Маркировка
Марка, тип, длина
кабеля

Инв. № подп. Подп. и дата Взамен инв. №

Балаковская ТЭЦ-4 филиала «Саратовский» ПАО «Т Плюс»

Изм. | Кол.уч. | Лист | № док. | Подп. | Дата

Модернизация оборудования КИПиА водогрейных котлов ПТВМ-180 ст.№3, ст.№4 | Стадия | Лист | Листов

Схема электрическая se0003: g3V112, g3V122, g3V093, g3V103 | НПП ЭСН

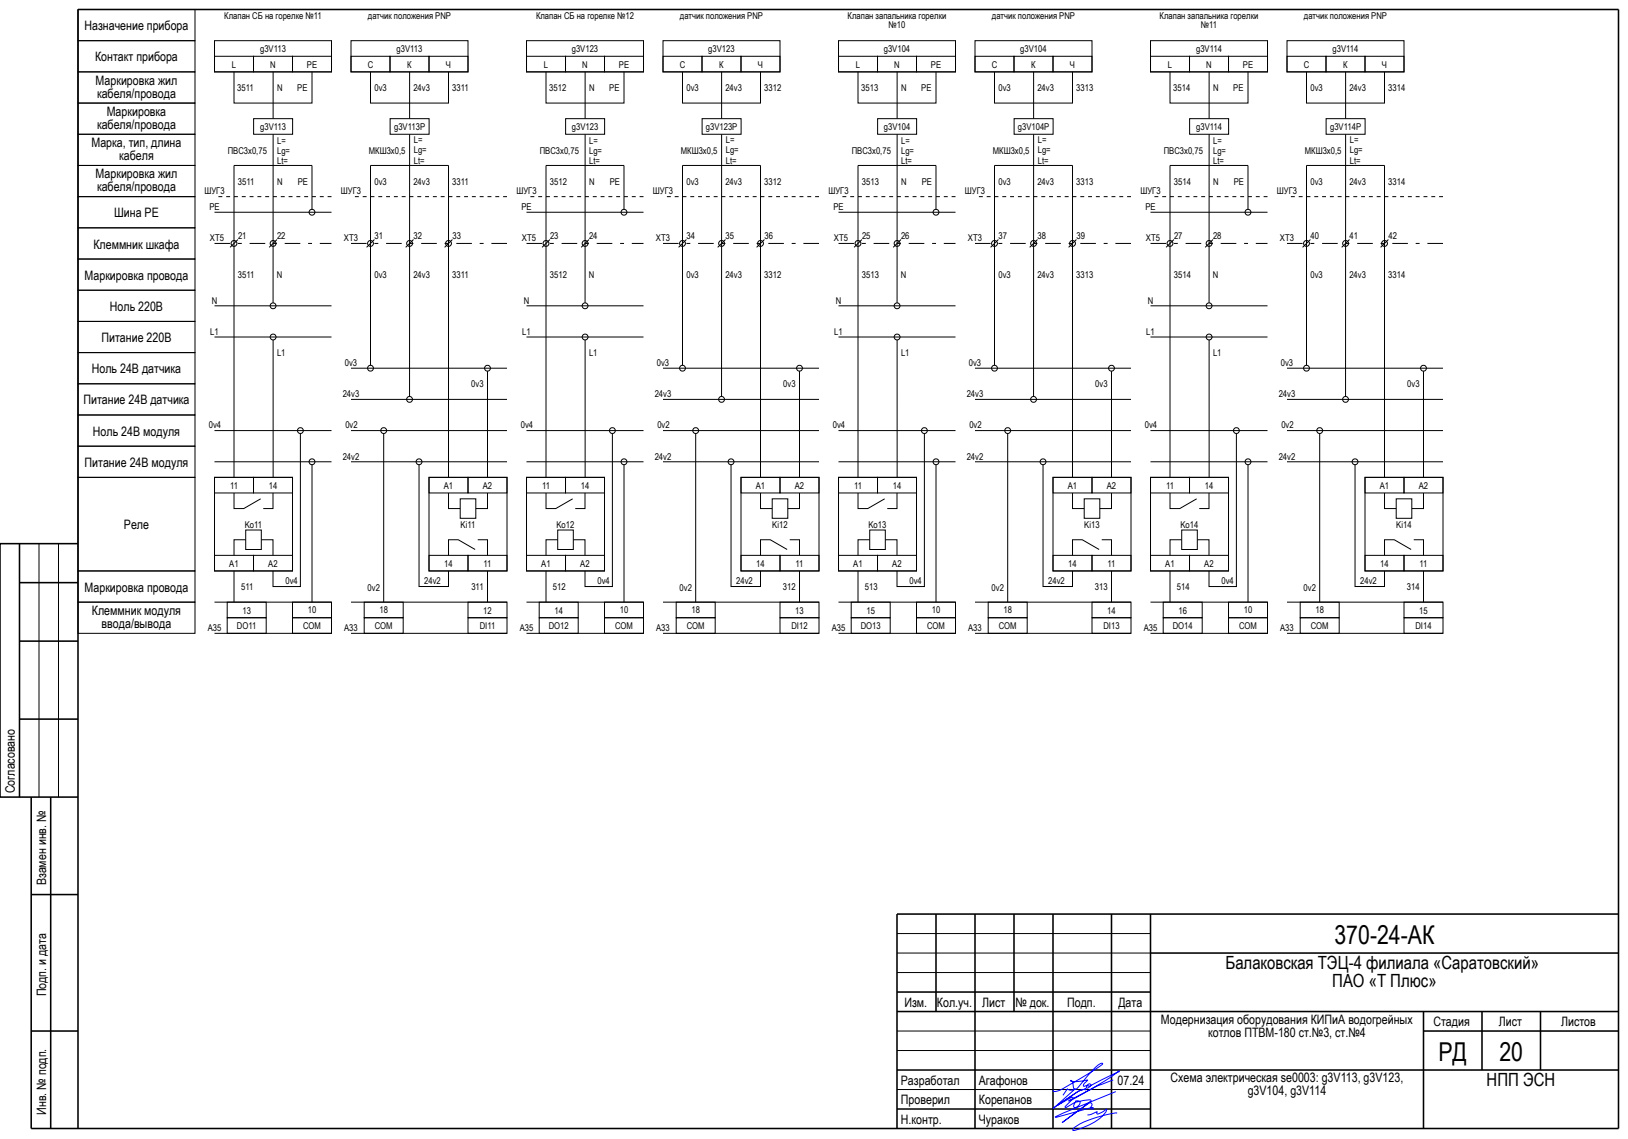
[picture p167: page 20]
Согласовано; Клеммник шкафа; Шина PE; кабеля/провода; Клеммник модуля ввода/вывода; Маркировка провода; Питание 220В; Реле; Ноль 220В; Питание 24В датчика; Ноль 24В датчика; Питание 24В модуля; Ноль 24В модуля; ШУГ3; COM; 10 COM; МКШ3х0,5; ПВС3х0,75

Клапан СБ на горелке №11

датчик положения PNP

Клапан СБ на горелке №12

Клапан запальника горелки

Контакт прибора
Маркировка жил
кабеля/провода
Маркировка
Марка, тип, длина
кабеля

Инв. № подп. Подп. и дата Взамен инв. №

Балаковская ТЭЦ-4 филиала «Саратовский» ПАО «Т Плюс»

Изм. | Кол.уч. | Лист | № док. | Подп. | Дата

Модернизация оборудования КИПиА водогрейных котлов ПТВМ-180 ст.№3, ст.№4 | Стадия | Лист | Листов

Схема электрическая se0003: g3V113, g3V123, g3V104, g3V114 | НПП ЭСН

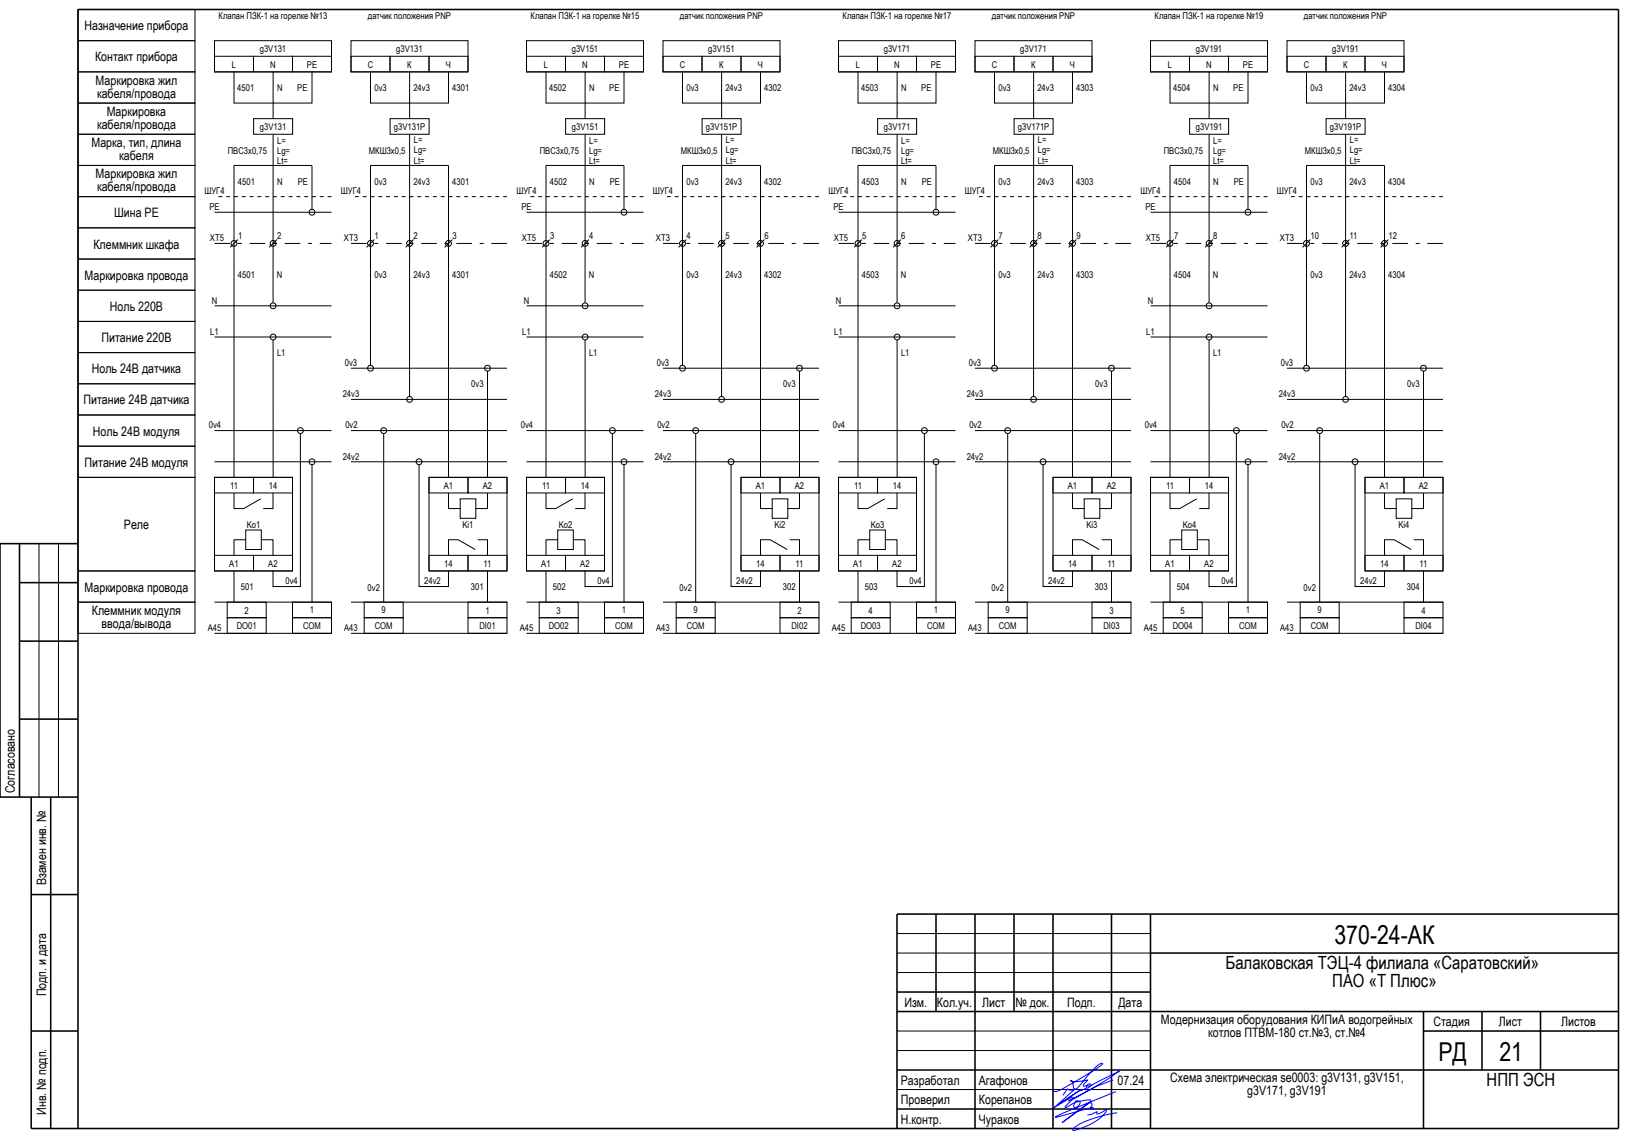
[picture p168: page 21]
Согласовано; Клеммник шкафа; Шина PE; кабеля/провода; Клеммник модуля ввода/вывода; Маркировка провода; Питание 220В; Реле; Ноль 220В; Питание 24В датчика; Ноль 24В датчика; Питание 24В модуля; Ноль 24В модуля; ШУГ4; COM; 1 COM; МКШ3х0,5; ПВС3х0,75

Клапан ПЗК-1 на горелке №13

датчик положения PNP

Клапан ПЗК-1 на горелке №15

Клапан ПЗК-1 на горелке №17

Клапан ПЗК-1 на горелке №19

Контакт прибора
Маркировка жил
кабеля/провода
Маркировка
Марка, тип, длина
кабеля

Инв. № подп. Подп. и дата Взамен инв. №

Балаковская ТЭЦ-4 филиала «Саратовский» ПАО «Т Плюс»

Изм. | Кол.уч. | Лист | № док. | Подп. | Дата

Модернизация оборудования КИПиА водогрейных котлов ПТВМ-180 ст.№3, ст.№4 | Стадия | Лист | Листов

Схема электрическая se0003: g3V131, g3V151, g3V171, g3V191 | НПП ЭСН

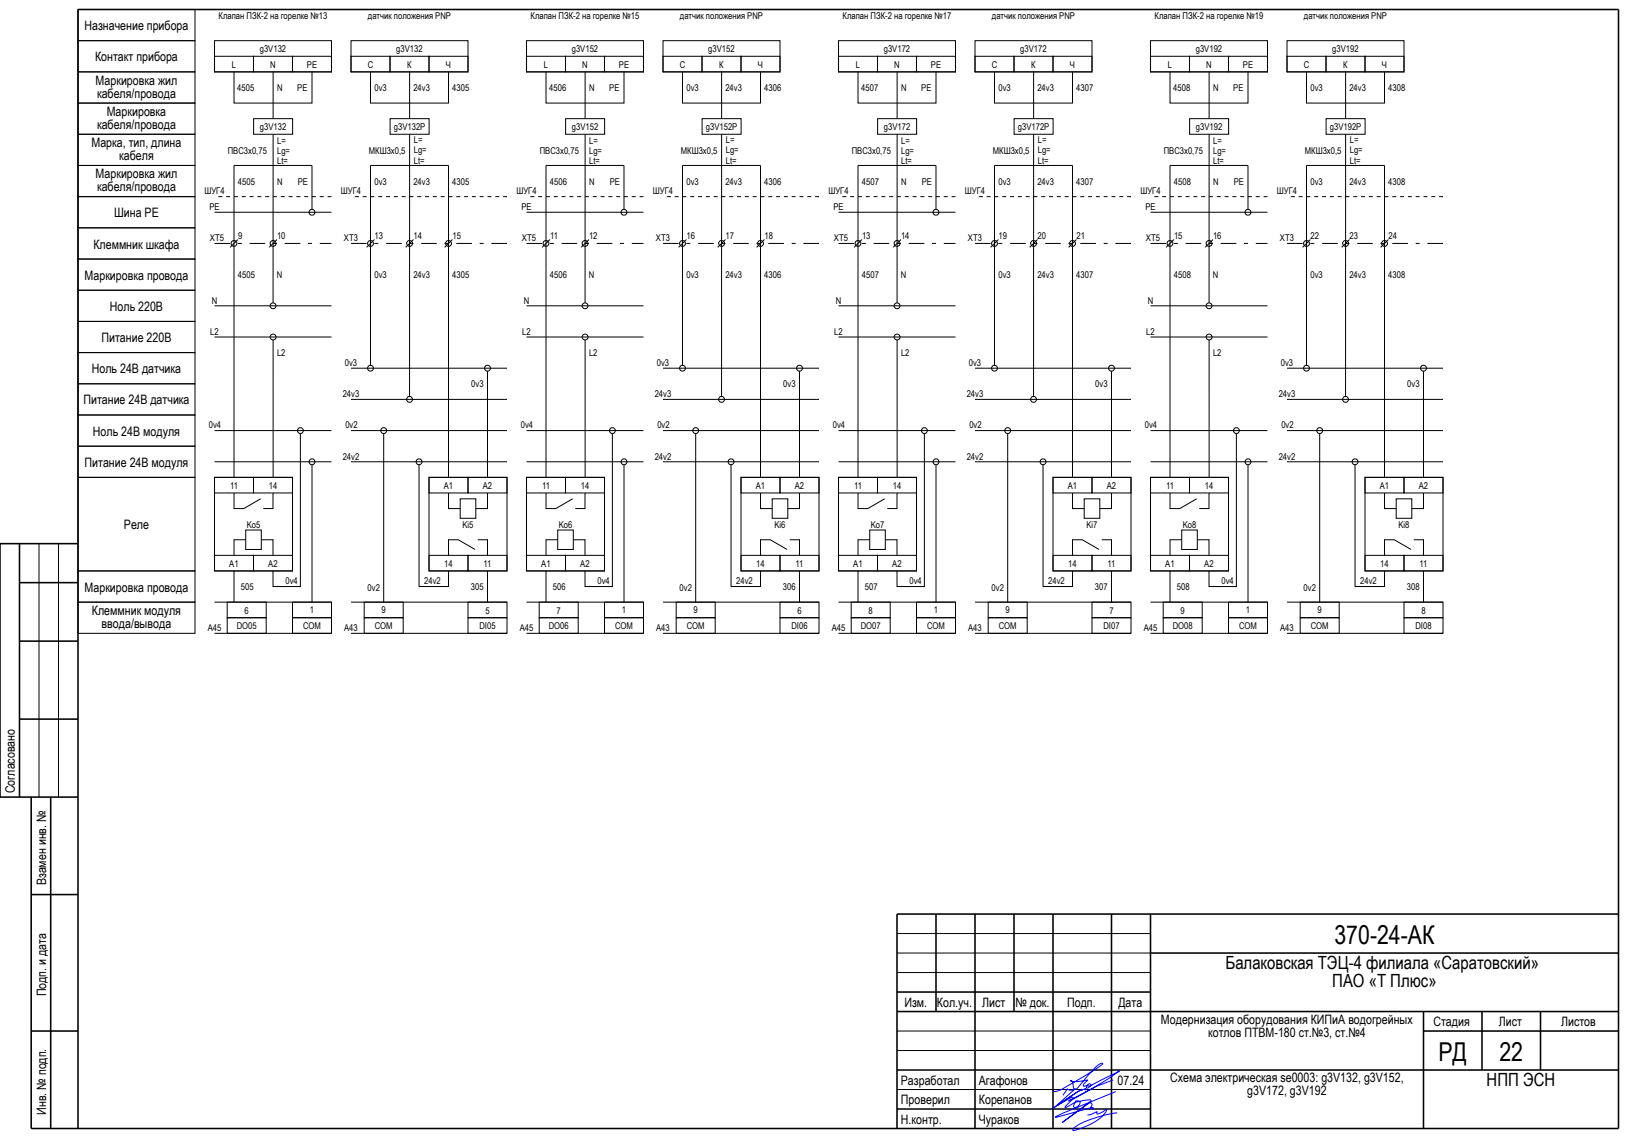
[picture p169: page 22]
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

Клапан ПЗК-2 на горелке №13

датчик положения PNP

Клапан ПЗК-2 на горелке №15

Клапан ПЗК-2 на горелке №17

Клапан ПЗК-2 на горелке №19

Контакт прибора
Маркировка жил
кабеля/провода
Маркировка
Марка, тип, длина
кабеля

Инв. № подп. Подп. и дата Взамен инв. №

Балаковская ТЭЦ-4 филиала «Саратовский» ПАО «Т Плюс»

Изм. | Кол.уч. | Лист | № док. | Подп. | Дата

Модернизация оборудования КИПиА водогрейных котлов ПТВМ-180 ст.№3, ст.№4 | Стадия | Лист | Листов

Схема электрическая se0003: g3V132, g3V152, g3V172, g3V192 | НПП ЭСН

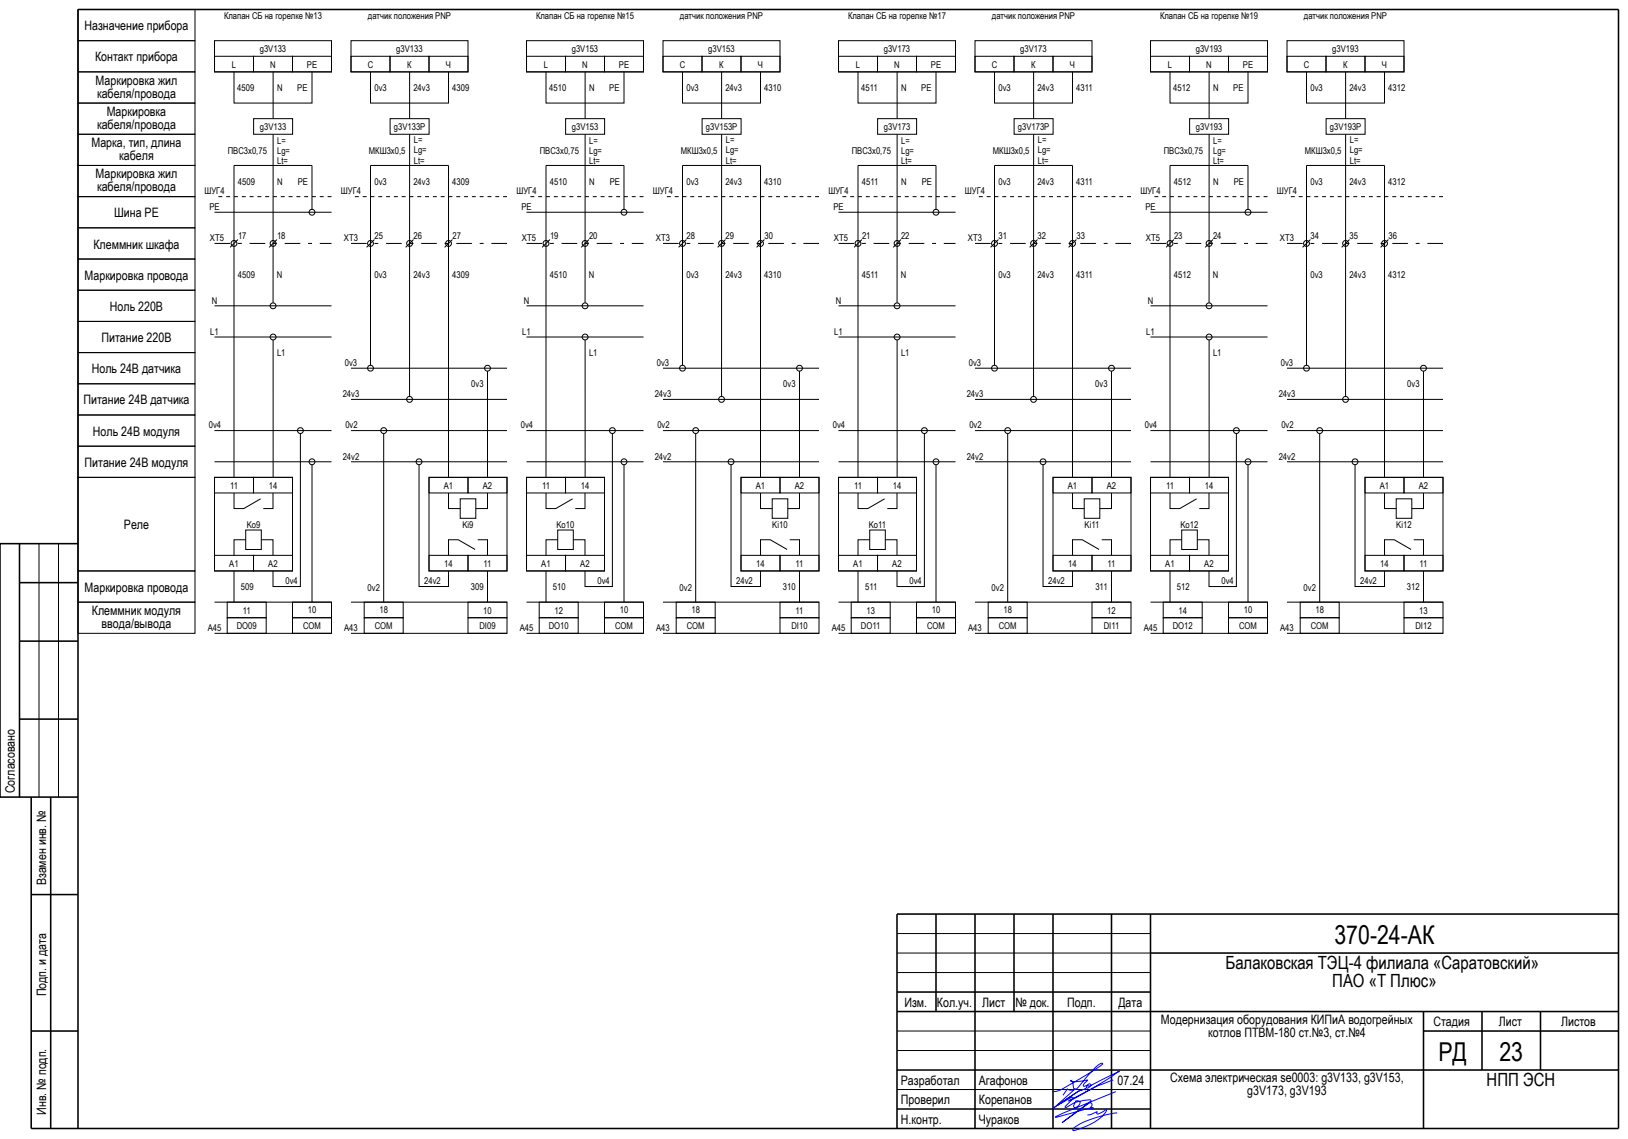
[picture p170: page 23]
Согласовано; Клеммник шкафа; Шина PE; кабеля/провода; Клеммник модуля ввода/вывода; Маркировка провода; Питание 220В; Реле; Ноль 220В; Питание 24В датчика; Ноль 24В датчика; Питание 24В модуля; Ноль 24В модуля; ШУГ4; COM; 10 COM; МКШ3х0,5; ПВС3х0,75

Клапан СБ на горелке №13

датчик положения PNP

Клапан СБ на горелке №15

Клапан СБ на горелке №17

Клапан СБ на горелке №19

Контакт прибора
Маркировка жил
кабеля/провода
Маркировка
Марка, тип, длина
кабеля

Инв. № подп. Подп. и дата Взамен инв. №

Балаковская ТЭЦ-4 филиала «Саратовский» ПАО «Т Плюс»

Изм. | Кол.уч. | Лист | № док. | Подп. | Дата

Модернизация оборудования КИПиА водогрейных котлов ПТВМ-180 ст.№3, ст.№4 | Стадия | Лист | Листов

Схема электрическая se0003: g3V133, g3V153, g3V173, g3V193 | НПП ЭСН

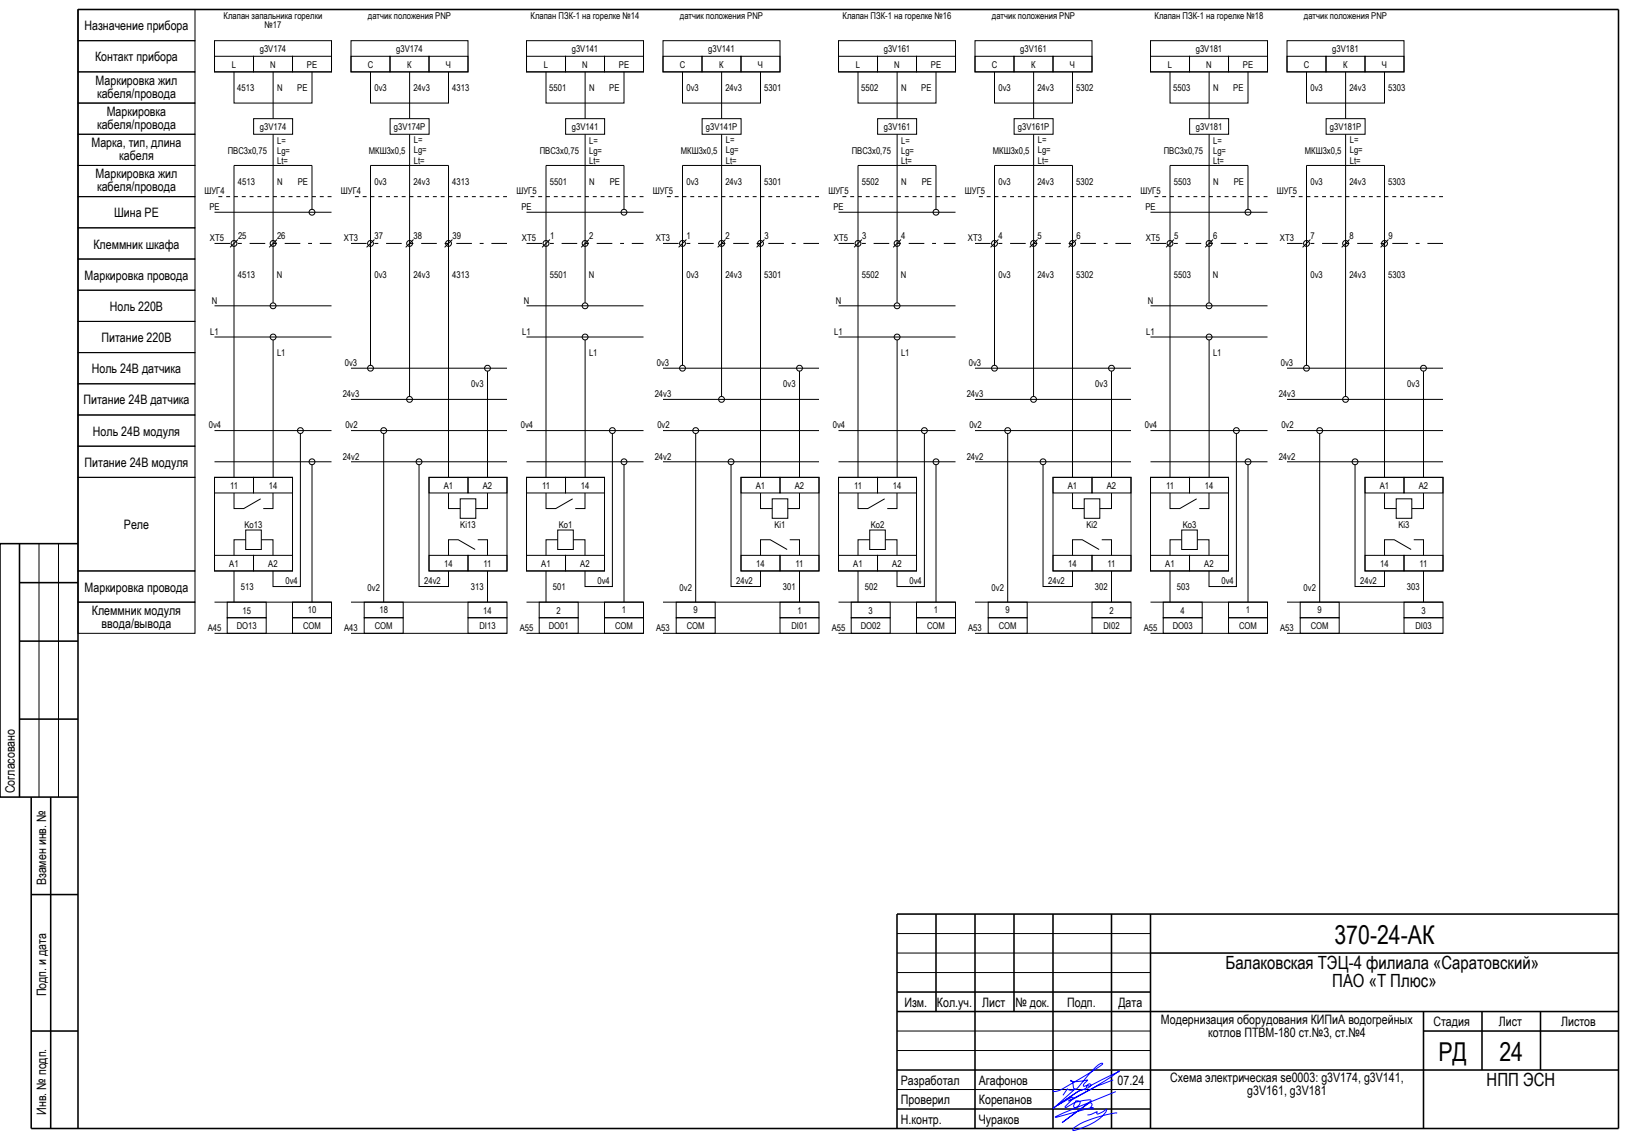
[picture p171: page 24]
Согласовано; Клеммник шкафа; Шина PE; кабеля/провода; Клеммник модуля ввода/вывода; Маркировка провода; Питание 220В; Реле; Ноль 220В; Питание 24В датчика; Ноль 24В датчика; Питание 24В модуля; Ноль 24В модуля; ШУГ4; COM; 10 COM; ШУГ5; 1 COM; МКШ3х0,5; ПВС3х0,75

Клапан запальника горелки

датчик положения PNP

Клапан ПЗК-1 на горелке №14

Клапан ПЗК-1 на горелке №16

Клапан ПЗК-1 на горелке №18

Контакт прибора
Маркировка жил
кабеля/провода
Маркировка
Марка, тип, длина
кабеля

Инв. № подп. Подп. и дата Взамен инв. №

Балаковская ТЭЦ-4 филиала «Саратовский» ПАО «Т Плюс»

Изм. | Кол.уч. | Лист | № док. | Подп. | Дата

Модернизация оборудования КИПиА водогрейных котлов ПТВМ-180 ст.№3, ст.№4 | Стадия | Лист | Листов

Схема электрическая se0003: g3V174, g3V141, g3V161, g3V181 | НПП ЭСН

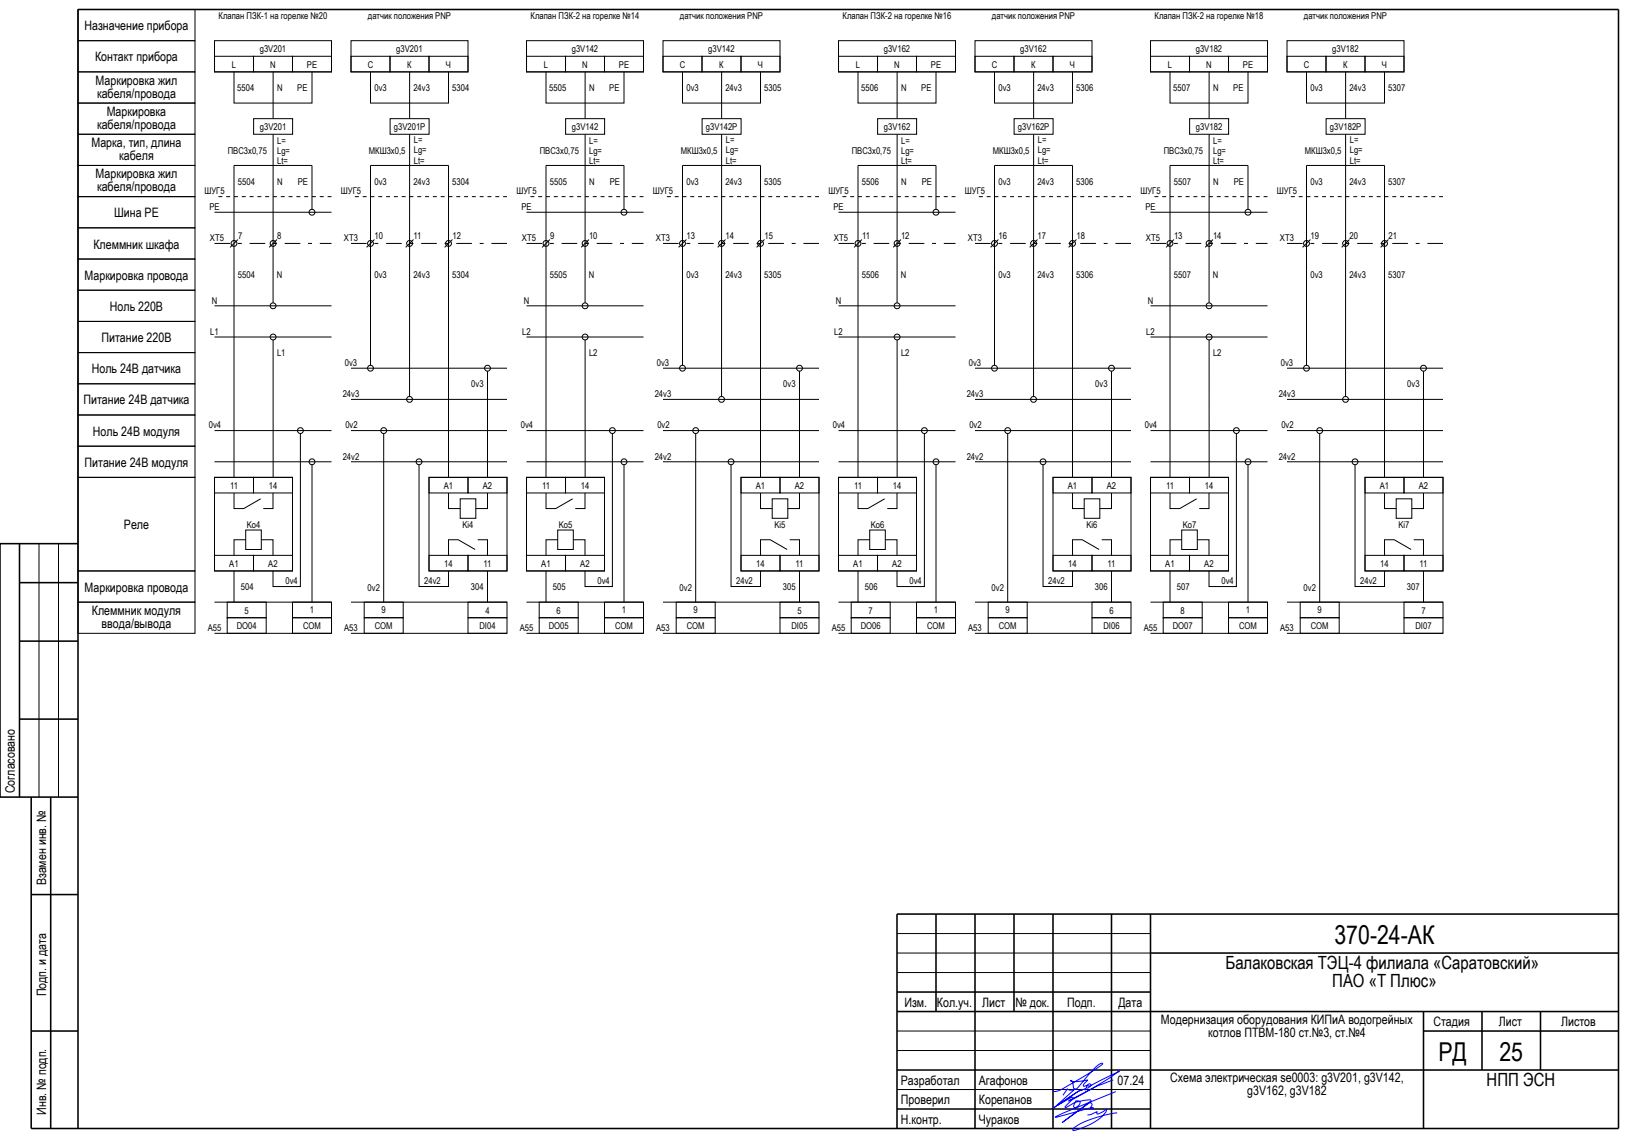
[picture p172: page 25]
Согласовано; Клеммник шкафа; Шина PE; кабеля/провода; Клеммник модуля ввода/вывода; Маркировка провода; Питание 220В; Реле; Ноль 220В; Питание 24В датчика; Ноль 24В датчика; Питание 24В модуля; Ноль 24В модуля; ШУГ5; COM; 1 COM; МКШ3х0,5; ПВС3х0,75

Клапан ПЗК-1 на горелке №20

датчик положения PNP

Клапан ПЗК-2 на горелке №14

Клапан ПЗК-2 на горелке №16

Клапан ПЗК-2 на горелке №18

Контакт прибора
Маркировка жил
кабеля/провода
Маркировка
Марка, тип, длина
кабеля

Инв. № подп. Подп. и дата Взамен инв. №

Балаковская ТЭЦ-4 филиала «Саратовский» ПАО «Т Плюс»

Изм. | Кол.уч. | Лист | № док. | Подп. | Дата

Модернизация оборудования КИПиА водогрейных котлов ПТВМ-180 ст.№3, ст.№4 | Стадия | Лист | Листов

Схема электрическая se0003: g3V201, g3V142, g3V162, g3V182 | НПП ЭСН

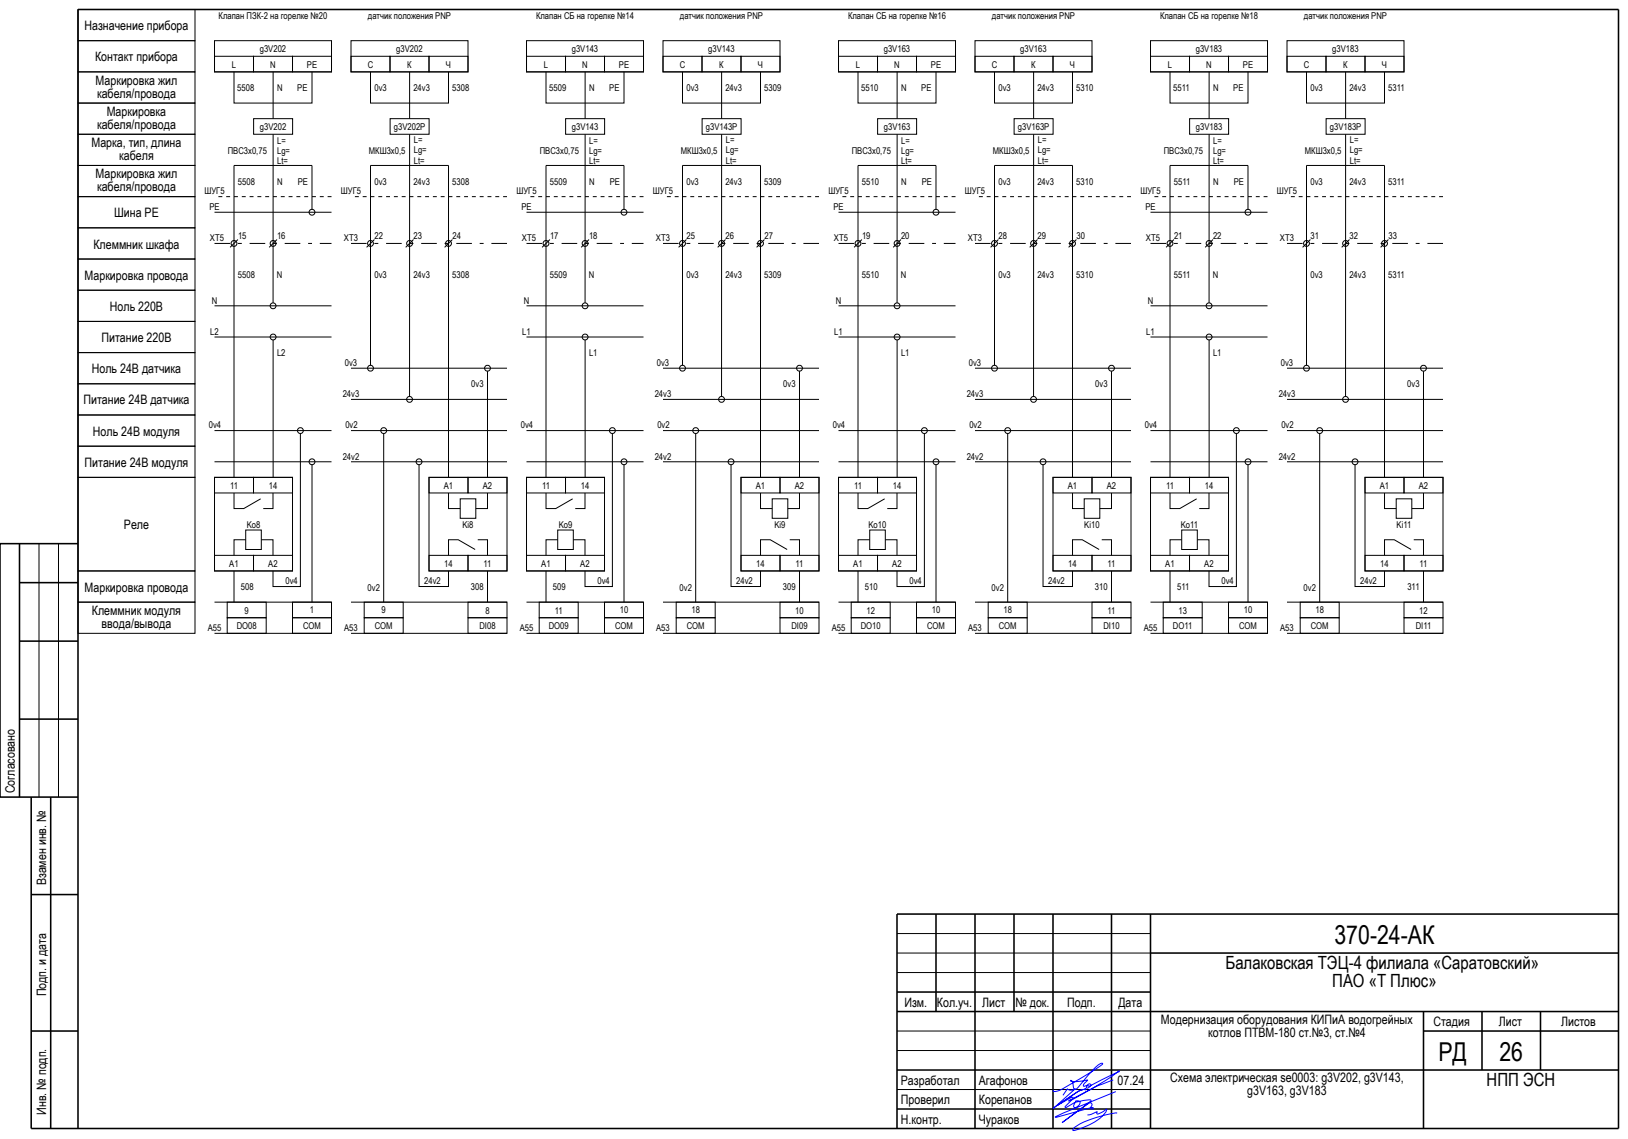
[picture p173: page 26]
Согласовано; Клеммник шкафа; Шина PE; кабеля/провода; Клеммник модуля ввода/вывода; Маркировка провода; Питание 220В; Реле; Ноль 220В; Питание 24В датчика; Ноль 24В датчика; Питание 24В модуля; Ноль 24В модуля; ШУГ5; COM; 1 COM; 10 COM; МКШ3х0,5; ПВС3х0,75

Клапан ПЗК-2 на горелке №20

датчик положения PNP

Клапан СБ на горелке №14

Клапан СБ на горелке №16

Клапан СБ на горелке №18

Контакт прибора
Маркировка жил
кабеля/провода
Маркировка
Марка, тип, длина
кабеля

Инв. № подп. Подп. и дата Взамен инв. №

Балаковская ТЭЦ-4 филиала «Саратовский» ПАО «Т Плюс»

Изм. | Кол.уч. | Лист | № док. | Подп. | Дата

Модернизация оборудования КИПиА водогрейных котлов ПТВМ-180 ст.№3, ст.№4 | Стадия | Лист | Листов

Схема электрическая se0003: g3V202, g3V143, g3V163, g3V183 | НПП ЭСН

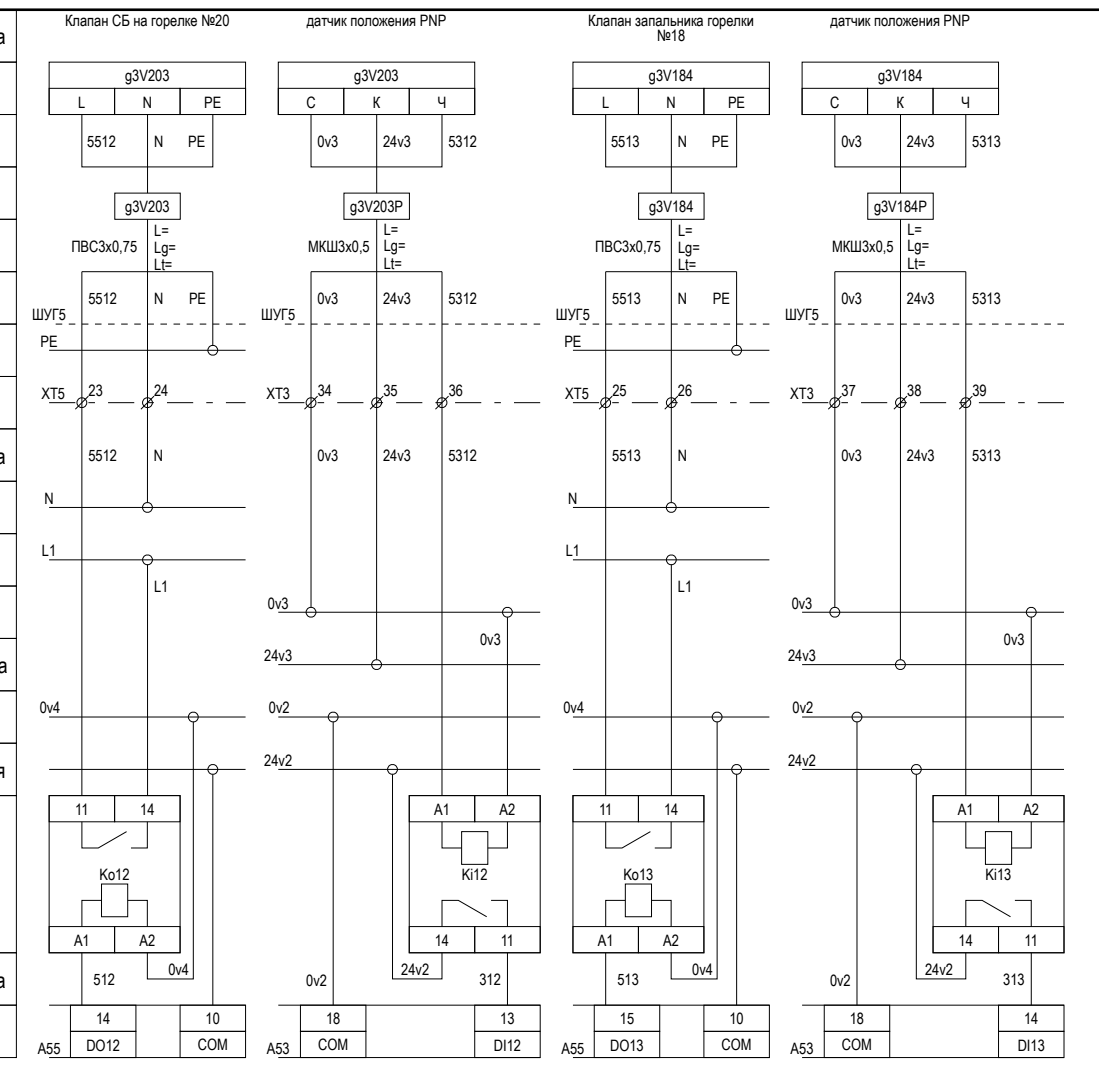
[picture p174: page 27]
Согласовано; Клеммник шкафа; Клеммник модуля ввода/вывода; Маркировка провода; Питание 220В; Реле; Ноль 220В; Питание 24В датчика; Ноль 24В датчика; Питание 24В модуля; Ноль 24В модуля; ШУГ5; COM; 10 COM; МКШ3х0,5; ПВС3х0,75

Клапан СБ на горелке №20

датчик положения PNP

Клапан запальника горелки

Контакт прибора
Маркировка жил
кабеля/провода
Маркировка
Марка, тип, длина
кабеля
Шина PE

Инв. № подп. Подп. и дата Взамен инв. №

Балаковская ТЭЦ-4 филиала «Саратовский» ПАО «Т Плюс»

Изм. | Кол.уч. | Лист | № док. | Подп. | Дата

Модернизация оборудования КИПиА водогрейных котлов ПТВМ-180 ст.№3, ст.№4 | Стадия | Лист | Листов

Схема электрическая se0003: g3V203, g3V184 | НПП ЭСН

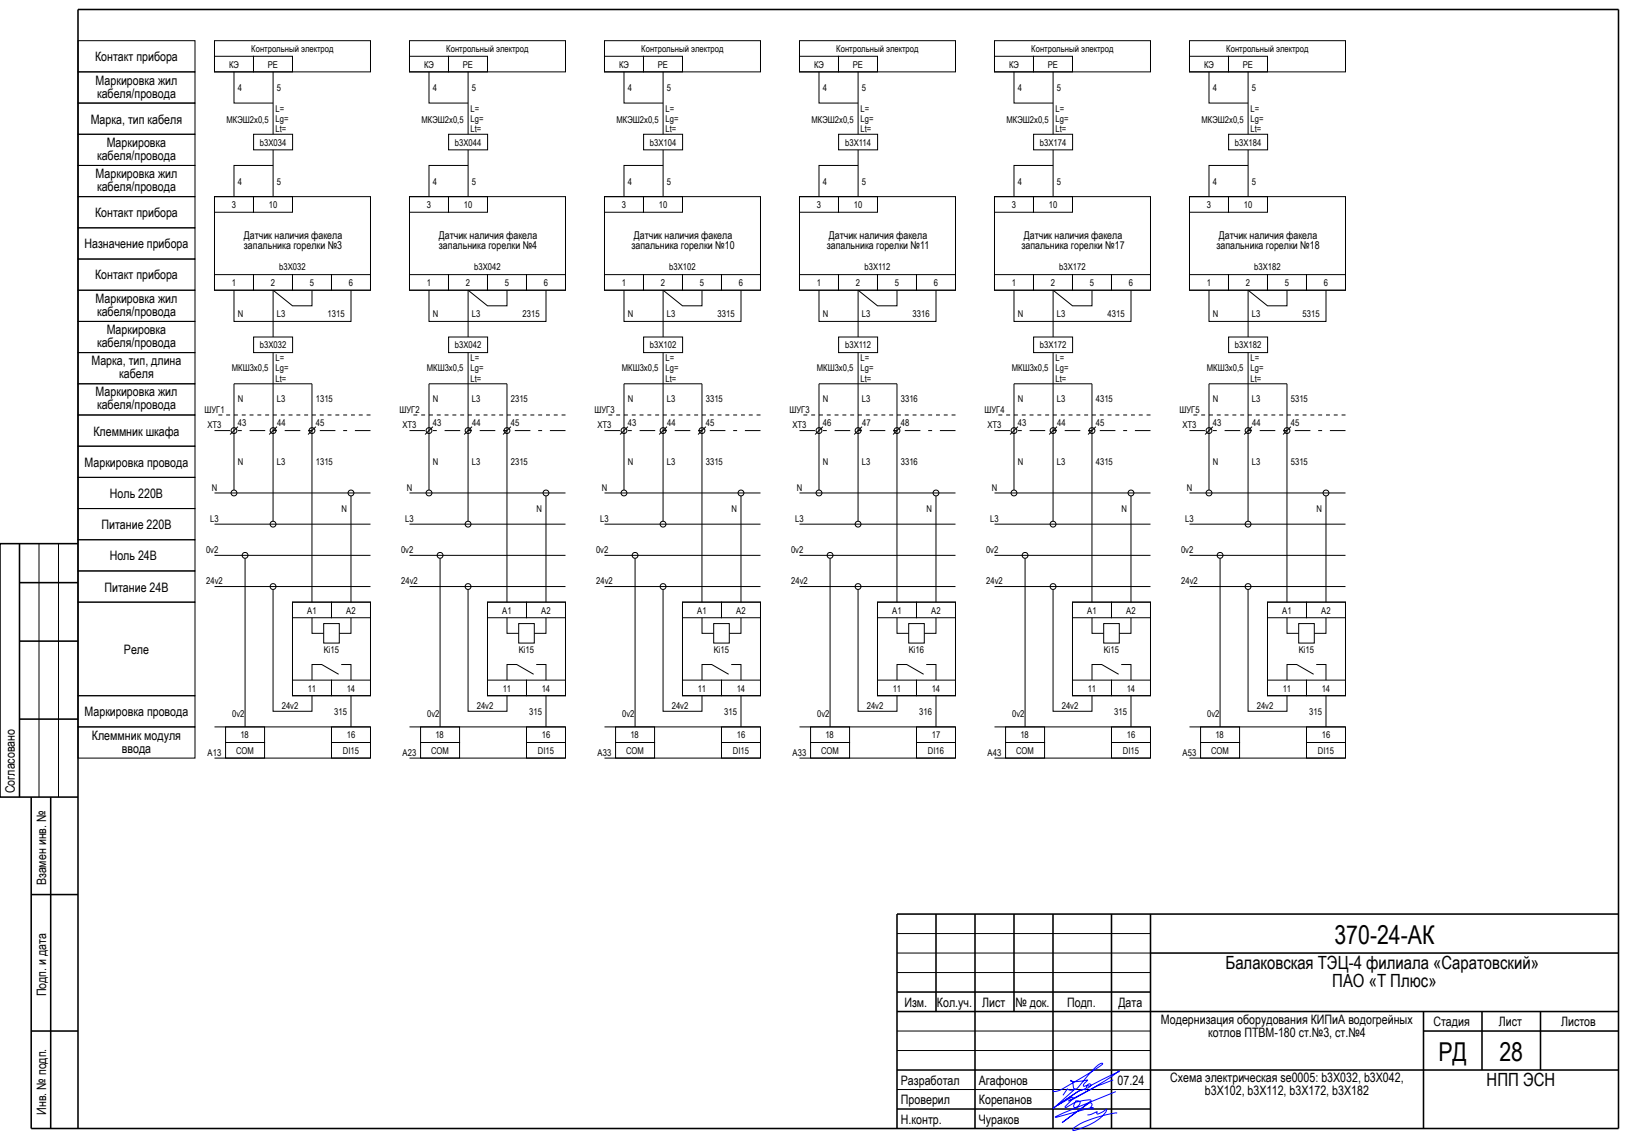
[picture p175: page 28]
Согласовано; Клеммник шкафа; кабеля/провода; Клеммник модуля ввода; Маркировка провода; Питание 220В; Реле; Ноль 220В; Питание 24В; Ноль 24В; ШУГ1; COM; ШУГ2; ШУГ3; ШУГ4; ШУГ5; Назначение прибора; Контакт прибора; Контрольный электрод; МКШ3х0,5; МКЭШ2х0,5

Контакт прибора
Маркировка жил
кабеля/провода
Марка, тип кабеля
Маркировка

Датчик наличия факела
запальника горелки №3

запальника горелки №4

запальника горелки №10

запальника горелки №11

запальника горелки №17

запальника горелки №18

Марка, тип, длина
кабеля

Инв. № подп. Подп. и дата Взамен инв. №

Балаковская ТЭЦ-4 филиала «Саратовский» ПАО «Т Плюс»

Изм. | Кол.уч. | Лист | № док. | Подп. | Дата

Модернизация оборудования КИПиА водогрейных котлов ПТВМ-180 ст.№3, ст.№4 | Стадия | Лист | Листов

Схема электрическая se0005: b3X032, b3X042, b3X102, b3X112, b3X172, b3X182 | НПП ЭСН

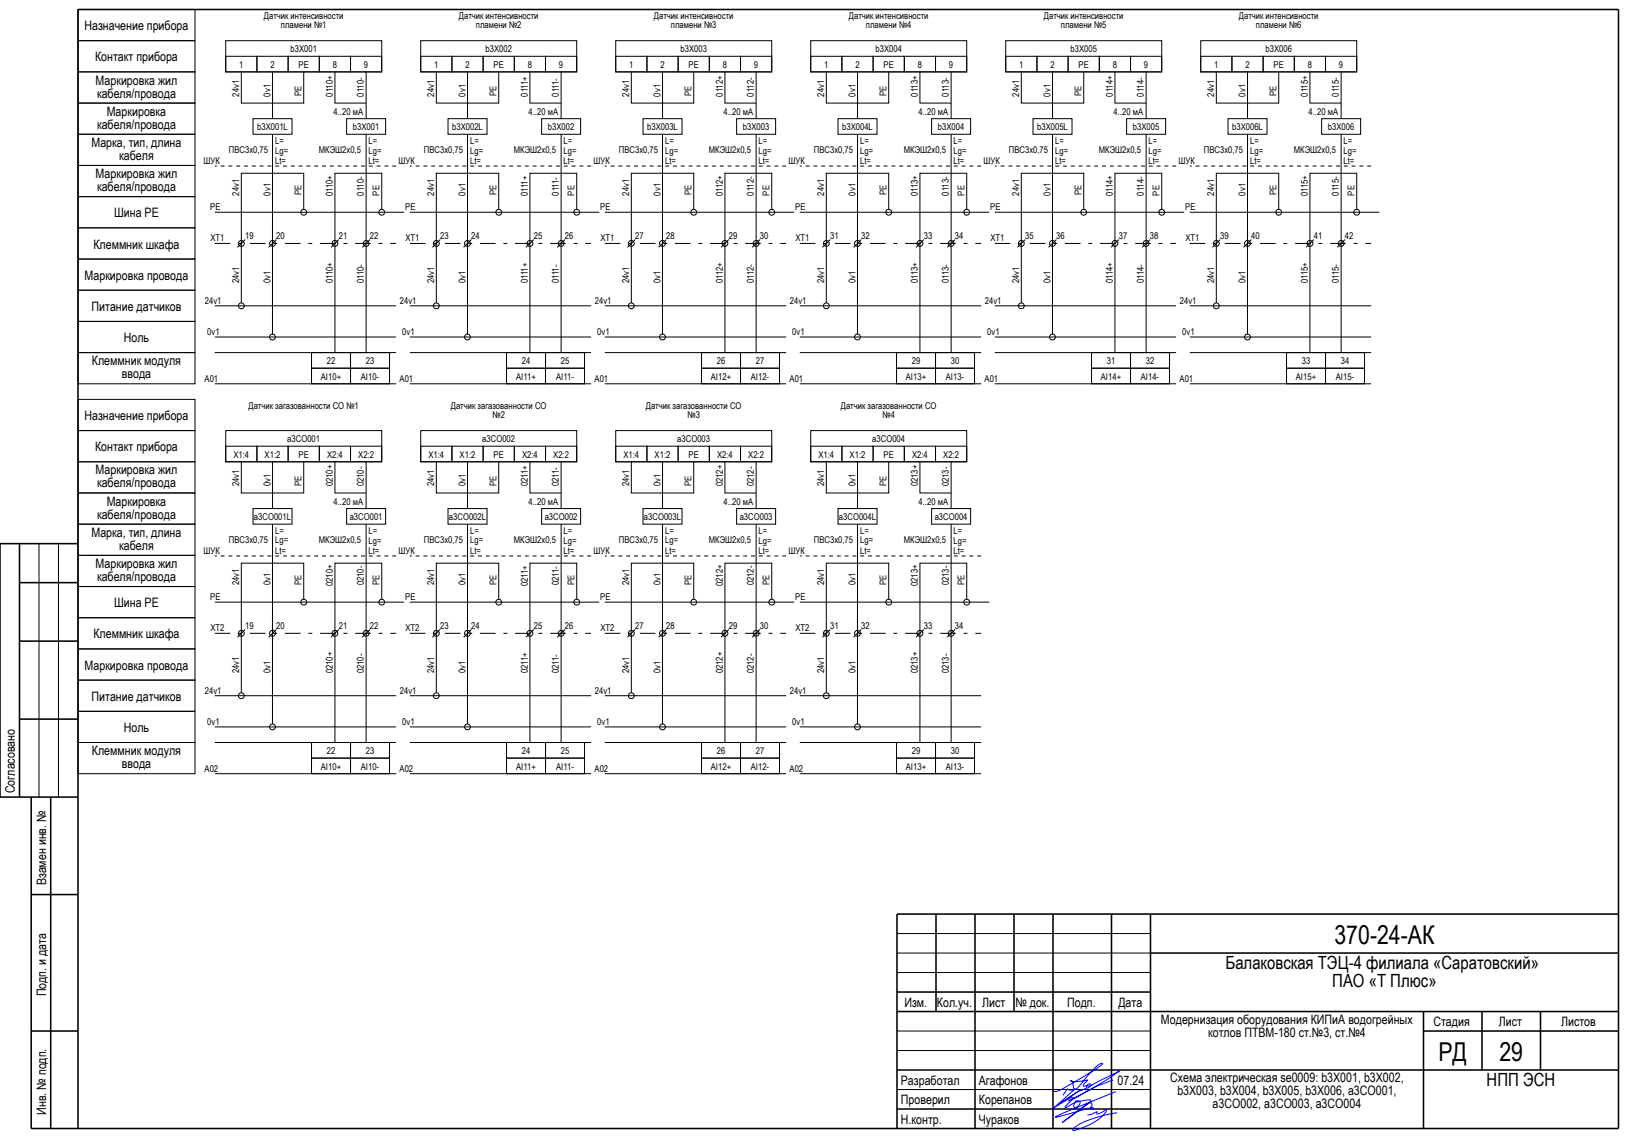
[picture p176: page 29]
Согласовано; Ноль; Питание датчиков; Клеммник шкафа; Шина PE; кабеля/провода; Клеммник модуля ввода; Маркировка провода; ШУК; Контакт прибора; Маркировка жил; Датчик интенсивности пламени №1; ПВС3х0,75; МКЭШ2х0,5; PEPE; Датчик интенсивности пламени №2; Датчик интенсивности пламени №3; Датчик интенсивности пламени №4; Датчик интенсивности пламени №5; Датчик интенсивности пламени №6; Назначение прибора

кабеля/провода
Маркировка
Марка, тип, длина
кабеля
Маркировка жил

Датчик загазованности СО №1

Датчик загазованности СО

Контакт прибора

Инв. № подп. Подп. и дата Взамен инв. №

Балаковская ТЭЦ-4 филиала «Саратовский» ПАО «Т Плюс»

Изм. | Кол.уч. | Лист | № док. | Подп. | Дата

Модернизация оборудования КИПиА водогрейных котлов ПТВМ-180 ст.№3, ст.№4 | Стадия | Лист | Листов

Схема электрическая se0009: b3X001, b3X002, b3X003, b3X004, b3X005, b3X006, а3СО001, а3СО002, а3СО003, а3СО004 | НПП ЭСН

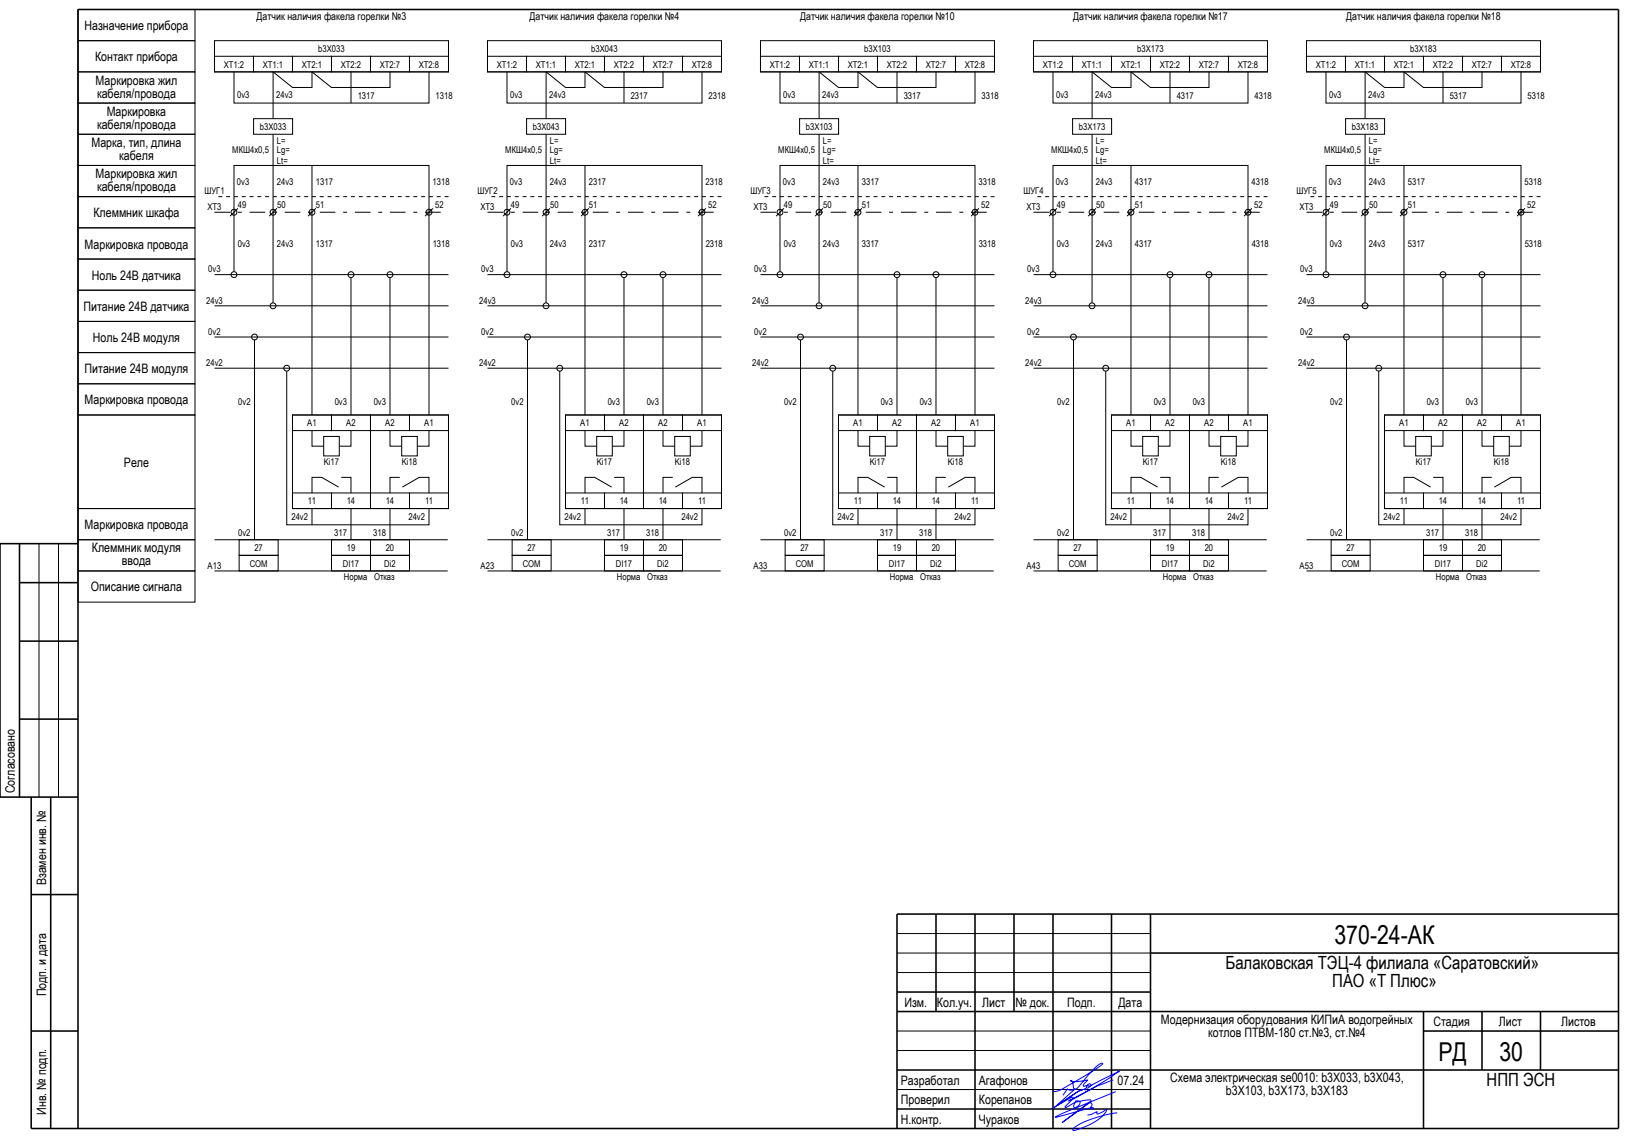
[picture p177: page 30]
Согласовано; Клеммник шкафа; Клеммник модуля ввода; Маркировка провода; Реле; Питание 24В датчика; Ноль 24В датчика; Питание 24В модуля; Ноль 24В модуля; Описание сигнала; ШУГ1; 27 COM; Норма Отказ; ШУГ2; ШУГ3; ШУГ4; ШУГ5; Маркировка кабеля/провода; Контакт прибора; Маркировка жил кабеля/провода; Назначение прибора; Датчик наличия факела горелки №3; МКШ4х0,5

Датчик наличия факела горелки №4

Датчик наличия факела горелки №10

Датчик наличия факела горелки №17

Датчик наличия факела горелки №18

Марка, тип, длина
кабеля
Маркировка жил
кабеля/провода

Инв. № подп. Подп. и дата Взамен инв. №

Балаковская ТЭЦ-4 филиала «Саратовский» ПАО «Т Плюс»

Изм. | Кол.уч. | Лист | № док. | Подп. | Дата

Модернизация оборудования КИПиА водогрейных котлов ПТВМ-180 ст.№3, ст.№4 | Стадия | Лист | Листов

Схема электрическая se0010: b3X033, b3X043, b3X103, b3X173, b3X183 | НПП ЭСН

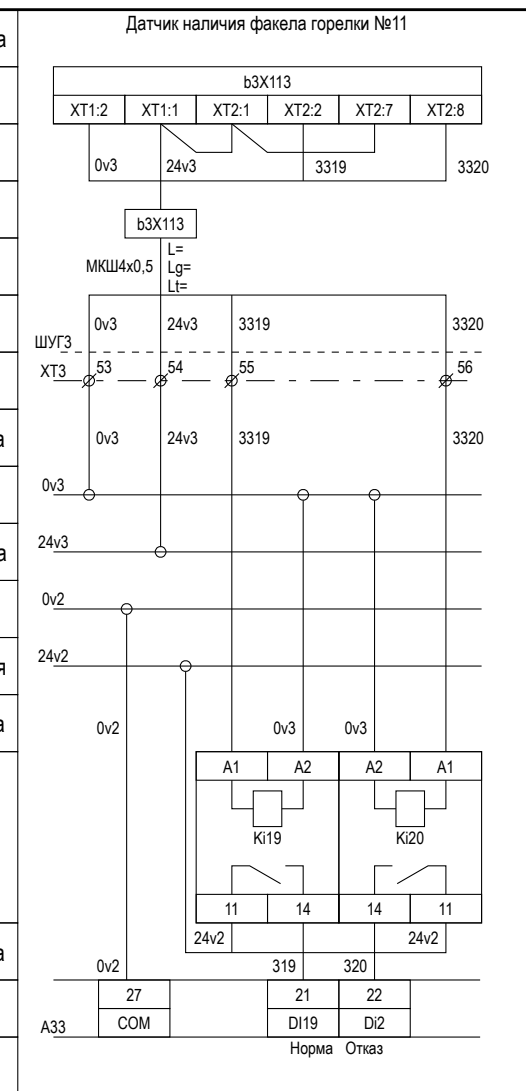
[picture p178: page 31]
Согласовано; Клеммник модуля ввода; Маркировка провода; Реле; Питание 24В датчика; Ноль 24В датчика; Питание 24В модуля; Ноль 24В модуля; Описание сигнала; ШУГ3; 27 COM; Норма Отказ; Назначение прибора; Датчик наличия факела горелки №11; МКШ4х0,5

Контакт прибора
Маркировка жил
кабеля/провода
Маркировка
Марка, тип, длина
кабеля
Клеммник шкафа

Инв. № подп. Подп. и дата Взамен инв. №

Балаковская ТЭЦ-4 филиала «Саратовский» ПАО «Т Плюс»

Изм. | Кол.уч. | Лист | № док. | Подп. | Дата

Модернизация оборудования КИПиА водогрейных котлов ПТВМ-180 ст.№3, ст.№4 | Стадия | Лист | Листов

Схема электрическая se0010: b3X113 | НПП ЭСН

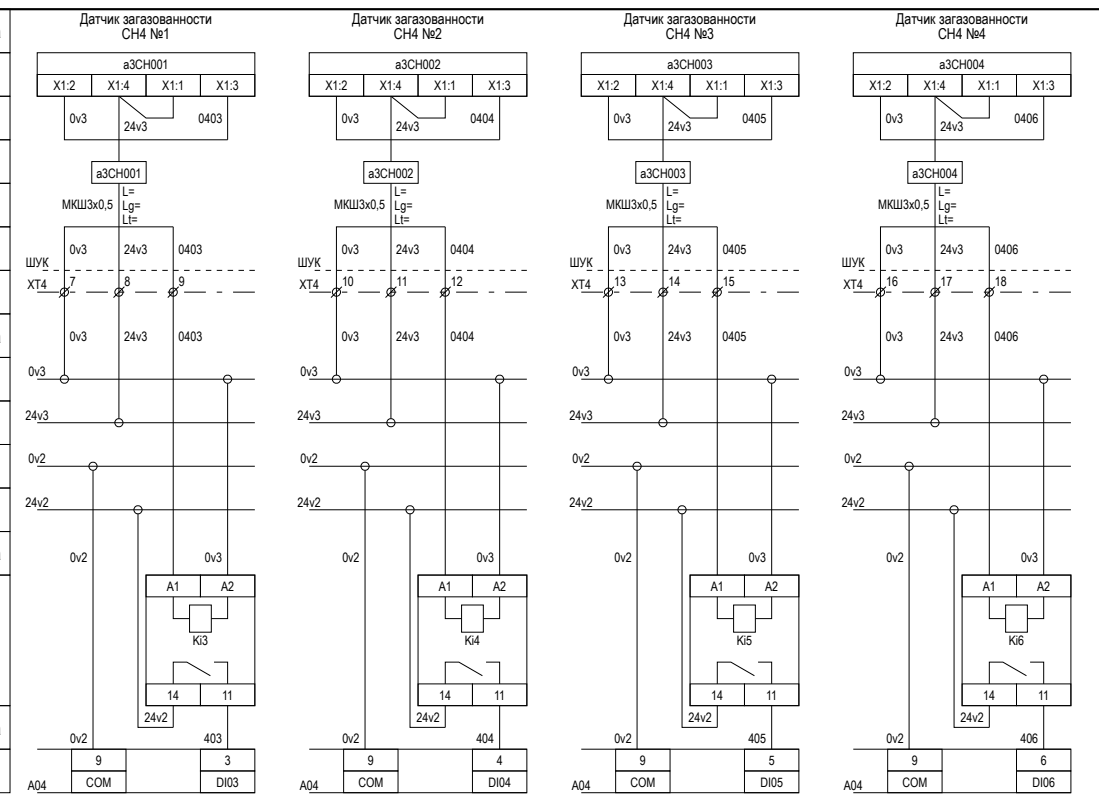
[picture p179: page 32]
Согласовано; Клеммник шкафа; Клеммник модуля ввода; Маркировка провода; Реле; Питание 24В; Ноль 24В; ШУК; 9 COM; Назначение прибора; Датчик загазованности; МКШ3х0,5; Датчик загазованности СН4 №2; Датчик загазованности СН4 №3; Датчик загазованности СН4 №4

Контакт прибора
Маркировка жил
кабеля/провода
Маркировка
Марка, тип, длина
кабеля

Инв. № подп. Подп. и дата Взамен инв. №

Балаковская ТЭЦ-4 филиала «Саратовский» ПАО «Т Плюс»

Изм. | Кол.уч. | Лист | № док. | Подп. | Дата

Модернизация оборудования КИПиА водогрейных котлов ПТВМ-180 ст.№3, ст.№4 | Стадия | Лист | Листов

Схема электрическая se0011: а3СН001, а3СН002, а3СН003, а3СН004 | НПП ЭСН

1 2 3 4 5 6 7 8 9 10 11 12 13 14 15 16 17 18 19 20 21 22 23 24 25 26 27 28

1

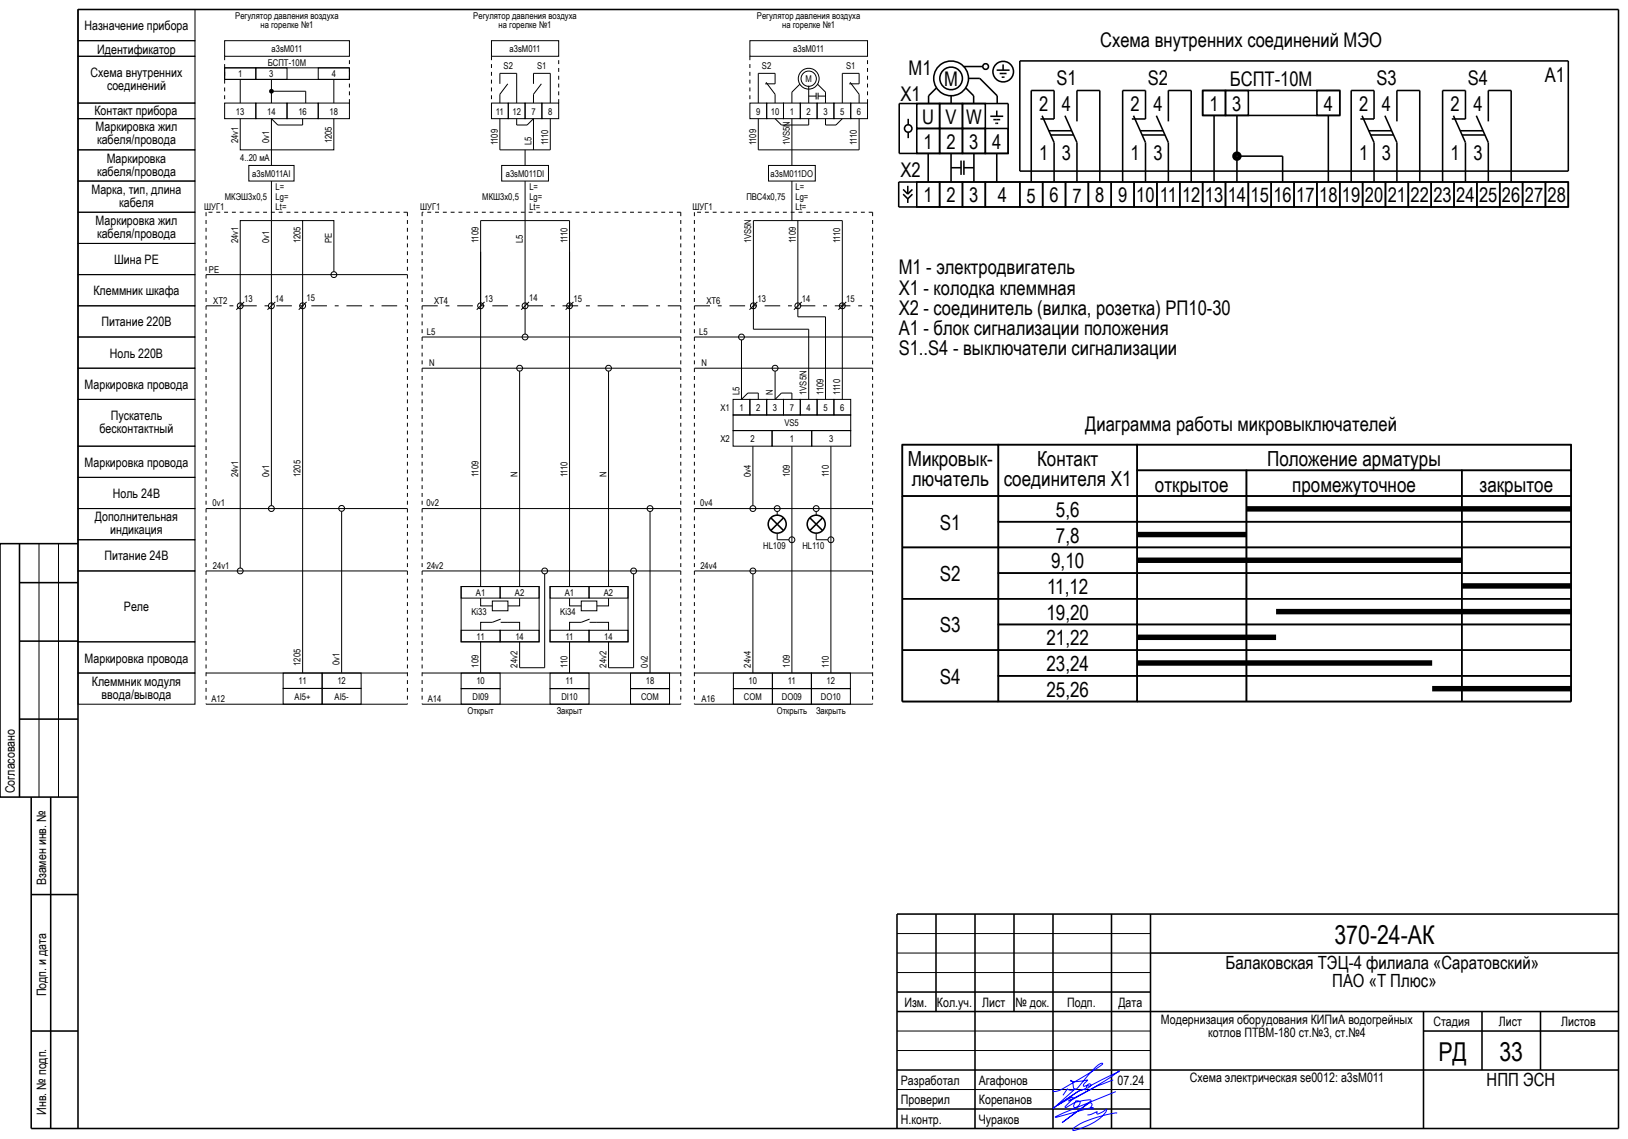
[picture p180: page 33]
Согласовано; Клеммник модуля ввода/вывода; Маркировка провода; Питание 24В; Ноль 24В; Дополнительная индикация; Клеммник шкафа; Пускатель бесконтактный; Реле; Ноль 220В; Питание 220В; ШУГ1; COM; Открыт; Закрыт; Открыть Закрыть; Маркировка кабеля/провода; Маркировка жил кабеля/провода; Контакт прибора; Схема внутренних соединений; Идентификатор; МКЭШ3х0,5; БСПТ-10М; МКШ3х0,5; ПВС4х0,75; Схема внутренних соединений МЭО; Микровык- лючатель; Контакт соединителя Х1; Положение арматуры; открытое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

Регулятор давления воздуха
на горелке №1

Марка, тип, длина
кабеля
Маркировка жил
кабеля/провода
Шина PE

М1 - электродвигатель
Х1 - колодка клеммная
Х2 - соединитель (вилка, розетка) РП10-30
А1 - блок сигнализации положения
S1..S4 - выключатели сигнализации

Инв. № подп. Подп. и дата Взамен инв. №

Балаковская ТЭЦ-4 филиала «Саратовский» ПАО «Т Плюс»

Изм. | Кол.уч. | Лист | № док. | Подп. | Дата

Модернизация оборудования КИПиА водогрейных котлов ПТВМ-180 ст.№3, ст.№4 | Стадия | Лист | Листов

Схема электрическая se0012: а3sM011 | НПП ЭСН

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

1

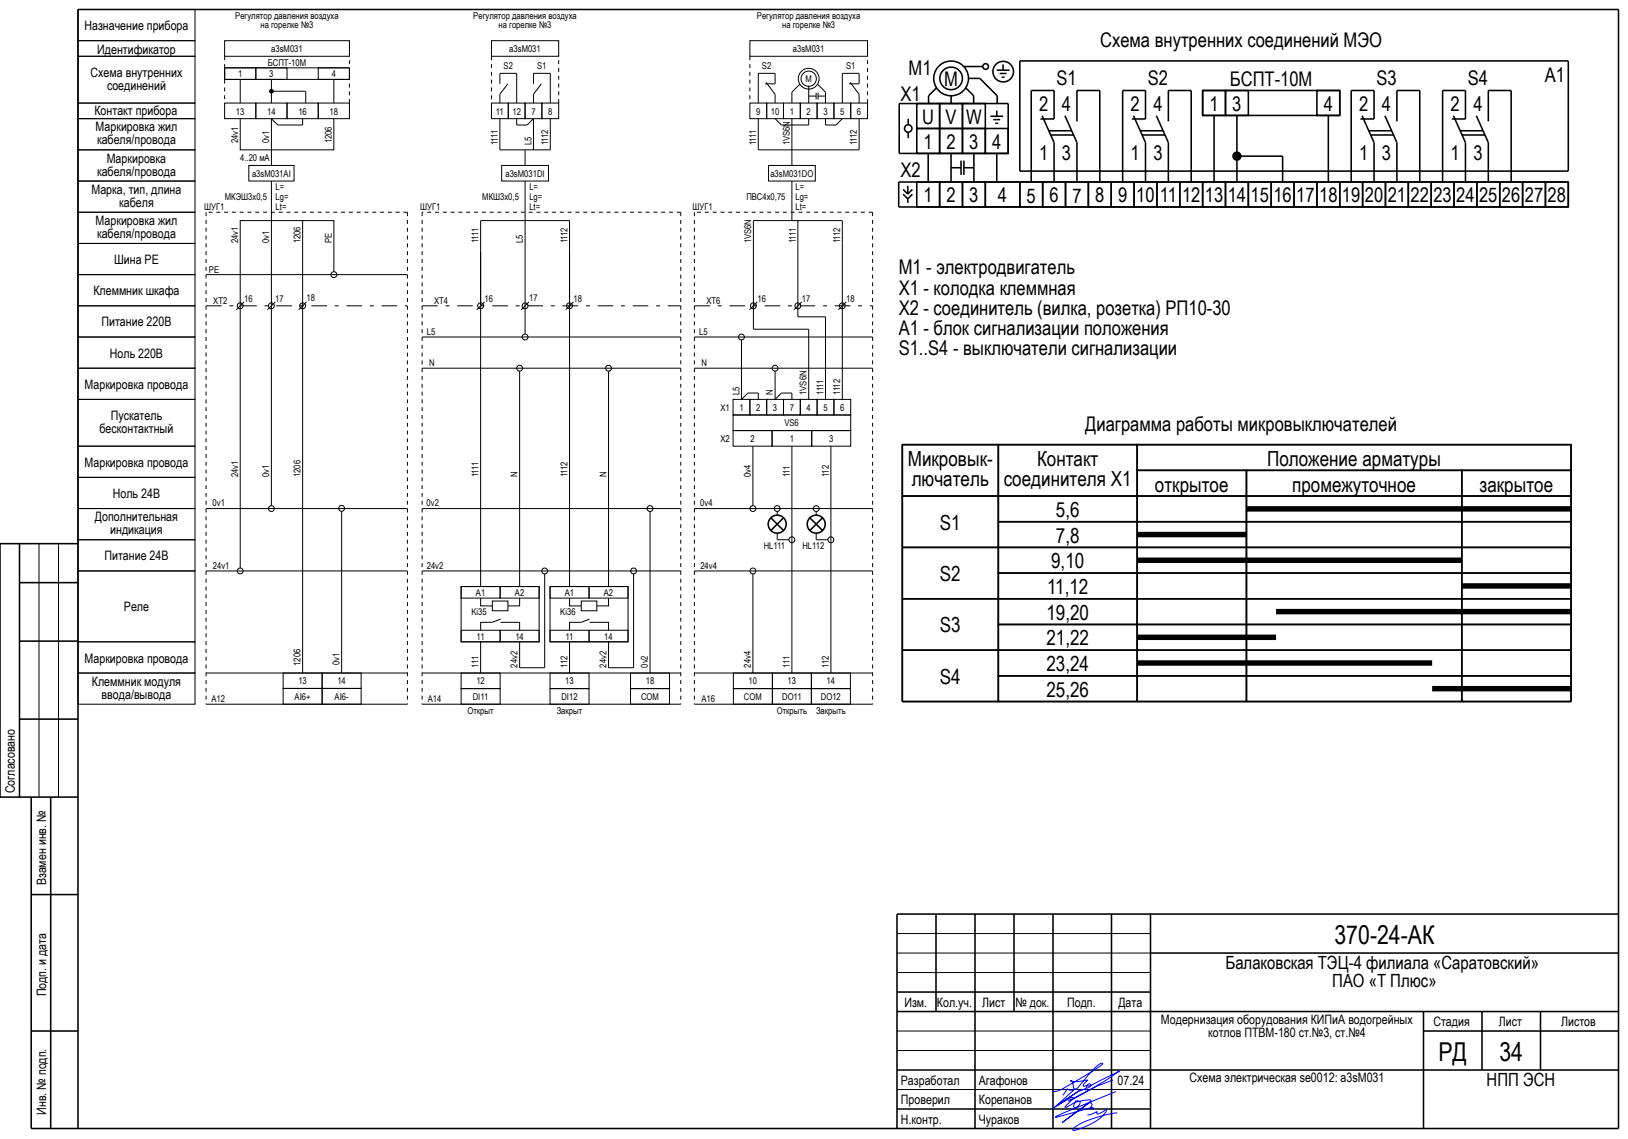
[picture p181: page 34]
Согласовано; Клеммник модуля ввода/вывода; Маркировка провода; Питание 24В; Ноль 24В; Дополнительная индикация; Клеммник шкафа; Пускатель бесконтактный; Шина PE; Реле; Ноль 220В; Питание 220В; ШУГ1; COM; Открыт; Закрыт; Открыть Закрыть; МКЭШ3х0,5; БСПТ-10М; МКШ3х0,5; ПВС4х0,75; Схема внутренних соединений МЭО; Микровык- лючатель; Контакт соединителя Х1; Положение арматуры; открытое; промежуточное; закрытое; Диаграмма работы микровыключателей

Регулятор давления воздуха
на горелке №3

Контакт прибора
Маркировка жил
кабеля/провода
Маркировка
Марка, тип, длина
кабеля

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

Инв. № подп. Подп. и дата Взамен инв. №

Балаковская ТЭЦ-4 филиала «Саратовский» ПАО «Т Плюс»

Изм. | Кол.уч. | Лист | № док. | Подп. | Дата

Модернизация оборудования КИПиА водогрейных котлов ПТВМ-180 ст.№3, ст.№4 | Стадия | Лист | Листов

Схема электрическая se0012: а3sM031 | НПП ЭСН

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

1
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
