nppesnteam/370-24_Balakovo_PTVM180_-3-4/АК_План_1.pdf

# 34 33 Ось котла ПТВМ⁻¹⁸⁰ ст.№³

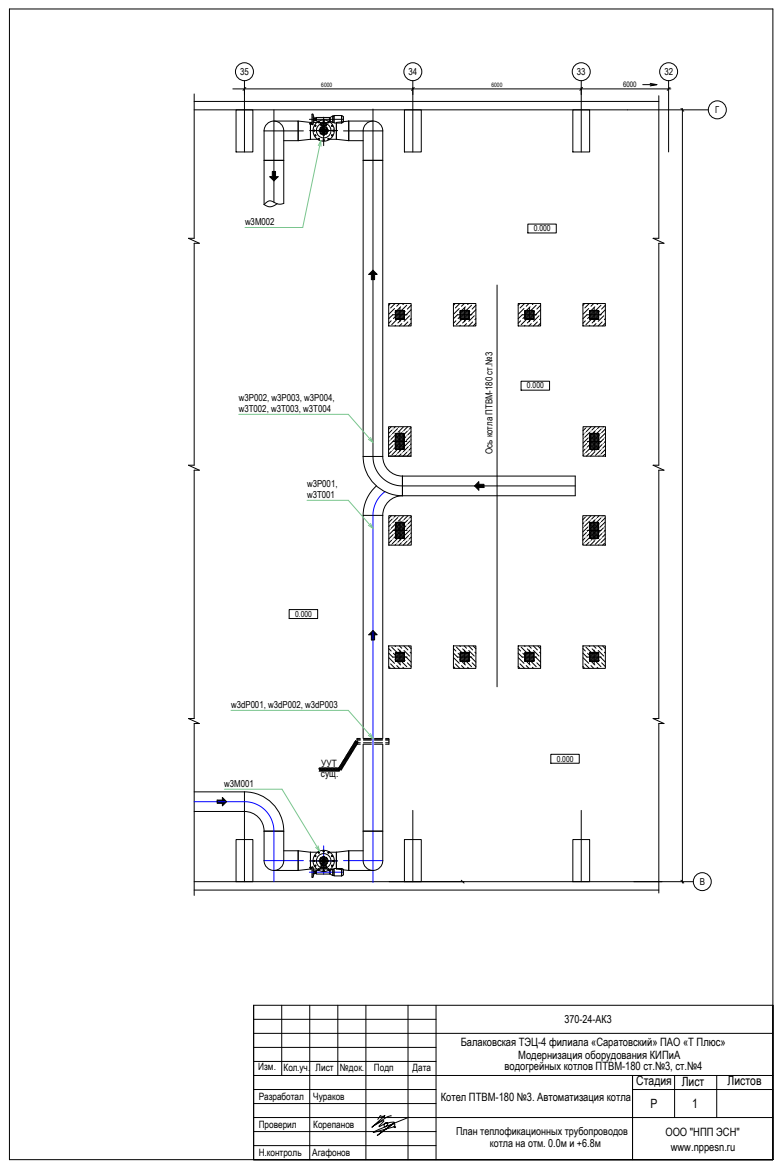
[picture p182: page 1]
УУТ сущ.; Агафонов; Проверил; Н.контроль; Корепанов

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

Изм. | Кол.уч. | Лист | №док. | Подп | Дата

Котел ПТВМ-180 №3. Автоматизация котла | Стадия | Лист | Листов

Разработал | Чураков | | | | Р | 1

План теплофикационных трубопроводов
ООО "НПП ЭСН" котла на отм. 0.0м и +6.8м

www.nppesn.ru
