nppesnteam/370-24_Balakovo_PTVM180_-3-4/АК_План_2.pdf

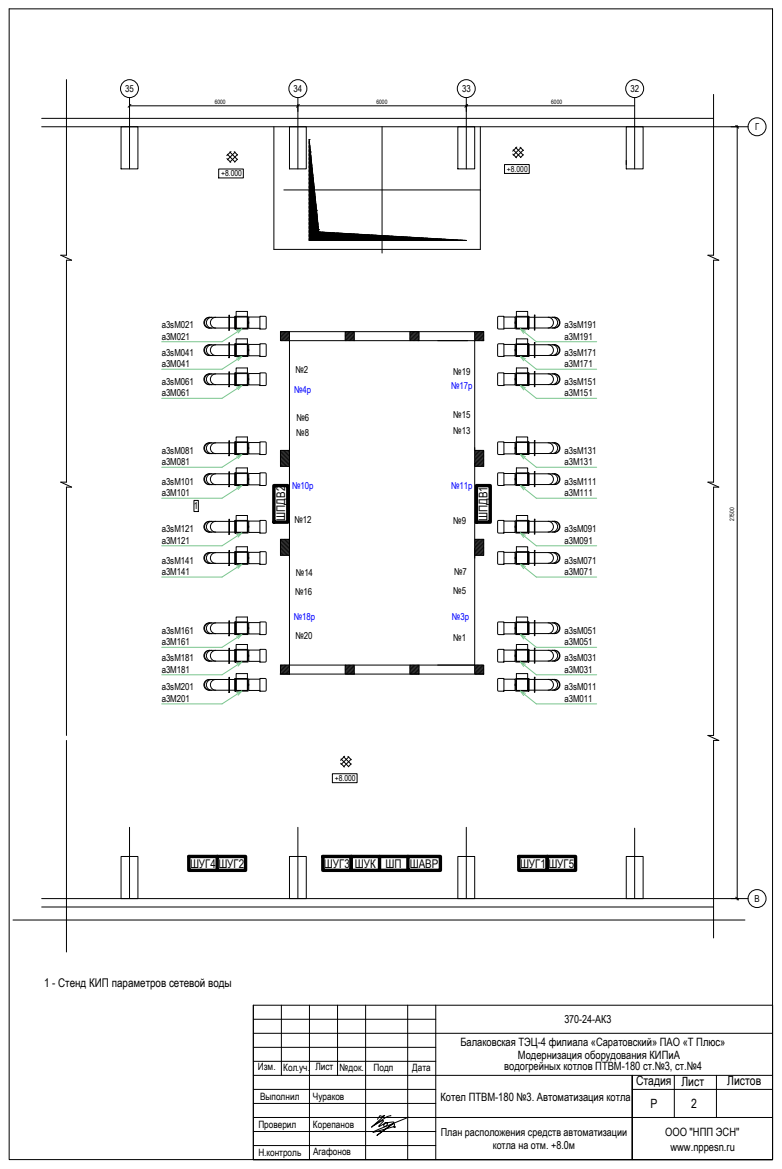
[picture p183: page 1]
Проверил; Н.контроль; Корепанов; Агафонов; ШУГ4 ШУГ2; ШУГ3 ШУК ШП ШАВР; ШУГ1 ШУГ5

1 - Стенд КИП параметров сетевой воды

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

Изм. | Кол.уч. Лист | №док. | Подп | Дата

Котел ПТВМ-180 №3. Автоматизация котла | Стадия | Лист | Листов

Выполнил | Чураков | | | Р | 2

План расположения средств автоматизации

ООО "НПП ЭСН"
www.nppesn.ru

котла на отм. +8.0м
