nppesnteam/370-24_Balakovo_PTVM180_-3-4/АК_План_4.pdf

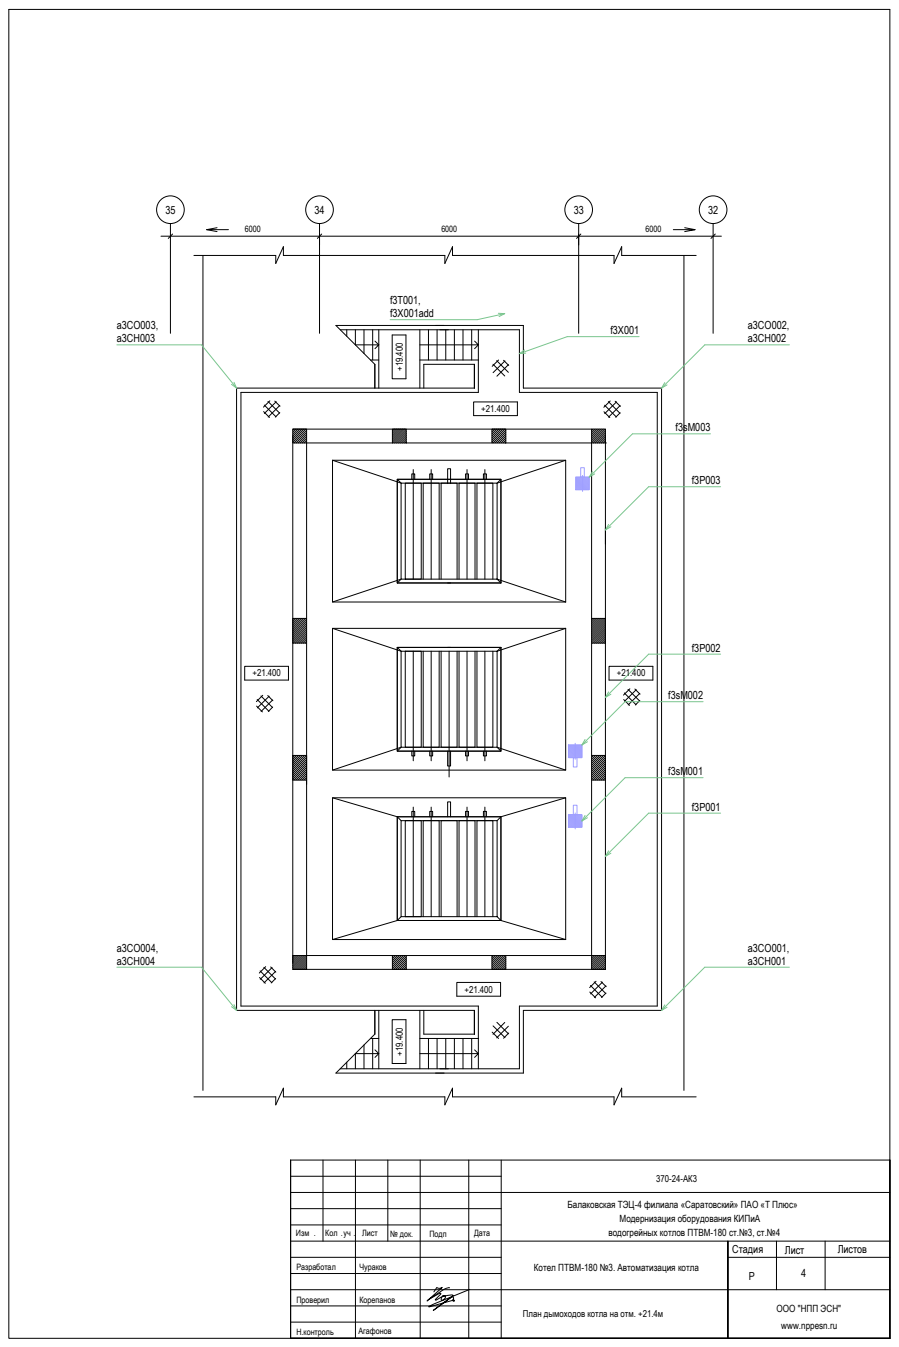
[picture p185: page 1]
f3T001, f3X001add; Проверил; Н.контроль; Корепанов; Агафонов

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

Изм . | Кол .уч . | Лист | № док. | Подп | Дата

Котел ПТВМ-180 №3. Автоматизация котла | Стадия | Лист | Листов

Разработал | Чураков | | | | Р | 4

ООО "НПП ЭСН"
www.nppesn.ru

План дымоходов котла на отм. +21.4м
