nppesnteam/370-24_Balakovo_PTVM180_-3-4/АК_План_5.pdf

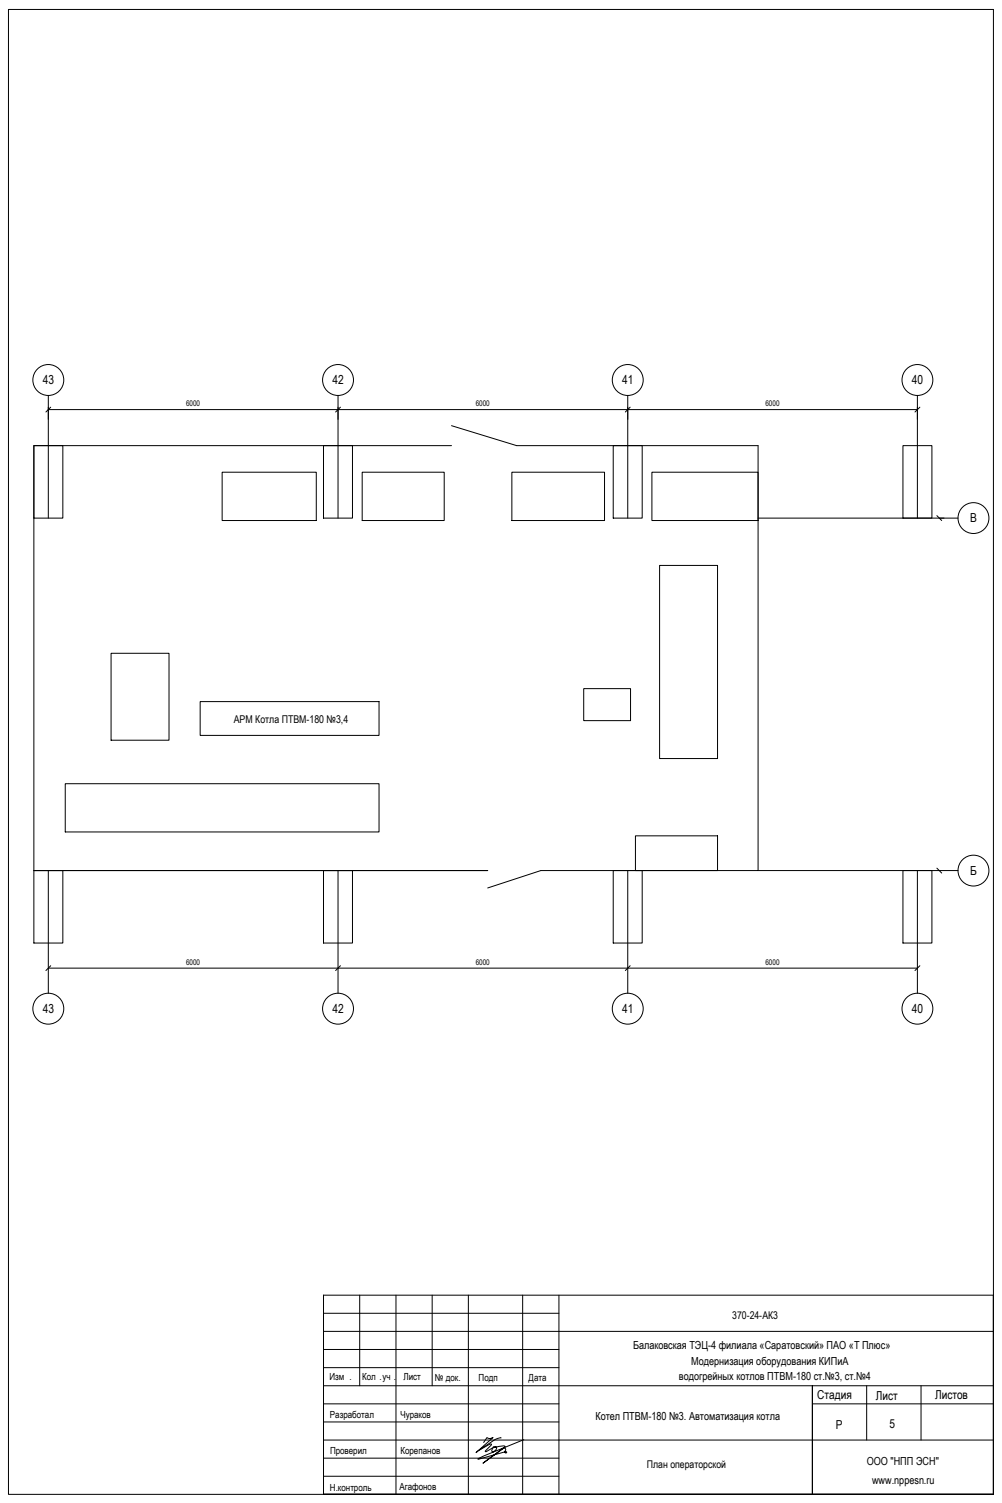
[picture p186: page 1]
План операторской; Проверил; Н.контроль; Корепанов; Агафонов

АРМ Котла ПТВМ-180 №3,4

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

Изм . | Кол .уч . | Лист | № док. | Подп | Дата

Котел ПТВМ-180 №3. Автоматизация котла | Стадия | Лист | Листов

Разработал | Чураков | | | | Р | 5

ООО "НПП ЭСН"
www.nppesn.ru
