nppesnteam/370-24_Balakovo_PTVM180_-3-4/АК_План_расположения.pdf

# 34 33 Ось котла ПТВМ⁻¹⁸⁰ ст.№³

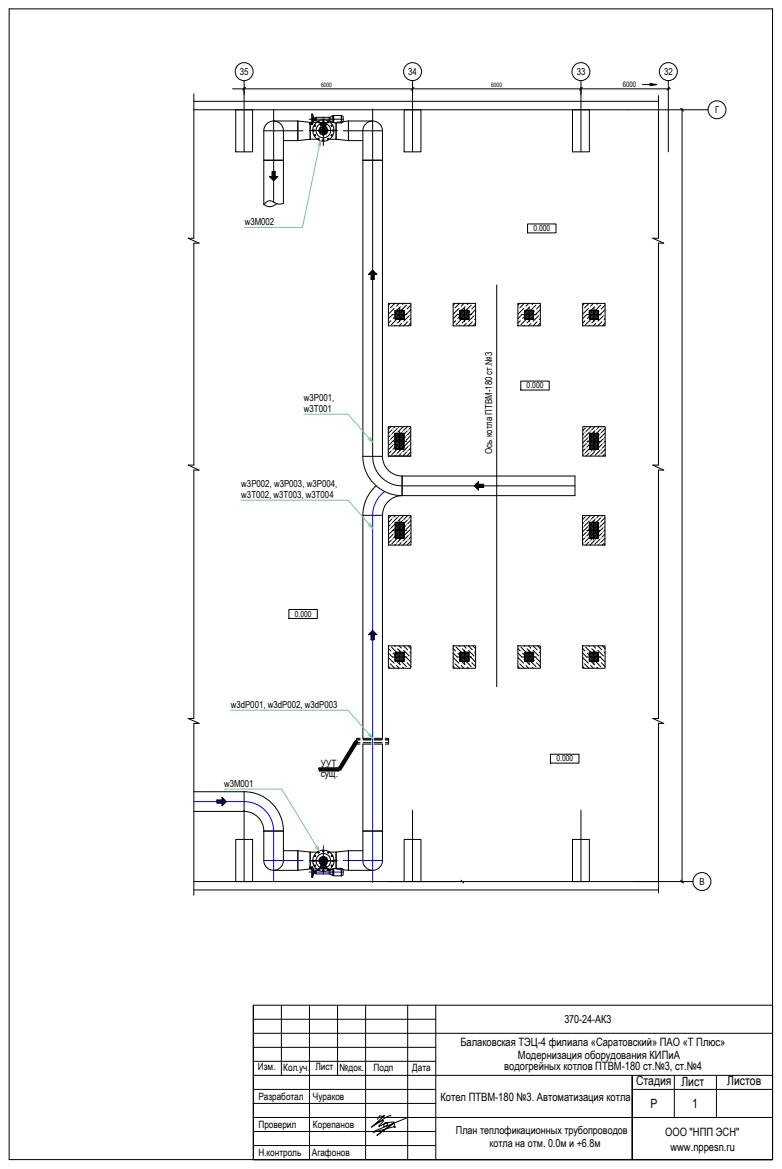
[picture p187: page 1]
УУТ сущ.; Агафонов; Проверил; Н.контроль; Корепанов

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

Изм. | Кол.уч. Лист | №док. | Подп | Дата

Котел ПТВМ-180 №3. Автоматизация котла | Стадия | Лист | Листов

Разработал | Чураков | | | Р

План теплофикационных трубопроводов
ООО "НПП ЭСН" котла на отм. 0.0м и +6.8м

www.nppesn.ru

Выполнил; ШУГ4 ШУГ2; ШУГ3 ШУК ШП ШАВР; ШУГ1 ШУГ5

1 - Стенд КИП параметров сетевой воды

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

Изм. | Кол.уч. Лист | №док. | Подп | Дата

План расположения средств автоматизации

ООО "НПП ЭСН"

котла на отм. +8.0м

b3X031, b3X032add, b3X033; b3X111, b3X112add, b3X113; b3X171, b3X172add, b3X173; g3P021, g3P022, a3P021, g3V021, g3V022, g3V023, g3sM021 g3P041, g3P042, a3P041, g3V041, g3V042, g3V043, g3V044, g3sM041 b3X041, b3X042add, b3X043 g3P061, g3P062, a3P061, g3V061, g3V062, g3V063, g3sM061; b3X101, b3X102add, b3X103; b3X181, b3X182add, b3X183; Выполнил; ШУГ4 ШУГ2; ШУГ3 ШУК ШП ШАВР; ШУГ1 ШУГ5

1 - Стенд КИП горелок

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

Изм. | Кол.уч. Лист | №док. | Подп | Дата

План расположения средств автоматизации

котла на отм. +11.5м

f3T001, f3X001add; Разработал; Чураков

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

Изм . | Кол .уч . | Лист | № док. | Подп | Дата

План дымоходов котла на отм. +21.4м

План операторской; Разработал; Чураков

АРМ Котла ПТВМ-180 №3,4

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

Изм . | Кол .уч . | Лист | № док. | Подп | Дата
