nppesnteam/370-24_Balakovo_PTVM180_-3-4/ГС Балаково Схема.pdf

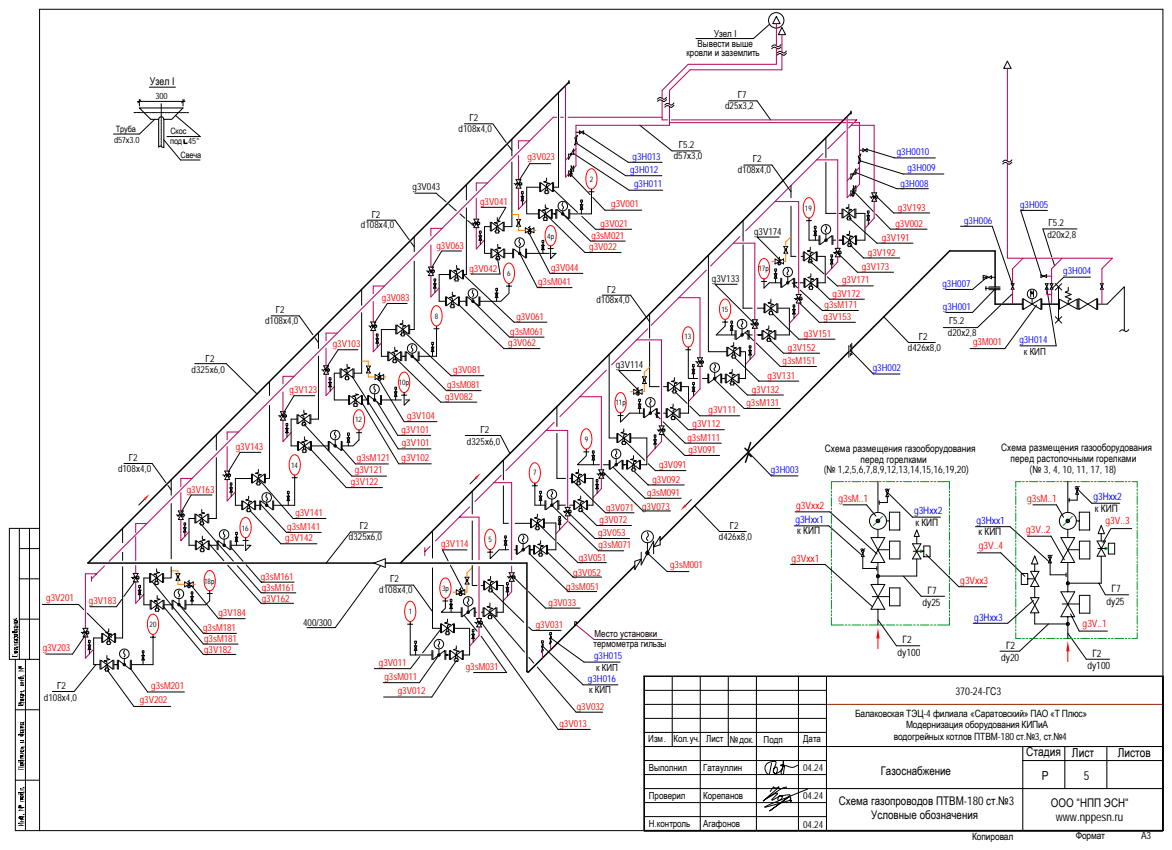
[picture p188: page 1]
g3Нхх1; Копировал; Агафонов; Корепанов; Гатауллин; Н.контроль; Проверил; Выполнил; Газоснабжение; термометра гильзы; Место установки; g3H016 к КИП; к КИП; g3Vхх1; Изм.; Кол. уч.; Лист; №док.; Подп; Дата; g3Нхх3; g3Vхх3; g3Vхх2; перед горелками; g3Нхх2; Стадия; ЛистовЛист; g3Нхх2 к КИП; g3H014 к КИП; Труба; под 45° Свеча; Скос; Узел I; Узел Вывести выше кровли и заземлить

Схема размещения газооборудования

перед растопочными горелками

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

Схема газопроводов ПТВМ-180 ст.№3
Условные обозначения

ООО "НПП ЭСН"
www.nppesn.ru
Формат
