nppesnteam/370-24_Balakovo_PTVM180_-3-4/САУГ КА-5  Итог 10 испр.pdf

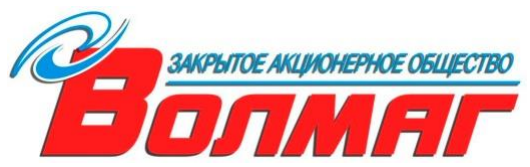
[picture p189: figure]

Закрытое акционерное общество «ВОЛМАГ»

«Модернизация системы автоматического управления горелками

котлоагрегата ТГМ-84 ст. N5»

для нужд Балаковской ТЭЦ-4 Филиала «Саратовский» ПАО «Т Плюс»

## РАБОЧАЯ ДОКУМЕНТАЦИЯ

Автоматизация газоснабжения

422-5ТГМ84-АГСВ

Том 1

Изм. | № док. | Подп. | Дата

2022

Подп. и датаПодп. и датаВзам. инв. №Взам.

инв. №

№ подл.

Закрытое акционерное общество «ВОЛМАГ»

«Модернизация системы автоматического управления горелками

котлоагрегата ТГМ-84 ст. N5»

для нужд Балаковской ТЭЦ-4 Филиала «Саратовский» ПАО «Т Плюс»

## РАБОЧАЯ ДОКУМЕНТАЦИЯ

Автоматизация газоснабжения

422-5ТГМ84-АГСВ

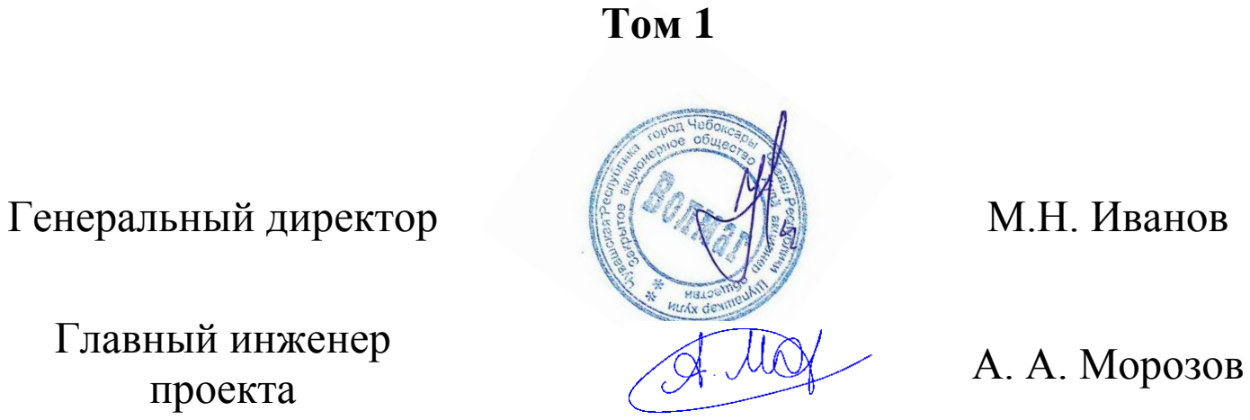
[picture p190: figure]
Том 1; Генеральный директор; М.Н. Иванов; Главный инженер проекта; А. А. Морозов

Изм. | № док. | Подп. | Дата

2022

| | | | | | 422-5ТГМ84-АГСВ-ПЗ
| | | | | | ПОЯСНИТЕЛЬНАЯ ЗАПИСКА | Стадия | Масса | Масштаб
Изм | Кол | Лист | №док | Подп. | Дата | | Р | - | -
Разраб. | | Корсаков
Пров. | | Морозов
Т.контр. | | | | | | | Лист:1 | Листов: 5
| | | | | | БАЛАКОВСКАЯ ТЭЦ-4 АСУГ КОТЛОАГРЕГАТА ТГМ-84 СТ. N5 | ЗАО «Волмаг» Г. Чебоксары 2022 г.
Н.контр. | Семенов
Утв. | Морозов
Файл: | Формат: А4

### 1. ВВЕДЕНИЕ

- Тип котла ТГМ-84А - Стационарный номер 5 - Паропроизводительность 420 т/ч - Вид топлива (основное) газ - Вид топлива (резервное) мазут - Давление газа перед котлом 110 кПа - Давление газа перед горелками 30-35 кПа - Количество горелок 4 - Номинальный расход газа (на горелку) 5724 м3/ч - Разряжение в топке 2 кгс/м2 - Тип горелки ВТИ-ТКЗ - Блок газооборудования БГ-8

### Рабочий проект АСУГ котла ТГМ-84 ст. №5 Балаковской ТЭЦ-4 выполнен в соответ-

ствии с «Техническим заданием на модернизацию автоматизированной системы управления горел-

### ками котлоагрегата ТГМ-84 ст. №5 с применением блоков газооборудования БГ-8 ЗАО «АМАКС» Внедрение АСУГ котла позволяет: - обеспечить требования безопасности в газовом хозяйстве согласно действующим правилам

и нормативным документам;
- повысить эксплутационные характеристики оборудования;
- повысить производительность и улучшить условия труда эксплуатационного персонала;
- повысить экономичность работы оборудования.

### - снизить аварийность в работе оборудования за счет оптимального управления и своевре-

менной коррекции параметров систем контроля и управления;

### - снизить вероятность ошибочных действий оперативного персонала за счет своевременного

представления информации в наглядном виде;

### - снизить топливную составляющую стоимости электроэнергии за счет повышения эффек-

тивности использования топлива.

Лист
422-ТГМ84-АГСВ-ПЗ | 2
Изм | Лист | N докум | Подп. | Дата
Файл | Формат: А4

### АСУГ котла предназначена для эффективного и надежного управления технологическими

процессами котлоагрегата ТГМ-84 ст. №5 Балаковской ТЭЦ-4 при пусках и остановах и в режиме

### нормальной эксплуатации, путем реализации следующих основных функций: -сбор и первичная обработка информации о состоянии объектов воздушного и газового трак-

тов горелок (клапаны, шиберы, запально-защитные устройства);

### -сбор и первичная обработка входных сигналов от датчиков автоматического регулирования

тепловой нагрузки и соотношения «газ-воздух» горелок;

### -передача управляющих воздействий на регулирующие органы регулятора тепловой нагрузки

и соотношения «газ-воздух» горелок;

### -передача управляющих воздействий при автоматическом и дистанционном управлении ис-

полнительными механизмами блоков газооборудования (БГ) горелок;
-выполнение локальных технологических защит и блокировок на работающих горелках;

### - выполнение алгоритмов контроля и управления газовыми горелками котлоагрегата на авто-

матизированном рабочем месте машиниста котла.

2. АВТОМАТИЧЕСКАЯ СИСТЕМА УПРАВЛЕНИЯ ГОРЕЛКАМИ.

### Разработанный проект не предполагает изменения:

- существующей схемы газоснабжения котлоагрегата ст. №5;

### - существующих схем информационно-измерительной системы, системы автоматического ре-

гулирования, системы технологических защит и защитных блокировок котлоагрегата ст.№5;

### - cуществующих аналоговых и дискретных датчиков, мест их установки и функционального

назначения;
- схем управления запорной и регулирующей арматурой котлоагрегата ст.№5;

### - системы управления мазутными горелками и оборудованием мазутного тракта котлоагрега-

та ст.№5.

### Проект предусматривает корректировку проектной документации ПМН-40/06-АГСВ в части изменения аппаратной и программной реализации схемы управления газовыми горелками котло-

агрегата.

Структурную схему комплекса технических средств – смотри чертеж 422-5ТГМ84-АГСВ-02.

### «Верхний уровень управления» представляет из себя систему, реализованную на подключенных по схеме «горячего резерва» операторских станциях и выполняющую функции сбора и обра-

ботки информации о выполнении процессов розжига котла на газе, рабочего управления горелка-

### ми котла, останова котла, визаулизации полученной информации, дистанционного управления в ручном или автоматическом режиме исполнительными органами всей системы, связи с другими системами котла. В качестве управляющей программы выбрана система MasterSCADA, осуществ-

ляющая связь с контроллерами по сети Ethernet.

### «Средний уровень управления» выполнен на базе микропроцессорного комплекса «Контраст», производства ЗАО «Волмаг», и состоящего:

Лист
422-ТГМ84-АГСВ-ПЗ | 3
Изм | Лист | N докум | Подп. | Дата
Файл | Формат: А4

### - из резервируемых блоков контроллера БК-500К-06 с модулями УСО, обеспечивающих функции общегорелочного контроля и управления, в том числе технологических защит и

блокировок, ситуационной сигнализации;

- из горелочных микроконтроллеров МК-500-10-10, обеспечивающих приём и обработку информации от датчиков параметров работы каждой горелки и формирующих управляющие воздействия на арматуру газовых блоков и шибера воздуха горелок, с учётом выполнения «горелочных» блокировок и защит, под управлением системного контроллера (или по командам, формируемым панелью оператора), а также данных, получаемых и от действующей об-

щекотловой системы ТЗиЗБ.

### На аппаратном «среднем уровне управления» в состав АСУГ входят:

- 4 блока газооборудования БГ-8 производства ЗАО « АМАКС»;

### - 4 устройства связи с объектом, выполненных в виде отдельных шкафов (1…4ШУГ-ТГМ) и

предназначенных для управления блоками газооборудования;
- один центральный шкаф управления горелками (ЦШУГ-ТГМ).

### Установленные блоки газооборудования горелок обеспечивают: - проверку плотности газовой арматуры данных блоков, что исключает загазованность топки

котла;

### - автоматический розжиг горелок на пониженном давлении газа, что полностью устраняет

возможность “хлопка” в топке;
- автоматическое регулирование соотношения ”газ-воздух” горелок;
- автоматическое регулирование тепловой нагрузки горелок;

### - легкую разборку и ремонт как предохранительно-запорных клапанов (ПЗК), так и всего бло-

ка в целом;

### Проектом предусматривается три варианта режима работы горелок на газе:

### Режим №1: управление по командам машиниста с ЦТЩ-3 в автоматическом режиме с ис-

пользованием клавиатуры и мыши на АРМ машиниста котла;

### Режим №2: управление по командам машиниста в автоматическом режиме от шкафа 1(2,3,4)

ШУГ-ТГМ;

### Режим №3: управление по командам машиниста в дистанционном режиме. Управление элементами блока газооборудования каждой горелки осуществляется с панели оператора шкафа 1…4ШУГ-ТГМ при соблюдении основных технологических блокировок. В качестве панелей опе-

ратора выбран Weintek 8071iE. Этот режим используется при наладке АСУГ, при отказе контроллеров «среднего уровня управления» или операторских станций АРМ машиниста котла (для подачи

### запального газа при растопке котлоагрегата на мазуте), или нарушении связи между уровнями

управления.
Функциональную схему автоматизации – смотри чертеж 422-5ТГМ84-АГСВ-03.

### В проекте выполнена система контроля давления газа перед горелками и давления воздуха

перед горелками, задействованными в схемах автоматического регулирования и ТЗиЗБ, с исполь-

### зованием существующей аппаратуры и приборов, устанавливаемыми по месту на блоках газообо-

рудования горелок и на индивидуальных стендах датчиков горелок N1- N4.

Лист
422-ТГМ84-АГСВ-ПЗ | 4
Изм | Лист | N докум | Подп. | Дата
Файл | Формат: А4

Управление регулирующими заслонками газа, входящими в состав блока газооборудования каждой горелки, осуществляется через микроконтроллеры шкафов 1(2,3,4)ШУГ-ТГМ автоматически от контроллеров шкафа ЦШУГ-ТГМ или дистанционно с панелей оператора, расположенных в шкафах 1(2,3,4)ШУГ-ТГМ. Подача управляющих воздействий на регулирующие заслонки газа

осуществляется контактами дискретных выходов горелочных микроконтроллеров через блоки уси-

### ления мощности на входы «Больше», «Меньше» существующих бесконтактных реверсивных пус-

кателей. После полного открытия регулирующей заслонки газа горелок, регулирование топливным режимом передается на существующий общекотловой регулятор газа.

### Принципиальную электрическую схему регулирования давления газа перед горелками (регу-

лирования тепловой нагрузки горелок) - смотри чертеж 422-5ТГМ84-АГСВ-05.

### Так же с помощью контроллеров центрального шкафа управления через шкафы 1(2,3,4)ШУГ-

ТГМ осуществляется автоматическое регулирование соотношения “газ-воздух” горелок с воздействием на исполнительные механизмы шиберов воздуха горелок.

### Принципиальную электрическую схему регулирования соотношения “газ-воздух” горелок -

смотри чертеж 422-5ТГМ84-АГСВ-04.

### Управление открытием предохранительно-запорных клапанов блоков газооборудования выполняется путём подачи напряжения на их управляющие входы, производящего их взвод и удер-

жание в открытом состоянии. Закрытие ПЗК производится снятием удерживающего напряжения.

Подача управляющих воздействий (подача/съём напряжения питания) на предохранительнозапорные клапаны осуществляется контактами дискретных выходов горелочных микроконтроллеров через блоки усиления мощности. Для реализации алгоритма ввода защиты по невоспламенению/погасанию факела горелки дополнительно организован контроль положения ПЗК-2 до 30%

полного открытия.

### Принципиальные электрические схемы управления ПЗК-1 и ПЗК-2 - смотри чертежи 422-

5ТГМ84-АГСВ-08, 422-5ТГМ84-АГСВ-09.

### Розжиг горелки возможен только после проведения предпусковой проверки герметичности

быстрозапорной арматуры газового блока. Розжиг горелки выполняется методом подхвата основ-

### ной горелкой пламени запальной горелки при его устойчивой фиксации. Зажигание запальника

организованно подачей искры от существующего высоковольтного трансформатора при открытии, подающего газ на запальник, клапана. Подача управляющих воздействий (подача/съём напряжения питания) на клапаны опрессовки, запальника, на трансформатор зажигания, а так же клапан свечи

### безопасности осуществляется контактами дискретных выходов горелочных микроконтроллеров

через блоки усиления мощности.

### В проекте выполнены схема контроля факела горелки с использованием устройства контроля пламени ФДСА-03М-01 и схема контроля пламени запальника с использованием датчика контроля

ДПЗ-01А/24К. Дискретные сигналы о наличии сигналов пламени горелки и факела запальника по-

### ступают на соответствующие входы микроконтроллеров шкафов 1(2,3,4)ШУГ-ТГМ Принципиальную электрическую управления розжигом горелок – смотри чертеж 422-

5ТГМ84-АГСВ-06.

### В АСУГ реализованы следующие защиты и блокировки: - При срабатывании технологических защит, действующих на отключение подачи газа к котлу и горелкам, дискретный сигнал принимается контроллерами шкафа ЦШУГ-ТГМ, которые фор-

мируют команду горелочным микроконтроллерам на выполнение алгоритма останова горелок.

Лист
422-ТГМ84-АГСВ-ПЗ | 5
Изм | Лист | N докум | Подп. | Дата
Файл | Формат: А4

### Этот же дискретный сигнал, по проложенным физическим линиям связи, поступает в каждый из шкафов 1…4ШУГ-ТГМ, воздействуя на отключение всех блоков газооборудования (закрытие ПЗК-

1, ПЗК-2, отключение ЗЗУ, открытие свечей безопасности).

### - Контроллерами шкафа ЦШУГ-ТГМ реализуется алгоритм защиты «Невоспламенение пер-

вой, погасание всех горелок при растопке котла на газе», при срабатывании которой отключаются

### все блоки газооборудования горелок (в том числе и сигналами от модулей УСО шкафа ЦШУГ-ТГМ по вновь прокладываемым физическим линиям связи) и модулями УСО формируется им-

пульсный сигнал на прекращение подачи газа к котлу.

### - Понижение давления газа перед горелкой – действует на отключение блока газооборудова-

ния данной горелки.

### - Понижение давления воздуха перед горелкой (при растопке) – действует на отключение

блока газооборудования данной горелки.

### - Закрытие воздушного шибера горелки – действует на отключение блока газооборудования

данной горелки.

### - Погасание факела горелки – действует на отключение блока газооборудования данной го-

релки.

### - Запрет открытия задвижки газа к котлу при незакрытом положении любого из ПЗК-1 газа к

горелкам.

### - Запрет открытия ПЗК-1 и клапана газа к запальнику горелки, включение трансформатора

зажигания без вентиляции топки в течение промежутка времени не менее 10 мин.

### - Запрет открытия задвижки на газопроводе-отводе при незакрытом положении хотя бы од-

ного из ПЗК-1 блоков газооборудования горелок.
- Закрытие клапана свечи безопасности при открытии ПЗК-1 данной горелки.
- Открытие клапана свечи безопасности при закрытии ПЗК-1 данной горелки.

### - Запрет открытия всех клапанов перед ЗЗУ и всех ПЗК перед горелками до окончания опера-

ции опрессовки блоков газооборудовния всех горелок.
- Запрет открытия ПЗК-2 перед горелкой при отсутствии пламени запальника этой горелки.
- Запрет открытия ПЗК-2 перед горелкой при незакрытой заслонке газа данной горелки.

### - Запрет открытия ПЗК-2 перед горелкой при незакрытом шибере воздуха перед этой горел-

кой.

### - Запрет операций розжига (при растопке котла) при наличии ложного сигнала о наличии фа-

кела любой горелки.

### Проектом предусмотрена реализация автоматического ввода защиты по погасанию общего

факела в топке котла (все приборы (Факел – 3М) показали наличие факела в обеих полутопках и расход газа больше 35%).

### Для реализации алгоритмов управления горелками, при потере связи со шкафом ЦШУГ-ТГМ, по вновь прокладываемым физическим линиям связи микроконтроллеры шкафов 1(2,3,4)ШУГ-ТГМ принимают сигналы о повышении давления газа до номинального уровня и о

вводе защиты по погасанию общего факела в топке котла.

### Для повышения надёжности работы сигналы из существующей системы ТЗиЗБ (о прекраще-

нии подачи газа к котлу, о завершении вентиляции) по вновь прокладываемым физическим линиям

Лист
422-ТГМ84-АГСВ-ПЗ | 6
Изм | Лист | N докум | Подп. | Дата
Файл | Формат: А4

связи непосредственно воздействуют на цепи питания оборудования газовых блоков горелок (ПЗК-1, ПЗК-2, клапаны запальника, трансформаторы зажигания).

### Существующая система технологической сигнализации принимает от АСУГ информацию о следующих аварийных ситуациях системы АСУГ: общесистемный «Вызов к операторской стан-

ции» и «Авария горелки (шкафа МИБГ)».

### Принципиальную электрическую схему дополнительных защит, блокировок и сигнализации –

смотри чертеж 422-5ТГМ84-АГСВ-07.

2. ЭЛЕКТРОПИТАНИЕ.

### Проектом предусмотрено применение инверторной системы «Форпост» (выходная мощность

– 10 кВт, выходное напряжение ~220В (необходимое для работы клапанов БГ-8 «АМАКС»)) с реа-

### лизацией основного питания всего КТС системы АСУГ от существующей схемы автоматического включения резерва (Ящик АВР АМАКС) и резервного питания (безударно подключаемого инвер-

торной системой) от сети =220В, с организацией общесистемных шин питания 1А65, 1Н65, РЕ.

Проектом, на случай какого-либо отказа инверторной системы и необходимости проведения ремонтных или регламентных работ на работающем котле, предусмотрено переключение на питание КТС системы АСУГ по байпасной линии только от источника основного напряжения (АВР АМАКС). Переключение выполняется переключателем QS3, расположенным в центральном шкафу

управления ЦШУГ-ТГМ.

### Питание, необходимое для работы микропроцессорного оборудования, организуется с использованием дублированных блоков питания OptiPower МDR100 (220В АС.DC / =24В, 4А) для

каждого шкафа управления системы. Один из двух блоков питается от источника общесистемного напряжения ~220В, другой получает питание от резервной сети =220В. Выходы обоих блоков питания, через устройство согласования, образуют внутришкафную сеть питания =24В. Информация о неисправности любого из двух блоков питания каждого шкафа регистрируется.

### Проектом предусмотрена передача в существующую систему технологической сигнализации следующих сигналов о состоянии системы электропитания: «Сработало АВР АМАКС» - произошло переключение на резервный фидер подвода питания ~220В; «Пропало напряжение 220В по-

стоянного тока» - срабатывание реле контроля напряжения на входе =220В системы «Форпост» и работа ведётся только от основного источника питания; «Авария инвертора АМАКС» - при полном пропадании напряжении ~220В на входе «Форпоста» и ведении работы от собственно инвертора от сети =220В; «Байпас инвертора включён» - при выводе из работы инверторной системы.

### Питание операторских станций выполнено от общесистемных шин ~220В через автоматические выключатели, смонтированные в поставляемых комплектно в металлоконструкциях автома-

тизированного рабочего места оператора.

### Принципиальную электрическую схему электропитания КТС ~220В/=220В/=24В - смотри

чертёж 422-5ТГМ84-АГСВ-10.

3. РАЗМЕЩЕНИЕ АППАРАТУРЫ И ЩИТОВЫХ УСТРОЙСТВ.

### Датчики, контролирующие технологических параметры сред при работе горелок, размещают-

ся на существующих стендах датчиков у блоков газооборудования.

Лист
422-ТГМ84-АГСВ-ПЗ | 7
Изм | Лист | N докум | Подп. | Дата
Файл | Формат: А4

### Устройства контроля факела горелок размещаются непосредственно на визирных трубах го-

релочных устройств с помощью стандартного узла крепления.

### Датчики контроля пламени запальных горелок (запальников) размещаются в непосредствен-

ной близости от горелочных устройств на существующих опорных металлоконструкциях.

### Шкафы управления горелками 1(2,3,4)ШУГ-ТГМ, в которых размещаются горелочные мик-

роконтроллеры, панели оператора, автоматические выключатели питания оборудования горелок, блоки питания оборудования шкафов, блоки питания датчиков давления газа и давления воздуха перед горелками, блоки усиления мощности, устанавливаются рядом с блоками газооборудования на отметках 8.00м и 11.00м. Эскиз общего вида шкафа - смотри чертёж 422-5ТГМ84-АГСВ-25.

### Шкаф ЦШУГ, в котором размещаются управляющие контроллеры, инверторная система, ав-

томатические выключатели питания оборудования, контактные переключатели питания, блоки пи-

### тания оборудования шкафа, модули УСО, блоки усиления мощности, устанавливается на ЦТЩ-3 в помещении неоперативного контура управления. Эскиз общего вида шкафа - смотри чертёж 422-

5ТГМ84-АГСВ-24.

### В проекте выполнены схемы соединений и подключений внешних проводок блоков газооборудования горелок с привязкой их к шкафам 1(2,3,4)ШУГ-ТГМ - смотри чертежи 422-5ТГМ84-

АГСВ-11(12, 13, 14).

### В проекте выполнена схема подключений внешних проводок шкафа ЦШУГ-ТГМ - смотри

чертеж 422-5ТГМ84-АГСВ-15.

### В проекте выполнены схемы дополнительных соединений и подключений существующих па-

нелей, оборудование в которых задействовано в реализации системы АСУГ: 5К-6 - смотри чертеж

### 422-5ТГМ84-АГСВ-16; 5К-5 - смотри чертеж 422-5ТГМ84-АГСВ-17; 5К-2 - смотри чертеж 422-

5ТГМ84-АГСВ-18; 5К-11 - смотри чертеж 422-5ТГМ84-АГСВ-19.

4. ОБЩИЕ ДАННЫЕ.

### При монтаже и эксплуатации должны выполняться организационно-технические мероприятия, обеспечивающие безопасные условия труда в соответствии с требованиями:

правил устройства и безопасной эксплуатации паровых и водогрейных котлов;
правил безопасности в системах газораспределения и газопотребления;

### правил технической эксплуатации и техники безопасности при эксплуатации электроустано-

вок (ПТЭ и ПТБ).

### Прокладку дополнительных кабелей и проводов Балаковская ТЭЦ-4 выполняет по существующим или вновь прокладываемым трассам в раздельных коробах – измерительные и силовые, в

соответствии со внешних проводок – смотри чертеж 422-5ТГМ84-АГСВ-20 и журналом кабелей.

Рабочие чертежи разработаны в соответствии с действующими нормами и правилами.

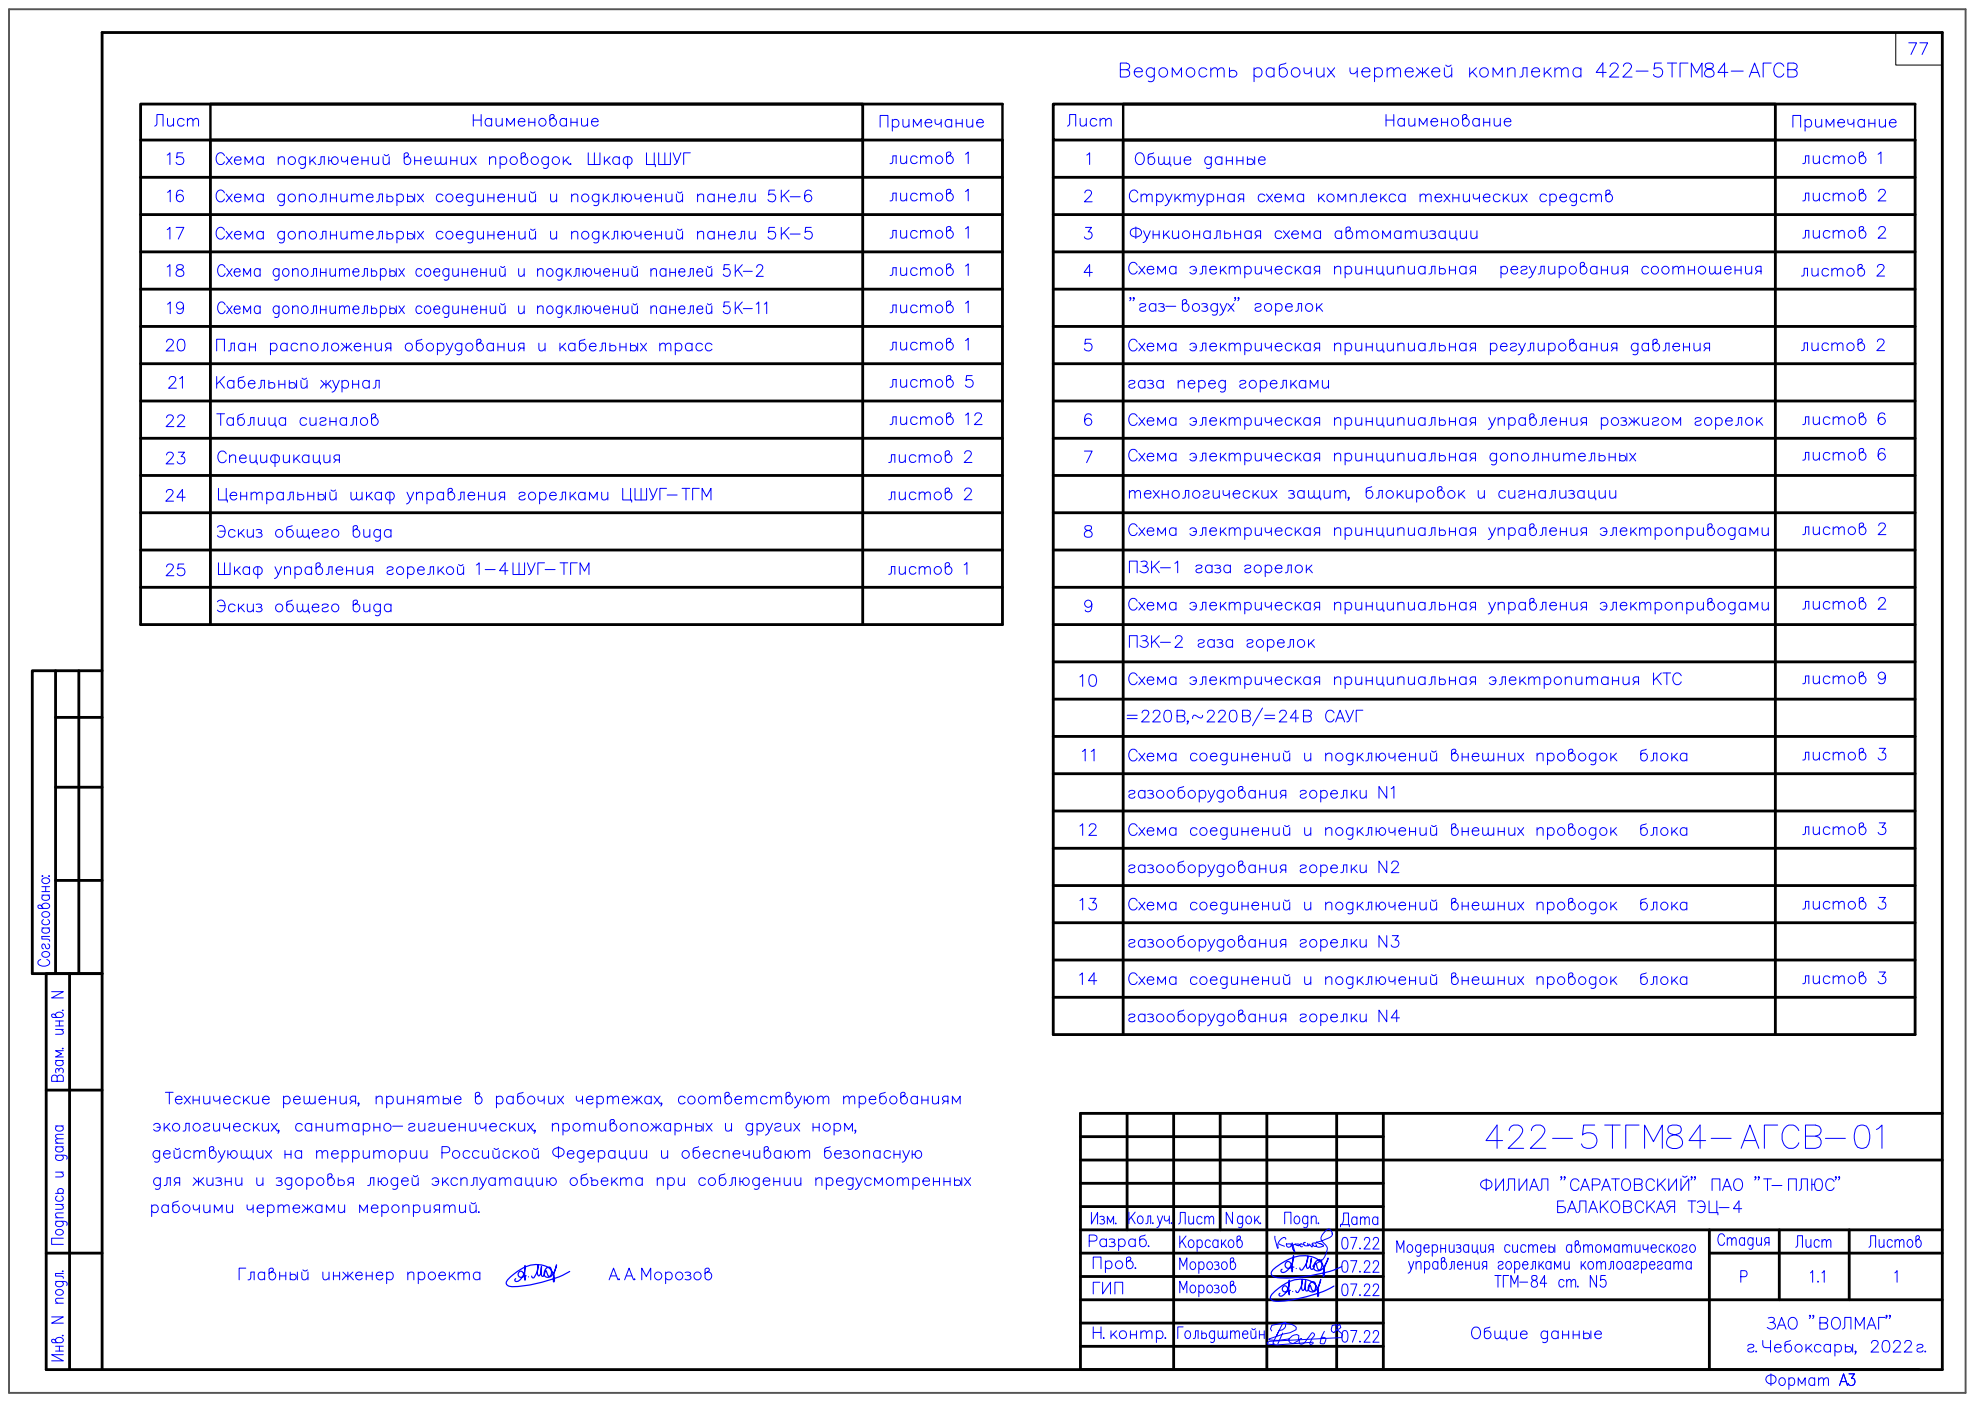
[picture p191: page 10]

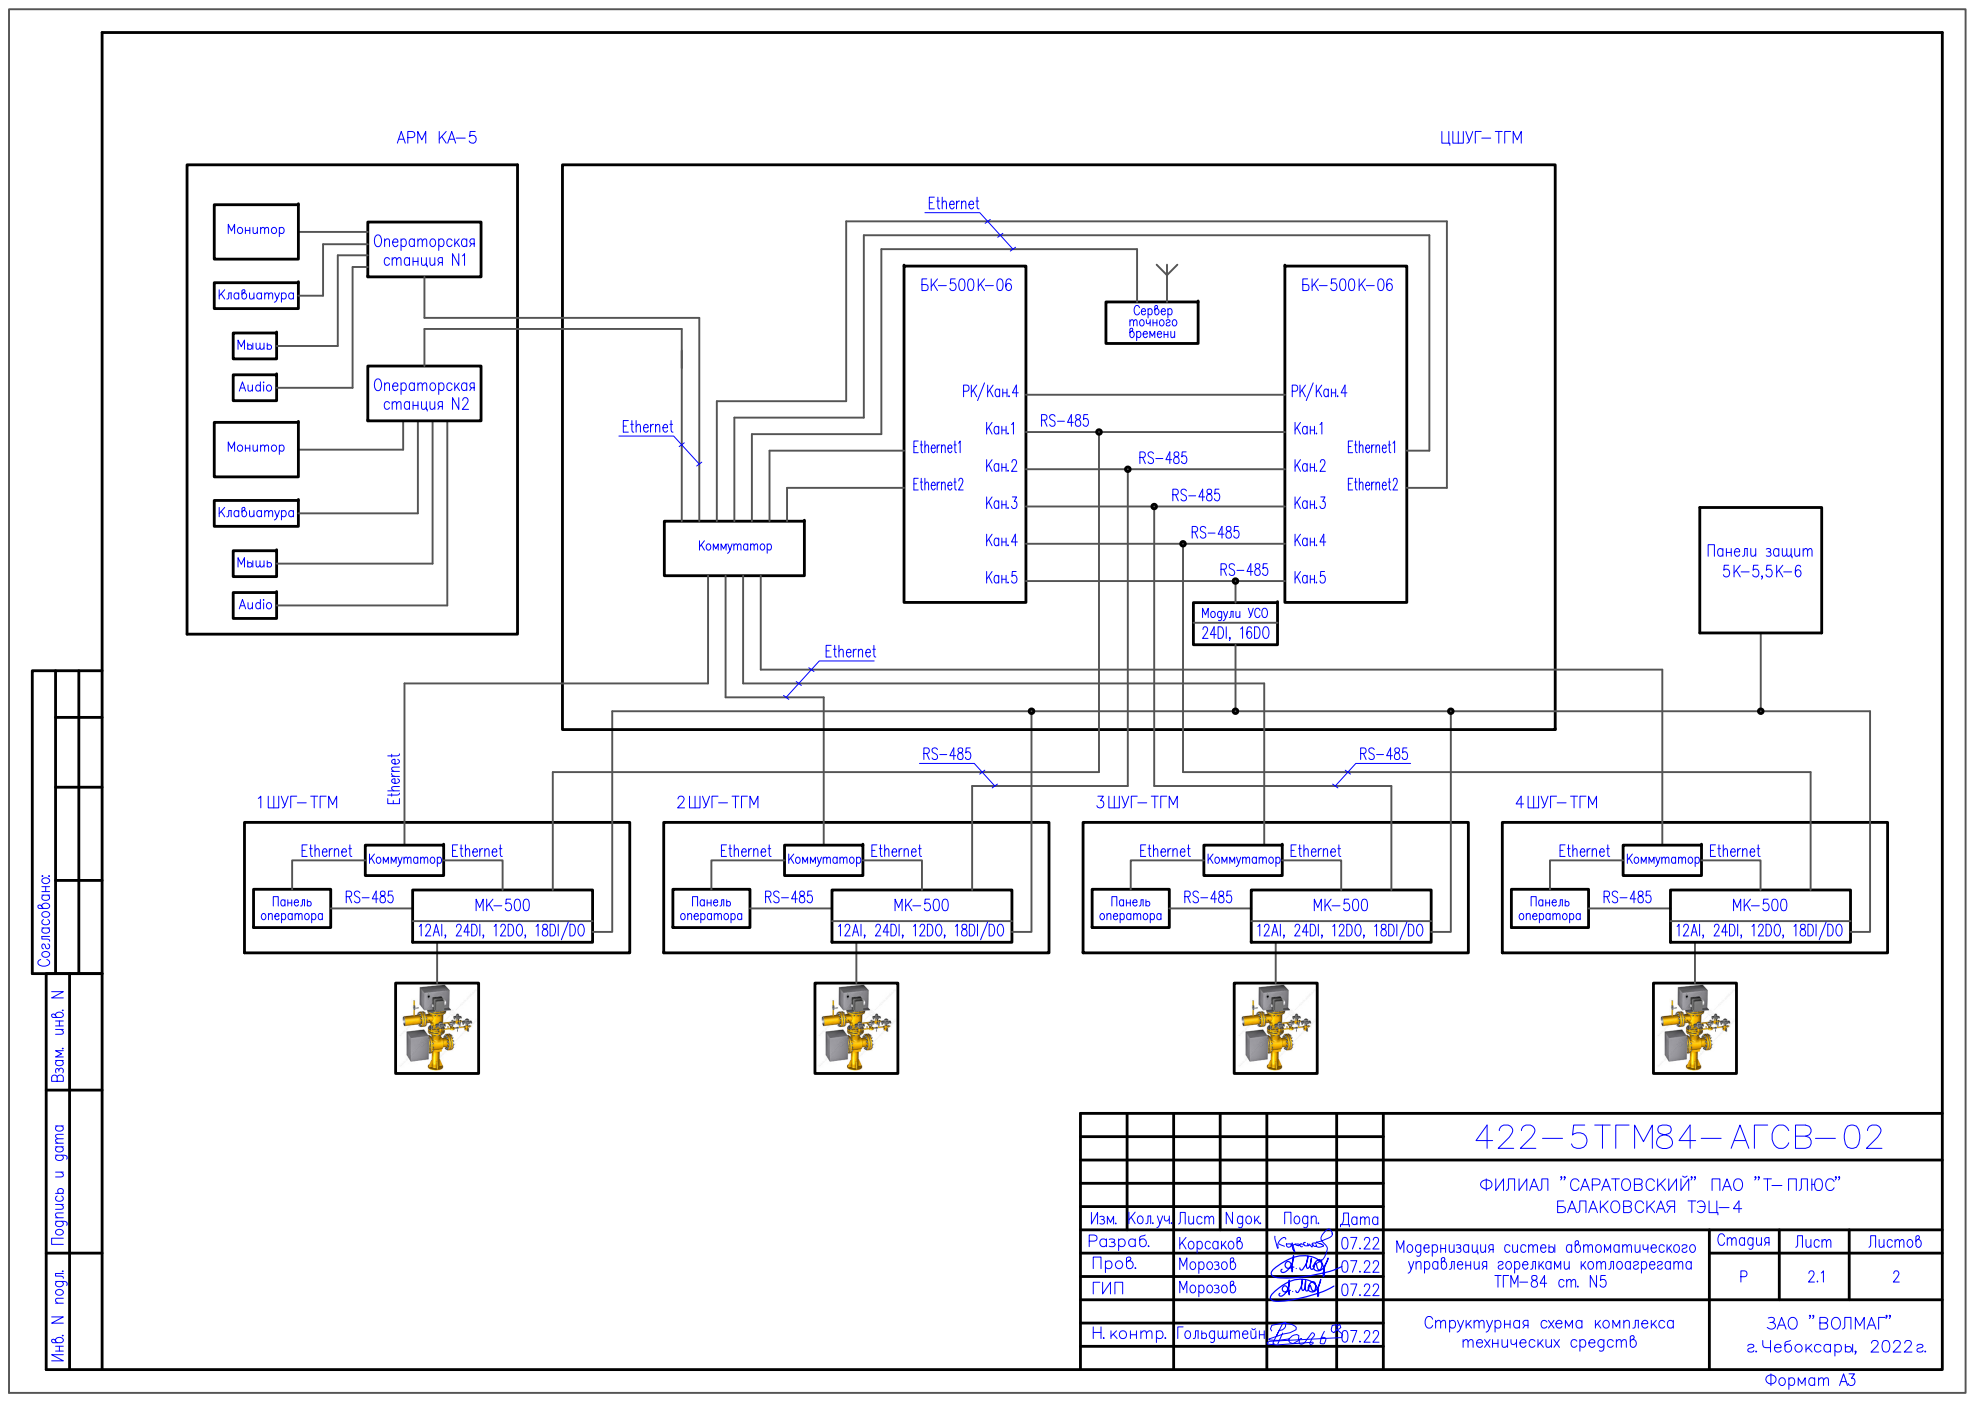
[picture p192: page 11]

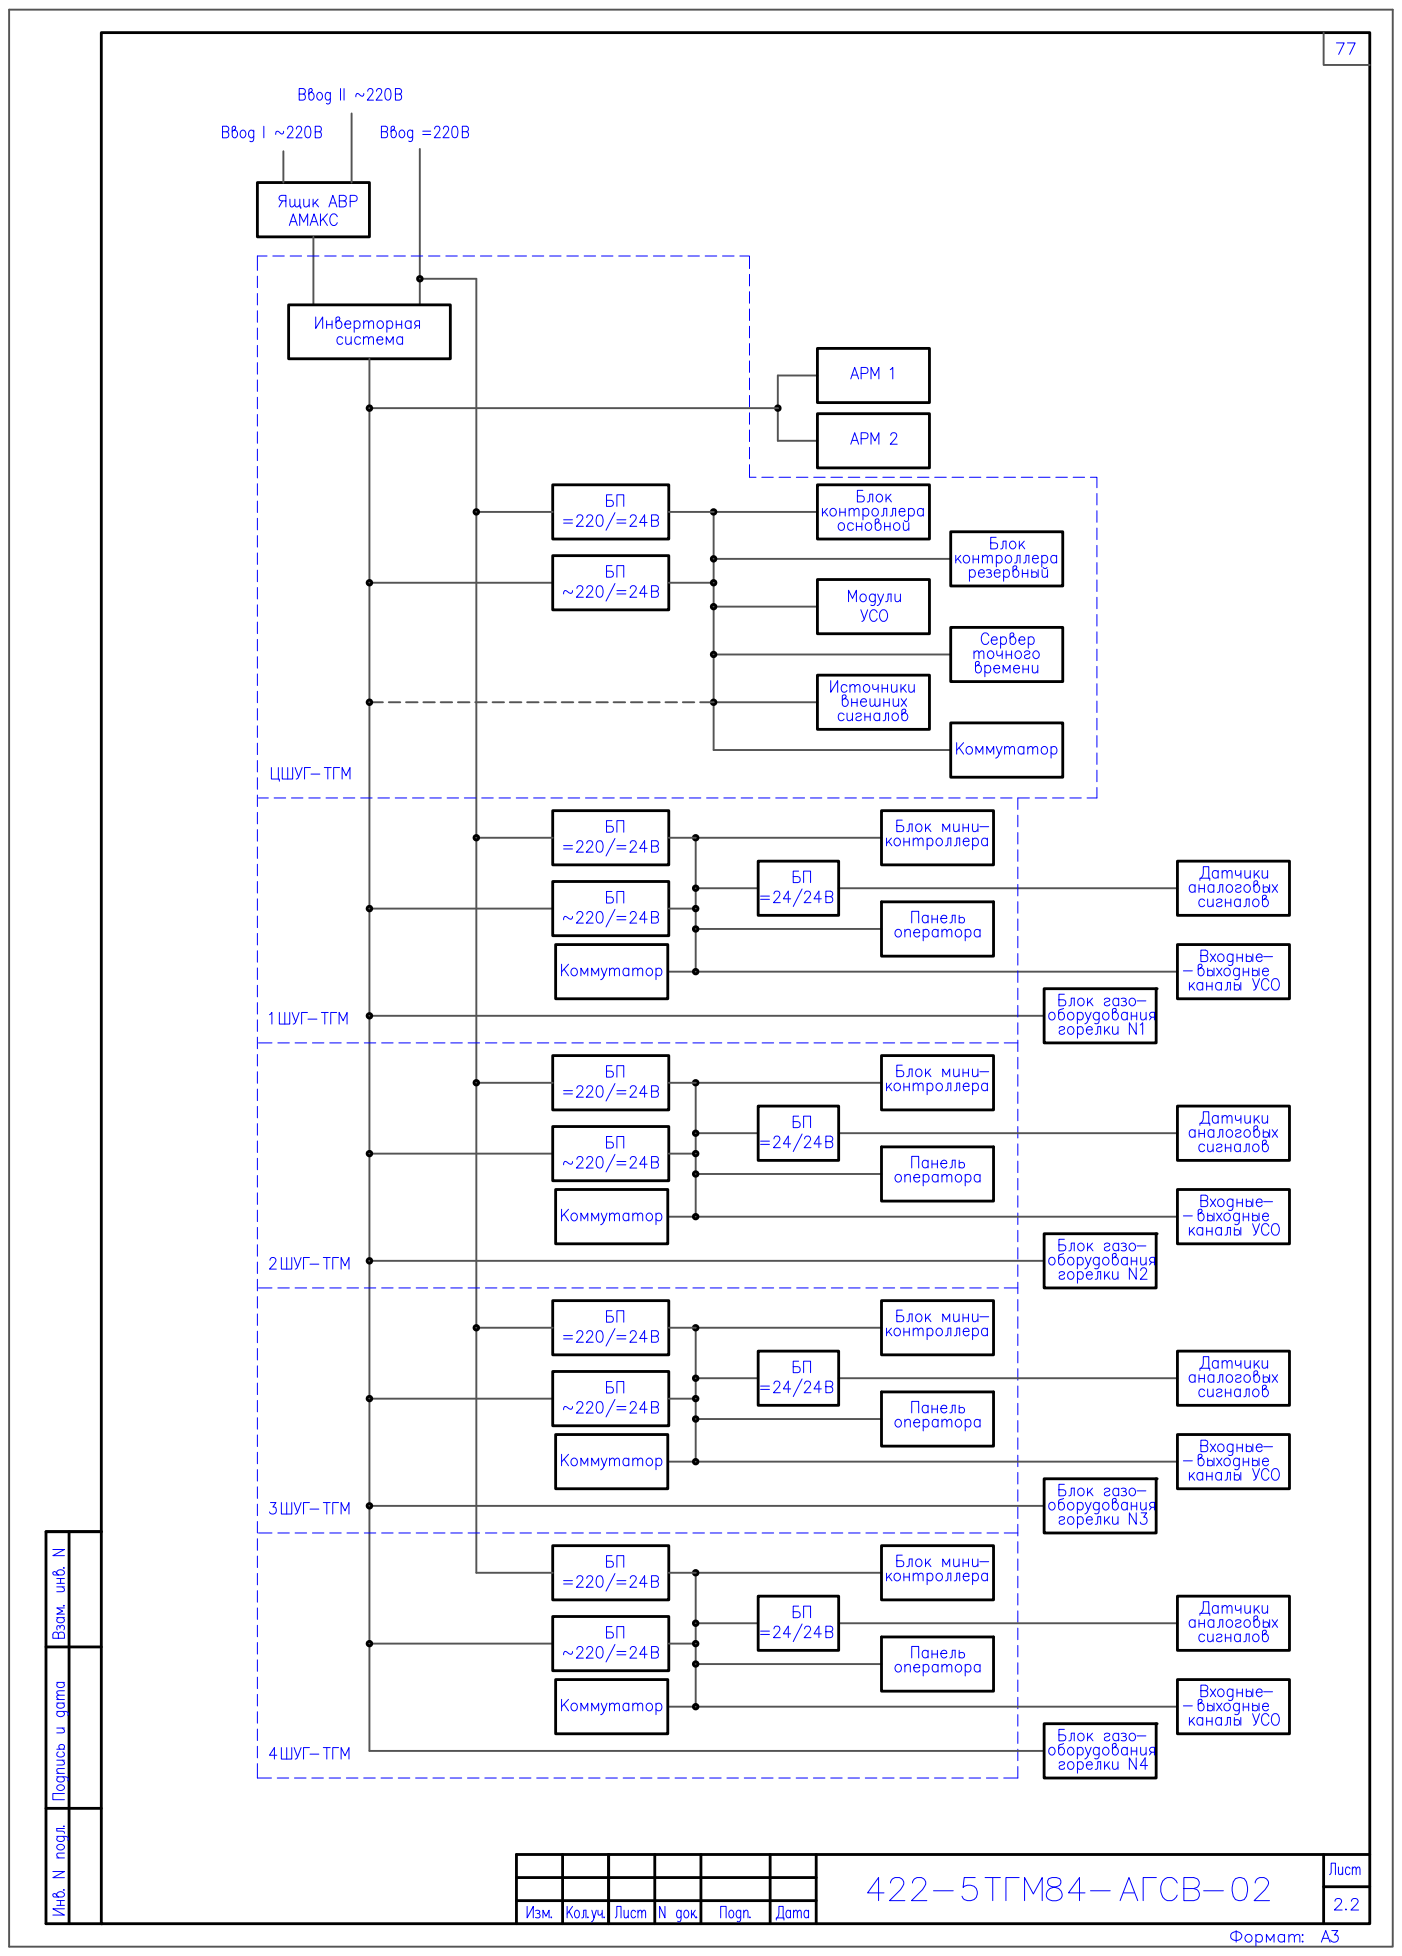
[picture p193: page 12]

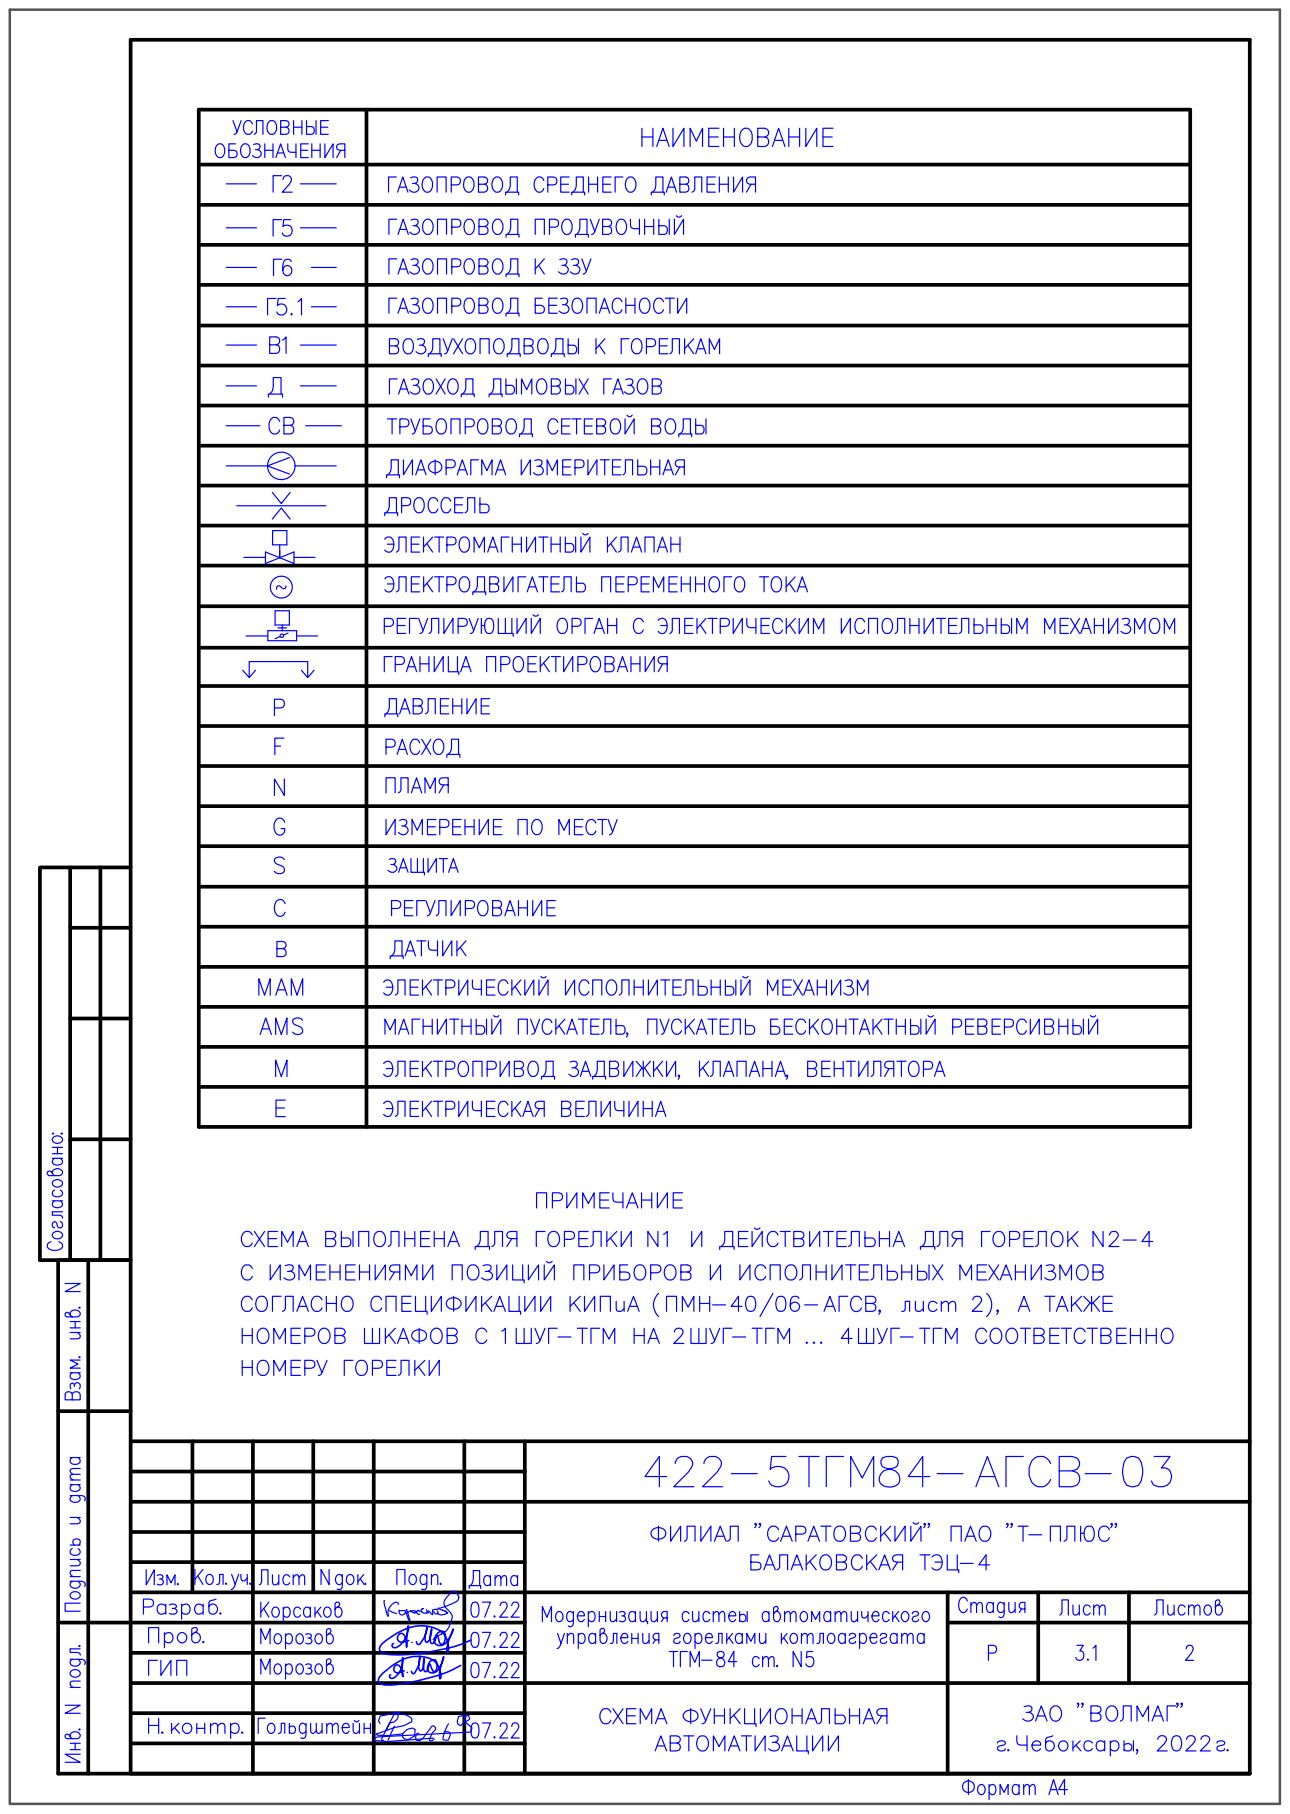
[picture p194: page 13]

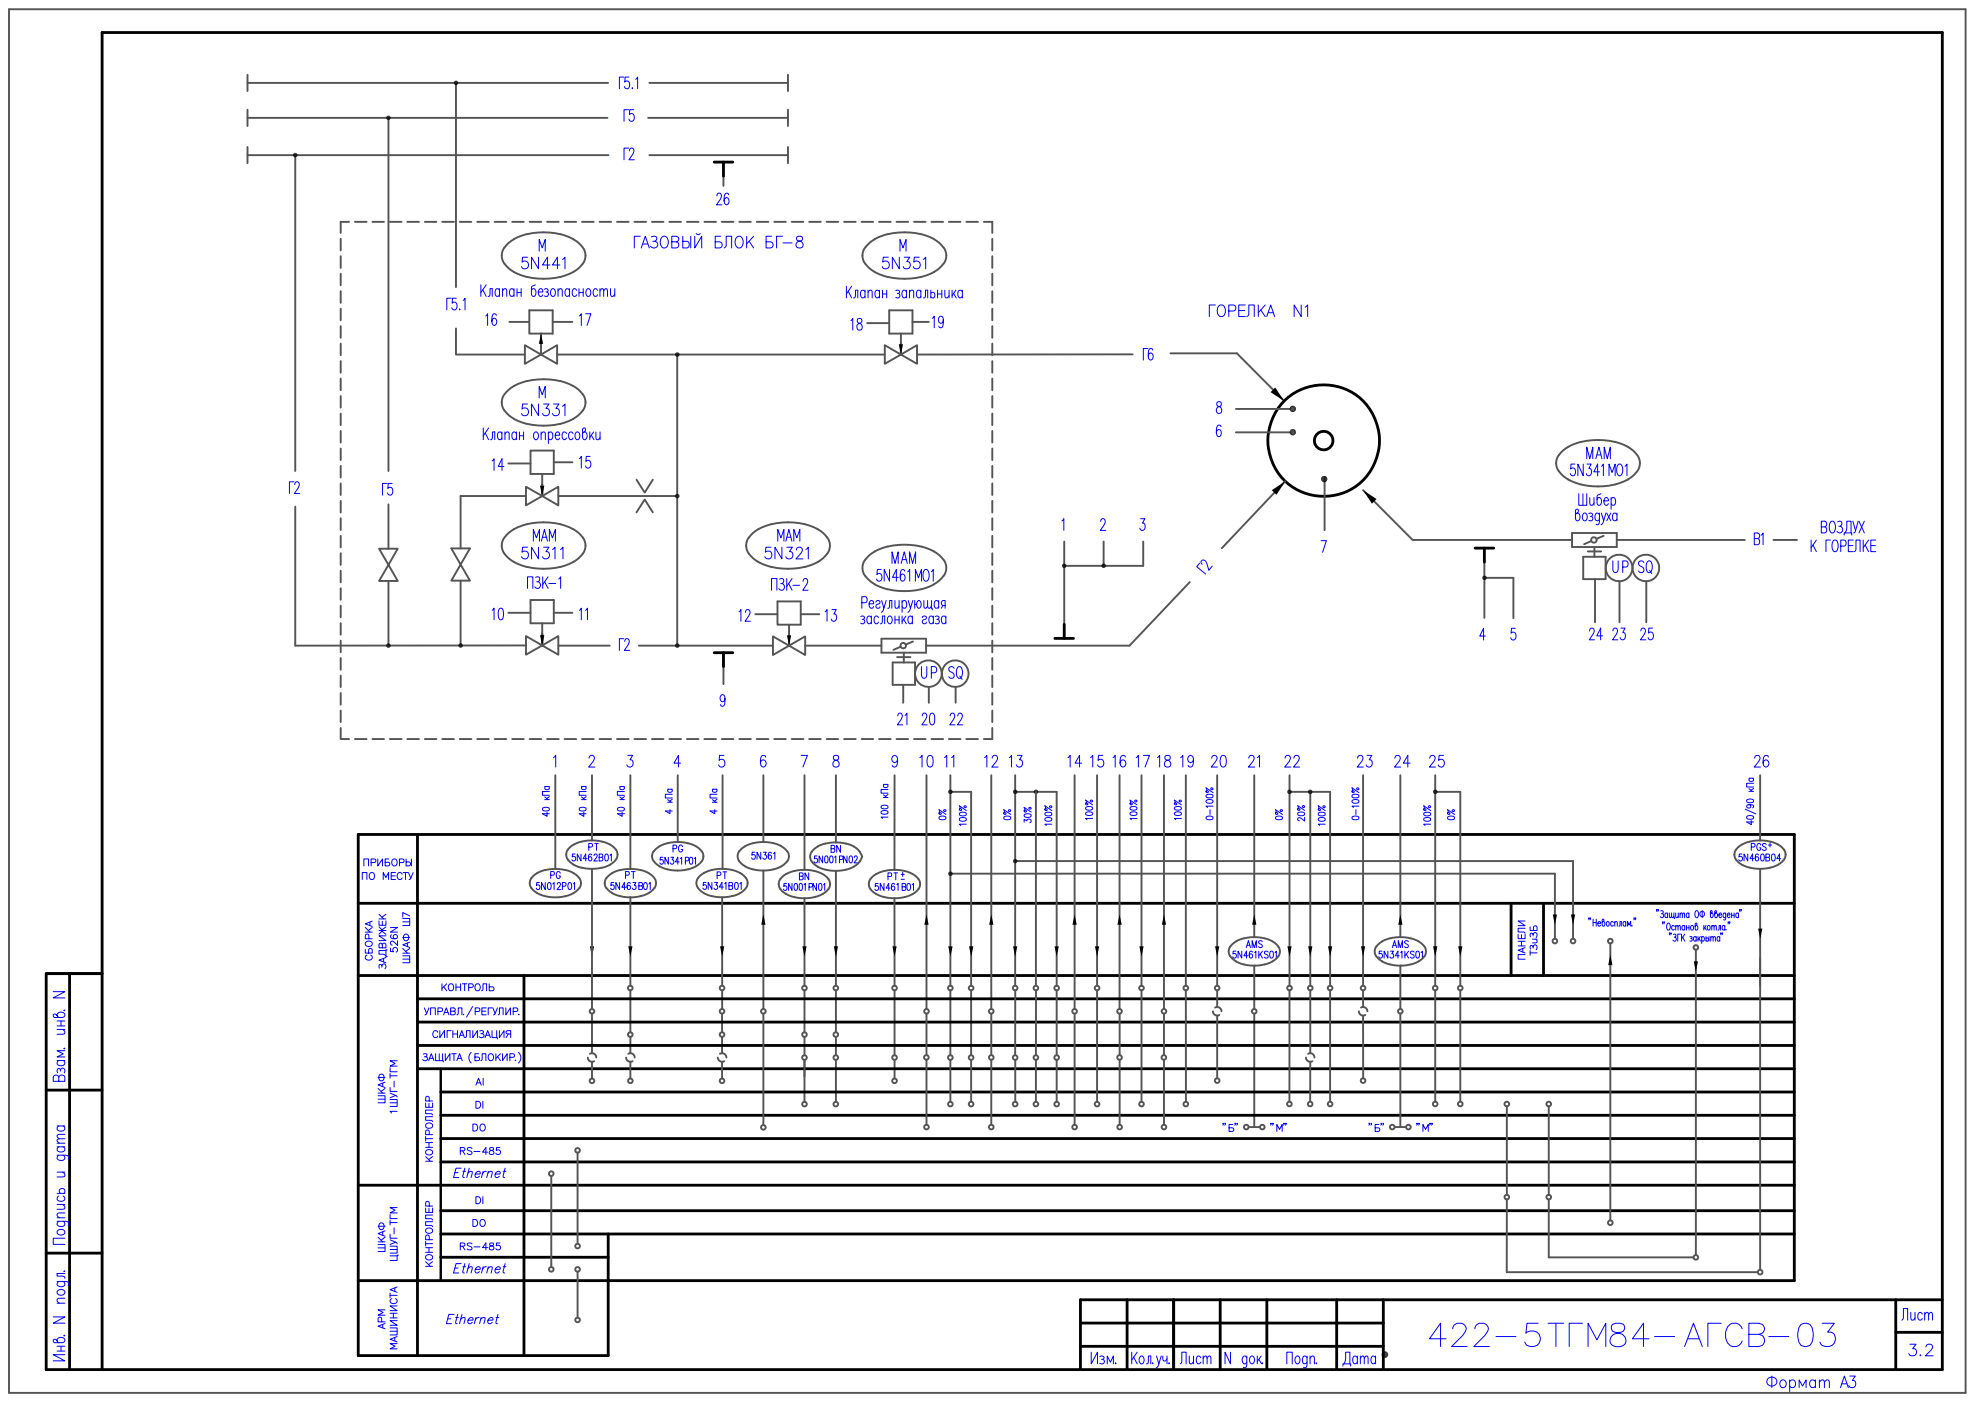
[picture p195: page 14]

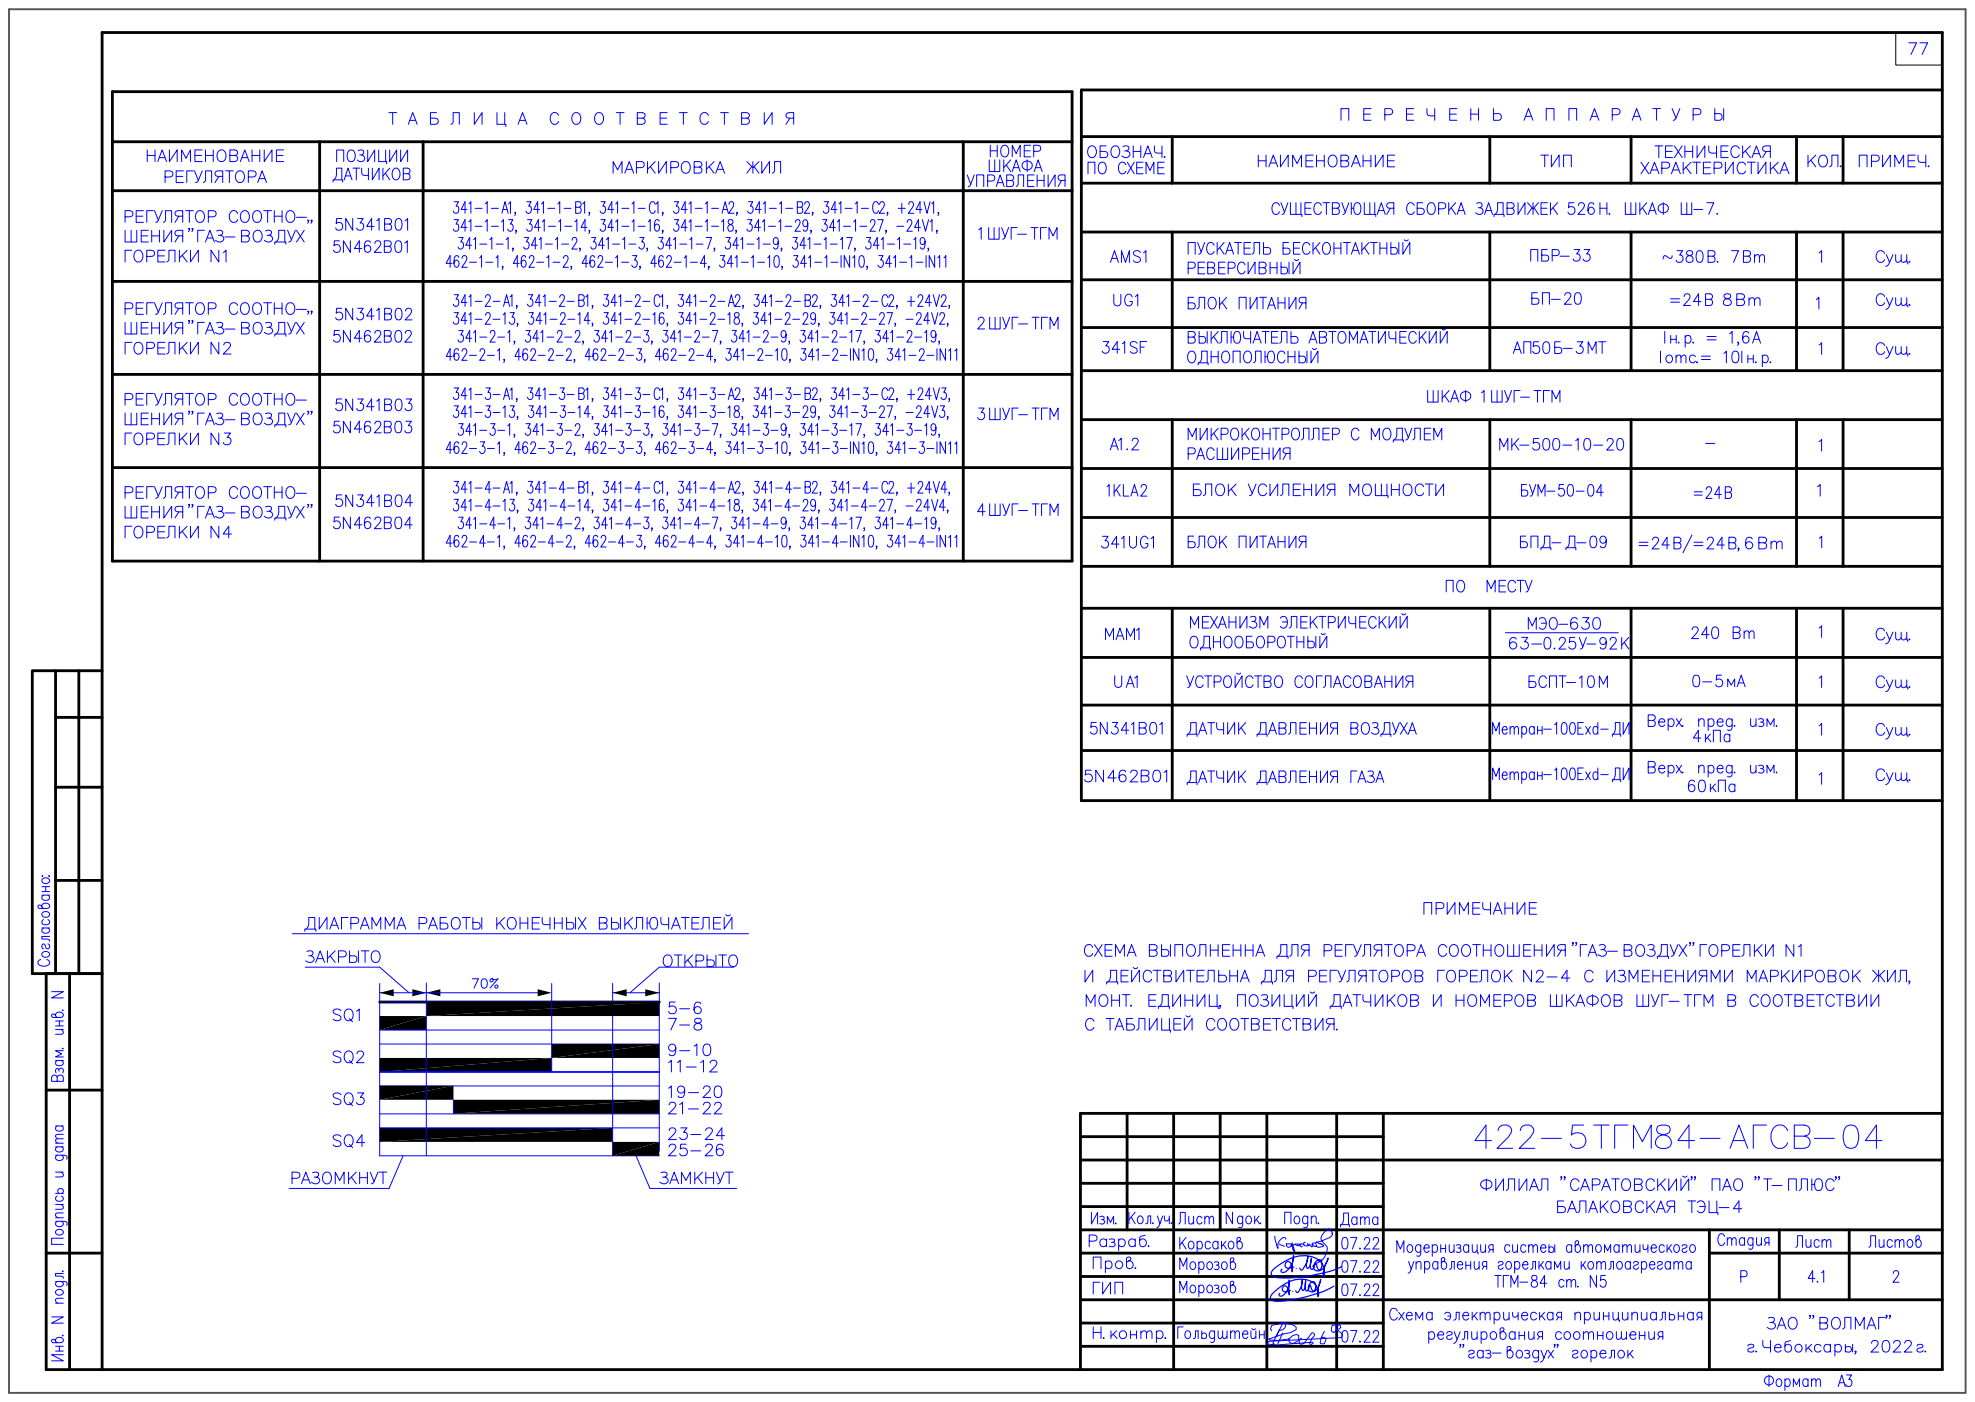
[picture p196: page 15]

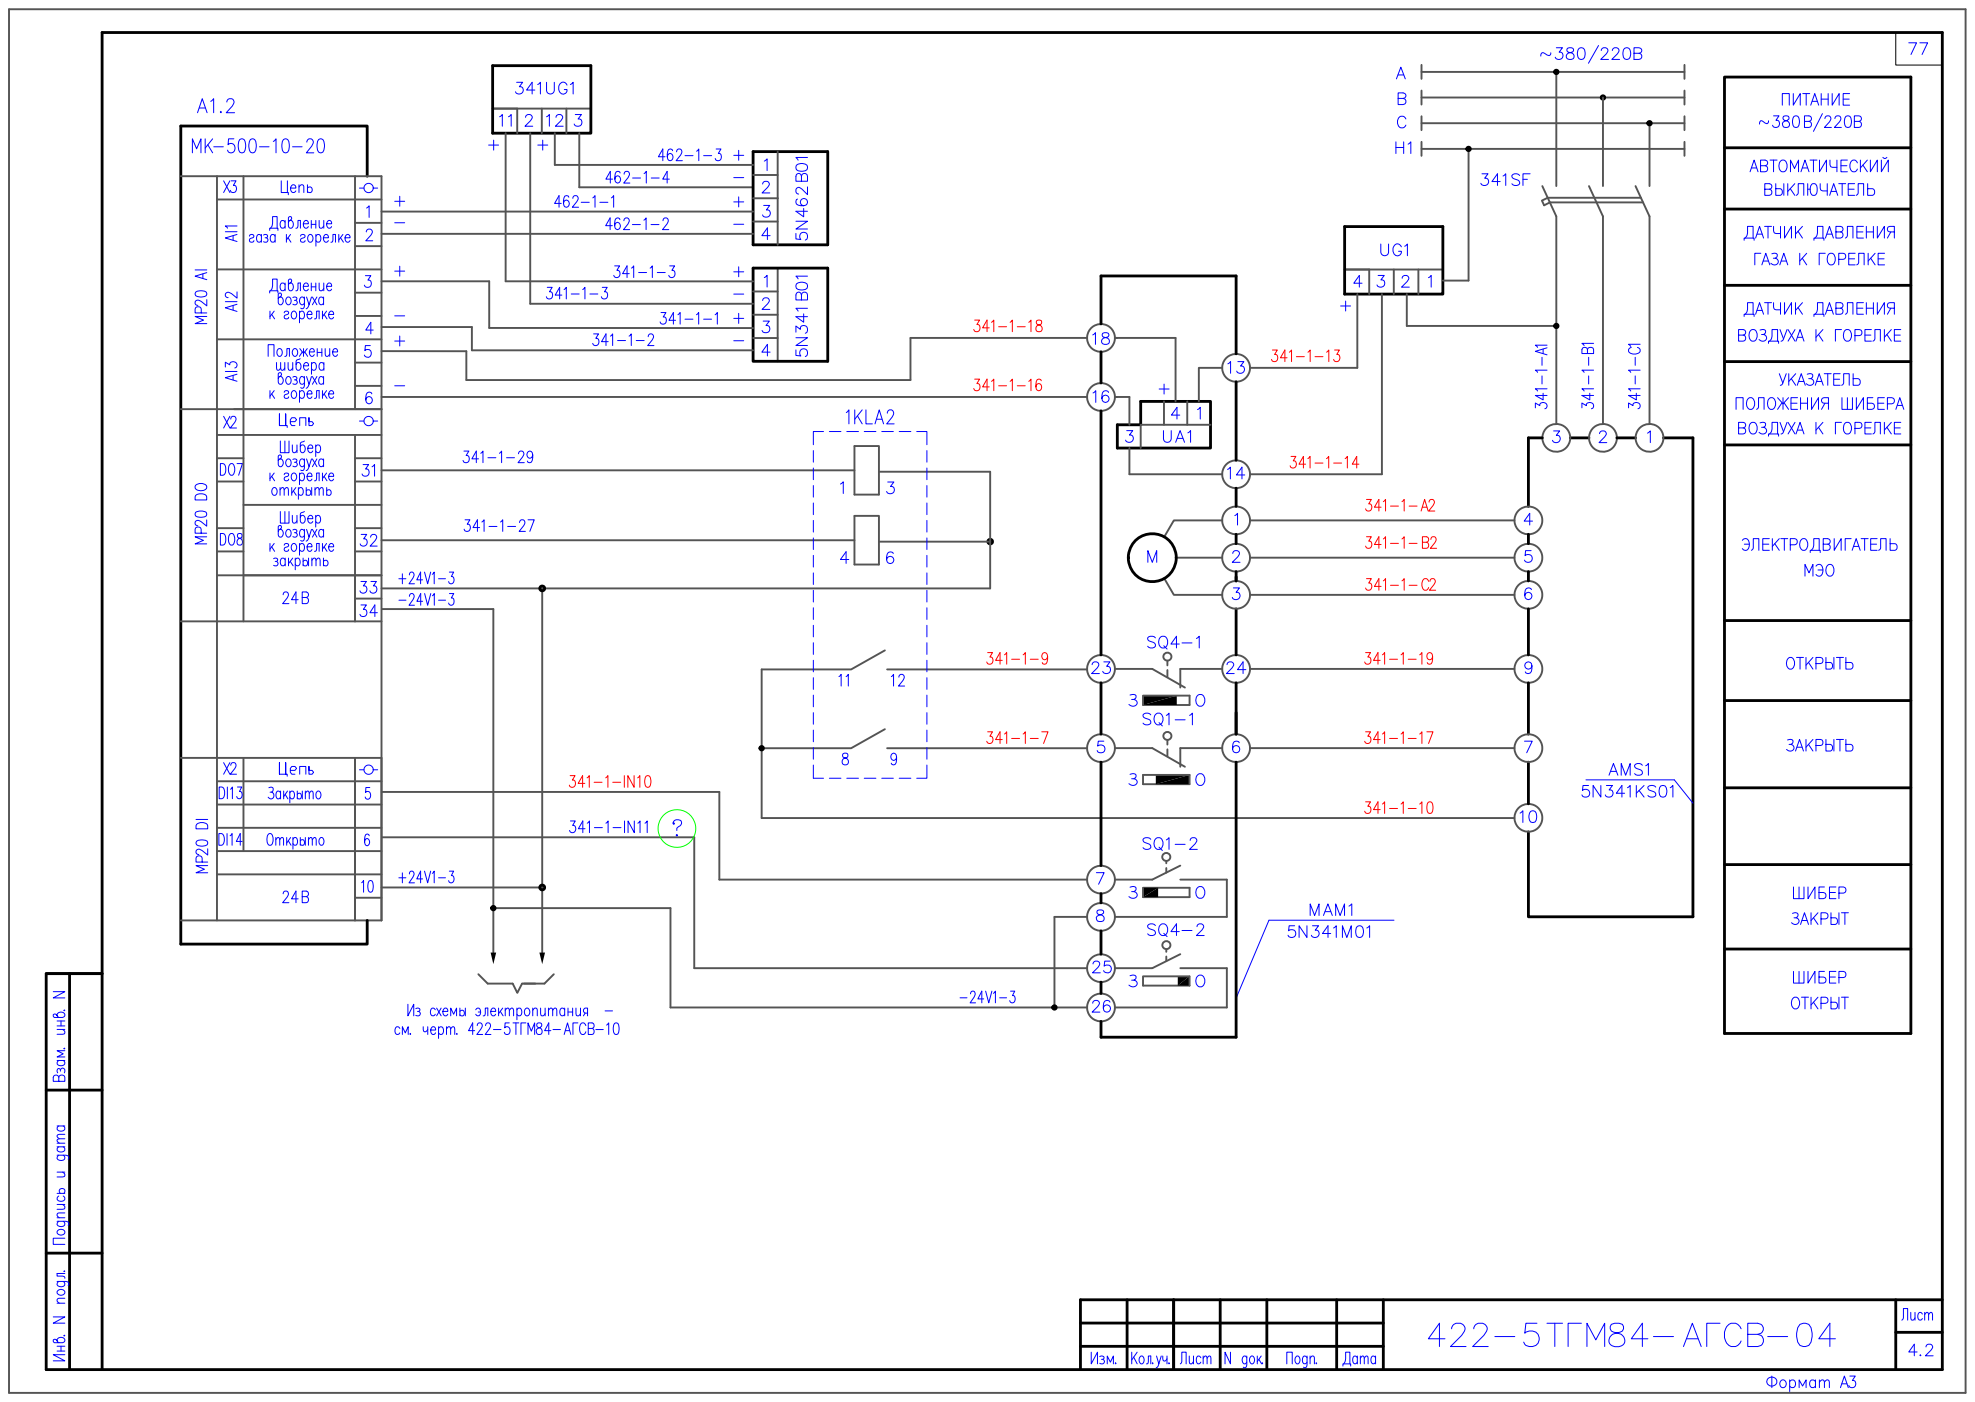
[picture p197: page 16]

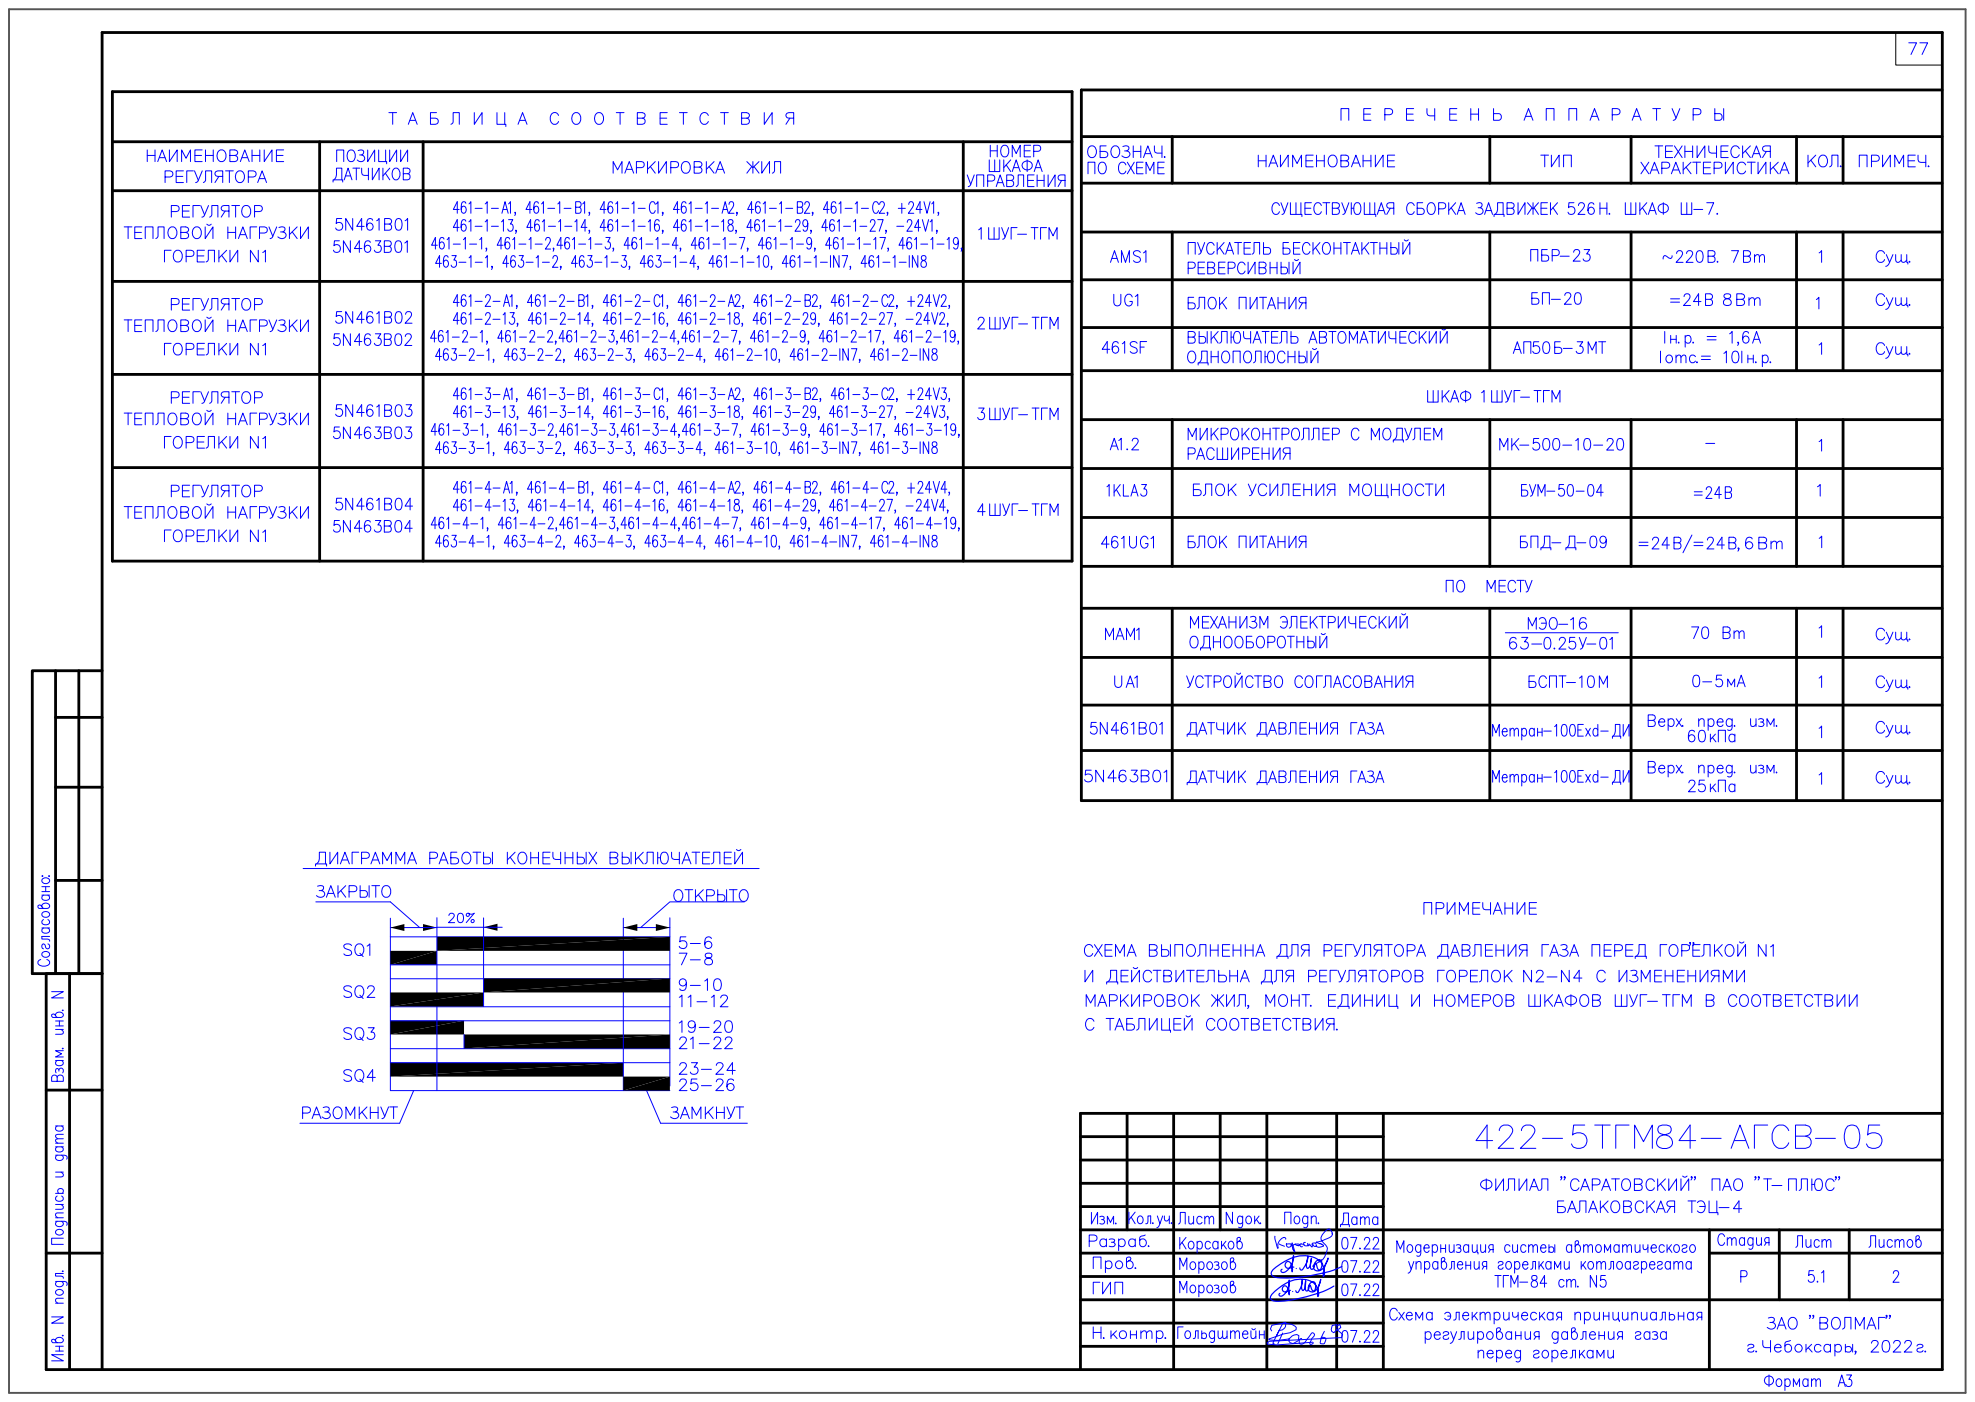
[picture p198: page 17]

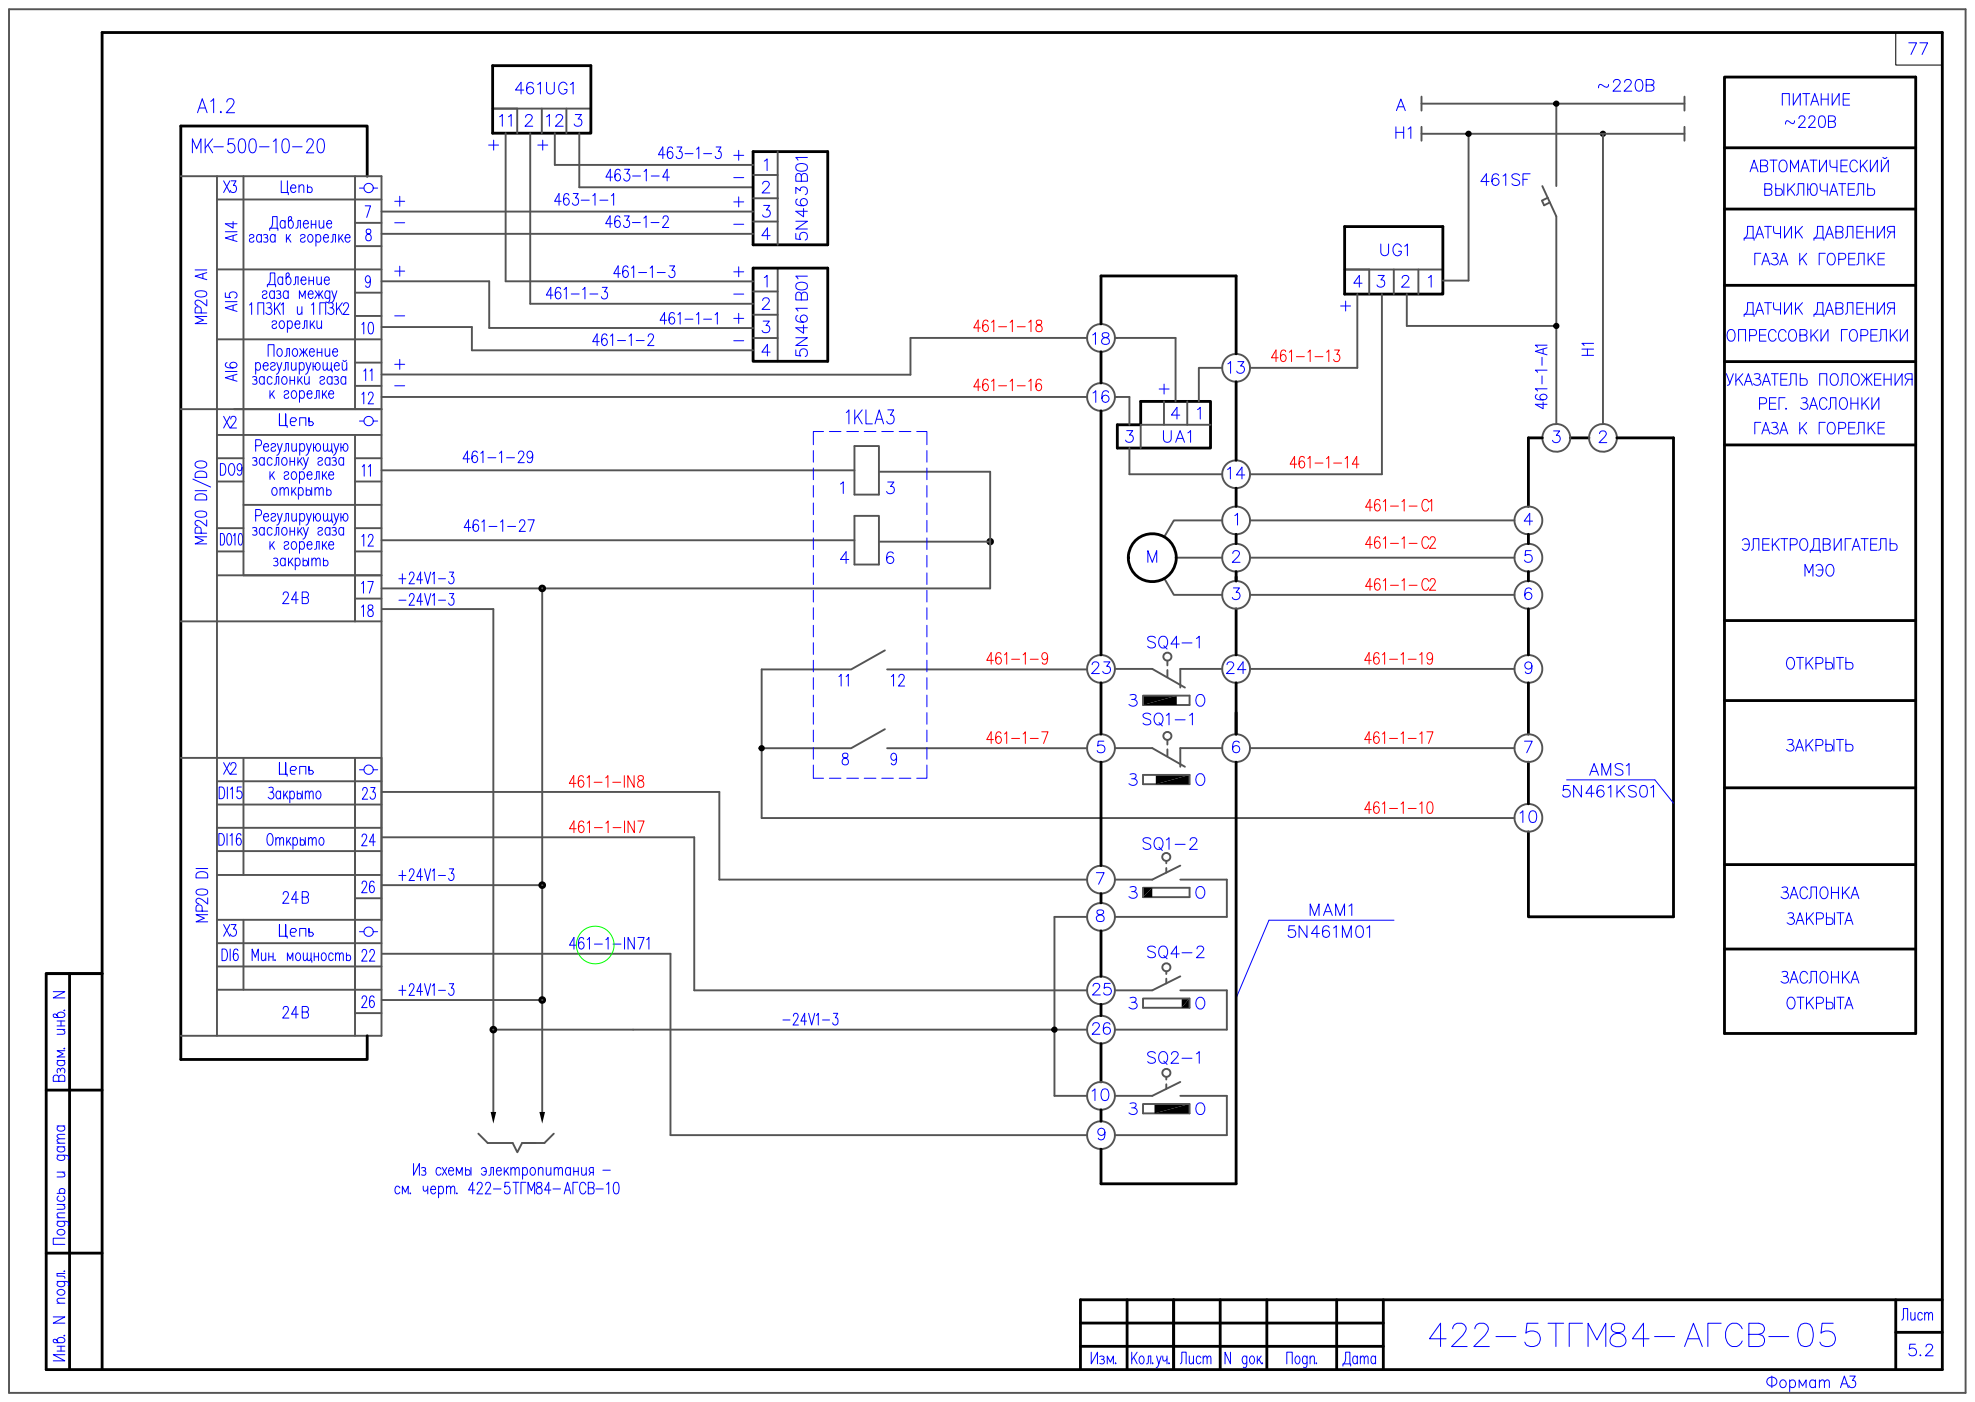
[picture p199: page 18]

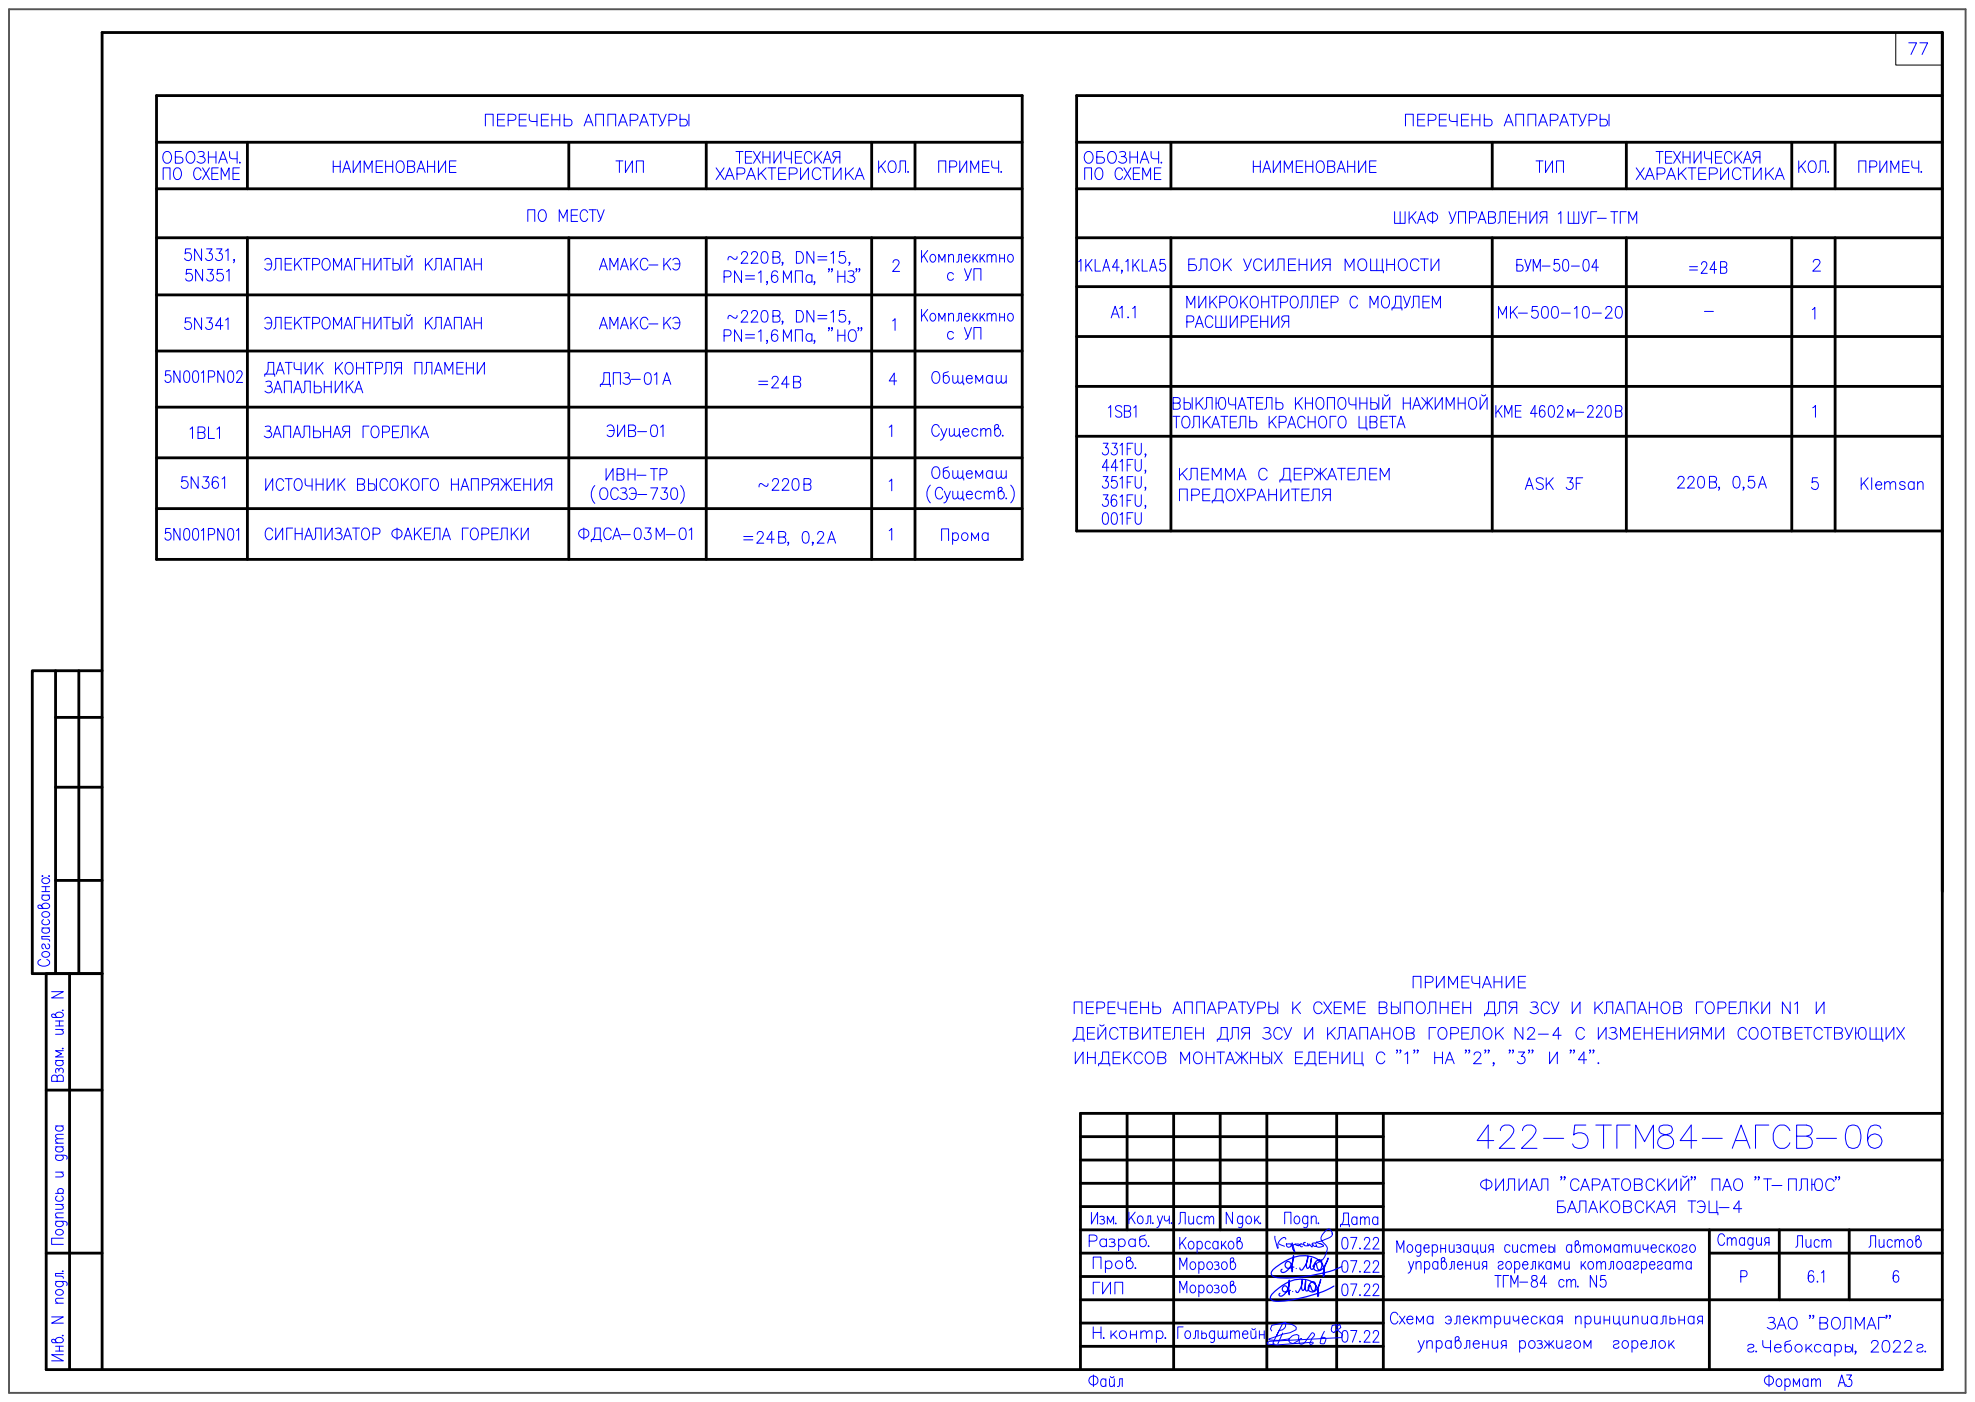
[picture p200: page 19]

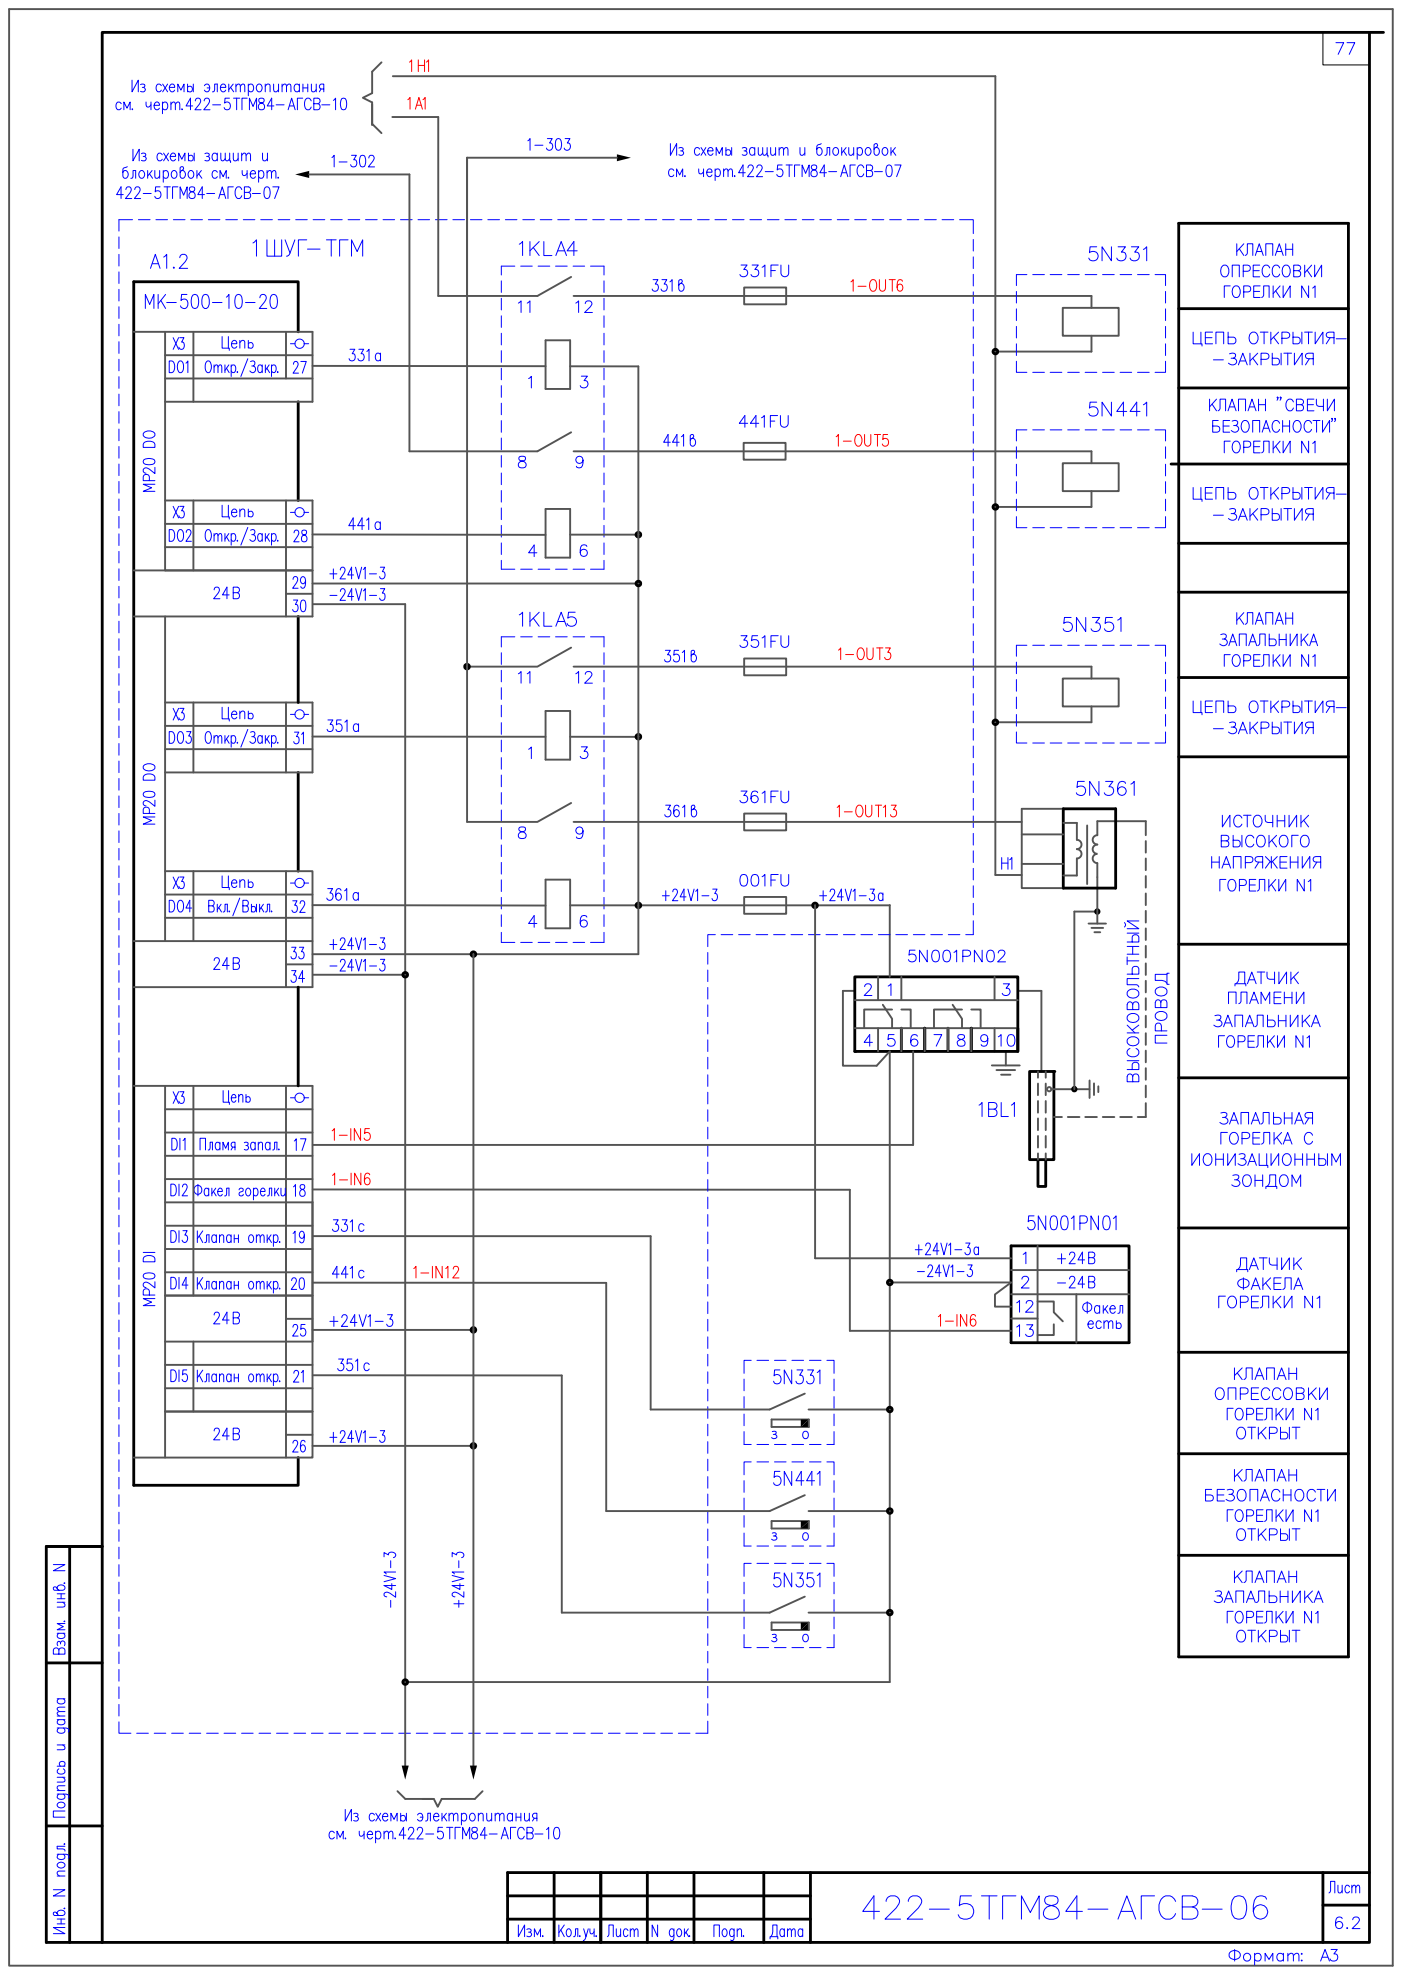
[picture p201: page 20]

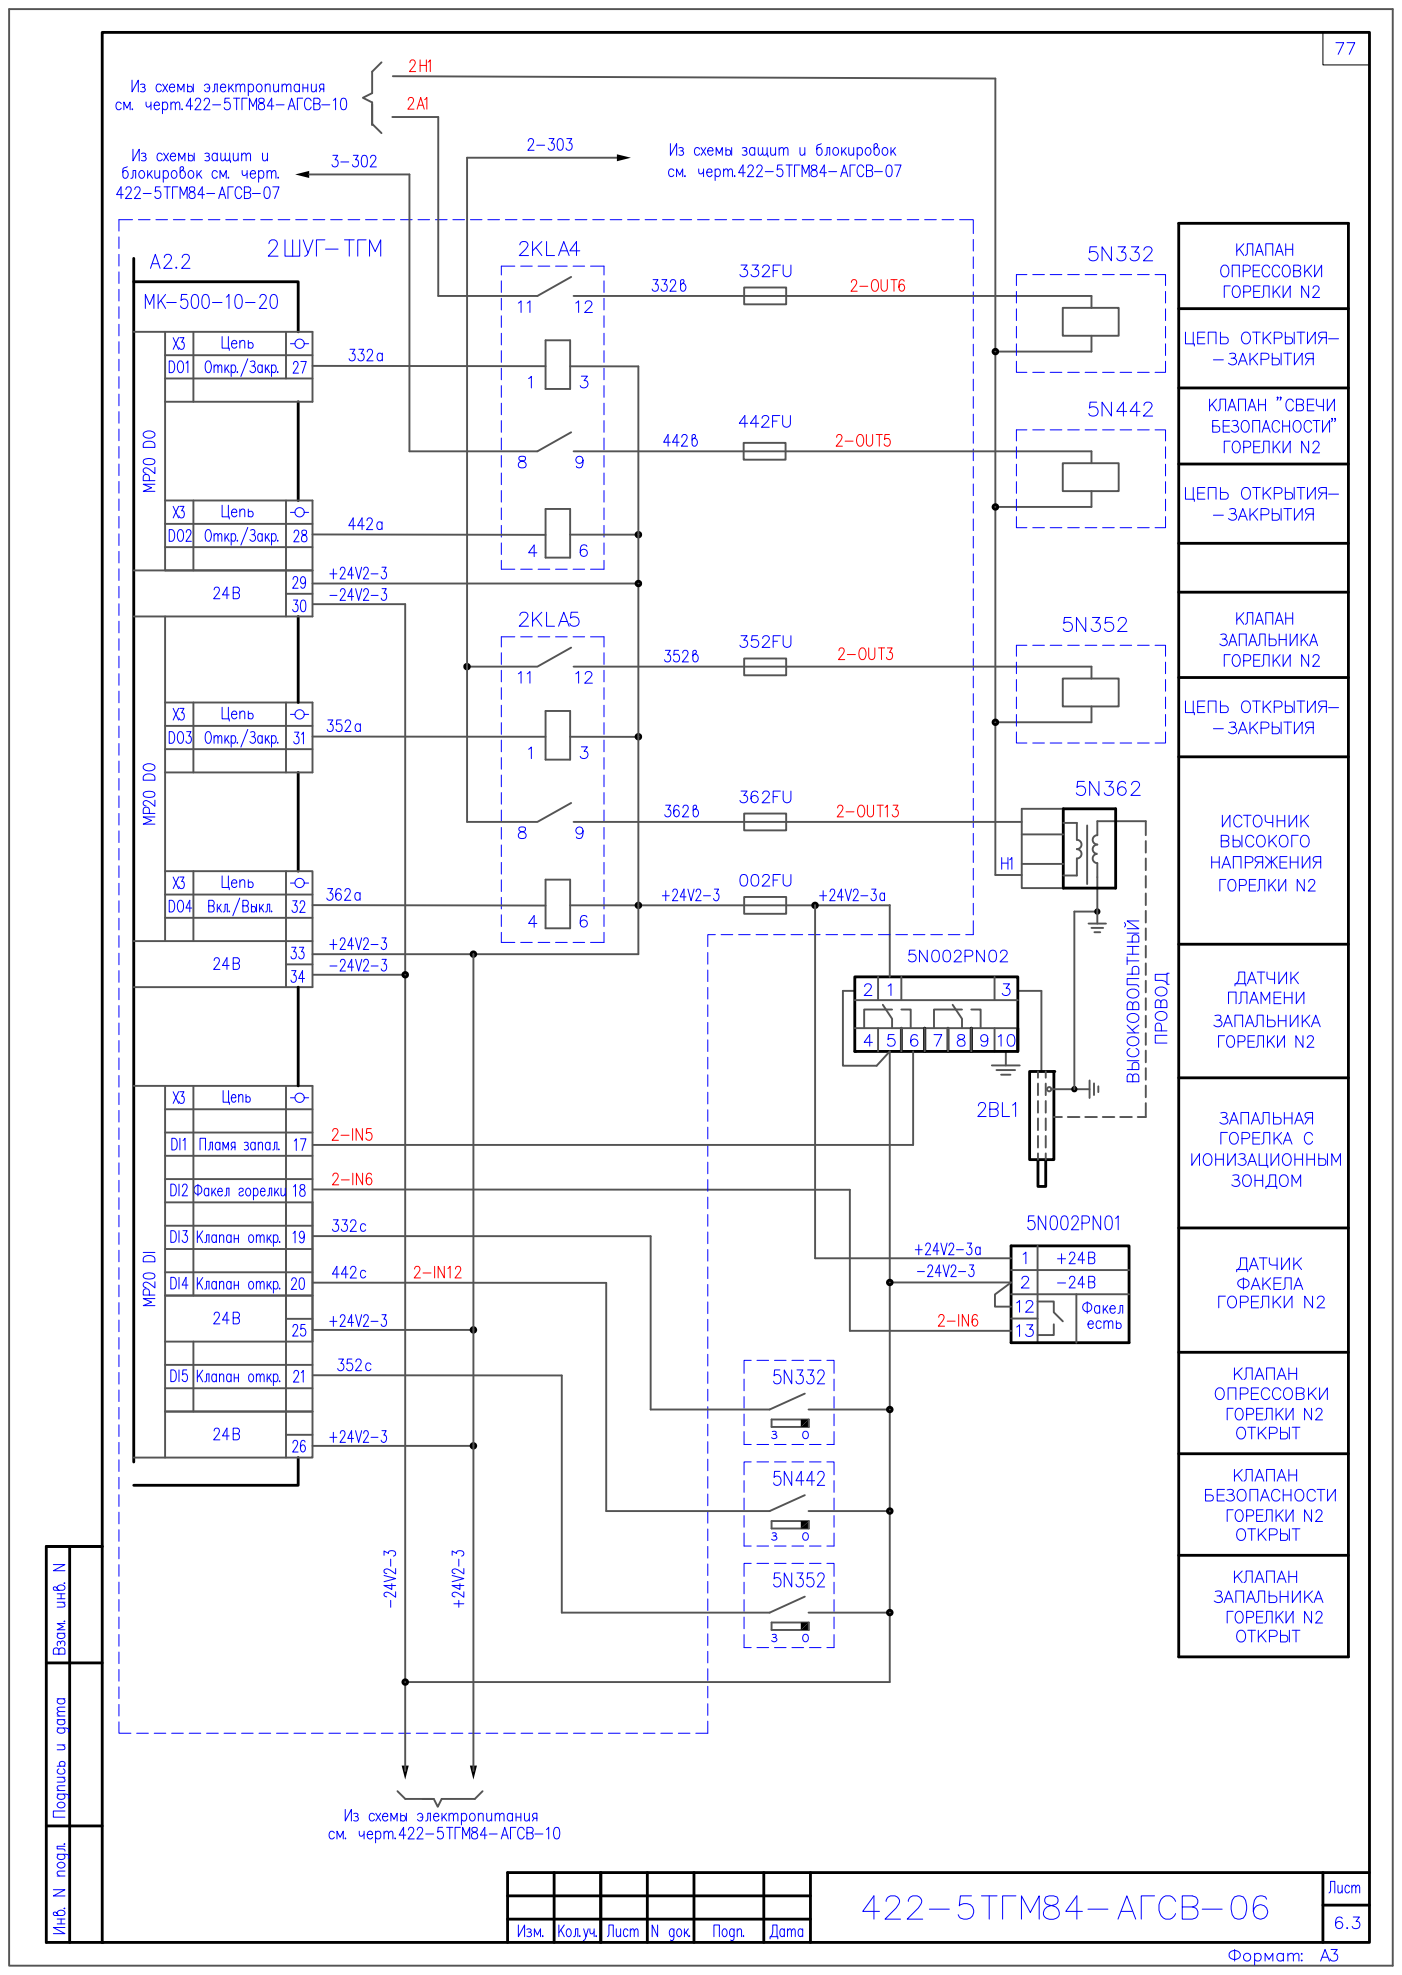
[picture p202: page 21]

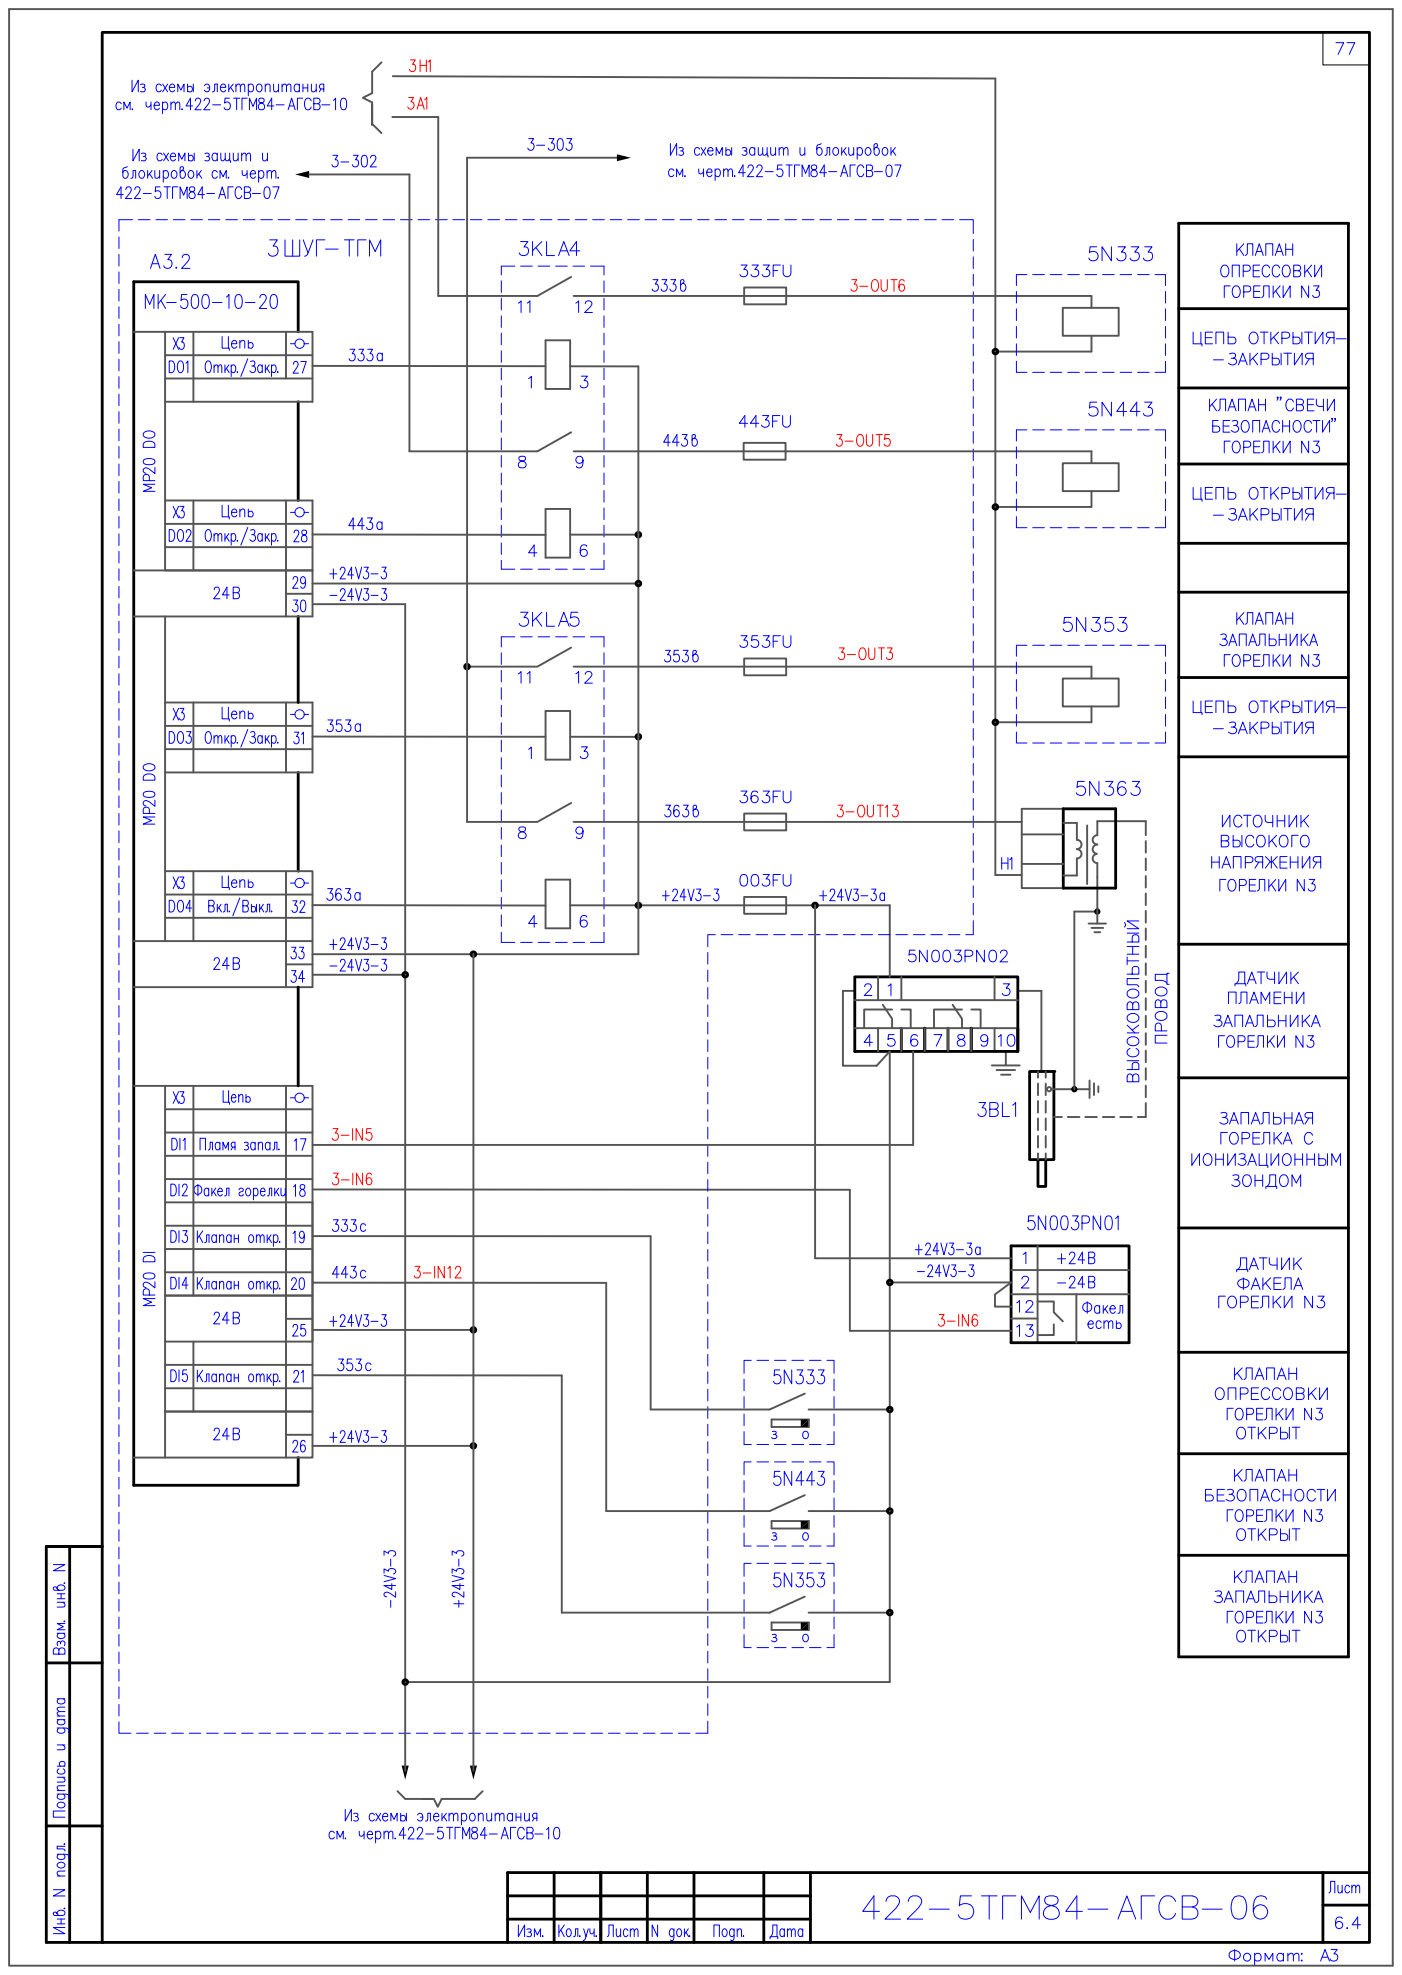
[picture p203: page 22]

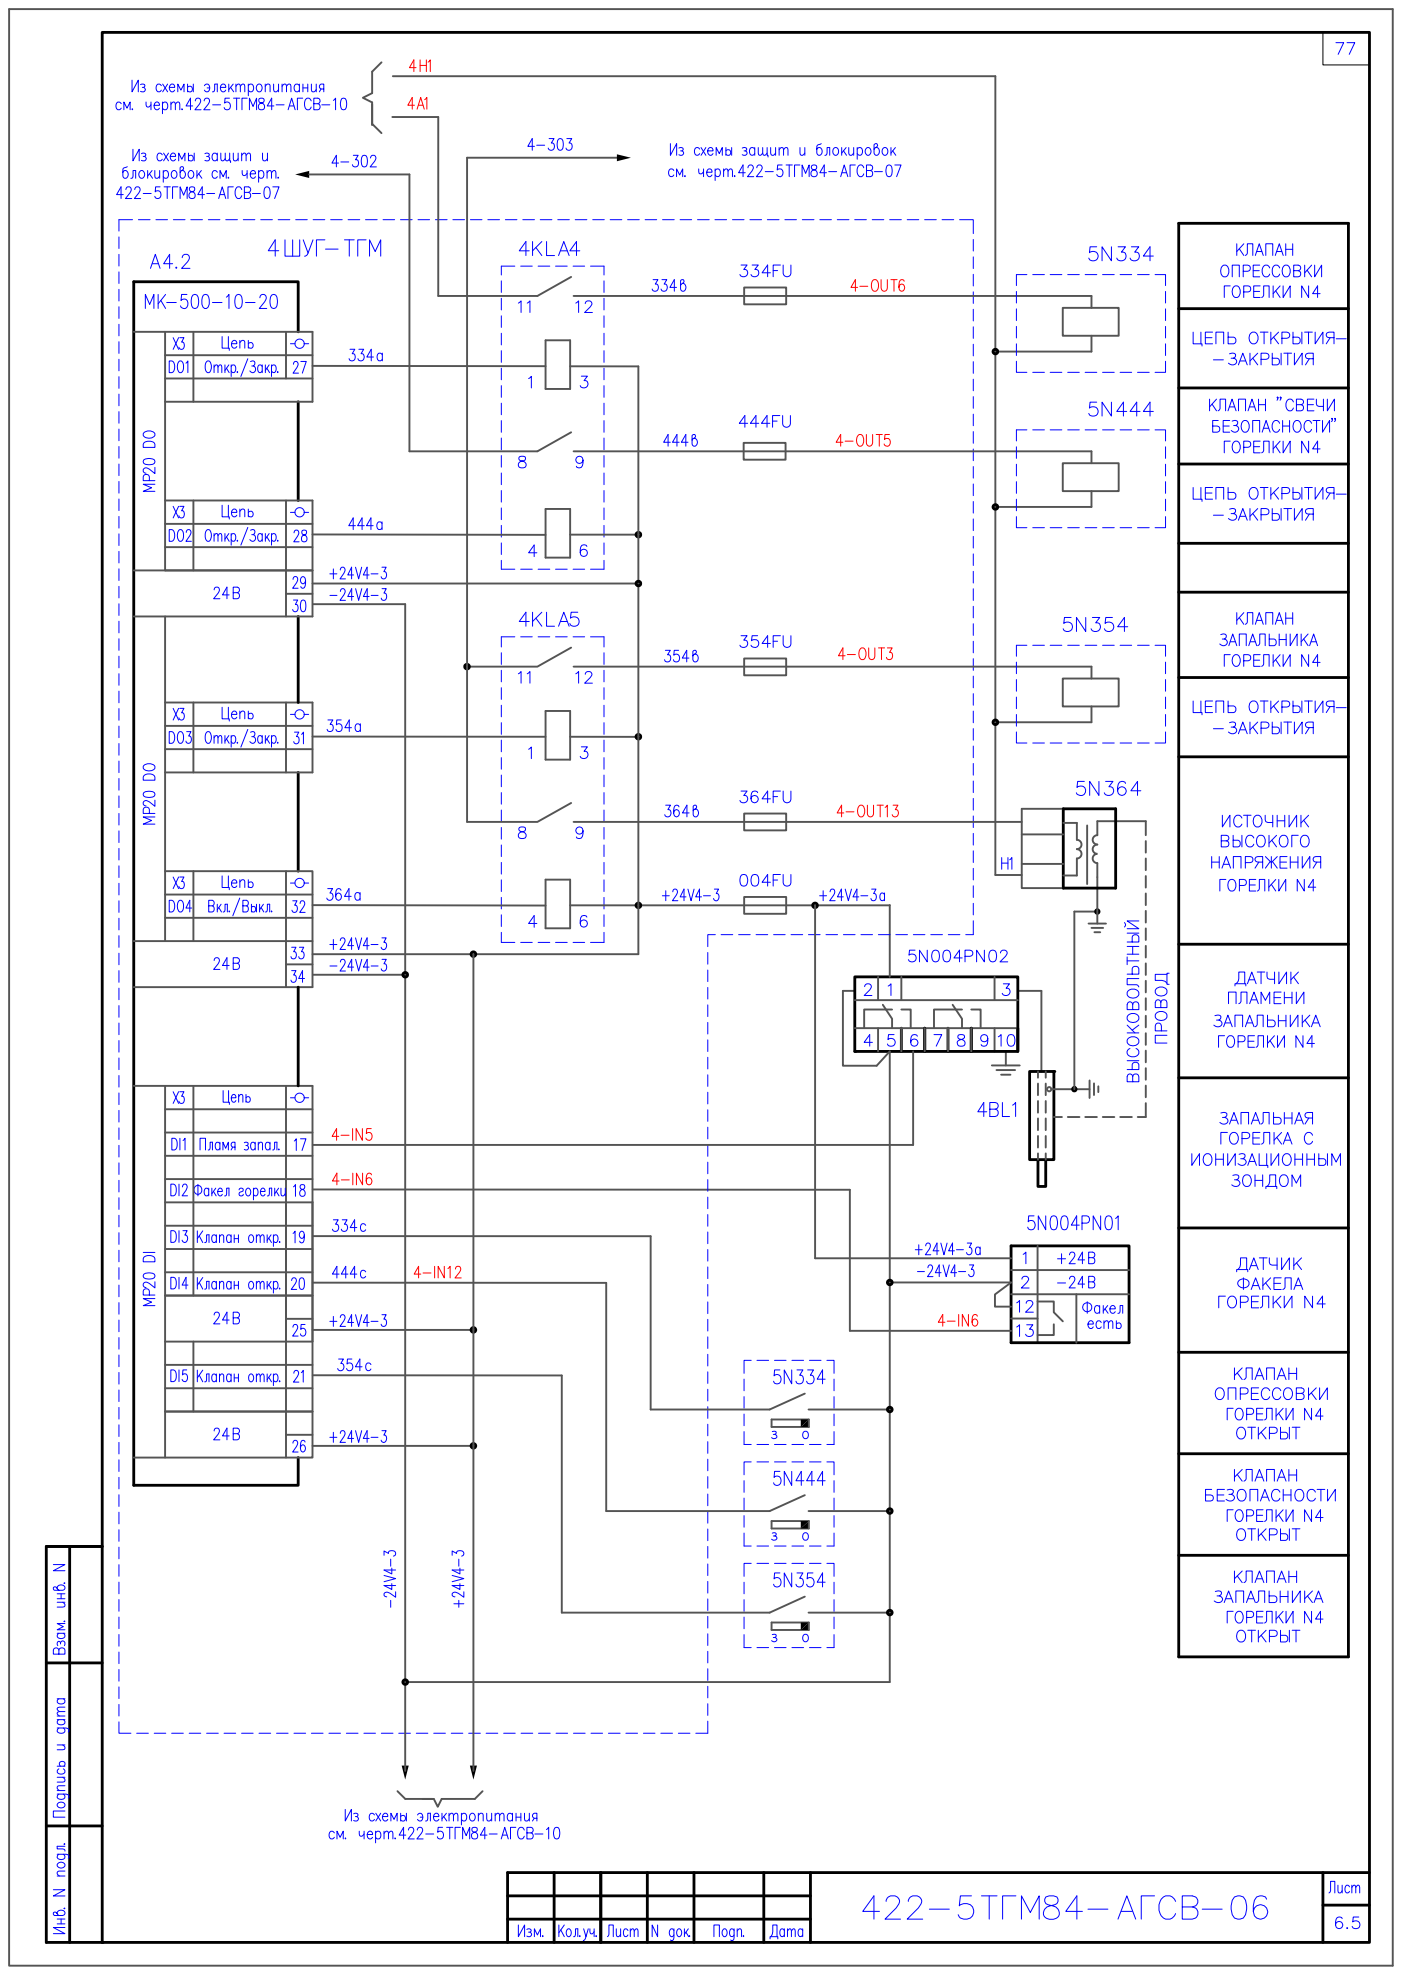
[picture p204: page 23]

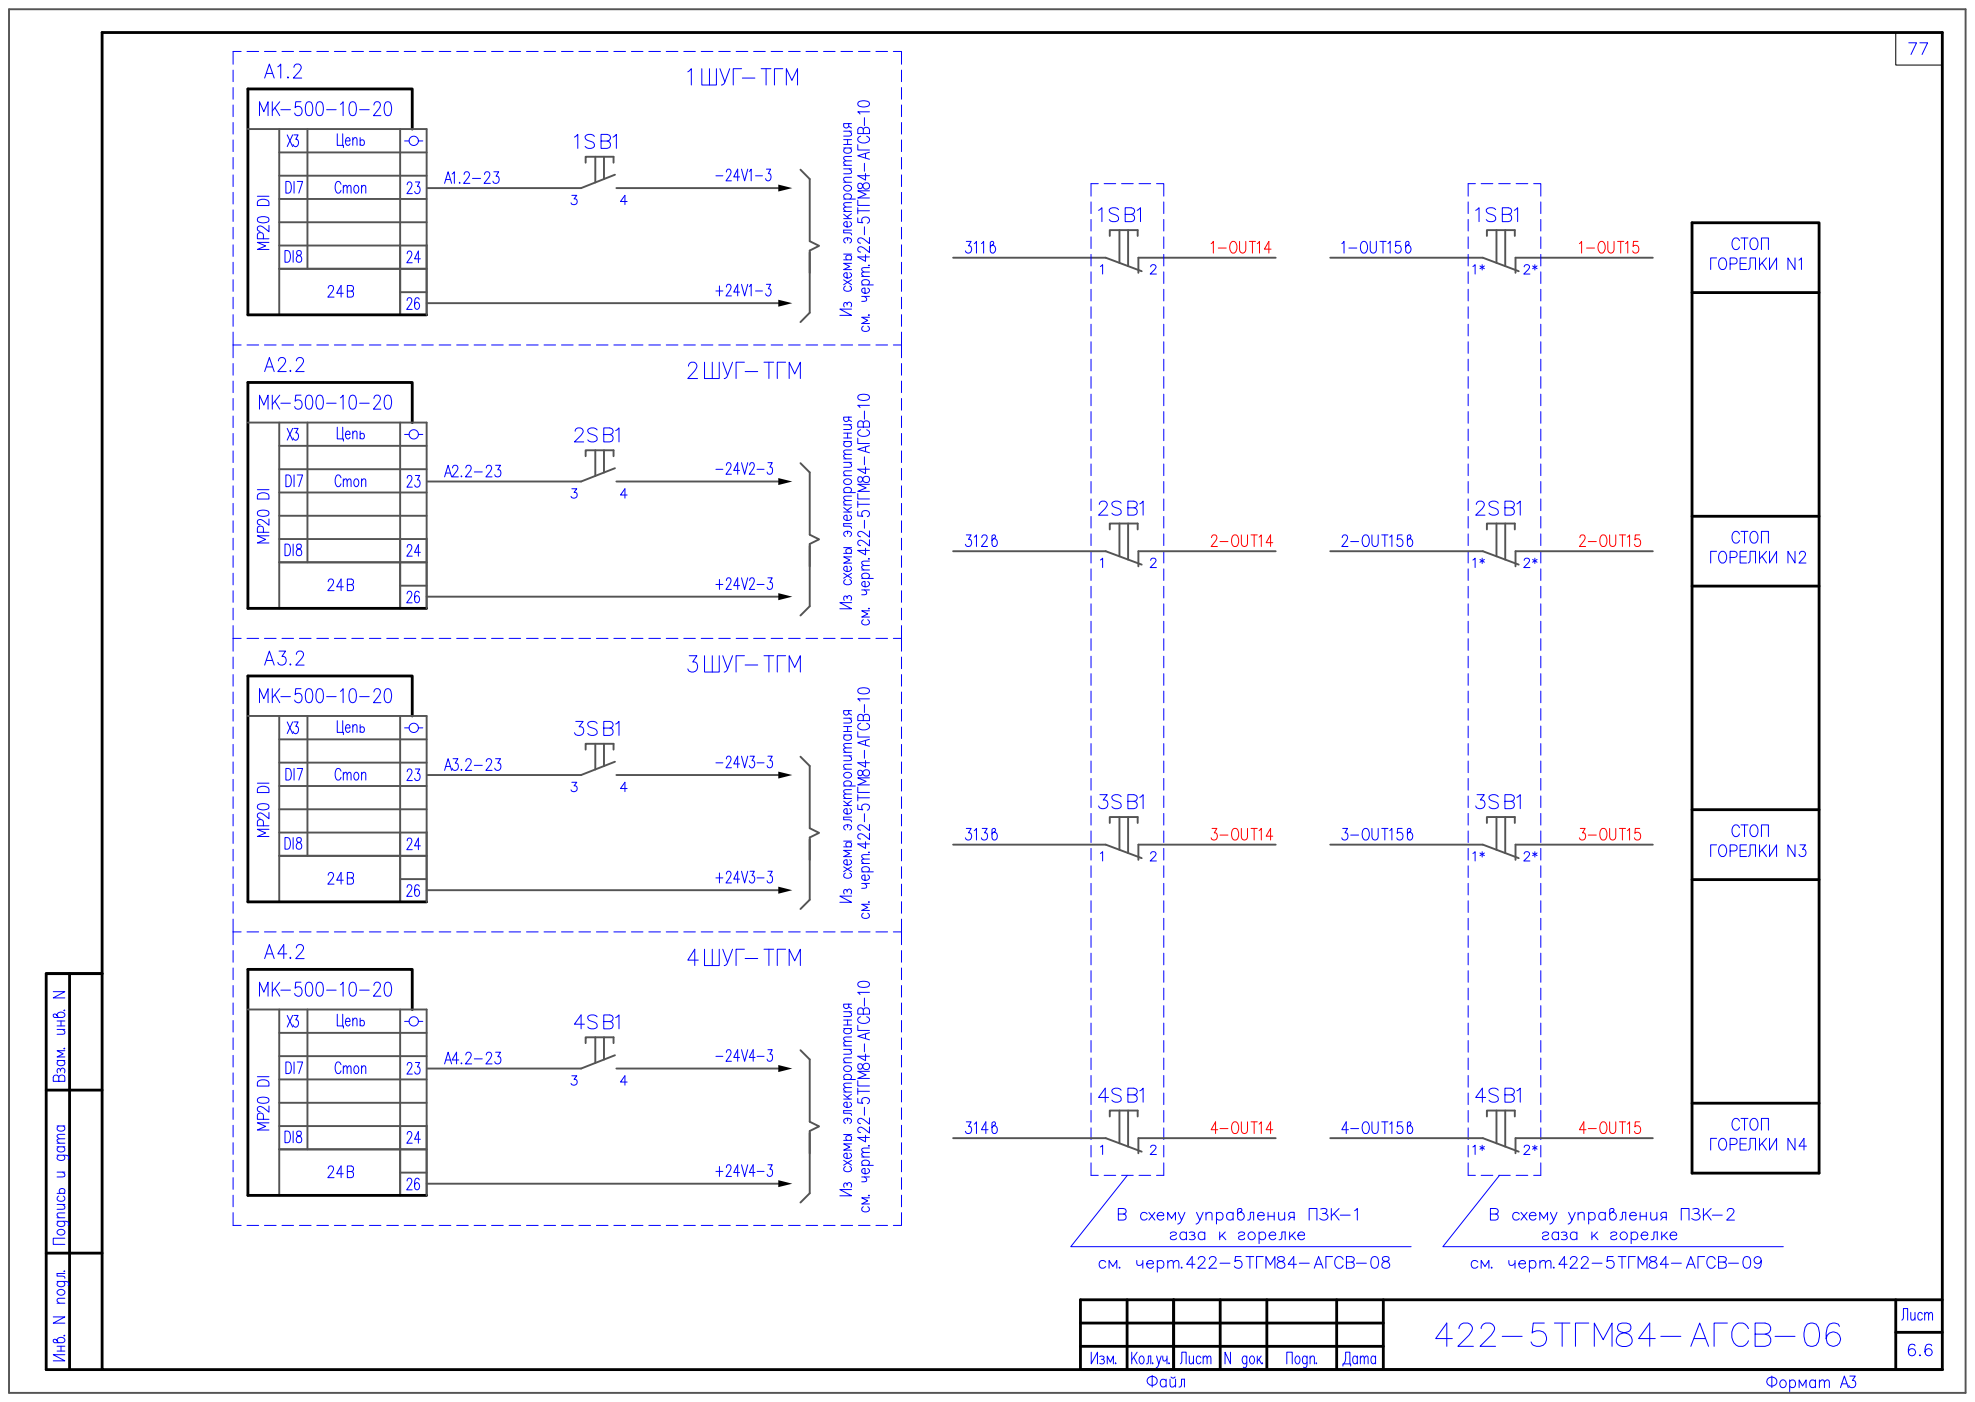
[picture p205: page 24]

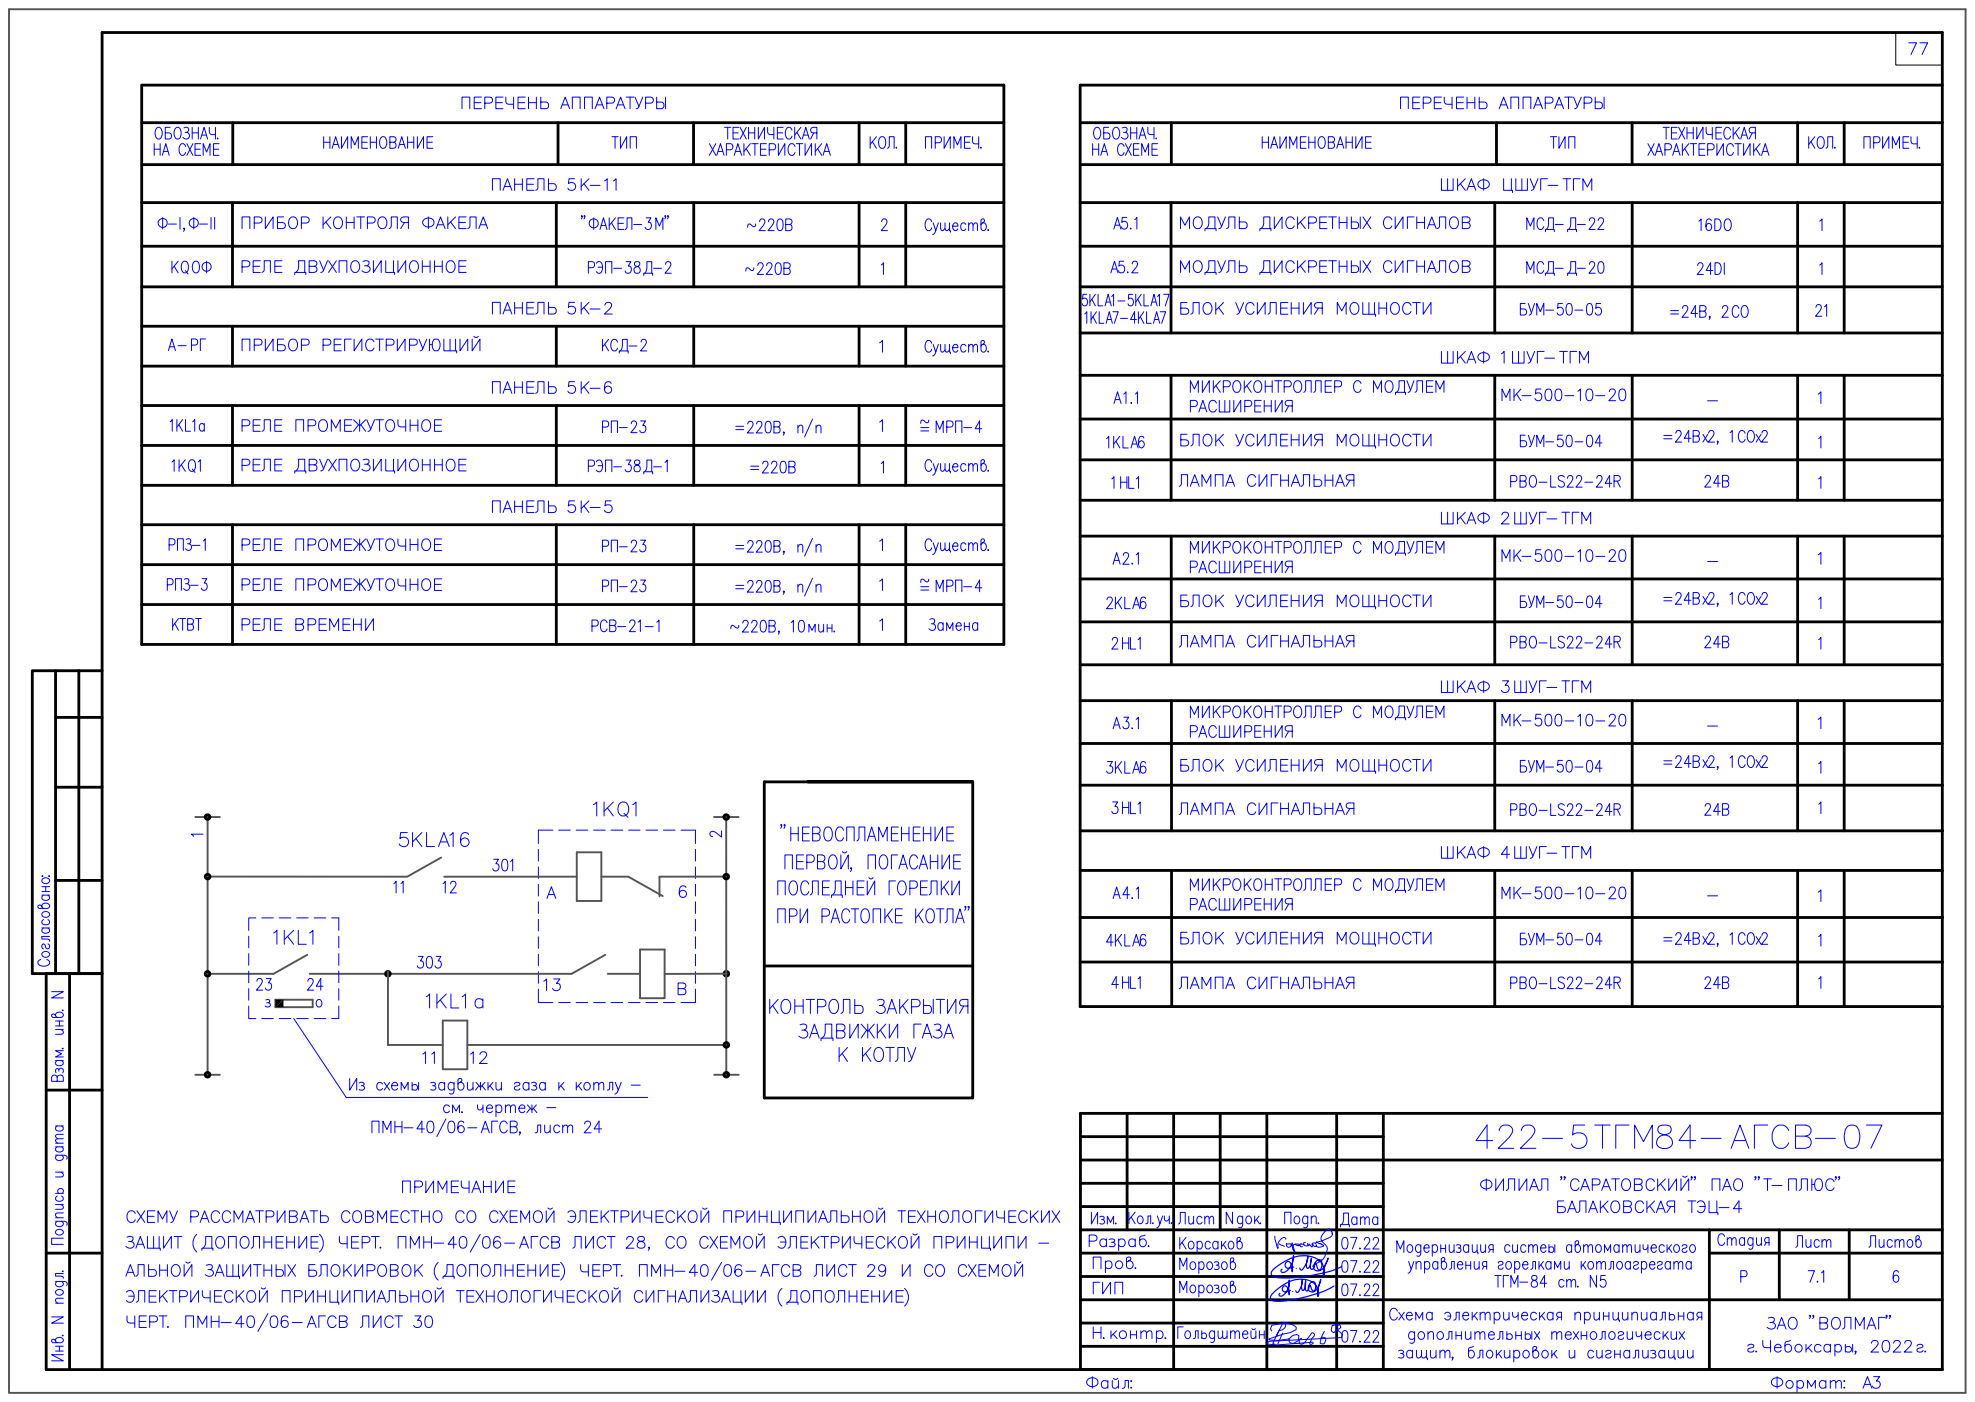
[picture p206: page 25]

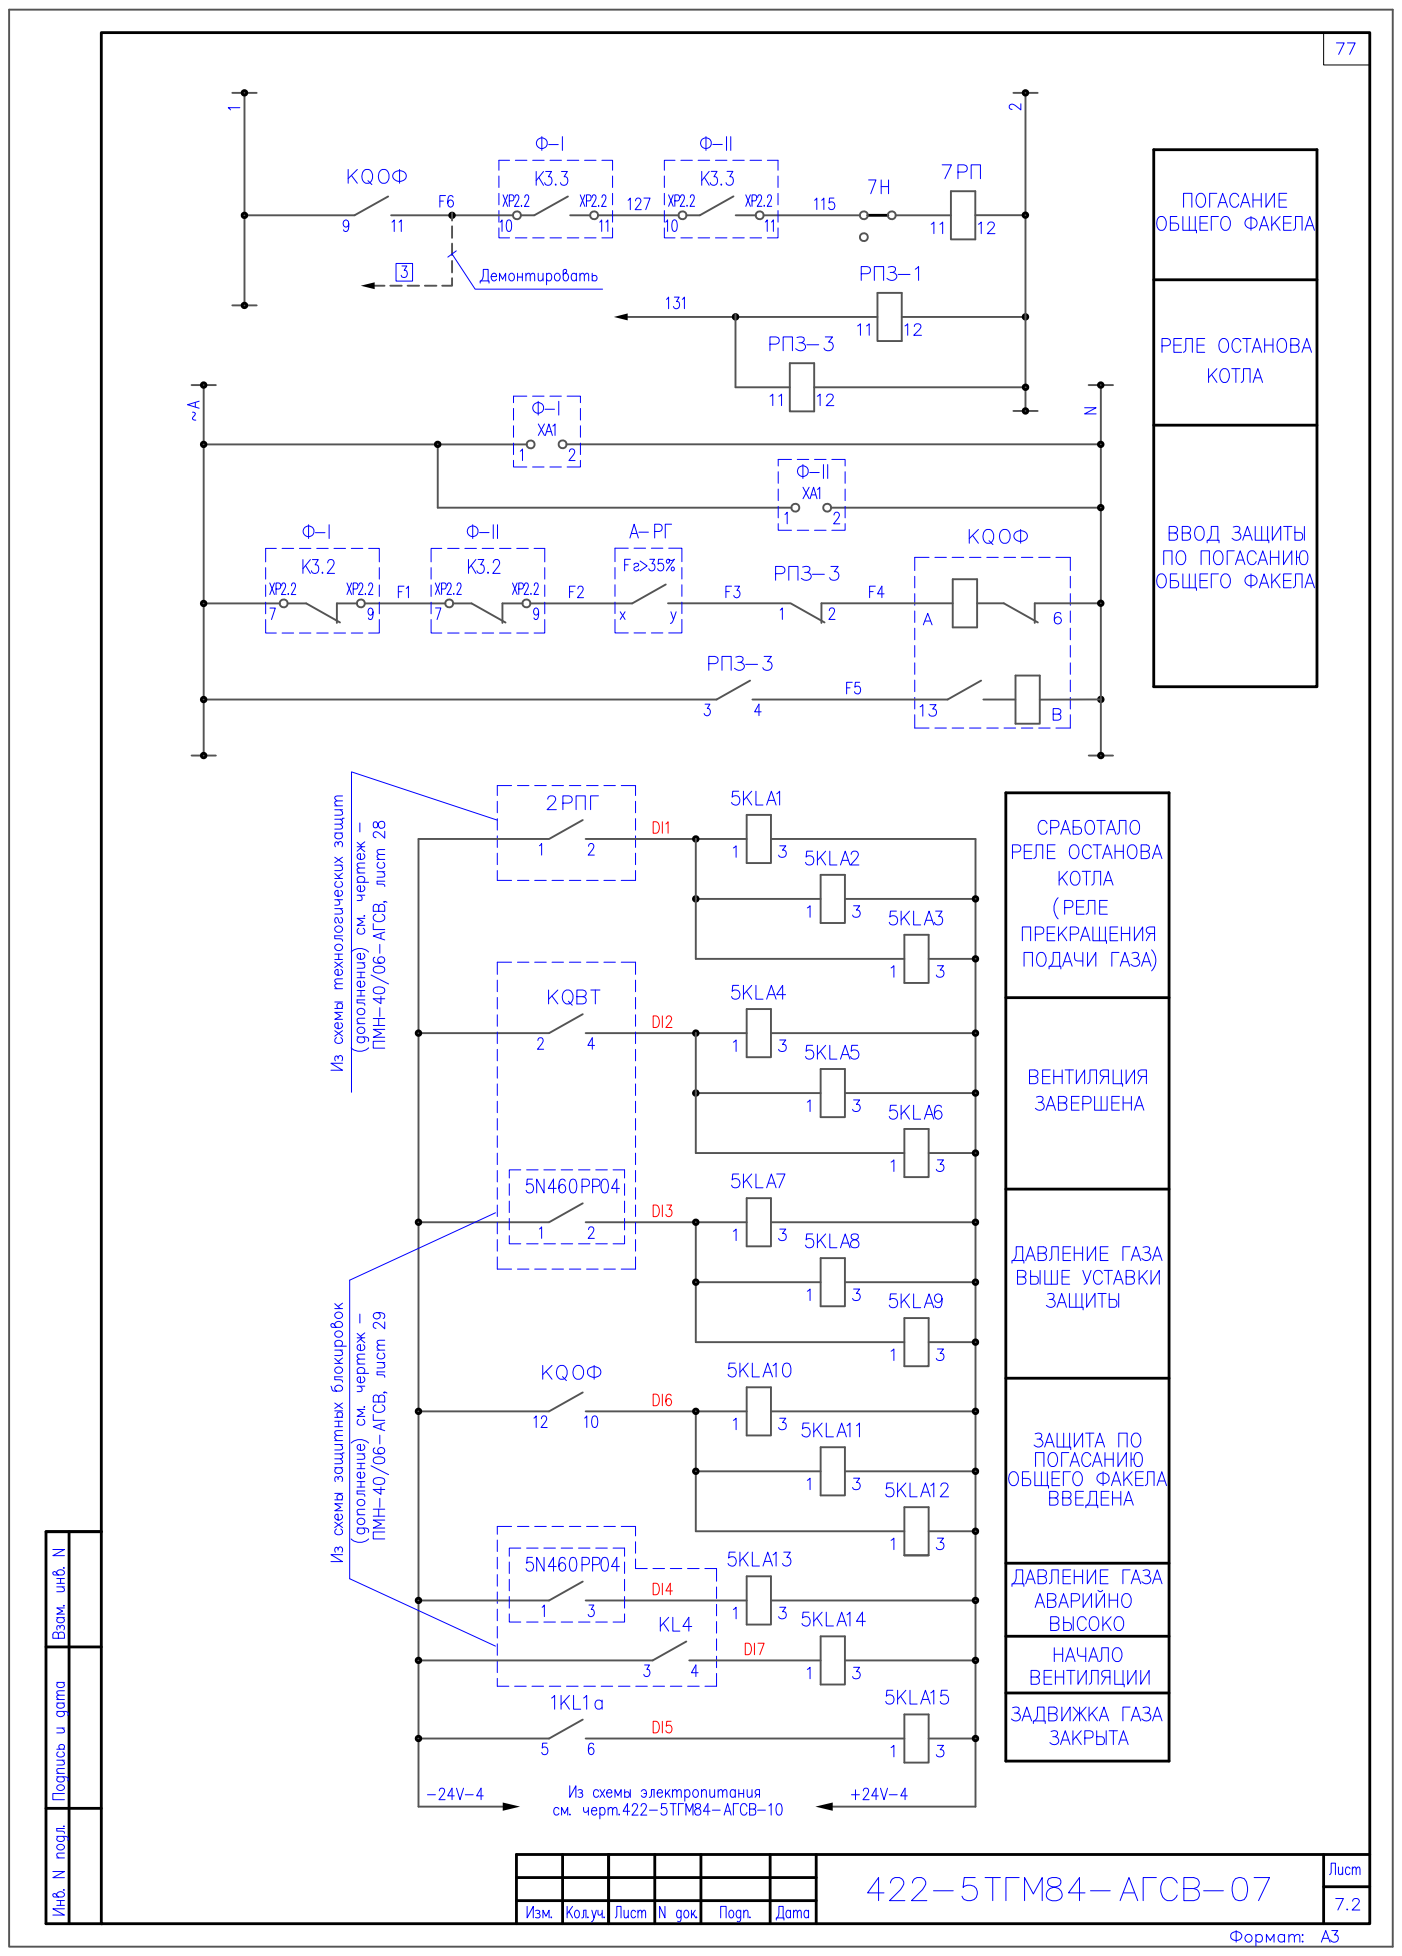
[picture p207: page 26]

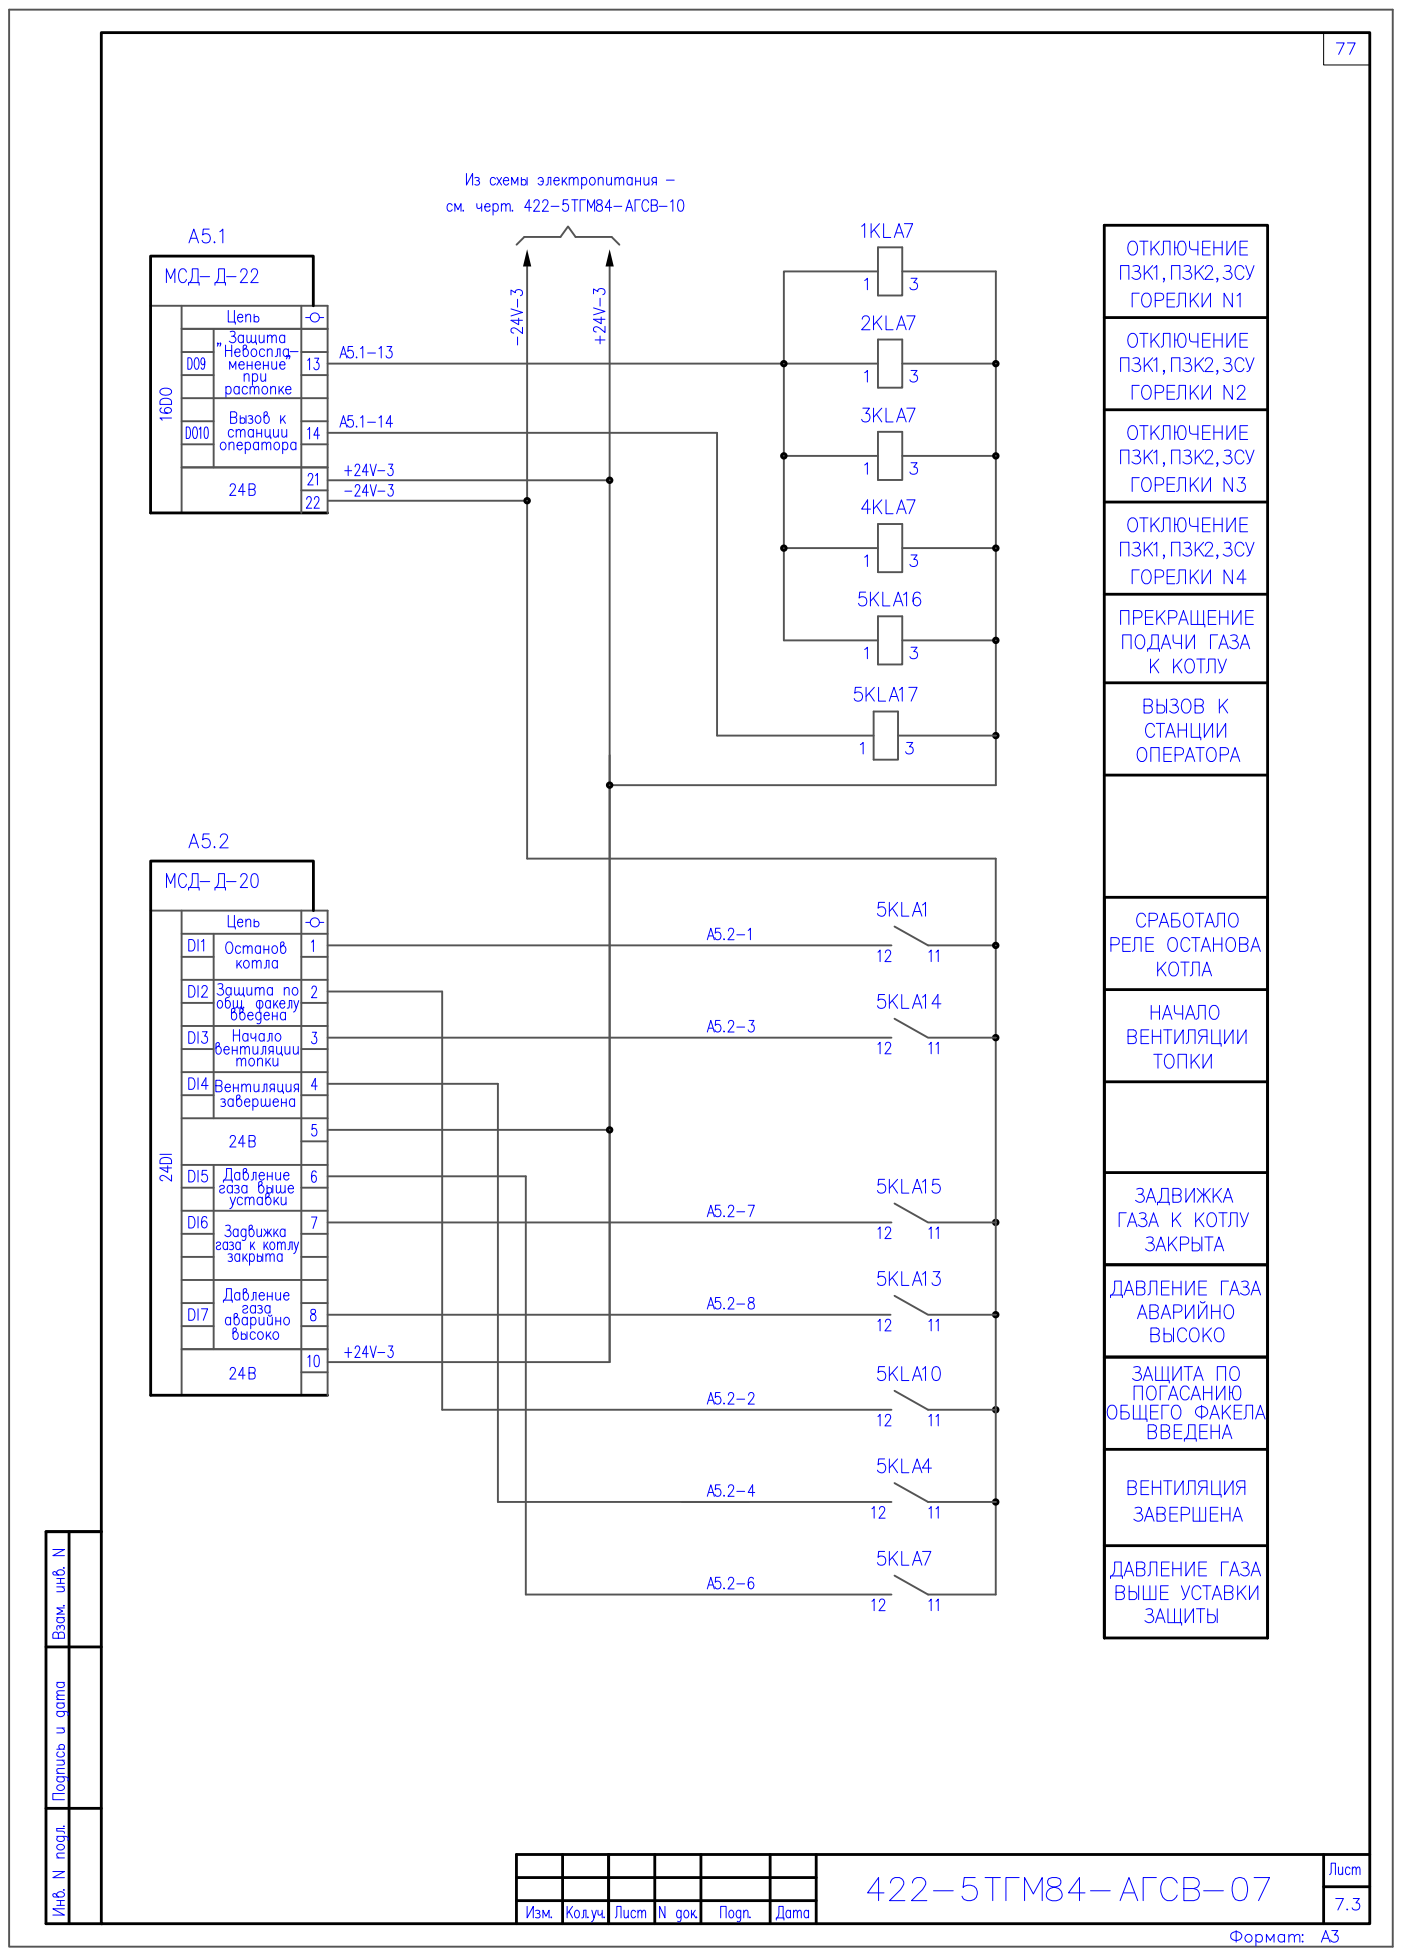
[picture p208: page 27]

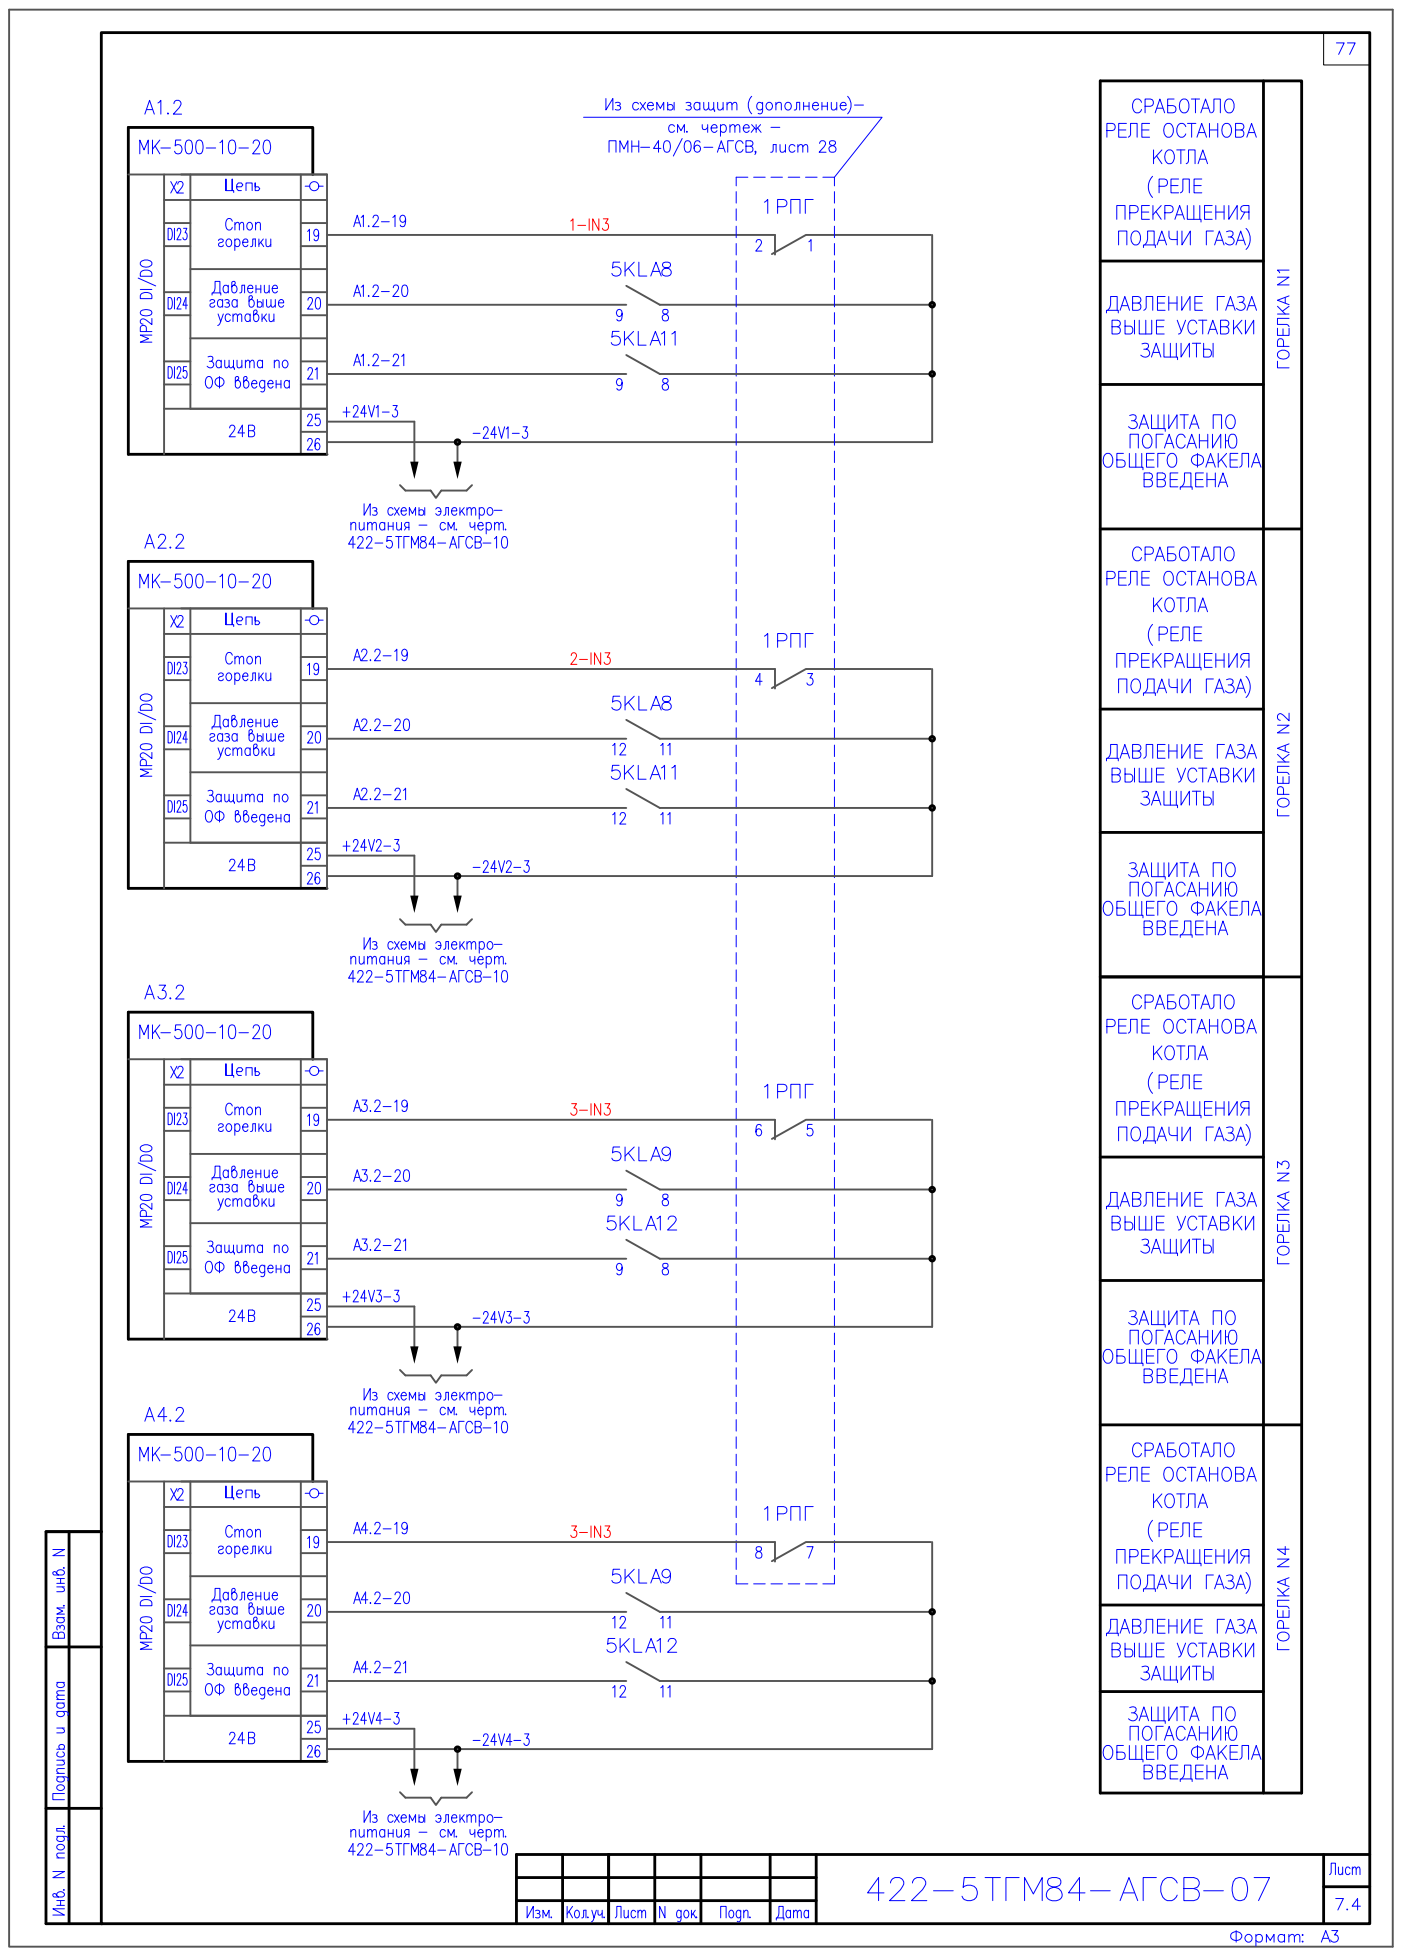
[picture p209: page 28]

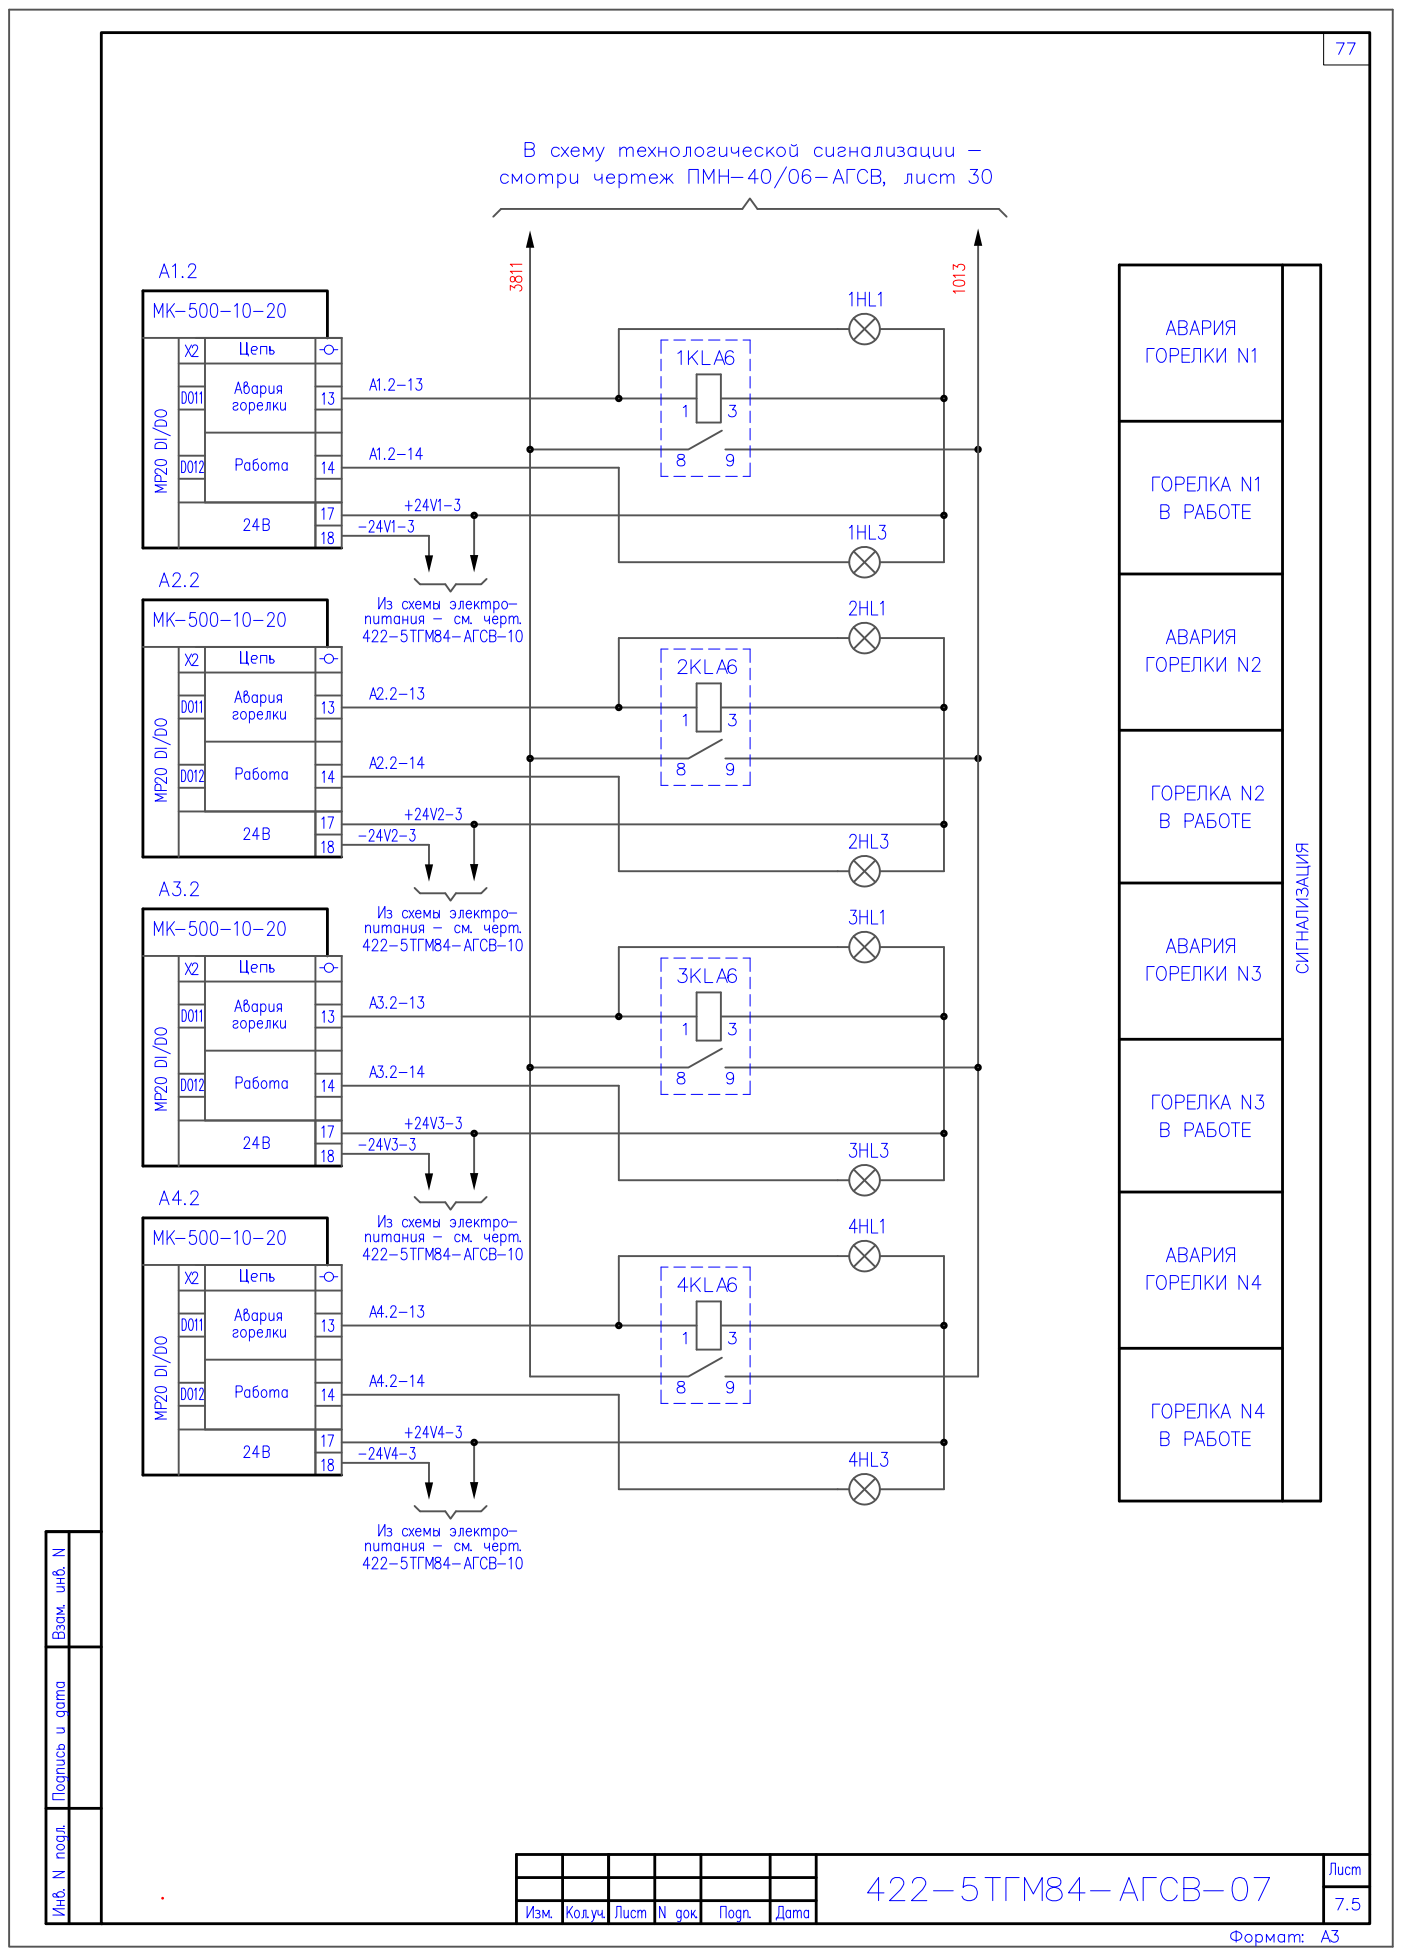
[picture p210: page 29]

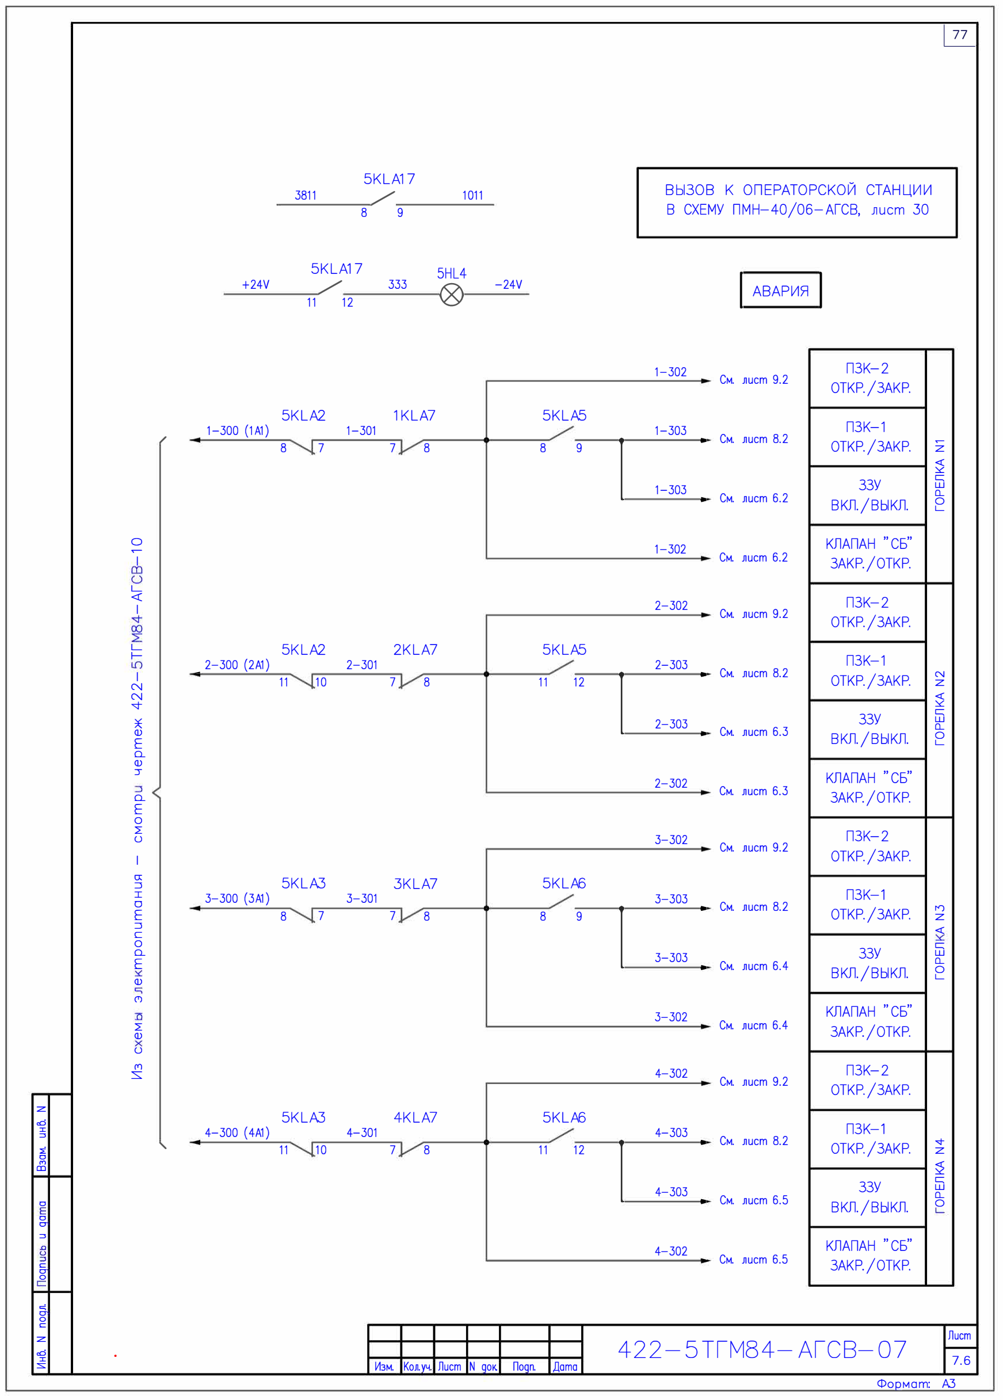
[picture p211: page 30]

5KLA17 | ВЫЗОВ К ОПЕРАТОРСКОЙ СТАНUИИ 3811 | / | 1011
8 | 9 | В СХЕМУ ПМН-40/06-АГСВ, лucm 30
1 ⁵KLA17 | 5HL4 | 1 ⁺²⁴V | / | 333 | 0 -24V | АВАРИЯ
11 | 12
1-302 | ПЗК-2
См. лucm 9.2 | ОТКР. /ЗАКР.
5KLA2 | 1 KLA7 | 5KLA5
ПЗК-1 1-300 (1 А1) | 1-301 | 1-303 | См. лucm 8.2 | ОТКР./ЗАКР. | ] : | z
1' | 8 | 7 | 7 | 8 | 8 | 9

<(
::::.:::
ЗЗУ | с;
ш 1-303 | о_ См. лucm 6.2 | ВКЛ./ВЫКЛ. | о

L
о | 1-302 | КЛАПАН "СБ"
См. лucm 6.2 | ЗАКР. / ОТКР .

.,-
1

L
2-302 | ПЗК-2 <(
См. лucm 9.2 | ОТКР. /ЗАКР.

1

5KLA2 | 2KLA7 | 5KLA5
ПЗК-1

L
2-303

f-
2-300 (2А1) | 2-301 | См. лucm 8.2 | ОТКР. /ЗАКР. | N ] : | z
7 | 8 | 11 | 12 1 | 11 | 10

<(

N

::::.:::

N
ЗЗУ | с; ш

-s:j--
2-303 | о_ См. лucm 6.3 | ВКЛ./ВЫКЛ. | о

L

(1)
Е

Q_
(1)
КЛАПАН "СБ" 2-302

:г
См. лucm 6.3 Q_ | ЗАКР./ОТКР.
Е
о
3-302 | ПЗК-2 ²
См. лucm 9.2 | ОТКР./ЗАКР.

u
1
ел
:::) | 5KLA3 | 3KLA7 | 5KLA6
ПЗК-1 3-300 (3А1) | 3-301 | 3-303 | См. лucm 8.2 | ОТКР. /ЗАКР. | n
I
| | ] : | | | z

о
Е | 8 | 7 | 7 | 8 | 8 | 9

<( :::)

с;

с
ЗЗУ | ш

о
3-303 | о_

Q_

См. лucm 6.4 | ВКЛ./ВЫКЛ. Е | о

L (1)

(')
КЛАПАН "СБ" 3-302 | См. лucm 6.4 | ЗАКР./ОТКР. ²

(1)
u
ПЗК-2 ⁽f) | 4-302 | См. лucm 9.2 | ОТКР. /ЗАКР.
s:

:z
5KLA3 | 4KLA7 | 5KLA6
ПЗК-1 cd
4-300 ( 4А1) | 4-301 | 4-303 | См. лucm 8.2 | ОТКР. /ЗАКР. | s;j-
I
| | ] : | | | z

:::::,
11 | 12 ' | 11 | 10 | 7 | 8

<(

:i

::::.:::

о

с;

(У)
ЗЗУ

(I)
ш 4-303 | о_ См. лucm 6.5 | ВКЛ./ВЫКЛ. о | о

о
о
КЛАПАН "СБ" :::::,
4-302 | См. лucm 6.5 -
с | ЗАКР. / ОТКР. 8

<=;
8

с
Лu cm
422-5 ТГМ84-АГСВ-07 :z
7.6
cd | .
Изм. Кол.vч Лucm N qок Пoqn. Дата I :s:
Формат: А3

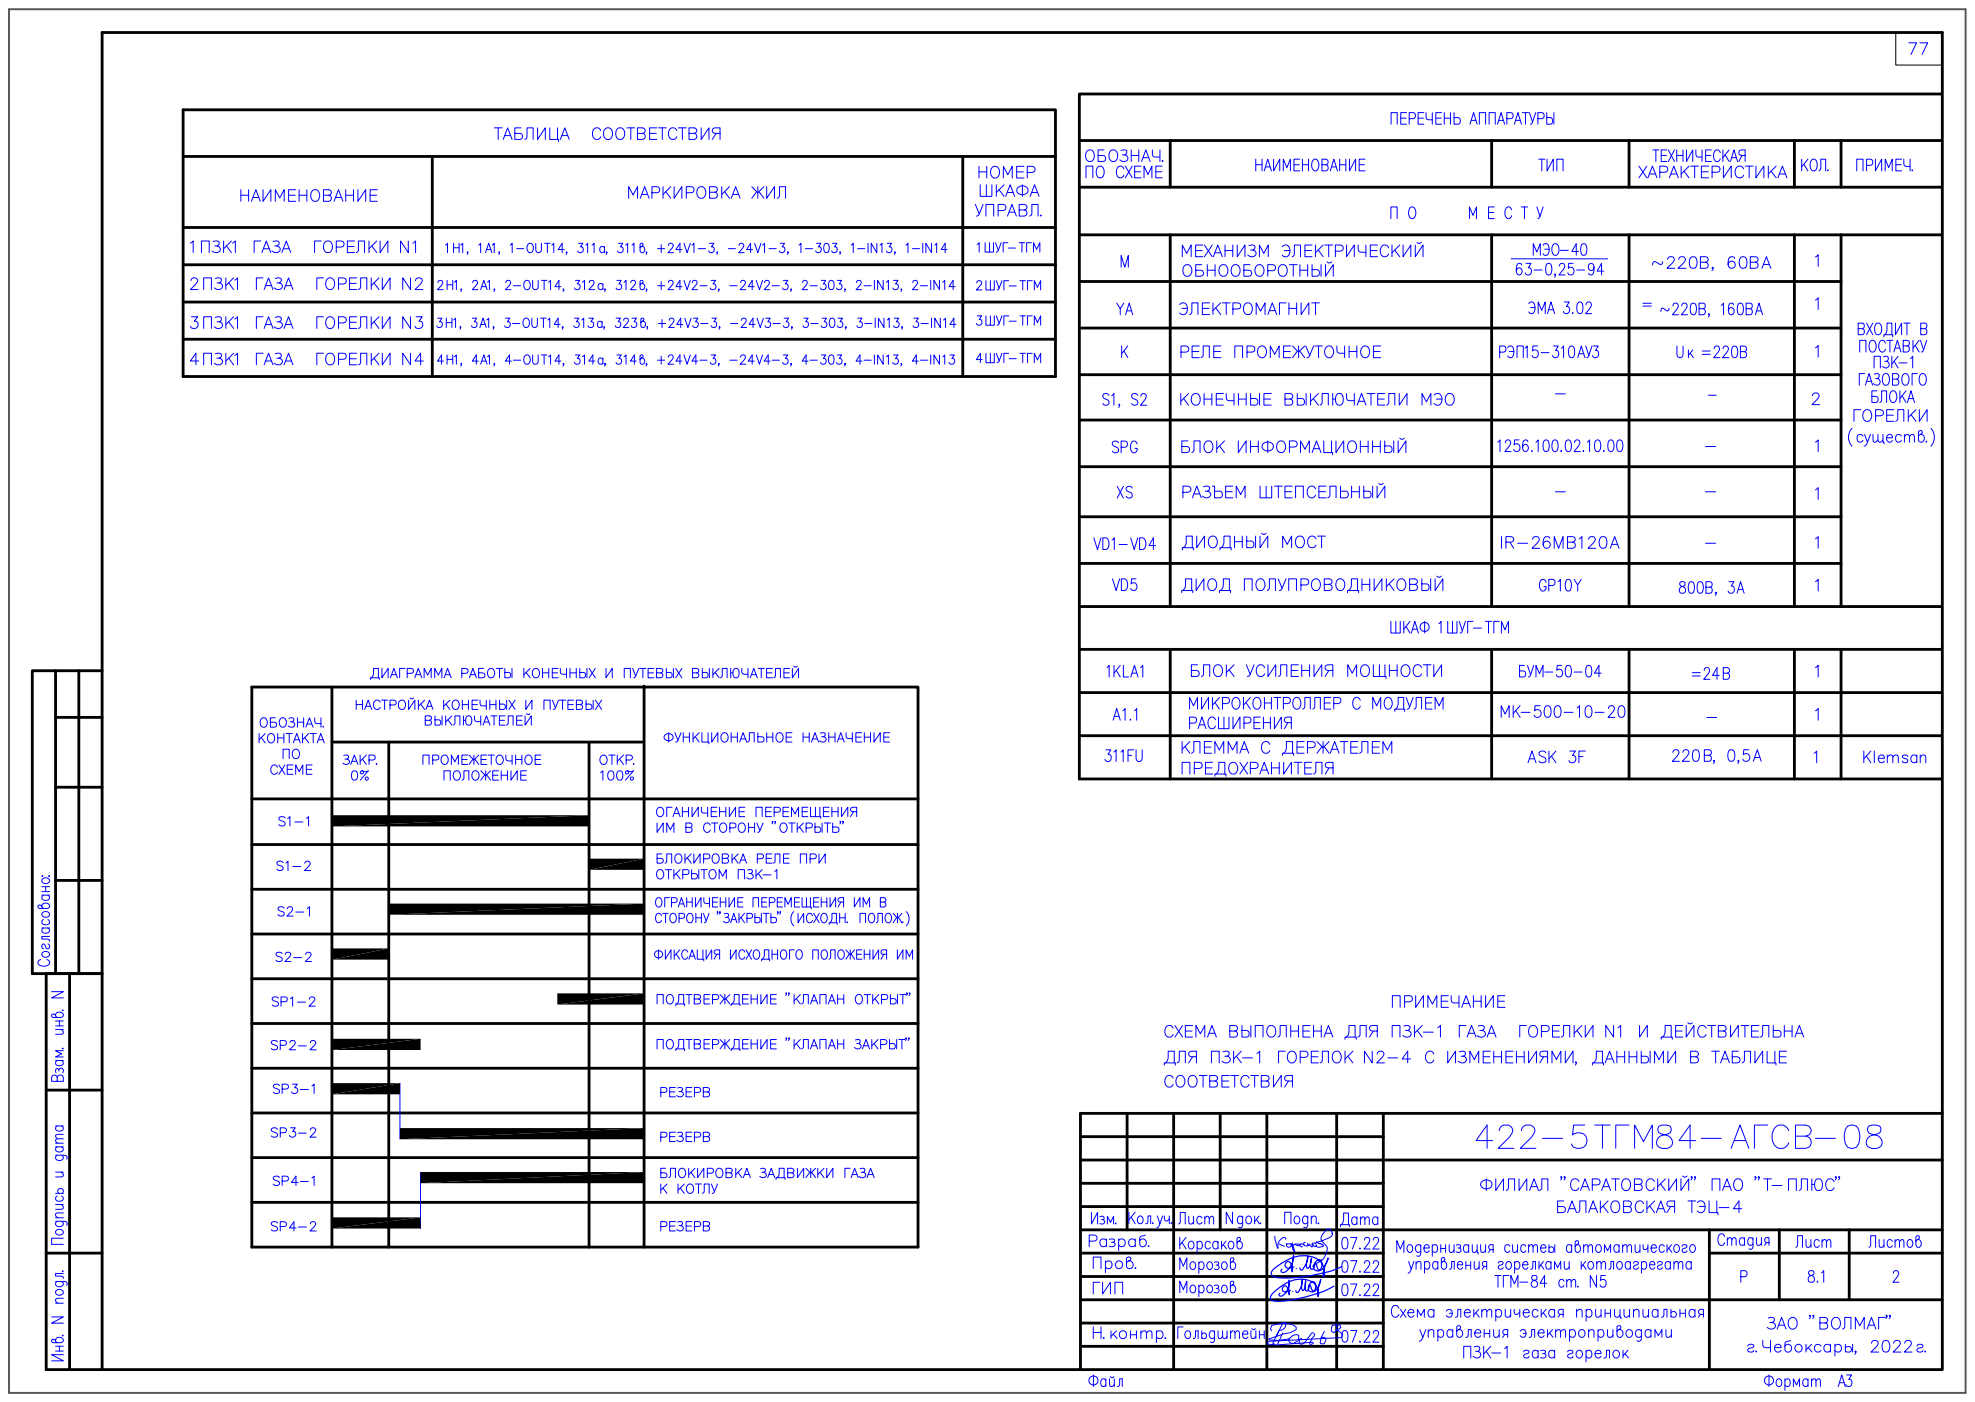
[picture p212: page 31]

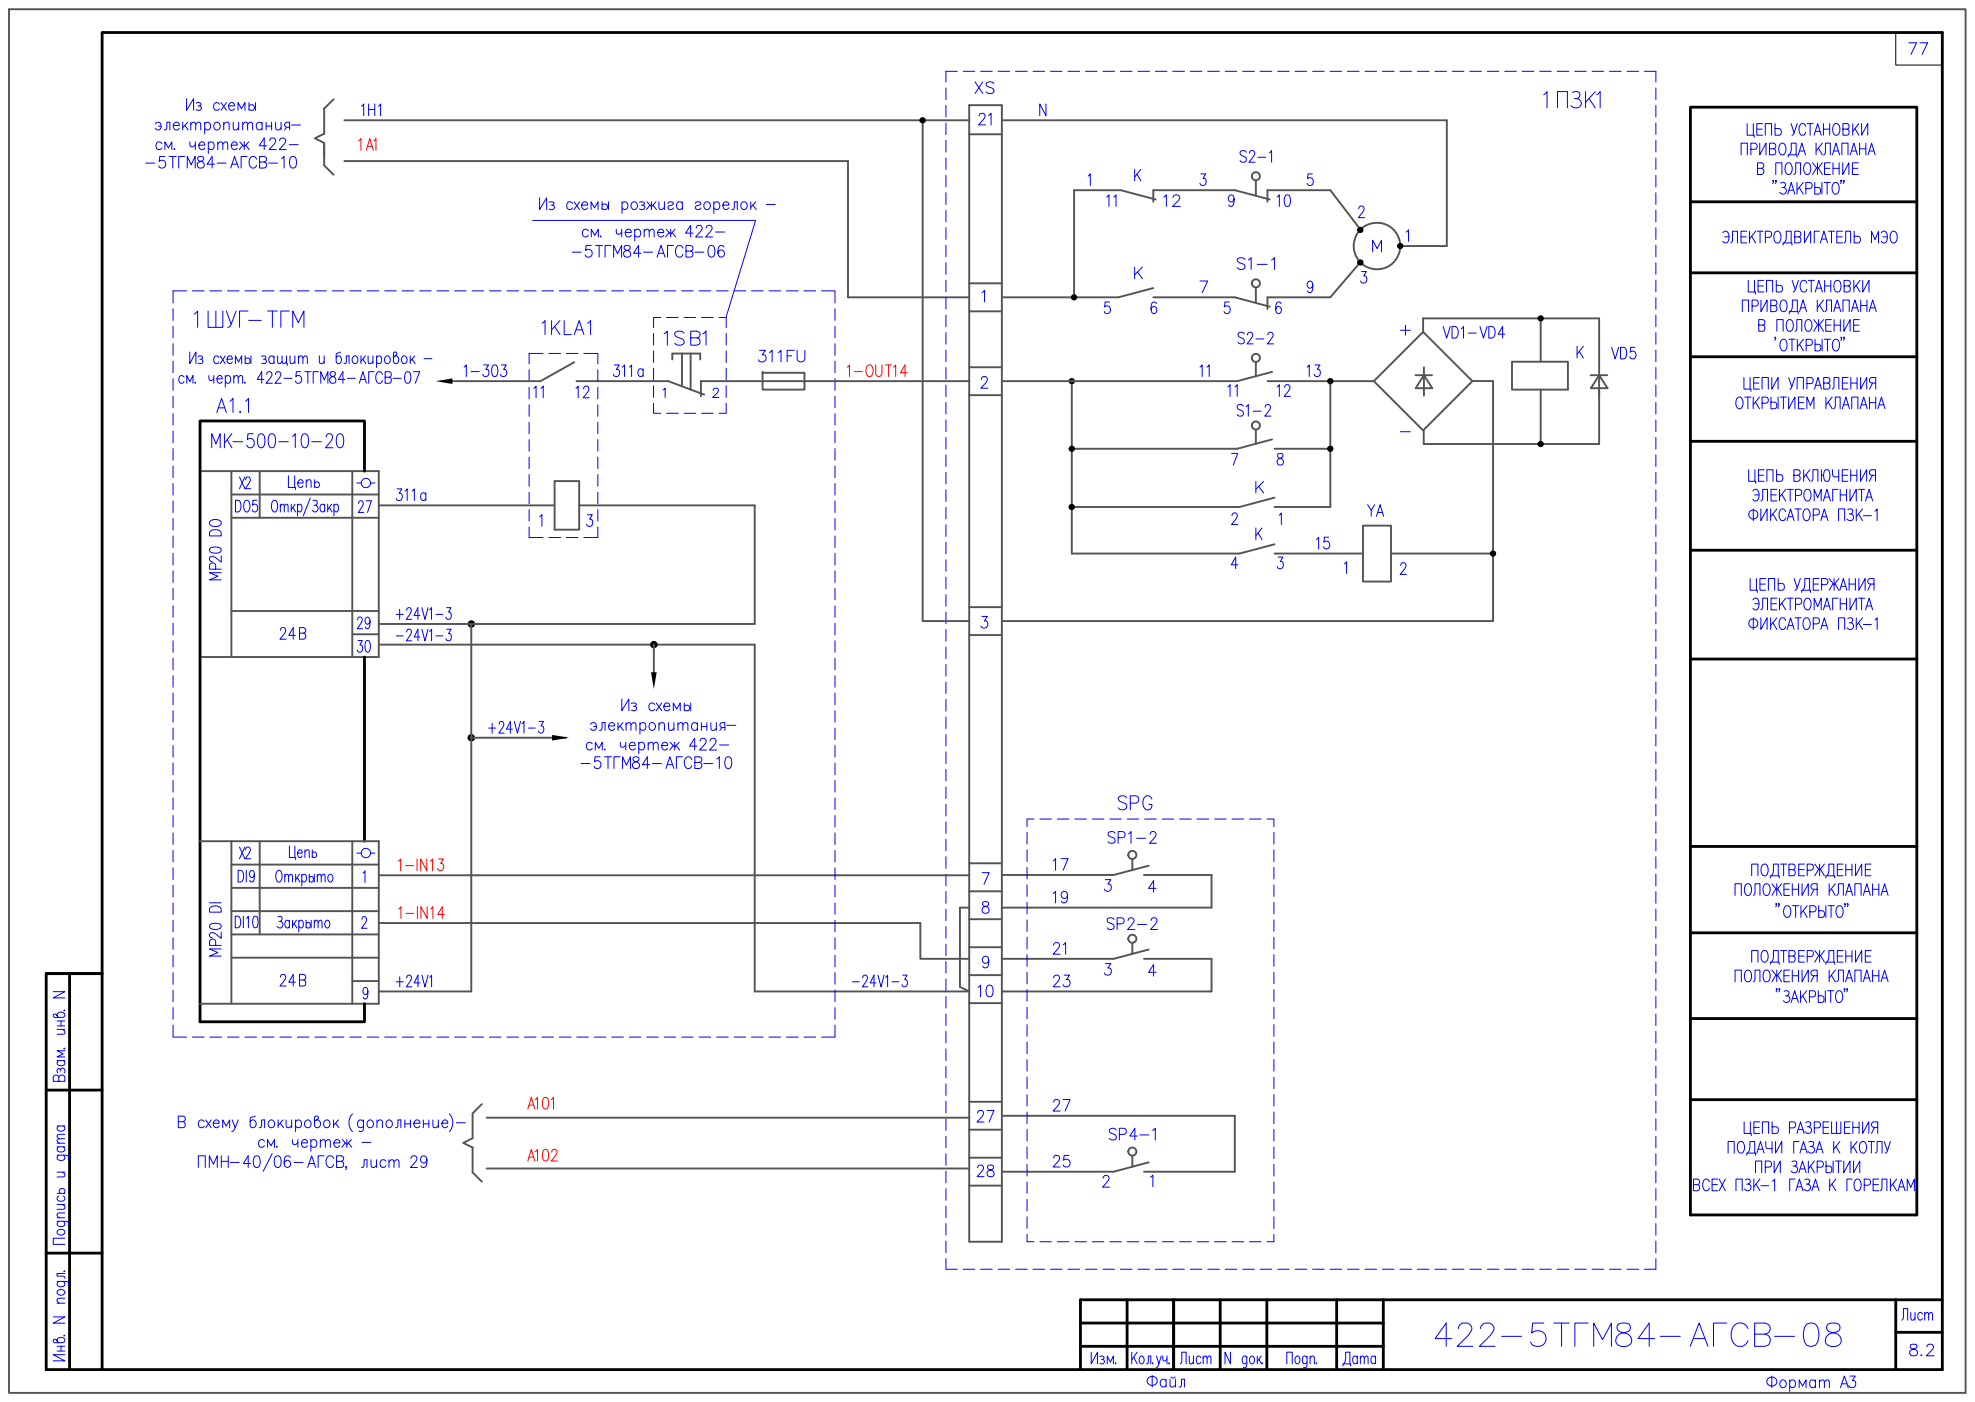
[picture p213: page 32]

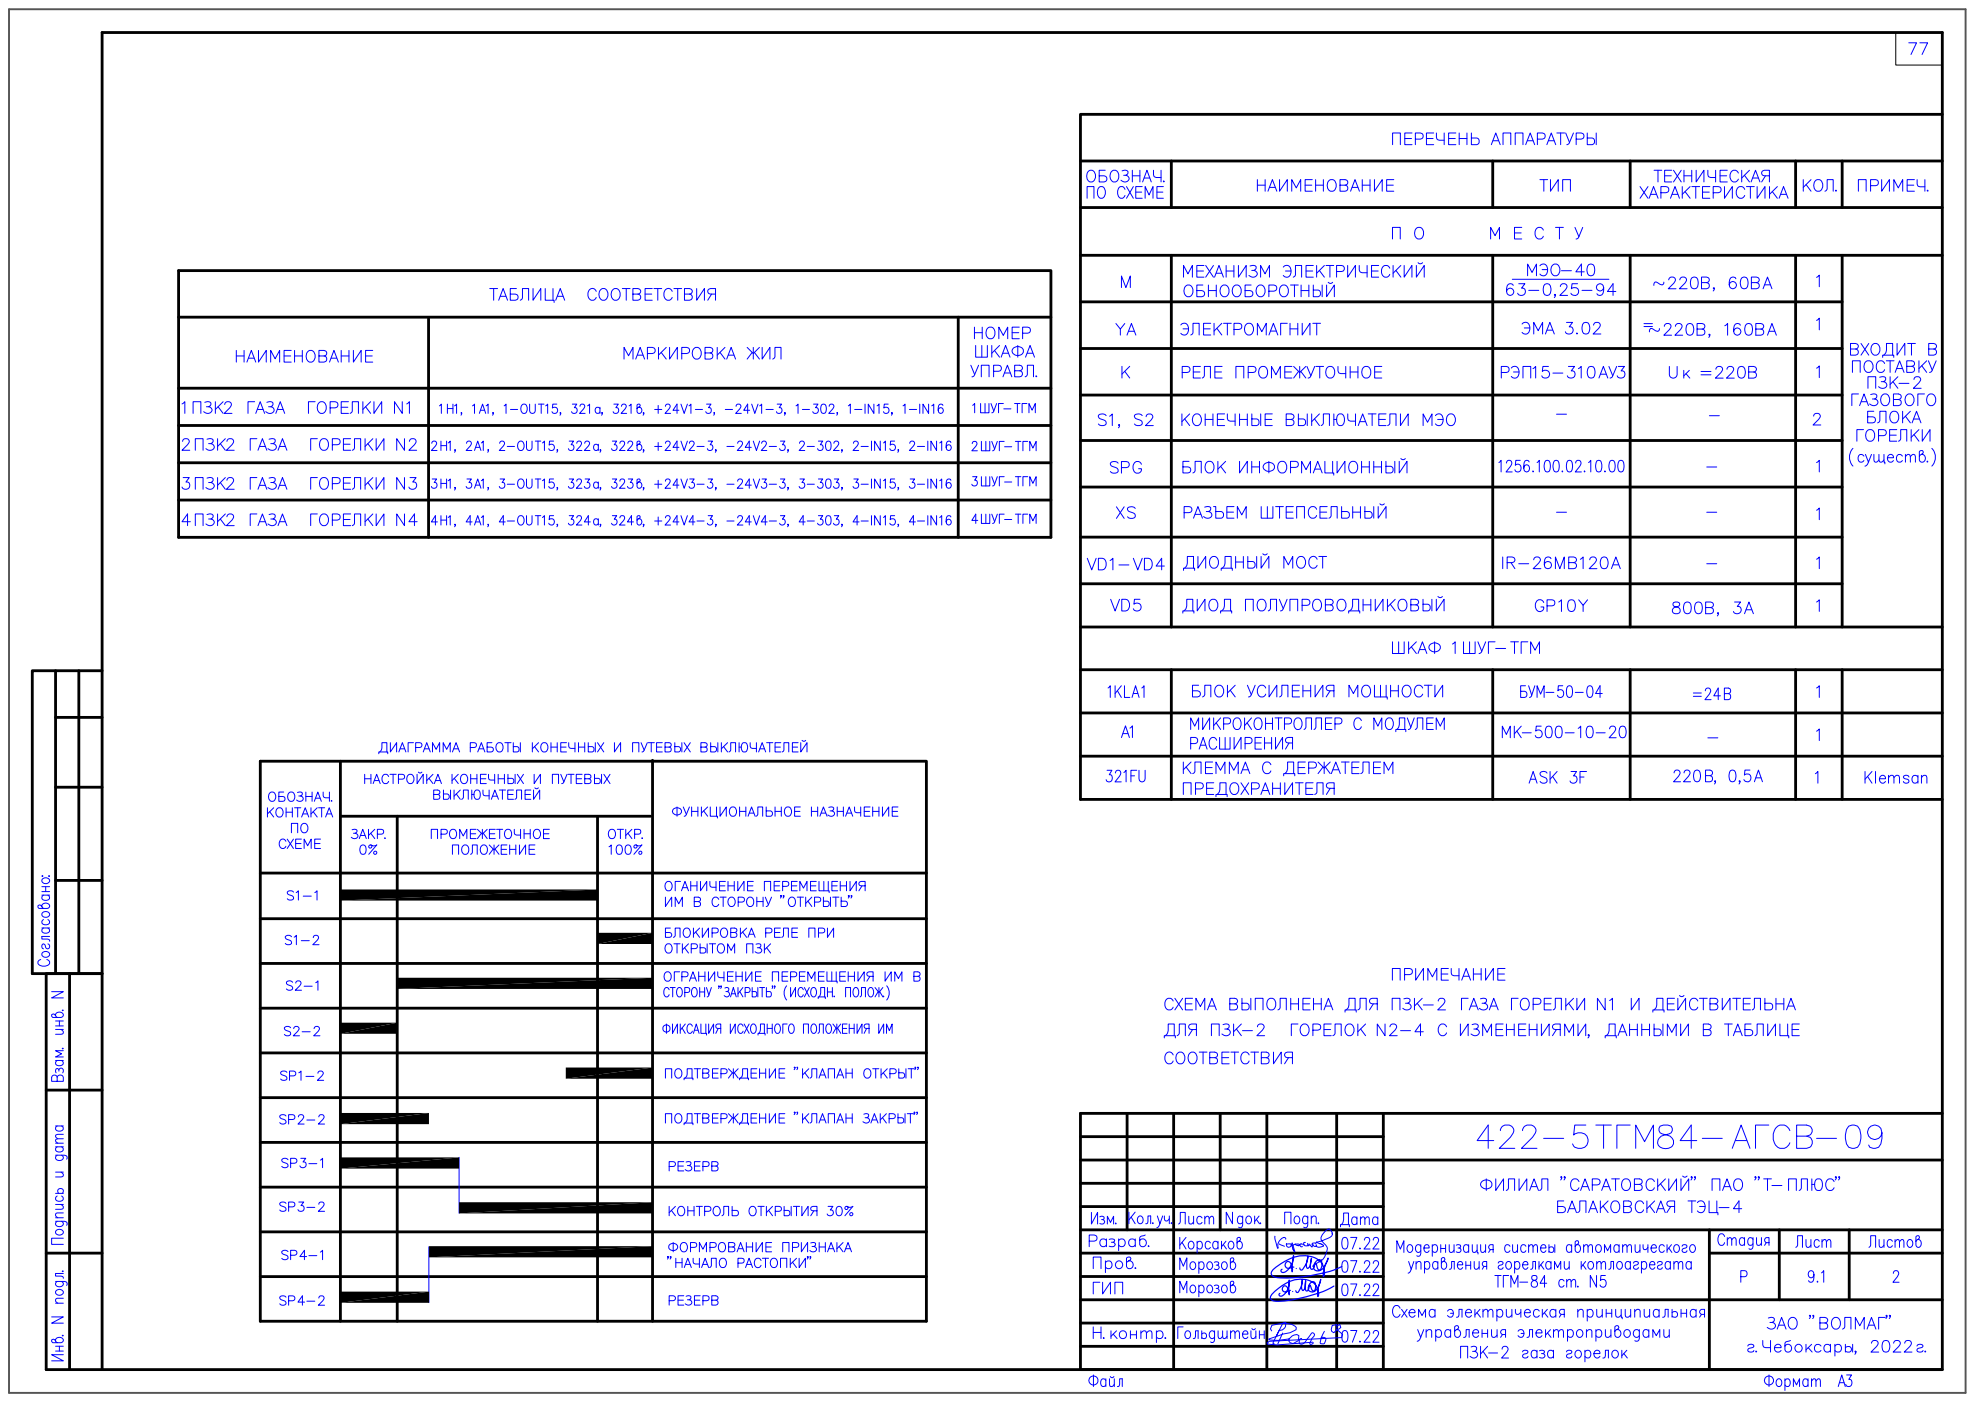
[picture p214: page 33]

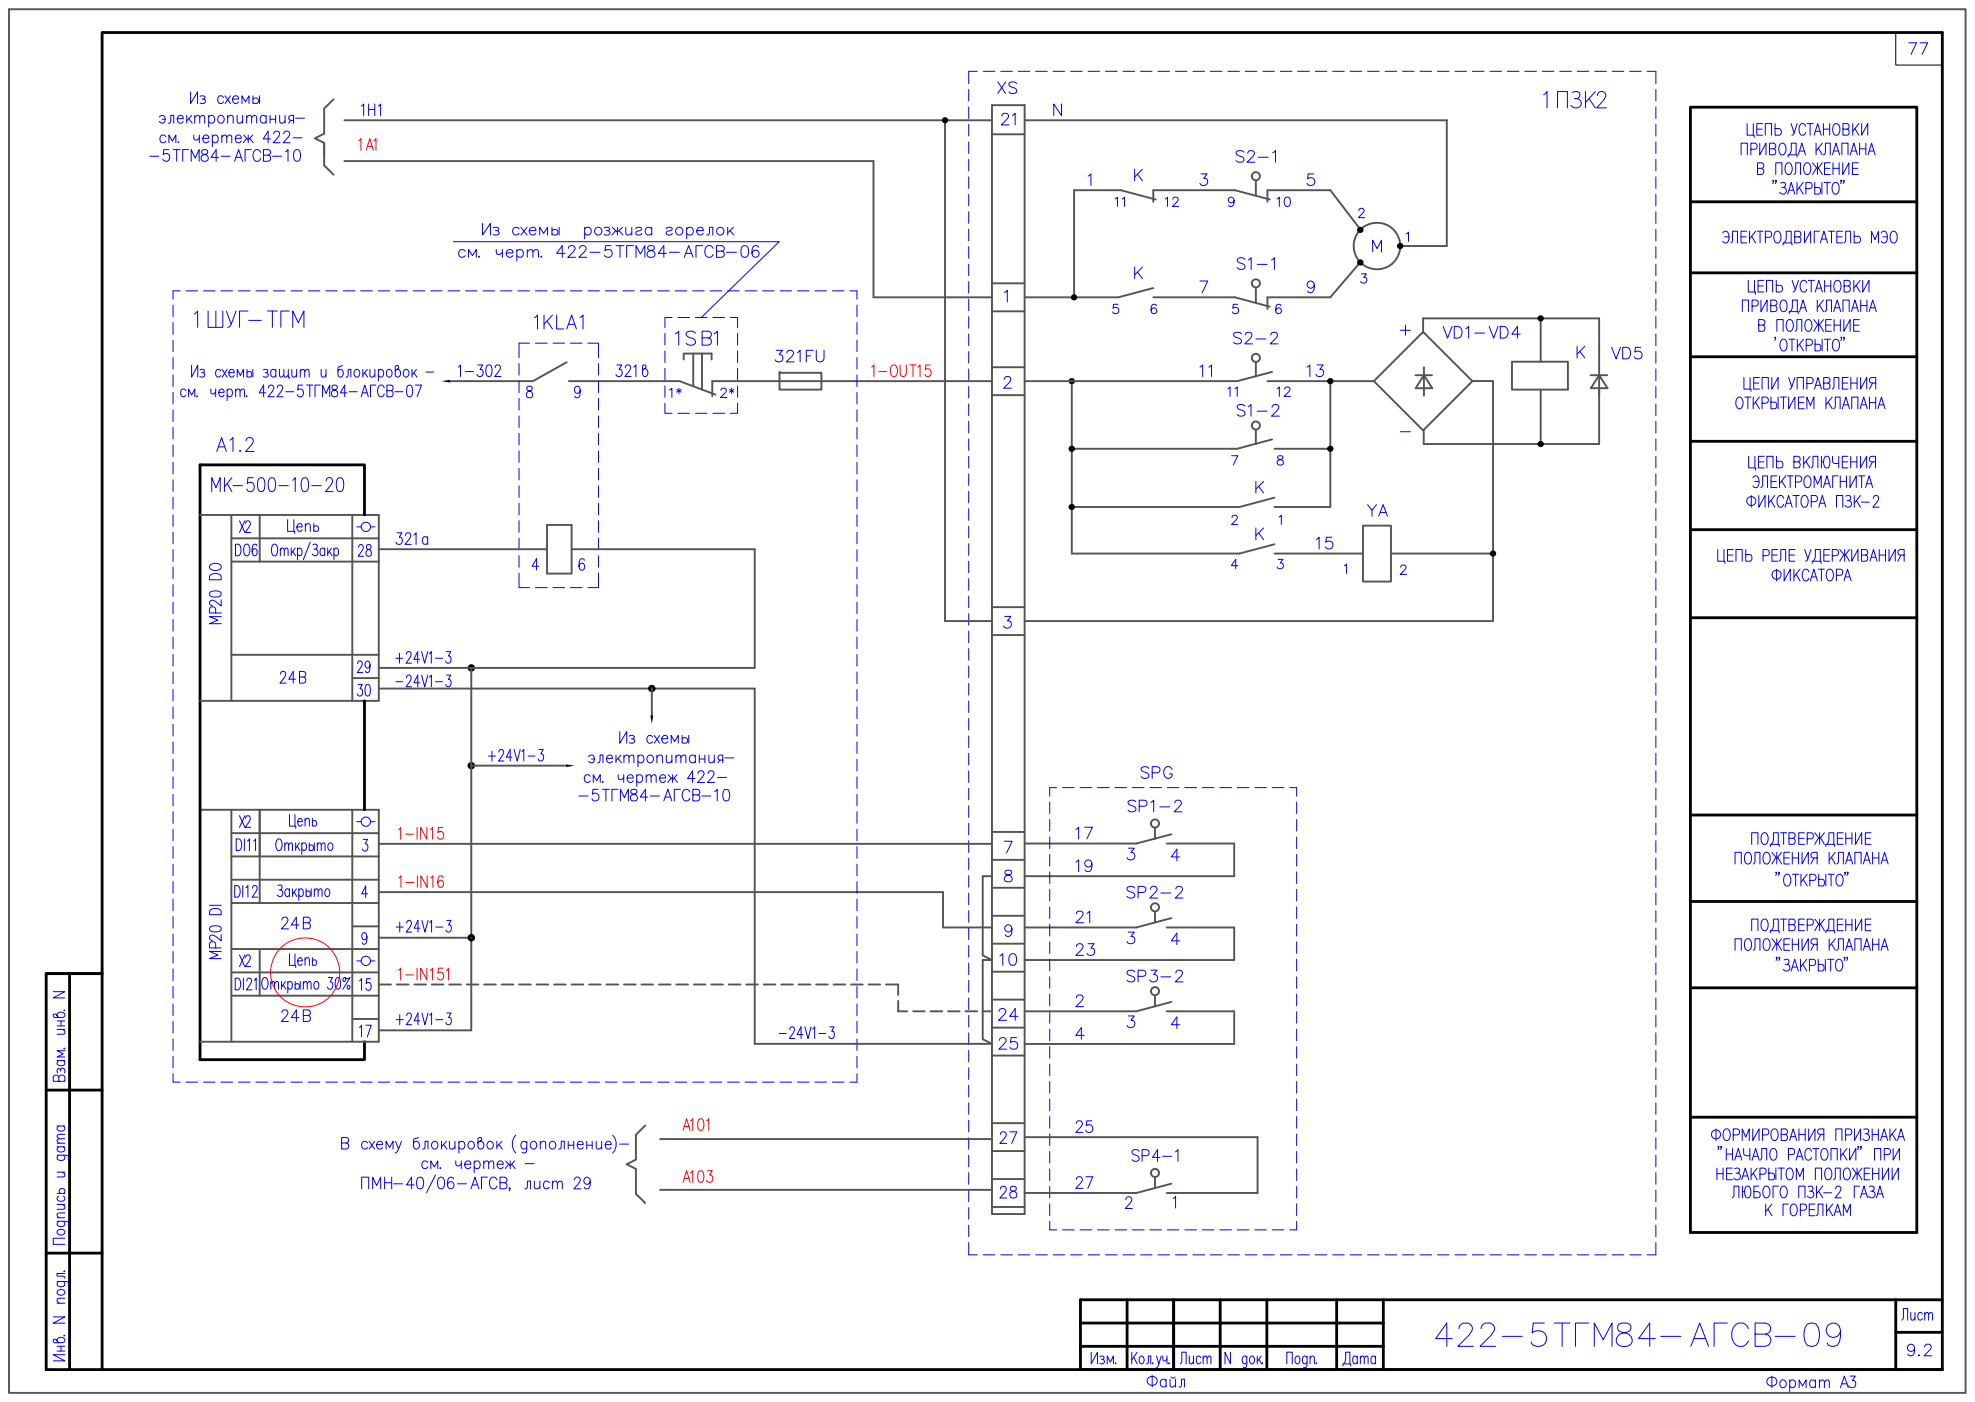
[picture p215: page 34]

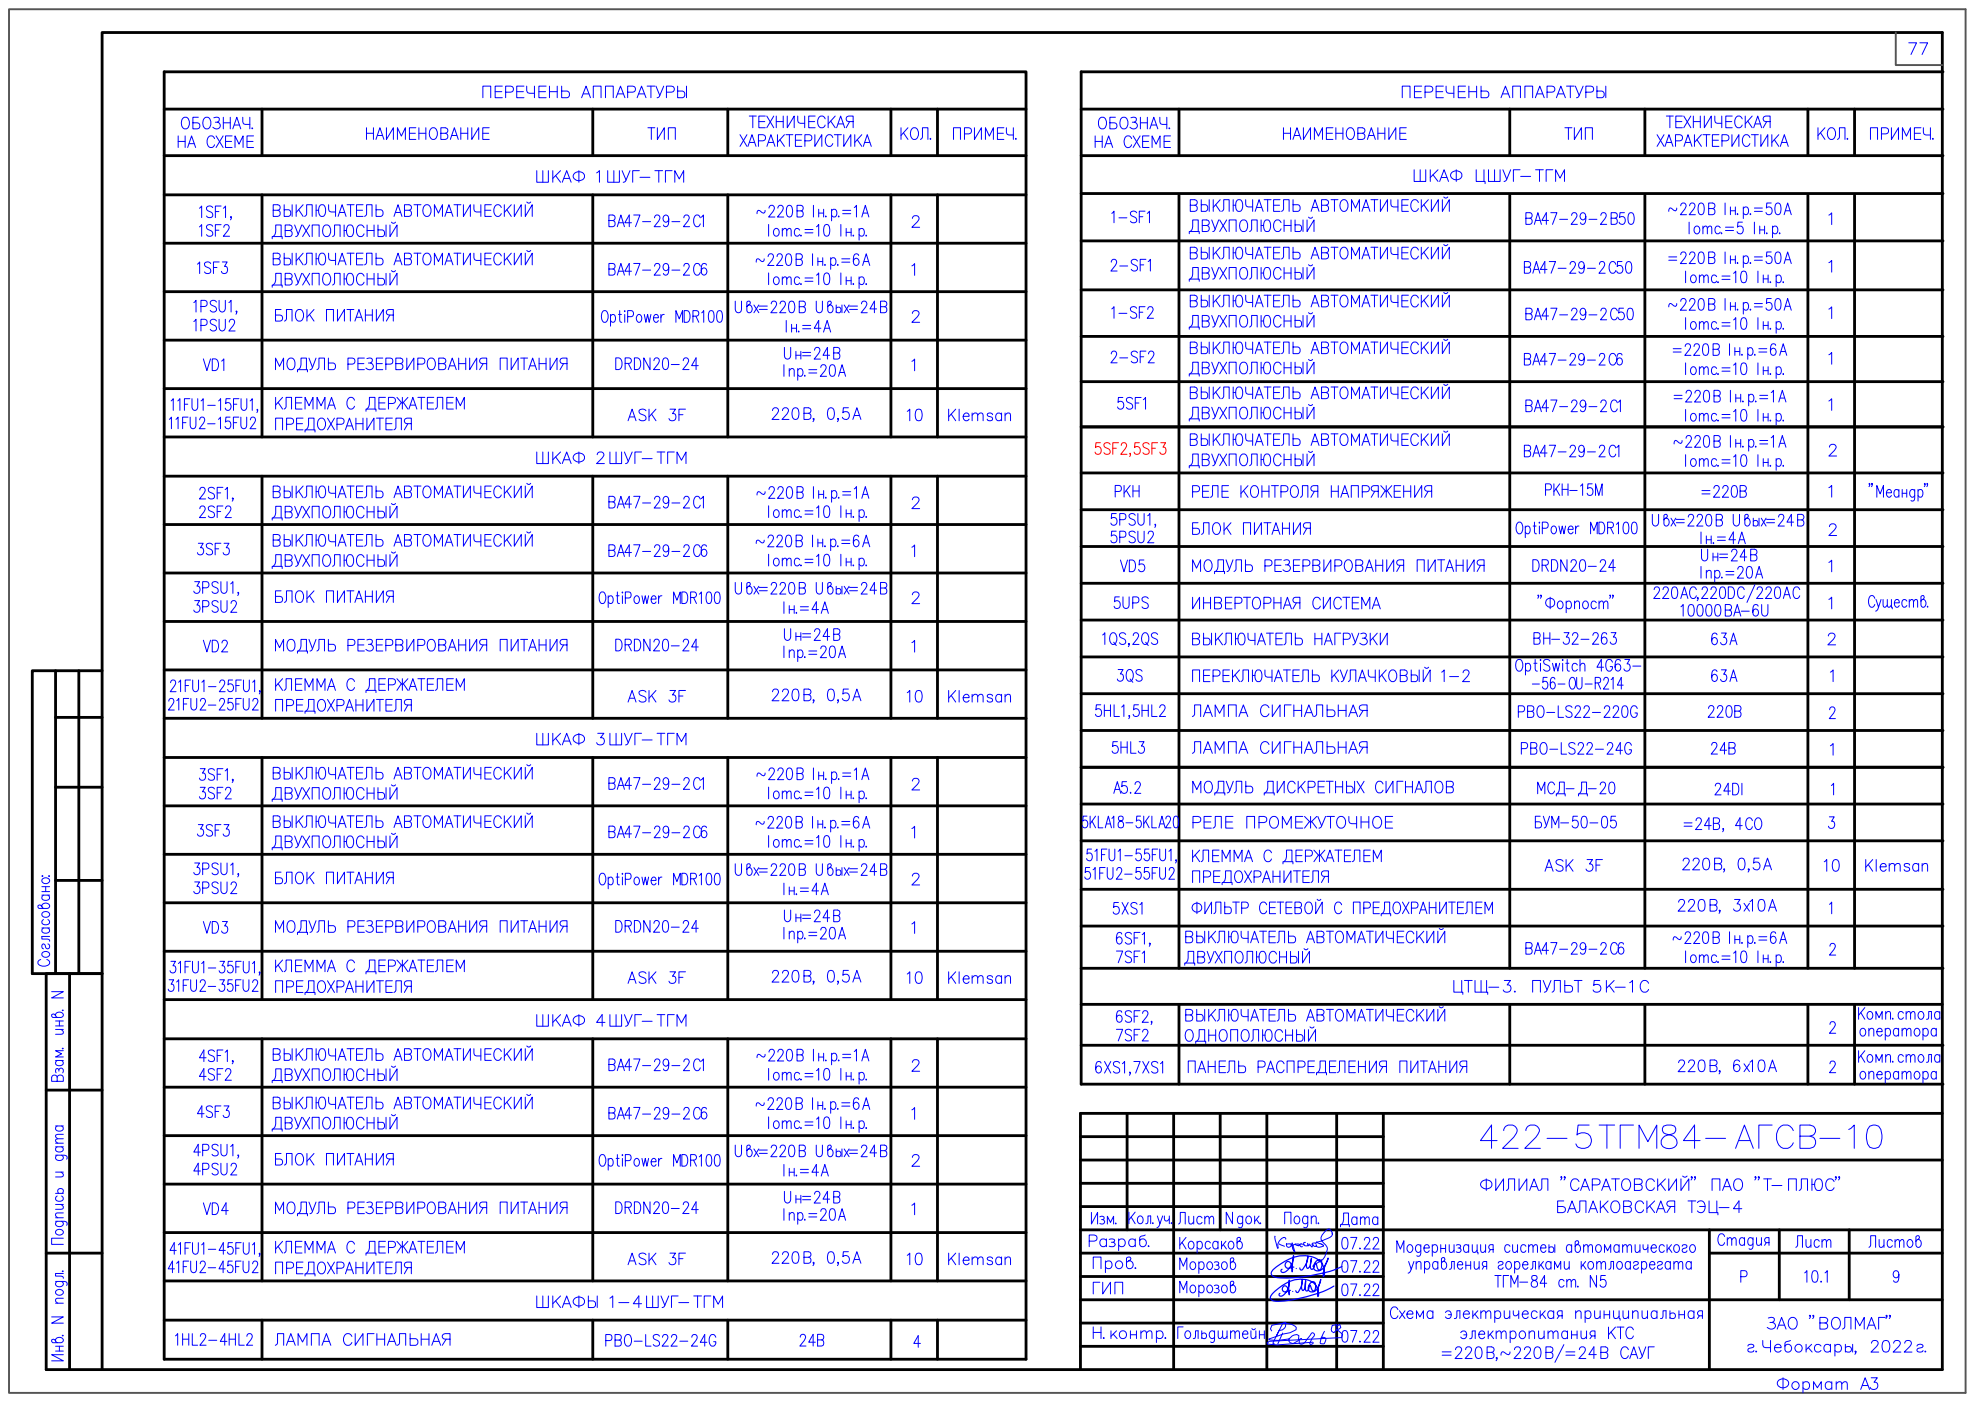
[picture p216: page 35]

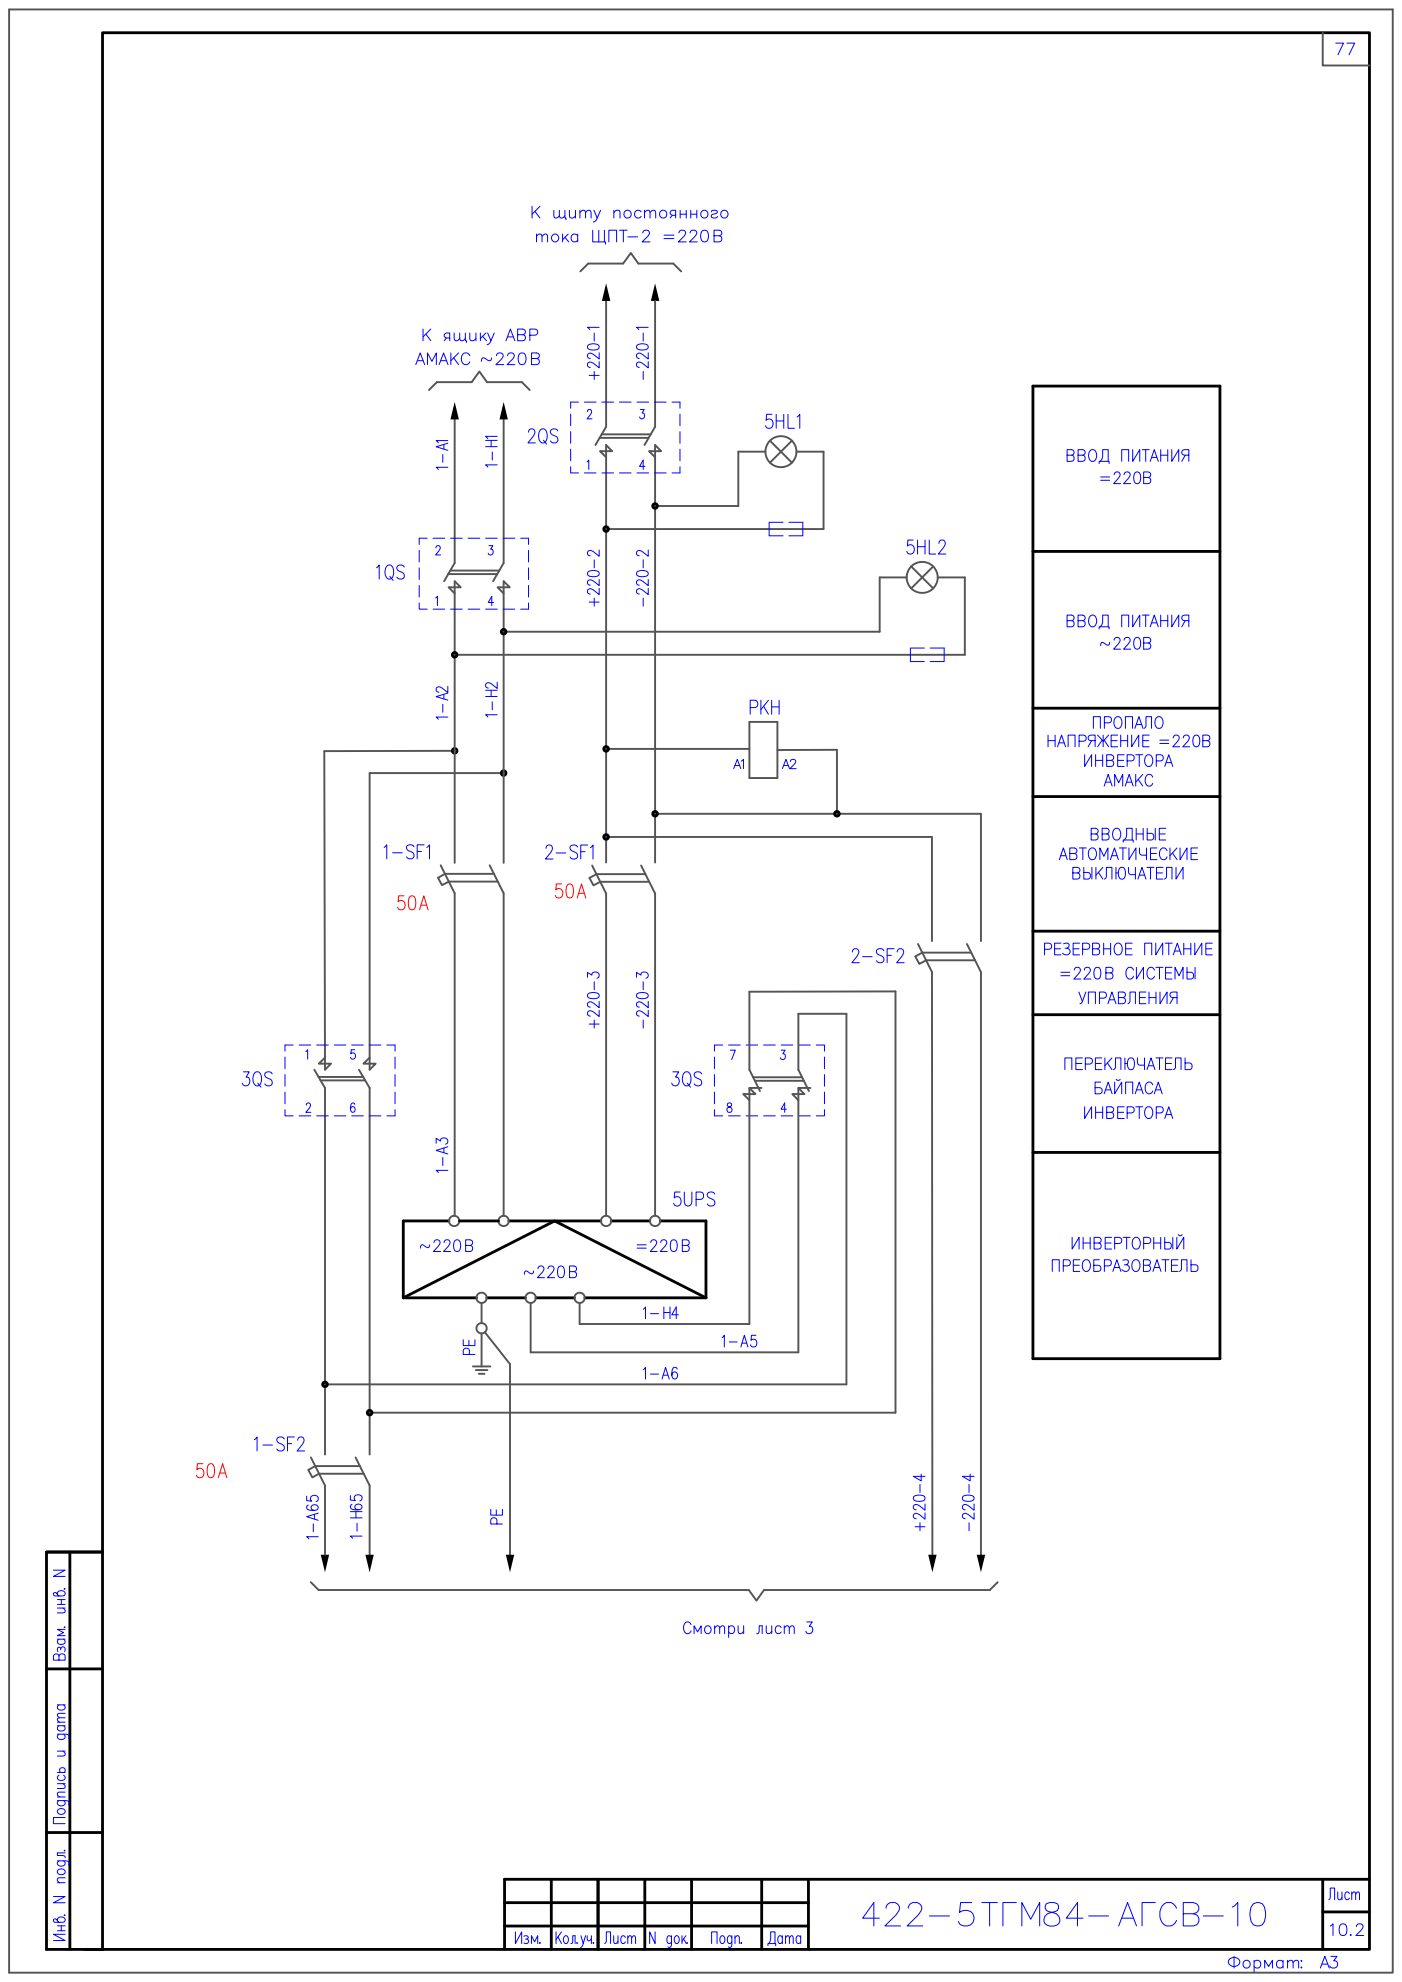
[picture p217: page 36]

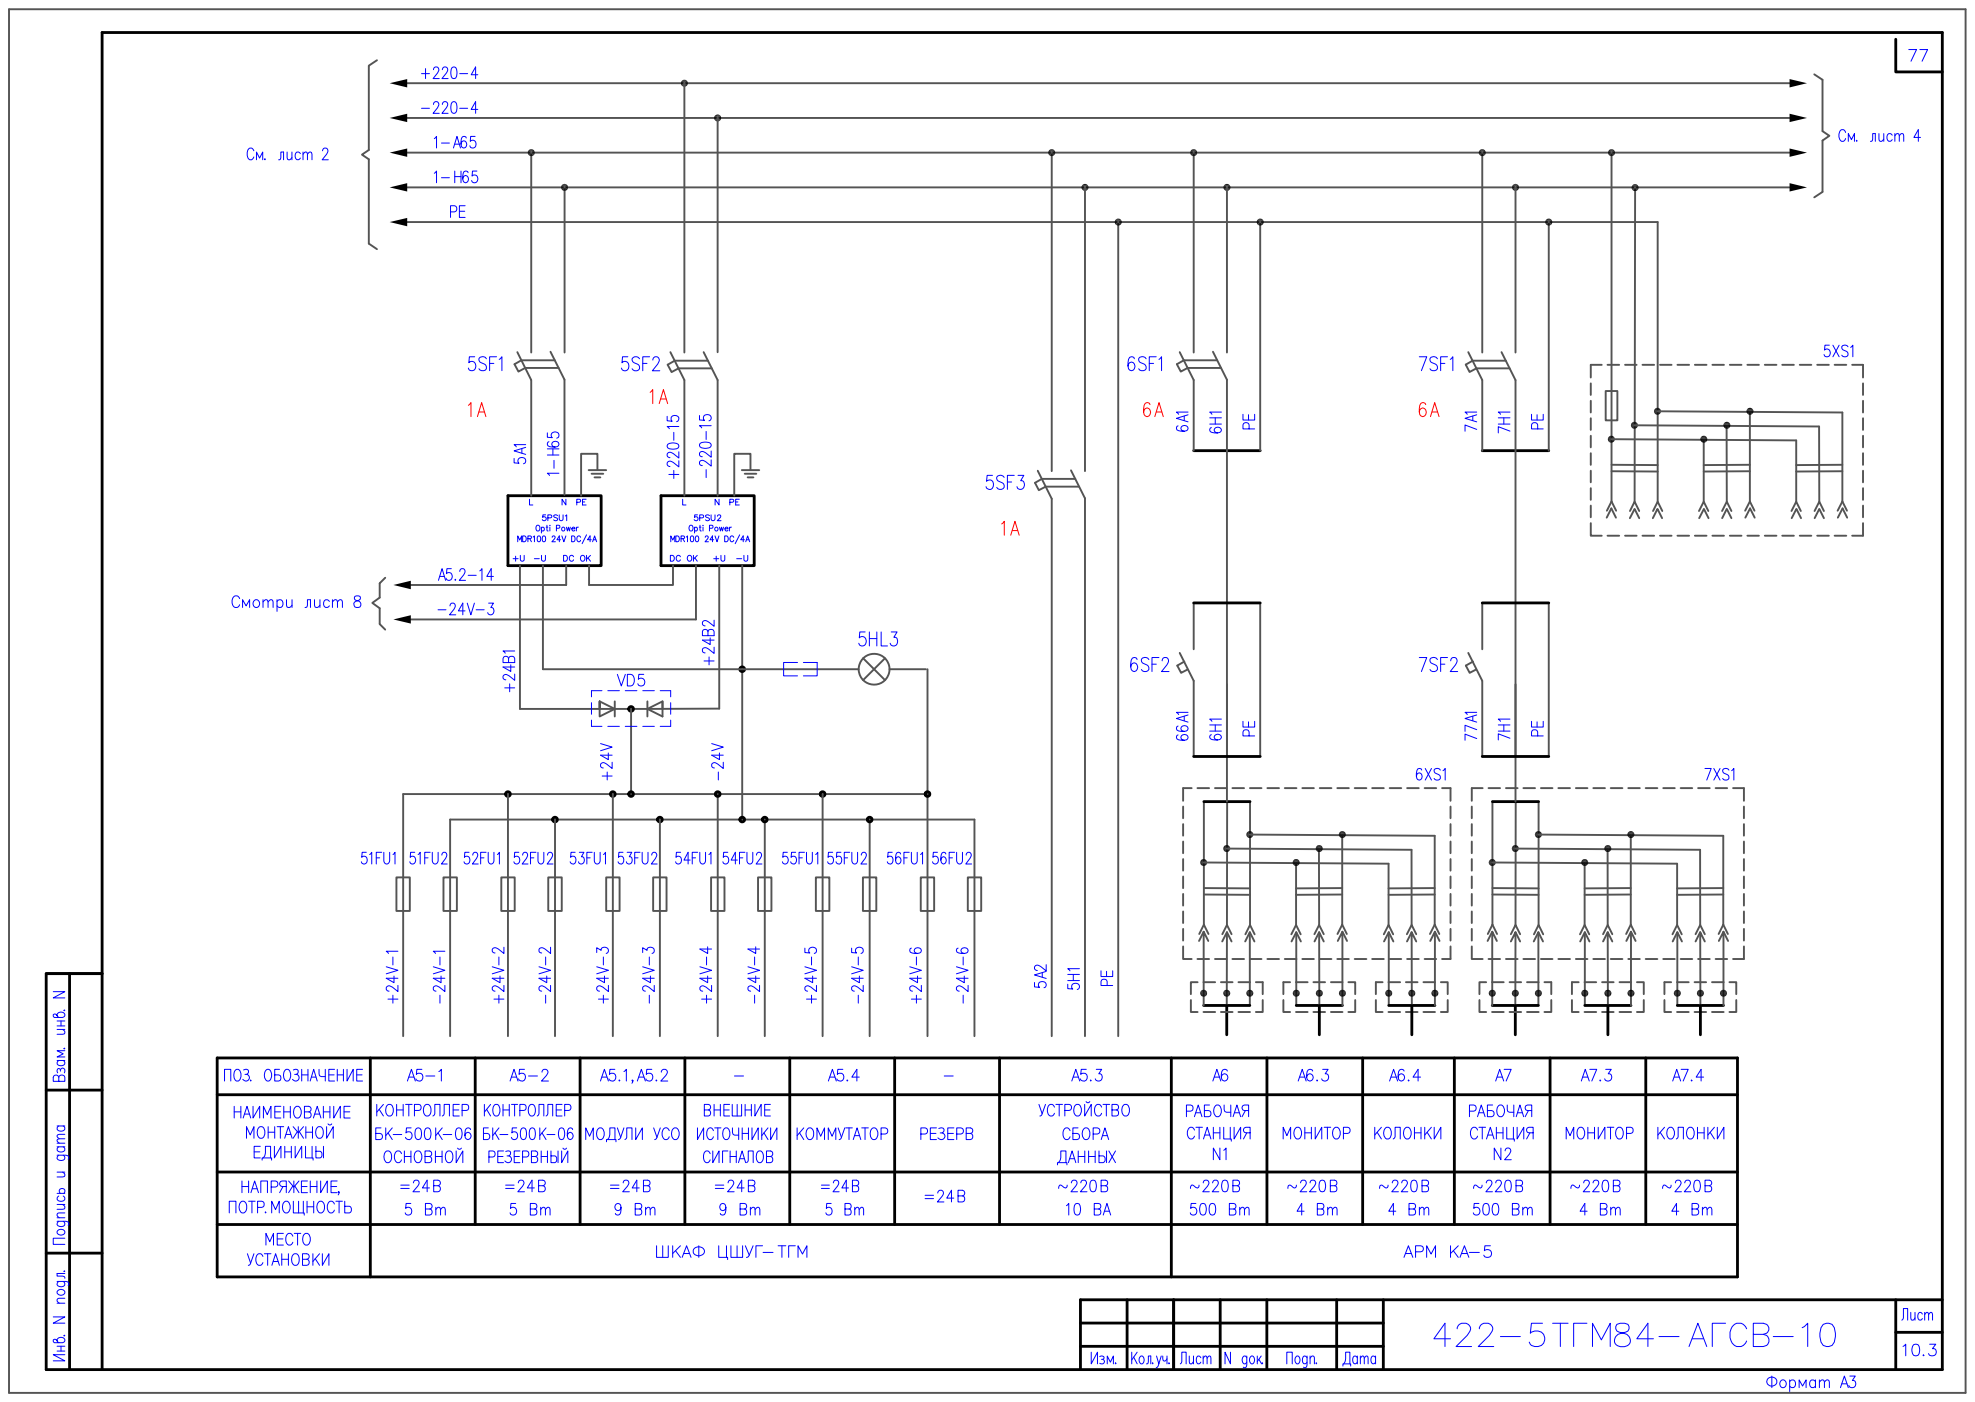
[picture p218: page 37]

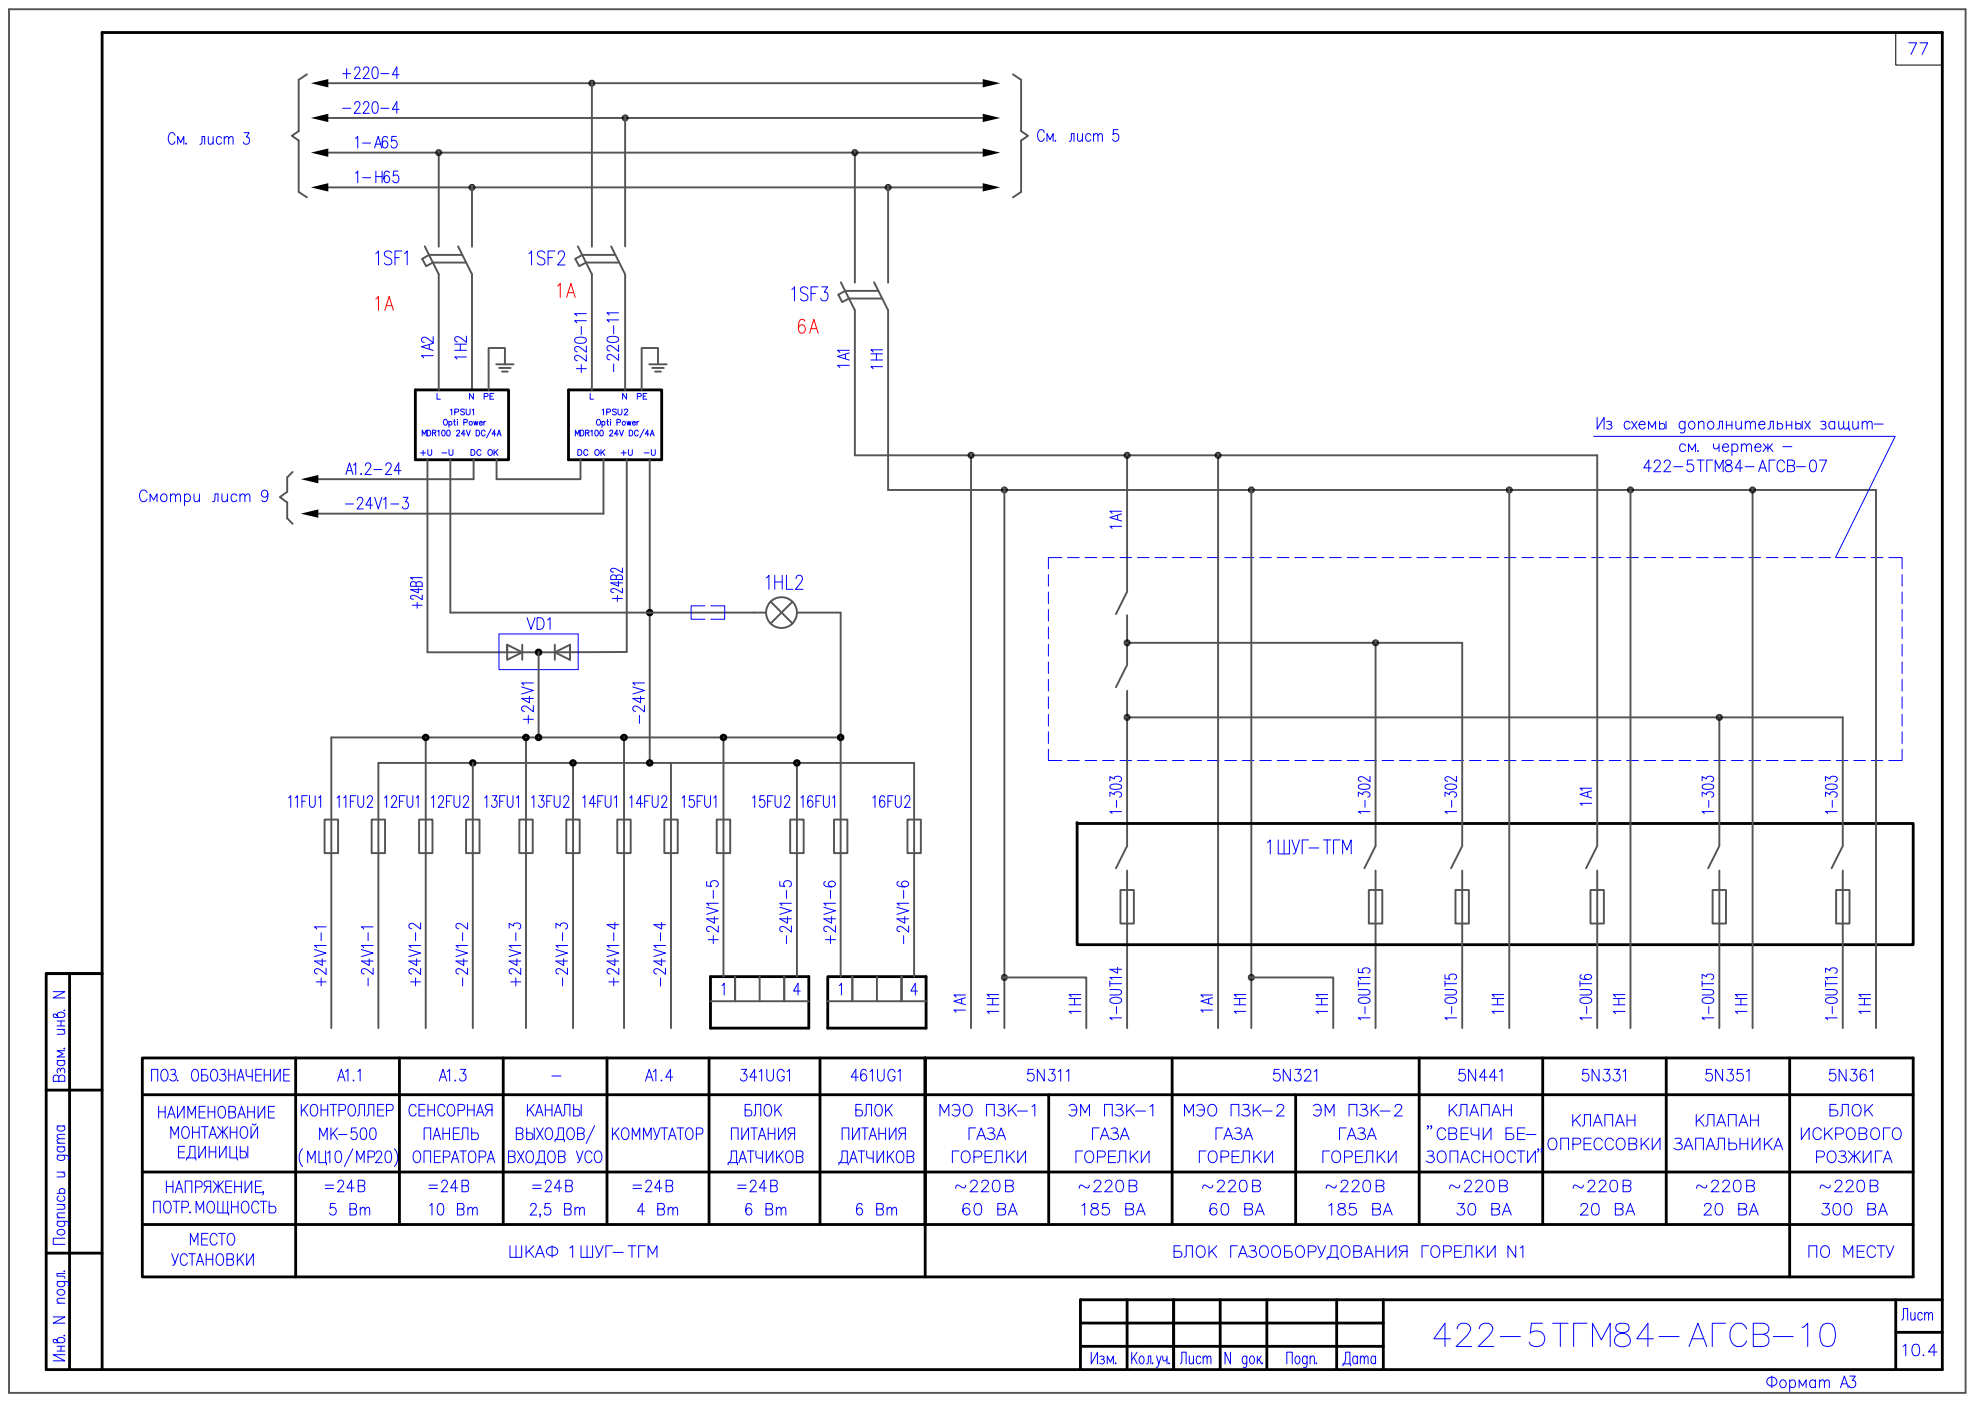
[picture p219: page 38]

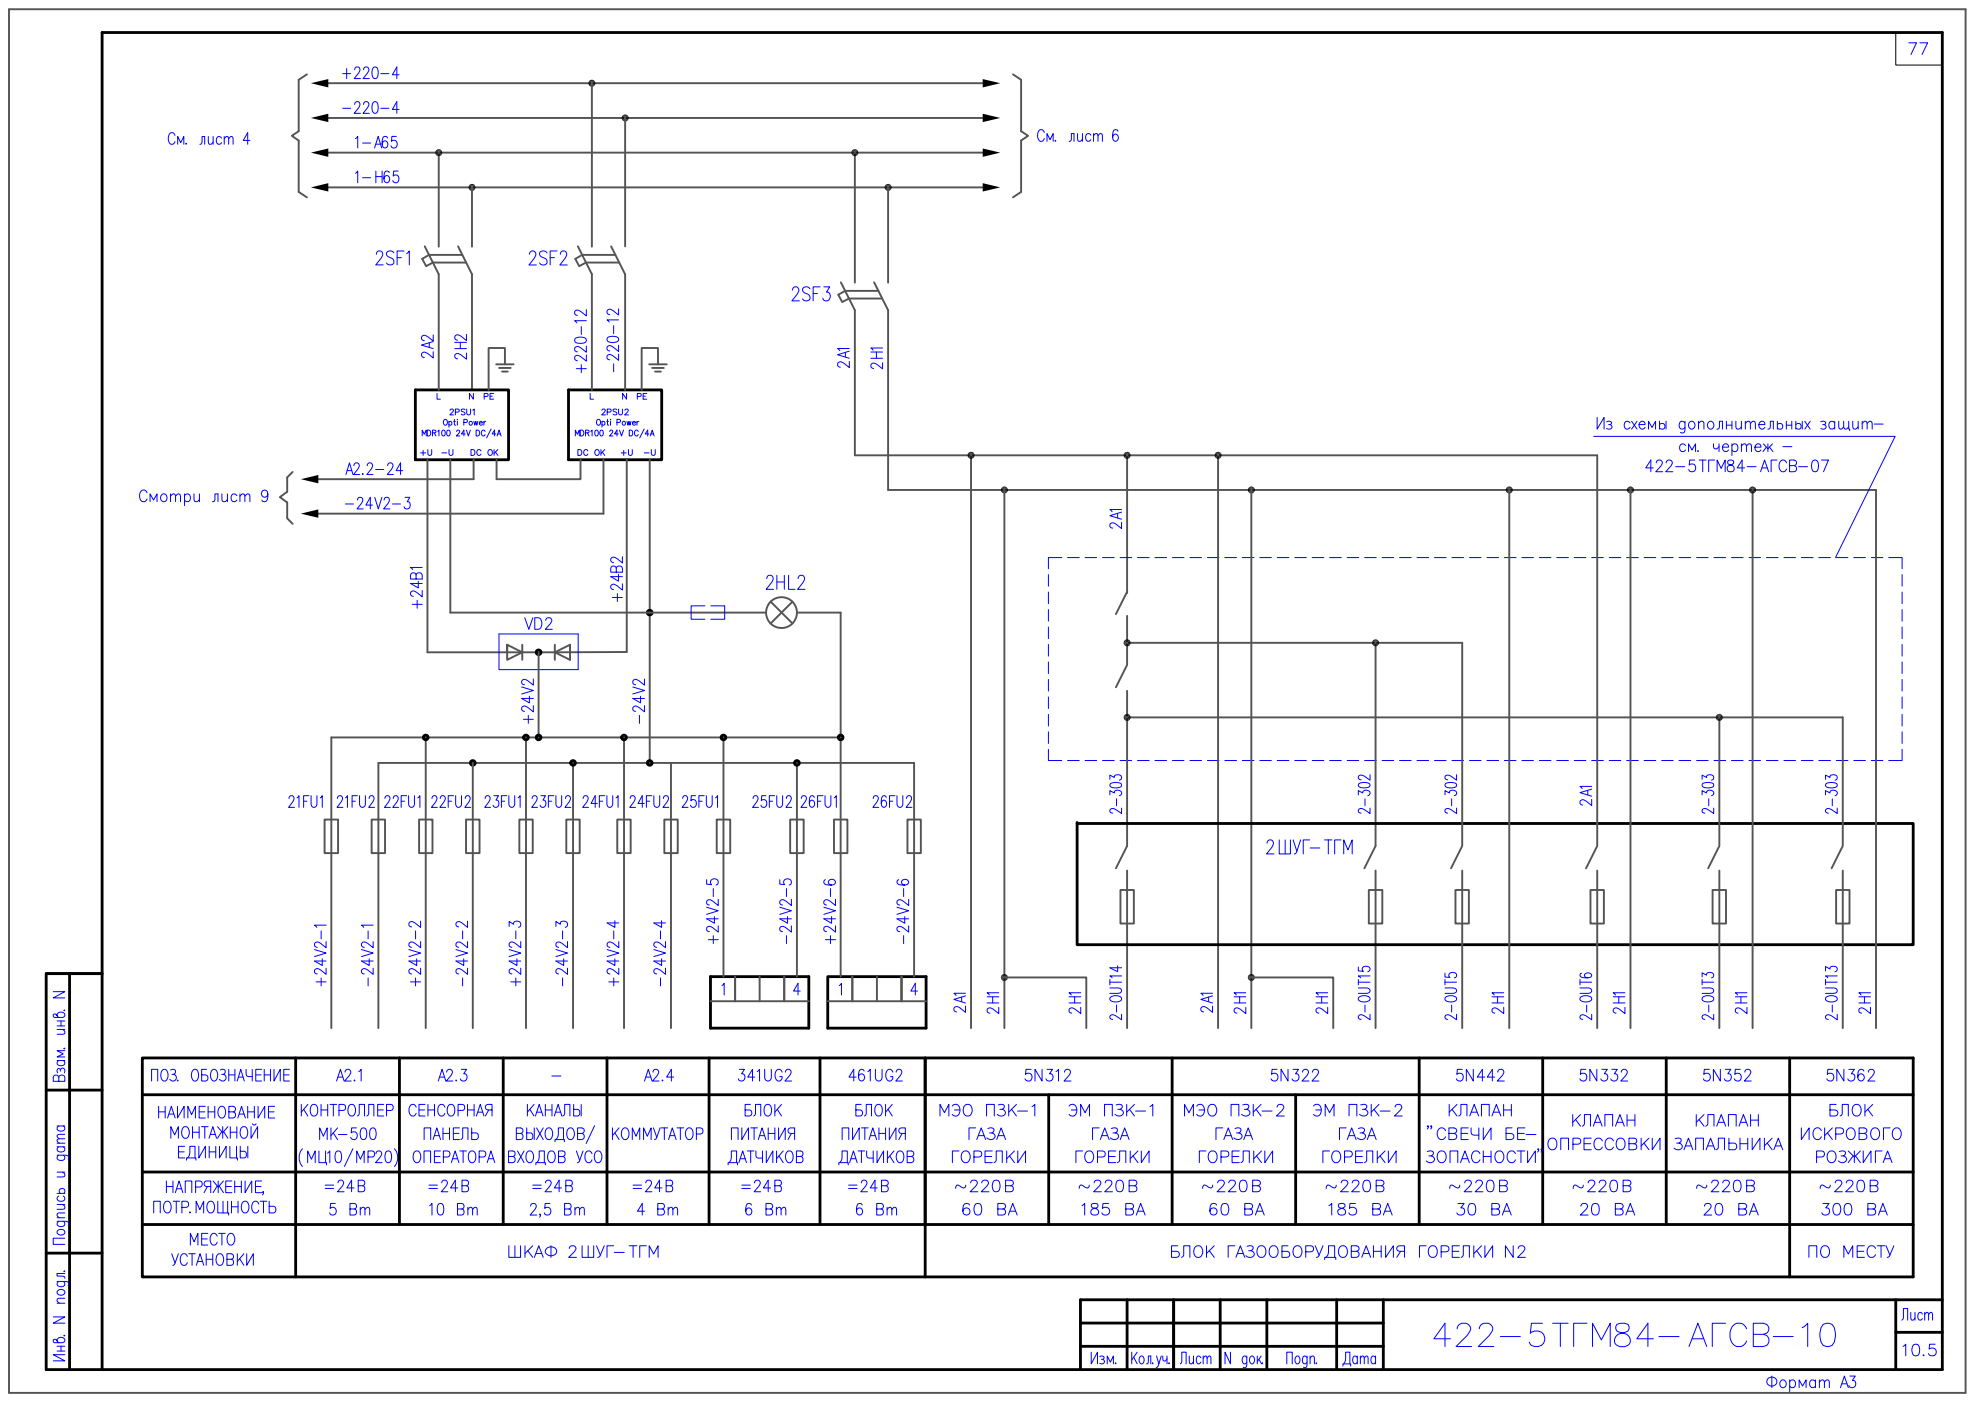
[picture p220: page 39]

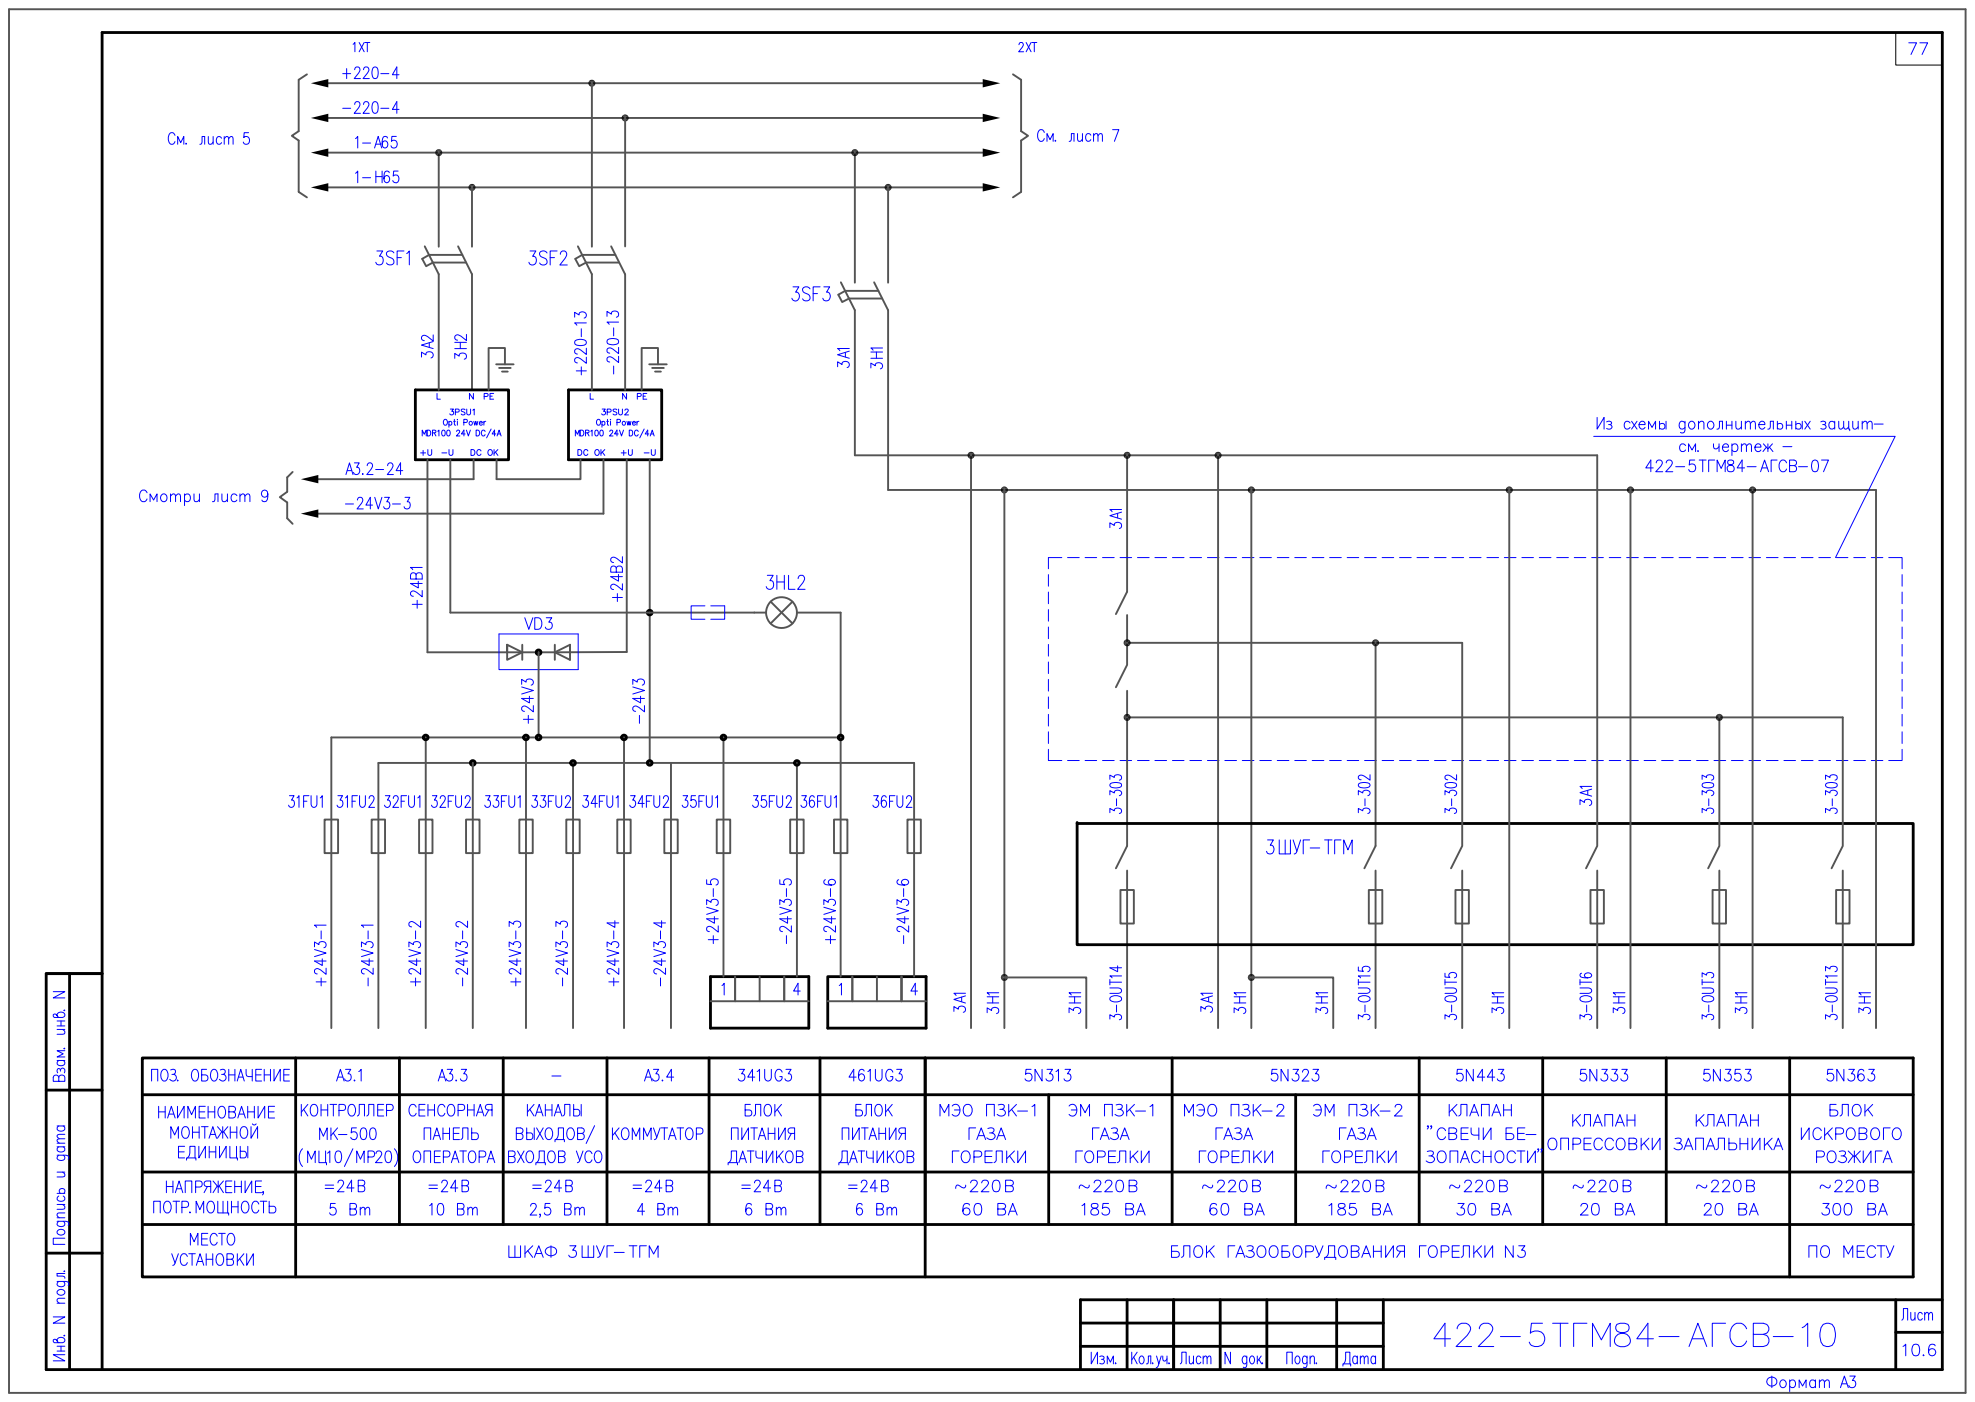
[picture p221: page 40]

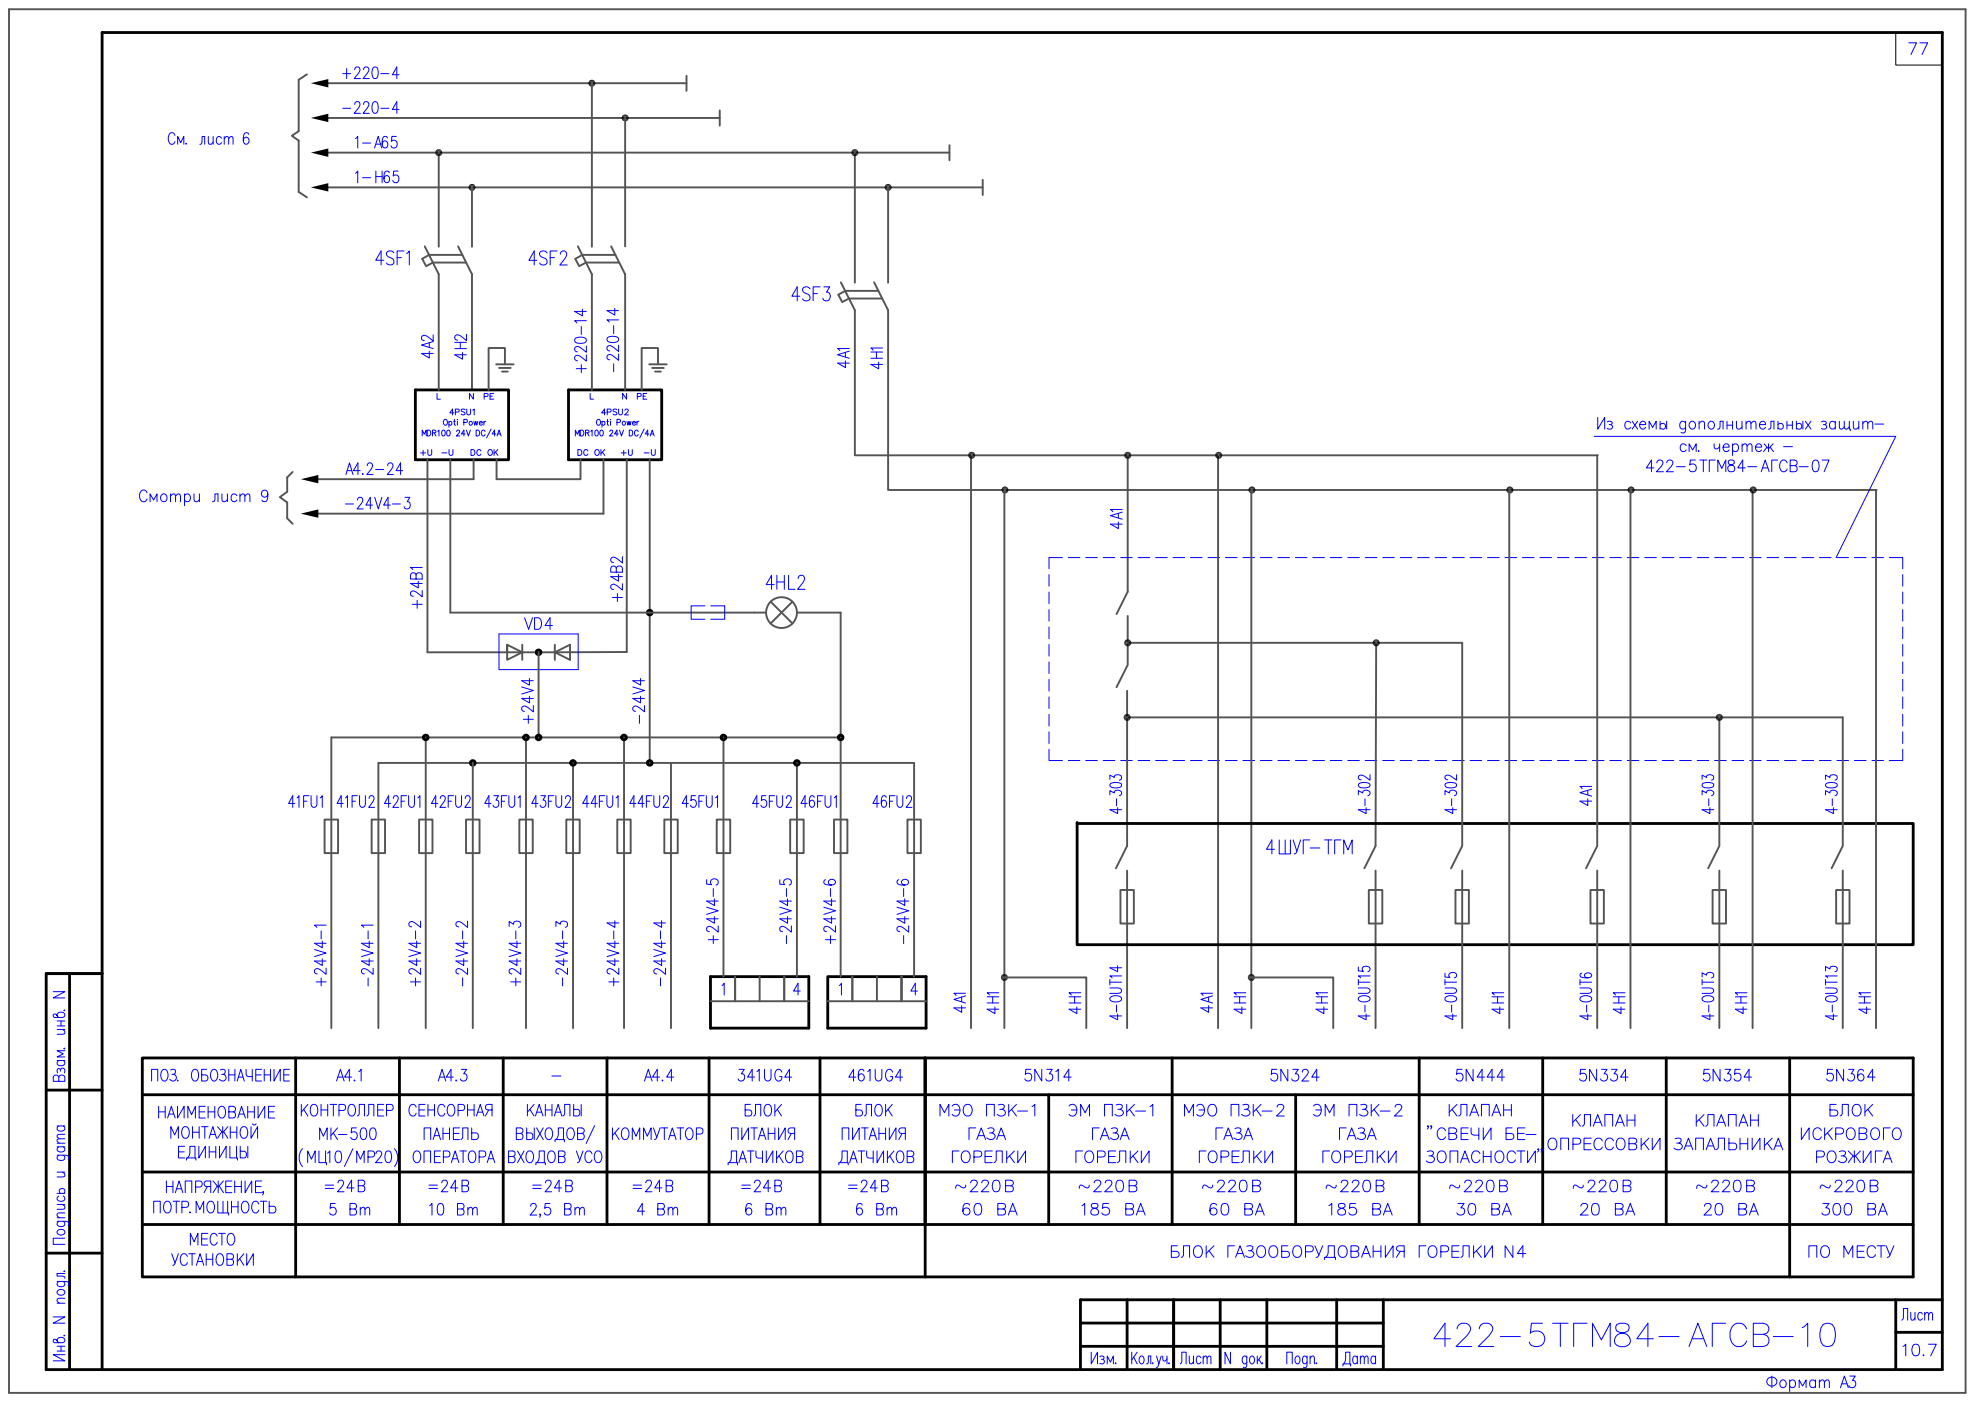
[picture p222: page 41]

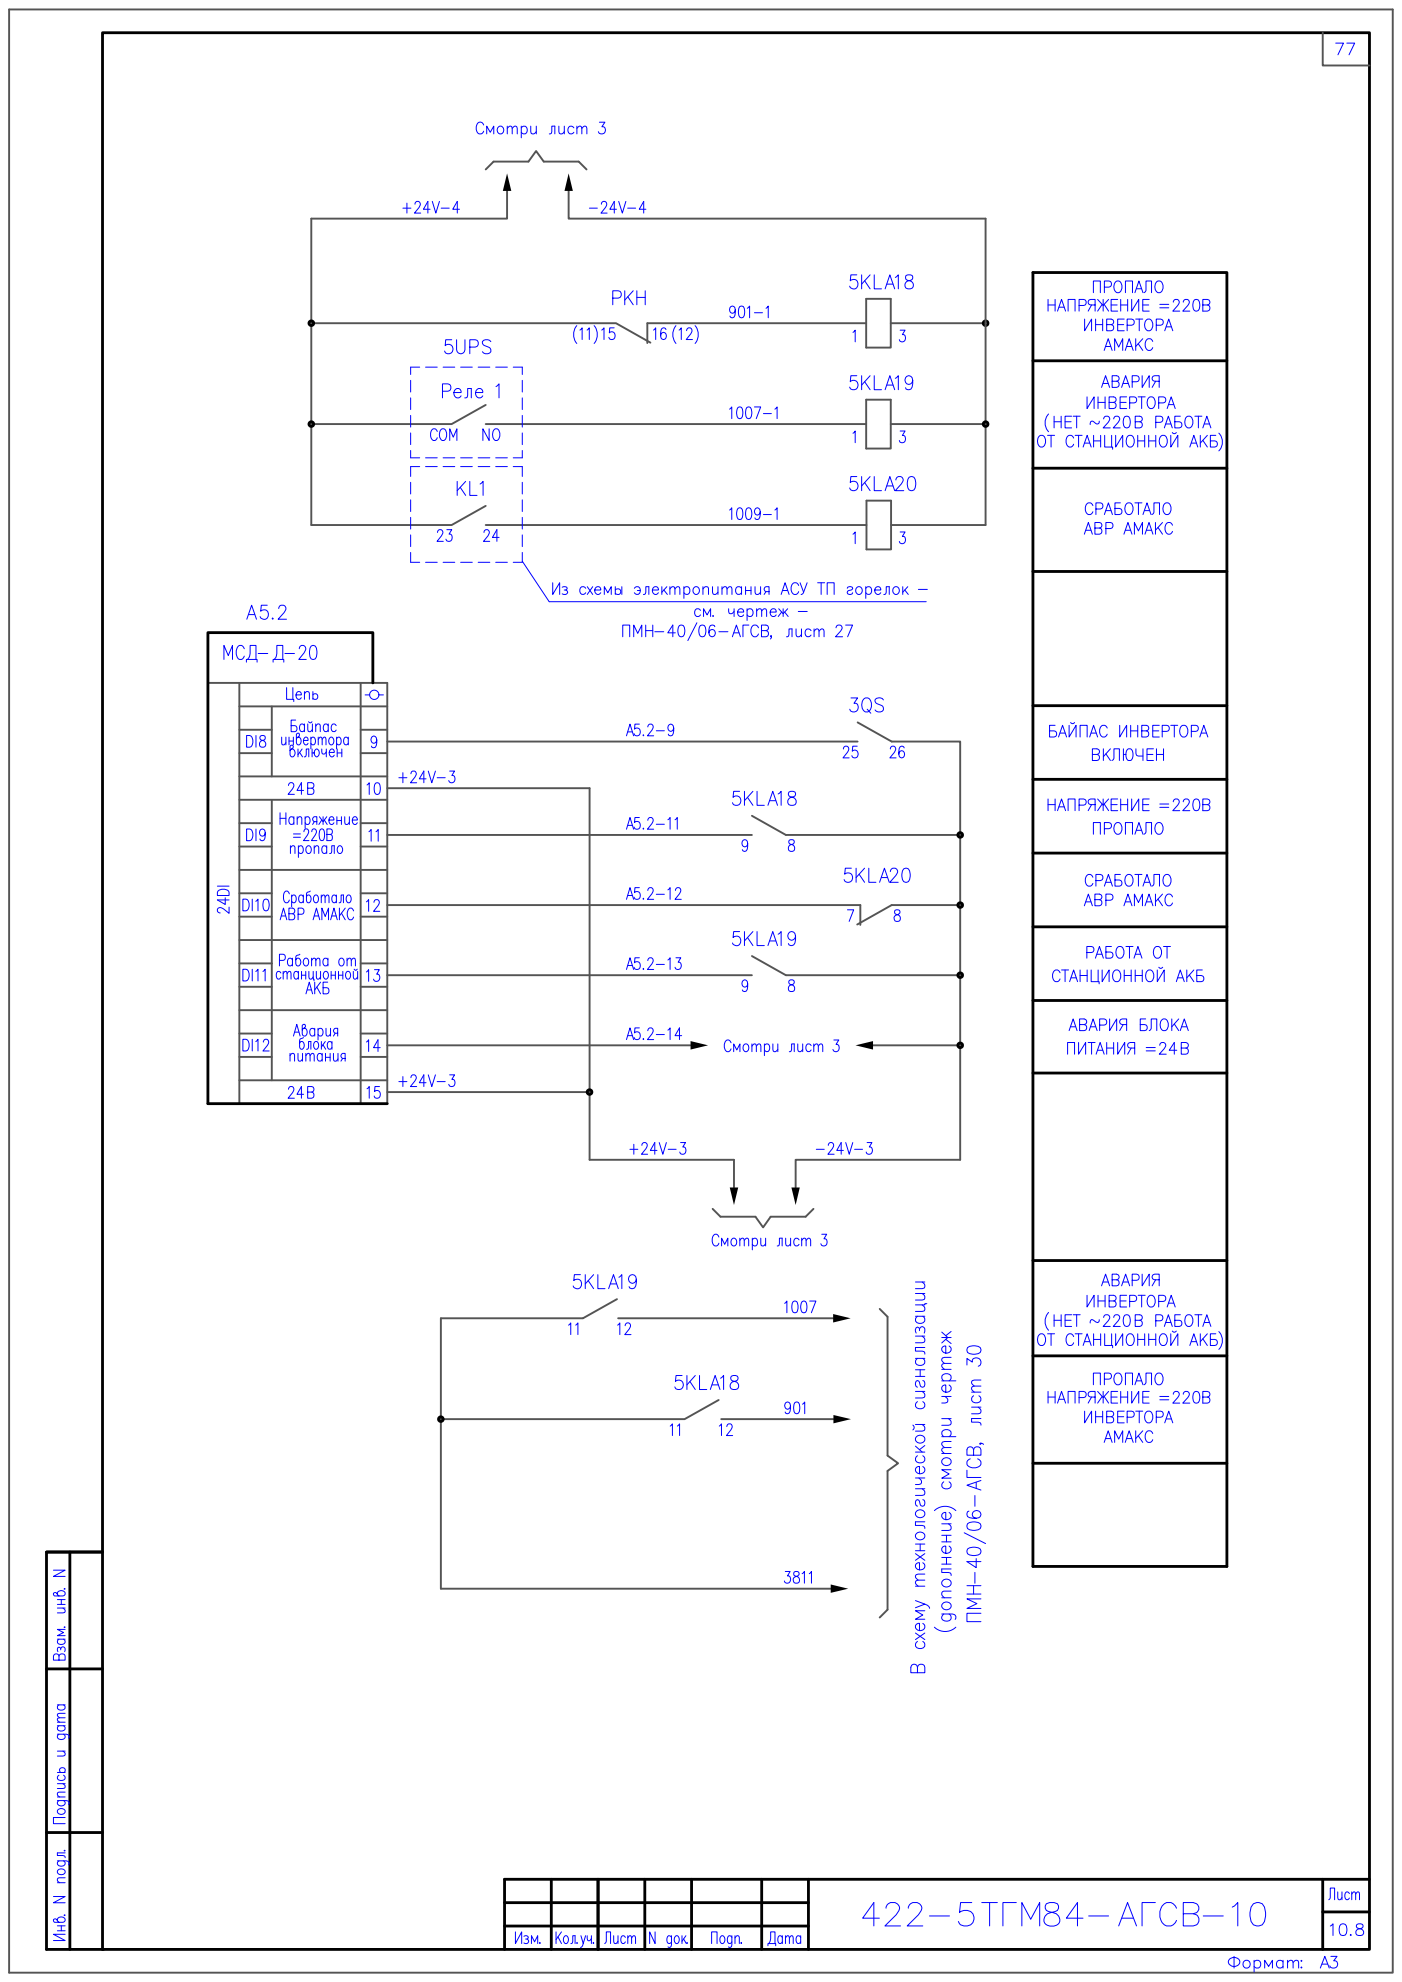
[picture p223: page 42]

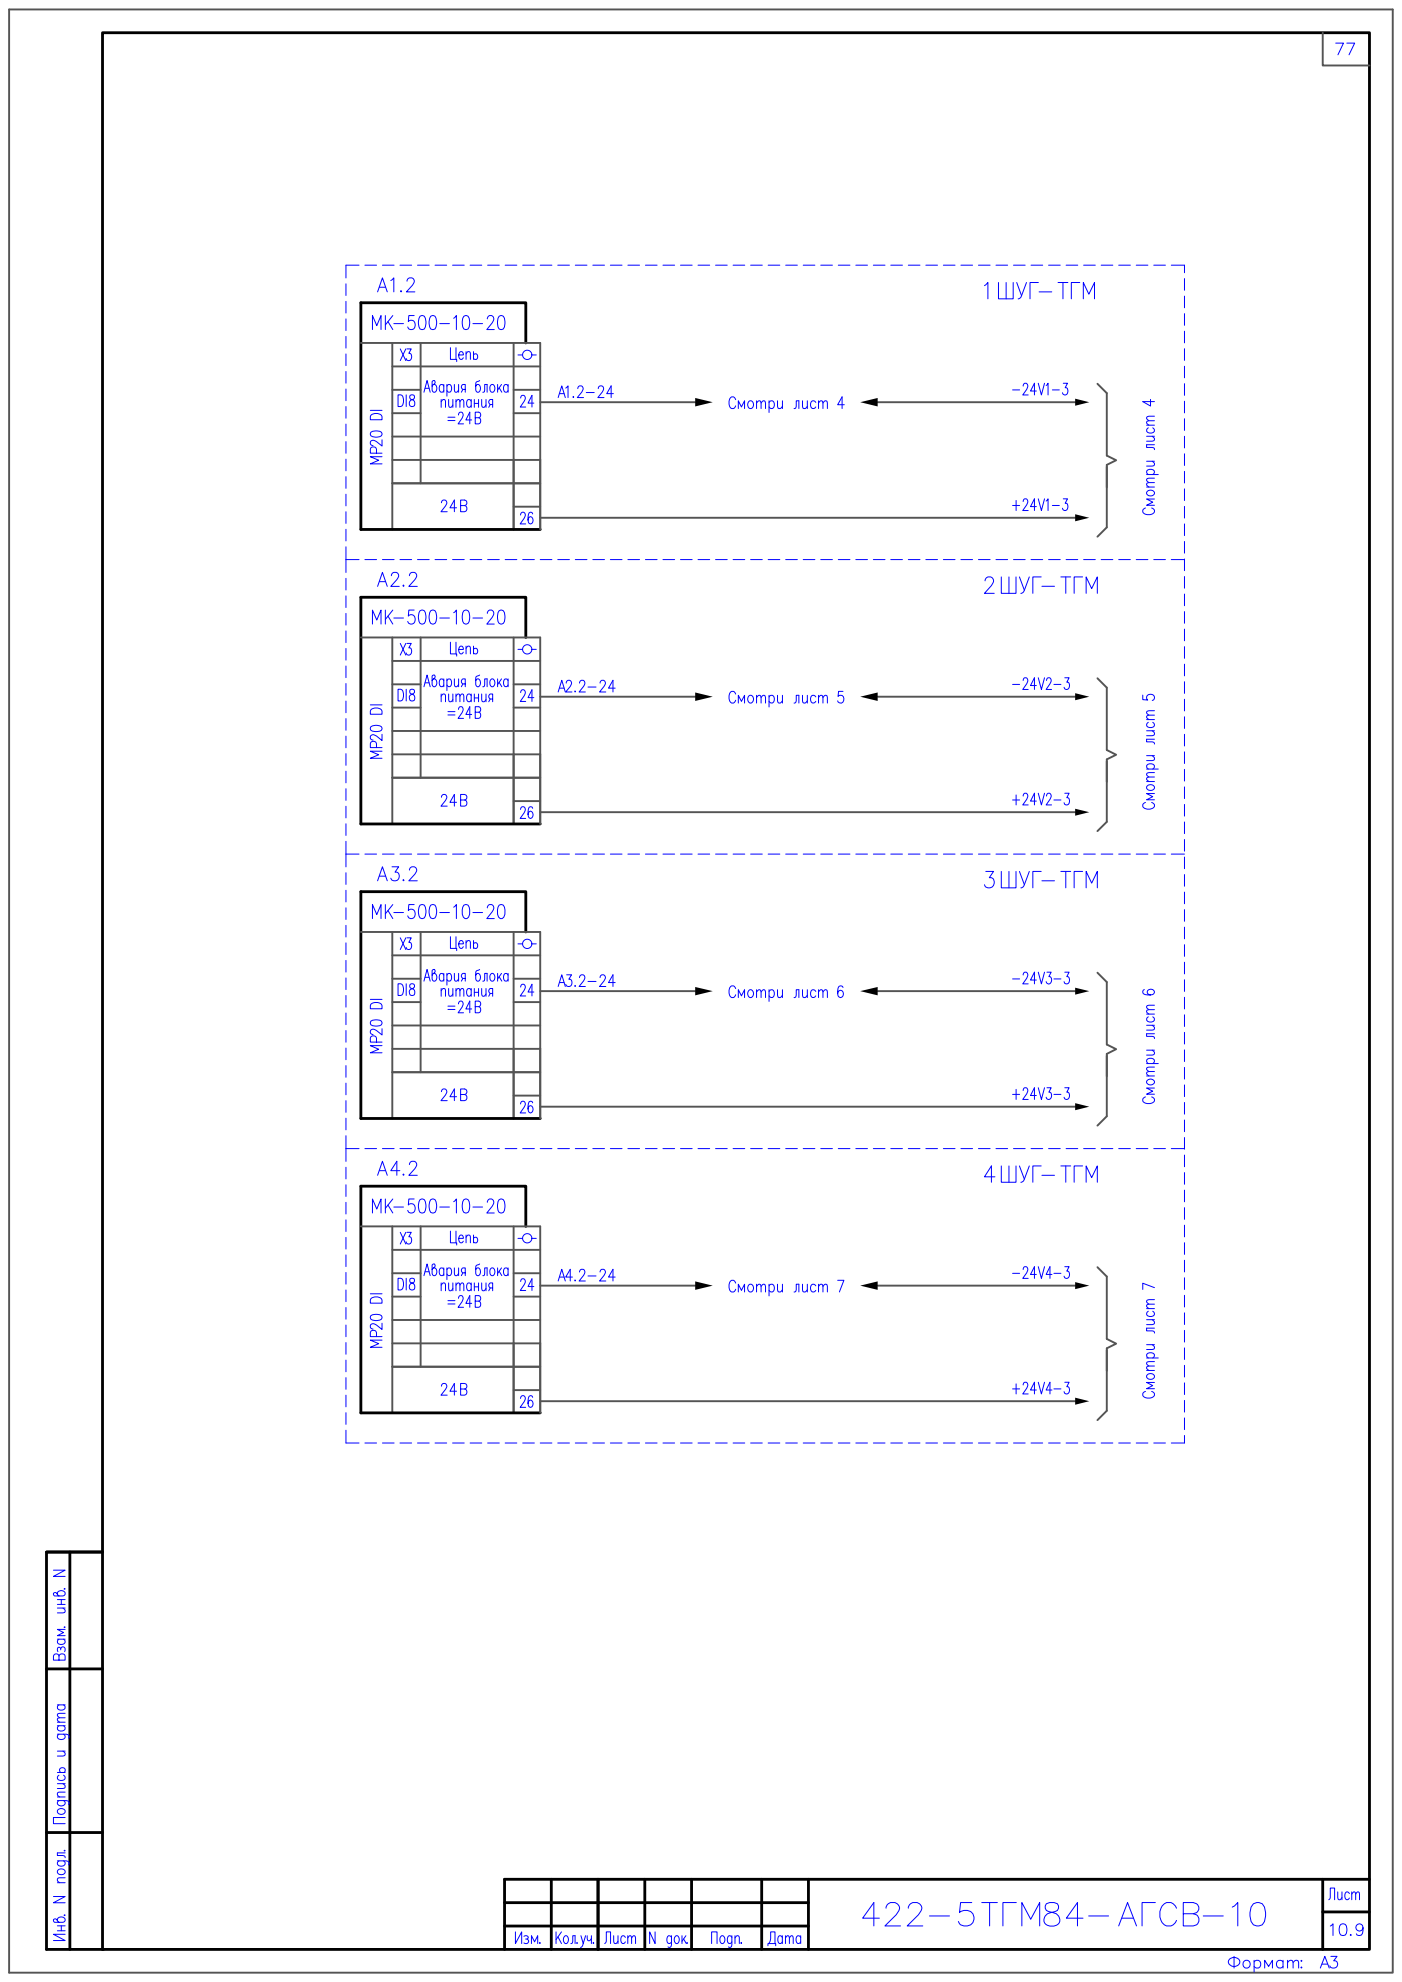
[picture p224: page 43]

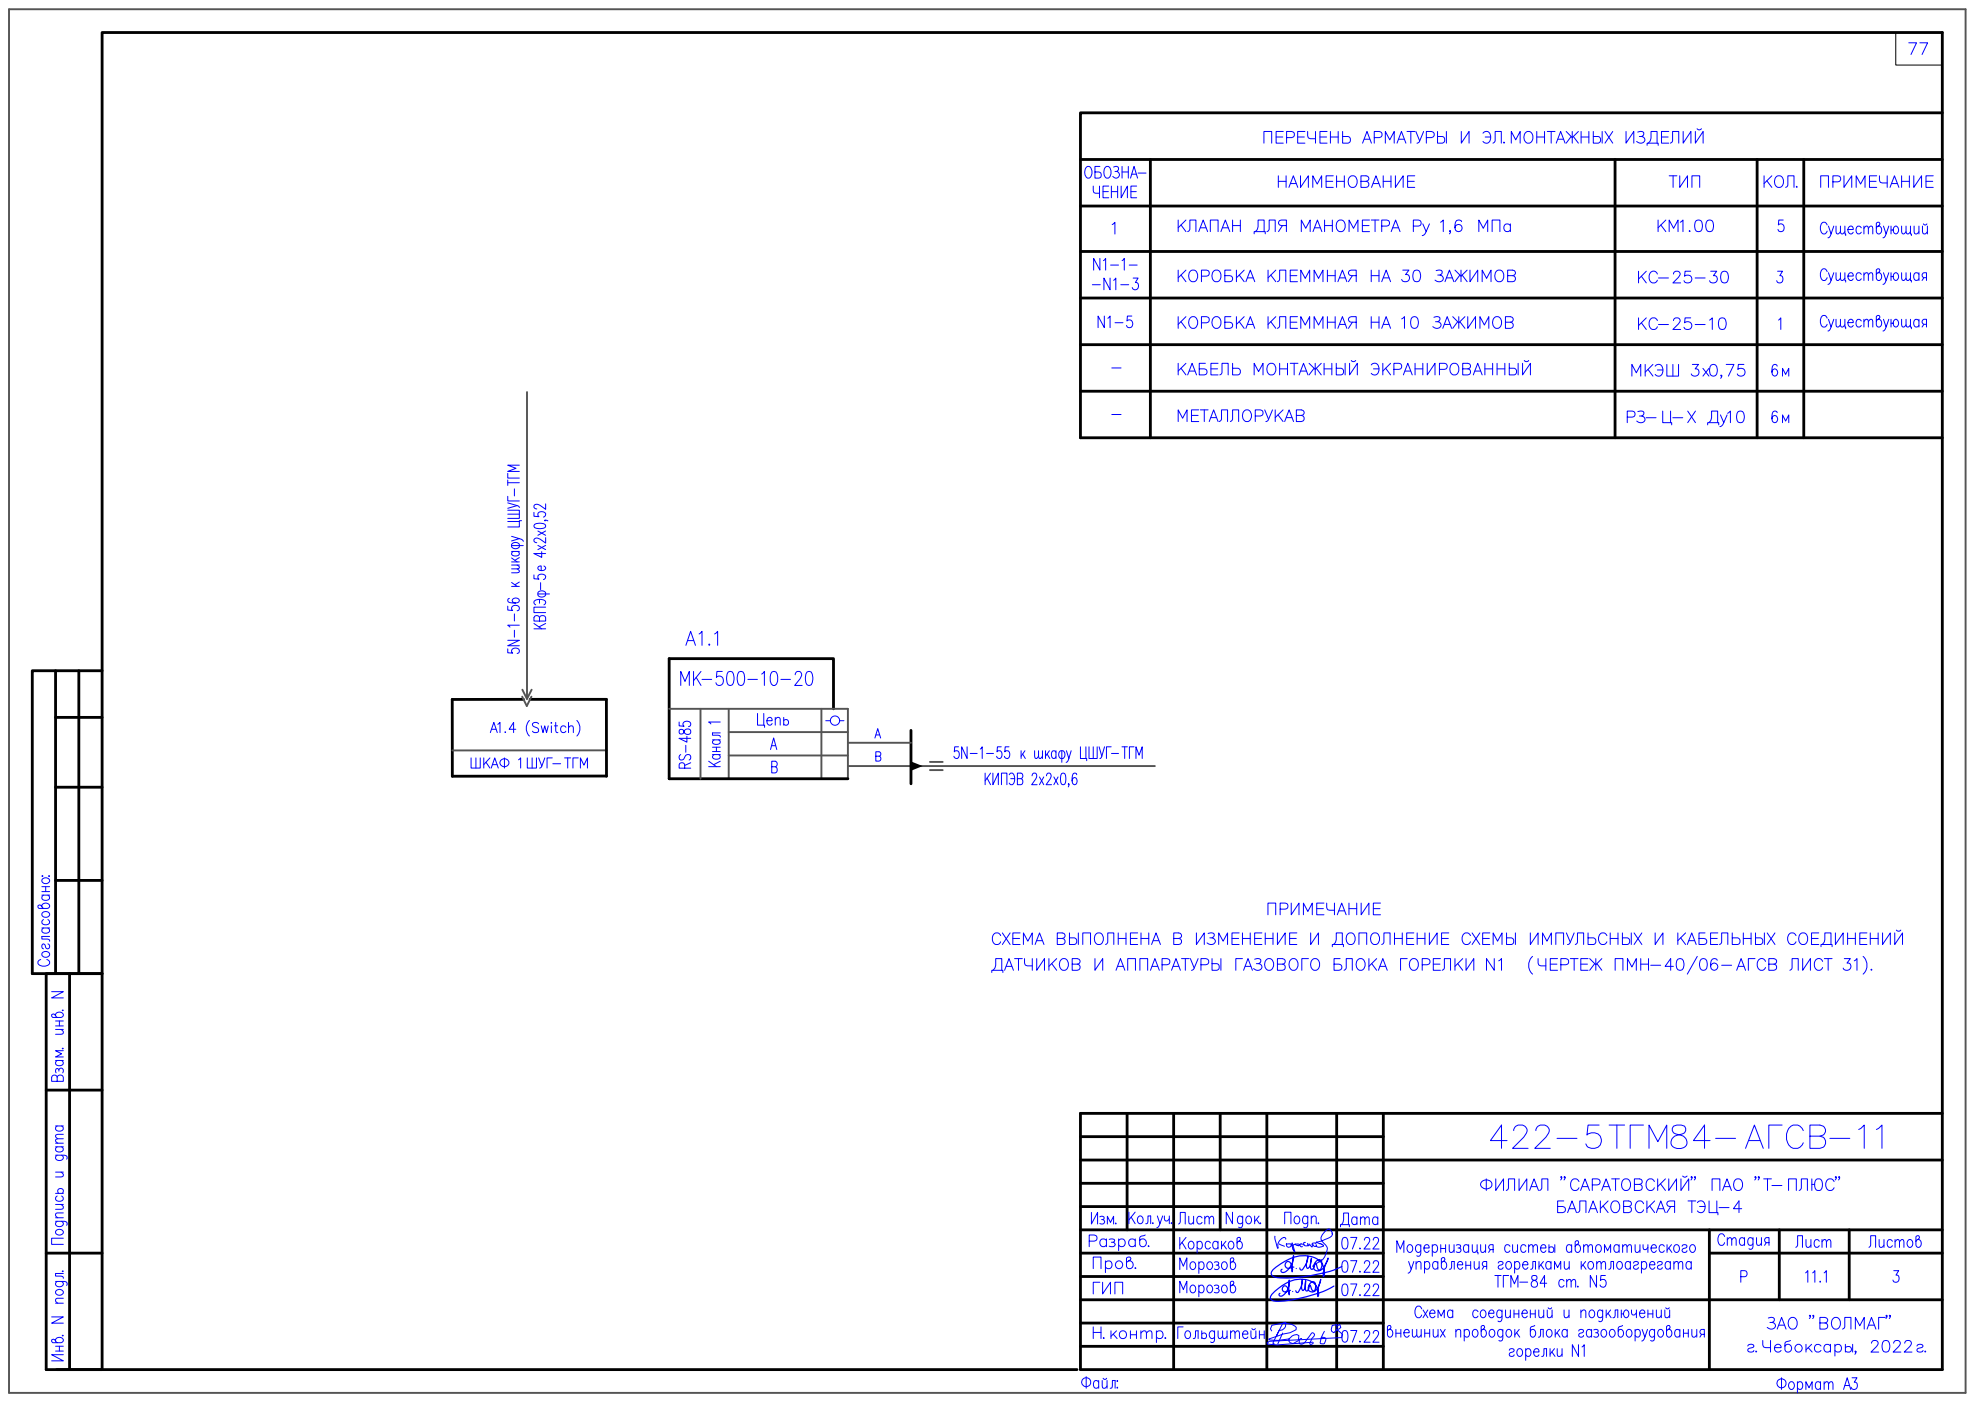
[picture p225: page 44]

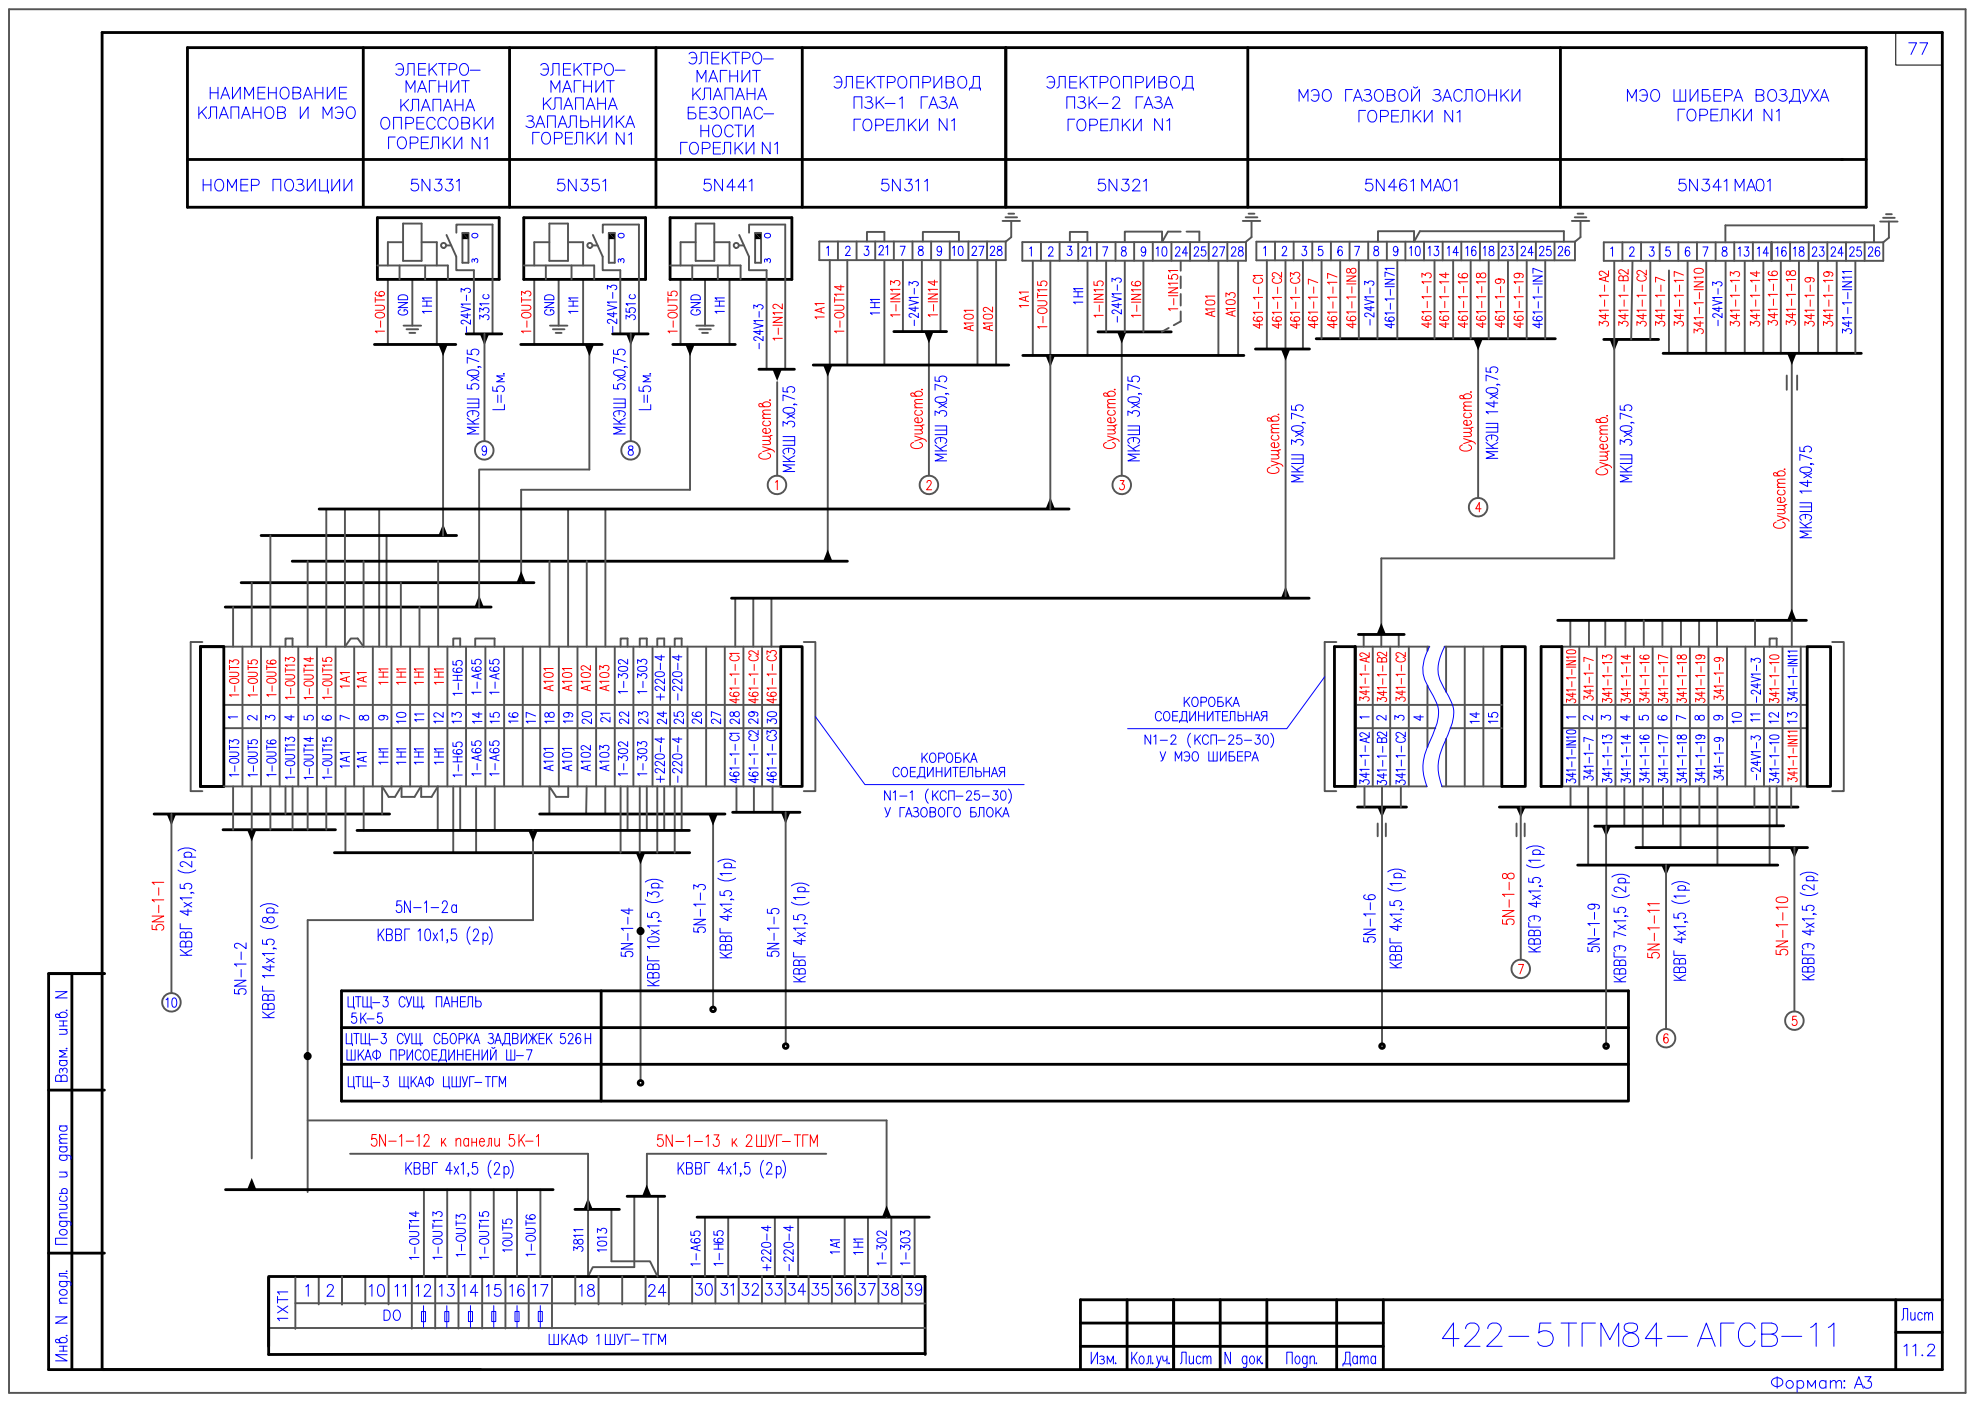
[picture p226: page 45]

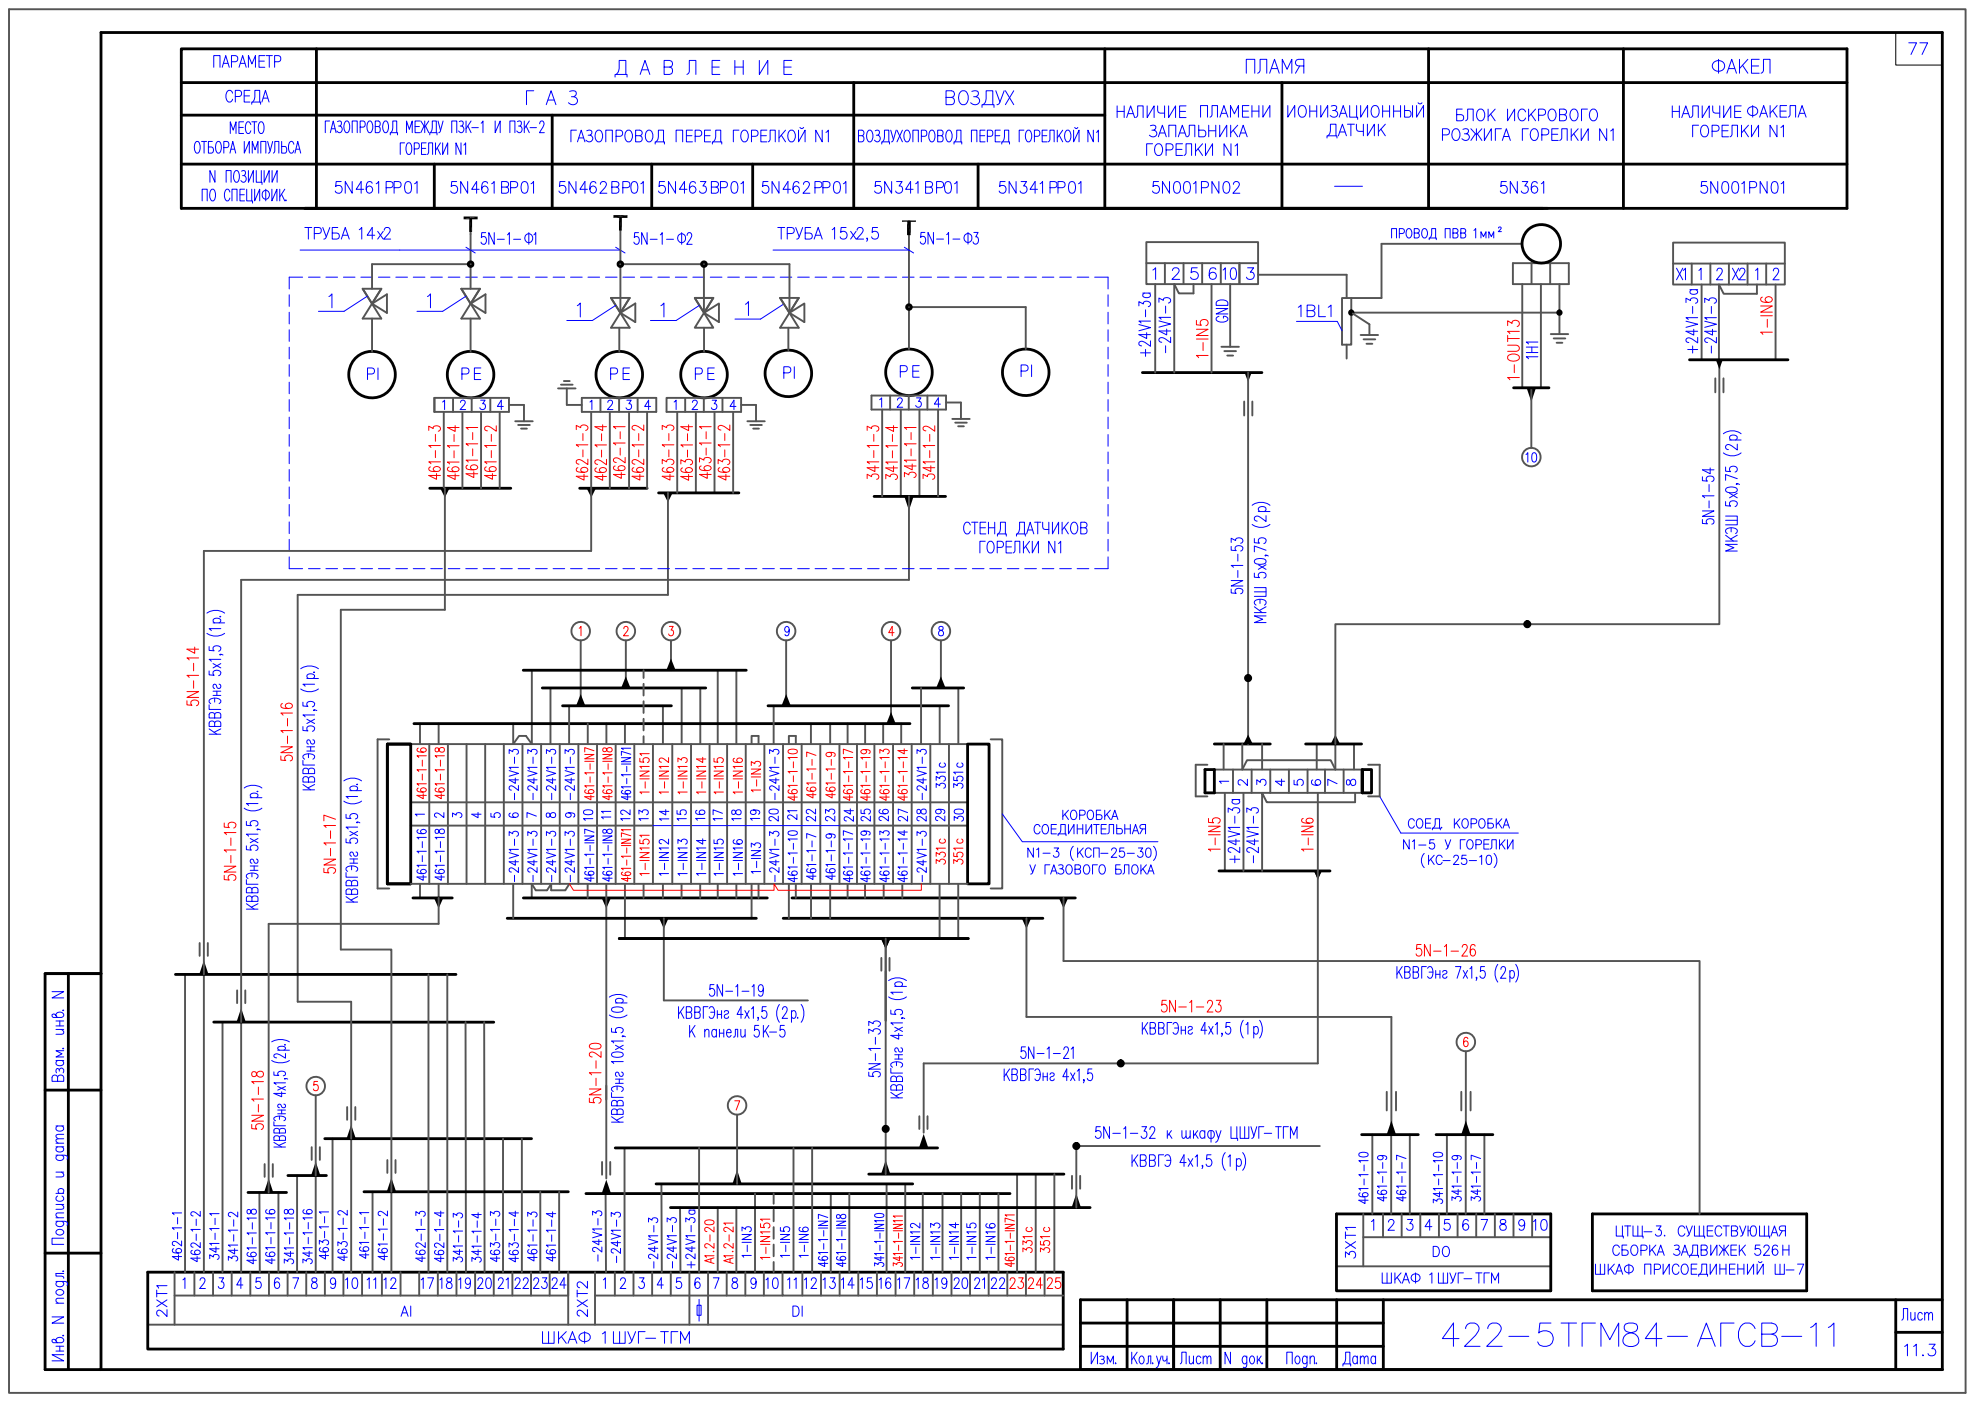
[picture p227: page 46]

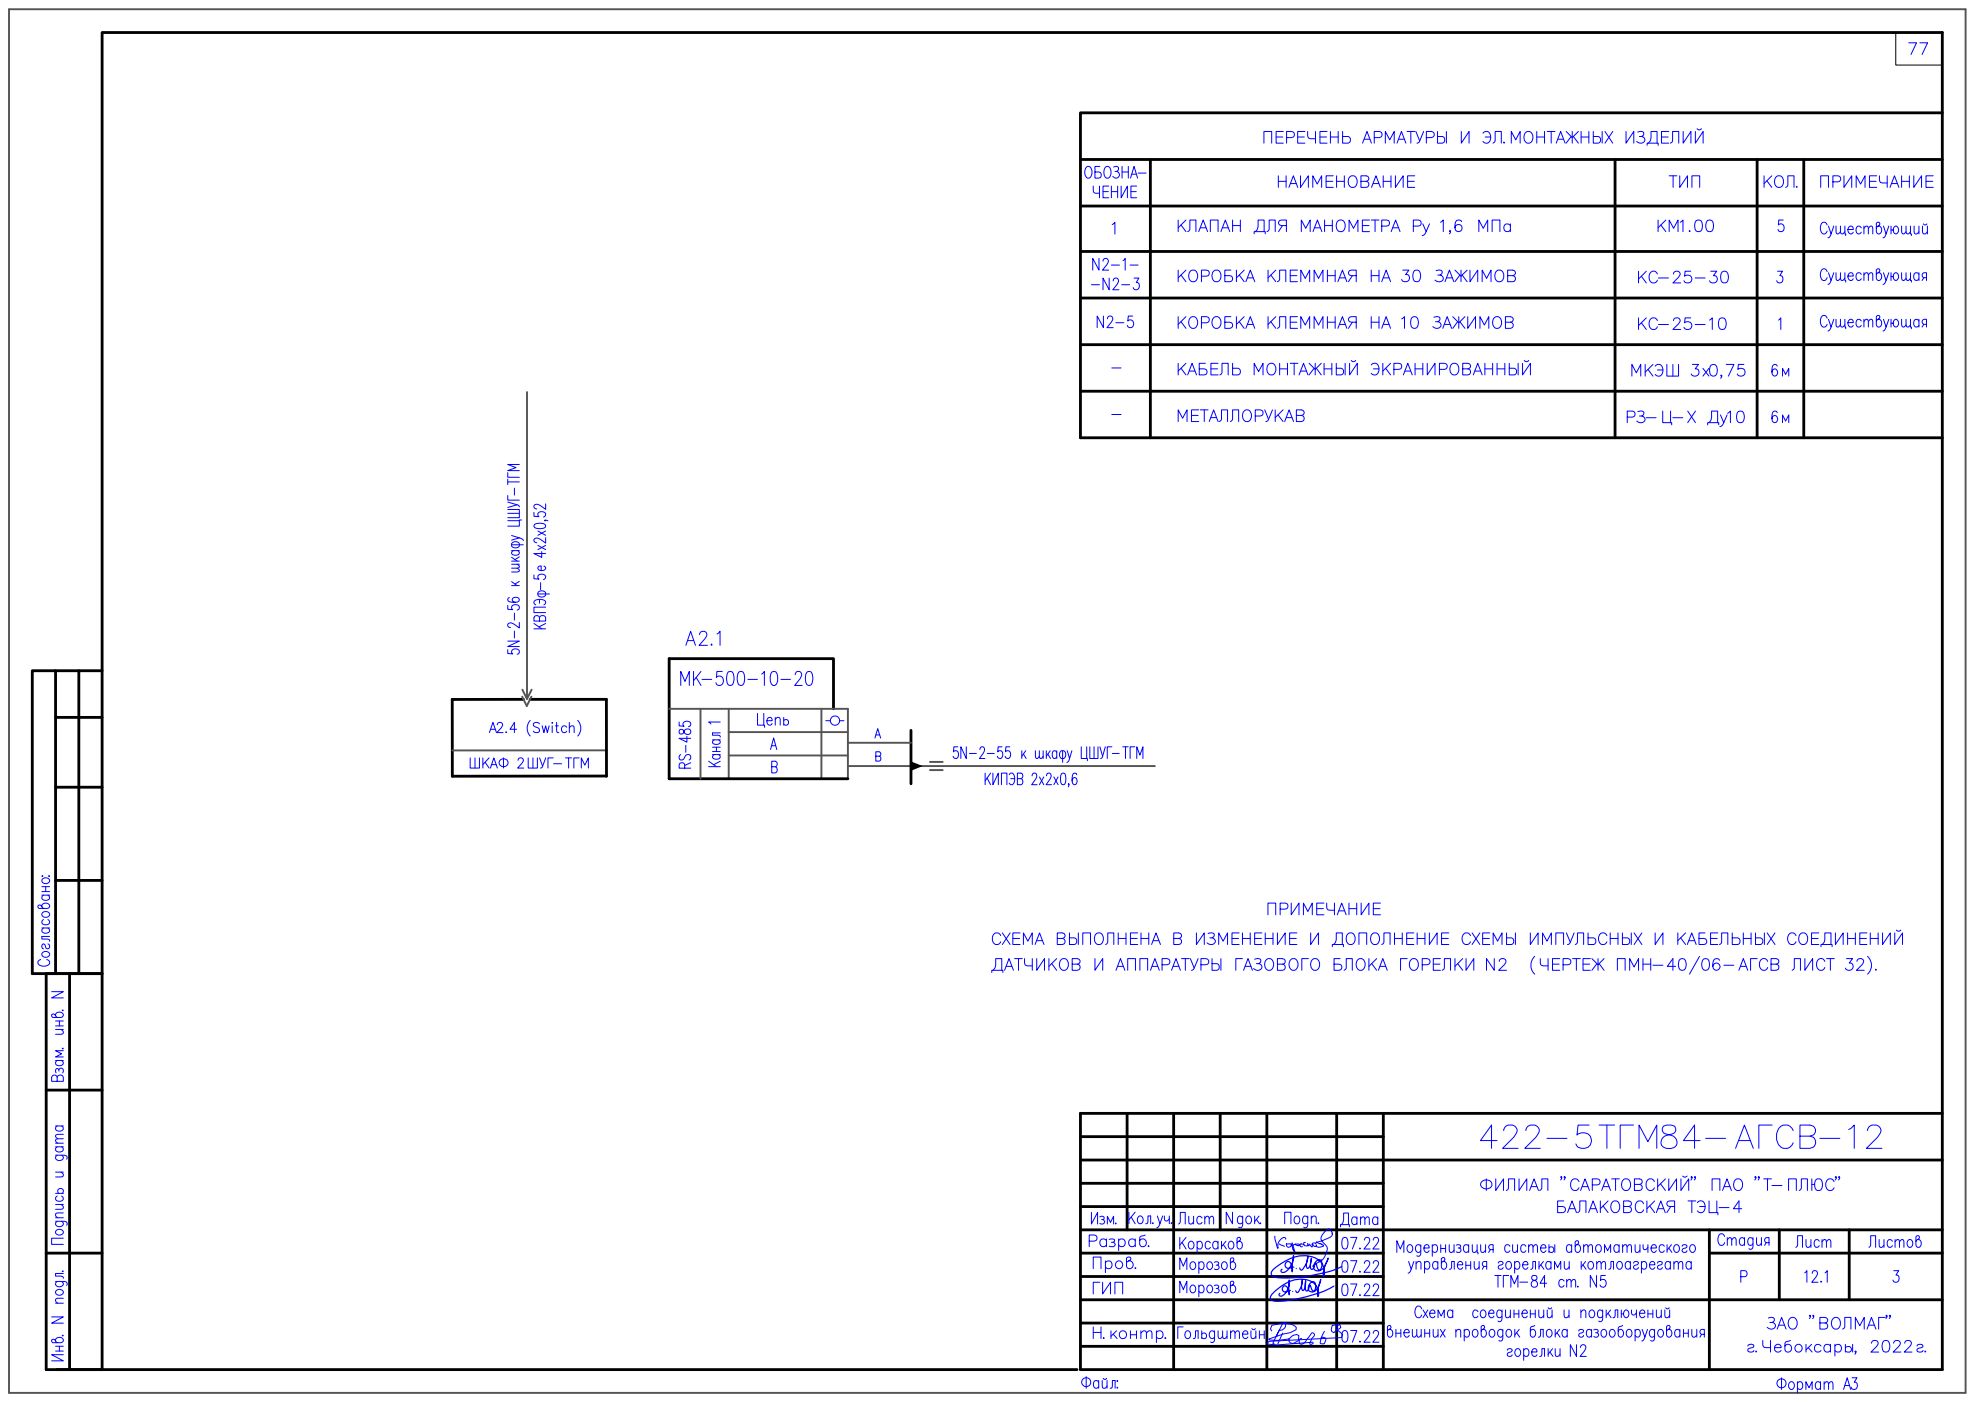
[picture p228: page 47]

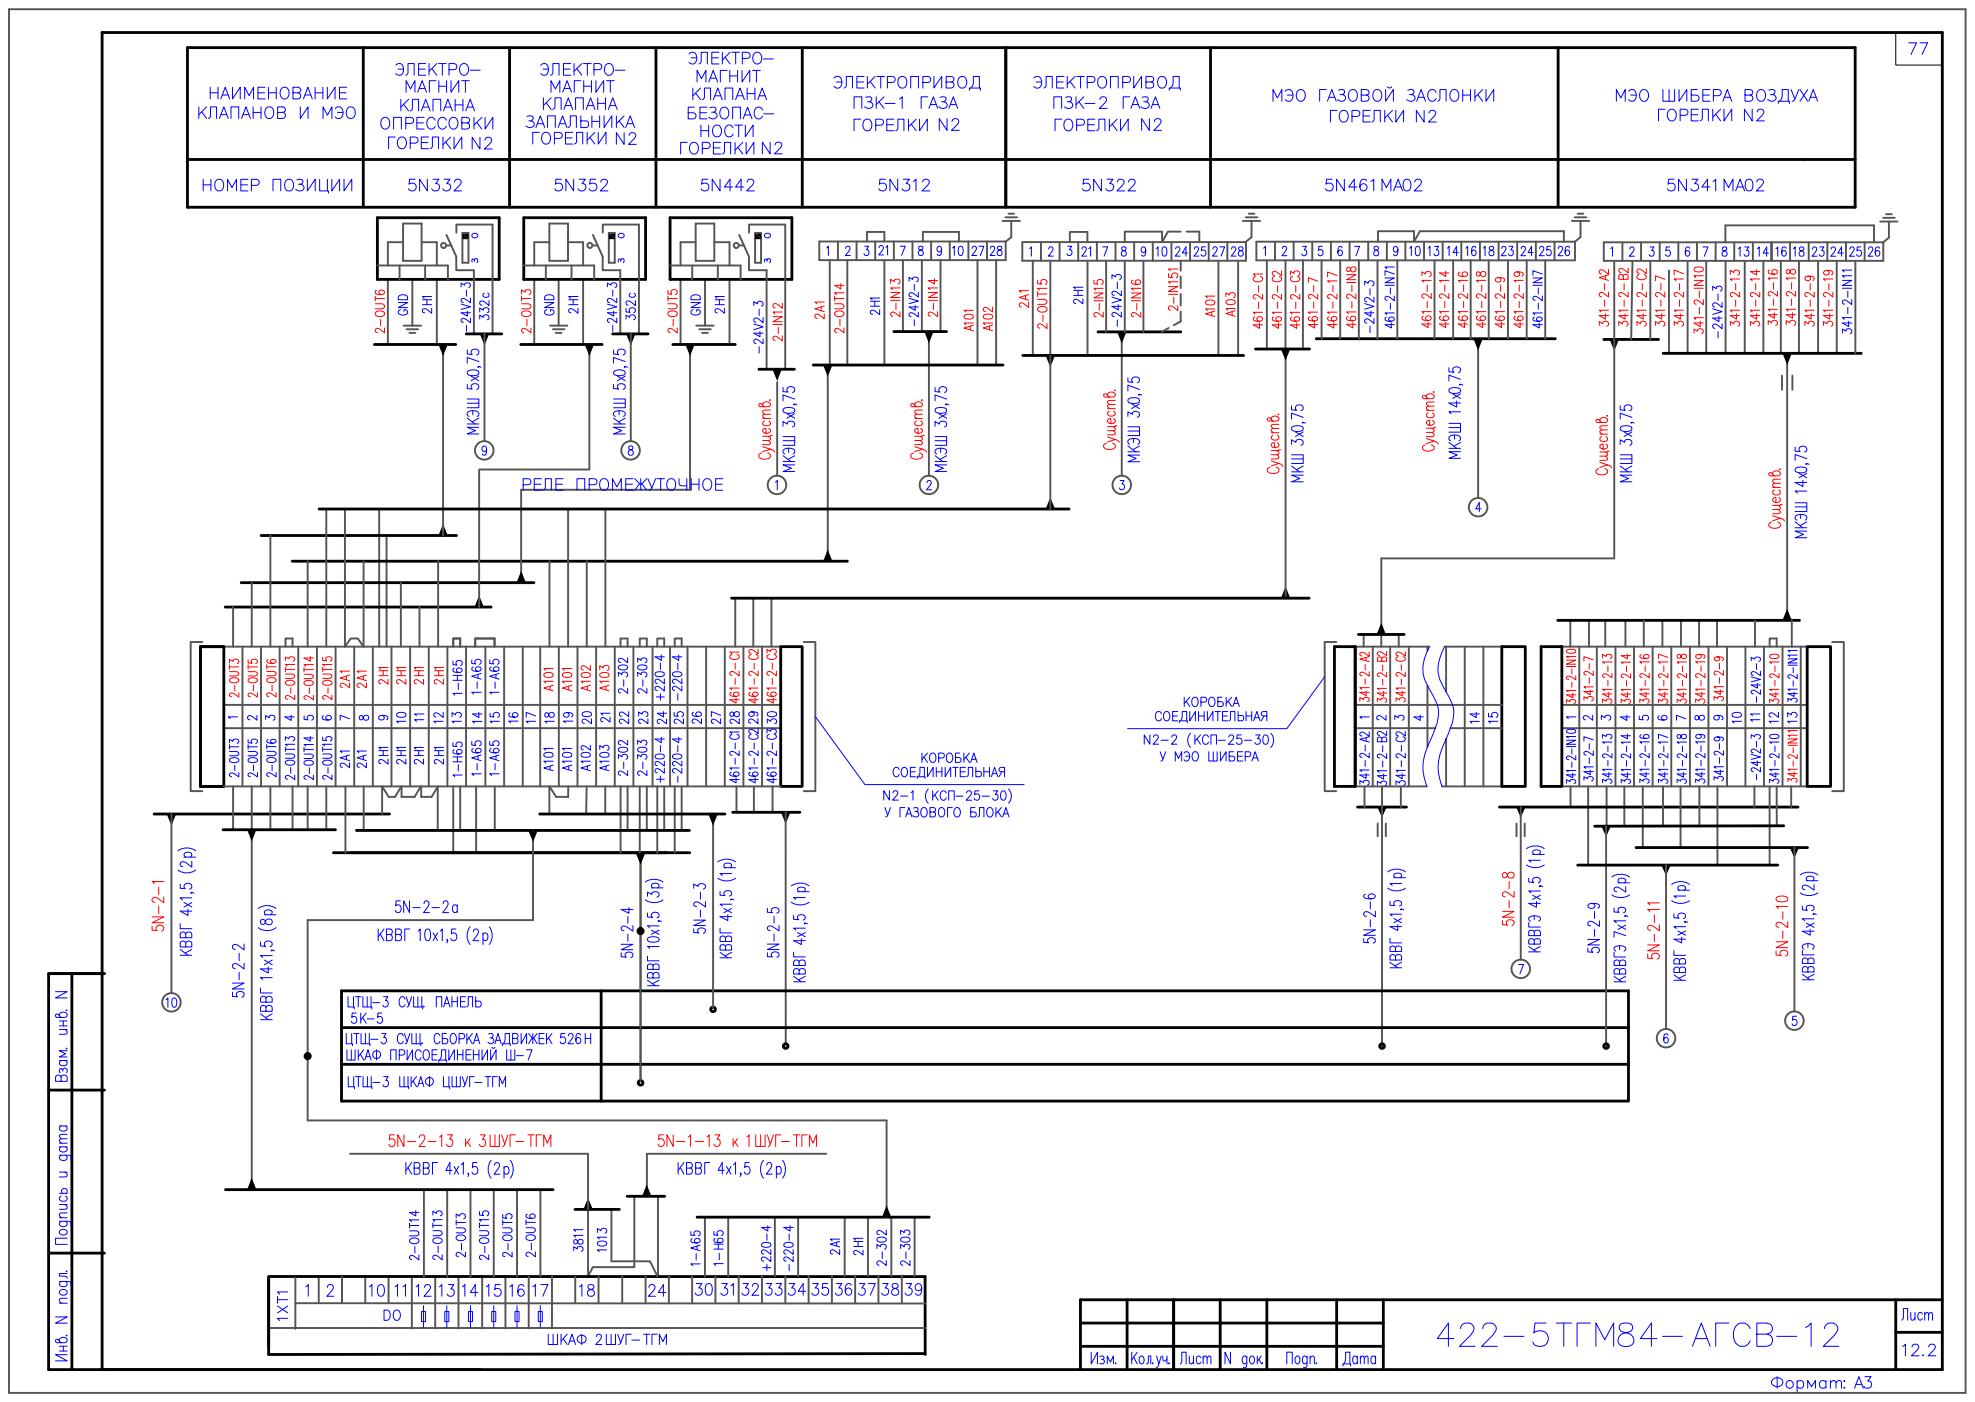
[picture p229: page 48]

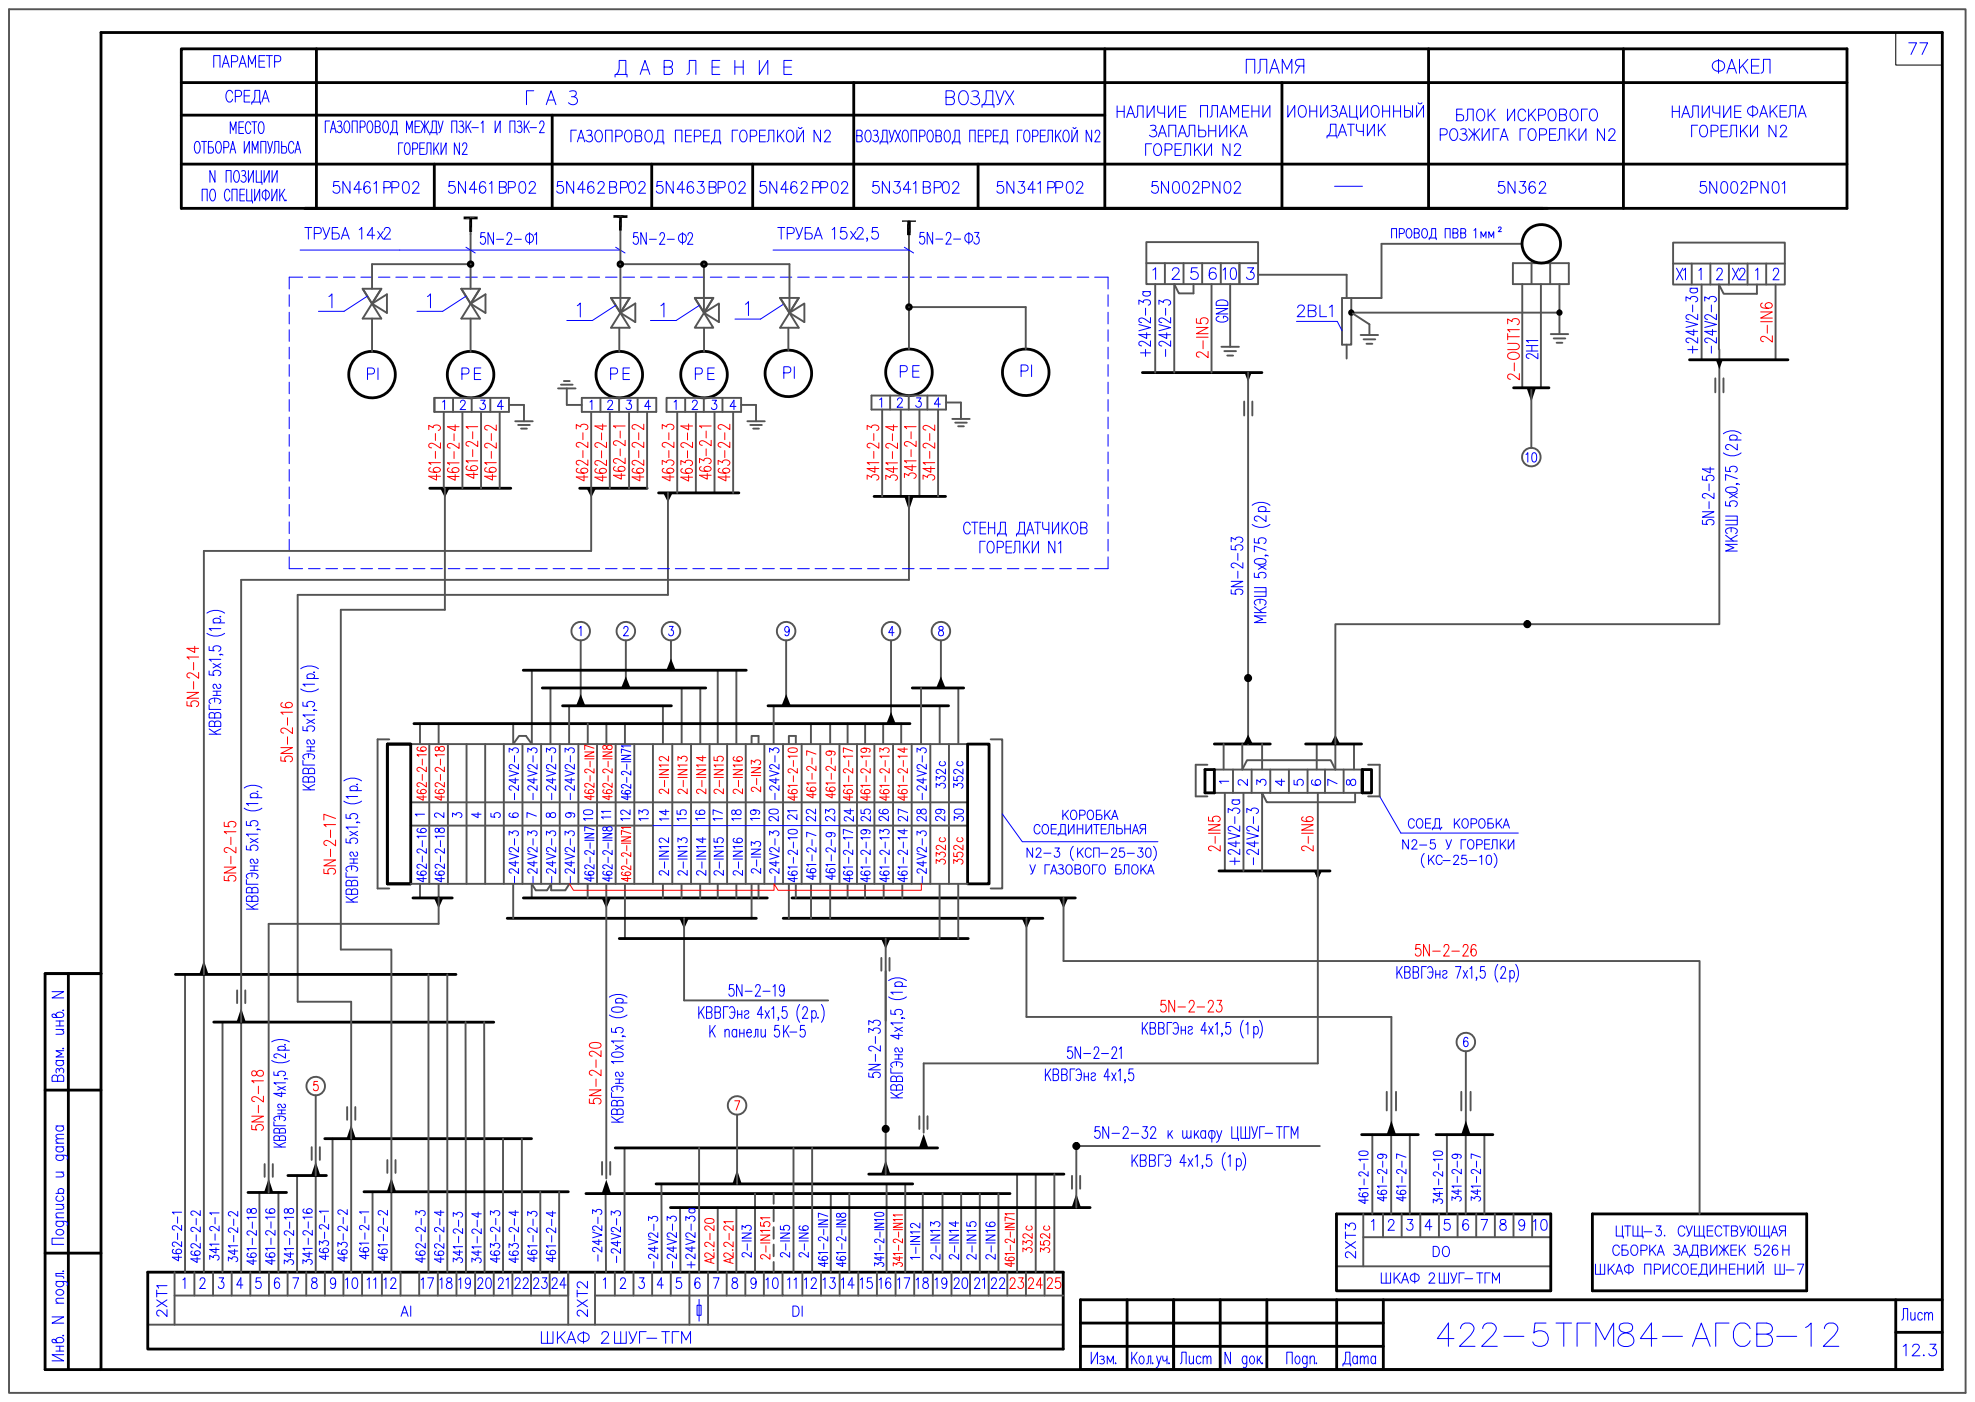
[picture p230: page 49]

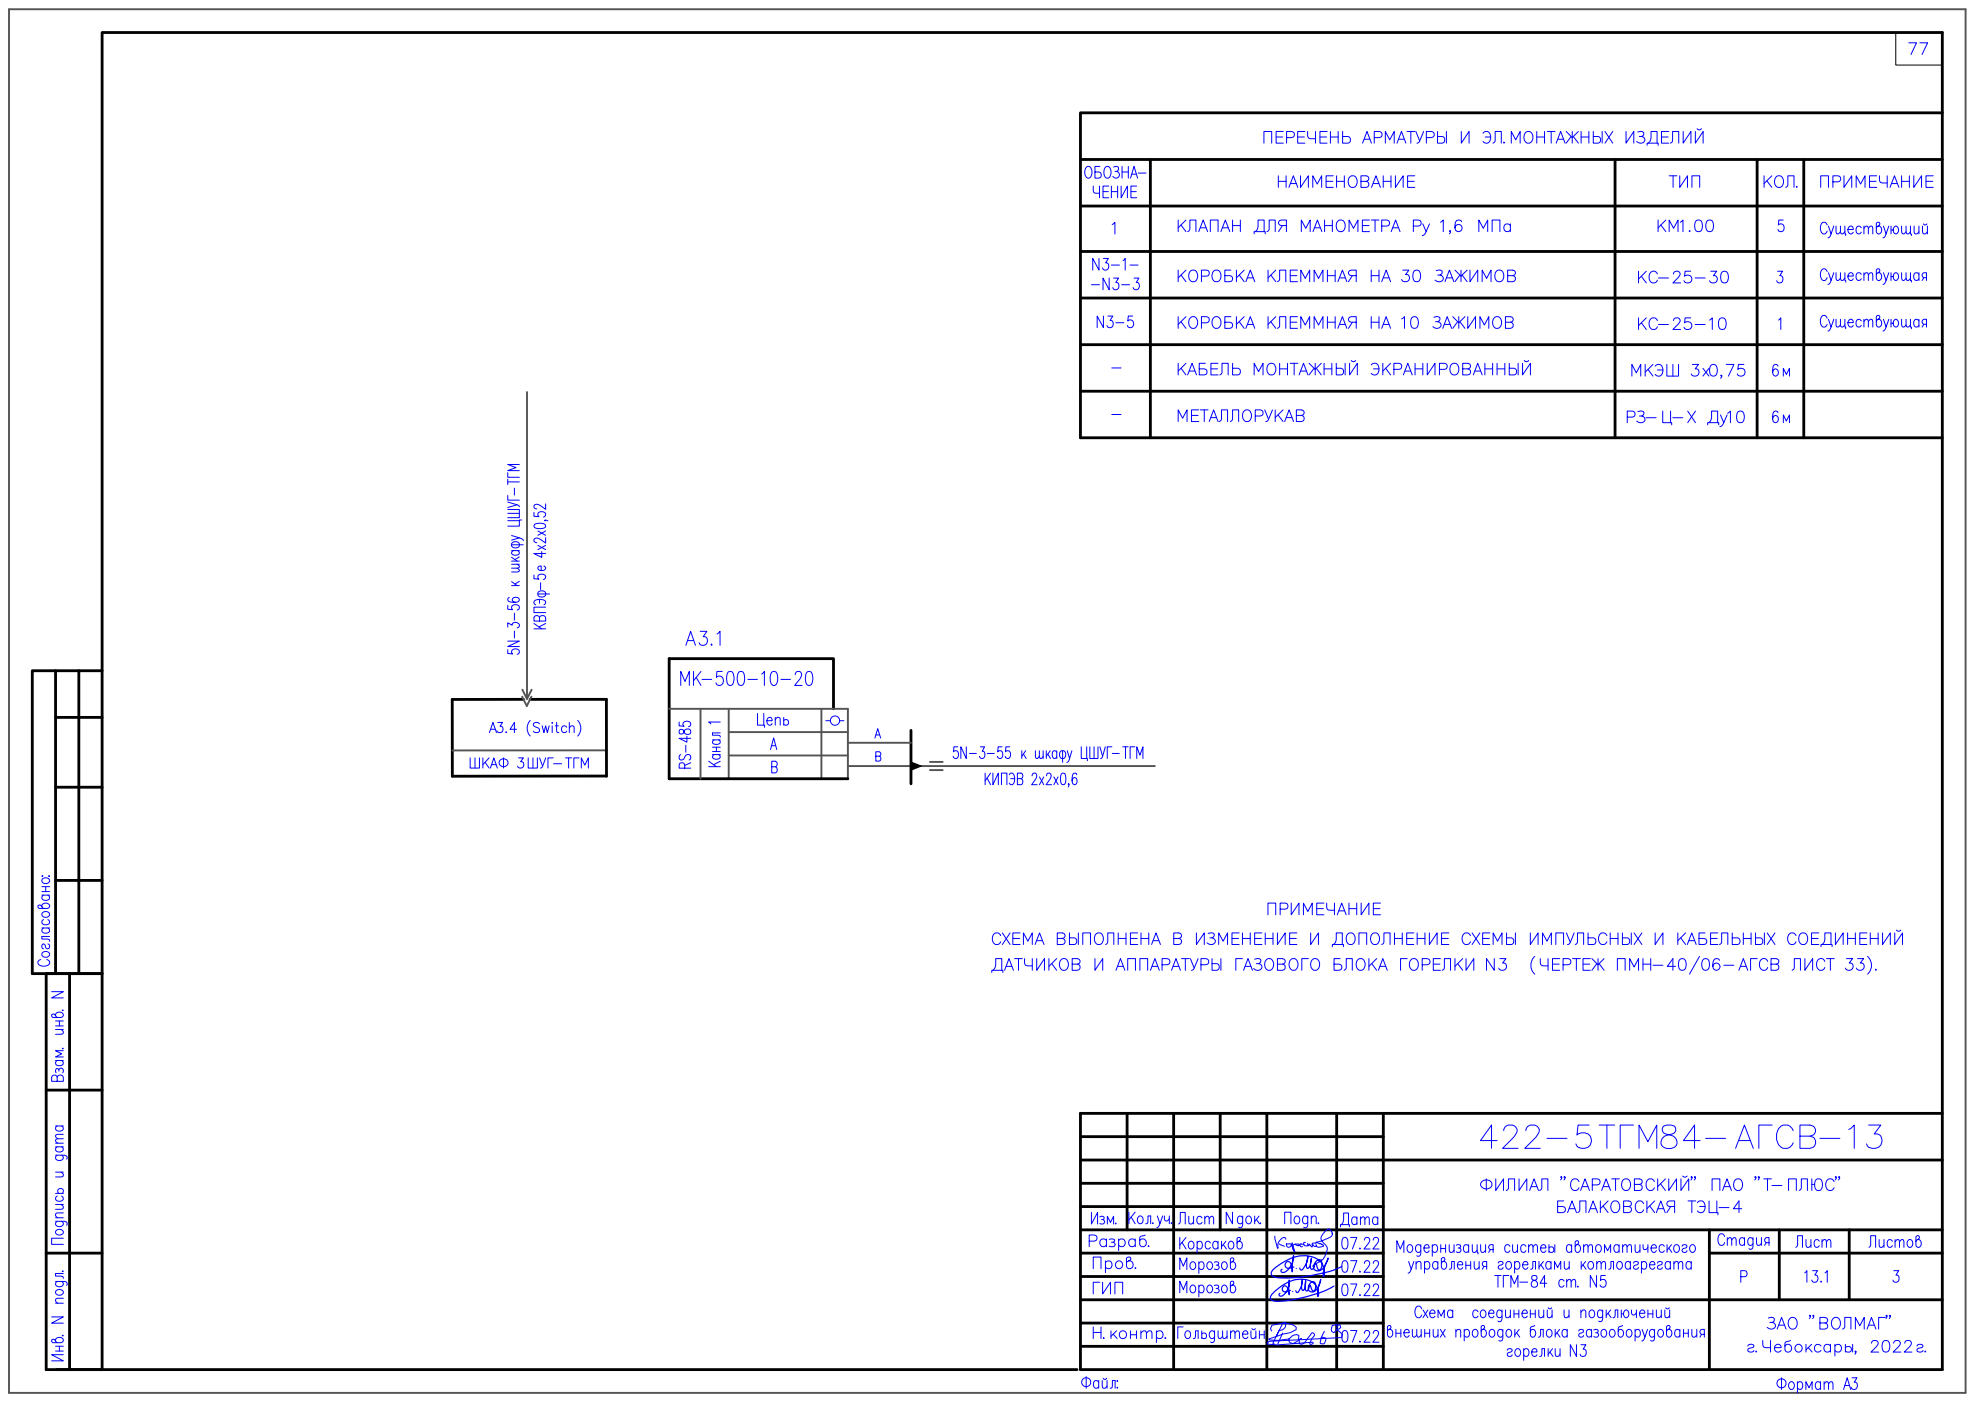
[picture p231: page 50]

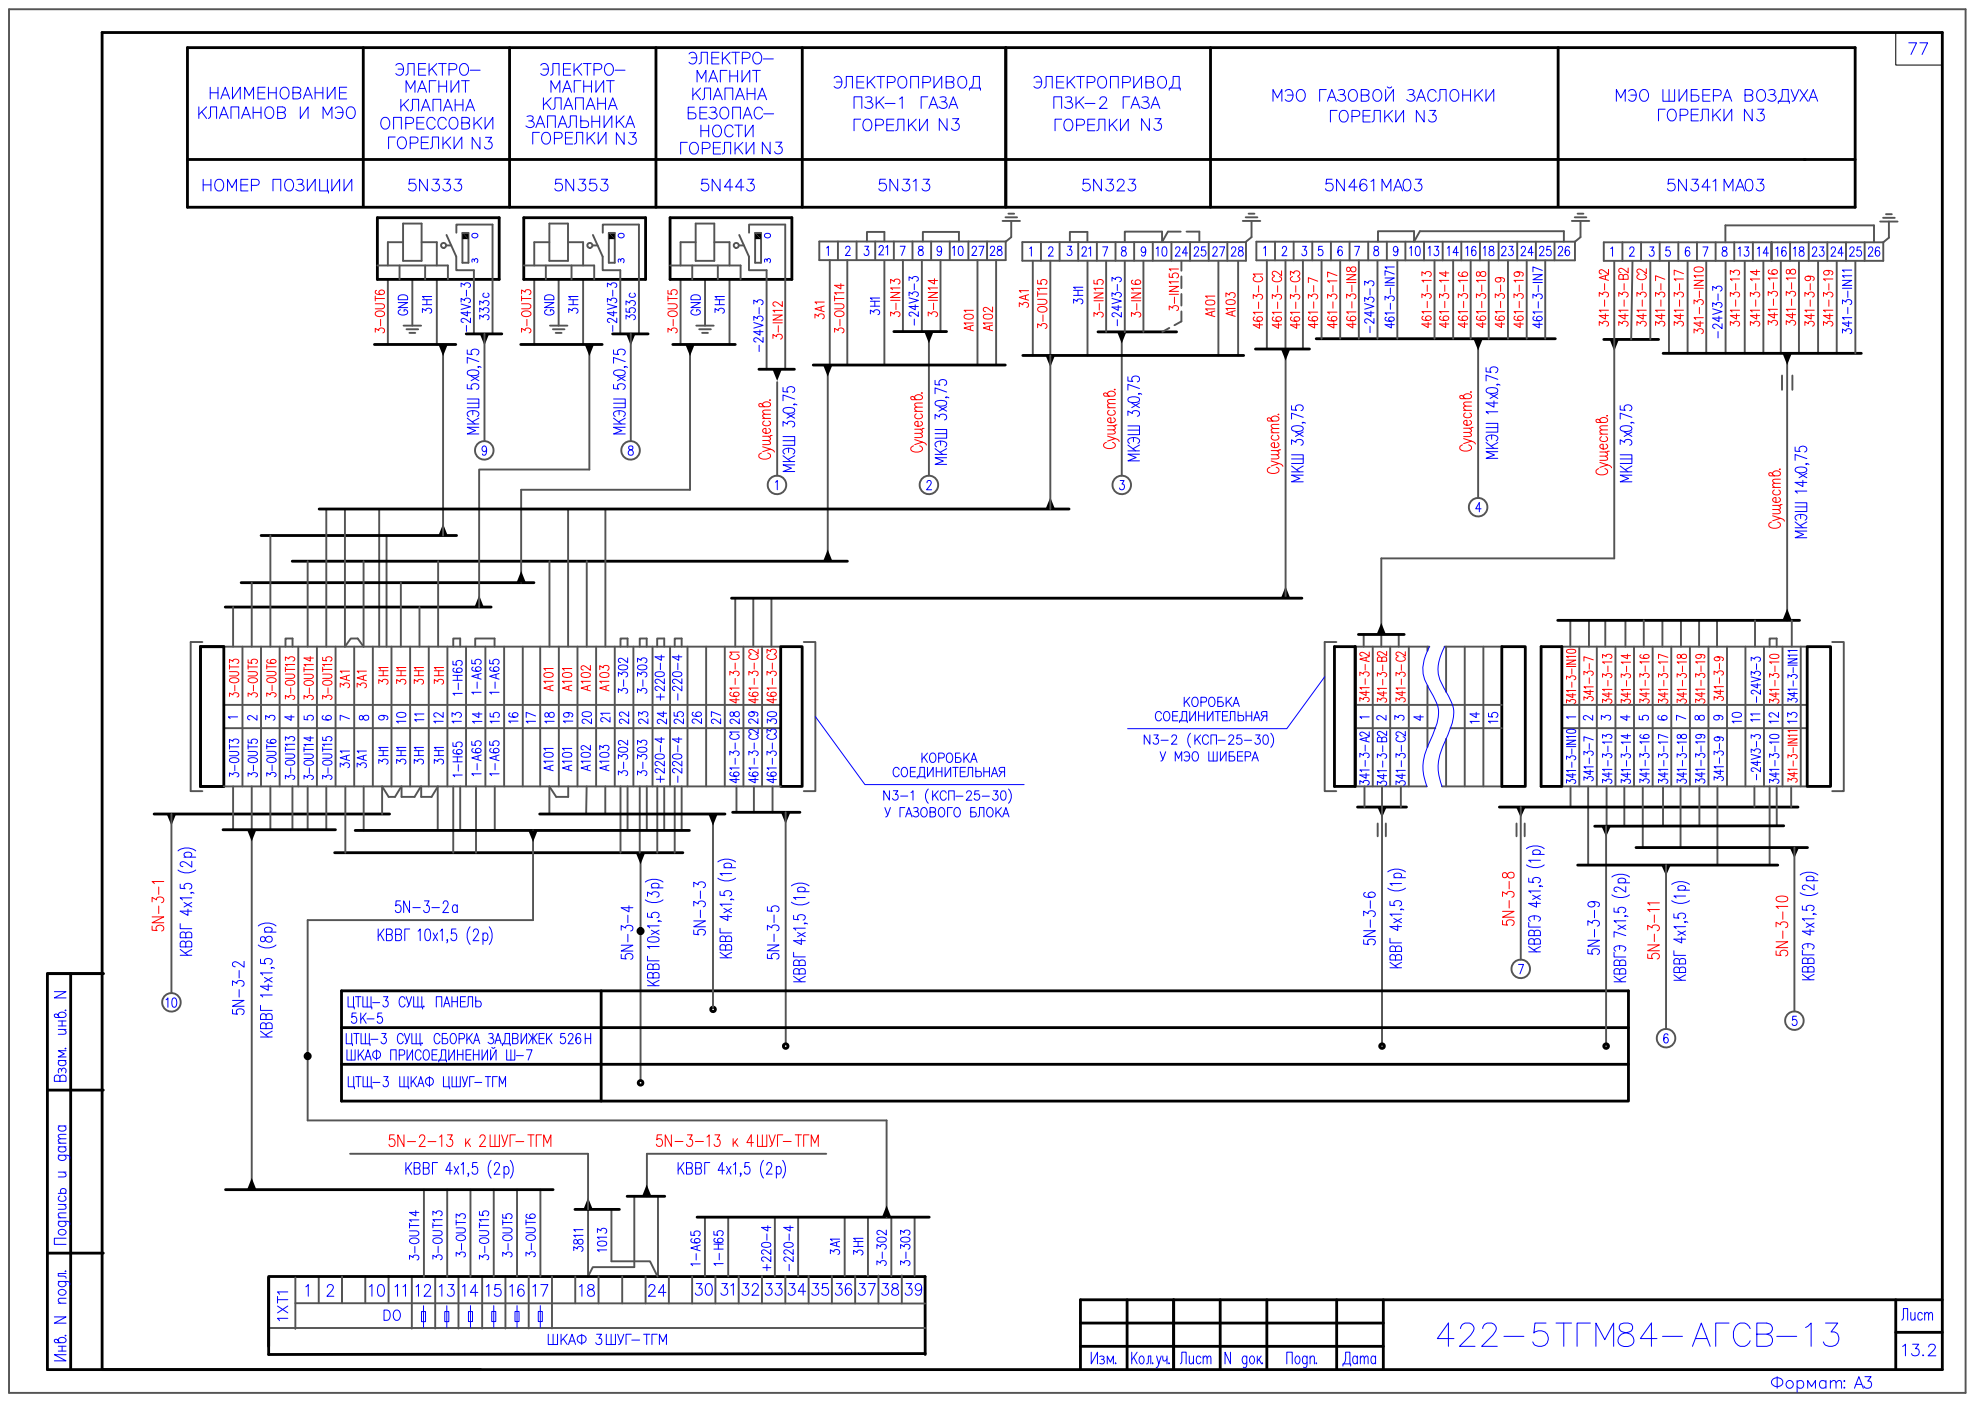
[picture p232: page 51]

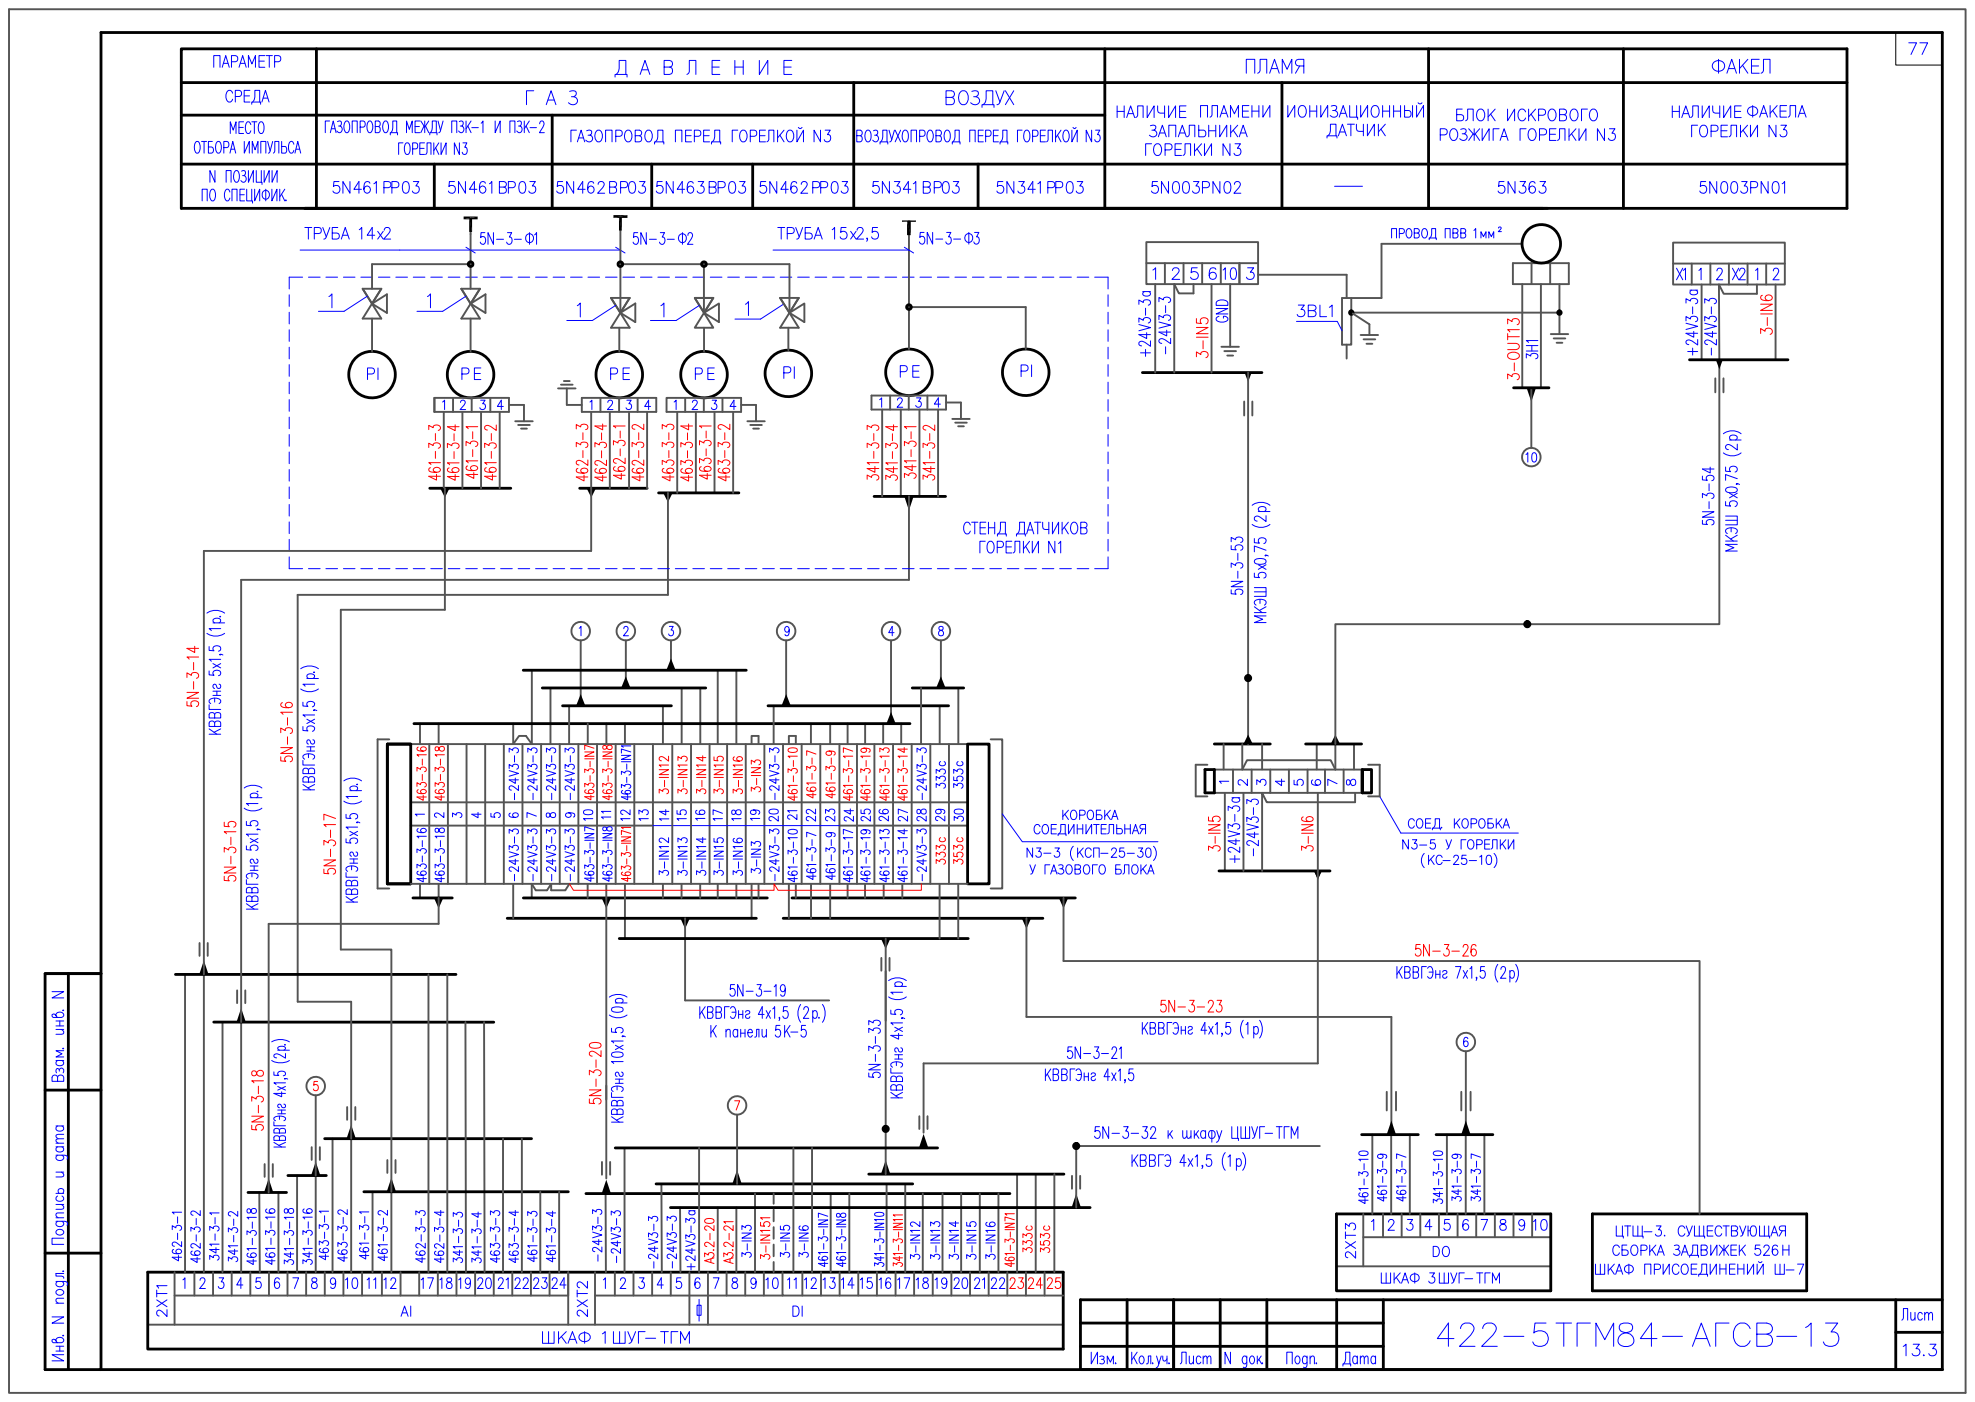
[picture p233: page 52]

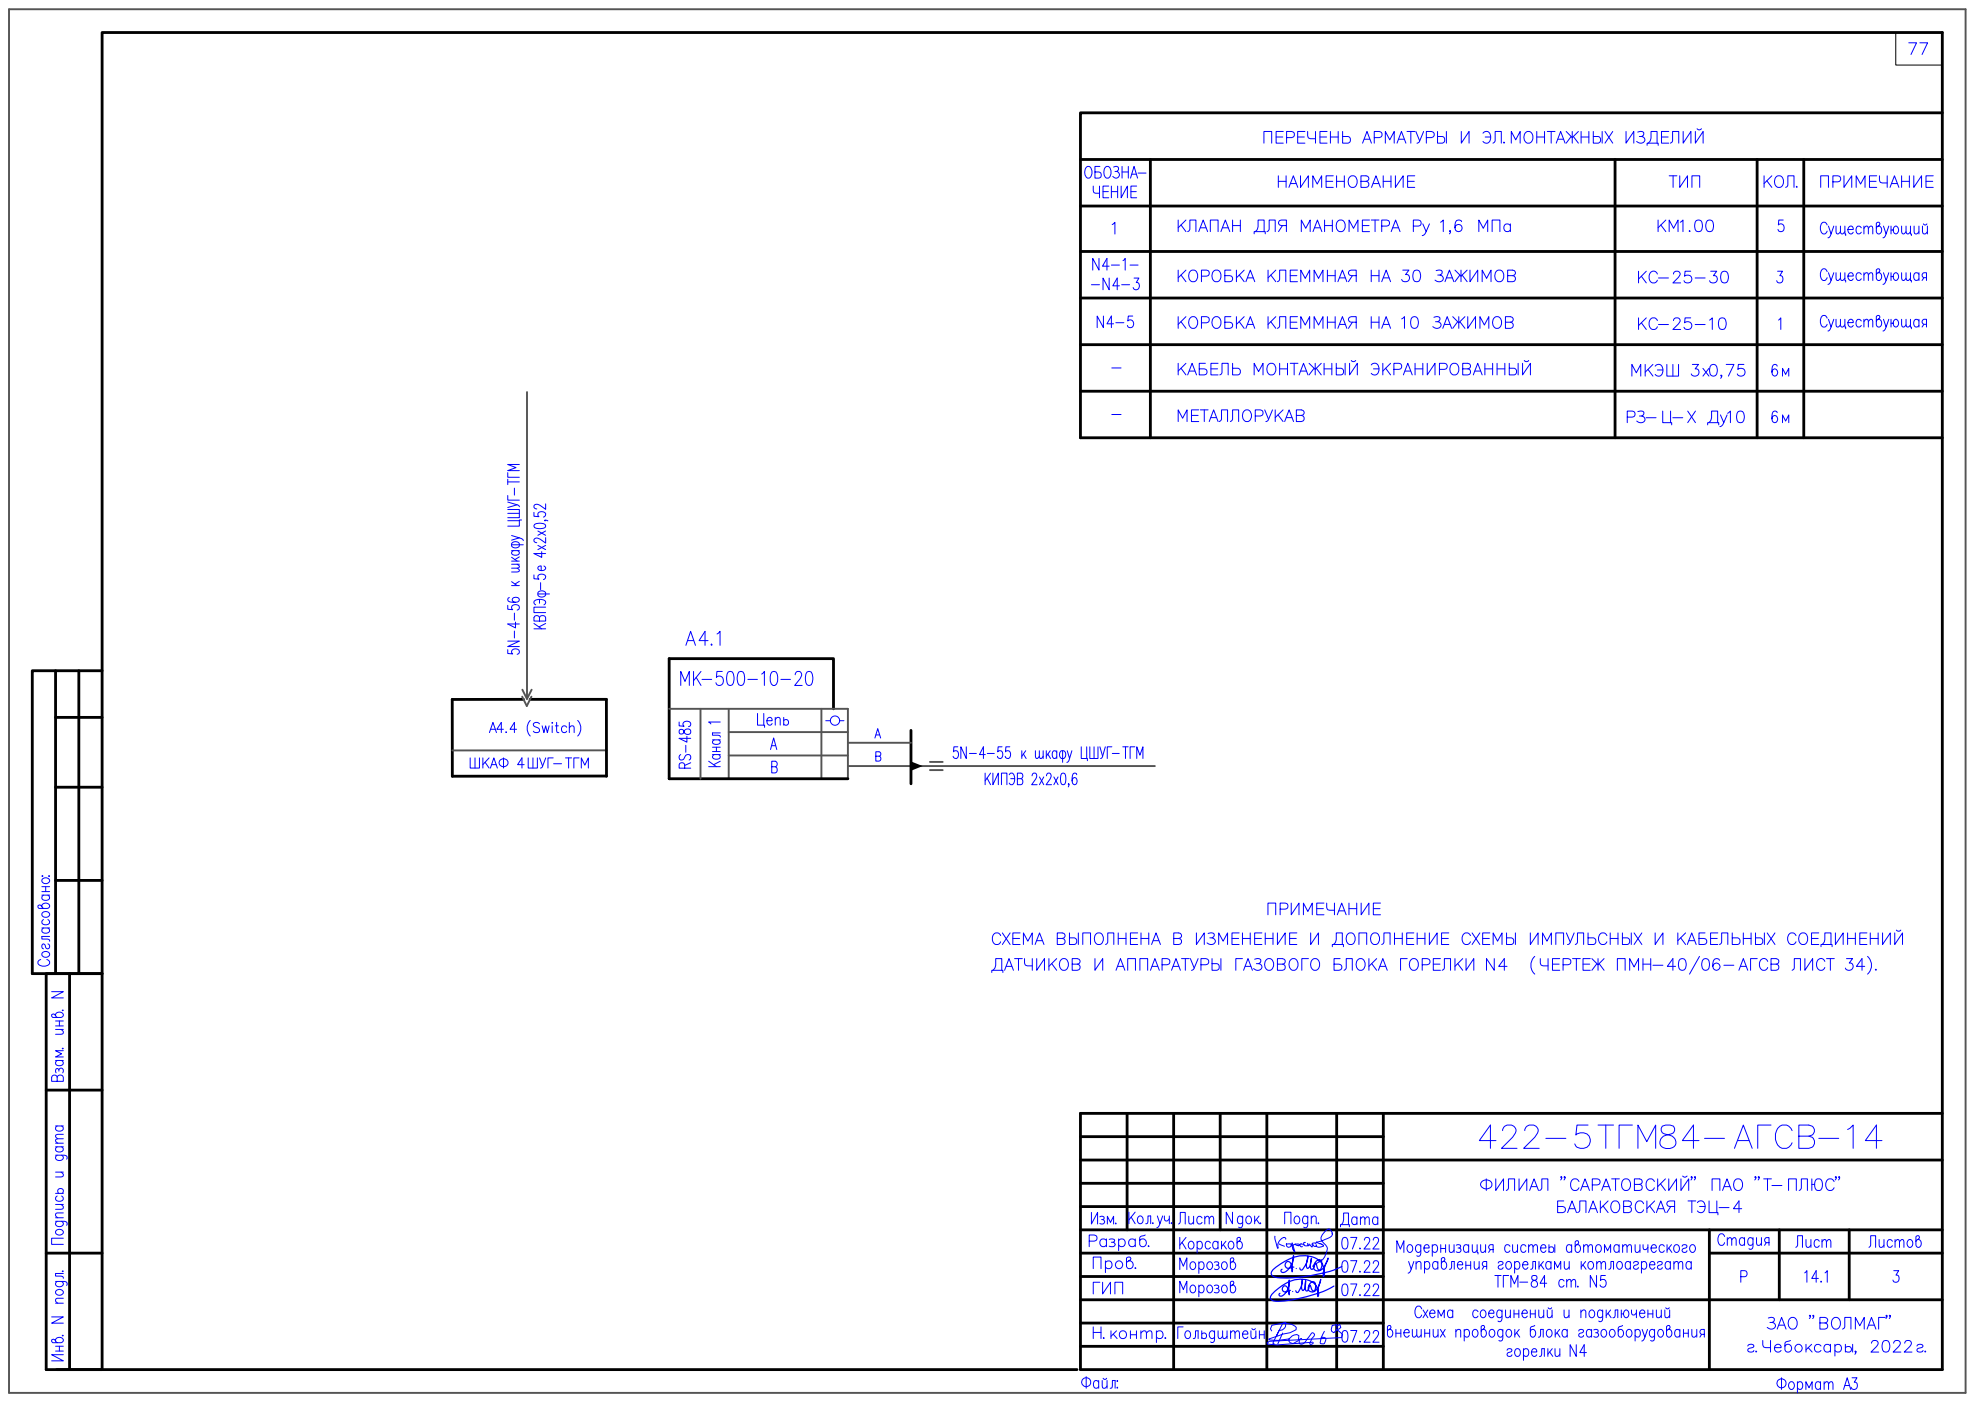
[picture p234: page 53]

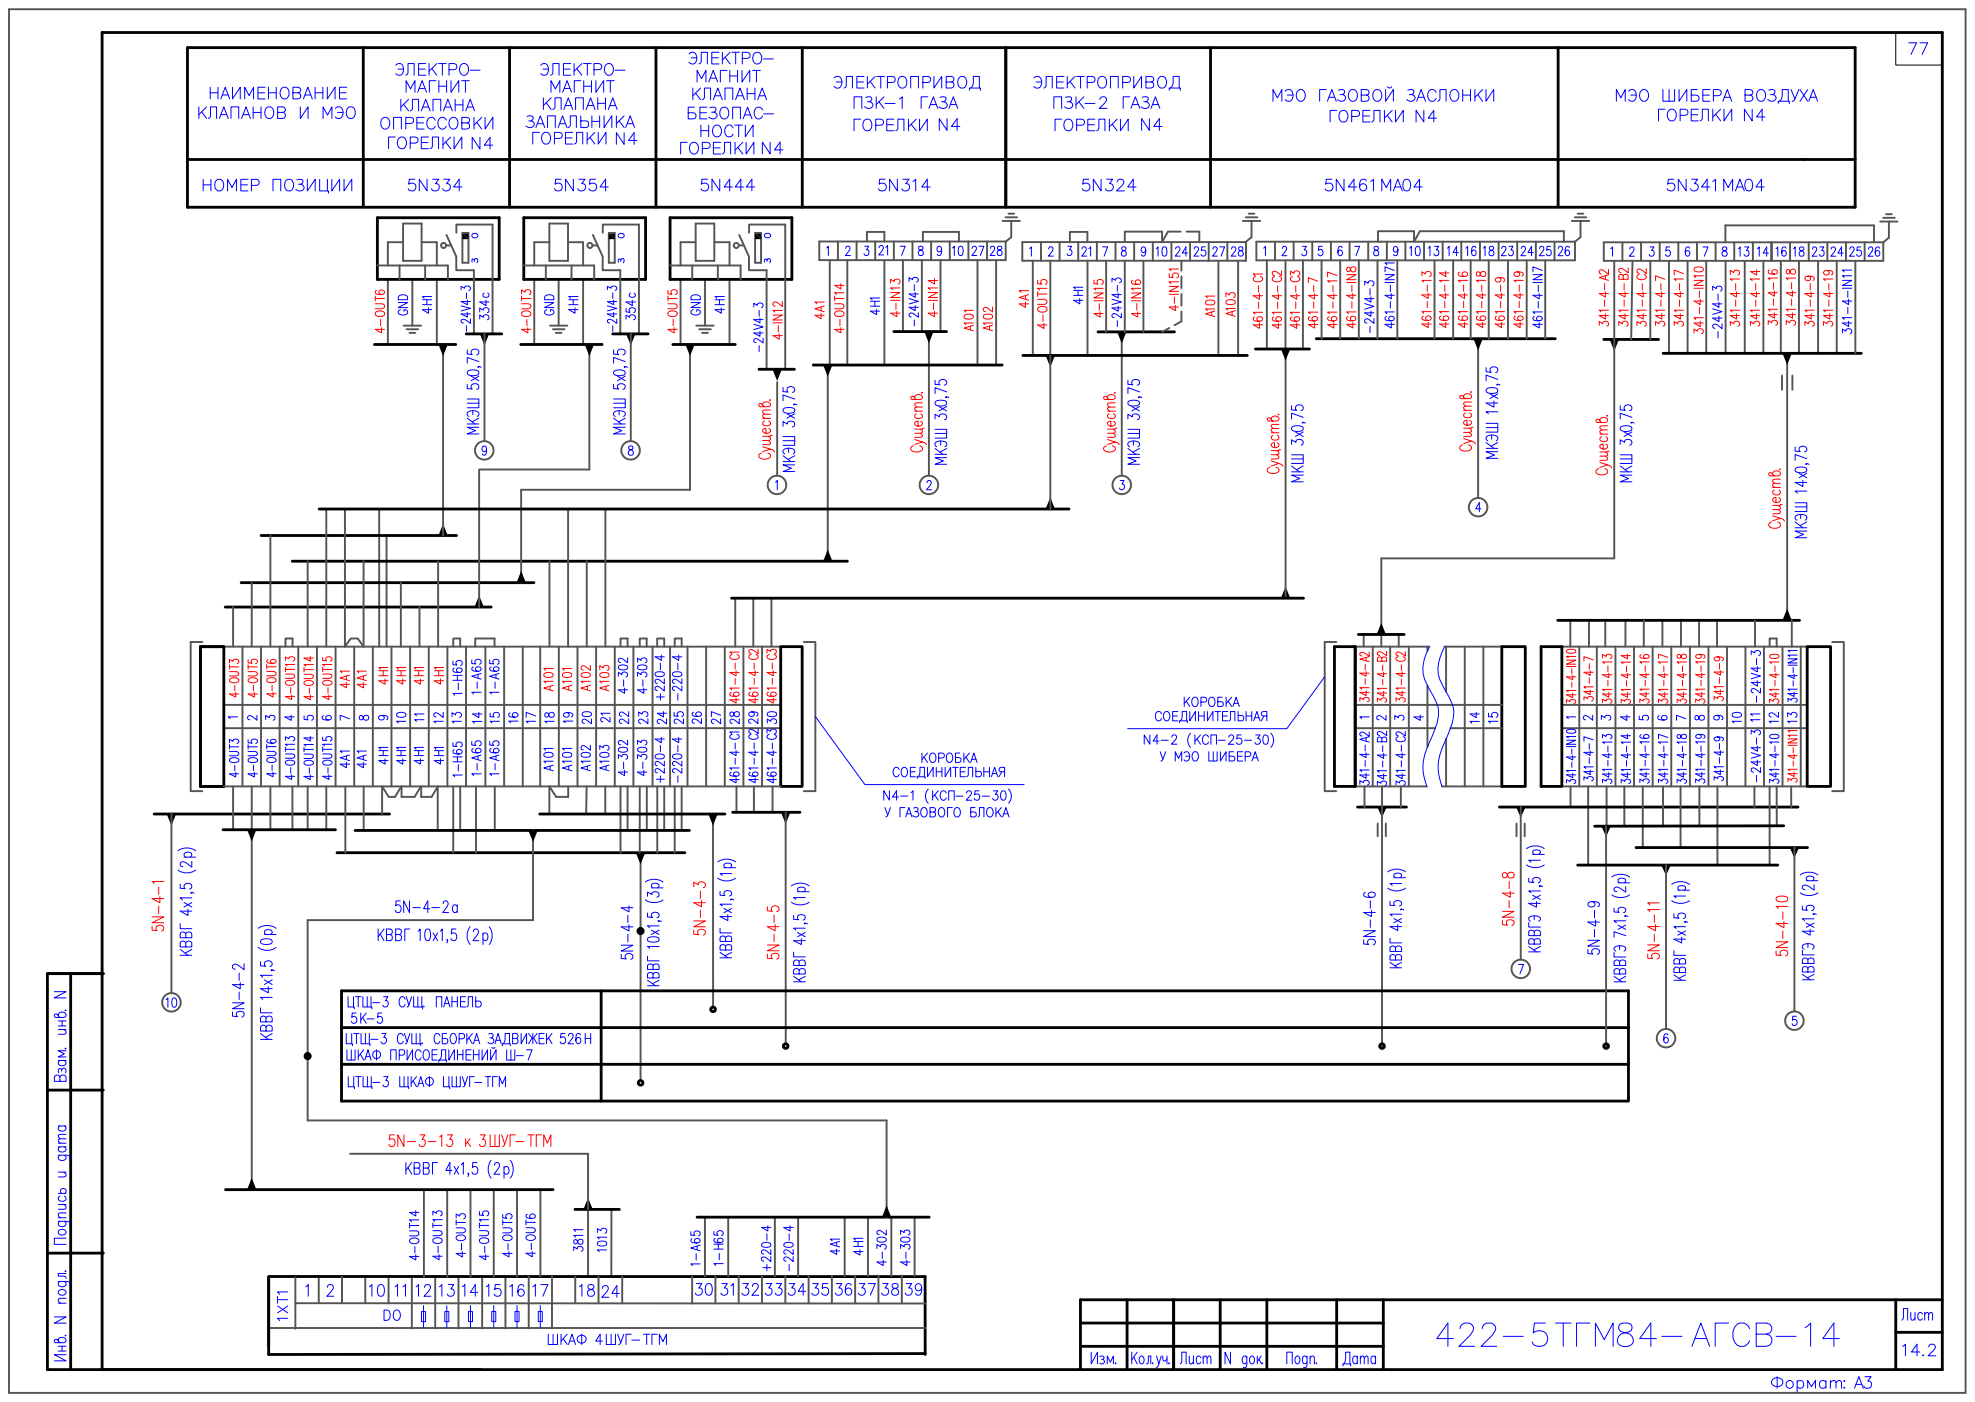
[picture p235: page 54]

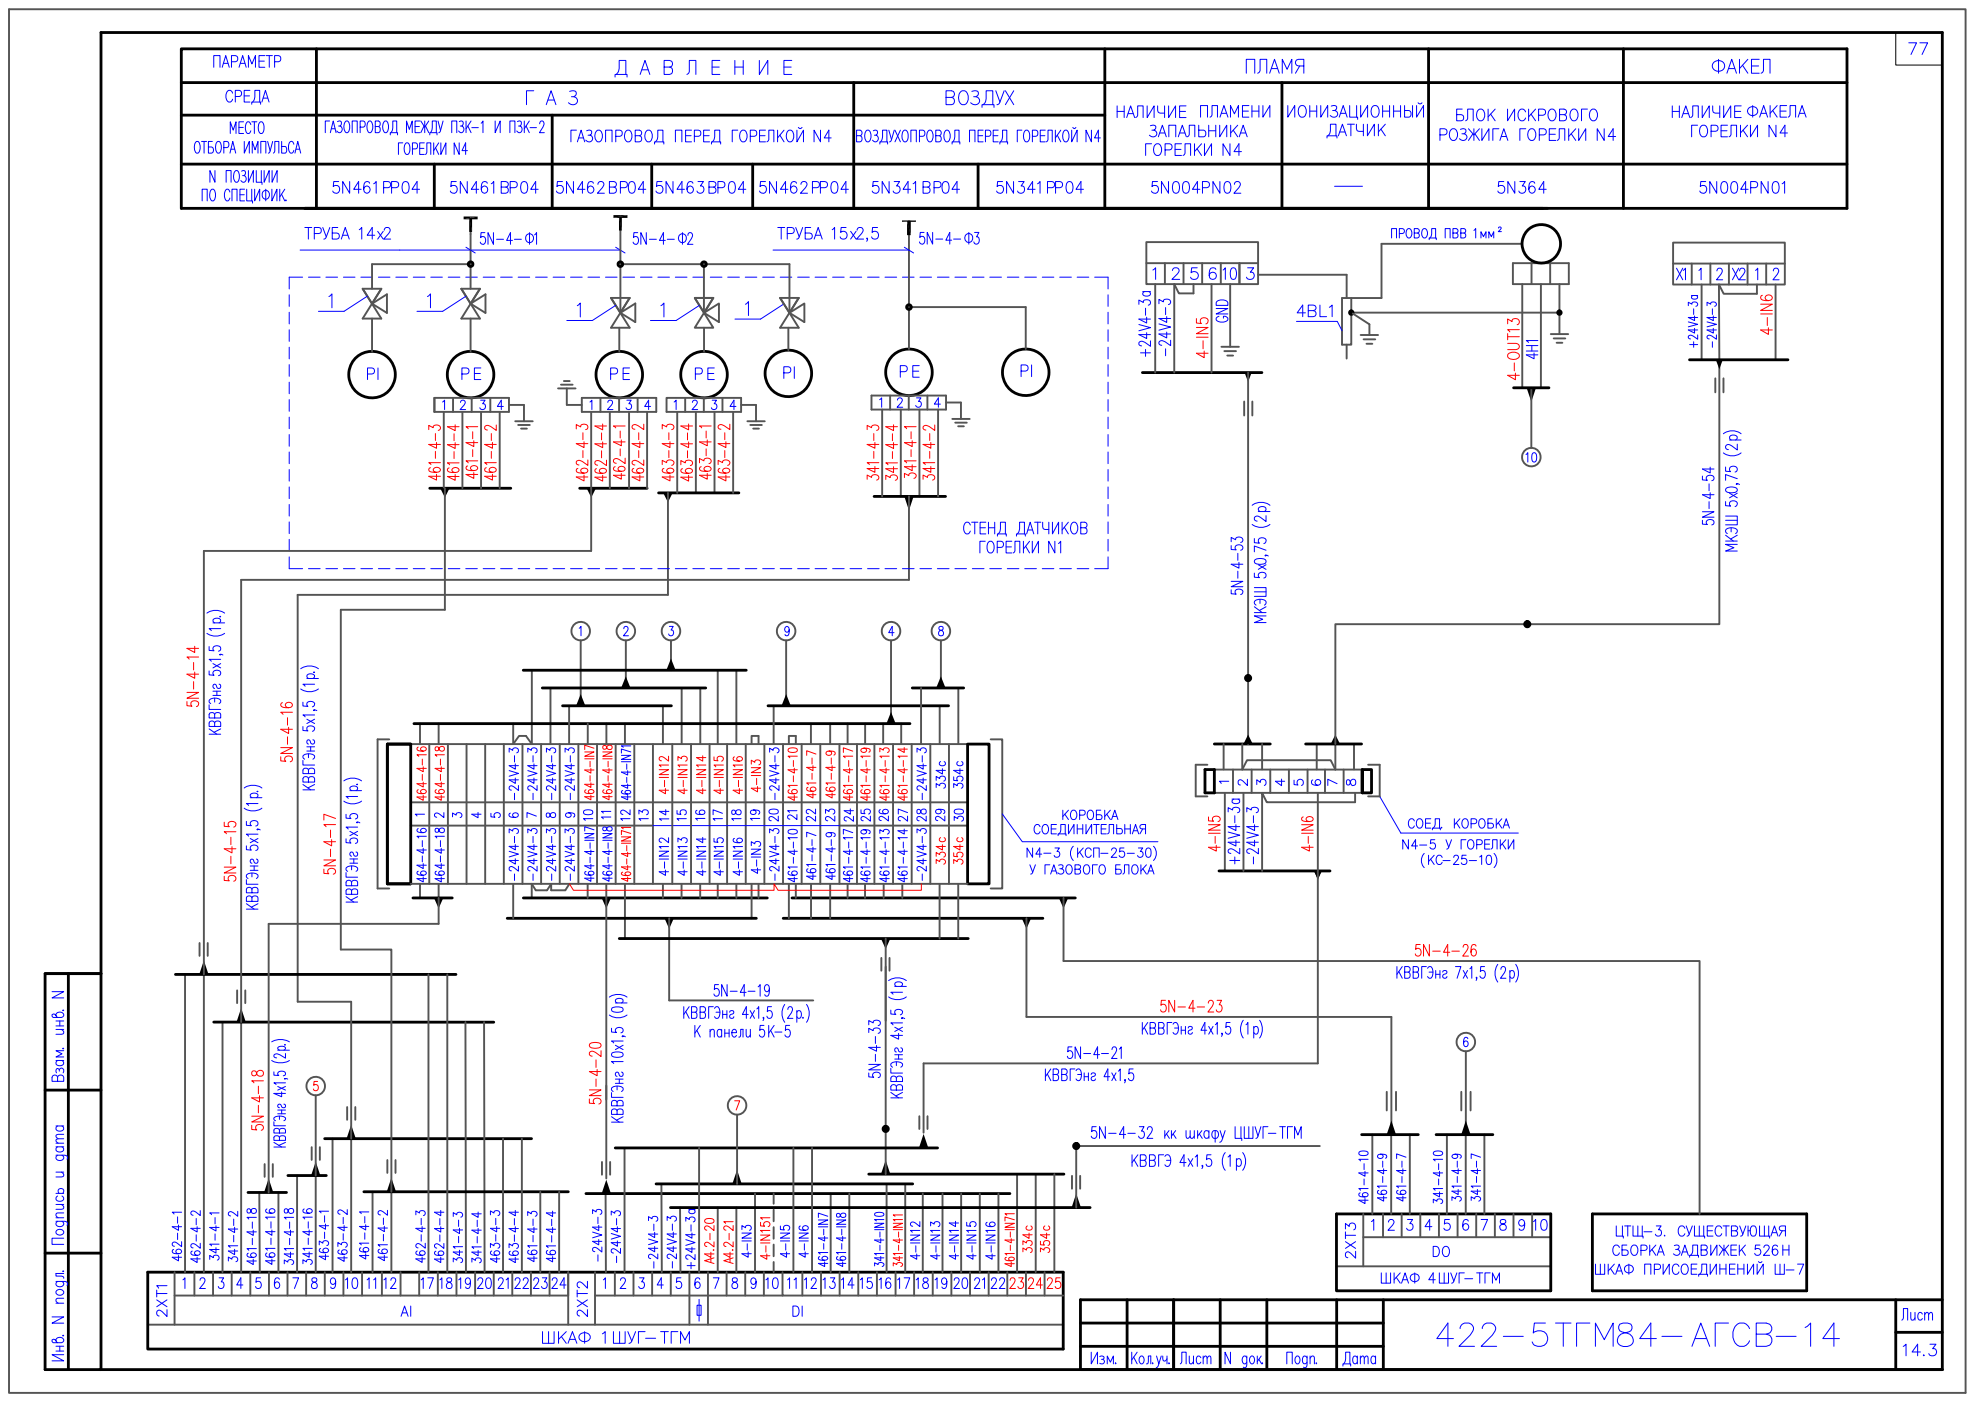
[picture p236: page 55]

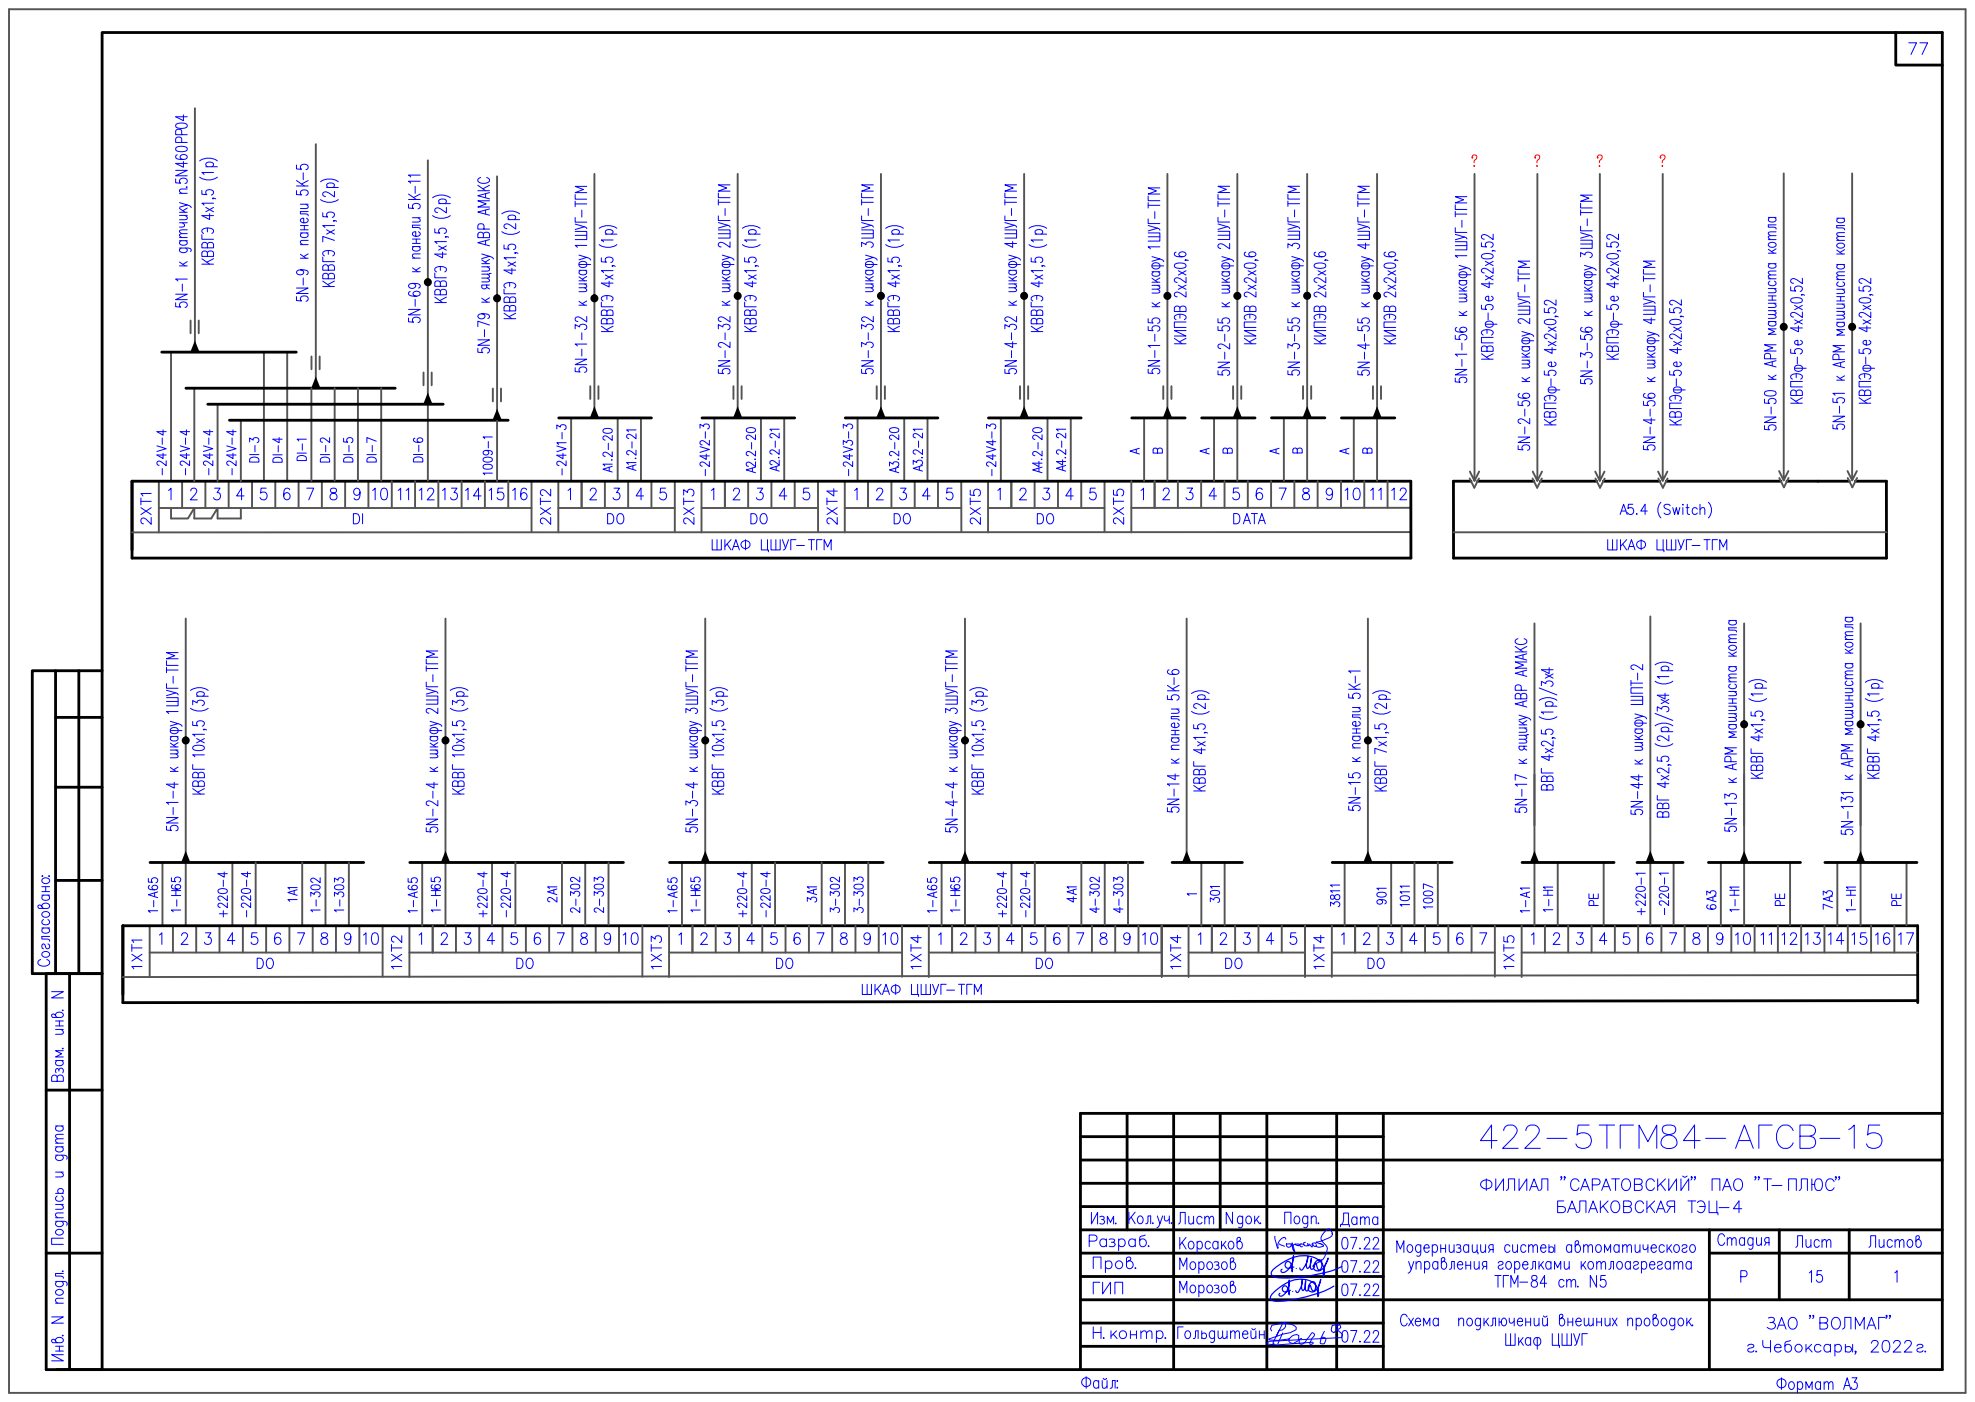
[picture p237: page 56]

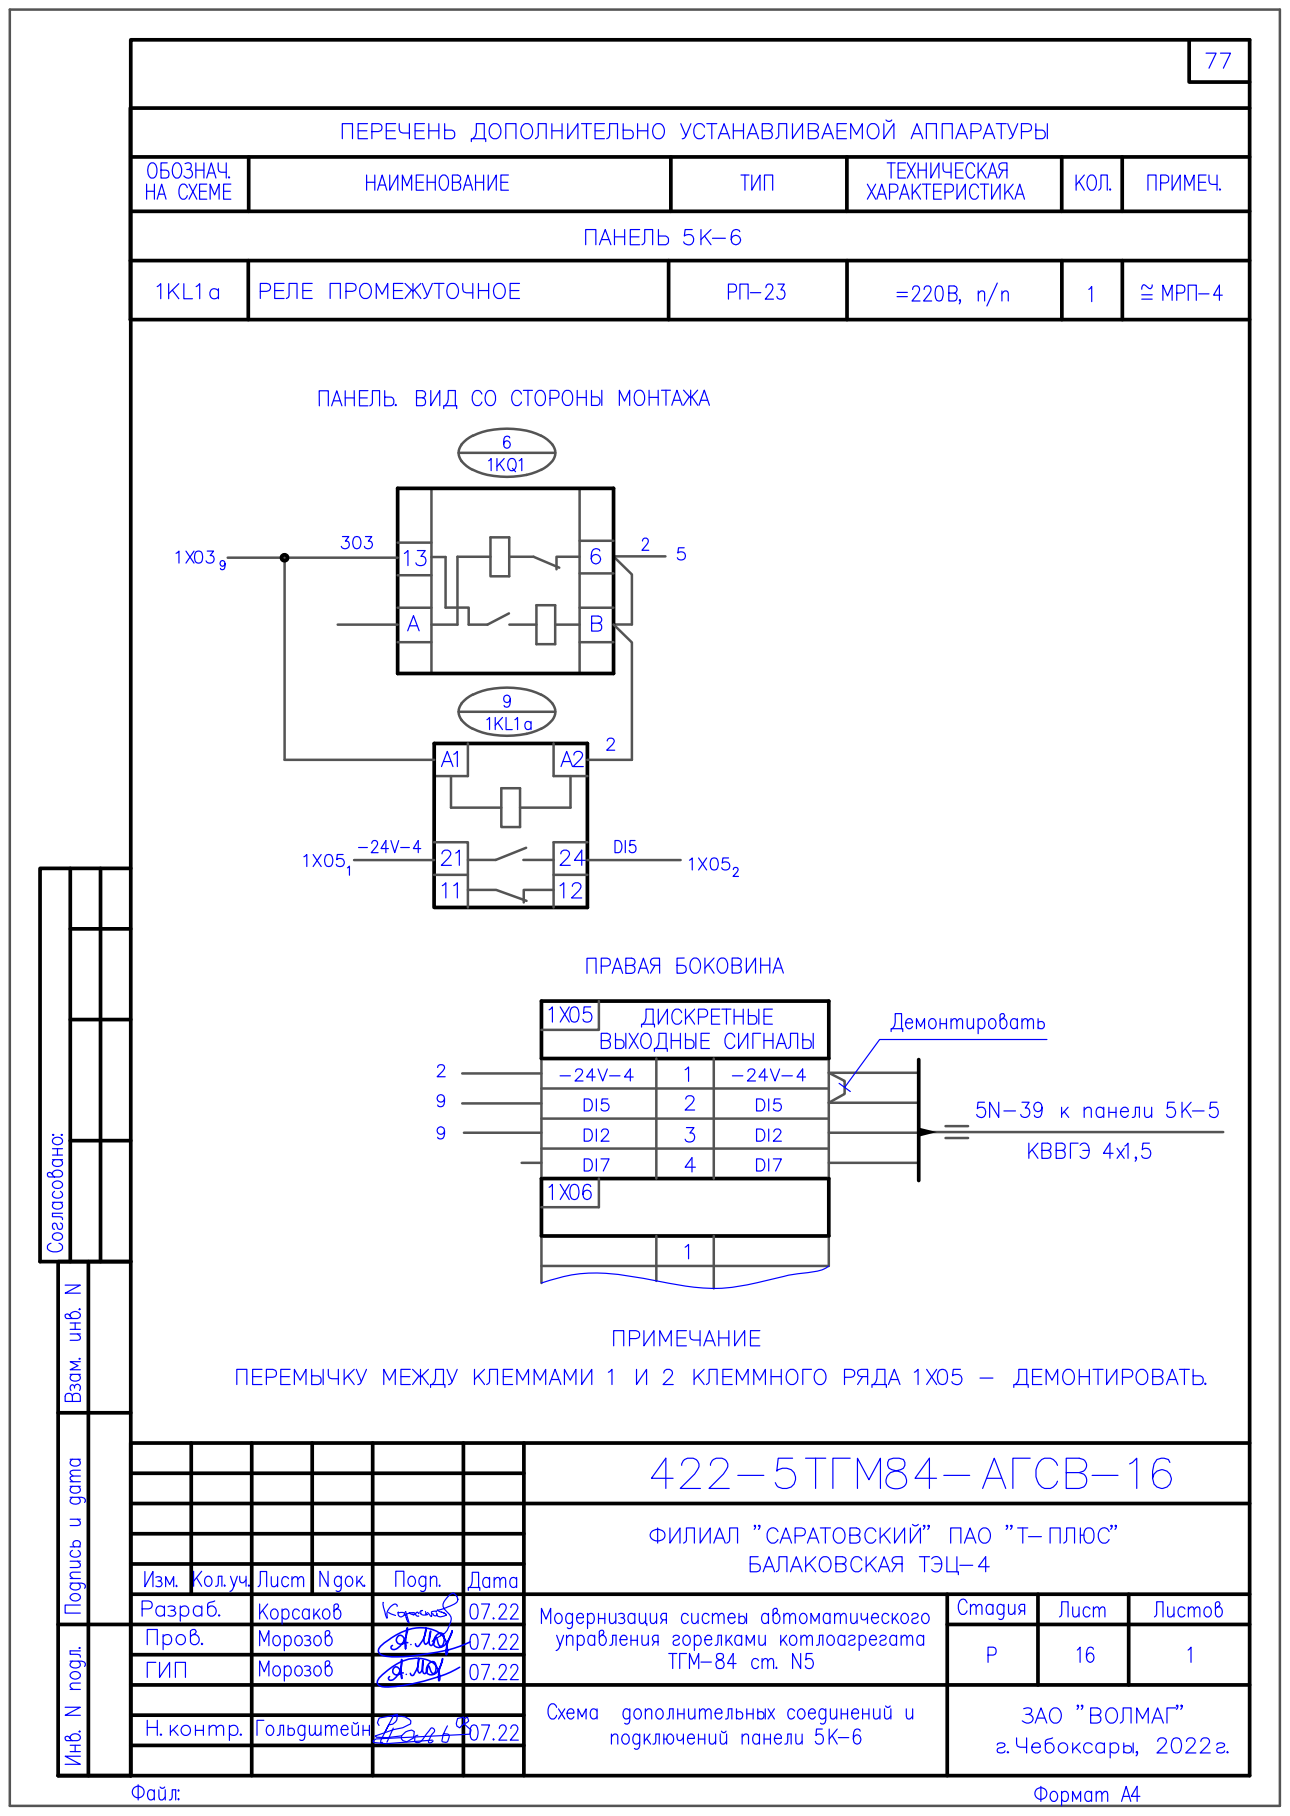
[picture p238: page 57]

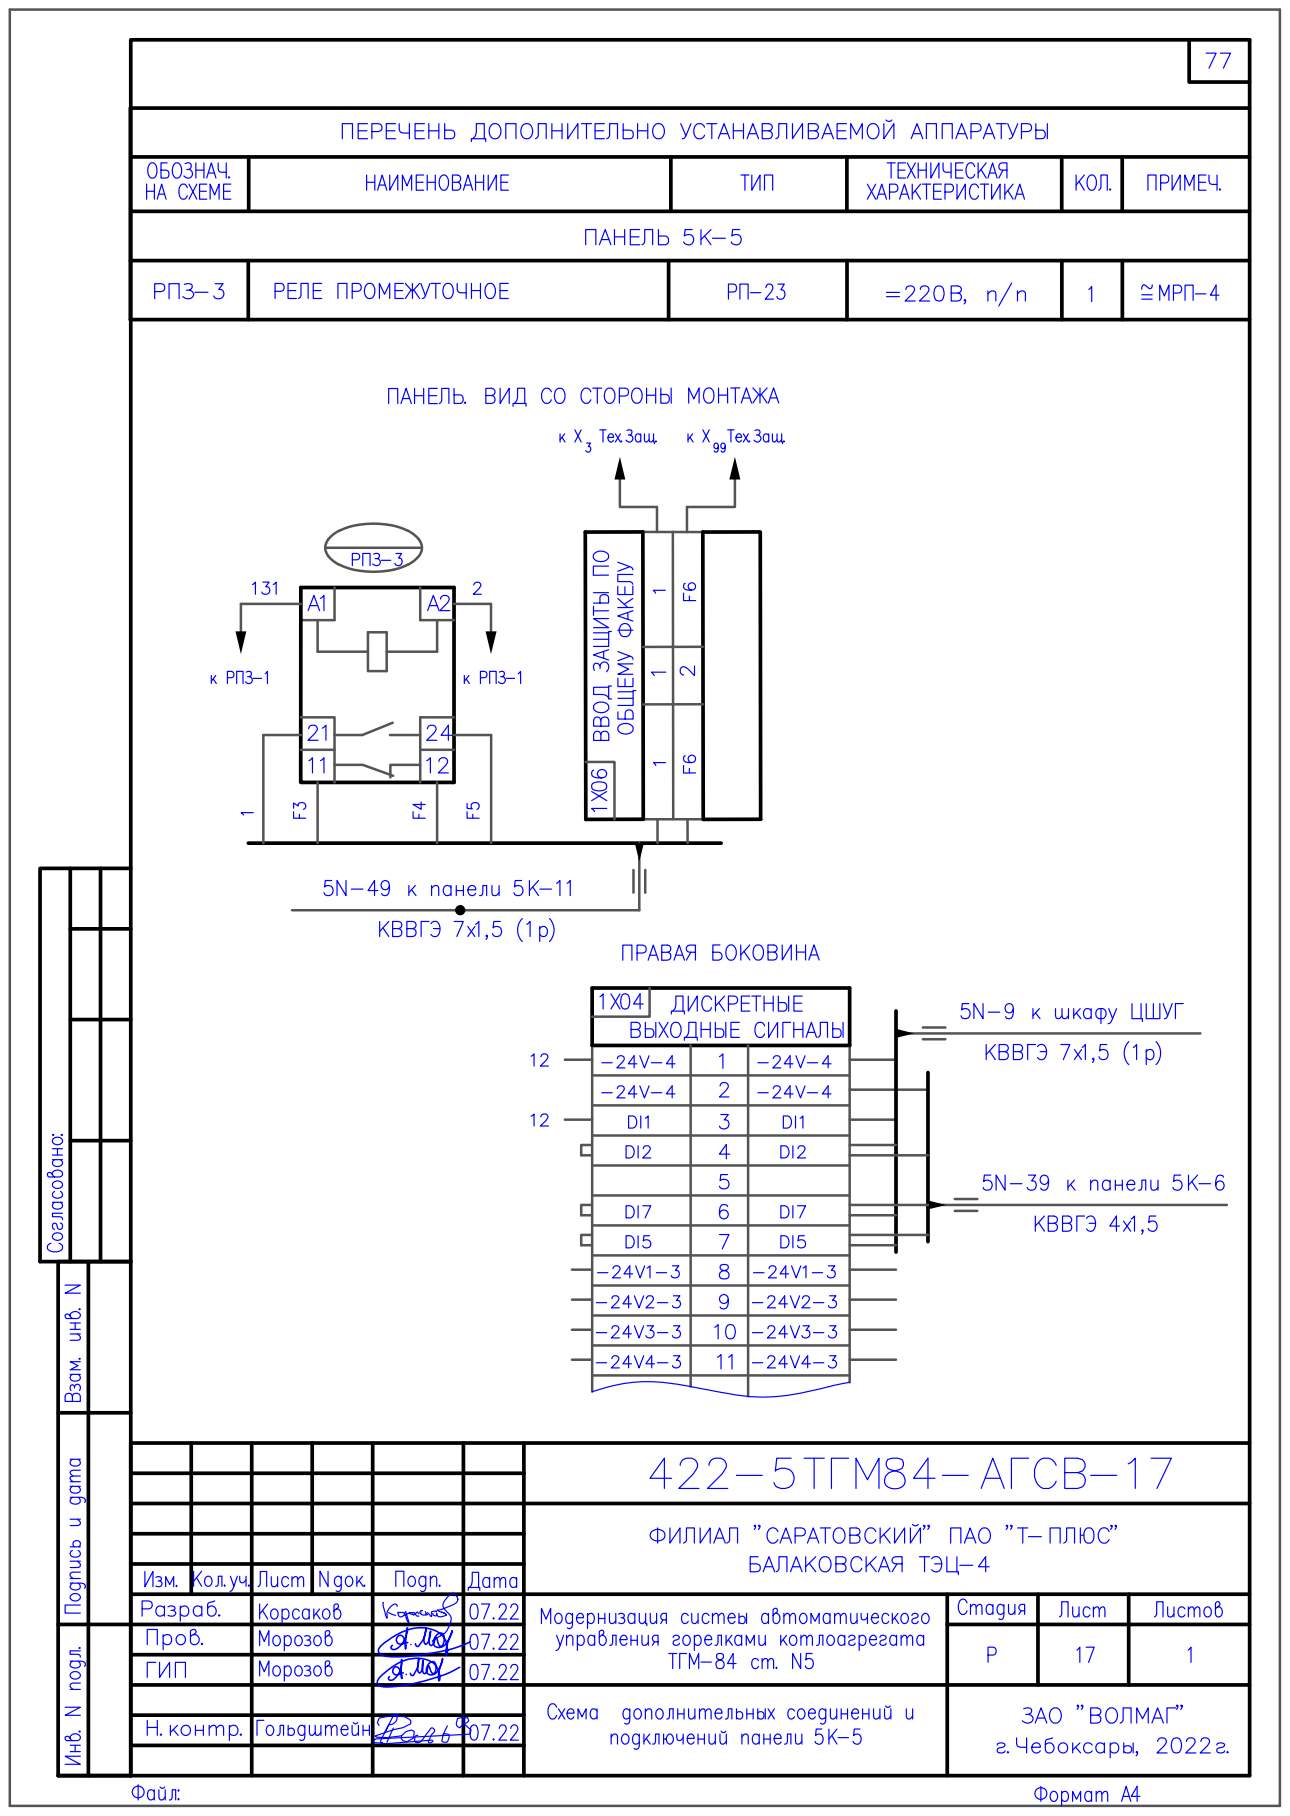
[picture p239: page 58]

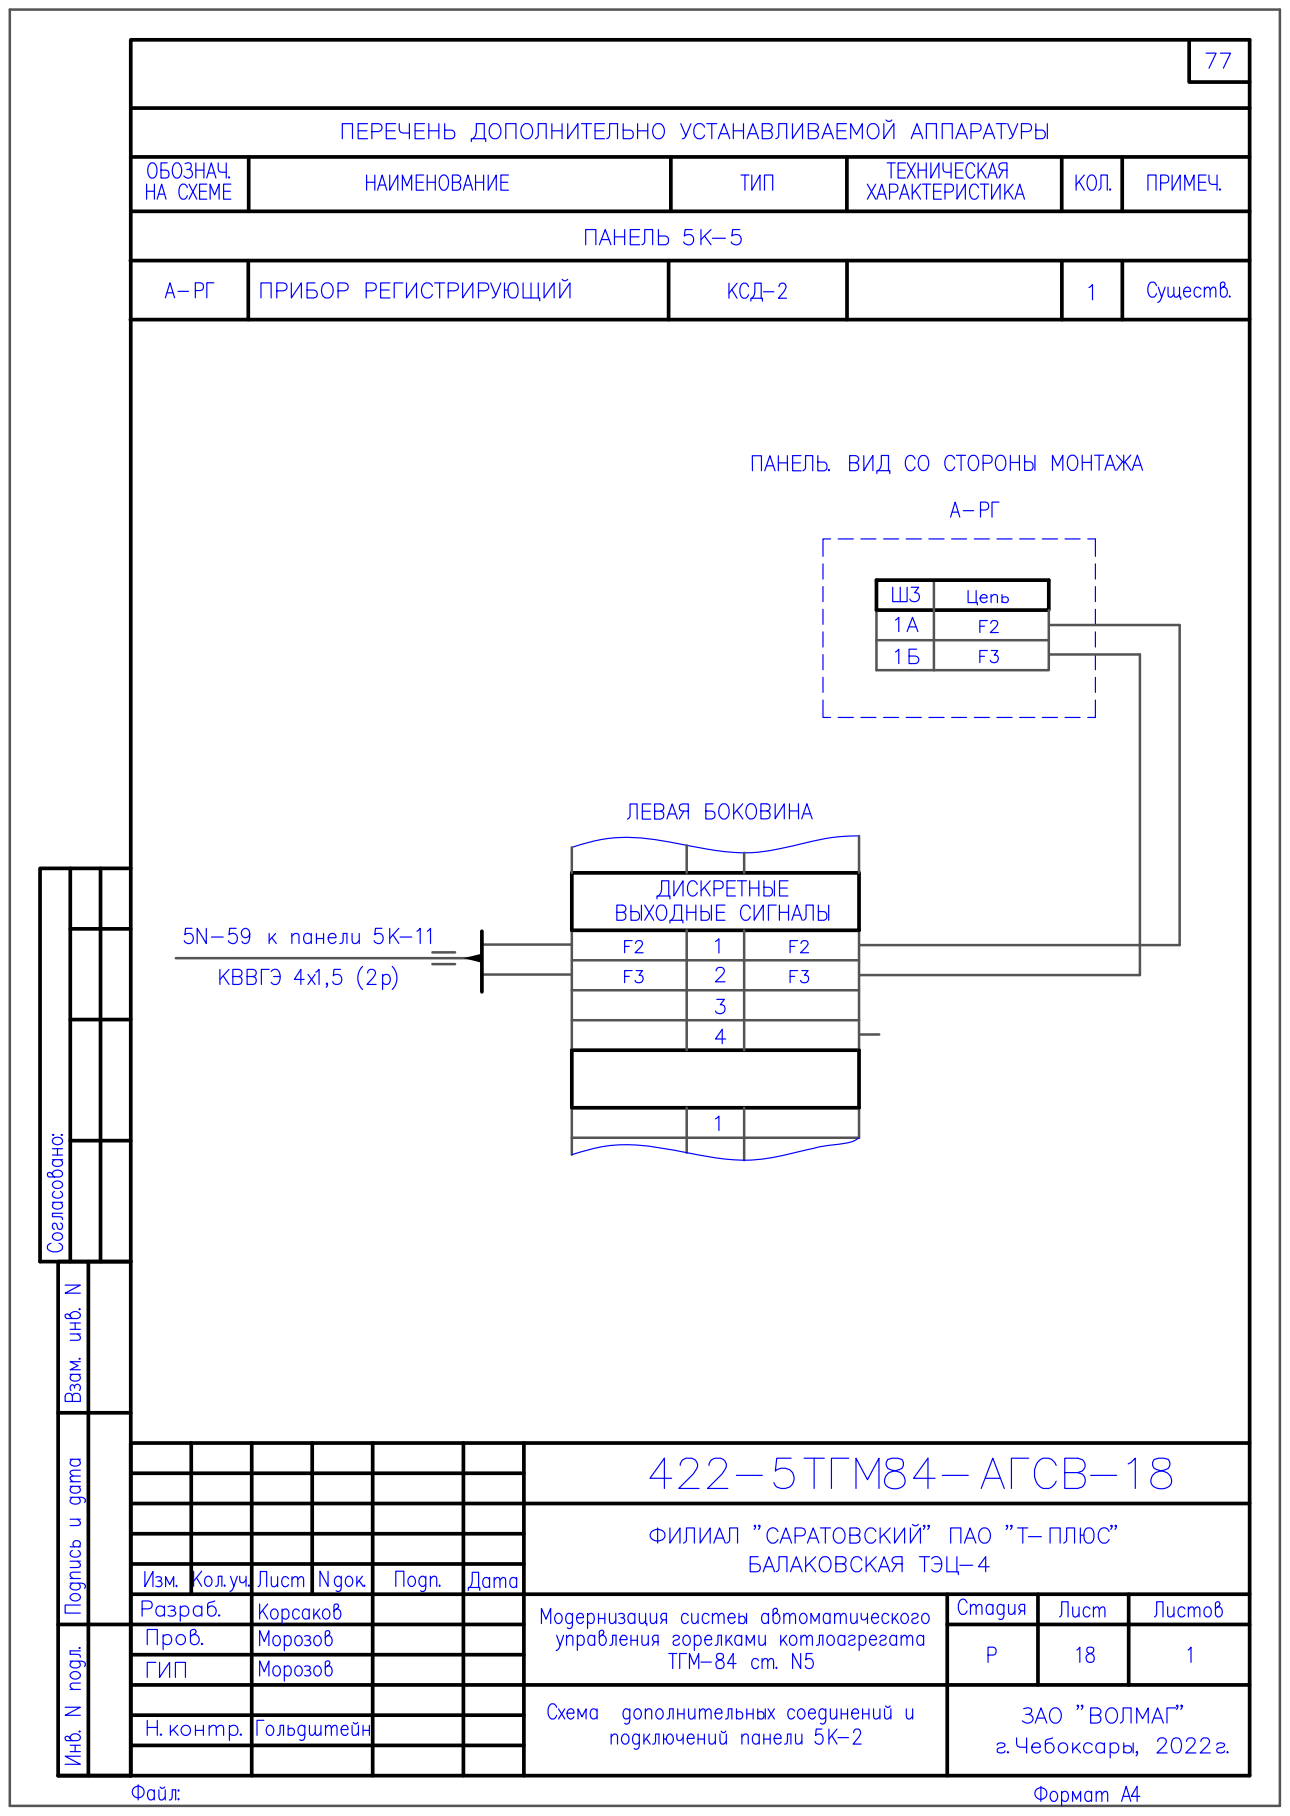
[picture p240: page 59]

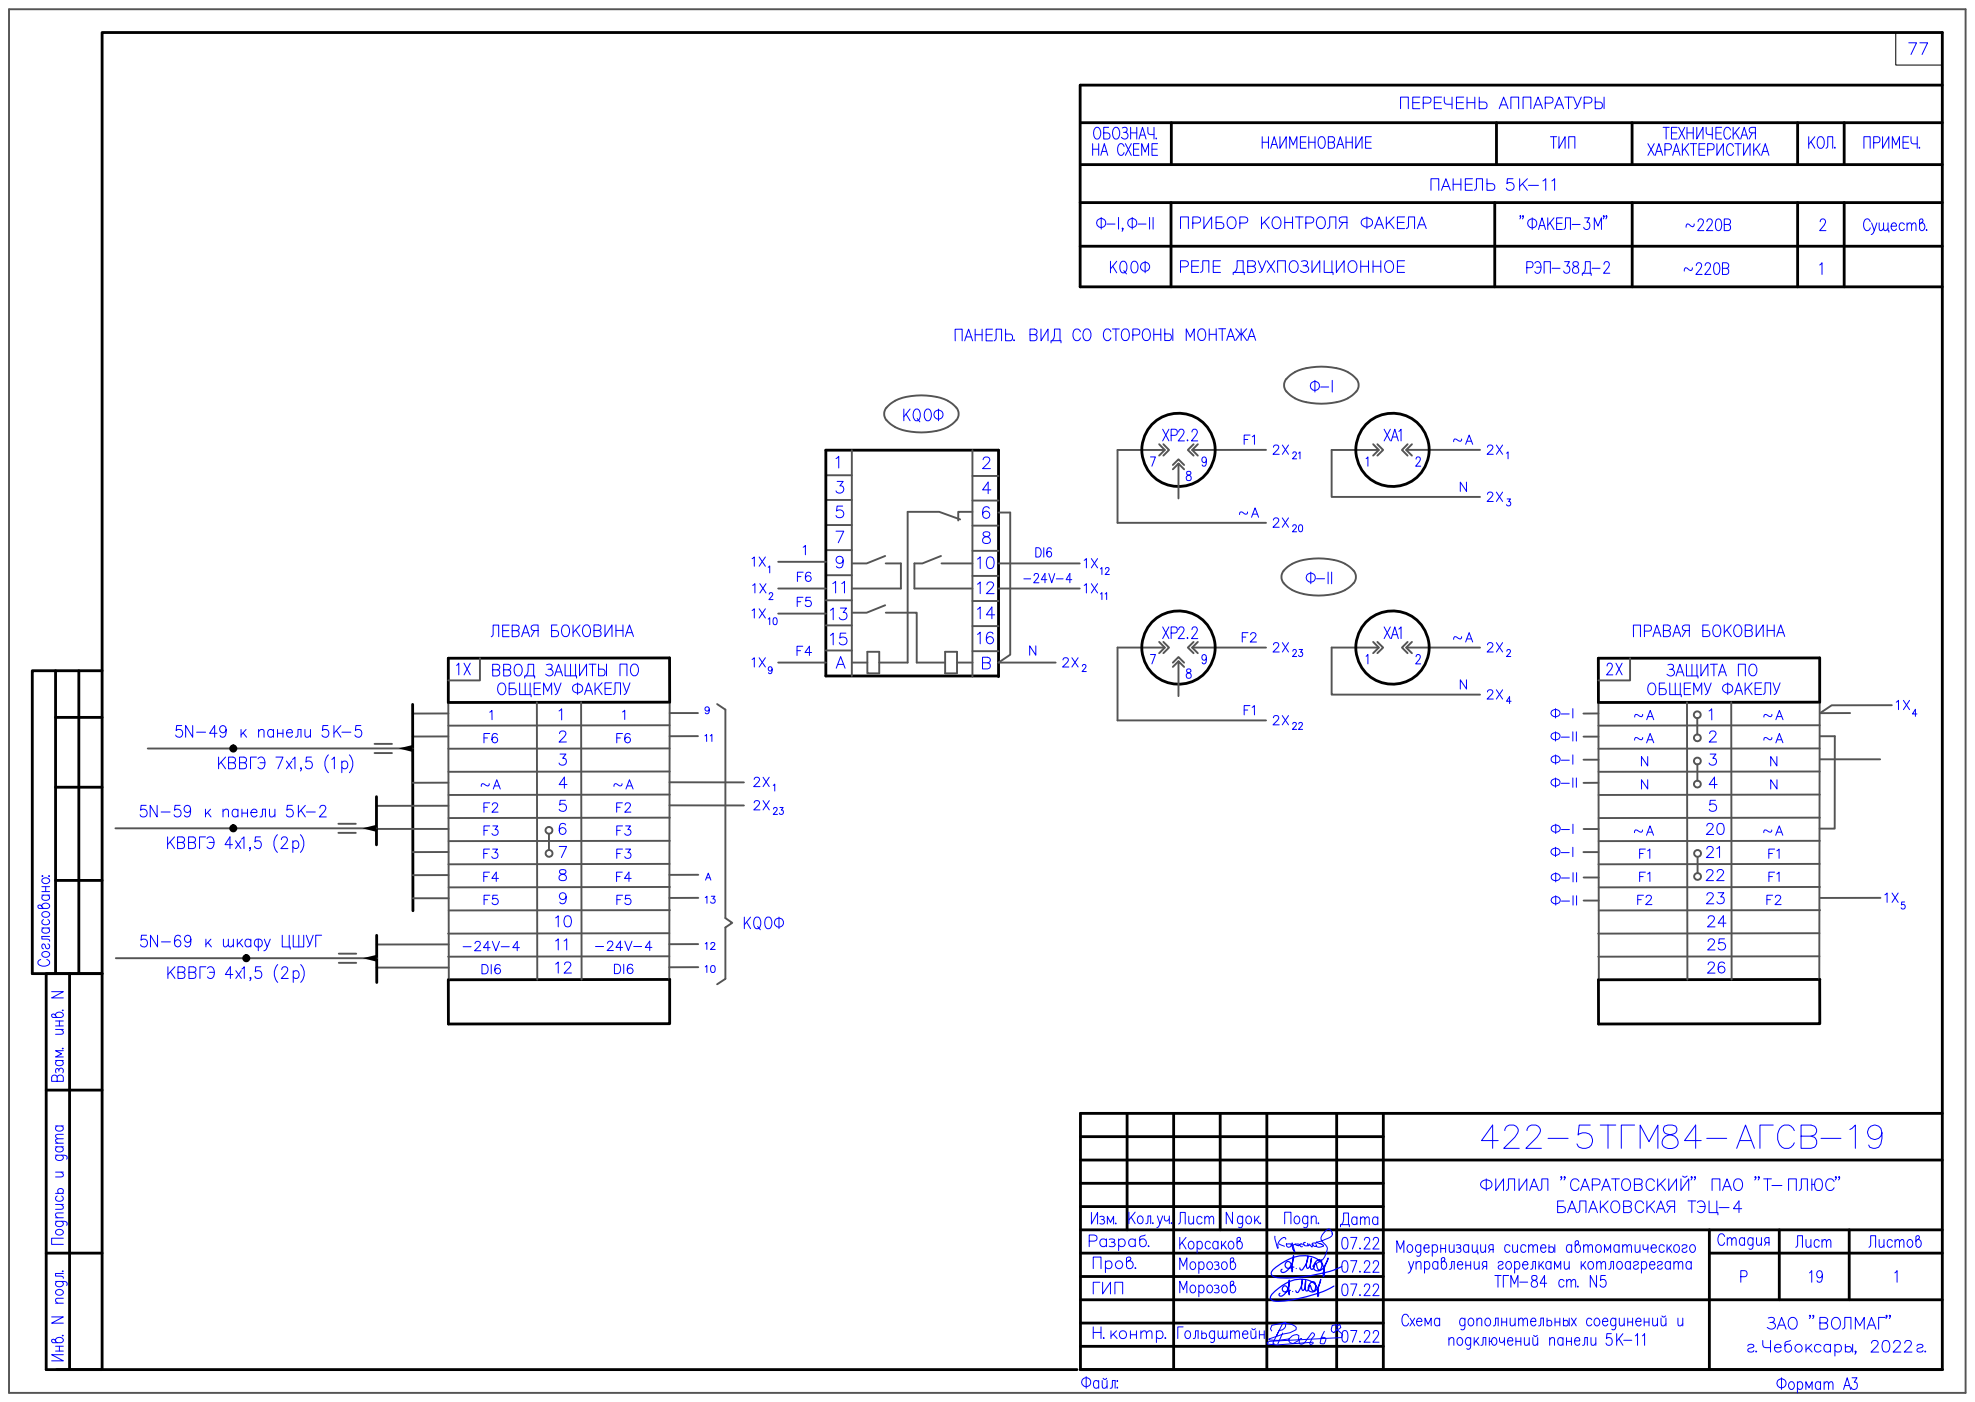
[picture p241: page 60]

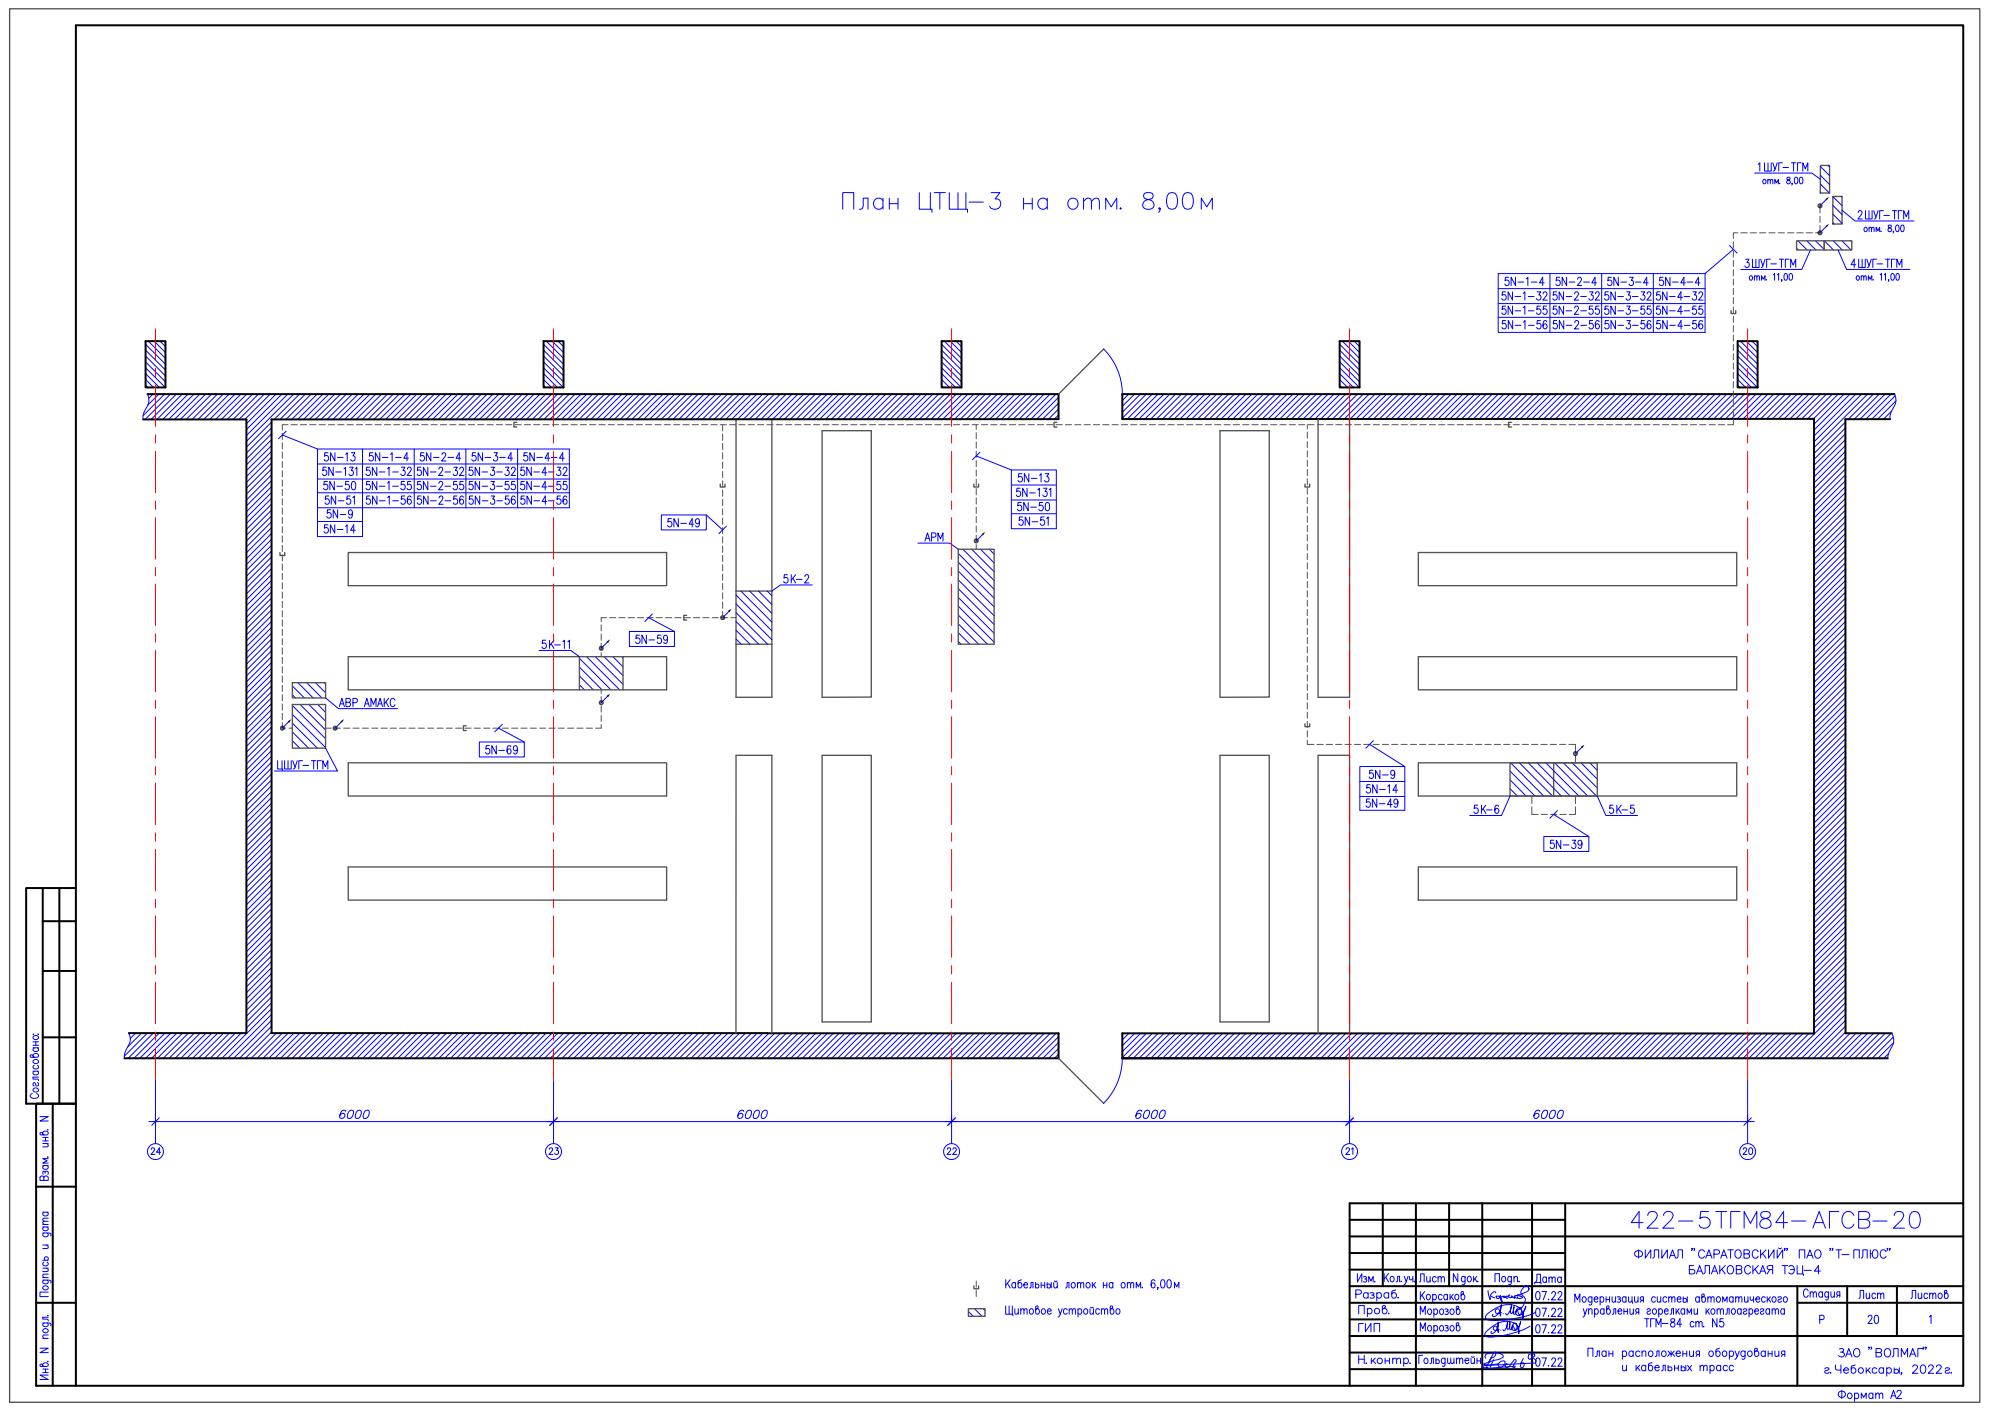
[picture p242: page 61]

8:40

## 422-5ТГМ84-АГСВ-ЖК

### Филиал «Саратовский» ПАО «Т-Плюс» Балаковская ТЭЦ-4 «

Изм. | | Лист | | Подп. | Дата
Разраб. | Корсаков | | 07.22 | Модернизация системы автоматического управления горелками котлоагрегата ТГМ-84 ст. №5 | Стадия | Лист | Листов
Проверил | Морозов | | 07.22 | | Р | 21.1 | 5
ГИП | Морозов | | 07.22
Н. контр. | Гольдштейн | 07.22 | Кабельный журнал | ЗАО «Волмаг» 2022г.

Взам. инв. № Подпись и дата Инв. № подл.
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
