nppesnteam/370-24_Balakovo_PTVM180_-3-4/АК4/6.План расположения, дымоход.pdf

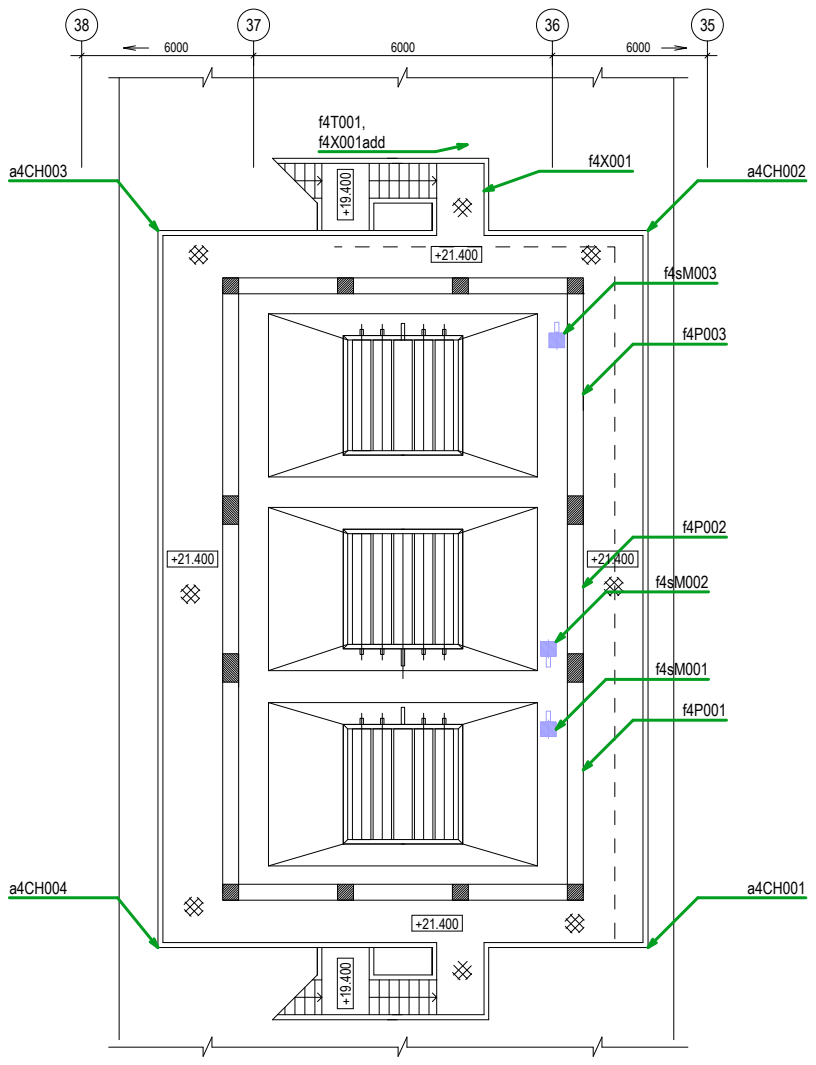
[picture p243: page 1]
Стадия; Лист; Листов; Изм.; №Док.; Подп.; Дата; котловПТВМ-180 ст.№4; ПАО «ТПлюс»; Разработал Проверил Н.контр.; Чураков; Агафонов; Корепанов; f4T001, f4X001add

Балаковская ТЭЦ-4 филиала «Саратовский»

Модернизация оборудования КИПиА водогрейных

ОООНПП "ЭСН"
www.nppesn.ru

План дымоходов котла на отм. +21.4м
