nppesnteam/370-24_Balakovo_PTVM180_-3-4/АК4/6.План расположения.pdf

# 37 36 Ось котла ПТВМ⁻¹⁸⁰ ст.№⁴

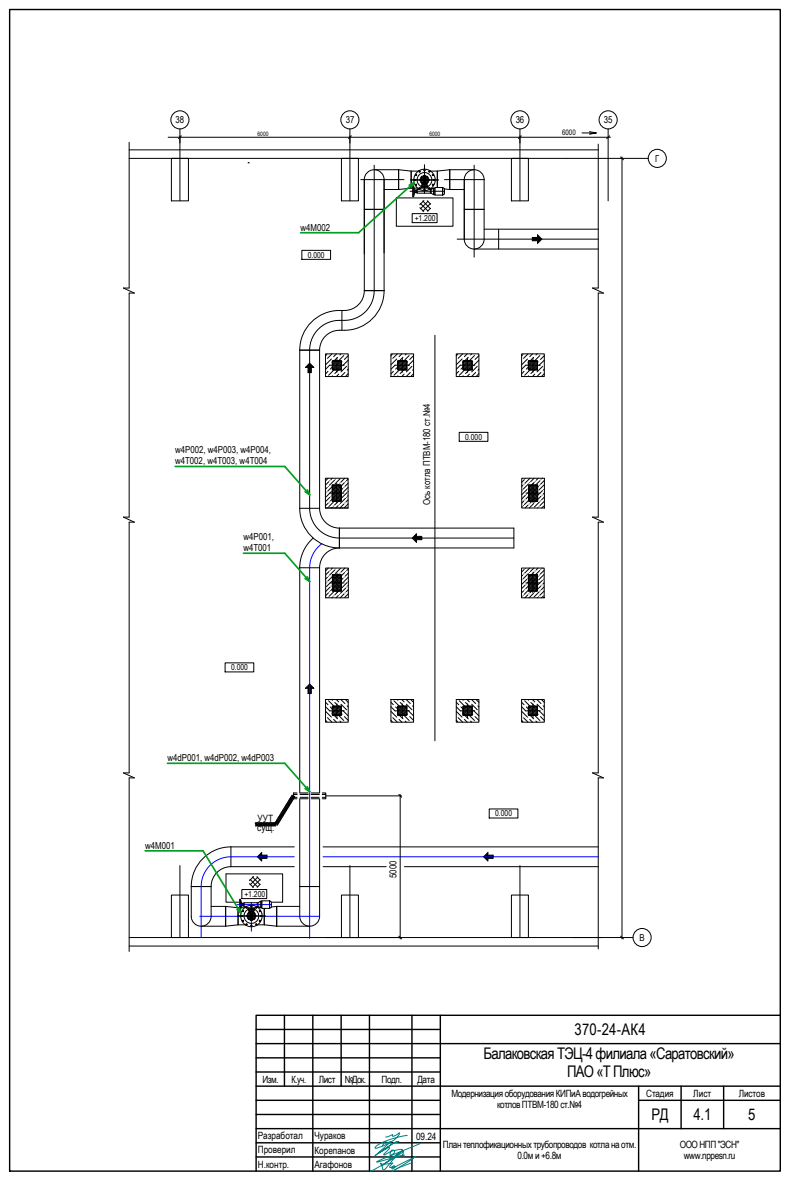
[picture p244: page 1]
Стадия; Лист; Листов; Изм.; №Док.; Подп.; Дата; котловПТВМ-180 ст.№4; ПАО «ТПлюс»; Разработал Проверил Н.контр.; Чураков; Агафонов; Корепанов; УУТ сущ.

Балаковская ТЭЦ-4 филиала «Саратовский»

Модернизация оборудования КИПиА водогрейных

План теплофикационных трубопроводов котла на отм.

ОООНПП "ЭСН"
www.nppesn.ru

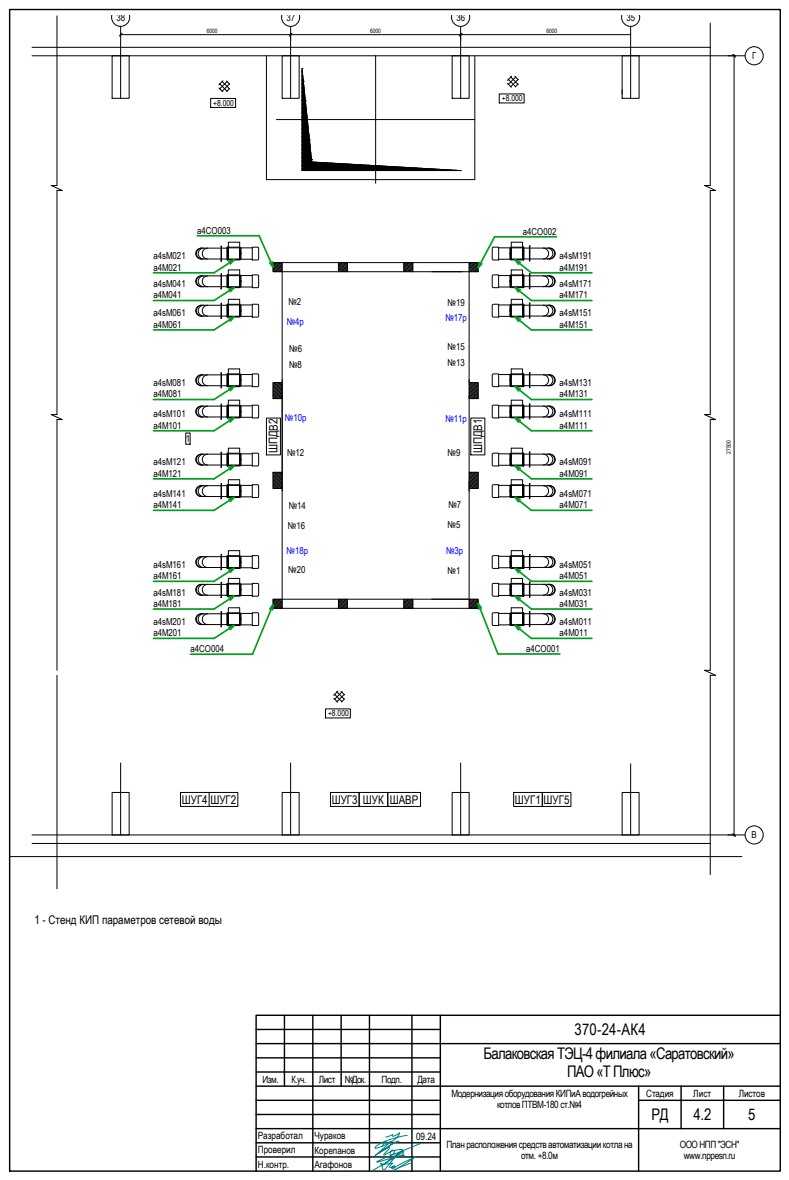
[picture p245: page 2]
Изм.; Лист; №Док.; Подп.; Дата; ПАО «ТПлюс»; отм. +8.0м; ШУГ4 ШУГ2; ШУГ3 ШУК ШАВР; ШУГ1 ШУГ5

1 - Стенд КИП параметров сетевой воды

Балаковская ТЭЦ-4 филиала «Саратовский»

План расположения средств автоматизации котла на

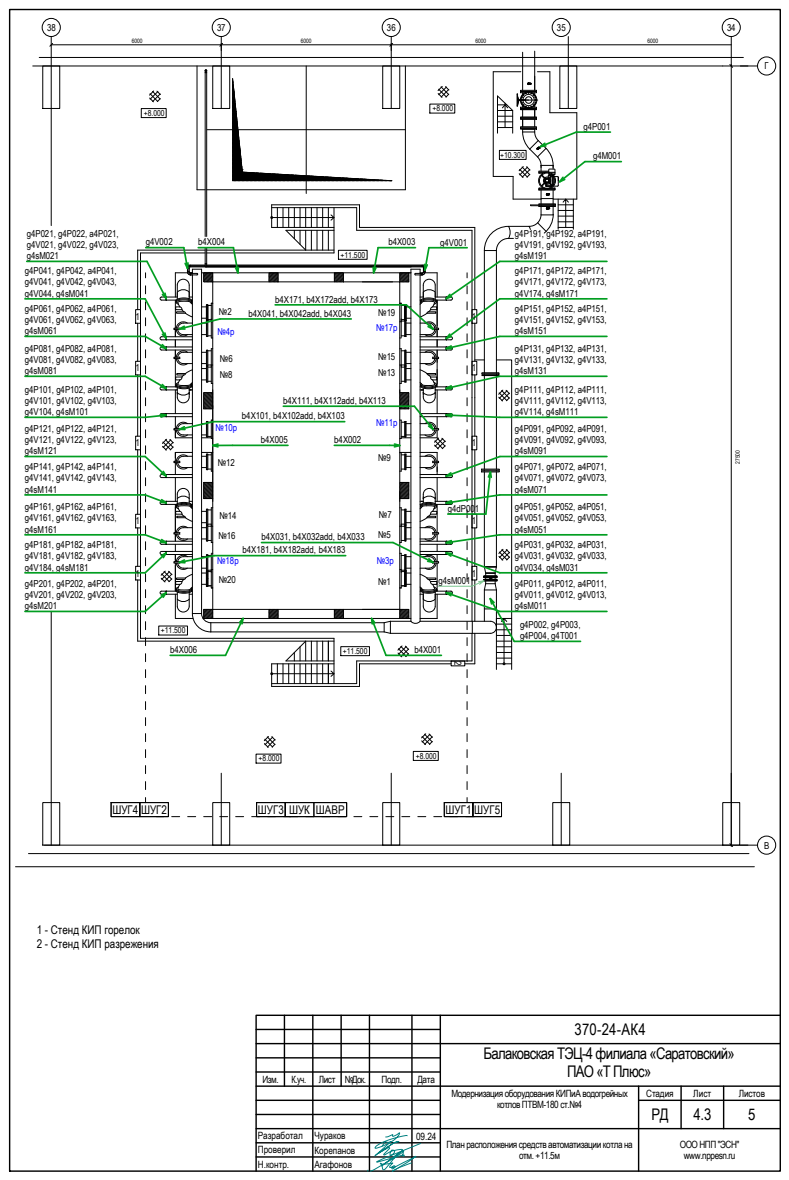
[picture p246: page 3]
Изм.; Лист; №Док.; Подп.; Дата; ПАО «ТПлюс»; отм. +11.5м; b4X031, b4X032add, b4X033; b4X111, b4X112add, b4X113; b4X171, b4X172add, b4X173; g4P021, g4P022, a4P021, g4V021, g4V022, g4V023, g4sM021 g4P041, g4P042, a4P041, g4V041, g4V042, g4V043, g4V044, g4sM041 b4X041, b4X042add, b4X043 g4P061, g4P062, a4P061, g4V061, g4V062, g4V063, g4sM061; b4X101, b4X102add, b4X103; b4X181, b4X182add, b4X183; ШУГ4 ШУГ2; ШУГ3 ШУК; ШАВР; ШУГ1 ШУГ5

1 - Стенд КИП горелок
2 - Стенд КИП разрежения

Балаковская ТЭЦ-4 филиала «Саратовский»

План расположения средств автоматизации котла на

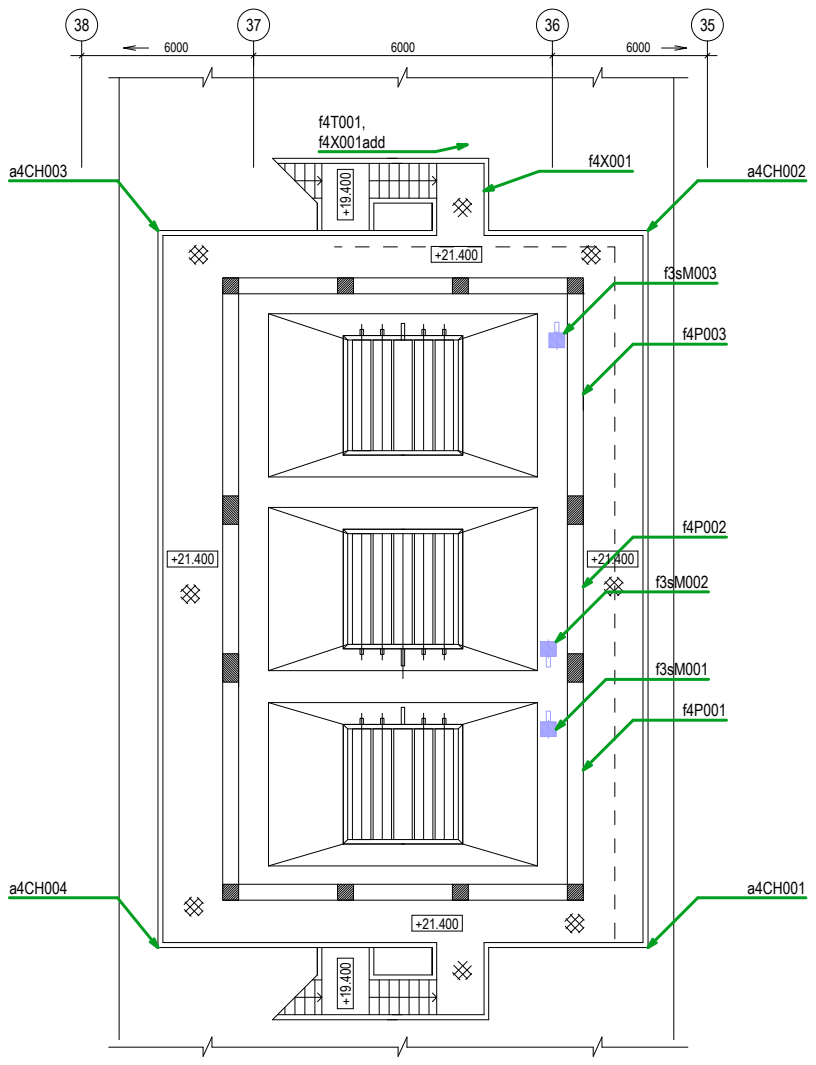
[picture p247: page 4]
Изм.; Лист; №Док.; Подп.; Дата; ПАО «ТПлюс»; f4T001, f4X001add

Балаковская ТЭЦ-4 филиала «Саратовский»

План дымоходов котла на отм. +21.4м

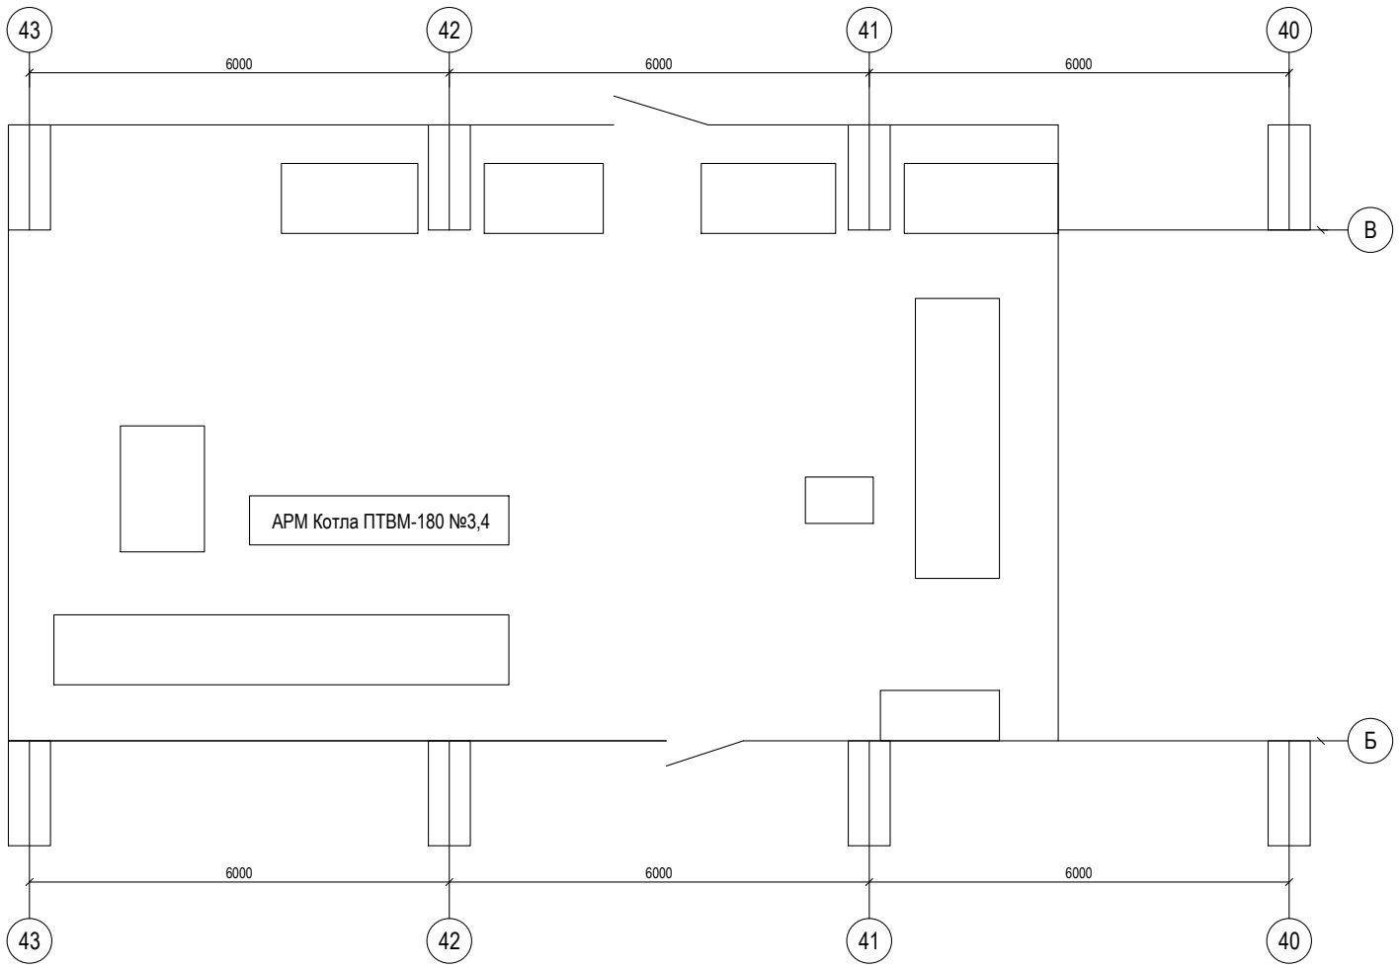
[picture p248: figure]
АРМ Котла ПТВМ-180 №3,4

Изм. | К.уч. | Лист | №Док. | Подп. | Дата

## Балаковская ТЭЦ-4 филиала «Саратовский» ПАО «ТПлюс»

370-24-АК4

План расположения АРМоператора
