nppesnteam/370-24_Balakovo_PTVM180_-3-4/АК4/7.Схемы.pdf

Шифр | Назначение | Значение номиналь-

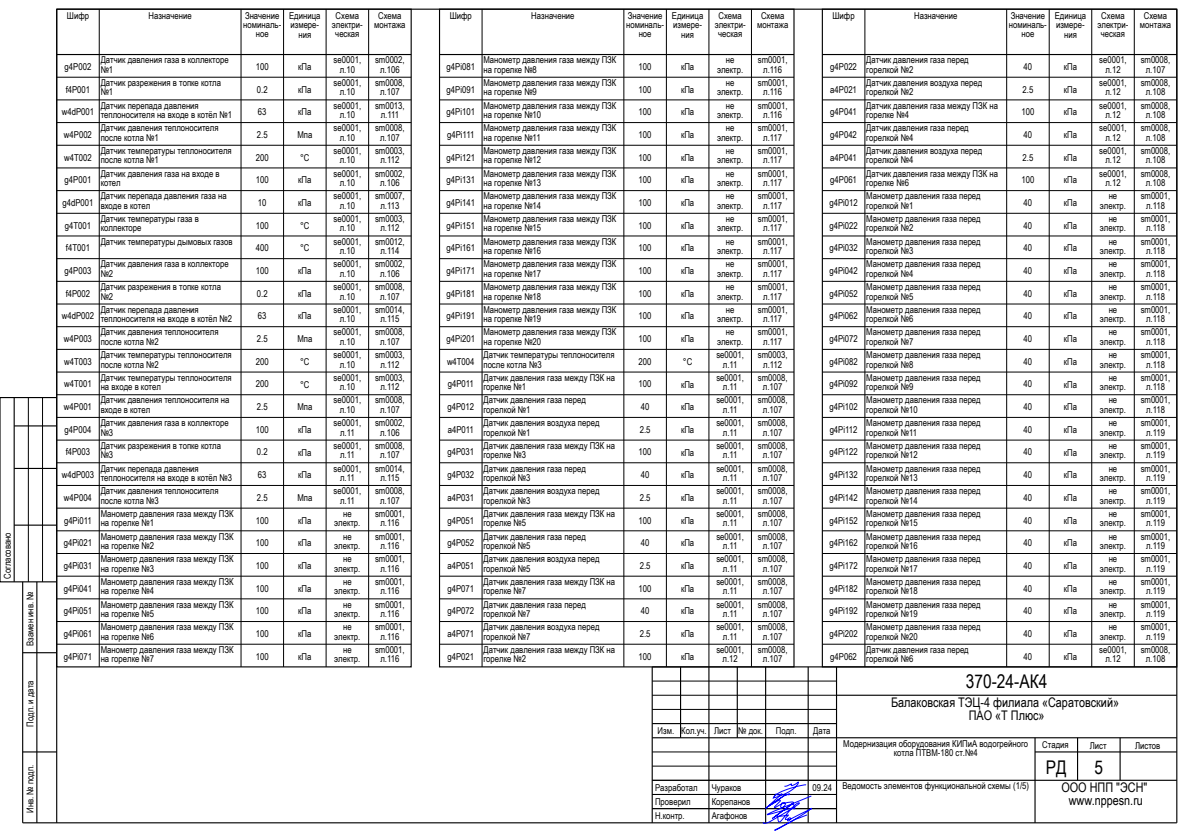
[picture p249: page 1]
Согласовано; ное; Единица измере- ния; Схема электри- ческая; Схема монтажа; Шифр; Назначение; Значение; номиналь- ное; Датчик давления газа в коллекторе; л.10 кПа; Датчик разрежения в топке котла; Датчик перепада давления; теплоносителя на входе в котёл №1; Датчик давления теплоносителя; после котла №1; se0001, Мпа; Датчик температуры теплоносителя; Датчик давления газа на входе в; котел; Датчик перепада давления газа на; входе в котел; Датчик температуры газа в; коллекторе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

Инв. № подп. Подп. и дата Взамен инв. №

Балаковская ТЭЦ-4 филиала «Саратовский» ПАО «Т Плюс»

Изм. | Кол.уч. | Лист | № док. | Подп. | Дата

Модернизация оборудования КИПиА водогрейного котла ПТВМ-180 ст.№4 | Стадия | Лист | Листов

Разработал | Чураков | | | Ведомость элементов функциональной схемы (1/5) | ООО НПП "ЭСН" www.nppesn.ru
Проверил | Корепанов
Н.контр. | Агафонов

Шифр | Назначение | Значение номиналь-

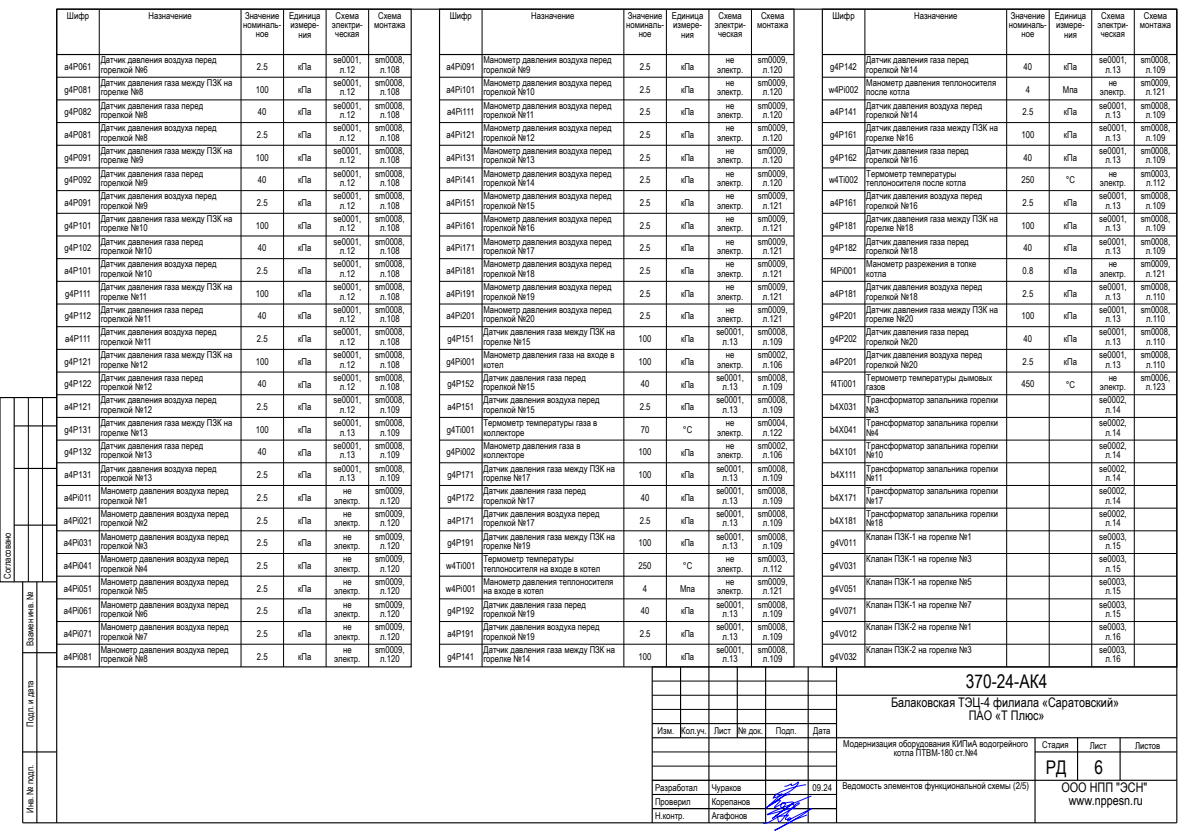
[picture p250: page 2]
Согласовано; ное; Единица измере- ния; Схема электри- ческая; Схема монтажа; Шифр; Назначение; Значение; номиналь- ное; Датчик давления воздуха перед; горелкой №6; л.12 кПа; Датчик давления газа между ПЗК на; горелке №8; Датчик давления газа перед; горелкой №8; горелке №9; горелкой №9; горелке №10; горелкой №10; горелке №11; горелкой №11; горелке №12; горелкой №12; горелке №13; л.13 кПа; горелкой №13; Манометр давления воздуха перед; горелкой №1; электр. кПа; горелкой №2; горелкой №3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

Инв. № подп. Подп. и дата Взамен инв. №

Балаковская ТЭЦ-4 филиала «Саратовский» ПАО «Т Плюс»

Изм. | Кол.уч. | Лист | № док. | Подп. | Дата

Модернизация оборудования КИПиА водогрейного котла ПТВМ-180 ст.№4 | Стадия | Лист | Листов

Ведомость элементов функциональной схемы (2/5) | ООО НПП "ЭСН"

Шифр | Назначение | Значение номиналь-

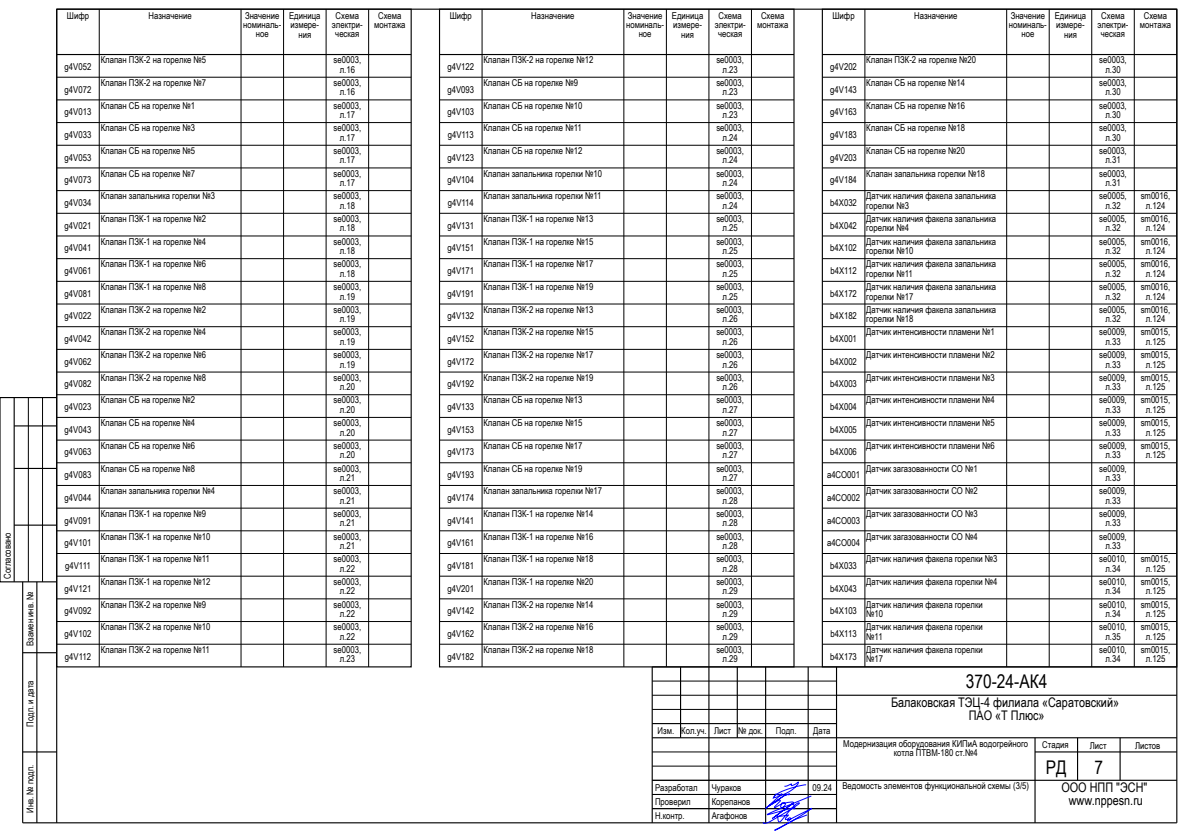
[picture p251: page 3]
Согласовано; ное; Единица измере- ния; Схема электри- ческая; Схема монтажа; Шифр; Назначение; Значение; номиналь- ное; Клапан ПЗК-2 на горелке №5; Клапан ПЗК-2 на горелке №7; Клапан СБ на горелке №1; Клапан СБ на горелке №3; Клапан СБ на горелке №5; Клапан СБ на горелке №7; Клапан запальника горелки №3; Клапан ПЗК-1 на горелке №2; Клапан ПЗК-1 на горелке №4; Клапан ПЗК-1 на горелке №6; Клапан ПЗК-1 на горелке №8; Клапан ПЗК-2 на горелке №2; Клапан ПЗК-2 на горелке №4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

Инв. № подп. Подп. и дата Взамен инв. №

Балаковская ТЭЦ-4 филиала «Саратовский» ПАО «Т Плюс»

Изм. | Кол.уч. | Лист | № док. | Подп. | Дата

Модернизация оборудования КИПиА водогрейного котла ПТВМ-180 ст.№4 | Стадия | Лист | Листов

Ведомость элементов функциональной схемы (3/5) | ООО НПП "ЭСН"

Шифр | Назначение | Значение номиналь-

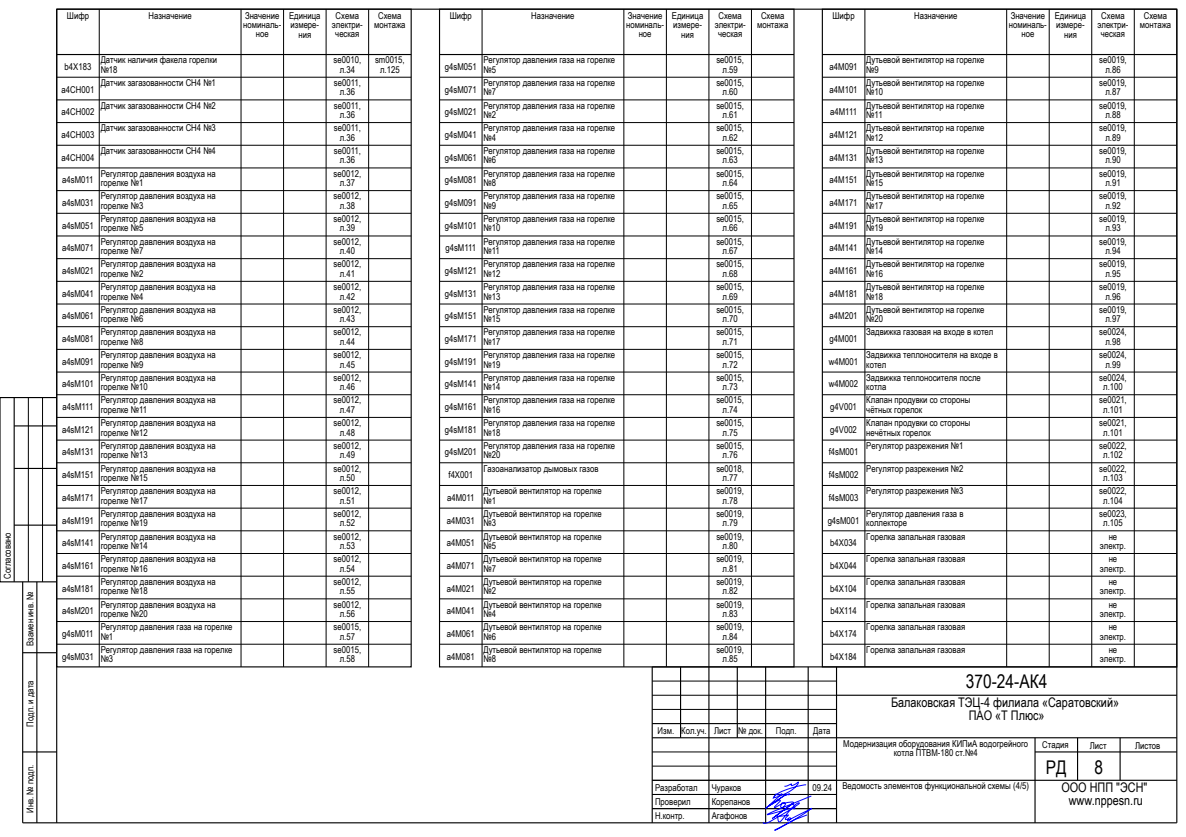
[picture p252: page 4]
Согласовано; ное; Единица измере- ния; Схема электри- ческая; Схема монтажа; Шифр; Назначение; Значение; номиналь- ное; Датчик наличия факела горелки; Датчик загазованности СН4 №1; Датчик загазованности СН4 №2; Датчик загазованности СН4 №3; Датчик загазованности СН4 №4; Регулятор давления воздуха на; горелке №1; горелке №3; горелке №5; горелке №7; горелке №2; горелке №4; горелке №6; горелке №8; горелке №9; горелке №10; горелке №11; горелке №12; горелке №13; горелке №15; горелке №17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

Инв. № подп. Подп. и дата Взамен инв. №

Балаковская ТЭЦ-4 филиала «Саратовский» ПАО «Т Плюс»

Изм. | Кол.уч. | Лист | № док. | Подп. | Дата

Модернизация оборудования КИПиА водогрейного котла ПТВМ-180 ст.№4 | Стадия | Лист | Листов

Ведомость элементов функциональной схемы (4/5) | ООО НПП "ЭСН"

Шифр | Назначение | Значение номиналь-

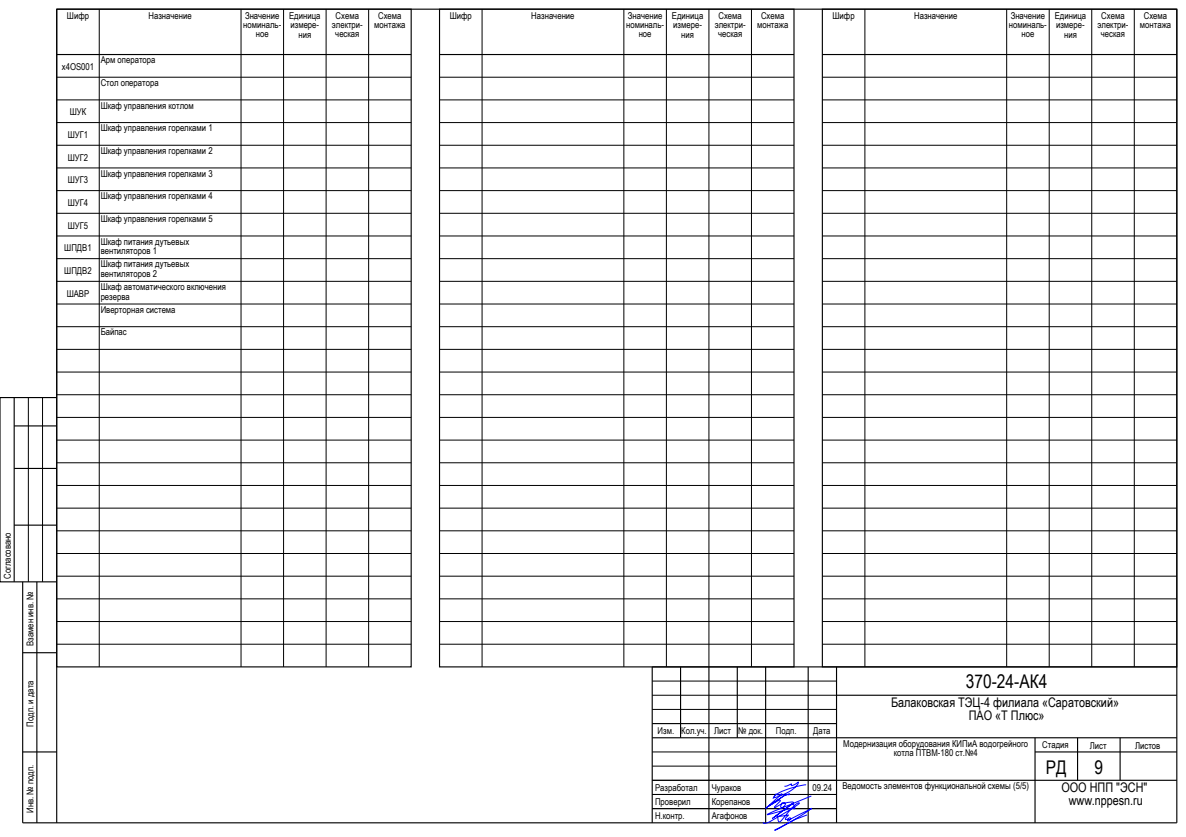
[picture p253: page 5]
Согласовано; ное; Единица измере- ния; Схема электри- ческая; Схема монтажа; Шифр; Назначение; Значение; номиналь- ное; Арм оператора; Стол оператора; ШУК; Шкаф управления котлом; ШУГ1; Шкаф управления горелками 1; ШУГ2; Шкаф управления горелками 2; ШУГ3; Шкаф управления горелками 3; ШУГ4; Шкаф управления горелками 4; ШУГ5; Шкаф управления горелками 5; ШПДВ1; Шкаф питания дутьевых; вентиляторов 1; ШПДВ2; вентиляторов 2; ШАВР; Шкаф автоматического включения; резерва Иверторная система; Байпас

Инв. № подп. Подп. и дата Взамен инв. №

Балаковская ТЭЦ-4 филиала «Саратовский» ПАО «Т Плюс»

Изм. | Кол.уч. | Лист | № док. | Подп. | Дата

Модернизация оборудования КИПиА водогрейного котла ПТВМ-180 ст.№4 | Стадия | Лист | Листов

Ведомость элементов функциональной схемы (5/5) | ООО НПП "ЭСН"

## Клеммник шкафа

## Шина PE

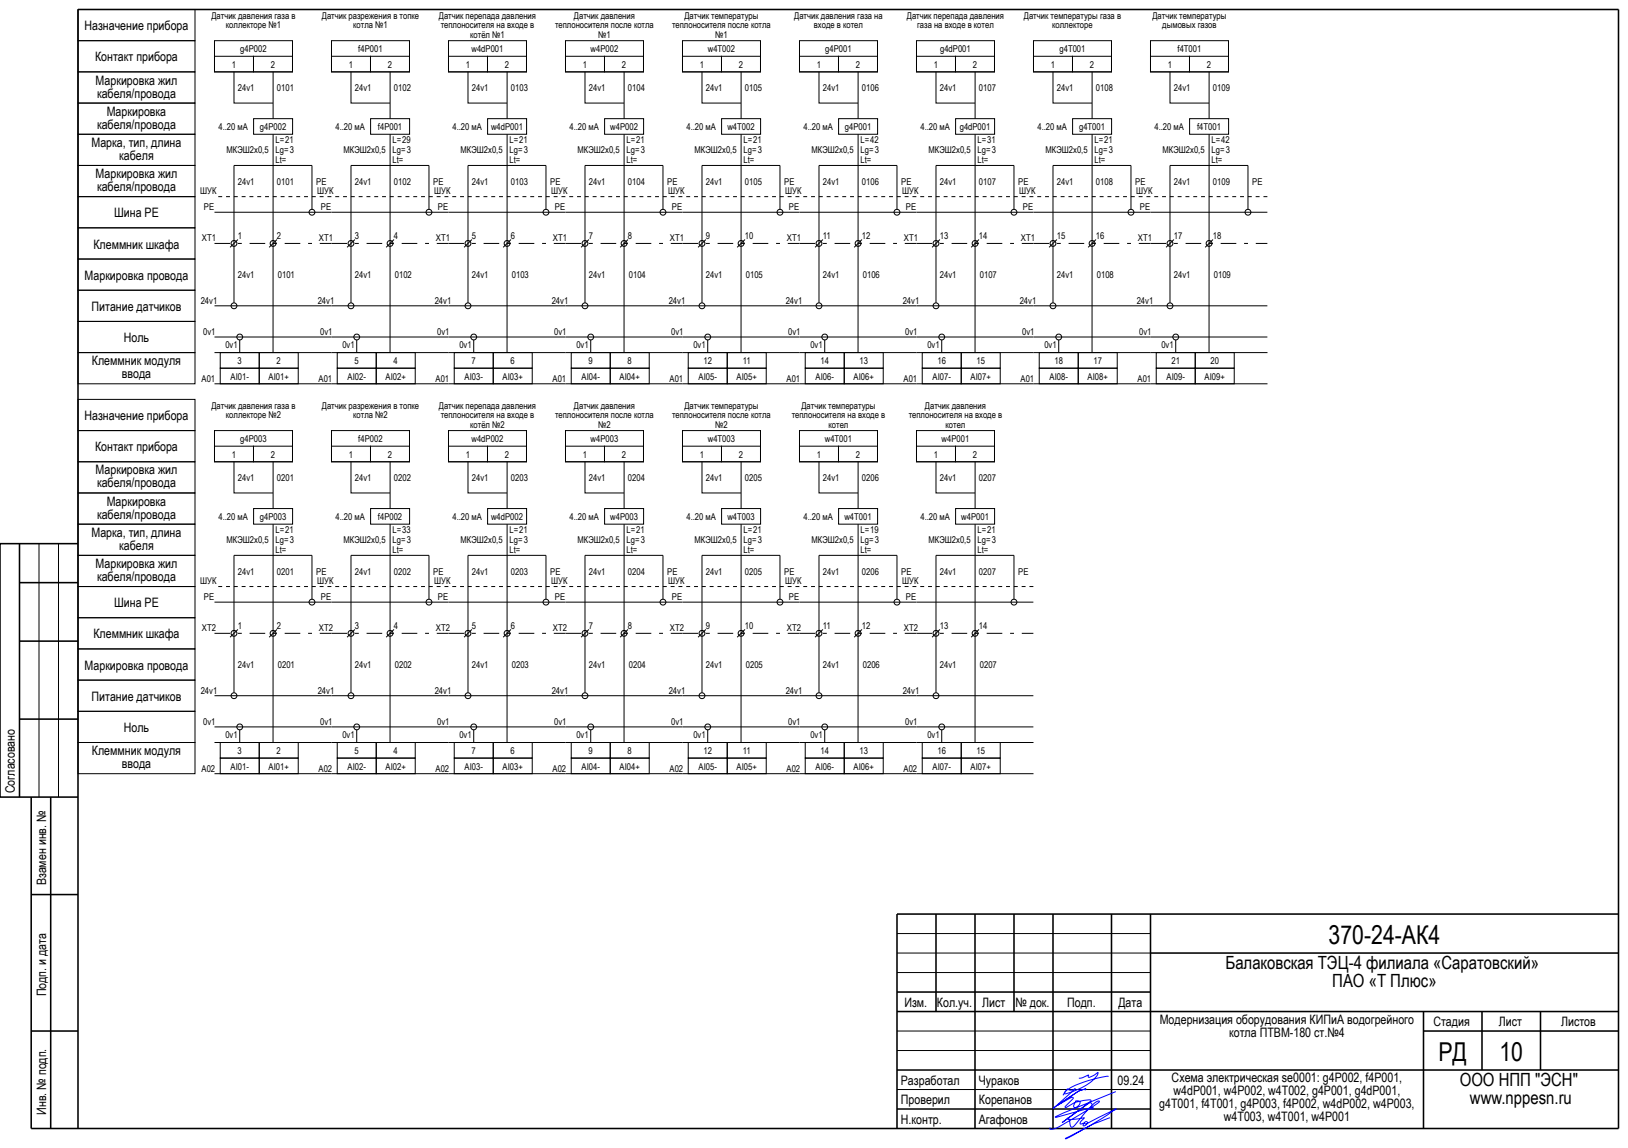
[picture p254: page 6]
Согласовано; Ноль; Питание датчиков; Маркировка жил кабеля/провода; Клеммник модуля ввода; Маркировка провода; ШУК; Клеммник шкафа; Шина PE; кабеля/провода; кабеля; Назначение прибора; МКЭШ2х0,5; Датчик температуры дымовых газов; котел

Датчик давления газа в
коллекторе №1

Датчик разрежения в топке
котла №1

Датчик перепада давления
теплоносителя на входе в
котёл №1

Датчик давления
теплоносителя после котла

Датчик температуры

Датчик давления газа на
входе в котел

газа на входе в котел

Датчик температуры газа в
коллекторе

Контакт прибора
Маркировка жил
кабеля/провода
Маркировка
Марка, тип, длина

коллекторе №2

котла №2

котёл №2

кабеля

Инв. № подп. Подп. и дата Взамен инв. №

Балаковская ТЭЦ-4 филиала «Саратовский» ПАО «Т Плюс»

Изм. | Кол.уч. | Лист | № док. | Подп. | Дата

Модернизация оборудования КИПиА водогрейного котла ПТВМ-180 ст.№4 | Стадия | Лист | Листов

Схема электрическая se0001: g4P002, f4P001, w4dP001, w4P002, w4T002, g4P001, g4dP001, g4T001, f4T001, g4P003, f4P002, w4dP002, w4P003, w4T003, w4T001, w4P001 | ООО НПП "ЭСН"

## Клеммник шкафа

## Шина PE

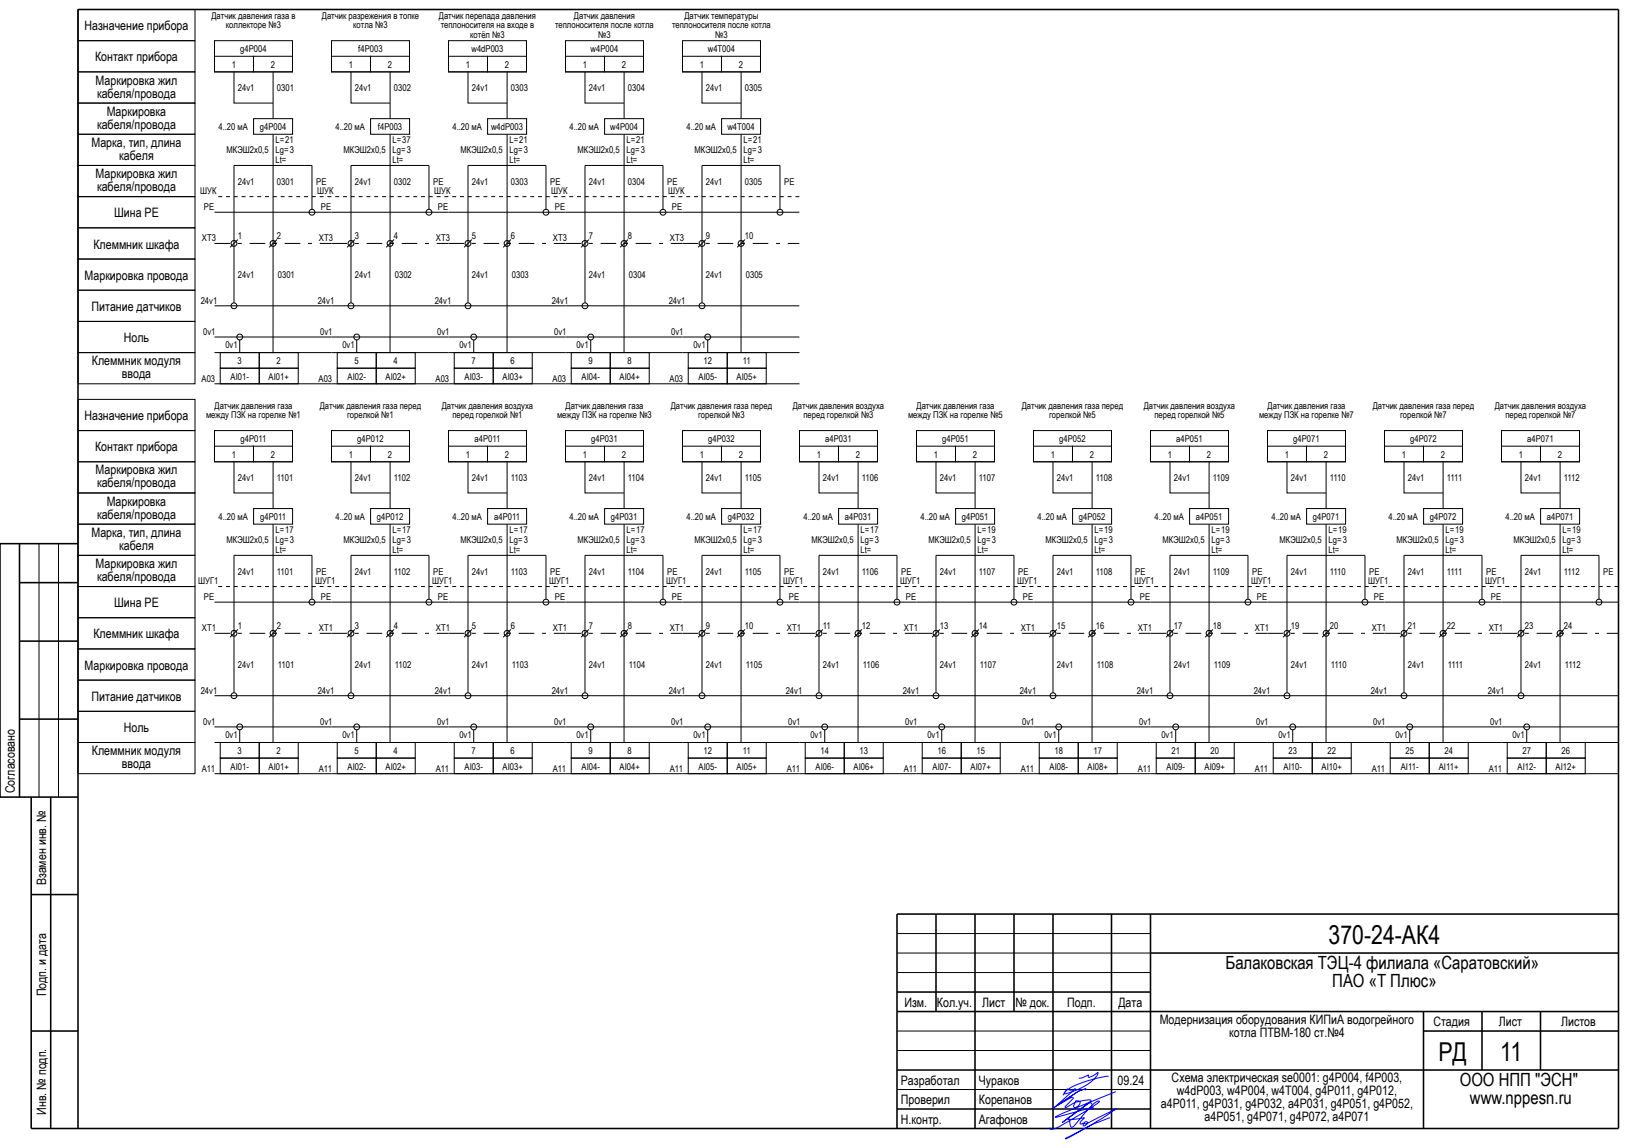
[picture p255: page 7]
Согласовано; Ноль; Питание датчиков; кабеля/провода; Клеммник модуля ввода; Маркировка провода; ШУК; Клеммник шкафа; Шина PE; ШУГ1; МКЭШ2х0,5; Маркировка кабеля/провода; Контакт прибора; Маркировка жил кабеля/провода; Назначение прибора

Датчик давления газа в
коллекторе №3

Датчик разрежения в топке
котла №3

Датчик перепада давления
теплоносителя на входе в
котёл №3

Датчик давления
теплоносителя после котла

Датчик температуры

Контакт прибора
Маркировка жил
кабеля/провода
Маркировка
Марка, тип, длина
кабеля

Датчик давления газа
между ПЗК на горелке №1

Датчик давления газа перед
горелкой №1

Датчик давления воздуха
перед горелкой №1

между ПЗК на горелке №3

горелкой №3

перед горелкой №3

между ПЗК на горелке №5

горелкой №5

перед горелкой №5

между ПЗК на горелке №7

горелкой №7

перед горелкой №7

Инв. № подп. Подп. и дата Взамен инв. №

Балаковская ТЭЦ-4 филиала «Саратовский» ПАО «Т Плюс»

Изм. | Кол.уч. | Лист | № док. | Подп. | Дата

Модернизация оборудования КИПиА водогрейного котла ПТВМ-180 ст.№4 | Стадия | Лист | Листов

Схема электрическая se0001: g4P004, f4P003, w4dP003, w4P004, w4T004, g4P011, g4P012, a4P011, g4P031, g4P032, a4P031, g4P051, g4P052, a4P051, g4P071, g4P072, a4P071 | ООО НПП "ЭСН"

## Клеммник шкафа

## Шина PE

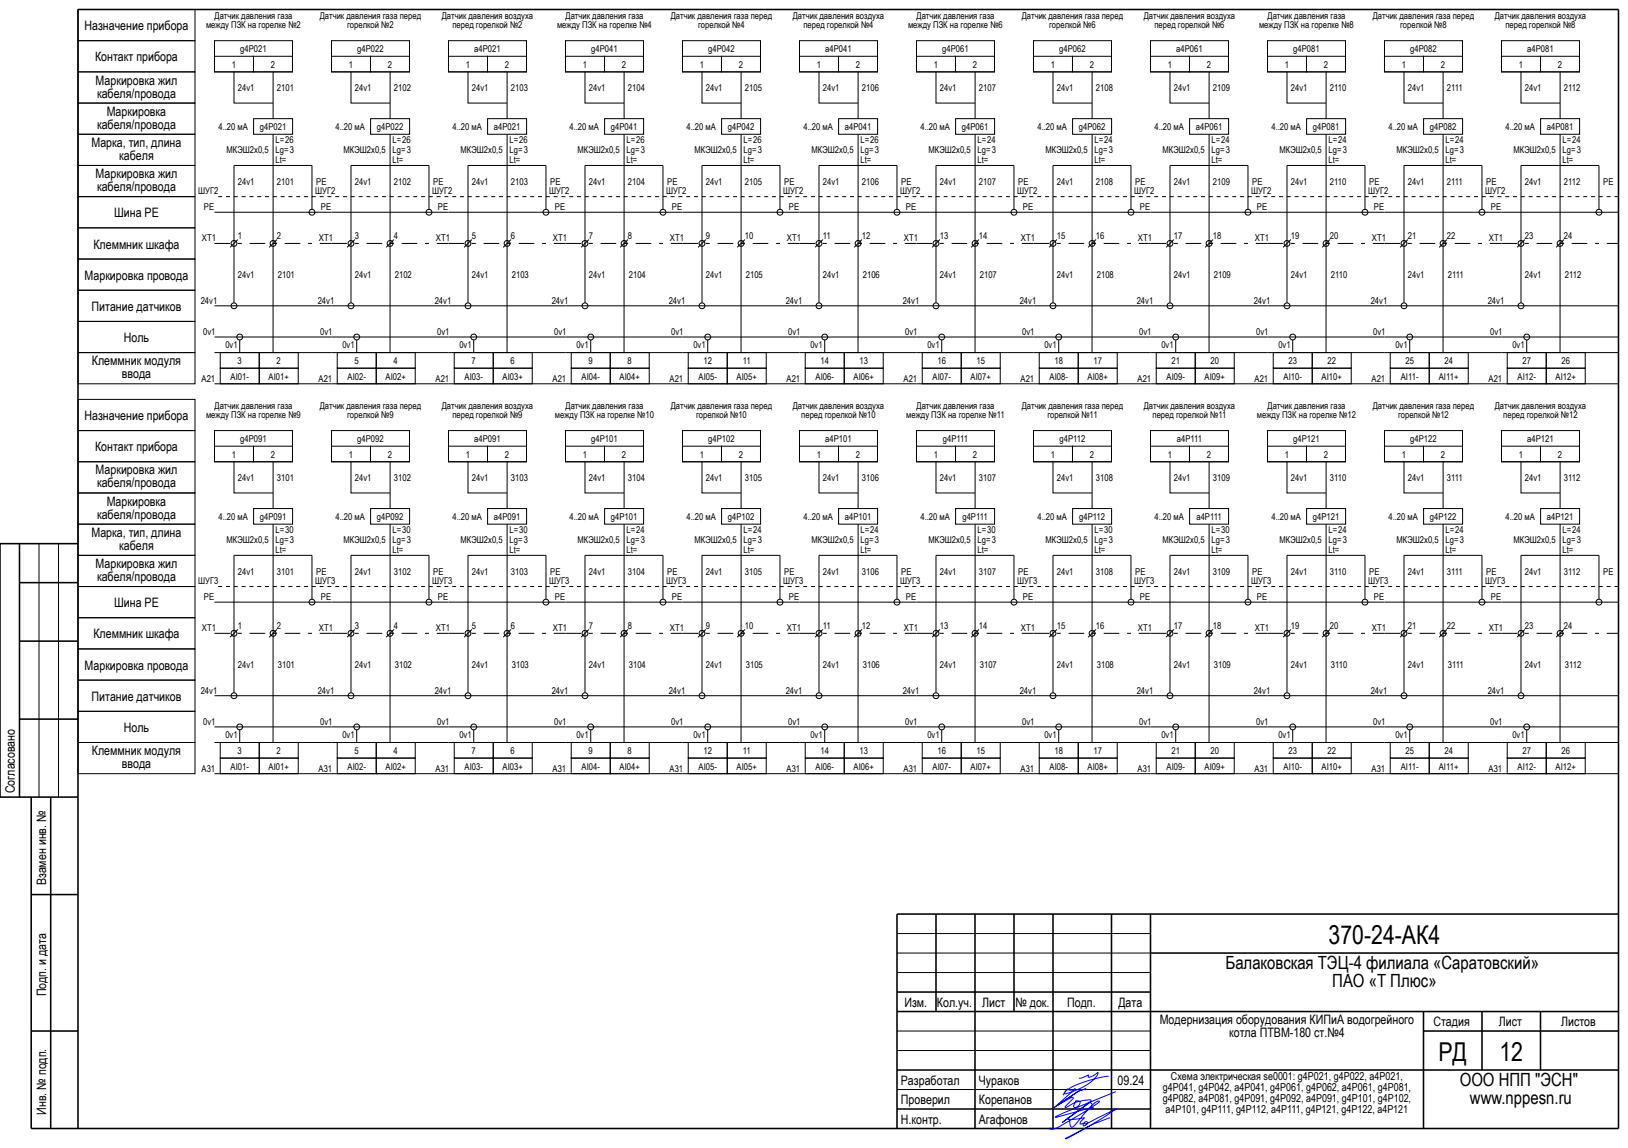
[picture p256: page 8]
Согласовано; Ноль; Питание датчиков; кабеля/провода; Клеммник модуля ввода; Маркировка провода; ШУГ2; Клеммник шкафа; Шина PE; ШУГ3; Маркировка кабеля/провода; Контакт прибора; Маркировка жил кабеля/провода; МКЭШ2х0,5; Назначение прибора

Датчик давления газа
между ПЗК на горелке №2

Датчик давления газа перед
горелкой №2

Датчик давления воздуха
перед горелкой №2

между ПЗК на горелке №4

горелкой №4

перед горелкой №4

между ПЗК на горелке №6

горелкой №6

перед горелкой №6

между ПЗК на горелке №8

горелкой №8

перед горелкой №8

Марка, тип, длина
кабеля
Маркировка жил

между ПЗК на горелке №9

горелкой №9

перед горелкой №9

между ПЗК на горелке №10

горелкой №10

перед горелкой №10

между ПЗК на горелке №11

горелкой №11

перед горелкой №11

между ПЗК на горелке №12

горелкой №12

перед горелкой №12

Инв. № подп. Подп. и дата Взамен инв. №

Балаковская ТЭЦ-4 филиала «Саратовский» ПАО «Т Плюс»

Изм. | Кол.уч. | Лист | № док. | Подп. | Дата

Модернизация оборудования КИПиА водогрейного котла ПТВМ-180 ст.№4 | Стадия | Лист | Листов

Схема электрическая se0001: g4P021, g4P022, a4P021, g4P041, g4P042, a4P041, g4P061, g4P062, a4P061, g4P081, g4P082, a4P081, g4P091, g4P092, a4P091, g4P101, g4P102, a4P101, g4P111, g4P112, a4P111, g4P121, g4P122, a4P121 | ООО НПП "ЭСН"

## Клеммник шкафа

## Шина PE

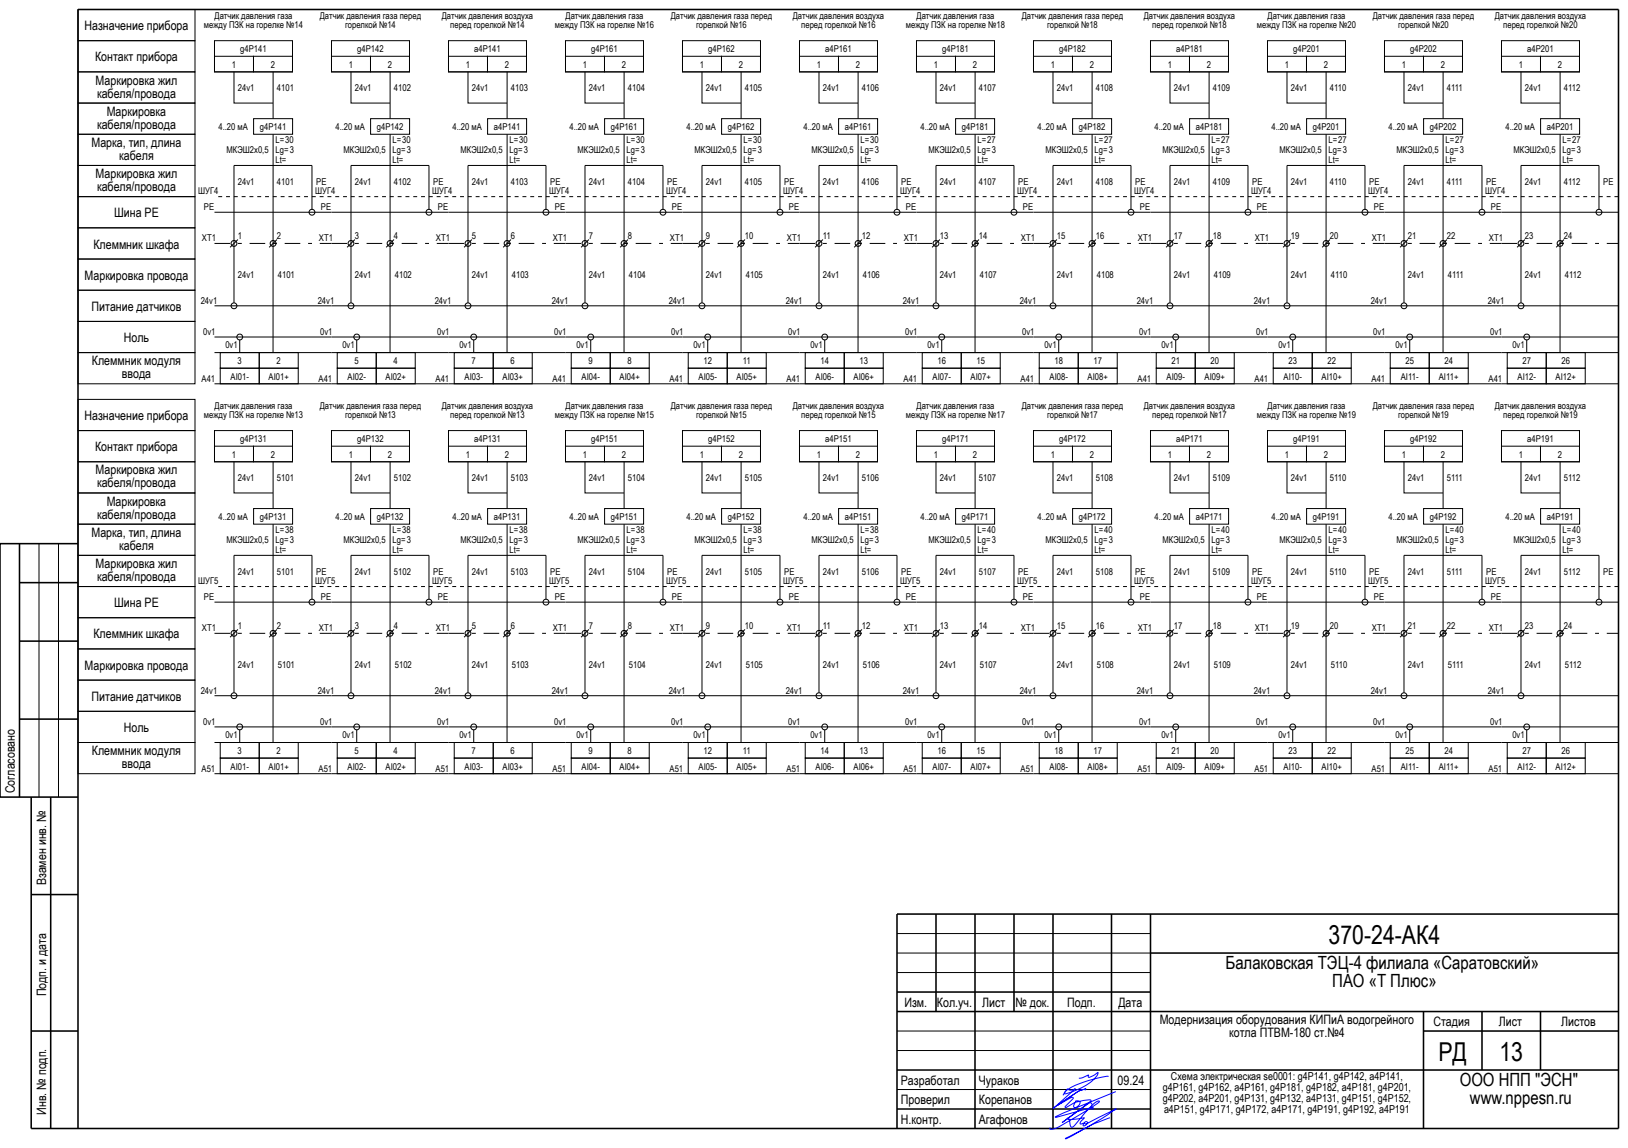
[picture p257: page 9]
Согласовано; Ноль; Питание датчиков; кабеля/провода; Клеммник модуля ввода; Маркировка провода; ШУГ4; Клеммник шкафа; Шина PE; ШУГ5; Маркировка кабеля/провода; Контакт прибора; Маркировка жил кабеля/провода; МКЭШ2х0,5; Назначение прибора

Датчик давления газа
между ПЗК на горелке №14

Датчик давления газа перед
горелкой №14

Датчик давления воздуха
перед горелкой №14

между ПЗК на горелке №16

горелкой №16

перед горелкой №16

между ПЗК на горелке №18

горелкой №18

перед горелкой №18

между ПЗК на горелке №20

горелкой №20

перед горелкой №20

Марка, тип, длина
кабеля
Маркировка жил

между ПЗК на горелке №13

горелкой №13

перед горелкой №13

между ПЗК на горелке №15

горелкой №15

перед горелкой №15

между ПЗК на горелке №17

горелкой №17

перед горелкой №17

между ПЗК на горелке №19

горелкой №19

перед горелкой №19

Инв. № подп. Подп. и дата Взамен инв. №

Балаковская ТЭЦ-4 филиала «Саратовский» ПАО «Т Плюс»

Изм. | Кол.уч. | Лист | № док. | Подп. | Дата

Модернизация оборудования КИПиА водогрейного котла ПТВМ-180 ст.№4 | Стадия | Лист | Листов

Схема электрическая se0001: g4P141, g4P142, a4P141, g4P161, g4P162, a4P161, g4P181, g4P182, a4P181, g4P201, g4P202, a4P201, g4P131, g4P132, a4P131, g4P151, g4P152, a4P151, g4P171, g4P172, a4P171, g4P191, g4P192, a4P191 | ООО НПП "ЭСН"

## Клеммник шкафа

## Шина PE

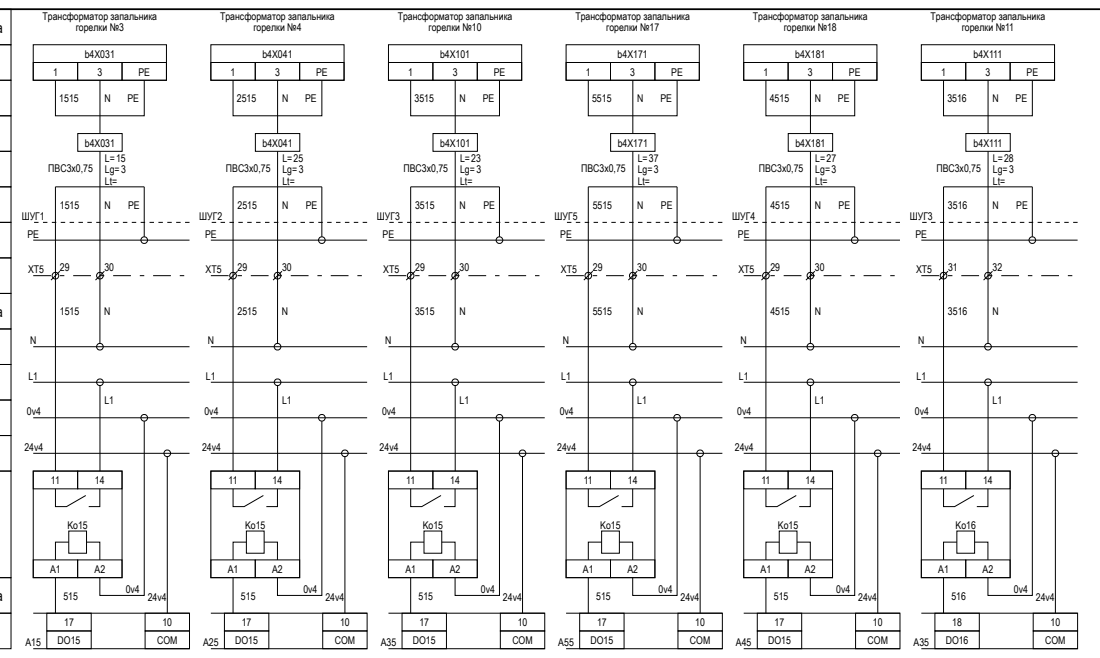
[picture p258: page 10]
Согласовано; кабеля/провода; Клеммник модуля ввода/вывода; Маркировка провода; Питание 220В; Реле; Ноль 220В; Ноль 24В; Питание 24В; ШУГ1; 10 COM; ШУГ2; ШУГ3; ШУГ5; ШУГ4; Трансформатор запальника горелки №3; ПВС3х0,75; Трансформатор запальника горелки №4; Трансформатор запальника горелки №10; Трансформатор запальника горелки №17; Трансформатор запальника горелки №18; Трансформатор запальника горелки №11

Контакт прибора
Маркировка жил
кабеля/провода
Маркировка
Марка, тип, длина
кабеля

Инв. № подп. Подп. и дата Взамен инв. №

Балаковская ТЭЦ-4 филиала «Саратовский» ПАО «Т Плюс»

Изм. | Кол.уч. | Лист | № док. | Подп. | Дата

Модернизация оборудования КИПиА водогрейного котла ПТВМ-180 ст.№4 | Стадия | Лист | Листов

Схема электрическая se0002: b4X031, b4X041, b4X101, b4X171, b4X181, b4X111 | ООО НПП "ЭСН"

## Клеммник шкафа

## Шина PE

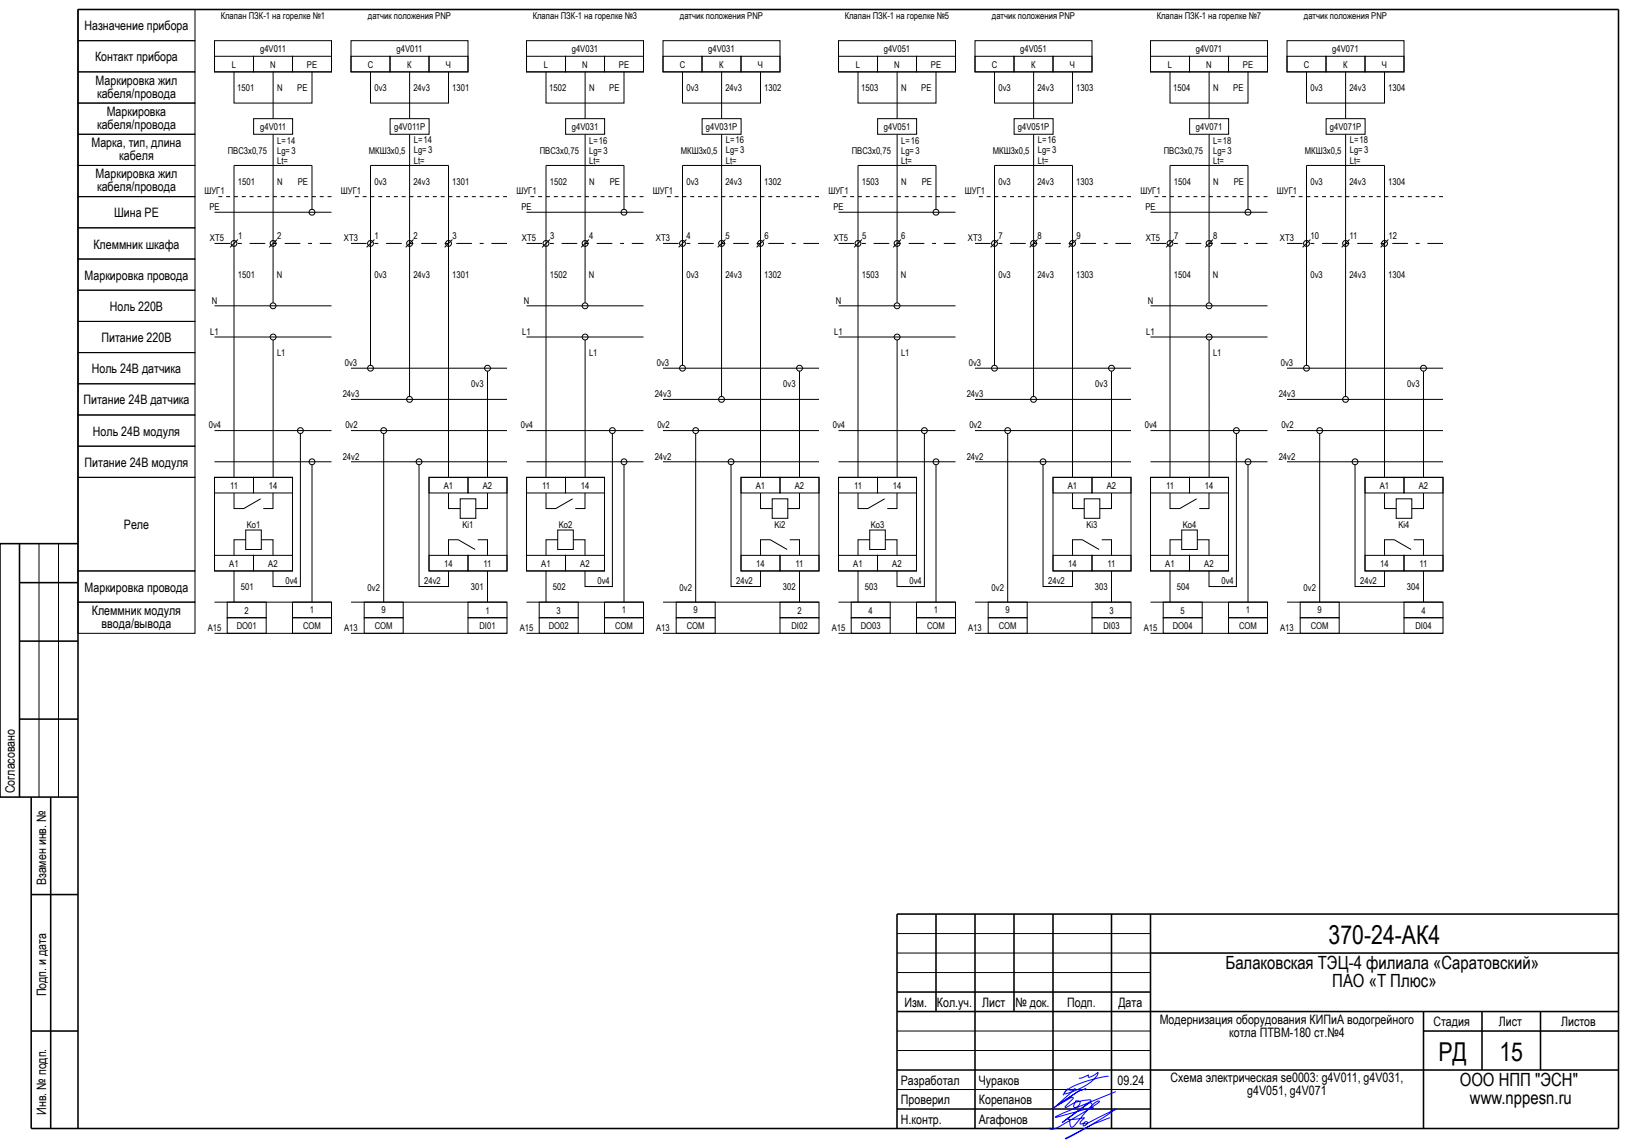
[picture p259: page 11]
Согласовано; кабеля/провода; Клеммник модуля ввода/вывода; Маркировка провода; Питание 220В; Реле; Ноль 220В; Питание 24В датчика; Ноль 24В датчика; Питание 24В модуля; Ноль 24В модуля; ШУГ1; COM; 1 COM; МКШ3х0,5; ПВС3х0,75

Клапан ПЗК-1 на горелке №1

датчик положения PNP

Клапан ПЗК-1 на горелке №3

Клапан ПЗК-1 на горелке №5

Клапан ПЗК-1 на горелке №7

Контакт прибора
Маркировка жил
кабеля/провода
Маркировка
Марка, тип, длина
кабеля

Инв. № подп. Подп. и дата Взамен инв. №

Балаковская ТЭЦ-4 филиала «Саратовский» ПАО «Т Плюс»

Изм. | Кол.уч. | Лист | № док. | Подп. | Дата

Модернизация оборудования КИПиА водогрейного котла ПТВМ-180 ст.№4 | Стадия | Лист | Листов

Схема электрическая se0003: g4V011, g4V031, g4V051, g4V071 | ООО НПП "ЭСН"

## Клеммник шкафа

## Шина PE

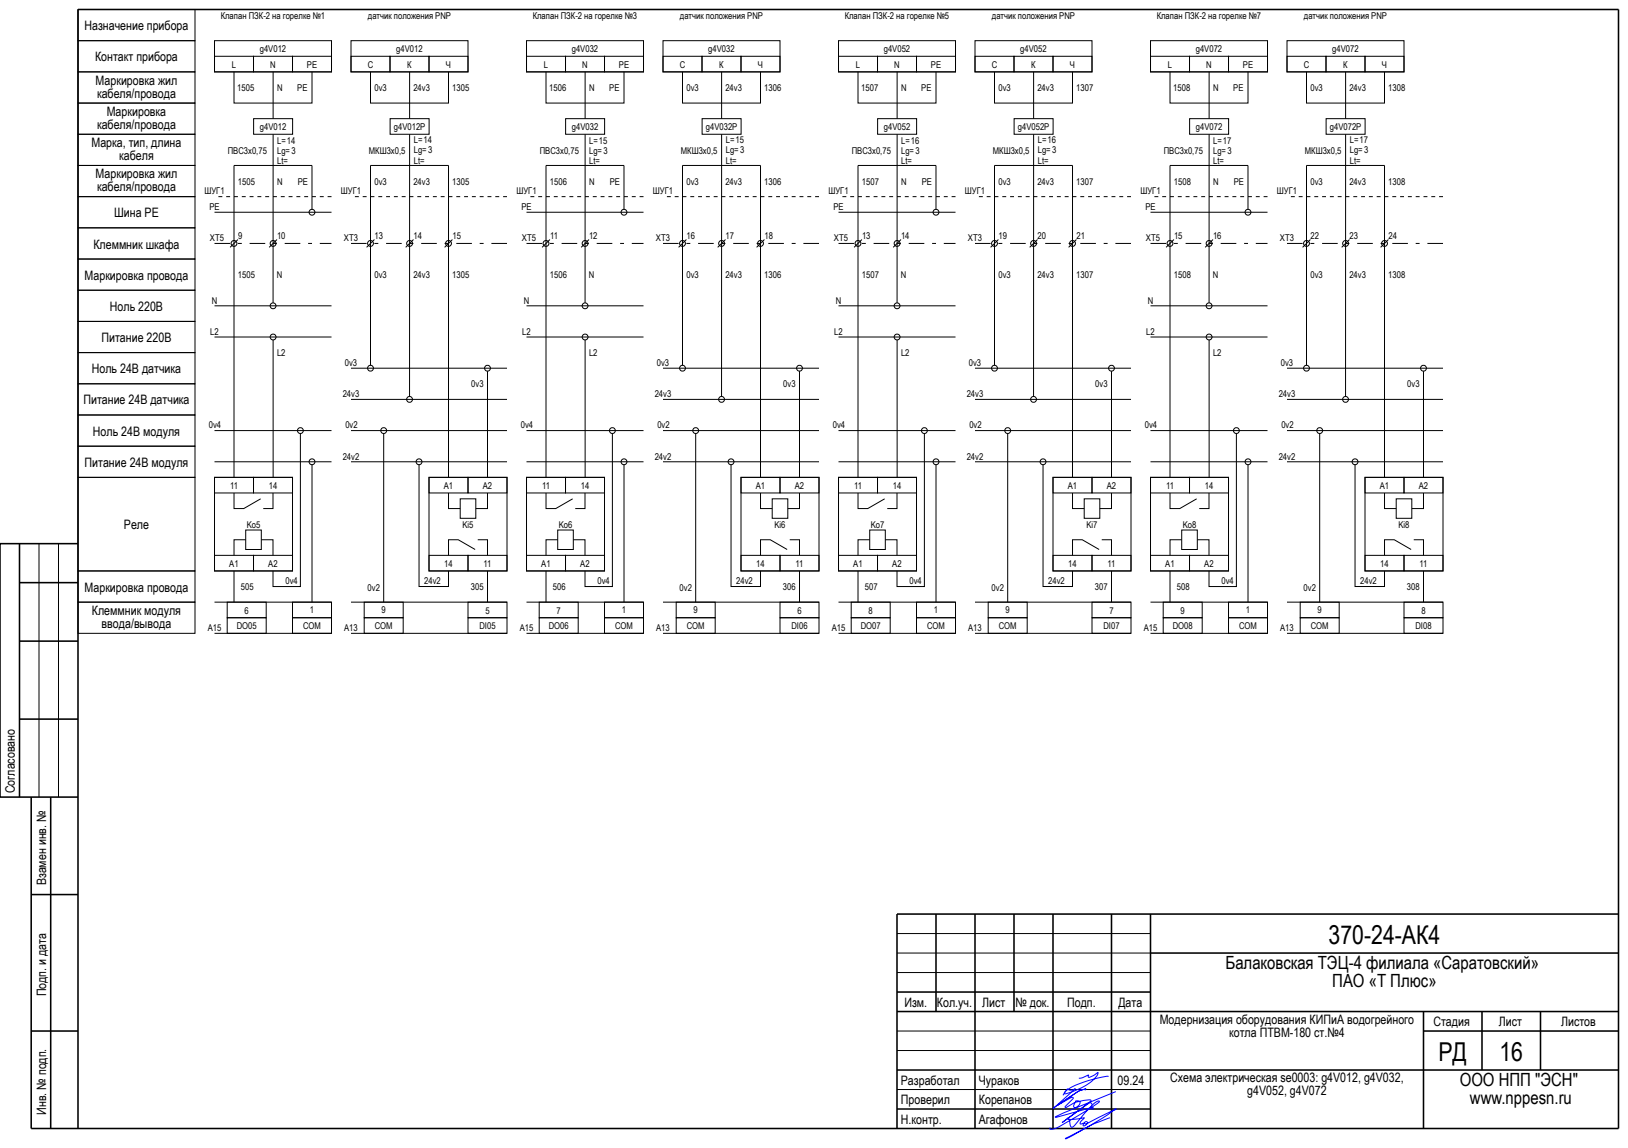
[picture p260: page 12]
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

Клапан ПЗК-2 на горелке №1

датчик положения PNP

Клапан ПЗК-2 на горелке №3

Клапан ПЗК-2 на горелке №5

Клапан ПЗК-2 на горелке №7

Контакт прибора
Маркировка жил
кабеля/провода
Маркировка
Марка, тип, длина
кабеля

Инв. № подп. Подп. и дата Взамен инв. №

Балаковская ТЭЦ-4 филиала «Саратовский» ПАО «Т Плюс»

Изм. | Кол.уч. | Лист | № док. | Подп. | Дата

Модернизация оборудования КИПиА водогрейного котла ПТВМ-180 ст.№4 | Стадия | Лист | Листов

Схема электрическая se0003: g4V012, g4V032, g4V052, g4V072 | ООО НПП "ЭСН"

## Клеммник шкафа

## Шина PE

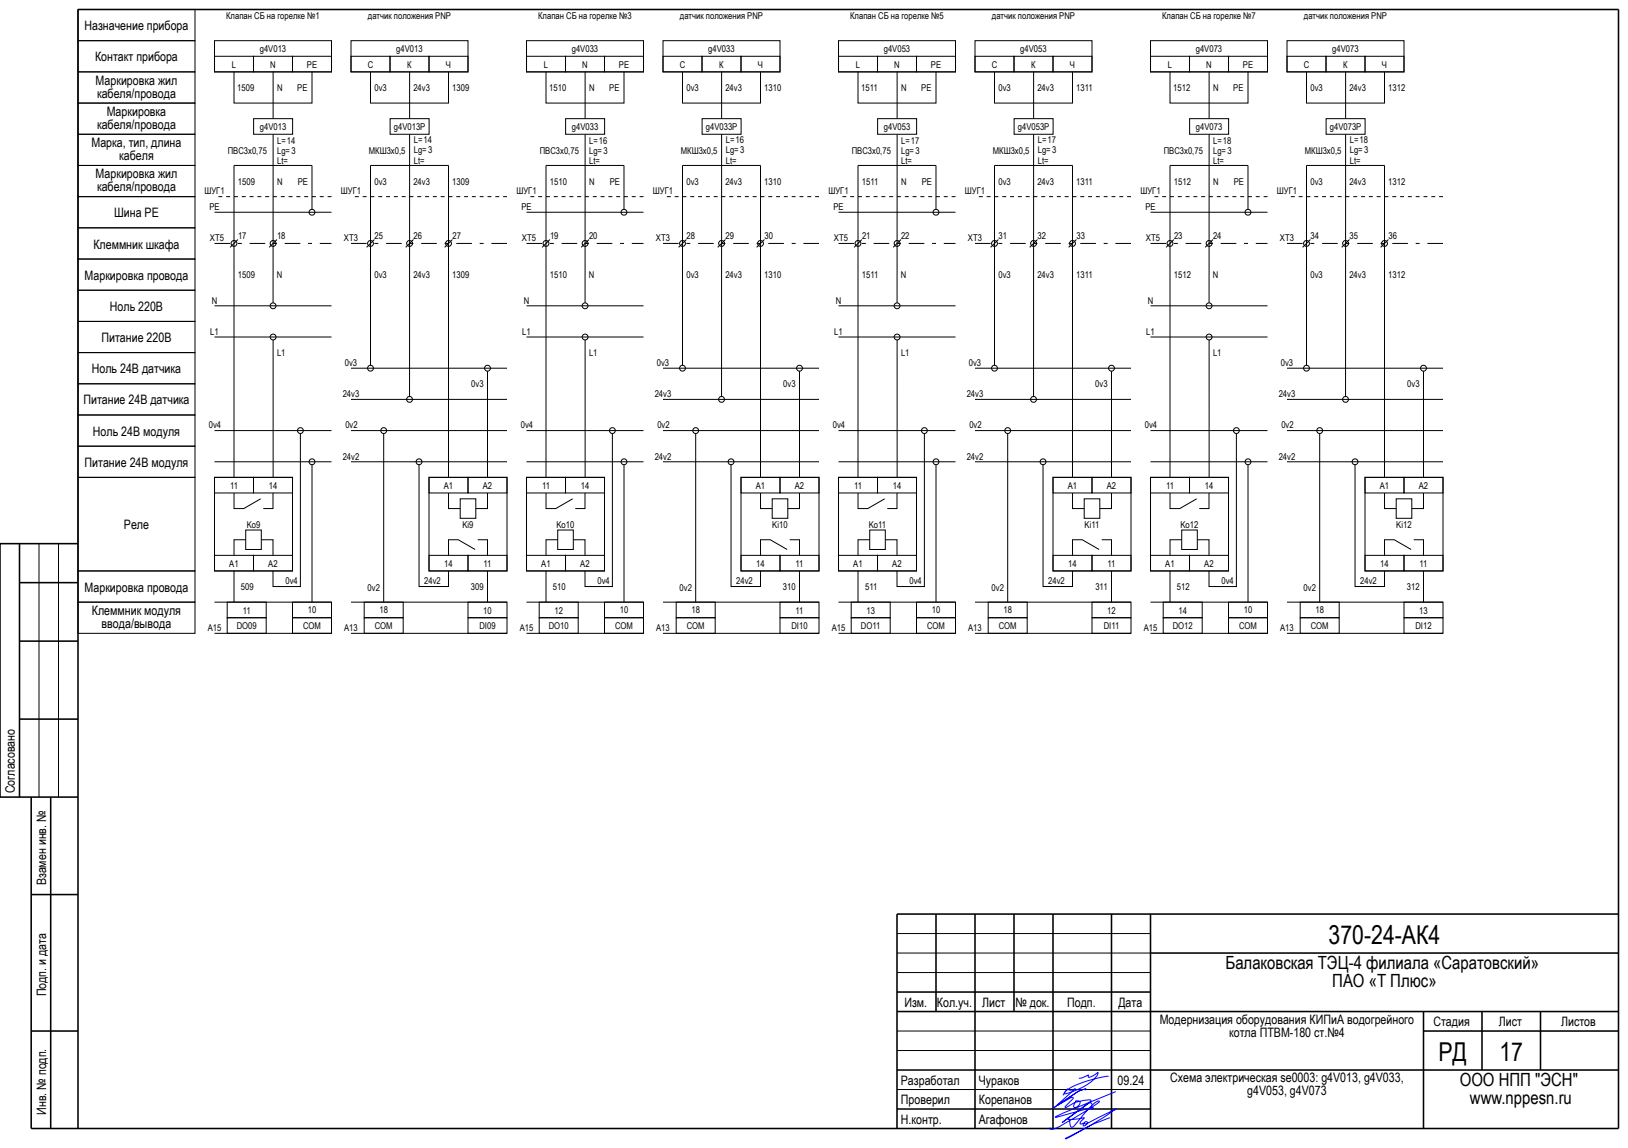
[picture p261: page 13]
Согласовано; кабеля/провода; Клеммник модуля ввода/вывода; Маркировка провода; Питание 220В; Реле; Ноль 220В; Питание 24В датчика; Ноль 24В датчика; Питание 24В модуля; Ноль 24В модуля; ШУГ1; COM; 10 COM; МКШ3х0,5; ПВС3х0,75

Клапан СБ на горелке №1

датчик положения PNP

Клапан СБ на горелке №3

Клапан СБ на горелке №5

Клапан СБ на горелке №7

Контакт прибора
Маркировка жил
кабеля/провода
Маркировка
Марка, тип, длина
кабеля

Инв. № подп. Подп. и дата Взамен инв. №

Балаковская ТЭЦ-4 филиала «Саратовский» ПАО «Т Плюс»

Изм. | Кол.уч. | Лист | № док. | Подп. | Дата

Модернизация оборудования КИПиА водогрейного котла ПТВМ-180 ст.№4 | Стадия | Лист | Листов

Схема электрическая se0003: g4V013, g4V033, g4V053, g4V073 | ООО НПП "ЭСН"

## Клеммник шкафа

## Шина PE

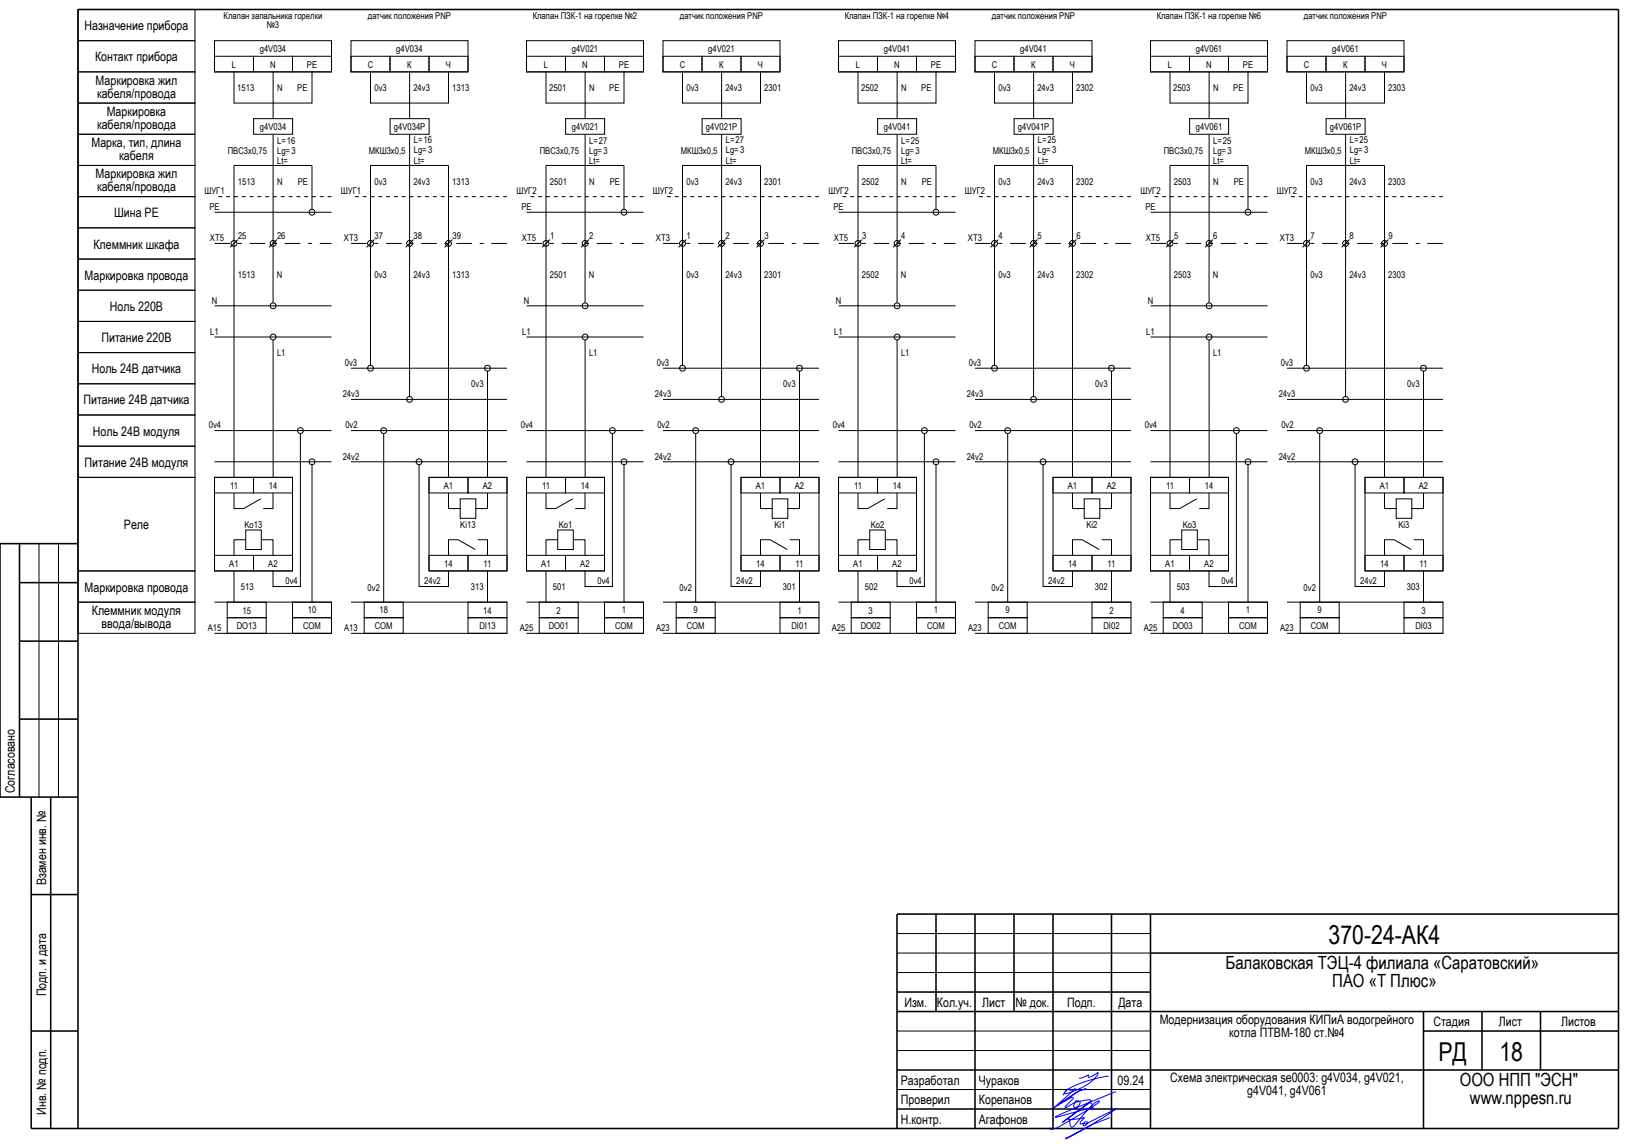
[picture p262: page 14]
Согласовано; кабеля/провода; Клеммник модуля ввода/вывода; Маркировка провода; Питание 220В; Реле; Ноль 220В; Питание 24В датчика; Ноль 24В датчика; Питание 24В модуля; Ноль 24В модуля; ШУГ1; COM; 10 COM; ШУГ2; 1 COM; МКШ3х0,5; ПВС3х0,75

Клапан запальника горелки

датчик положения PNP

Клапан ПЗК-1 на горелке №2

Клапан ПЗК-1 на горелке №4

Клапан ПЗК-1 на горелке №6

Контакт прибора
Маркировка жил
кабеля/провода
Маркировка
Марка, тип, длина
кабеля

Инв. № подп. Подп. и дата Взамен инв. №

Балаковская ТЭЦ-4 филиала «Саратовский» ПАО «Т Плюс»

Изм. | Кол.уч. | Лист | № док. | Подп. | Дата

Модернизация оборудования КИПиА водогрейного котла ПТВМ-180 ст.№4 | Стадия | Лист | Листов

Схема электрическая se0003: g4V034, g4V021, g4V041, g4V061 | ООО НПП "ЭСН"

## Клеммник шкафа

## Шина PE

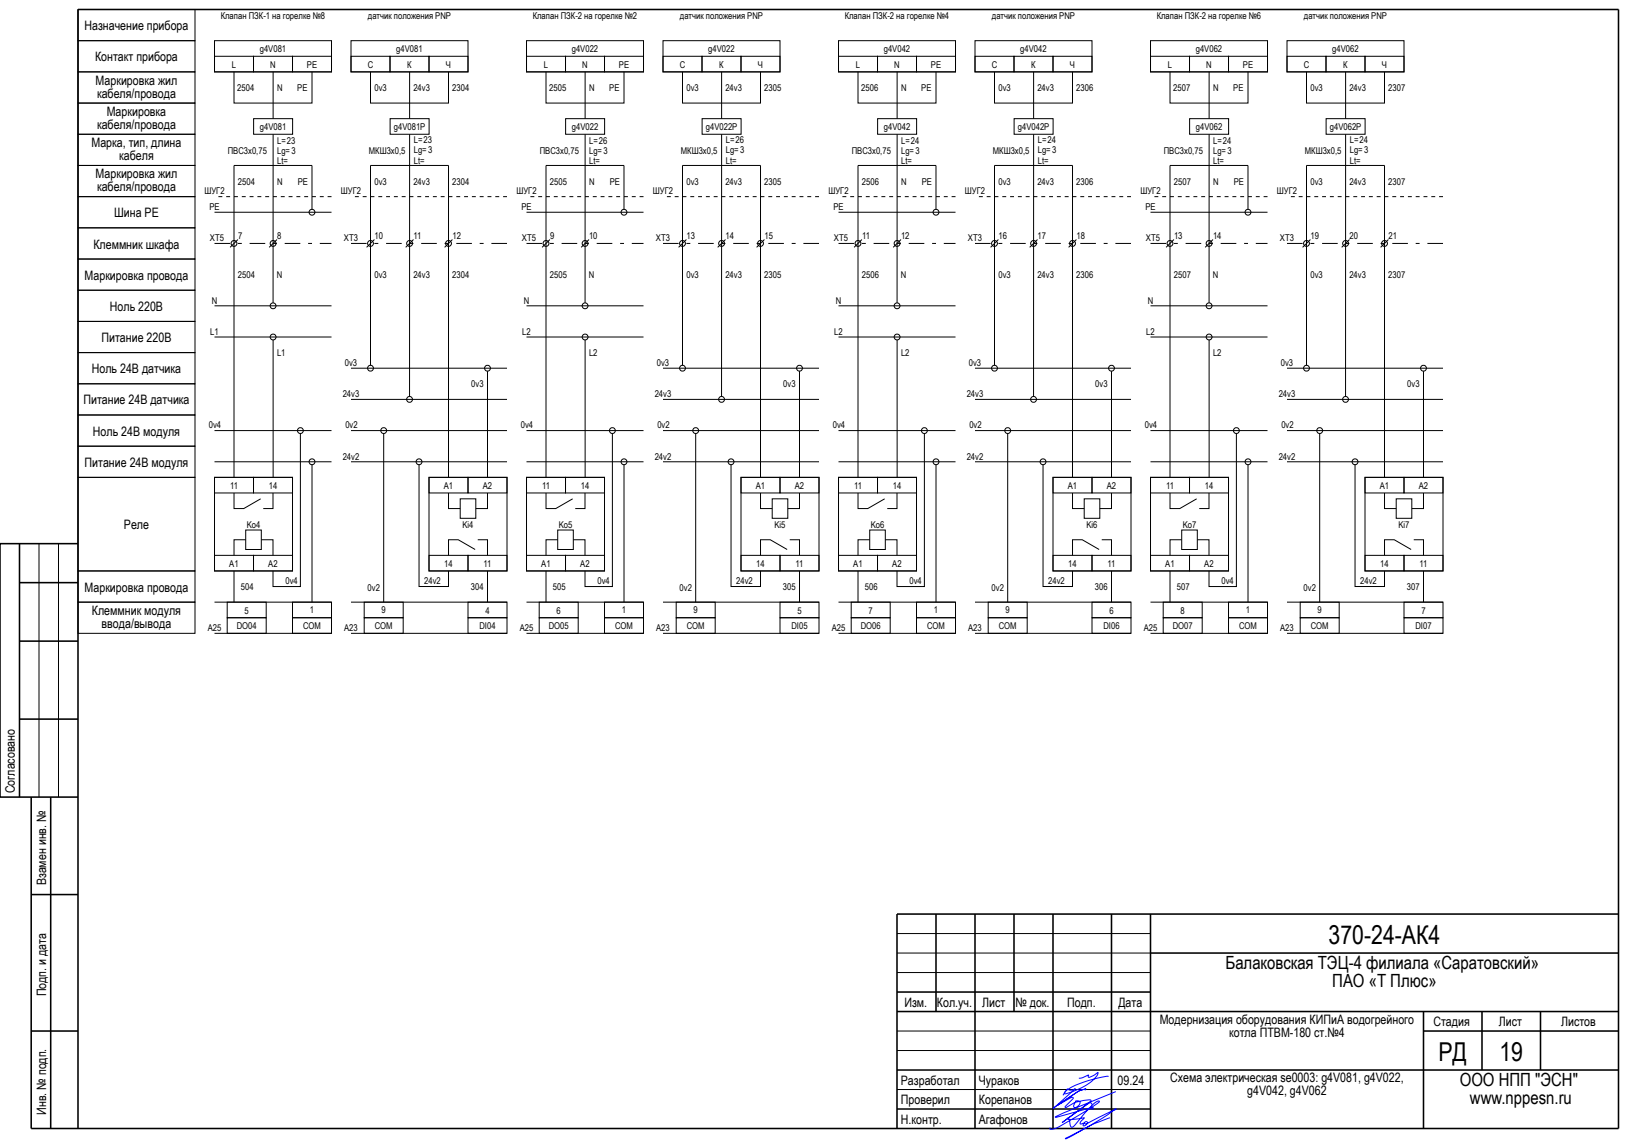
[picture p263: page 15]
Согласовано; кабеля/провода; Клеммник модуля ввода/вывода; Маркировка провода; Питание 220В; Реле; Ноль 220В; Питание 24В датчика; Ноль 24В датчика; Питание 24В модуля; Ноль 24В модуля; ШУГ2; COM; 1 COM; МКШ3х0,5; ПВС3х0,75

Клапан ПЗК-1 на горелке №8

датчик положения PNP

Клапан ПЗК-2 на горелке №2

Клапан ПЗК-2 на горелке №4

Клапан ПЗК-2 на горелке №6

Контакт прибора
Маркировка жил
кабеля/провода
Маркировка
Марка, тип, длина
кабеля

Инв. № подп. Подп. и дата Взамен инв. №

Балаковская ТЭЦ-4 филиала «Саратовский» ПАО «Т Плюс»

Изм. | Кол.уч. | Лист | № док. | Подп. | Дата

Модернизация оборудования КИПиА водогрейного котла ПТВМ-180 ст.№4 | Стадия | Лист | Листов

Схема электрическая se0003: g4V081, g4V022, g4V042, g4V062 | ООО НПП "ЭСН"

## Клеммник шкафа

## Шина PE

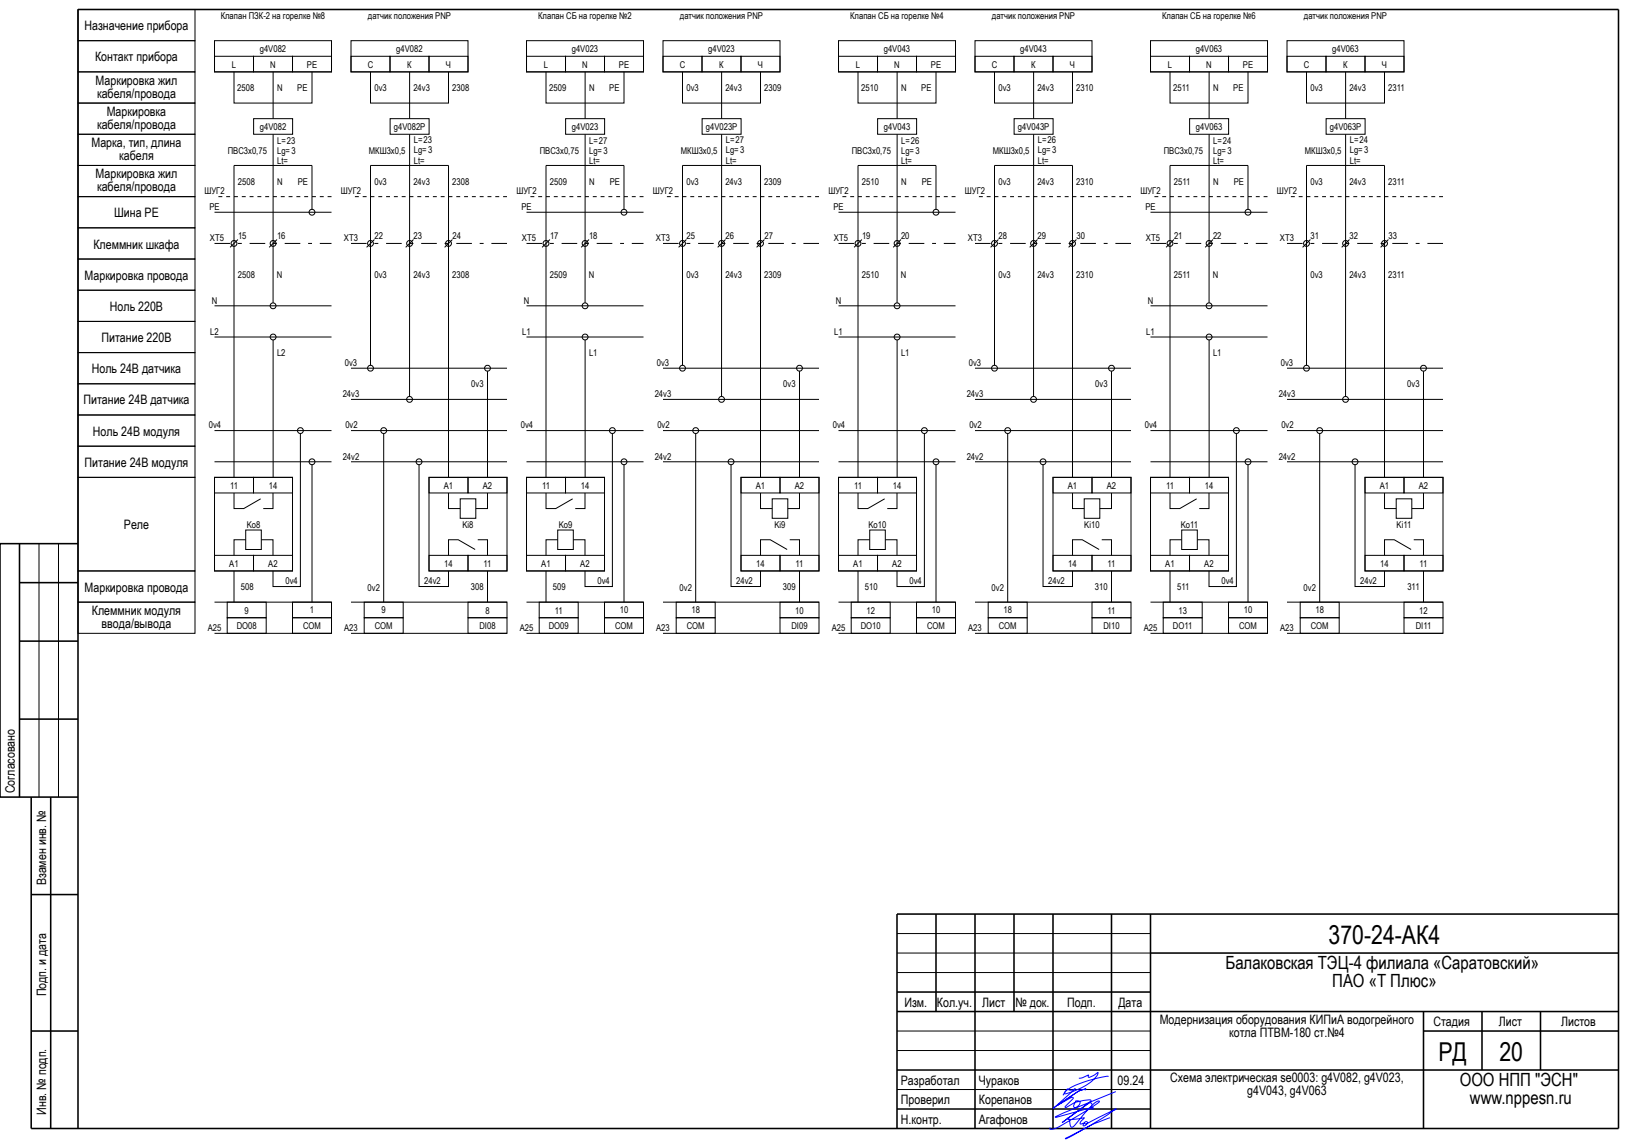
[picture p264: page 16]
Согласовано; кабеля/провода; Клеммник модуля ввода/вывода; Маркировка провода; Питание 220В; Реле; Ноль 220В; Питание 24В датчика; Ноль 24В датчика; Питание 24В модуля; Ноль 24В модуля; ШУГ2; COM; 1 COM; 10 COM; МКШ3х0,5; ПВС3х0,75

Клапан ПЗК-2 на горелке №8

датчик положения PNP

Клапан СБ на горелке №2

Клапан СБ на горелке №4

Клапан СБ на горелке №6

Контакт прибора
Маркировка жил
кабеля/провода
Маркировка
Марка, тип, длина
кабеля

Инв. № подп. Подп. и дата Взамен инв. №

Балаковская ТЭЦ-4 филиала «Саратовский» ПАО «Т Плюс»

Изм. | Кол.уч. | Лист | № док. | Подп. | Дата

Модернизация оборудования КИПиА водогрейного котла ПТВМ-180 ст.№4 | Стадия | Лист | Листов

Схема электрическая se0003: g4V082, g4V023, g4V043, g4V063 | ООО НПП "ЭСН"

## Клеммник шкафа

## Шина PE

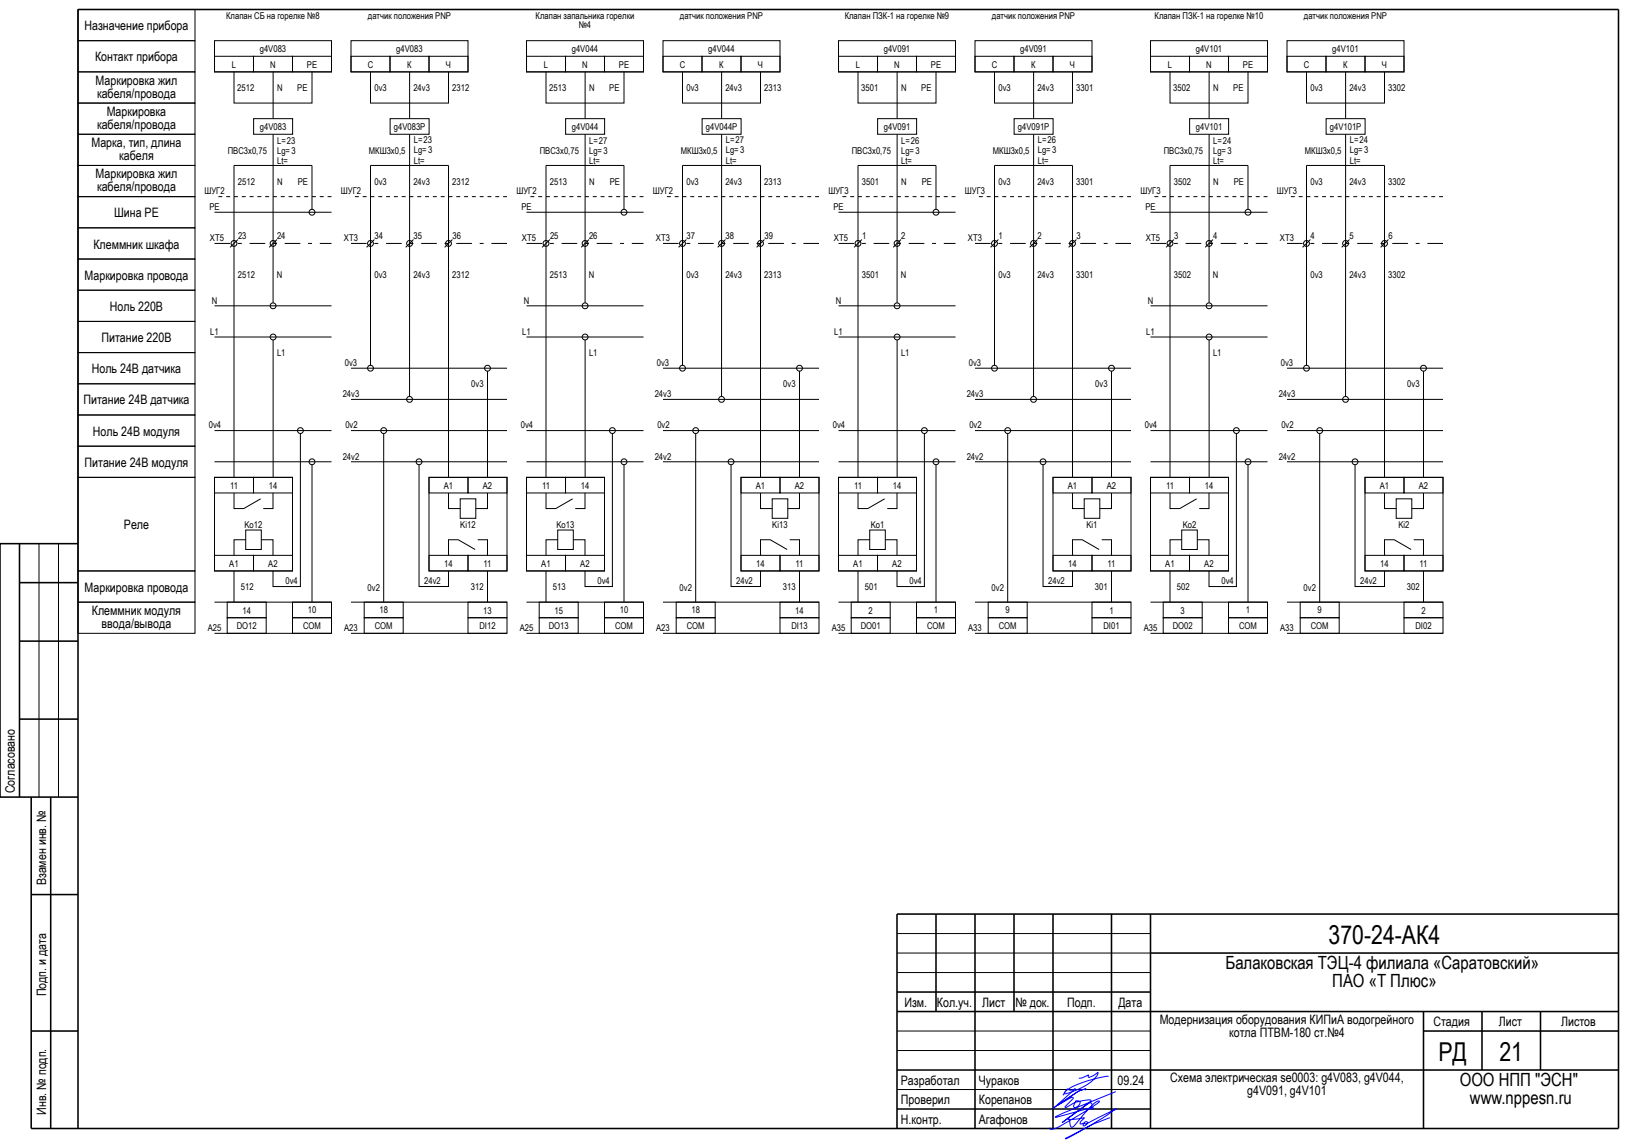
[picture p265: page 17]
Согласовано; кабеля/провода; Клеммник модуля ввода/вывода; Маркировка провода; Питание 220В; Реле; Ноль 220В; Питание 24В датчика; Ноль 24В датчика; Питание 24В модуля; Ноль 24В модуля; ШУГ2; COM; 10 COM; ШУГ3; 1 COM; МКШ3х0,5; ПВС3х0,75

Клапан СБ на горелке №8

датчик положения PNP

Клапан запальника горелки

Клапан ПЗК-1 на горелке №9

Клапан ПЗК-1 на горелке №10

Контакт прибора
Маркировка жил
кабеля/провода
Маркировка
Марка, тип, длина
кабеля

Инв. № подп. Подп. и дата Взамен инв. №

Балаковская ТЭЦ-4 филиала «Саратовский» ПАО «Т Плюс»

Изм. | Кол.уч. | Лист | № док. | Подп. | Дата

Модернизация оборудования КИПиА водогрейного котла ПТВМ-180 ст.№4 | Стадия | Лист | Листов

Схема электрическая se0003: g4V083, g4V044, g4V091, g4V101 | ООО НПП "ЭСН"

## Клеммник шкафа

## Шина PE

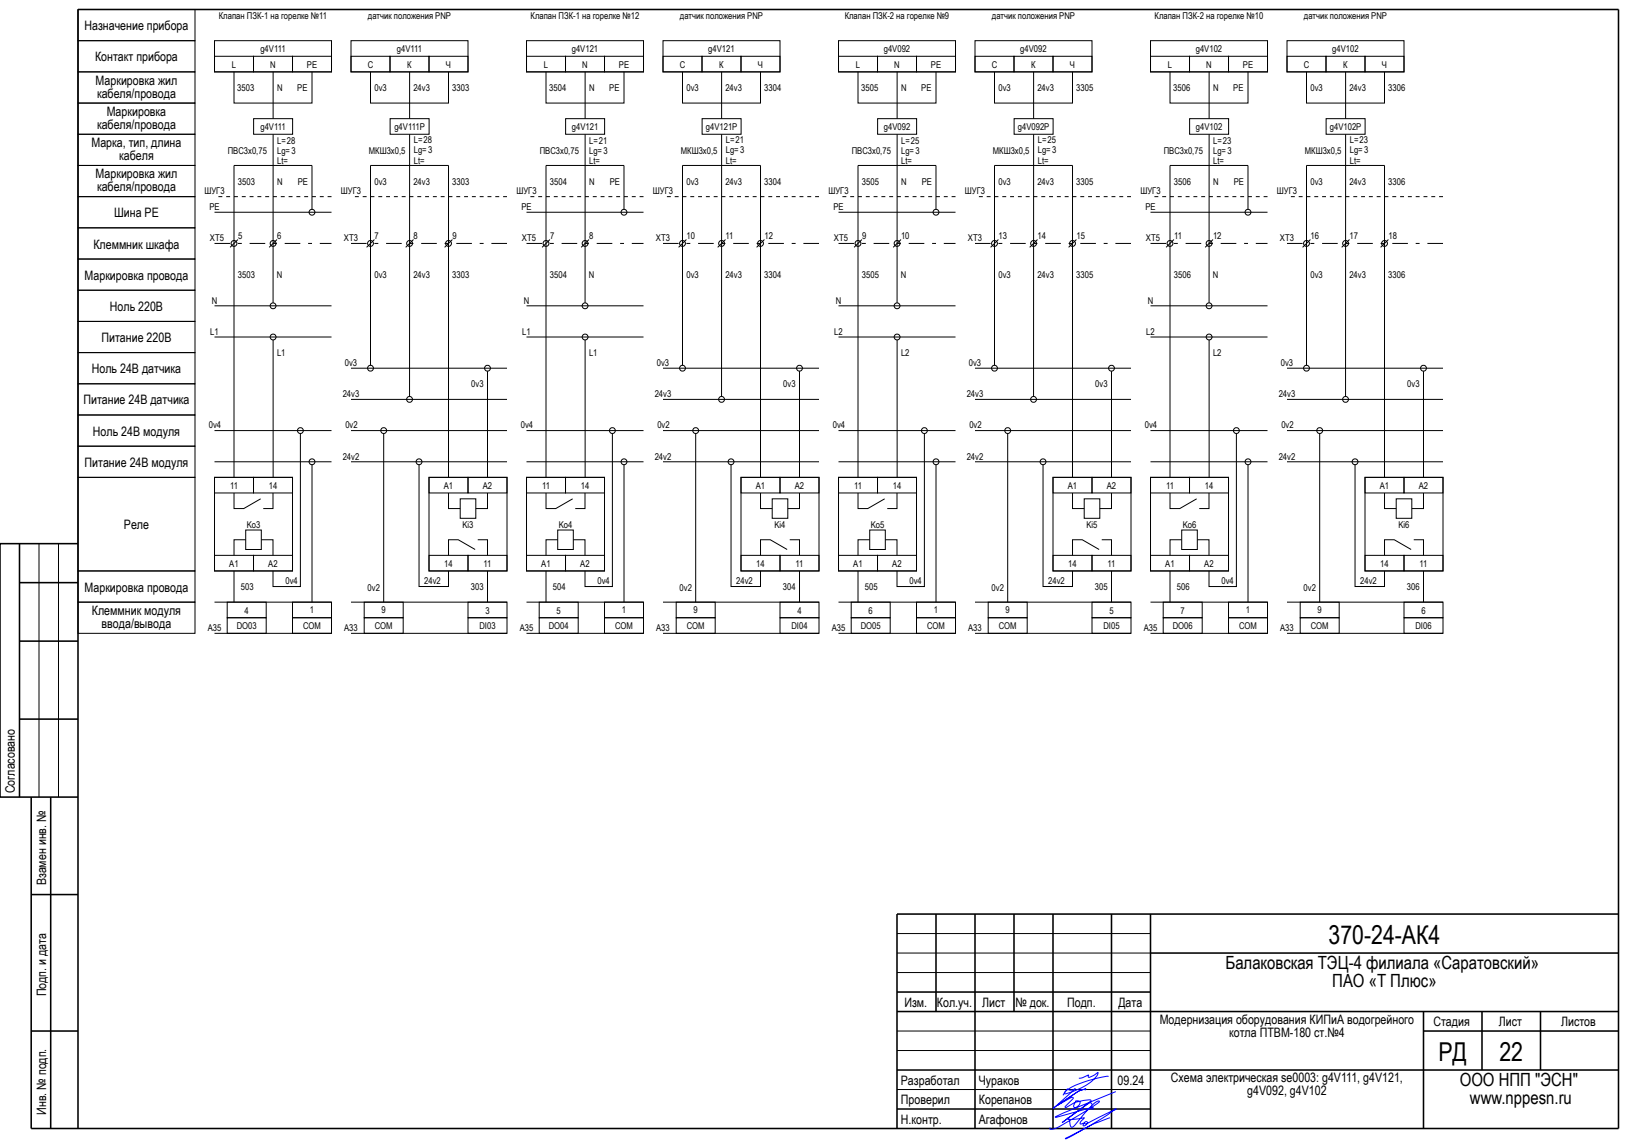
[picture p266: page 18]
Согласовано; кабеля/провода; Клеммник модуля ввода/вывода; Маркировка провода; Питание 220В; Реле; Ноль 220В; Питание 24В датчика; Ноль 24В датчика; Питание 24В модуля; Ноль 24В модуля; ШУГ3; COM; 1 COM; МКШ3х0,5; ПВС3х0,75

Клапан ПЗК-1 на горелке №11

датчик положения PNP

Клапан ПЗК-1 на горелке №12

Клапан ПЗК-2 на горелке №9

Клапан ПЗК-2 на горелке №10

Контакт прибора
Маркировка жил
кабеля/провода
Маркировка
Марка, тип, длина
кабеля

Инв. № подп. Подп. и дата Взамен инв. №

Балаковская ТЭЦ-4 филиала «Саратовский» ПАО «Т Плюс»

Изм. | Кол.уч. | Лист | № док. | Подп. | Дата

Модернизация оборудования КИПиА водогрейного котла ПТВМ-180 ст.№4 | Стадия | Лист | Листов

Схема электрическая se0003: g4V111, g4V121, g4V092, g4V102 | ООО НПП "ЭСН"

## Клеммник шкафа

## Шина PE

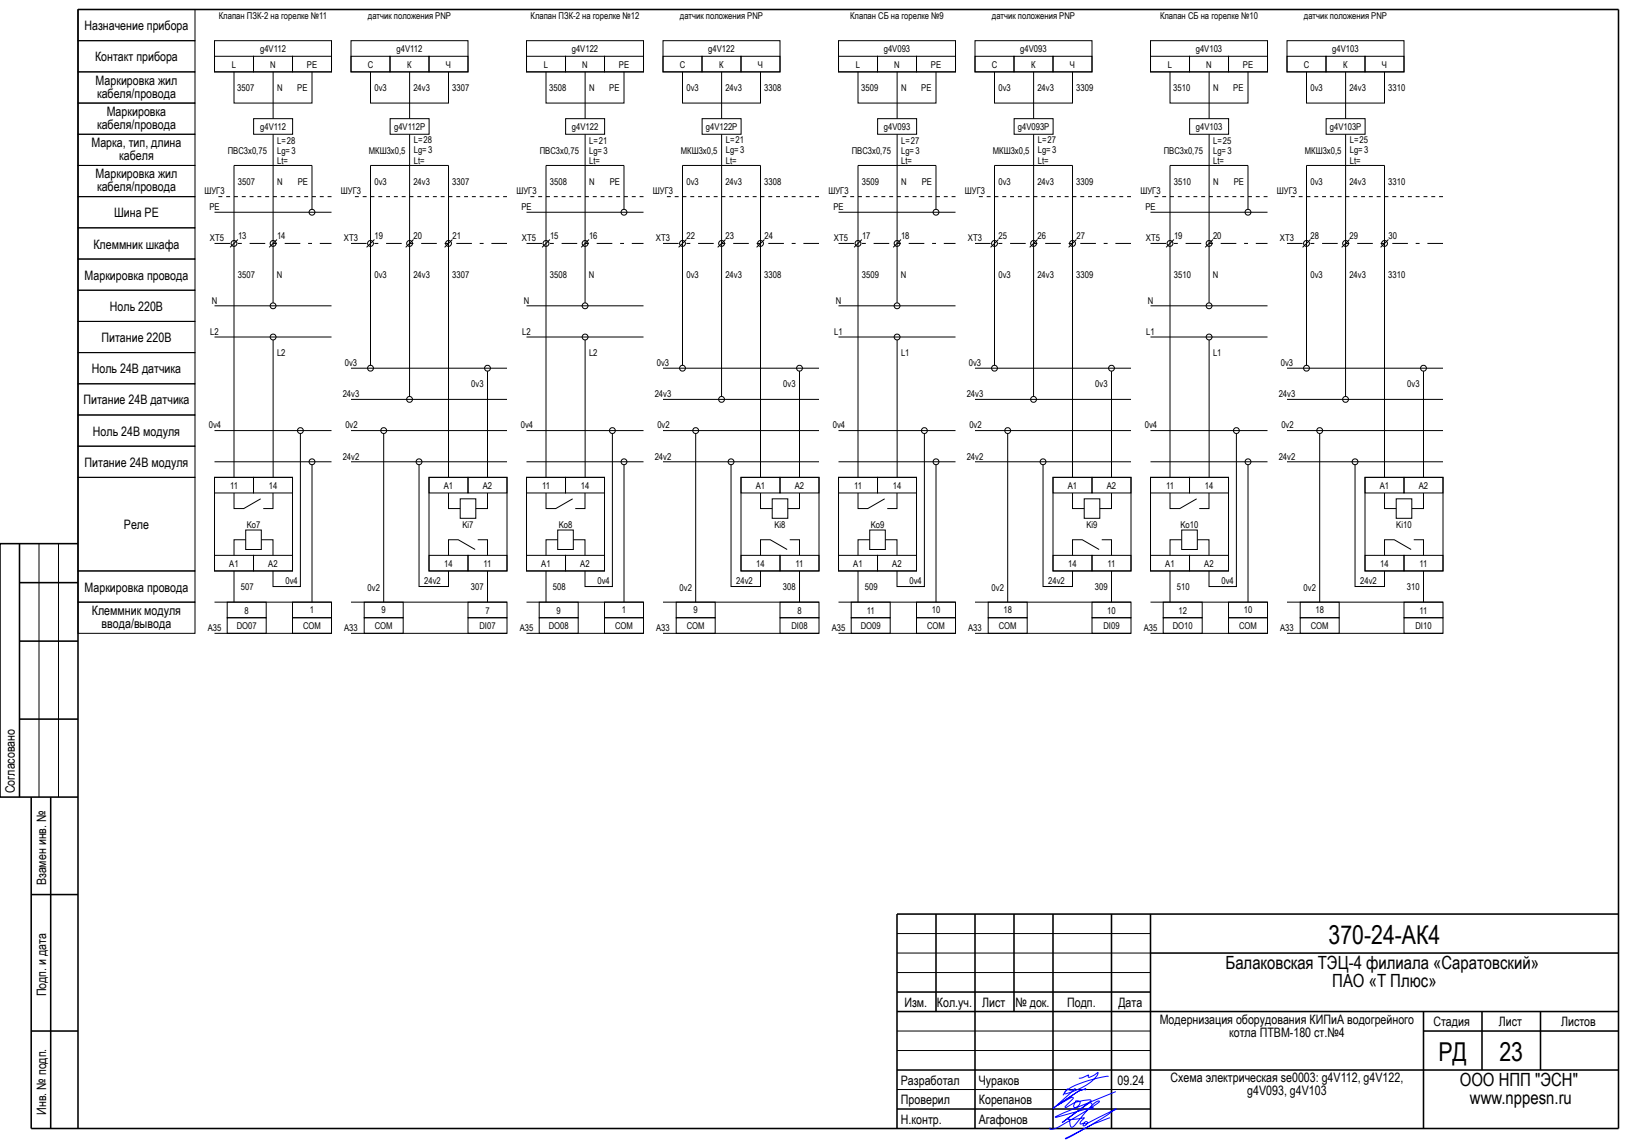
[picture p267: page 19]
Согласовано; кабеля/провода; Клеммник модуля ввода/вывода; Маркировка провода; Питание 220В; Реле; Ноль 220В; Питание 24В датчика; Ноль 24В датчика; Питание 24В модуля; Ноль 24В модуля; ШУГ3; COM; 1 COM; 10 COM; МКШ3х0,5; ПВС3х0,75

Клапан ПЗК-2 на горелке №11

датчик положения PNP

Клапан ПЗК-2 на горелке №12

Клапан СБ на горелке №9

Клапан СБ на горелке №10

Контакт прибора
Маркировка жил
кабеля/провода
Маркировка
Марка, тип, длина
кабеля

Инв. № подп. Подп. и дата Взамен инв. №

Балаковская ТЭЦ-4 филиала «Саратовский» ПАО «Т Плюс»

Изм. | Кол.уч. | Лист | № док. | Подп. | Дата

Модернизация оборудования КИПиА водогрейного котла ПТВМ-180 ст.№4 | Стадия | Лист | Листов

Схема электрическая se0003: g4V112, g4V122, g4V093, g4V103 | ООО НПП "ЭСН"

## Клеммник шкафа

## Шина PE

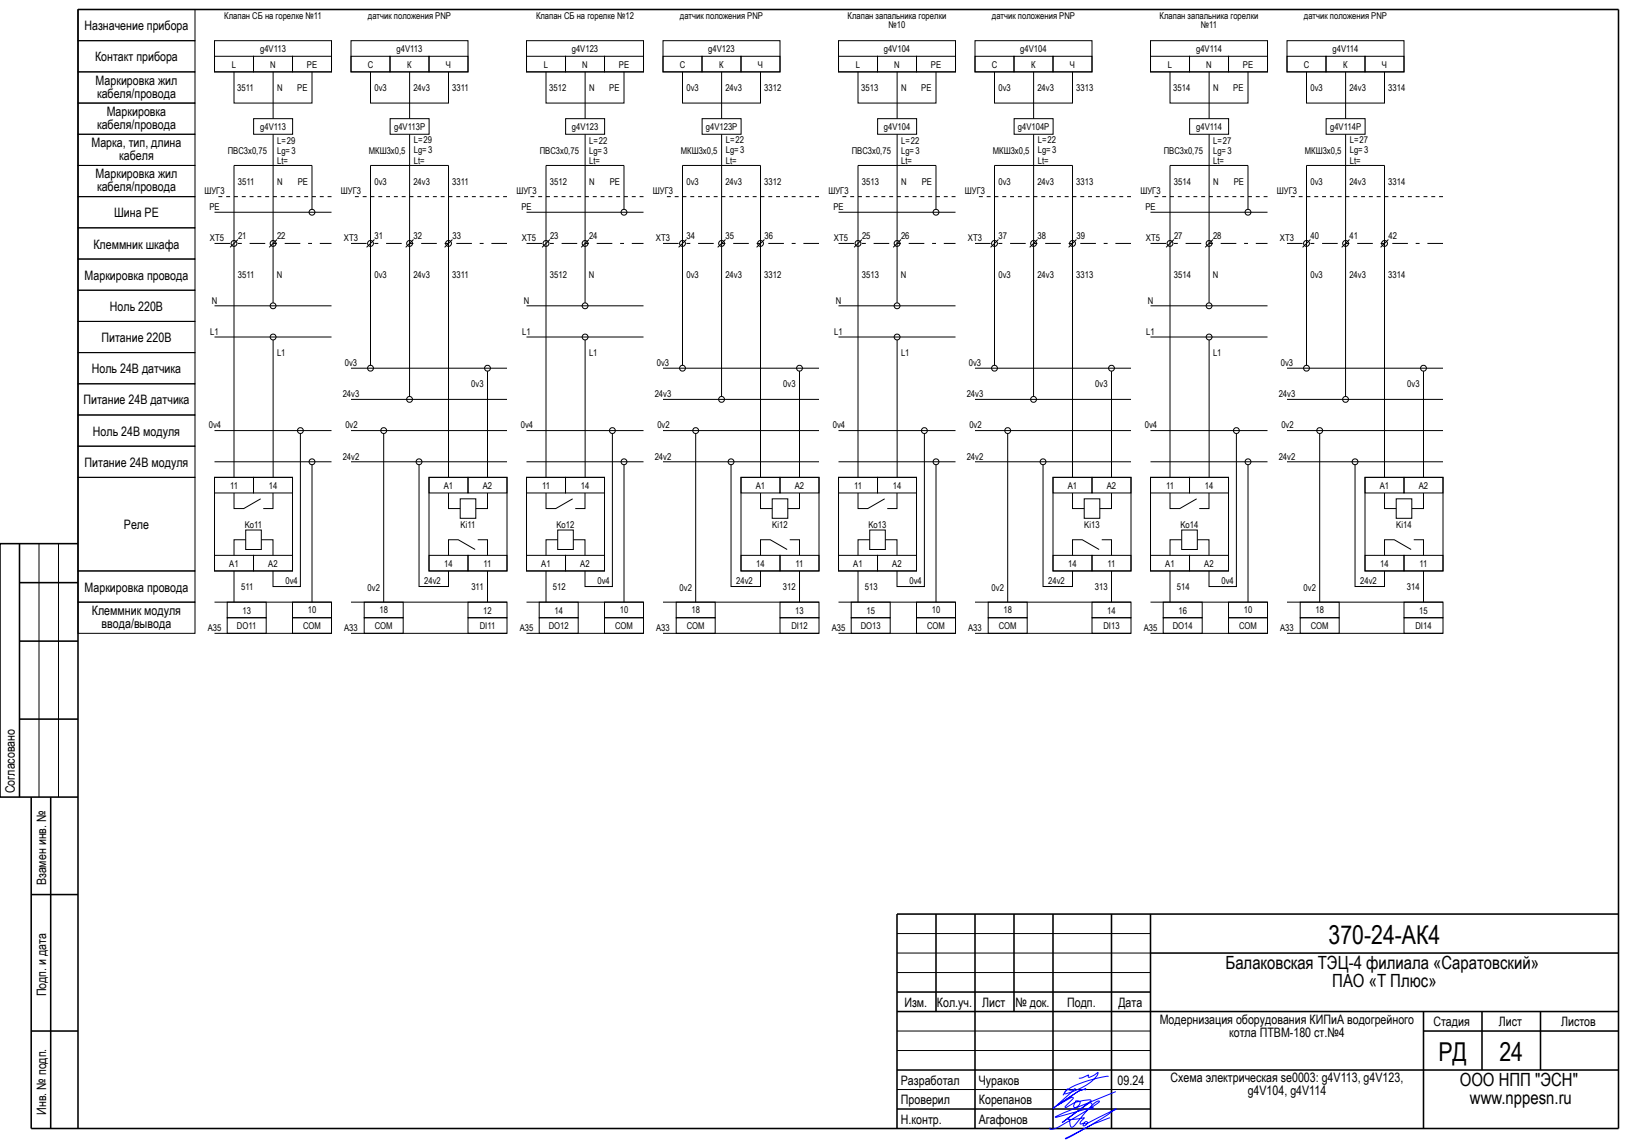
[picture p268: page 20]
Согласовано; кабеля/провода; Клеммник модуля ввода/вывода; Маркировка провода; Питание 220В; Реле; Ноль 220В; Питание 24В датчика; Ноль 24В датчика; Питание 24В модуля; Ноль 24В модуля; ШУГ3; COM; 10 COM; МКШ3х0,5; ПВС3х0,75

Клапан СБ на горелке №11

датчик положения PNP

Клапан СБ на горелке №12

Клапан запальника горелки

Контакт прибора
Маркировка жил
кабеля/провода
Маркировка
Марка, тип, длина
кабеля

Инв. № подп. Подп. и дата Взамен инв. №

Балаковская ТЭЦ-4 филиала «Саратовский» ПАО «Т Плюс»

Изм. | Кол.уч. | Лист | № док. | Подп. | Дата

Модернизация оборудования КИПиА водогрейного котла ПТВМ-180 ст.№4 | Стадия | Лист | Листов

Схема электрическая se0003: g4V113, g4V123, g4V104, g4V114 | ООО НПП "ЭСН"

## Клеммник шкафа

## Шина PE

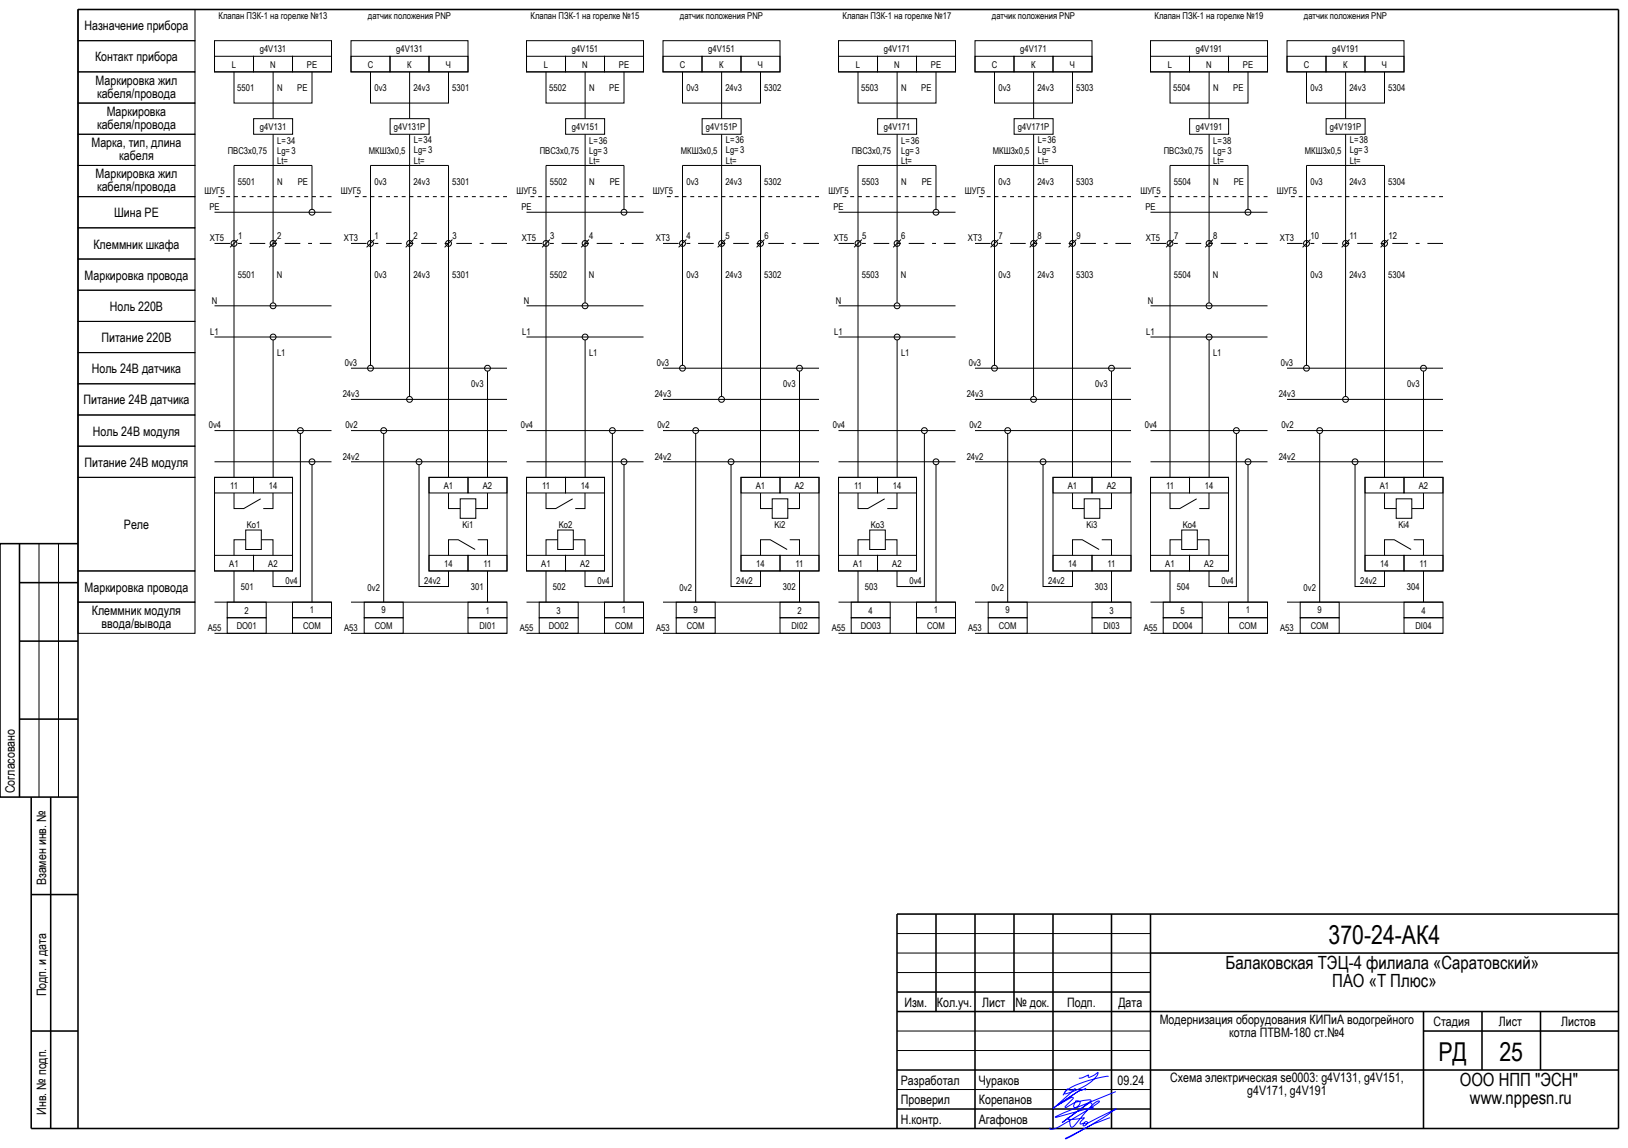
[picture p269: page 21]
Согласовано; кабеля/провода; Клеммник модуля ввода/вывода; Маркировка провода; Питание 220В; Реле; Ноль 220В; Питание 24В датчика; Ноль 24В датчика; Питание 24В модуля; Ноль 24В модуля; ШУГ5; COM; 1 COM; МКШ3х0,5; ПВС3х0,75

Клапан ПЗК-1 на горелке №13

датчик положения PNP

Клапан ПЗК-1 на горелке №15

Клапан ПЗК-1 на горелке №17

Клапан ПЗК-1 на горелке №19

Контакт прибора
Маркировка жил
кабеля/провода
Маркировка
Марка, тип, длина
кабеля

Инв. № подп. Подп. и дата Взамен инв. №

Балаковская ТЭЦ-4 филиала «Саратовский» ПАО «Т Плюс»

Изм. | Кол.уч. | Лист | № док. | Подп. | Дата

Модернизация оборудования КИПиА водогрейного котла ПТВМ-180 ст.№4 | Стадия | Лист | Листов

Схема электрическая se0003: g4V131, g4V151, g4V171, g4V191 | ООО НПП "ЭСН"

## Клеммник шкафа

## Шина PE

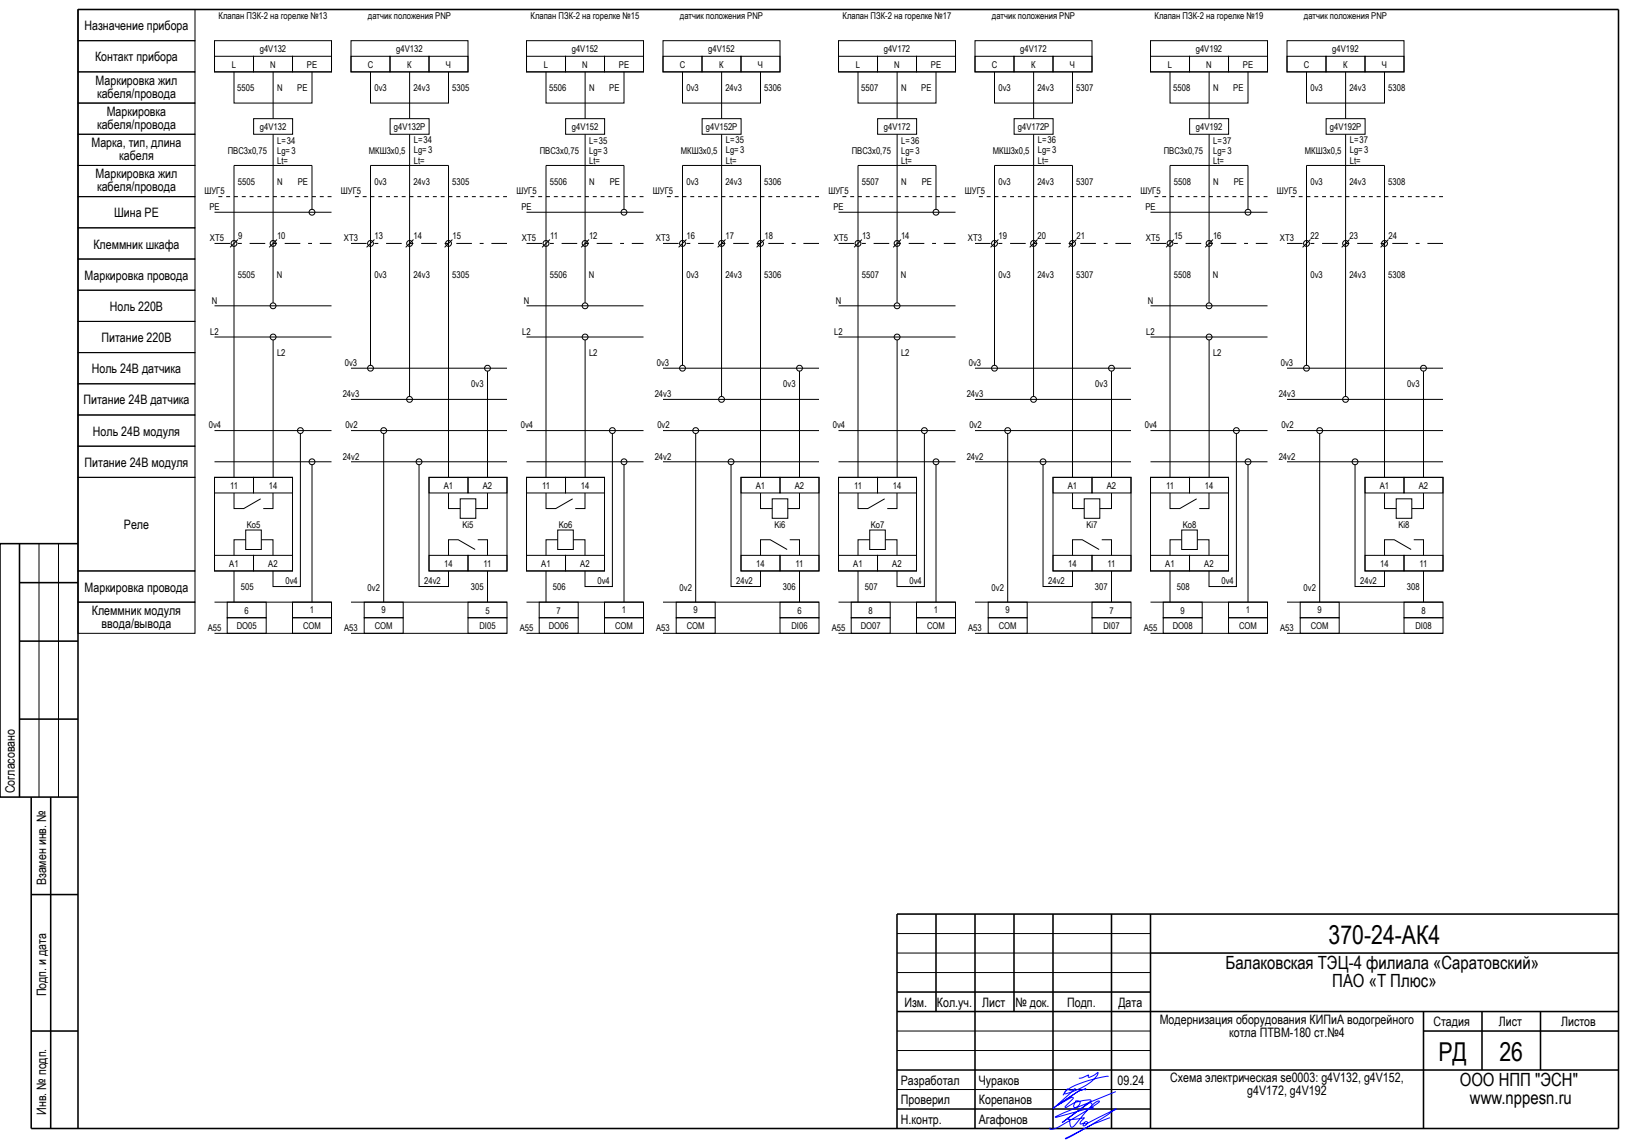
[picture p270: page 22]
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

Клапан ПЗК-2 на горелке №13

датчик положения PNP

Клапан ПЗК-2 на горелке №15

Клапан ПЗК-2 на горелке №17

Клапан ПЗК-2 на горелке №19

Контакт прибора
Маркировка жил
кабеля/провода
Маркировка
Марка, тип, длина
кабеля

Инв. № подп. Подп. и дата Взамен инв. №

Балаковская ТЭЦ-4 филиала «Саратовский» ПАО «Т Плюс»

Изм. | Кол.уч. | Лист | № док. | Подп. | Дата

Модернизация оборудования КИПиА водогрейного котла ПТВМ-180 ст.№4 | Стадия | Лист | Листов

Схема электрическая se0003: g4V132, g4V152, g4V172, g4V192 | ООО НПП "ЭСН"

## Клеммник шкафа

## Шина PE

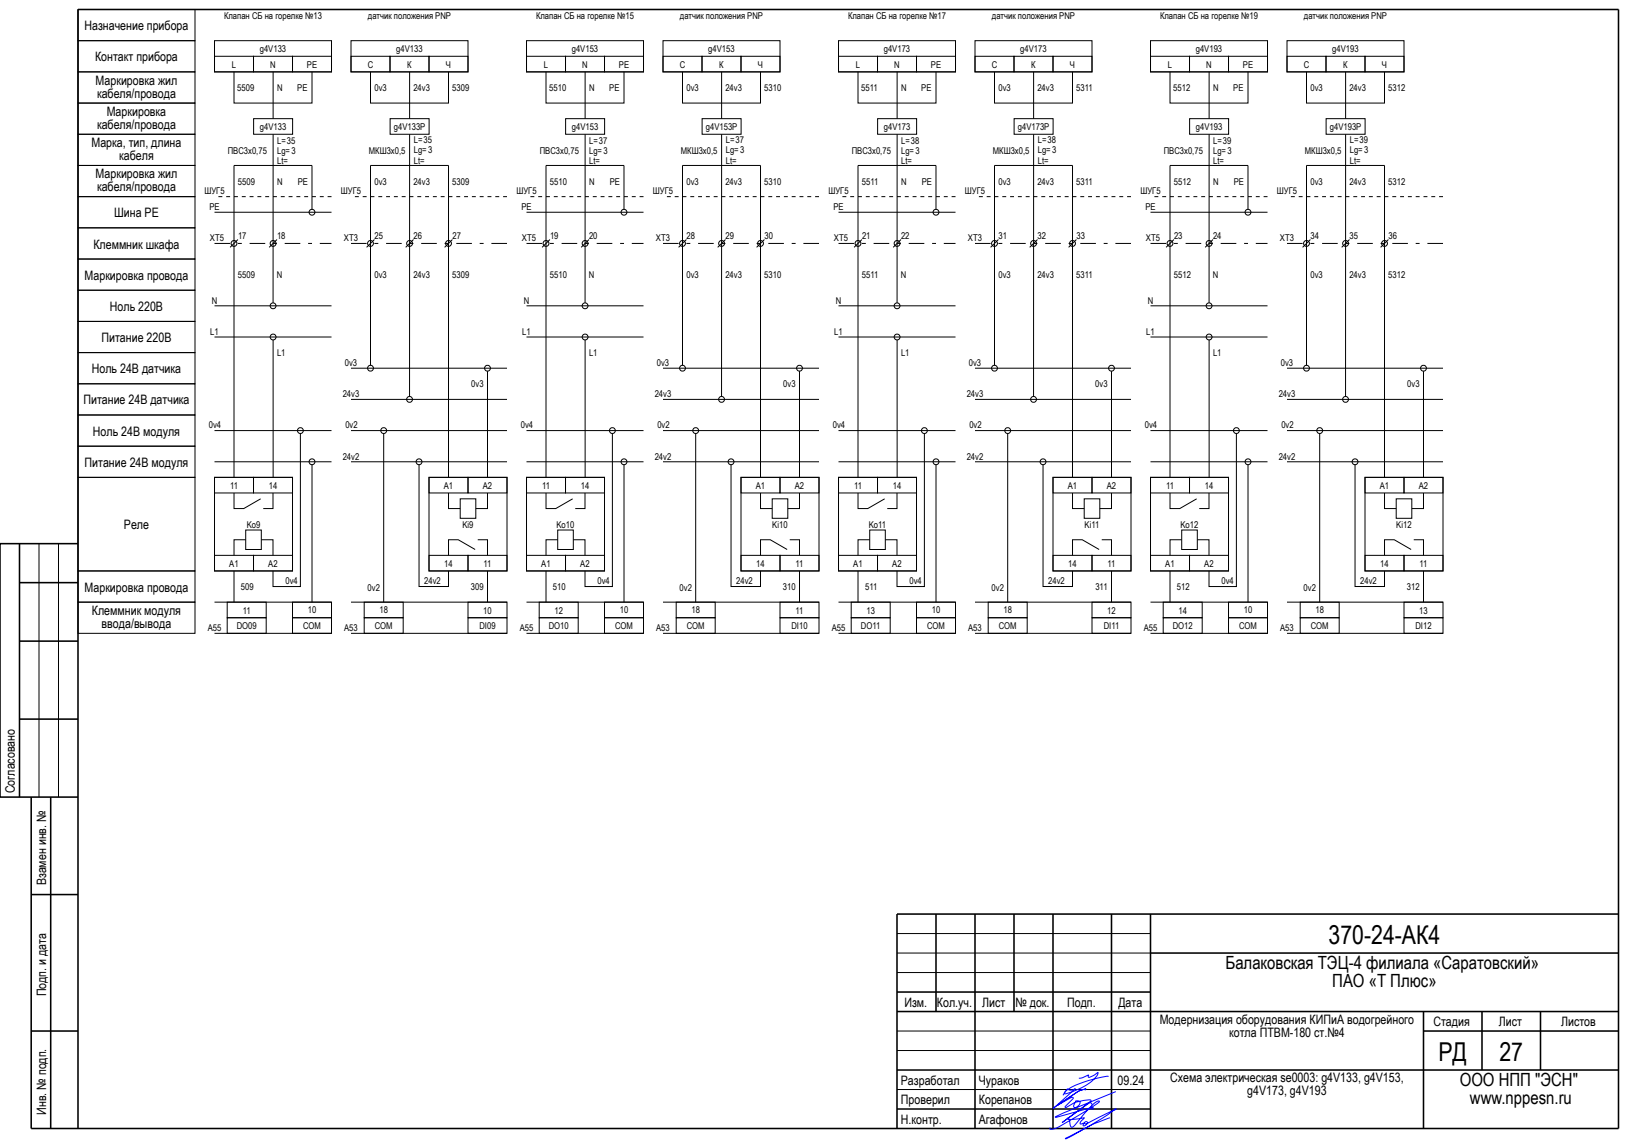
[picture p271: page 23]
Согласовано; кабеля/провода; Клеммник модуля ввода/вывода; Маркировка провода; Питание 220В; Реле; Ноль 220В; Питание 24В датчика; Ноль 24В датчика; Питание 24В модуля; Ноль 24В модуля; ШУГ5; COM; 10 COM; МКШ3х0,5; ПВС3х0,75

Клапан СБ на горелке №13

датчик положения PNP

Клапан СБ на горелке №15

Клапан СБ на горелке №17

Клапан СБ на горелке №19

Контакт прибора
Маркировка жил
кабеля/провода
Маркировка
Марка, тип, длина
кабеля

Инв. № подп. Подп. и дата Взамен инв. №

Балаковская ТЭЦ-4 филиала «Саратовский» ПАО «Т Плюс»

Изм. | Кол.уч. | Лист | № док. | Подп. | Дата

Модернизация оборудования КИПиА водогрейного котла ПТВМ-180 ст.№4 | Стадия | Лист | Листов

Схема электрическая se0003: g4V133, g4V153, g4V173, g4V193 | ООО НПП "ЭСН"

## Клеммник шкафа

## Шина PE

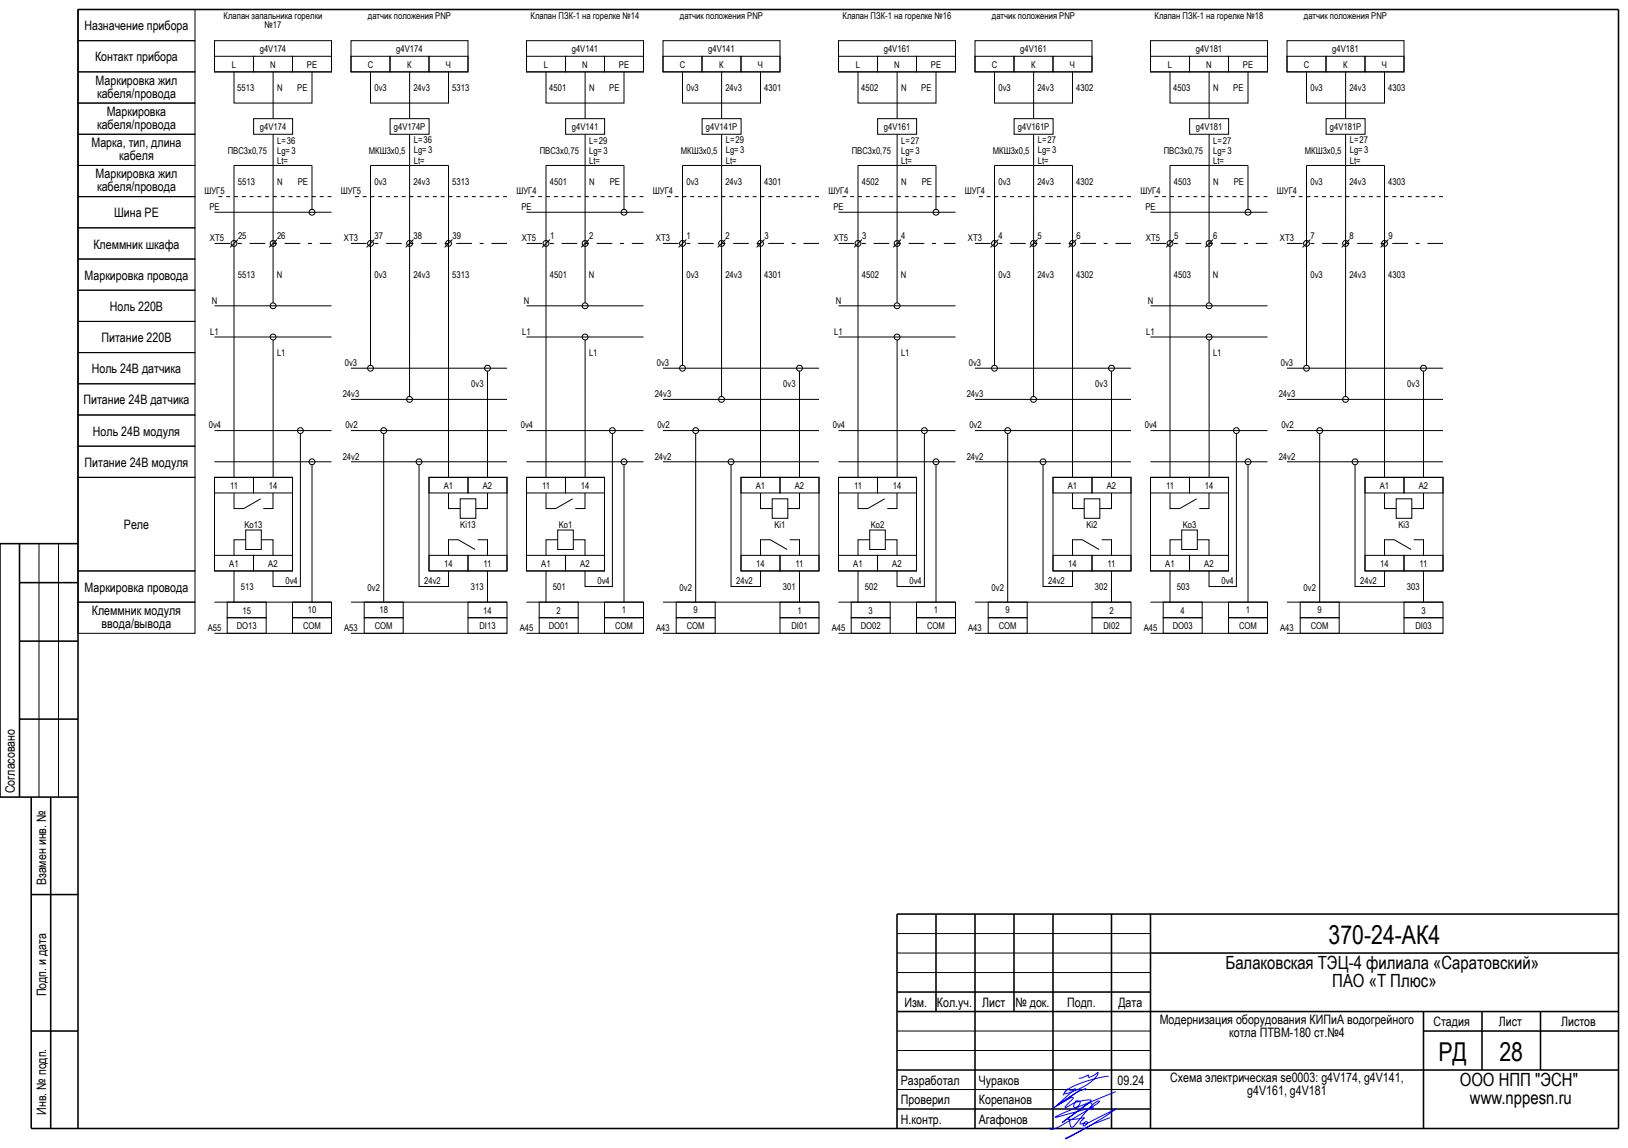
[picture p272: page 24]
Согласовано; кабеля/провода; Клеммник модуля ввода/вывода; Маркировка провода; Питание 220В; Реле; Ноль 220В; Питание 24В датчика; Ноль 24В датчика; Питание 24В модуля; Ноль 24В модуля; ШУГ5; COM; 10 COM; ШУГ4; 1 COM; МКШ3х0,5; ПВС3х0,75

Клапан запальника горелки

датчик положения PNP

Клапан ПЗК-1 на горелке №14

Клапан ПЗК-1 на горелке №16

Клапан ПЗК-1 на горелке №18

Контакт прибора
Маркировка жил
кабеля/провода
Маркировка
Марка, тип, длина
кабеля

Инв. № подп. Подп. и дата Взамен инв. №

Балаковская ТЭЦ-4 филиала «Саратовский» ПАО «Т Плюс»

Изм. | Кол.уч. | Лист | № док. | Подп. | Дата

Модернизация оборудования КИПиА водогрейного котла ПТВМ-180 ст.№4 | Стадия | Лист | Листов

Схема электрическая se0003: g4V174, g4V141, g4V161, g4V181 | ООО НПП "ЭСН"

## Клеммник шкафа
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
