nppesnteam/370-24_Balakovo_PTVM180_-3-4/АК4/8.Спецификация.pdf

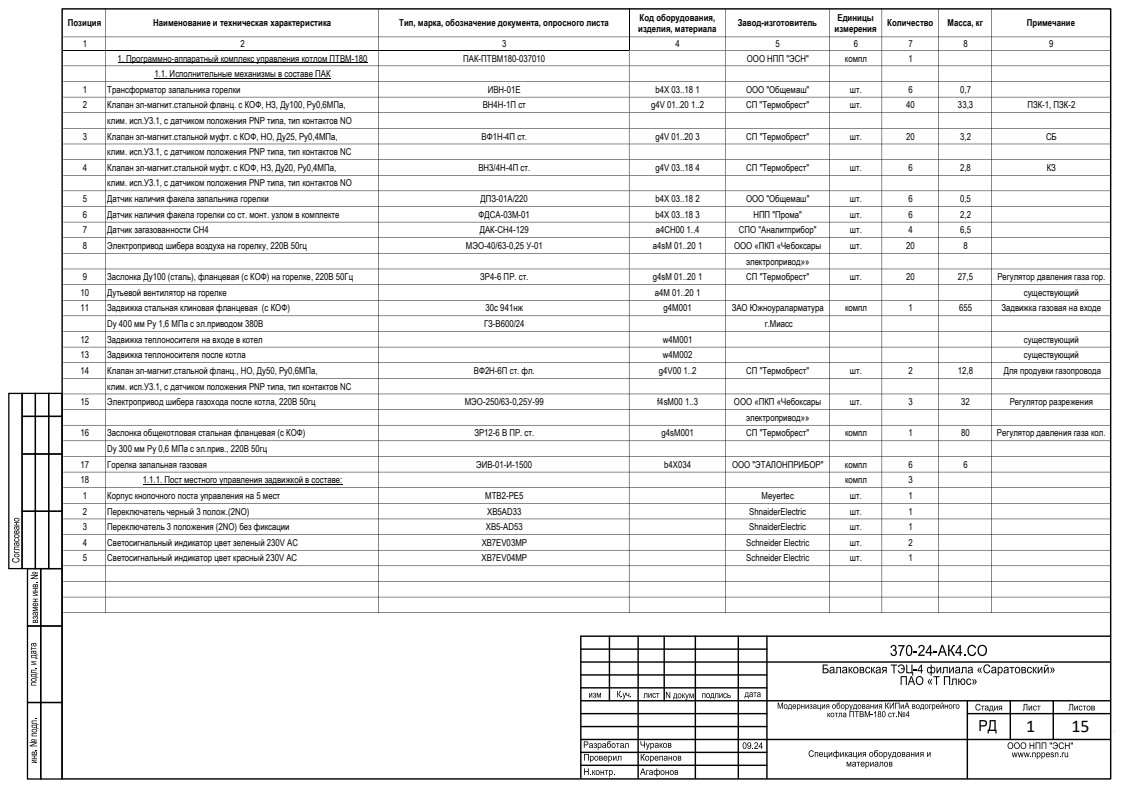
[picture p273: page 1]
Позиция; Наименование и техническая характеристика; Тип, марка, обозначение документа, опросного листа; Код оборудования,; изделия, материала; Завод-изготовитель; Единицы; измерения; Количество; Масса, кг; Примечание; 1. Программно-аппаратный комплекс управления котлом ПТВМ-180; ПАК-ПТВМ180-037010; ООО НПП "ЭСН"; компл; Трансформатор запальника горелки; ИВН-01Е; ООО "Общемаш"; Клапан эл-магнит.стальной фланц. с КОФ, НЗ, Ду100, Ру0,6МПа,; СП "Термобрест"; ПЗК-1, ПЗК-2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

1.1. Исполнительные механизмы в составе ПАК

клим. исп.У3.1, с датчиком положения PNP типа, тип контактов NO
клим. исп.У3.1, с датчиком положения PNP типа, тип контактов NС

Dу 300 мм Pу 0,6 МПа с эл.прив., 220В 50гц

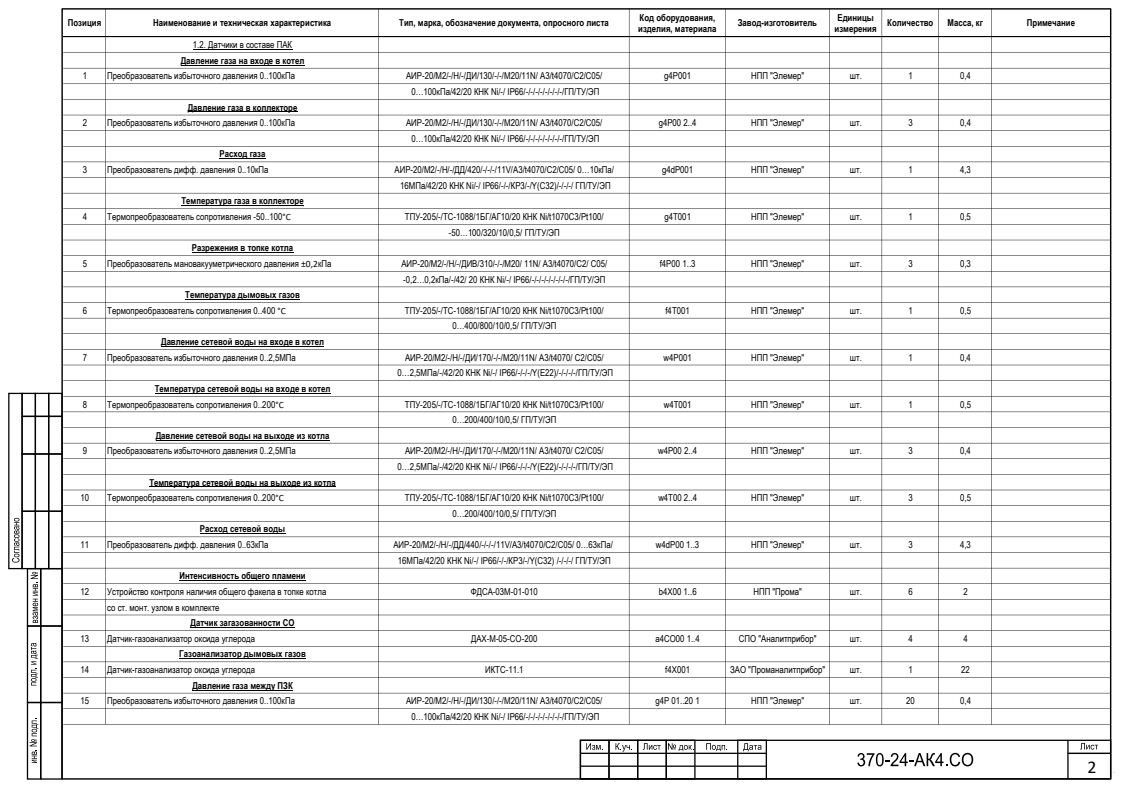
[picture p274: page 2]
Преобразователь избыточного давления 0..100кПа; АИР-20/М2/-/Н/-/ДИ/130/-/-/М20/11N/ А3/t4070/С2/C05/; НПП "Элемер"; Расход газа; Преобразователь дифф. давления 0..10кПа; АИР-20/М2/-/Н/-/ДД/420/-/-/-/11V/А3/t4070/С2/C05/ 0…10кПа/; Термопреобразователь сопротивления -50..100°C; ТПУ-205/-/ТС-1088/1БГ/АГ10/20 КНК Ni/t1070C3/Pt100/; Преобразователь мановакууметрического давления ±0,2кПа; АИР-20/М2/-/Н/-/ДИВ/310/-/-/М20/ 11N/ А3/t4070/С2/ C05/; Термопреобразователь сопротивления 0..400 °C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

1.2. Датчики в составе ПАК
Давление газа на входе в котел

0…100кПа/42/20 КНК Ni/-/ IP66/-/-/-/-/-/-/-/-/ГП/ТУ/ЭП

Давление газа в коллекторе
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
