nppesnteam/370-24_Balakovo_PTVM180_-3-4/(commit log)

2024-11-14 241114
    Отдал первый вариант АК3
    [desc.xlsx, model370_sm.xlsx, model370sm.xlsx, rule.xlsx, rule_sm.xlsx, sm spec.xlsx, sm10_p_ст_book+dubl.dxf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]
2024-11-21 211124
    Добавлен расчет ПЛК
    [Расчет ПЛК_ПАО Т Плюс (КЭС-Холдинг).xlsx]
